NTURacingTeam/nturt_kicad/EP4/README.md

# README
must add `SamacSys_Parts` and `nturt_kicad_lib` in `/EP4/Project_Library` to **Preference > Manage Symbol Libraries ... > Global libraries** and **Preference > Manage footprint Libraries ... > Global libraries**
