NTURacingTeam/nturt_kicad/EP6/Electrical_Group/6S_BMS_CONN1/README.md

# 6S_BMS_CONN1 KiCad Project

## Project Overview
This repository contains the KiCad project for the **6S_BMS_CONN1** design, developed as part of the **Electrical Group**.

## Author
- **Name:** [Jack Kuo](https://github.com/chemmy-jack)
- **Team:** NTU Racing Team Electrical Group

## Revision History

| Version | Date | Author | Description |
|---|---|---|---|
| 1.0 | 2025-03-10 | [Jack Kuo](https://github.com/chemmy-jack)  | Initial project creation. (older version not documented) |
| 1.1 | 2025-05-05 | [Jack Kuo](https://github.com/chemmy-jack)  | fix M12 L-coded hole too small mistake.  add fillet to board cut. change IDC to 6S_BMS V2.0 to 12pin (new design. 2 more button input and 1 more LED WS2812 output). add 5V ext and WS2812 connector.|

## To-Do List

## License
<!-- This project is licensed under [Your License]. See the LICENSE file for details. -->
none

## Contact
For questions or contributions, please contact [ntu.racing@gmail.com].
