NTURacingTeam/nturt_kicad/driverless_car/CMP10A dimension.png

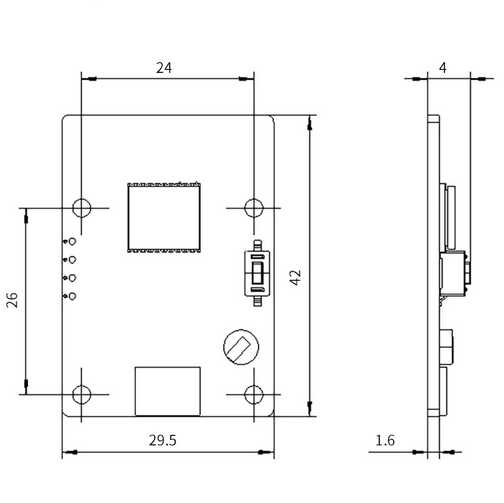
driverless_car/CMP10A dimension.png
