NTURacingTeam/nturt_kicad/EP6/Electrical_Group/VCU_CONN1/VCU_CONN1.step

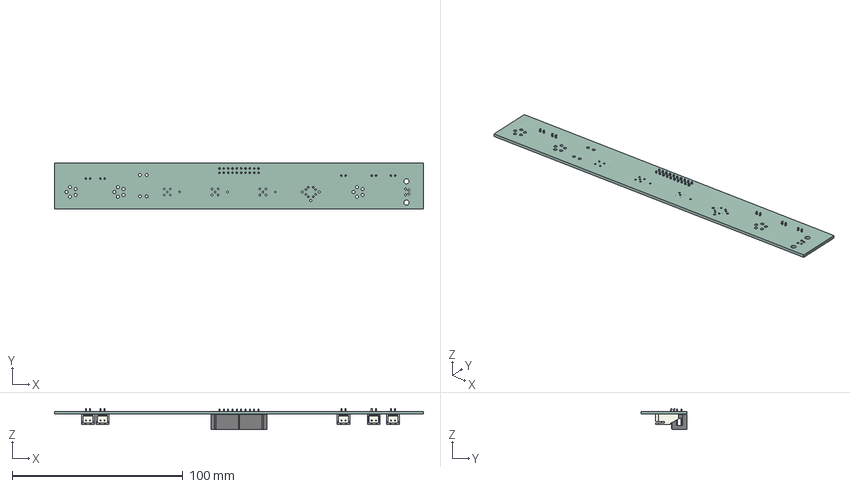
[picture p2: CAD file, 2025-03-10]
EP6/Electrical_Group/VCU_CONN1/VCU_CONN1.step
216.0 x 27.0 x 12.5 mm
IDC_Header_2x10_P254mm_Vertical
JST_S2B_XH_A x 5
_autosave-VCU_CONN1_PCB
