NTURacingTeam/nturt_kicad/EP6/Powertrain_Group/HVB_LV1/HVB_LV1.step

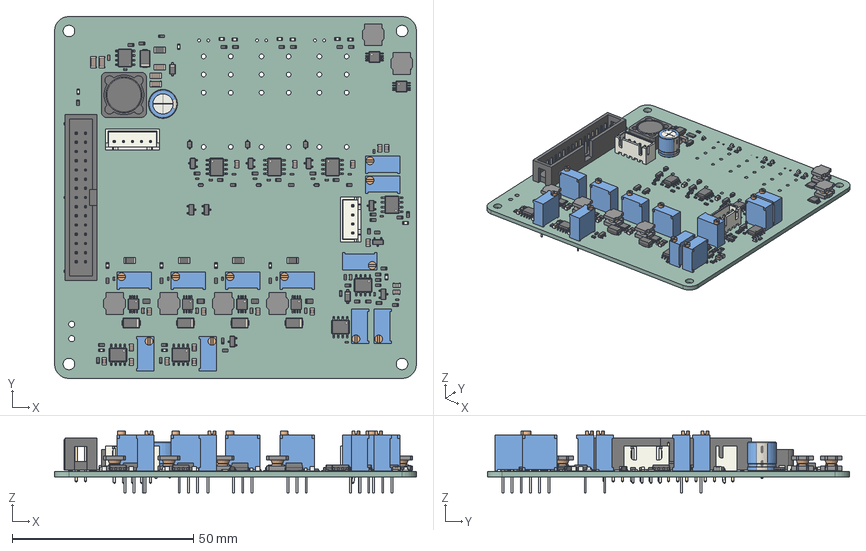
[picture p3: CAD file, 2025-03-18]
EP6/Powertrain_Group/HVB_LV1/HVB_LV1.step
100.0 x 100.0 x 17.1 mm
R_0603_1608Metric x 46
C_0805_2012Metric x 16
MSOP-8-1EP_3x3mm_P0.65mm_EP1.5x1.8mm x 6
D_SMA x 5
LED_0603_1608Metric x 16
SOIC_8_39x49mm_P127mm x 8
SOT_23 x 9
C_0402_1005Metric x 19
L_Bourns_SRN6045TA x 6
Potentiometer_Bourns_3296W_Vertical x 11
SRR1260
HTSOP_8_1EP_39x49mm_Pitch127mm
Fuse_1206_3216Metric x 5
D_SOD_323 x 3
D_SOD_523 x 3
IDC_Header_2x15_P254mm_Vertical
R_0805_2012Metric x 4
C_1206_3216Metric x 5
C_0603_1608Metric x 6
D_SOD_123 x 2
L_0805_2012Metric x 2
JST_B4B_XH_A
CP_Radial_D80mm_P380mm
JST_B5B_XH_A
HVB_LV1_PCB
