NTURacingTeam/nturt_kicad/EP6/Powertrain_Group/INV_GateDriver/INV_GateDriver.step

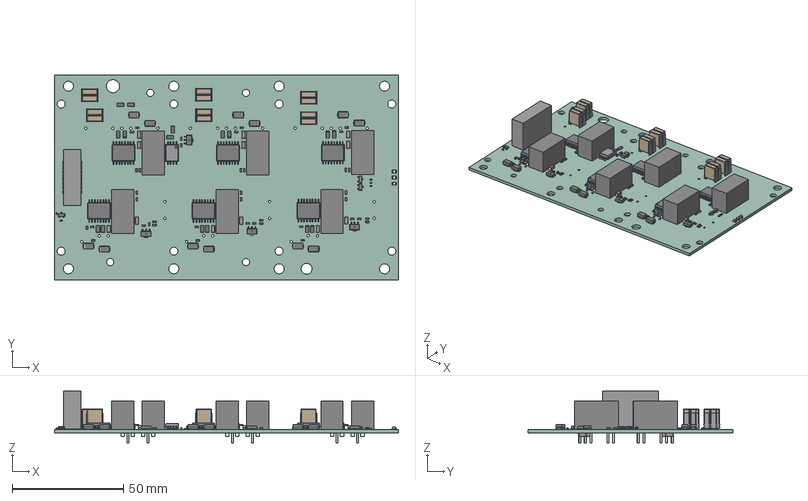
[picture p4: CAD file, 2025-02-22]
EP6/Powertrain_Group/INV_GateDriver/INV_GateDriver.step
154.5 x 92.0 x 23.2 mm
C_0603_1608Metric x 30
CQ assembly x 4
LED_0805_2012Metric x 3
R_0603_1608Metric x 9
C_1206_3216Metric x 24
D_SMA x 12
R_1206_3216Metric x 16
R_0402_1005Metric x 3
CeraLink_FA2_6205-Z03-Ind x 6
ASSEMBLY x 2
C_0402_1005Metric x 2
SOIC_16W_75x103mm_P127mm x 6
SOT_23 x 2
SOT-23-3
INV_GateDriver_PCB
