NTURacingTeam/nturt_kicad/EP6/Powertrain_Group/INV_MotorTempIso/INV_MotorTempIso.step

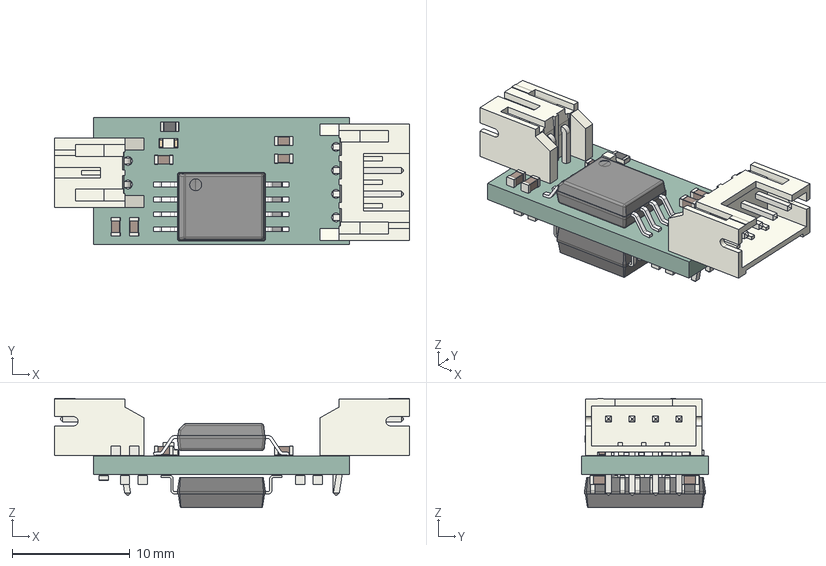
[picture p5: CAD file, 2025-02-12]
EP6/Powertrain_Group/INV_MotorTempIso/INV_MotorTempIso.step
30.2 x 10.8 x 9.30 mm
LED_0603_1608Metric
C_0603_1608Metric x 13
R_0603_1608Metric x 2
JST_S4B_PH_K
DWV0008A_ASM
JST_S2B_PH_K
SOIC_16W_75x103mm_P127mm
INV_MotorTempIso_PCB
