NTURacingTeam/nturt_kicad/driverless_car/exports/driverless car middle board schematic.pdf

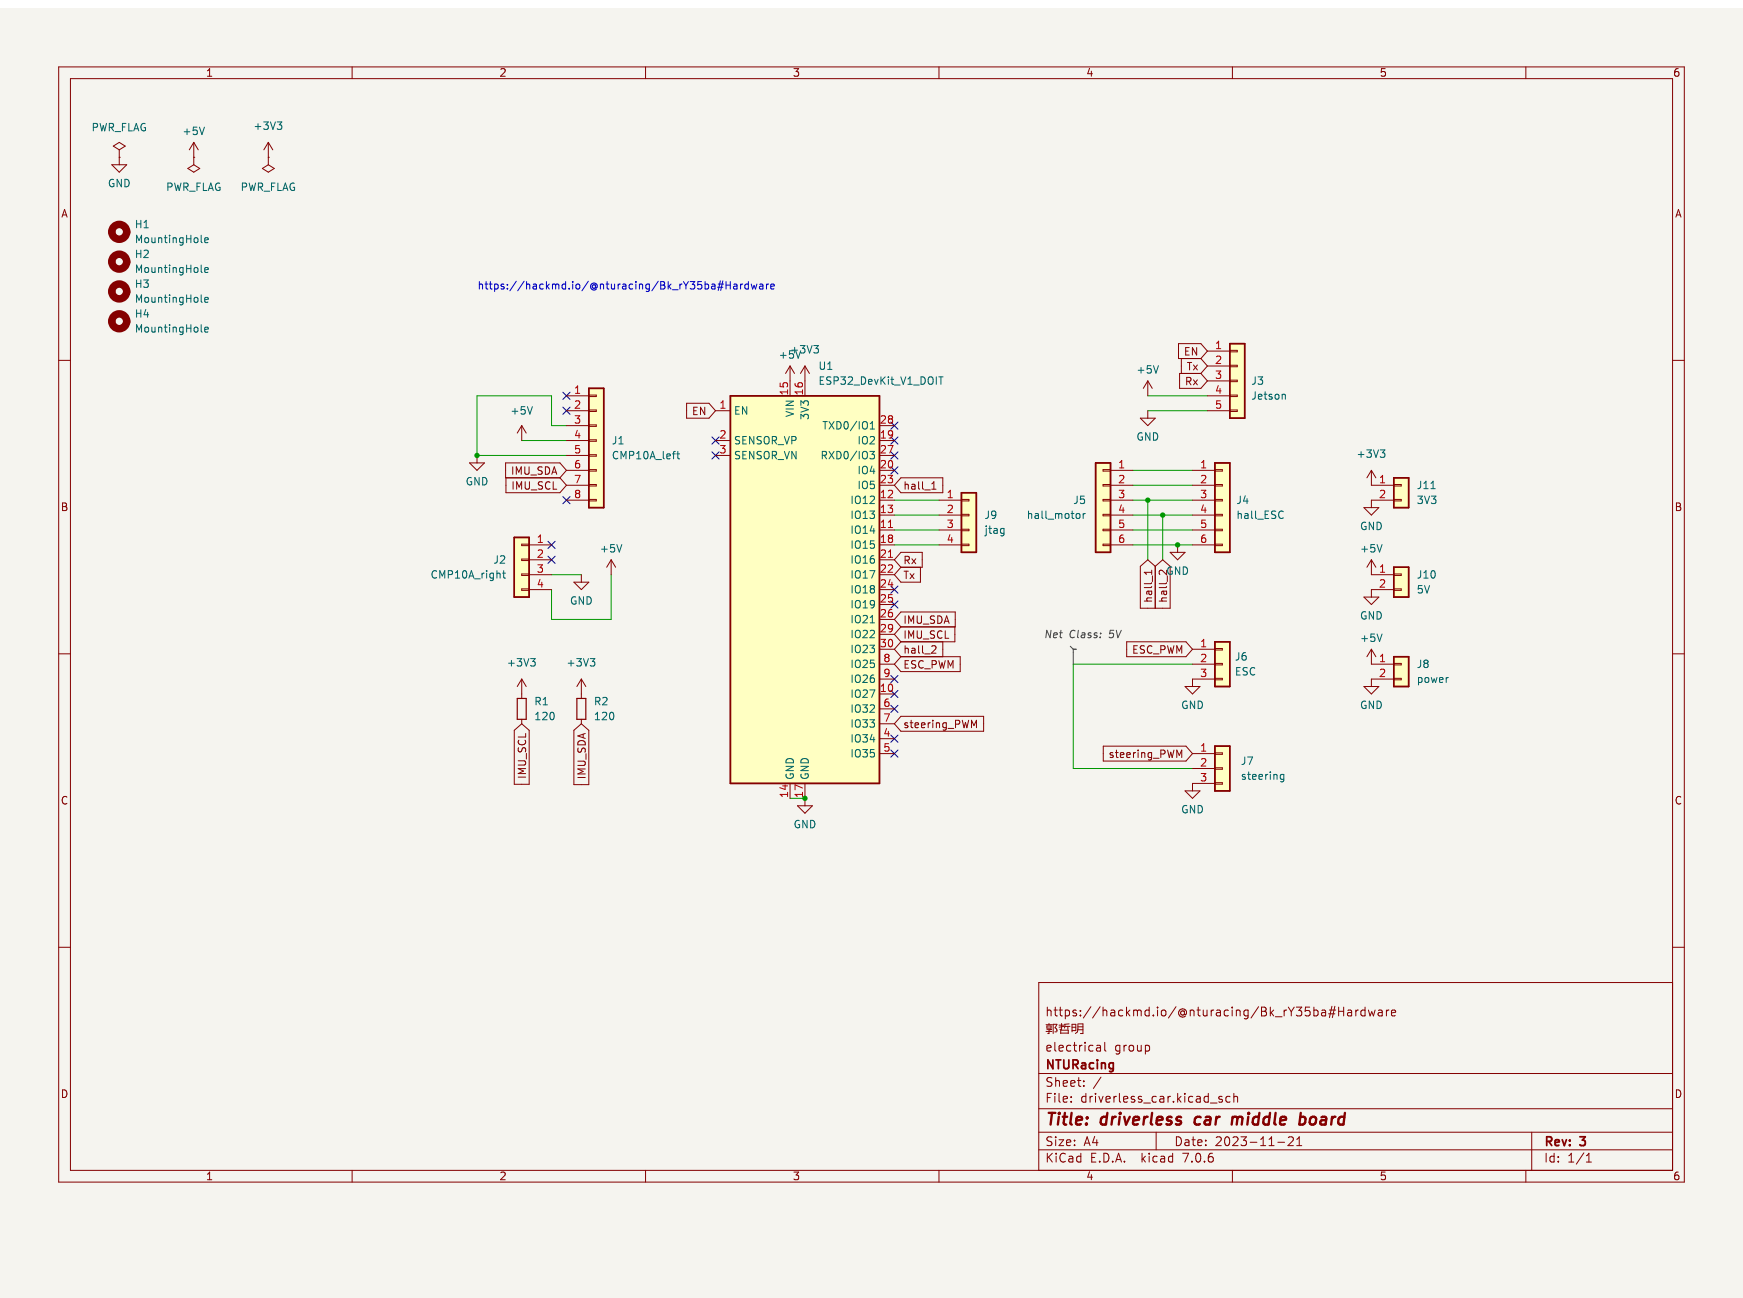
[picture p6: page 1]
