NTURacingTeam/nturt_kicad/driverless_car/exports/driverless car middle board layout.pdf

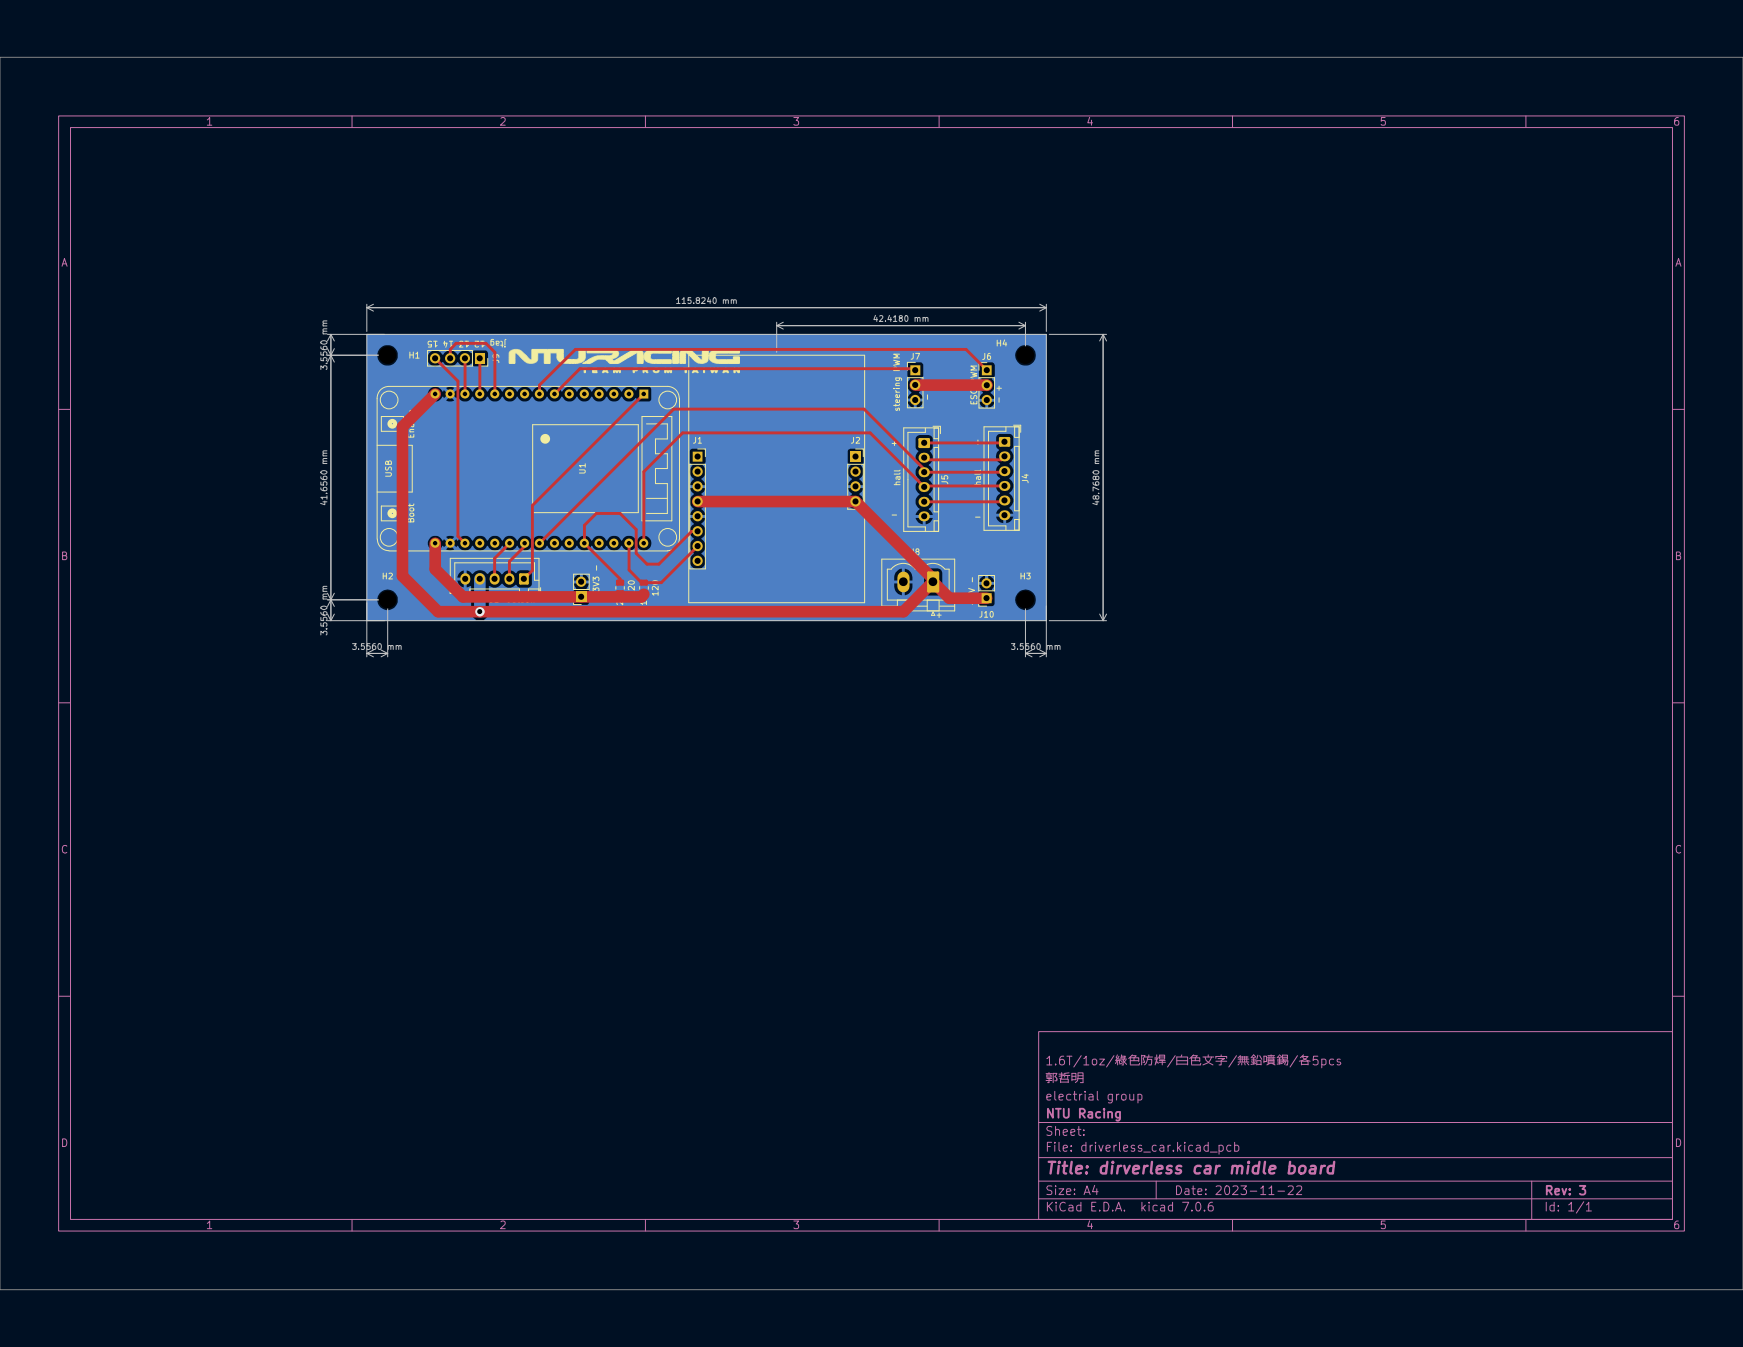
[picture p7: page 1]
