NTURacingTeam/nturt_kicad/EP6/Electrical_Group/STEER_N15TS/STEER_N15TS.kicad_pcb

## KiCad design EP6/Electrical_Group/STEER_N15TS/STEER_N15TS.kicad_pcb (2025-11-19)

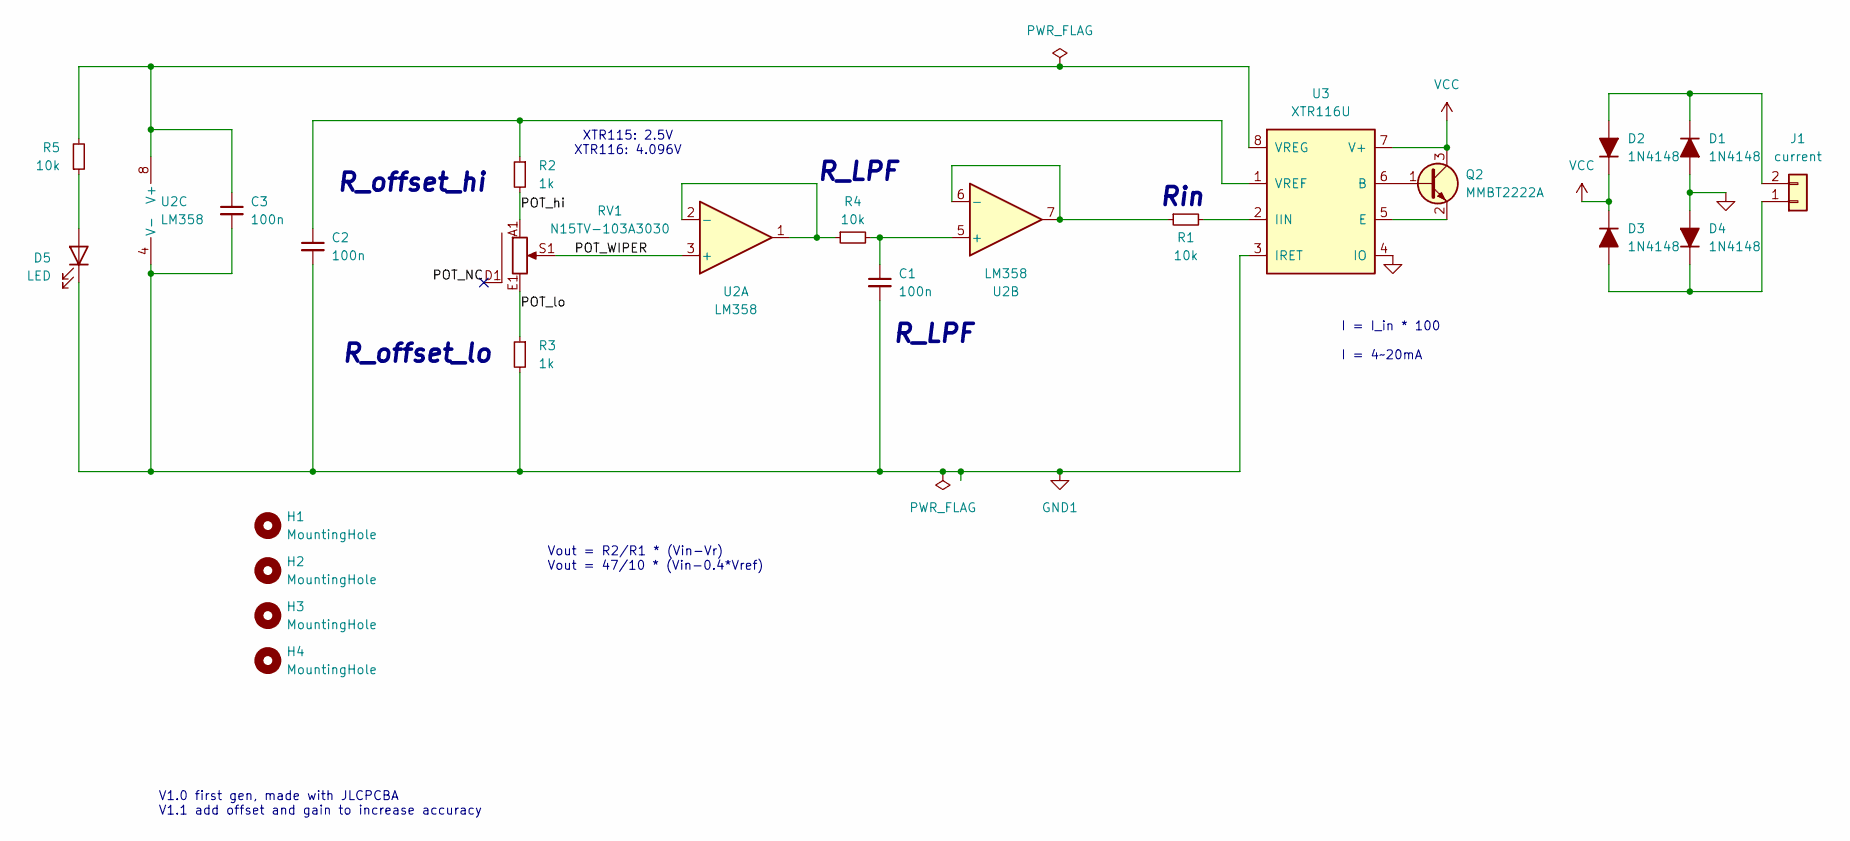
[picture p8: schematic STEER_N15TS.kicad_sch, STEER_NT15TS]

Parts:
C1, C2, C3: 100n; C_0603_1608Metric
D1, D2, D3, D4: 1N4148; D_SOD-323_HandSoldering
D5: LED; LED_0603_1608Metric
H1, H2, H3, H4: MountingHole; MountingHole_3.2mm_M3
J1: current; JST_XH_S2B-XH-A_1x02_P2.50mm_Horizontal; Part Number 1-0201FBV0T
Q2: MMBT2222A; SOT-23
R1, R4, R5: 10k; R_0603_1608Metric
R2, R3: 1k; R_0603_1608Metric
RV1: N15TV-103A3030; N15TS103A3030
U2: LM358; SOIC-8_3.9x4.9mm_P1.27mm
U3: XTR116U; SOIC-8_3.9x4.9mm_P1.27mm

Connections:
/POT_NC: RV1.D1 (DUMMY)
/POT_WIPER: RV1.S1 (WIPER), U2.3 (+)
/POT_hi: R2.2, RV1.A1 (INITIAL)
/POT_lo: R3.1, RV1.E1 (FINAL)
GND: D1.2 (A), D4.2 (A), U3.4 (IO)
GND1: C1.2, C2.2, C3.2, D5.1 (K), R3.2, U2.4 (V-), U3.3 (IRET)
unnamed: D1.1 (K), D2.2 (A), J1.2
unnamed: D3.2 (A), D4.1 (K), J1.1
unnamed: D5.2 (A), R5.1
unnamed: Q2.1 (B), U3.6 (B)
unnamed: Q2.2 (E), U3.5 (E)
unnamed: R4.1, U2.1, U2.2 (-)
unnamed: C1.1, R4.2, U2.5 (+)
unnamed: R1.1, U2.6 (-), U2.7
unnamed: C3.1, R5.2, U2.8 (V+), U3.8 (VREG)
unnamed: R1.2, U3.2 (IIN)
unnamed: C2.1, R2.1, U3.1 (VREF)
VCC: D2.1 (K), D3.1 (K), Q2.3 (C), U3.7 (V+)

Notes on the sheet:
R_offset_lo
Vout = R2/R1 * (Vin-Vr) Vout = 47/10 * (Vin-0.4*Vref)
R_offset_hi
I = I_in * 100 I = 4~20mA
R_LPF
XTR115: 2.5V XTR116: 4.096V
V1.0 first gen, made with JLCPCBA V1.1 add offset and gain to increase accuracy
Rin

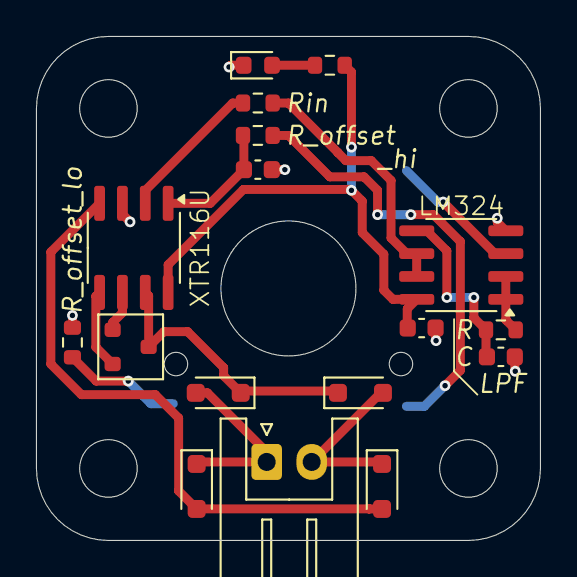
[picture p9: board STEER_N15TS.kicad_pcb from above]

Board: 2 copper layers, 28.0 x 28.0 mm, 22 parts (1 on the bottom side), 17 nets.
