NTURacingTeam/nturt_kicad/EP6/Electrical_Group/APPS_ROT_POT_onboard_XTR11x/APPS_ROT_POT_onboard_XTR11x.kicad_pcb

## KiCad design EP6/Electrical_Group/APPS_ROT_POT_onboard_XTR11x/APPS_ROT_POT_onboard_XTR11x.kicad_pcb (2025-10-15)

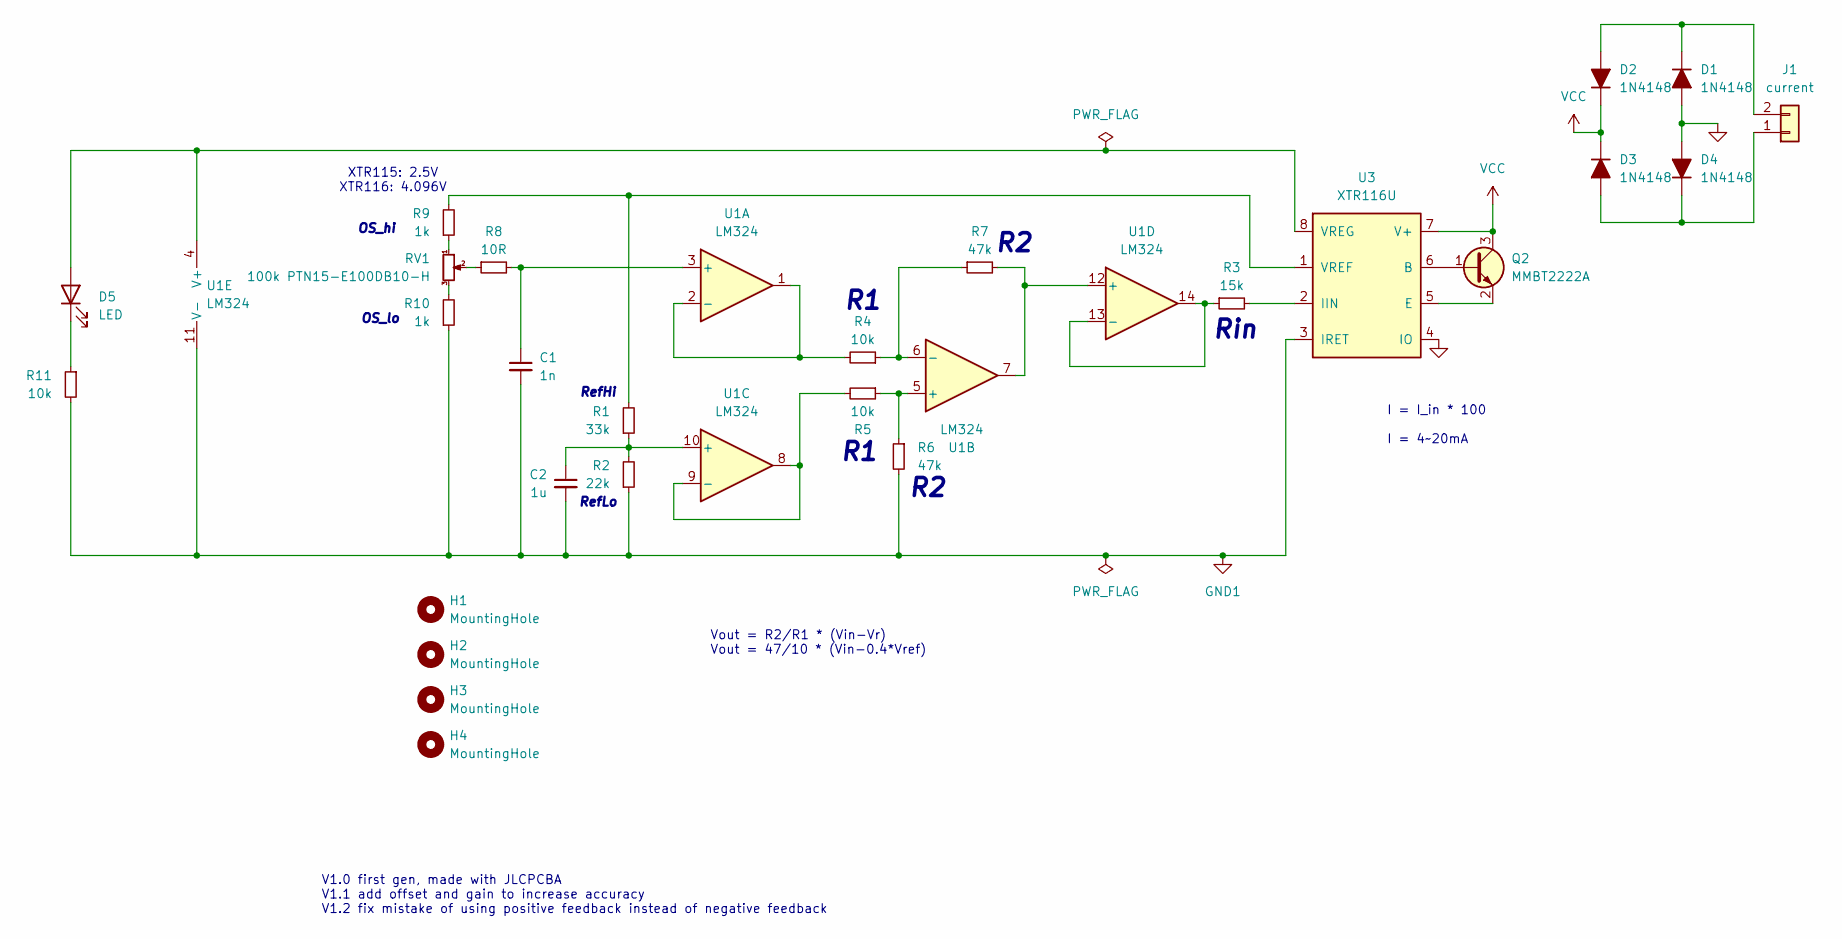
[picture p10: schematic APPS_ROT_POT_onboard_XTR11x.kicad_sch]

Parts:
C1: 1n; C_0402_1005Metric
C2: 1u; C_0402_1005Metric
D1, D2, D3, D4: 1N4148; D_SOD-323_HandSoldering
D5: LED; LED_0603_1608Metric
H1, H2, H3, H4: MountingHole; MountingHole_3.2mm_M3
J1: current; JST_XH_S2B-XH-A_1x02_P2.50mm_Horizontal; Part Number 1-0201FBV0T
Q2: MMBT2222A; SOT-23
R1: 33k; R_0402_1005Metric
R2: 22k; R_0402_1005Metric
R3: 15k; R_0402_1005Metric
R4, R5, R11: 10k; R_0402_1005Metric
R6, R7: 47k; R_0402_1005Metric
R8: 10R; R_0402_1005Metric
R9, R10: 1k; R_0402_1005Metric
RV1: 100k PTN15-E100DB10-H; Potentiometer_Piher_PT-15-V15_Vertical_Hole
U1: LM324; SOIC-14_3.9x8.7mm_P1.27mm
U3: XTR116U; SOIC-8_3.9x4.9mm_P1.27mm

Connections:
GND: D1.2 (A), D4.2 (A), U3.4 (IO)
GND1: C1.2, C2.2, R2.1, R6.2, R10.1, R11.2, U1.11 (V-), U3.3 (IRET)
unnamed: D1.1 (K), D2.2 (A), J1.2
unnamed: D3.2 (A), D4.1 (K), J1.1
unnamed: D5.2 (A), U1.4 (V+), U3.8 (VREG)
unnamed: D5.1 (K), R11.1
unnamed: Q2.1 (B), U3.6 (B)
unnamed: Q2.2 (E), U3.5 (E)
unnamed: R8.1, RV1.2
unnamed: R9.1, RV1.1
unnamed: R10.2, RV1.3
unnamed: C1.1, R8.2, U1.3 (+)
unnamed: R4.2, U1.1, U1.2 (-)
unnamed: R5.1, R6.1, U1.5 (+)
unnamed: R4.1, R7.1, U1.6 (-)
unnamed: C2.1, R1.1, R2.2, U1.10 (+)
unnamed: R5.2, U1.8, U1.9 (-)
unnamed: R7.2, U1.7, U1.12 (+)
unnamed: R3.1, U1.13 (-), U1.14
unnamed: R3.2, U3.2 (IIN)
unnamed: R1.2, R9.2, U3.1 (VREF)
VCC: D2.1 (K), D3.1 (K), Q2.3 (C), U3.7 (V+)

Notes on the sheet:
OS_hi
Vout = R2/R1 * (Vin-Vr) Vout = 47/10 * (Vin-0.4*Vref)
OS_lo
I = I_in * 100 I = 4~20mA
RefLo
XTR115: 2.5V XTR116: 4.096V
RefHi
V1.0 first gen, made with JLCPCBA V1.1 add offset and gain to increase accuracy V1.2 fix mistake of using positive feedback instead of negative feedback
Rin

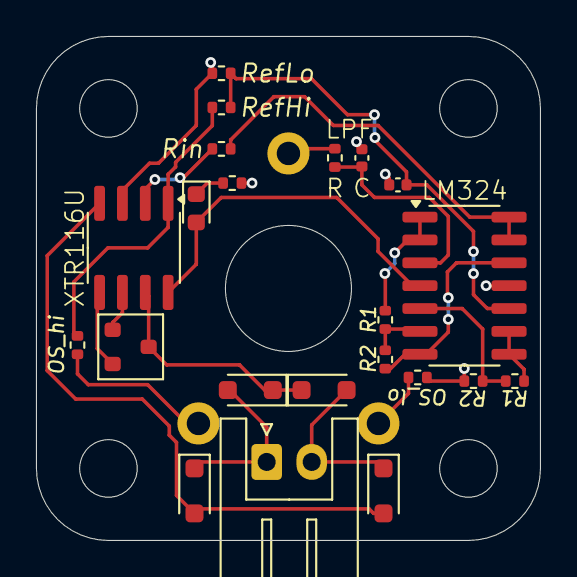
[picture p11: board APPS_ROT_POT_onboard_XTR11x.kicad_pcb from above]

Board: 2 copper layers, 28.0 x 28.0 mm, 27 parts (1 on the bottom side), 22 nets.
