NTURacingTeam/nturt_kicad/EP6/Powertrain_Group/ACC_HVLV1/ACC_HVLV1.kicad_pcb

## KiCad design EP6/Powertrain_Group/ACC_HVLV1/ACC_HVLV1.kicad_pcb (2025-10-15)

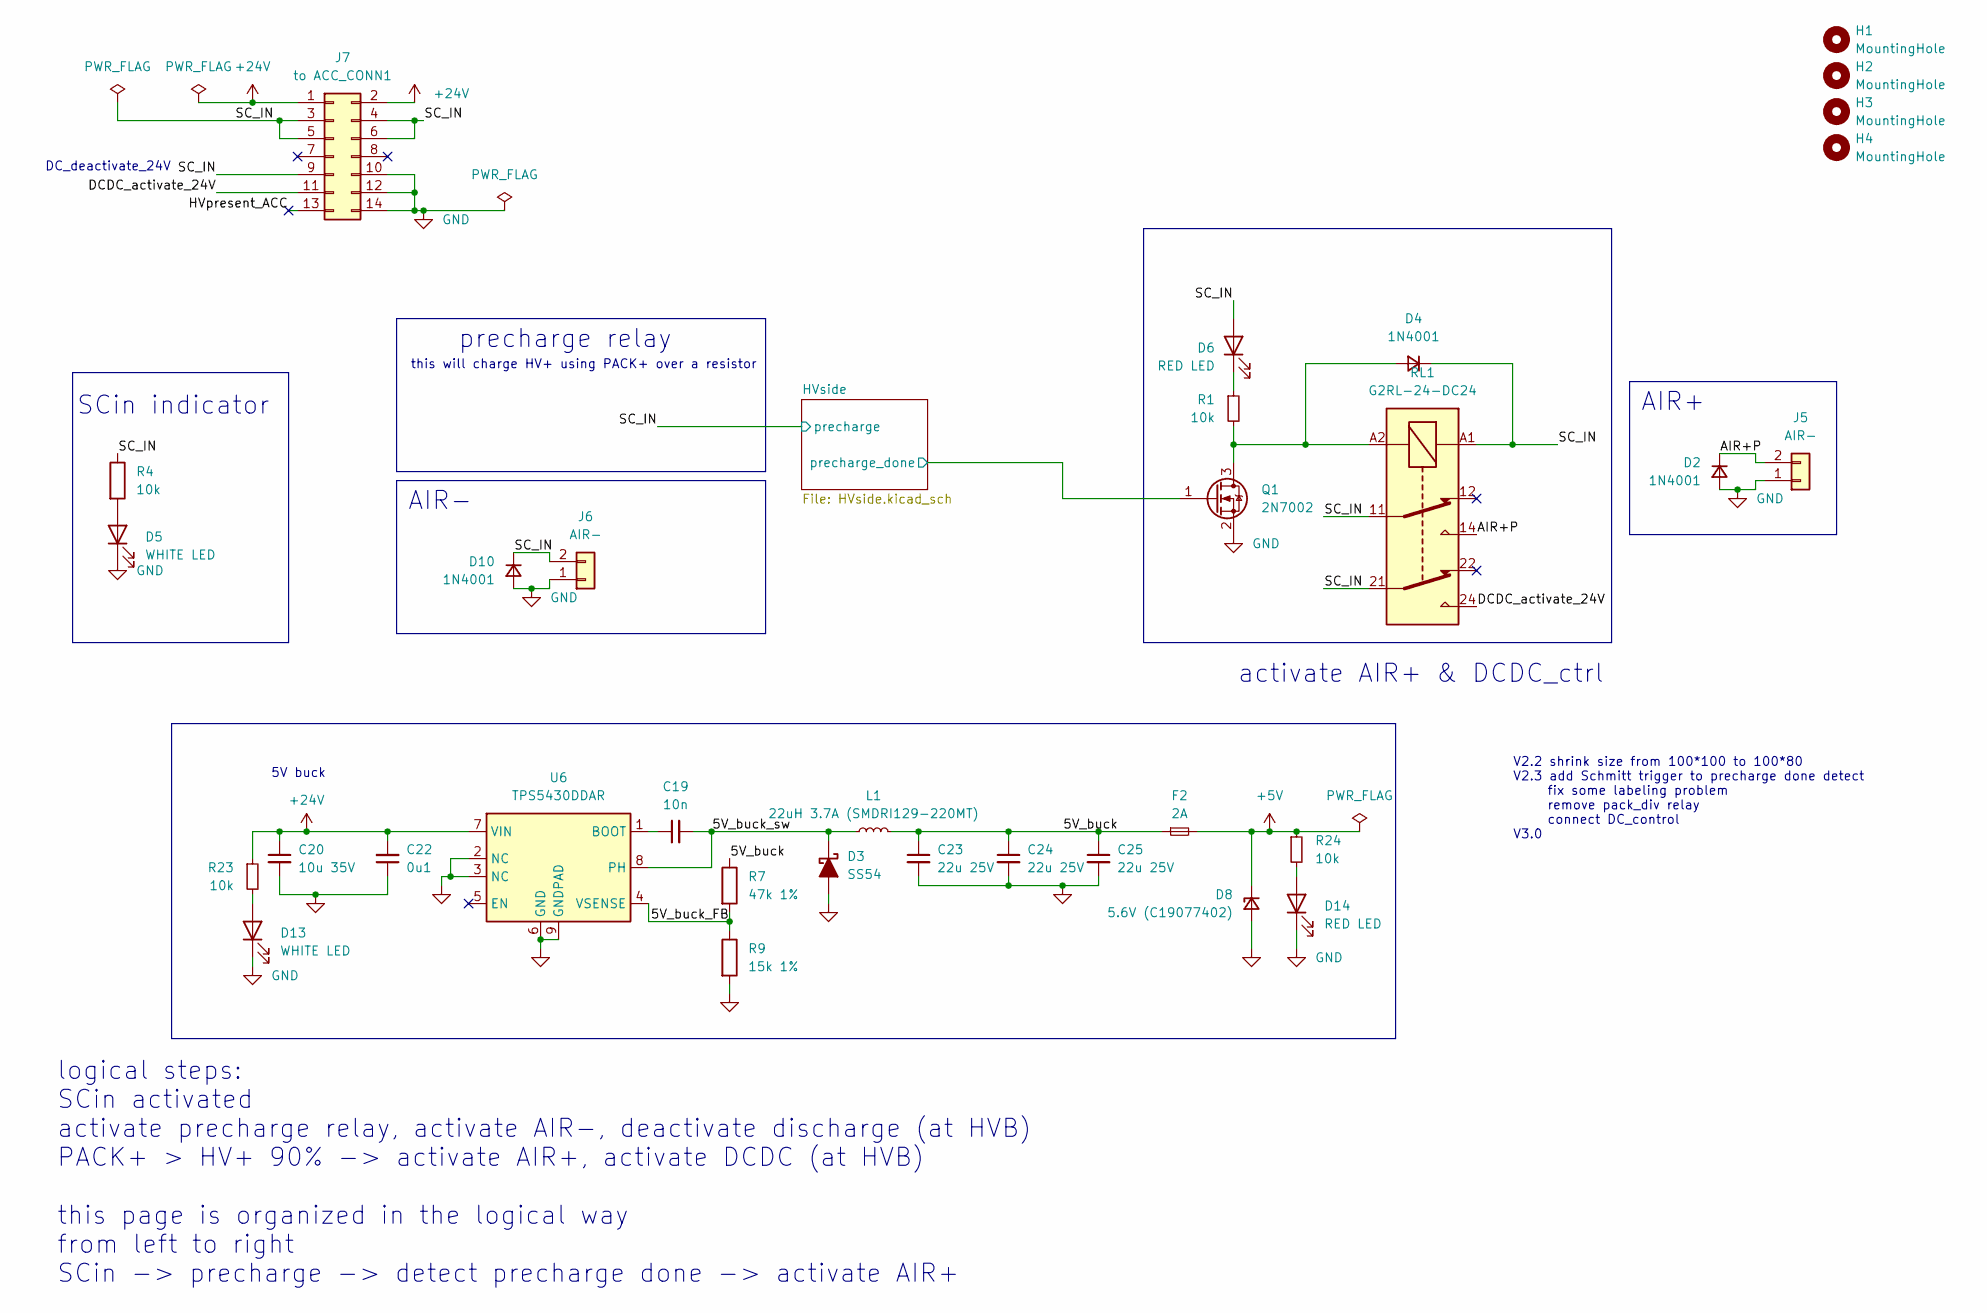
[picture p12: schematic ACC_HVLV1.kicad_sch]

Parts:
C19: 10n; C_0603_1608Metric
C20: 10u 35V; C_1206_3216Metric
C22: 0u1; C_0603_1608Metric
C23, C24, C25: 22u 25V; C_1206_3216Metric
D2, D4, D10: 1N4001; D_SOD-123F
D3: SS54; D_SMA
D5, D13: WHITE LED; LED_0805_2012Metric_Pad1.15x1.40mm_HandSolder
D6, D14: RED LED; LED_0805_2012Metric_Pad1.15x1.40mm_HandSolder
D8: 5.6V (C19077402); D_SOD-123
F2: 2A; Fuse_1206_3216Metric
H1, H2, H3, H4: MountingHole; MountingHole_3.2mm_M3
J5, J6: AIR-; JST_VH_B2P-VH-B_1x02_P3.96mm_Vertical
J7: to ACC_CONN1; IDC-Header_2x07_P2.54mm_Vertical
L1: 22uH 3.7A (SMDRI129-220MT); L_Bourns_SRR1260
Q1: 2N7002; SOT-23
R1: 10k; R_0603_1608Metric_Pad0.98x0.95mm_HandSolder
R4: 10k; R_0603_1608Metric
R7: 47k 1%; R_0603_1608Metric
R9: 15k 1%; R_0603_1608Metric
R23, R24: 10k; R_0805_2012Metric_Pad1.20x1.40mm_HandSolder
RL1: G2RL-24-DC24; Relay_DPDT_Omron_G2RL-2
U6: TPS5430DDAR; TI_SO-PowerPAD-8_ThermalVias

Connections:
+5V: D8.1 (K), F2.2, R24.1; also elsewhere on the board
+24V: C20.1, C22.2, J7.1, J7.2, R23.1, U6.7 (VIN)
/5V_buck: C23.1, C24.1, C25.1, F2.1, L1.2, R7.1
/5V_buck_FB: R7.2, R9.1, U6.4 (VSENSE)
/5V_buck_sw: C19.2, D3.1 (K), L1.1, U6.8 (PH)
/AIR+P: D2.1 (K), J5.2, RL1.14
/DCDC_activate_24V: J7.11, RL1.24
/HVpresent_ACC: J7.13
/HVside/precharge_done: Q1.1 (G); also elsewhere on the board
/SC_IN: D4.1 (K), D6.2 (A), D10.1 (K), J6.2, J7.3, J7.4, J7.5, J7.6, J7.9, R4.1, RL1.11, RL1.21, RL1.A1; also elsewhere on the board
GND: C20.2, C22.1, C23.2, C24.2, C25.2, D2.2 (A), D3.2 (A), D5.1 (K), D8.2 (A), D10.2 (A), D13.1 (K), D14.1 (K), J5.1, J6.1, J7.10, J7.12, J7.14, Q1.2 (S), R9.2, U6.2 (NC), U6.3 (NC), U6.6 (GND), U6.9 (GNDPAD); also elsewhere on the board
unnamed: D4.2 (A), Q1.3 (D), R1.2, RL1.A2
unnamed: D5.2 (A), R4.2
unnamed: D6.1 (K), R1.1
unnamed: D13.2 (A), R23.2
unnamed: D14.2 (A), R24.2
unnamed: C19.1, U6.1 (BOOT)

Notes on the sheet:
AIR-
AIR+
V2.2 shrink size from 100*100 to 100*80 V2.3 add Schmitt trigger to precharge done detect fix some labeling problem remove pack_div relay connect DC_control V3.0
5V buck
SCin indicator
this will charge HV+ using PACK+ over a resistor
DC_deactivate_24V
activate AIR+ & DCDC_ctrl
precharge relay
logical steps: SCin activated activate precharge relay, activate AIR-, deactivate discharge (at HVB) PACK+ > HV+ 90% -> activate AIR+, activate DCDC (at HVB) this page is organized in the logical way from left to right SCin -> precharge -> detect precharge done -> activate AIR+

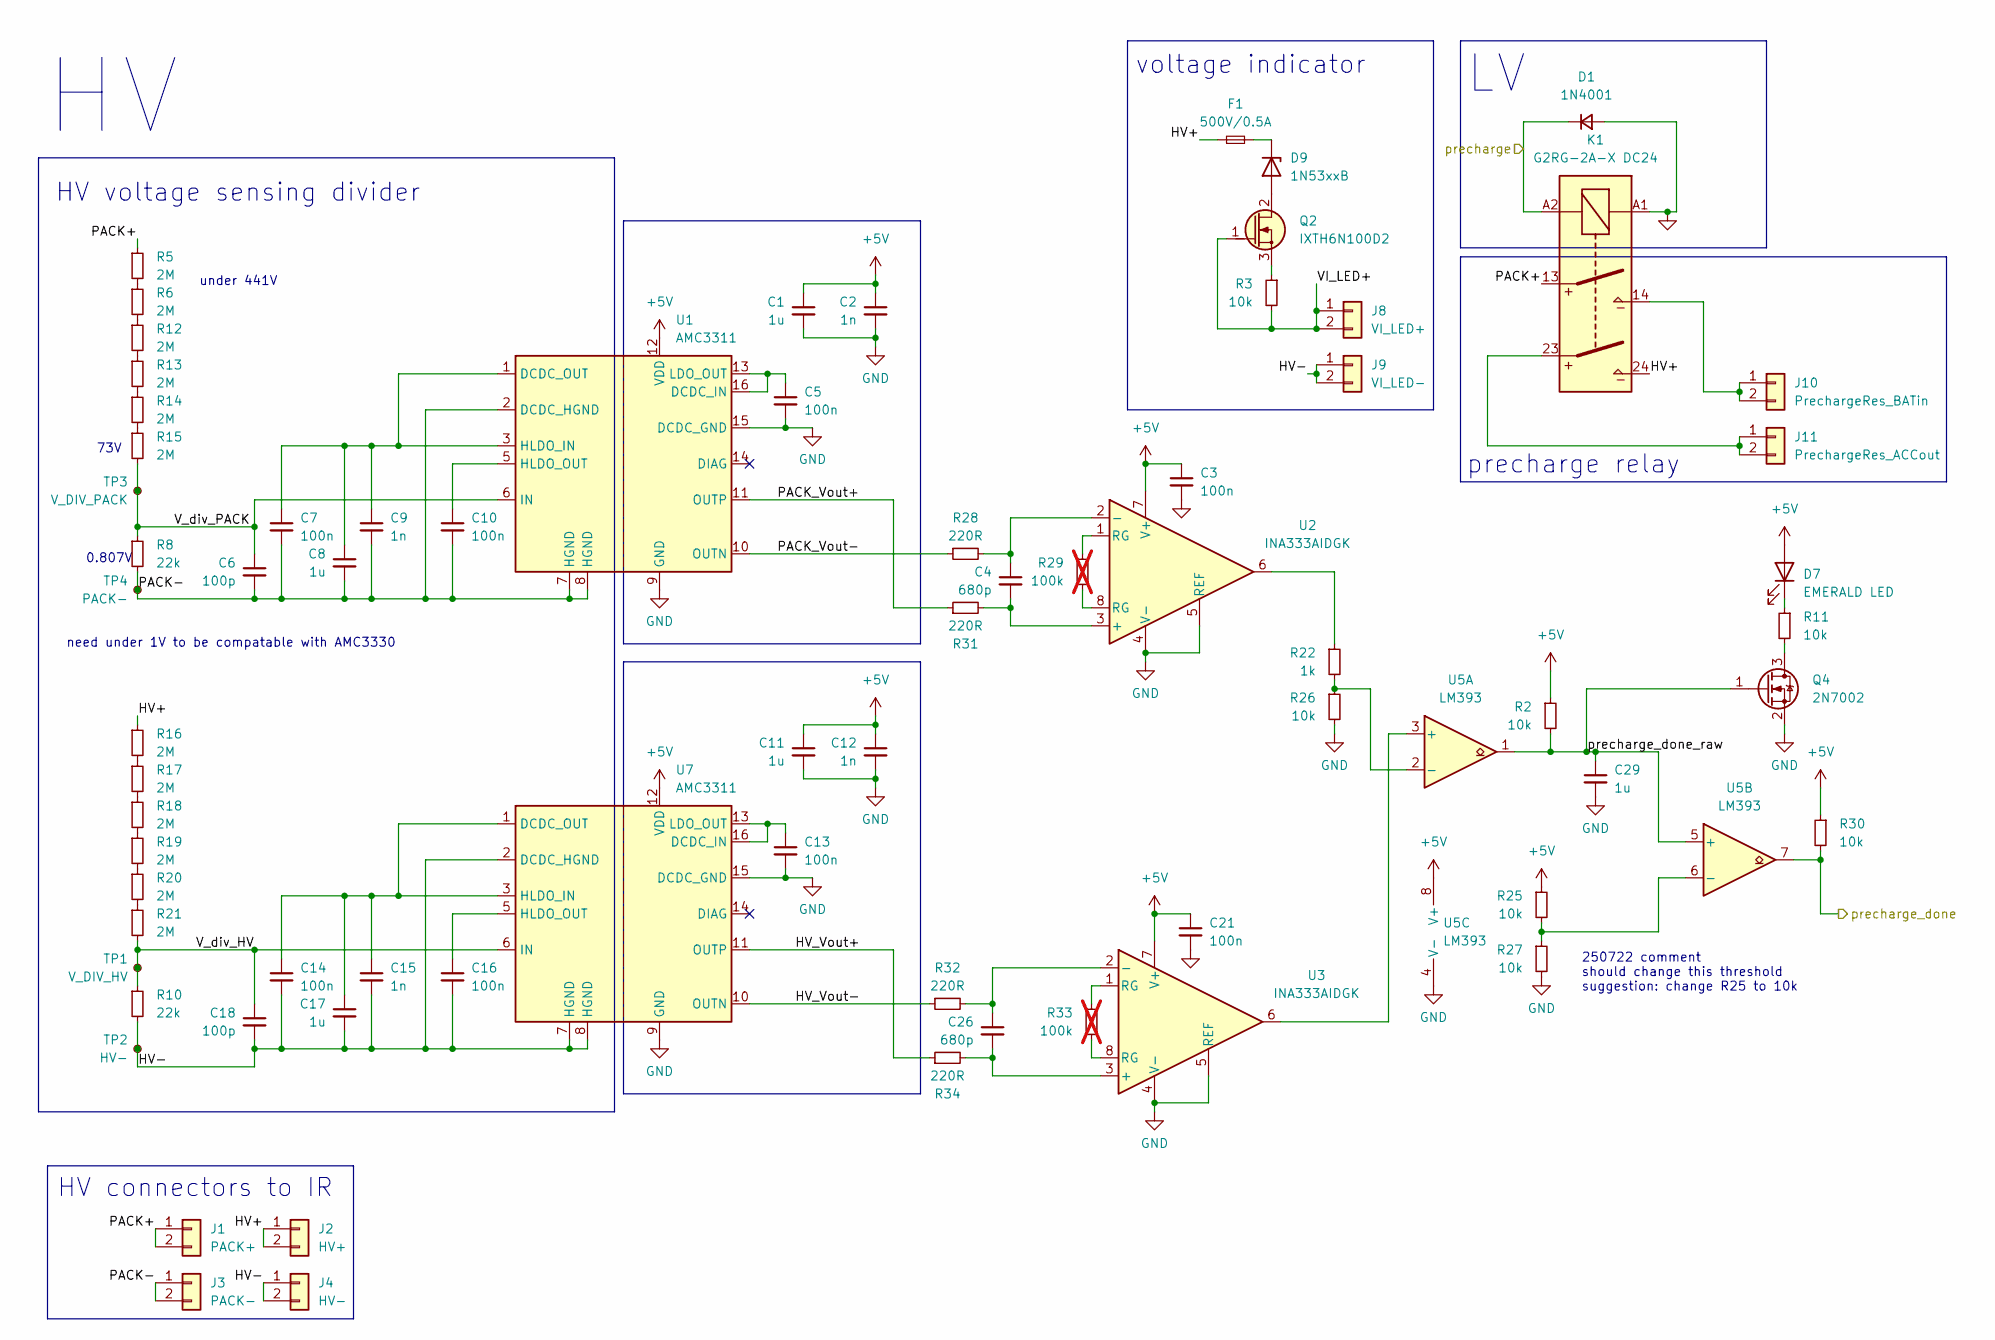
[picture p13: schematic HVside.kicad_sch, ACC_HVLV1]

Parts:
C1, C8, C11, C17, C29: 1u; C_0603_1608Metric
C2, C9, C12, C15: 1n; C_0603_1608Metric
C3, C21: 100n; C_0402_1005Metric
C4, C26: 680p; C_0402_1005Metric
C5, C7, C10, C13, C14, C16: 100n; C_0603_1608Metric
C6, C18: 100p; C_0603_1608Metric
D1: 1N4001; D_SOD-123F
D7: EMERALD LED; LED_0805_2012Metric_Pad1.15x1.40mm_HandSolder
D9: 1N53xxB; D_DO-201_P15.24mm_Horizontal
F1: 500V/0.5A; 65600001009; Rating W
J1: PACK+; HRS_DF33C-2P-3.3DSA
J2: HV+; HRS_DF33C-2P-3.3DSA
J3: PACK-; HRS_DF33C-2P-3.3DSA
J4: HV-; HRS_DF33C-2P-3.3DSA
J8: VI_LED+; HRS_DF33C-2P-3.3DSA
J9: VI_LED-; HRS_DF33C-2P-3.3DSA
J10: PrechargeRes_BATin; HRS_DF33C-2P-3.3DSA
J11: PrechargeRes_ACCout; HRS_DF33C-2P-3.3DSA
K1: G2RG-2A-X DC24; Relay_DPST_Omron_G2RL-2A
Q2: IXTH6N100D2; TO-247-3_Vertical
Q4: 2N7002; SOT-23
R2, R11, R25, R26, R27, R30: 10k; R_0603_1608Metric_Pad0.98x0.95mm_HandSolder
R3: 10k; R_0805_2012Metric_Pad1.20x1.40mm_HandSolder
R5, R6, R12, R13, R14, R15, R16, R17, R18, R19, R20, R21: 2M; R_0805_2012Metric_Pad1.20x1.40mm_HandSolder
R8, R10: 22k; R_0805_2012Metric_Pad1.20x1.40mm_HandSolder
R22: 1k; R_0603_1608Metric_Pad0.98x0.95mm_HandSolder
R28, R31, R32, R34: 220R; R_0402_1005Metric
R29, R33: 100k; R_0402_1005Metric; not fitted
TP1: V_DIV_HV; TestPoint_Pad_D2.0mm
TP2: HV-; TestPoint_Pad_D2.0mm
TP3: V_DIV_PACK; TestPoint_Pad_D2.0mm
TP4: PACK-; TestPoint_Pad_D2.0mm
U1, U7: AMC3311; SOIC-16W_7.5x10.3mm_P1.27mm
U2, U3: INA333AIDGK; MSOP-8_3x3mm_P0.65mm
U5: LM393; SOIC-8_3.9x4.9mm_P1.27mm

Connections:
+5V: C1.1, C2.1, C3.1, C11.1, C12.1, C21.1, D7.2 (A), R2.1, R25.1, R30.1, U1.12 (VDD), U2.7 (V+), U3.7 (V+), U5.8 (V+), U7.12 (VDD); also elsewhere on the board
/HVside/HV+: F1.2, J2.1, J2.2, K1.24, R16.1
/HVside/HV-: C14.2, C15.2, C16.2, C17.2, C18.2, J4.1, J4.2, J9.1, J9.2, R10.2, TP2.1, U7.2 (DCDC_HGND), U7.7 (HGND), U7.8 (HGND)
/HVside/HV_Vout+: R34.1, U7.11 (OUTP)
/HVside/HV_Vout-: R32.1, U7.10 (OUTN)
/HVside/PACK+: J1.1, J1.2, K1.13, R5.1
/HVside/PACK-: C6.2, C7.2, C8.2, C9.2, C10.2, J3.1, J3.2, R8.2, TP4.1, U1.2 (DCDC_HGND), U1.7 (HGND), U1.8 (HGND)
/HVside/PACK_Vout+: R31.1, U1.11 (OUTP)
/HVside/PACK_Vout-: R28.1, U1.10 (OUTN)
/HVside/VI_LED+: J8.1, J8.2, Q2.1 (G), R3.2
/HVside/V_div_HV: C18.1, R10.1, R21.2, TP1.1, U7.6 (IN)
/HVside/V_div_PACK: C6.1, R8.1, R15.2, TP3.1, U1.6 (IN)
/HVside/precharge_done: R30.2, U5.7; also elsewhere on the board
/HVside/precharge_done_raw: C29.1, Q4.1 (G), R2.2, U5.1, U5.5 (+)
/SC_IN: D1.1 (K), K1.A2; also elsewhere on the board
GND: C1.2, C2.2, C3.2, C5.2, C11.2, C12.2, C13.2, C21.2, C29.2, D1.2 (A), K1.A1, Q4.2 (S), R26.2, R27.2, U1.9 (GND), U1.15 (DCDC_GND), U2.4 (V-), U2.5 (REF), U3.4 (V-), U3.5 (REF), U5.4 (V-), U7.9 (GND), U7.15 (DCDC_GND); also elsewhere on the board
unnamed: D7.1 (K), R11.1
unnamed: D9.2 (A), Q2.2 (D)
unnamed: D9.1 (K), F1.1
unnamed: J10.1, J10.2, K1.14
unnamed: J11.1, J11.2, K1.23
unnamed: Q2.3 (S), R3.1
unnamed: Q4.3 (D), R11.2
unnamed: R5.2, R6.1
unnamed: R6.2, R12.1
unnamed: R12.2, R13.1
unnamed: R13.2, R14.1
unnamed: R14.2, R15.1
unnamed: R16.2, R17.1
unnamed: R17.2, R18.1
unnamed: R18.2, R19.1
unnamed: R19.2, R20.1
unnamed: R20.2, R21.1
unnamed: R22.1, U2.6
unnamed: R29.1, U2.8 (RG)
unnamed: R29.2, U2.1 (RG)
unnamed: R33.1, U3.8 (RG)
unnamed: R33.2, U3.1 (RG)
unnamed: C5.1, U1.13 (LDO_OUT), U1.16 (DCDC_IN)
unnamed: C7.1, C8.1, C9.1, U1.1 (DCDC_OUT), U1.3 (HLDO_IN)
unnamed: C10.1, U1.5 (HLDO_OUT)
unnamed: C4.2, R31.2, U2.3 (+)
unnamed: C4.1, R28.2, U2.2 (-)
unnamed: C26.2, R34.2, U3.3 (+)
unnamed: C26.1, R32.2, U3.2 (-)
unnamed: U3.6, U5.3 (+)
unnamed: R22.2, R26.1, U5.2 (-)
unnamed: R25.2, R27.1, U5.6 (-)
unnamed: C13.1, U7.13 (LDO_OUT), U7.16 (DCDC_IN)
unnamed: C14.1, C15.1, C17.1, U7.1 (DCDC_OUT), U7.3 (HLDO_IN)
unnamed: C16.1, U7.5 (HLDO_OUT)

Notes on the sheet:
250722 comment should change this threshold suggestion: change R25 to 10k
voltage indicator
HV voltage sensing divider
HV connectors to IR
under 441V
73V
need under 1V to be compatable with AMC3330
precharge relay
0.807V

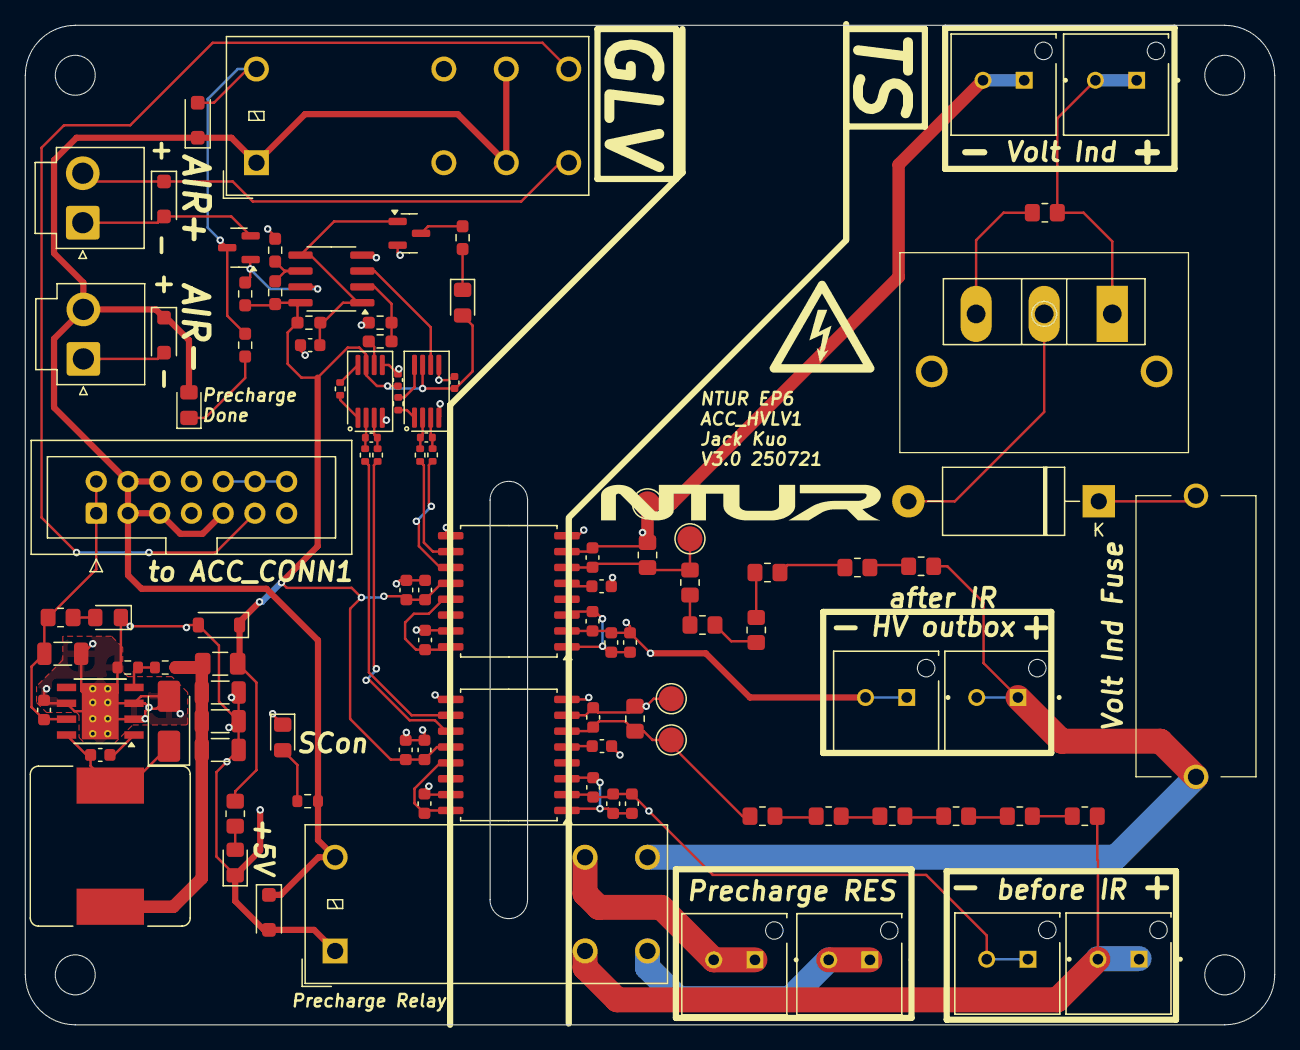
[picture p14: board ACC_HVLV1.kicad_pcb from above]

Board: 2 copper layers, 100.0 x 80.0 mm, 106 parts (0 on the bottom side), 63 nets.
