NTURacingTeam/nturt_kicad/EP6/Powertrain_Group/INV_GateDriver/INV_GateDriver.kicad_pcb

## KiCad design EP6/Powertrain_Group/INV_GateDriver/INV_GateDriver.kicad_pcb (2025-10-15)

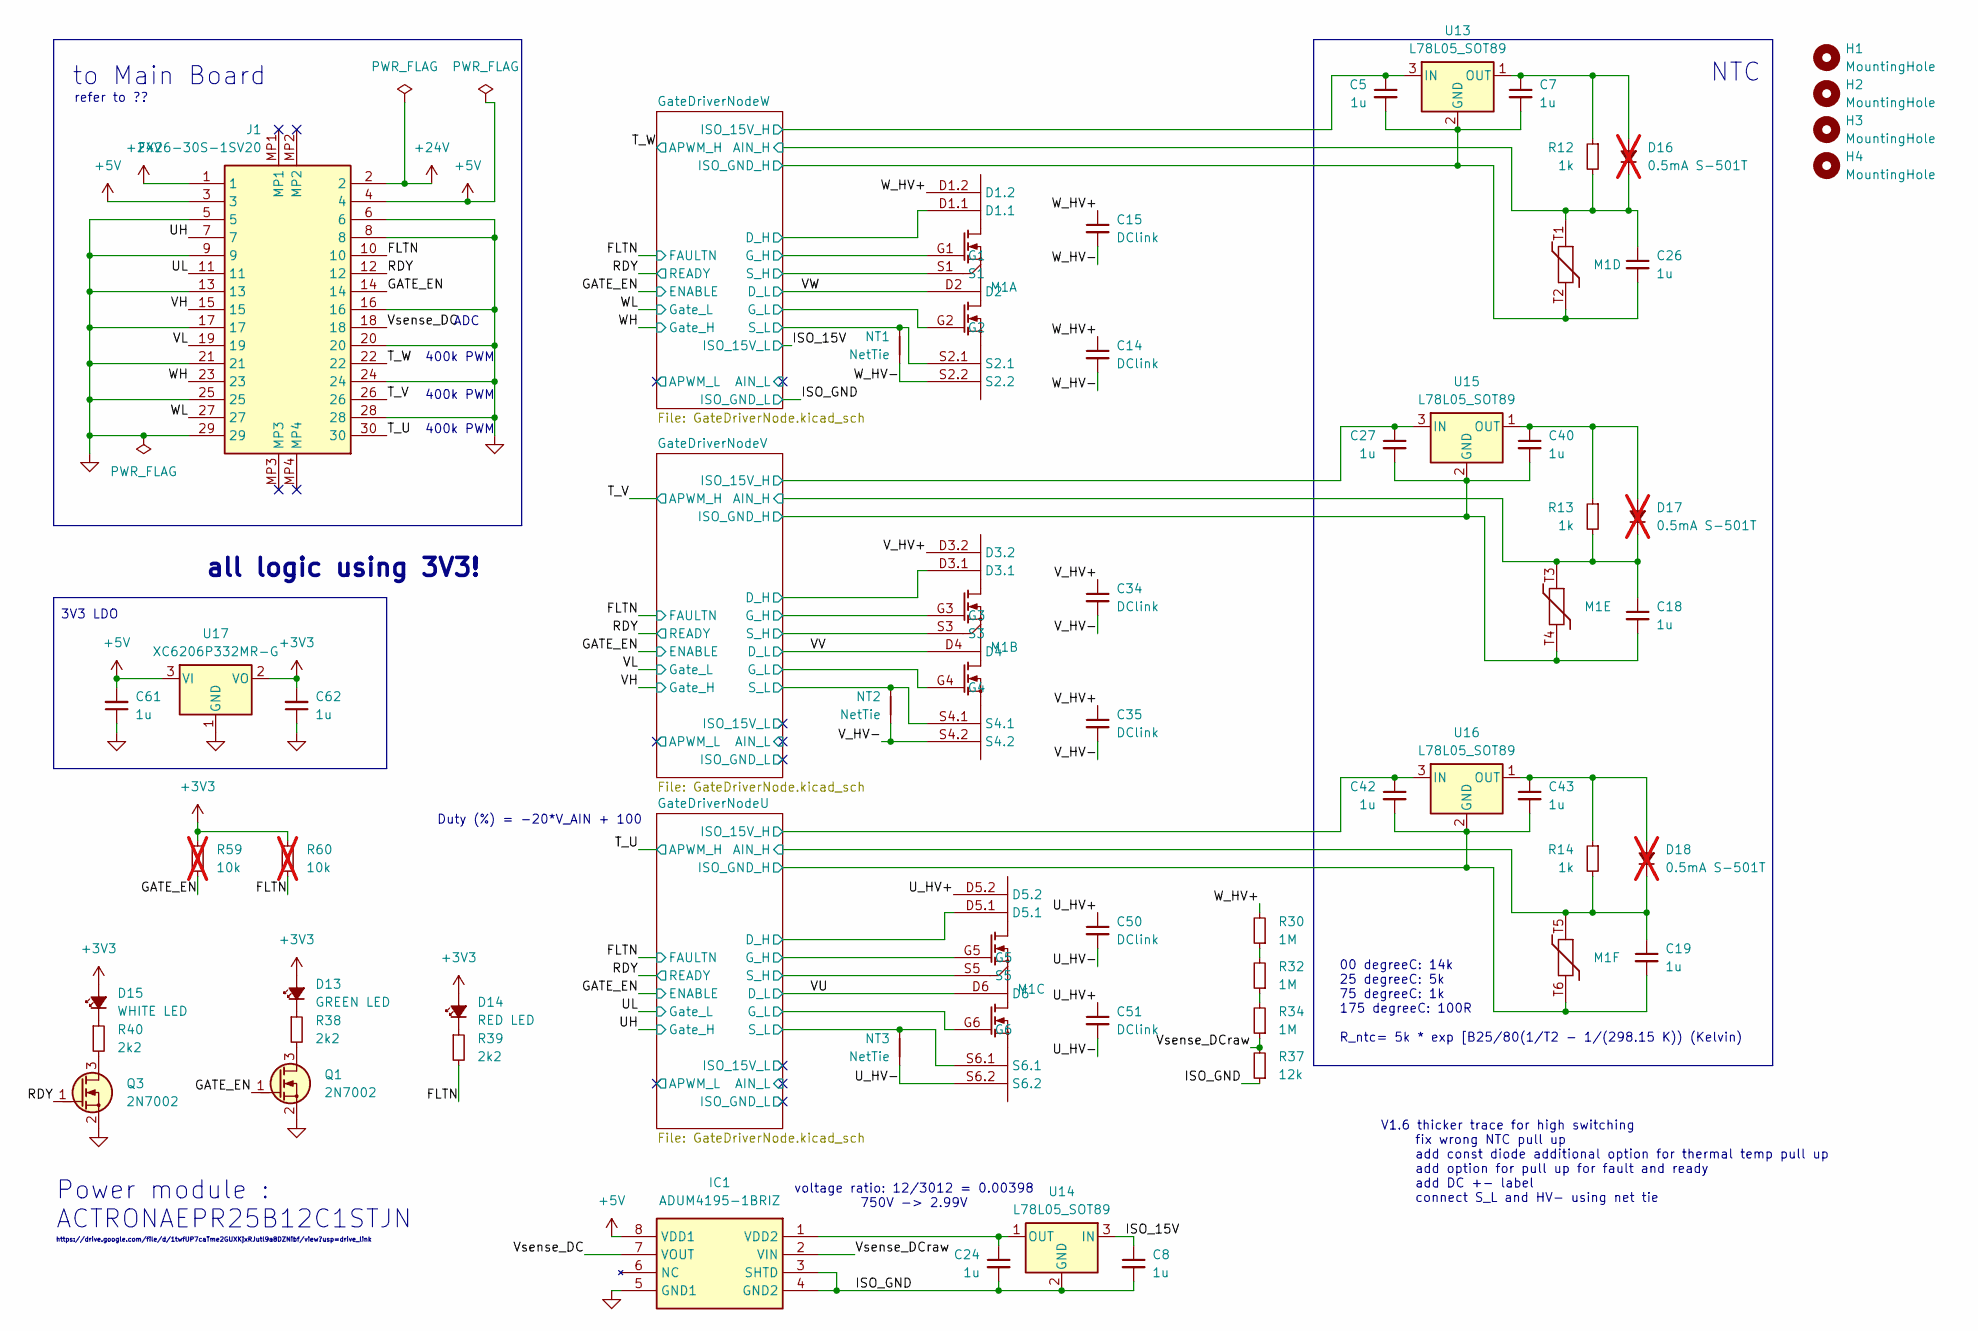
[picture p15: schematic INV_GateDriver.kicad_sch]

Parts:
C5, C7, C8, C18, C19, C24, C26, C27, C40, C42, C43: 1u; C_0603_1608Metric
C14, C15, C34, C35, C50, C51: DClink; B58035U5205M062
C61, C62: 1u; C_0402_1005Metric
D13: GREEN LED; LED_0805_2012Metric
D14: RED LED; LED_0805_2012Metric
D15: WHITE LED; LED_0805_2012Metric
D16, D17, D18: 0.5mA S-501T; D_1206_3216Metric; not fitted
H1, H2, H3, H4: MountingHole; MountingHole_3.2mm_M3
IC1: ADUM4195-1BRIZ; SOIC127P1031X265-8N; Manufacturer_Part_Number ADUM4195-1BRIZ; Mouser Part Number 584-ADUM4195-1BRIZ
J1: FX26-30S-1SV20; FX2630S1SV20; Mouser Part Number 798-FX2630S1SV20
M1: InverterSiCModule_HybridPack
NT1, NT2, NT3: NetTie; NetTie-2_SMD_Pad2.0mm
Q1, Q3: 2N7002; SOT-23
R12, R13, R14: 1k; R_0603_1608Metric
R30, R32, R34: 1M; R_1206_3216Metric
R37: 12k; R_0805_2012Metric
R38, R39, R40: 2k2; R_0402_1005Metric
R59, R60: 10k; R_0402_1005Metric; not fitted
U13, U14, U15, U16: L78L05_SOT89; SOT-89-3
U17: XC6206P332MR-G; SOT-23-3

Connections:
+3V3: C62.2, D13.2 (A), D14.2 (A), D15.2 (A), R59.1, R60.1, U17.2 (VO); also elsewhere on the board
+5V: C61.2, IC1.8 (VDD1), J1.3, J1.4, U17.3 (VI)
+24V: J1.1, J1.2; also elsewhere on the board
/FLTN: J1.10, R39.2, R60.2; also elsewhere on the board
/GATE_EN: J1.14, Q1.1 (G), R59.2; also elsewhere on the board
/GateDriverNodeU/0V_H: C19.2, C42.2, C43.2, M1.S5, M1.T6, U16.2 (GND); also elsewhere on the board
/GateDriverNodeU/0V_L: M1.S6.1, NT3.2; also elsewhere on the board
/GateDriverNodeU/+V_H: C42.1, U16.3 (IN); also elsewhere on the board
/GateDriverNodeU/AIN_H: C19.1, D18.1 (K), M1.T5, R14.2; also elsewhere on the board
/GateDriverNodeU/D_H: M1.D5.1; also elsewhere on the board
/GateDriverNodeU/G_H: M1.G5; also elsewhere on the board
/GateDriverNodeU/G_L: M1.G6; also elsewhere on the board
/GateDriverNodeV/0V_H: C18.2, C27.2, C40.2, M1.S3, M1.T4, U15.2 (GND); also elsewhere on the board
/GateDriverNodeV/0V_L: M1.S4.1, NT2.2; also elsewhere on the board
/GateDriverNodeV/+V_H: C27.1, U15.3 (IN); also elsewhere on the board
/GateDriverNodeV/AIN_H: C18.1, D17.1 (K), M1.T3, R13.2; also elsewhere on the board
/GateDriverNodeV/D_H: M1.D3.1; also elsewhere on the board
/GateDriverNodeV/G_H: M1.G3; also elsewhere on the board
/GateDriverNodeV/G_L: M1.G4; also elsewhere on the board
/GateDriverNodeW/0V_H: C5.2, C7.2, C26.2, M1.S1, M1.T2, U13.2 (GND); also elsewhere on the board
/GateDriverNodeW/+V_H: C5.1, U13.3 (IN); also elsewhere on the board
/GateDriverNodeW/AIN_H: C26.1, D16.1 (K), M1.T1, R12.2; also elsewhere on the board
/GateDriverNodeW/D_H: M1.D1.1; also elsewhere on the board
/GateDriverNodeW/G_H: M1.G1; also elsewhere on the board
/GateDriverNodeW/G_L: M1.G2; also elsewhere on the board
/ISO_15V: C8.1, U14.3 (IN); also elsewhere on the board
/ISO_GND: C8.2, C24.2, IC1.3 (SHTD), IC1.4 (GND2), M1.S2.1, NT1.2, R37.1, U14.2 (GND); also elsewhere on the board
/RDY: J1.12, Q3.1 (G); also elsewhere on the board
/T_U: J1.30; also elsewhere on the board
/T_V: J1.26; also elsewhere on the board
/T_W: J1.22; also elsewhere on the board
/UH: J1.7; also elsewhere on the board
/UL: J1.11; also elsewhere on the board
/U_HV+: C50.1, C51.1, M1.D5.2
/U_HV-: C50.2, C51.2, M1.S6.2, NT3.1
/VH: J1.15; also elsewhere on the board
/VL: J1.19; also elsewhere on the board
/VU: M1.D6; also elsewhere on the board
/VV: M1.D4; also elsewhere on the board
/VW: M1.D2; also elsewhere on the board
/V_HV+: C34.1, C35.1, M1.D3.2
/V_HV-: C34.2, C35.2, M1.S4.2, NT2.1
/Vsense_DC: IC1.7 (VOUT), J1.18
/Vsense_DCraw: IC1.2 (VIN), R34.1, R37.2
/WH: J1.23; also elsewhere on the board
/WL: J1.27; also elsewhere on the board
/W_HV+: C14.1, C15.1, M1.D1.2, R30.2
/W_HV-: C14.2, C15.2, M1.S2.2, NT1.1
GND: C61.1, C62.1, IC1.5 (GND1), J1.5, J1.6, J1.8, J1.9, J1.13, J1.16, J1.17, J1.20, J1.21, J1.24, J1.25, J1.28, J1.29, Q1.2 (S), Q3.2 (S), U17.1 (GND); also elsewhere on the board
unnamed: D13.1 (K), R38.1
unnamed: D14.1 (K), R39.1
unnamed: D15.1 (K), R40.1
unnamed: C7.1, D16.2 (A), R12.1, U13.1 (OUT)
unnamed: C40.1, D17.2 (A), R13.1, U15.1 (OUT)
unnamed: C43.1, D18.2 (A), R14.1, U16.1 (OUT)
unnamed: C24.1, IC1.1 (VDD2), U14.1 (OUT)
unnamed: Q1.3 (D), R38.2
unnamed: Q3.3 (D), R40.2
unnamed: R30.1, R32.2
unnamed: R32.1, R34.2

Notes on the sheet:
Power module : ACTRONAEPR25B12C1STJN
NTC
all logic using 3V3!
V1.6 thicker trace for high switching fix wrong NTC pull up add const diode additional option for thermal temp pull up add option for pull up for fault and ready add DC +- label connect S_L and HV- using net tie
Duty (%) = -20*V_AIN + 100
400k PWM
refer to ??
to Main Board
ADC
3V3 LDO
00 degreeC: 14k 25 degreeC: 5k 75 degreeC: 1k 175 degreeC: 100R R_ntc= 5k * exp [B25/80(1/T2 - 1/(298.15 K)) (Kelvin)
voltage ratio: 12/3012 = 0.00398 750V -> 2.99V
https://drive.google.com/file/d/1twfUP7caTme2GUXKjxRJutl9a8DZNibf/view?usp=drive_link
