NTURacingTeam/nturt_kicad/EP6/Powertrain_Group/INV_GateDriver/INV_GateDriver.kicad_pcb

## KiCad design EP6/Powertrain_Group/INV_GateDriver/INV_GateDriver.kicad_pcb (continued)

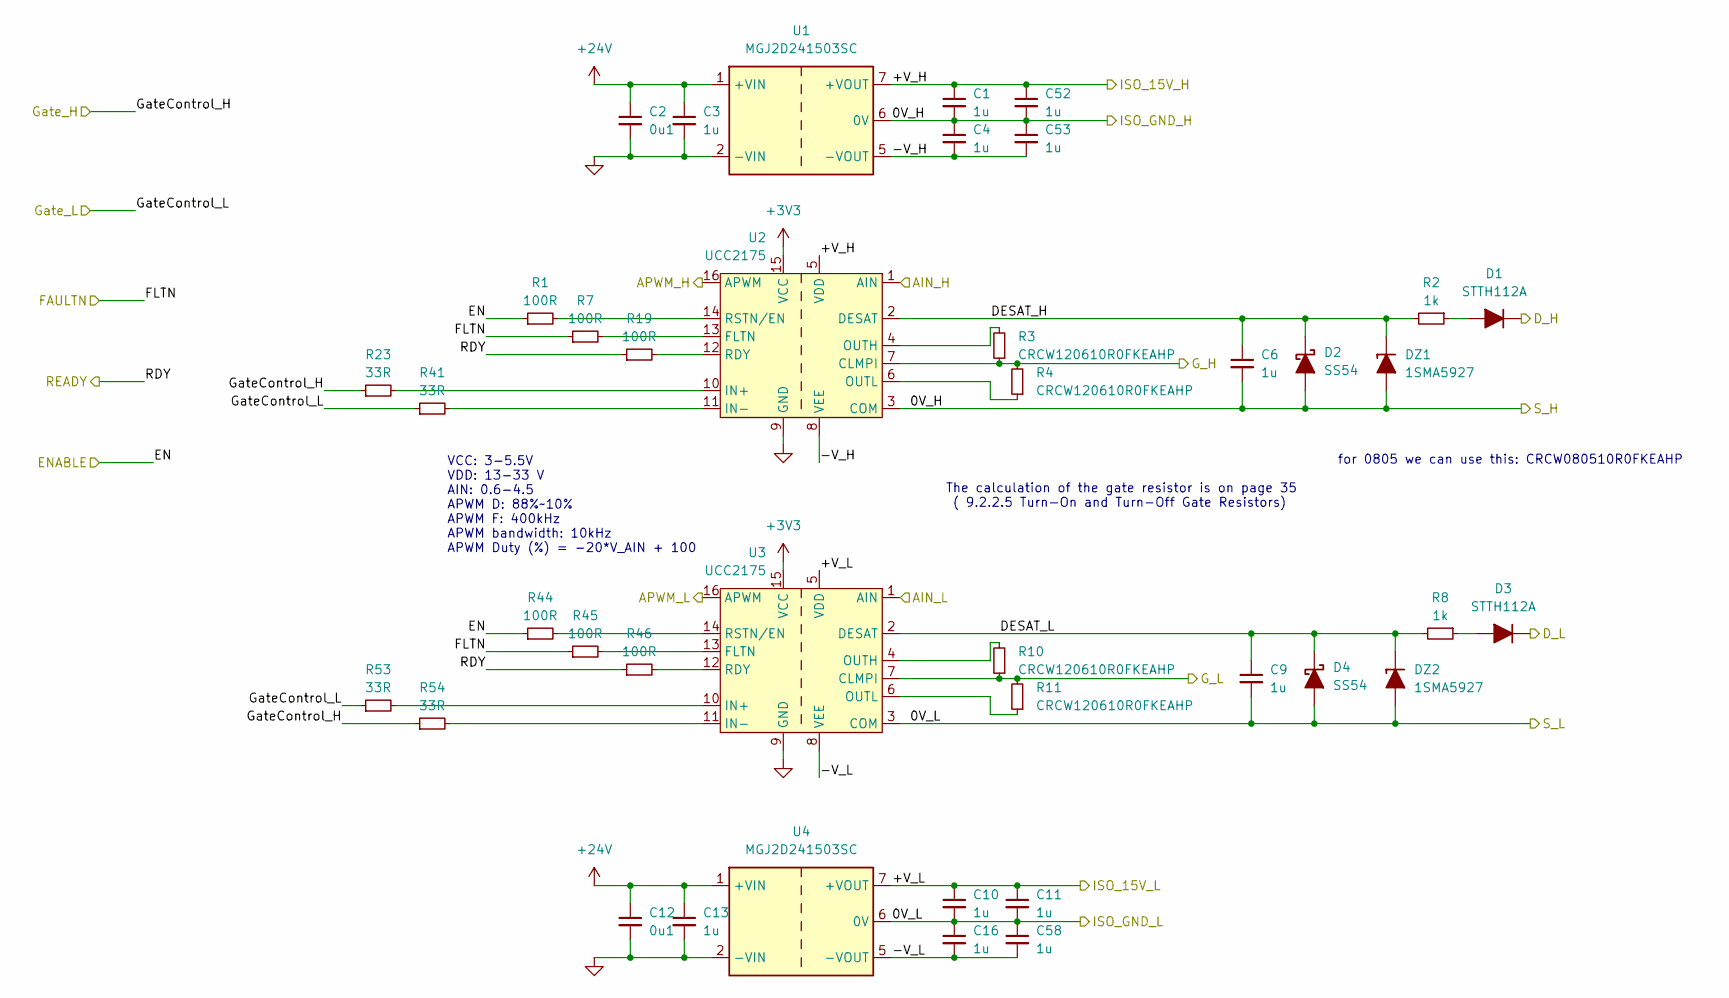
[picture p16: schematic GateDriverNode.kicad_sch, INV_GateDriver]

Parts:
C1, C4, C10, C11, C16, C52, C53, C58: 1u; C_1206_3216Metric
C2, C12: 0u1; C_0603_1608Metric
C3, C6, C9, C13: 1u; C_0603_1608Metric
D1, D3: STTH112A; D_SMA
D2, D4: SS54; D_SMA
DZ1, DZ2: 1SMA5927; D_SMA
R1, R7, R19, R44, R45, R46: 100R; R_0402_1005Metric
R2, R8: 1k; R_0603_1608Metric
R3, R4, R10, R11: CRCW120610R0FKEAHP; R_1206_3216Metric
R23, R41, R53, R54: 33R; R_0402_1005Metric
U1, U4: MGJ2D241503SC; Converter_DCDC_Murata_MGJ2DxxxxxxSC_THT
U2, U3: UCC2175; SOIC-16W_7.5x10.3mm_P1.27mm

Connections:
+3V3: U2.15 (VCC), U3.15 (VCC); also elsewhere on the board
+24V: C2.1, C3.1, C12.1, C13.1, U1.1 (+VIN), U4.1 (+VIN); also elsewhere on the board
/FLTN: R7.1, R45.1; also elsewhere on the board
/GATE_EN: R1.1, R44.1; also elsewhere on the board
/GateDriverNodeW/0V_H: C1.2, C4.1, C6.2, C52.2, C53.1, D2.2 (A), DZ1.2 (A), U1.6 (0V), U2.3 (COM); also elsewhere on the board
/GateDriverNodeW/+V_H: C1.1, C52.1, U1.7 (+VOUT), U2.5 (VDD); also elsewhere on the board
/GateDriverNodeW/-V_H: C4.2, C53.2, U1.5 (-VOUT), U2.8 (VEE)
/GateDriverNodeW/-V_L: C16.2, C58.2, U3.8 (VEE), U4.5 (-VOUT)
/GateDriverNodeW/AIN_H: U2.1 (AIN); also elsewhere on the board
/GateDriverNodeW/AIN_L: U3.1 (AIN)
/GateDriverNodeW/APWM_L: U3.16 (APWM)
/GateDriverNodeW/DESAT_H: C6.1, D2.1 (K), DZ1.1 (K), R2.2, U2.2 (DESAT)
/GateDriverNodeW/DESAT_L: C9.1, D4.1 (K), DZ2.1 (K), R8.2, U3.2 (DESAT)
/GateDriverNodeW/D_H: D1.1 (K); also elsewhere on the board
/GateDriverNodeW/G_H: R3.1, R4.2, U2.7 (CLMPI); also elsewhere on the board
/GateDriverNodeW/G_L: R10.1, R11.2, U3.7 (CLMPI); also elsewhere on the board
/ISO_15V: C10.1, C11.1, U3.5 (VDD), U4.7 (+VOUT); also elsewhere on the board
/ISO_GND: C9.2, C10.2, C11.2, C16.1, C58.1, D4.2 (A), DZ2.2 (A), U3.3 (COM), U4.6 (0V); also elsewhere on the board
/RDY: R19.1, R46.1; also elsewhere on the board
/T_W: U2.16 (APWM); also elsewhere on the board
/VW: D3.1 (K); also elsewhere on the board
/WH: R23.1, R54.1; also elsewhere on the board
/WL: R41.1, R53.1; also elsewhere on the board
GND: C2.2, C3.2, C12.2, C13.2, U1.2 (-VIN), U2.9 (GND), U3.9 (GND), U4.2 (-VIN); also elsewhere on the board
unnamed: D1.2 (A), R2.1
unnamed: D3.2 (A), R8.1
unnamed: R7.2, U2.13 (FLTN)
unnamed: R23.2, U2.10 (IN+)
unnamed: R41.2, U2.11 (IN-)
unnamed: R3.2, U2.4 (OUTH)
unnamed: R4.1, U2.6 (OUTL)
unnamed: R19.2, U2.12 (RDY)
unnamed: R1.2, U2.14 (RSTN/EN)
unnamed: R45.2, U3.13 (FLTN)
unnamed: R53.2, U3.10 (IN+)
unnamed: R54.2, U3.11 (IN-)
unnamed: R10.2, U3.4 (OUTH)
unnamed: R11.1, U3.6 (OUTL)
unnamed: R46.2, U3.12 (RDY)
unnamed: R44.2, U3.14 (RSTN/EN)

Parts of its further copies:
C20, C23, C29, C30, C33, C36, C39, C45, C46, C49, C54, C55, C56, C57, C59, C60: 1u; C_1206_3216Metric
C21, C31, C37, C47: 0u1; C_0603_1608Metric
C22, C25, C28, C32, C38, C41, C44, C48: 1u; C_0603_1608Metric
D5, D7, D9, D11: STTH112A; D_SMA
D6, D8, D10, D12: SS54; D_SMA
DZ3, DZ4, DZ5, DZ6: 1SMA5927; D_SMA
R5, R6, R9, R15, R20, R21, R47, R48, R49, R50, R51, R52: 100R; R_0402_1005Metric
R16, R22, R27, R33: 1k; R_0603_1608Metric
R26, R31, R42, R43, R55, R56, R57, R58: 33R; R_0402_1005Metric
U5, U8, U9, U12: MGJ2D241503SC; Converter_DCDC_Murata_MGJ2DxxxxxxSC_THT
U6, U7, U10, U11: UCC2175; SOIC-16W_7.5x10.3mm_P1.27mm

Connections of its further copies:
+3V3: U6.15 (VCC), U7.15 (VCC), U10.15 (VCC), U11.15 (VCC); also elsewhere on the board
+24V: C21.1, C22.1, C31.1, C32.1, C37.1, C38.1, C47.1, C48.1, U5.1 (+VIN), U8.1 (+VIN), U9.1 (+VIN), U12.1 (+VIN); also elsewhere on the board
/FLTN: R9.1, R15.1, R48.1, R51.1; also elsewhere on the board
/GATE_EN: R5.1, R6.1, R47.1, R50.1; also elsewhere on the board
/GateDriverNodeU/0V_H: C36.2, C39.1, C41.2, C56.2, C57.1, D10.2 (A), DZ5.2 (A), U9.6 (0V), U10.3 (COM); also elsewhere on the board
/GateDriverNodeU/0V_L: C44.2, C45.2, C46.2, C49.1, C60.1, D12.2 (A), DZ6.2 (A), U11.3 (COM), U12.6 (0V); also elsewhere on the board
/GateDriverNodeU/+V_H: C36.1, C56.1, U9.7 (+VOUT), U10.5 (VDD); also elsewhere on the board
/GateDriverNodeU/+V_L: C45.1, C46.1, U11.5 (VDD), U12.7 (+VOUT)
/GateDriverNodeU/-V_H: C39.2, C57.2, U9.5 (-VOUT), U10.8 (VEE)
/GateDriverNodeU/-V_L: C49.2, C60.2, U11.8 (VEE), U12.5 (-VOUT)
/GateDriverNodeU/AIN_H: U10.1 (AIN); also elsewhere on the board
/GateDriverNodeU/AIN_L: U11.1 (AIN)
/GateDriverNodeU/APWM_L: U11.16 (APWM)
/GateDriverNodeU/DESAT_H: C41.1, D10.1 (K), DZ5.1 (K), R27.2, U10.2 (DESAT)
/GateDriverNodeU/DESAT_L: C44.1, D12.1 (K), DZ6.1 (K), R33.2, U11.2 (DESAT)
/GateDriverNodeU/D_H: D9.1 (K); also elsewhere on the board
/GateDriverNodeU/G_H: U10.7 (CLMPI); also elsewhere on the board
/GateDriverNodeU/G_L: U11.7 (CLMPI); also elsewhere on the board
/GateDriverNodeV/0V_H: C20.2, C23.1, C25.2, C54.2, C55.1, D6.2 (A), DZ3.2 (A), U5.6 (0V), U6.3 (COM); also elsewhere on the board
/GateDriverNodeV/0V_L: C28.2, C29.2, C30.2, C33.1, C59.1, D8.2 (A), DZ4.2 (A), U7.3 (COM), U8.6 (0V); also elsewhere on the board
/GateDriverNodeV/+V_H: C20.1, C54.1, U5.7 (+VOUT), U6.5 (VDD); also elsewhere on the board
/GateDriverNodeV/+V_L: C29.1, C30.1, U7.5 (VDD), U8.7 (+VOUT)
/GateDriverNodeV/-V_H: C23.2, C55.2, U5.5 (-VOUT), U6.8 (VEE)
/GateDriverNodeV/-V_L: C33.2, C59.2, U7.8 (VEE), U8.5 (-VOUT)
/GateDriverNodeV/AIN_H: U6.1 (AIN); also elsewhere on the board
/GateDriverNodeV/AIN_L: U7.1 (AIN)
/GateDriverNodeV/APWM_L: U7.16 (APWM)
/GateDriverNodeV/DESAT_H: C25.1, D6.1 (K), DZ3.1 (K), R16.2, U6.2 (DESAT)
/GateDriverNodeV/DESAT_L: C28.1, D8.1 (K), DZ4.1 (K), R22.2, U7.2 (DESAT)
/GateDriverNodeV/D_H: D5.1 (K); also elsewhere on the board
/GateDriverNodeV/G_H: U6.7 (CLMPI); also elsewhere on the board
/GateDriverNodeV/G_L: U7.7 (CLMPI); also elsewhere on the board
/RDY: R20.1, R21.1, R49.1, R52.1; also elsewhere on the board
/T_U: U10.16 (APWM); also elsewhere on the board
/T_V: U6.16 (APWM); also elsewhere on the board
/UH: R31.1, R58.1; also elsewhere on the board
/UL: R43.1, R57.1; also elsewhere on the board
/VH: R26.1, R56.1; also elsewhere on the board
/VL: R42.1, R55.1; also elsewhere on the board
/VU: D11.1 (K); also elsewhere on the board
/VV: D7.1 (K); also elsewhere on the board
GND: C21.2, C22.2, C31.2, C32.2, C37.2, C38.2, C47.2, C48.2, U5.2 (-VIN), U6.9 (GND), U7.9 (GND), U8.2 (-VIN), U9.2 (-VIN), U10.9 (GND), U11.9 (GND), U12.2 (-VIN); also elsewhere on the board
unnamed: D5.2 (A), R16.1
unnamed: D7.2 (A), R22.1
unnamed: D9.2 (A), R27.1
unnamed: D11.2 (A), R33.1
unnamed: R9.2, U6.13 (FLTN)
unnamed: R26.2, U6.10 (IN+)
unnamed: R42.2, U6.11 (IN-)
unnamed 103: U6.4 (OUTH); also elsewhere on the board
unnamed 104: U6.6 (OUTL); also elsewhere on the board
unnamed: R20.2, U6.12 (RDY)
unnamed: R5.2, U6.14 (RSTN/EN)
unnamed: R48.2, U7.13 (FLTN)
unnamed: R55.2, U7.10 (IN+)
unnamed: R56.2, U7.11 (IN-)
unnamed 110: U7.4 (OUTH); also elsewhere on the board
unnamed 111: U7.6 (OUTL); also elsewhere on the board
unnamed: R49.2, U7.12 (RDY)
unnamed: R47.2, U7.14 (RSTN/EN)
unnamed: R15.2, U10.13 (FLTN)
unnamed: R31.2, U10.10 (IN+)
unnamed: R43.2, U10.11 (IN-)
unnamed 117: U10.4 (OUTH); also elsewhere on the board
unnamed 118: U10.6 (OUTL); also elsewhere on the board
unnamed: R21.2, U10.12 (RDY)
unnamed: R6.2, U10.14 (RSTN/EN)
unnamed: R51.2, U11.13 (FLTN)
unnamed: R57.2, U11.10 (IN+)
unnamed: R58.2, U11.11 (IN-)
unnamed 124: U11.4 (OUTH); also elsewhere on the board
unnamed 125: U11.6 (OUTL); also elsewhere on the board
unnamed: R52.2, U11.12 (RDY)
unnamed: R50.2, U11.14 (RSTN/EN)

Notes on the sheet:
The calculation of the gate resistor is on page 35 ( 9.2.2.5 Turn-On and Turn-Off Gate Resistors)
VCC: 3-5.5V VDD: 13-33 V AIN: 0.6-4.5 APWM D: 88%~10% APWM F: 400kHz APWM bandwidth: 10kHz APWM Duty (%) = -20*V_AIN + 100
for 0805 we can use this: CRCW080510R0FKEAHP

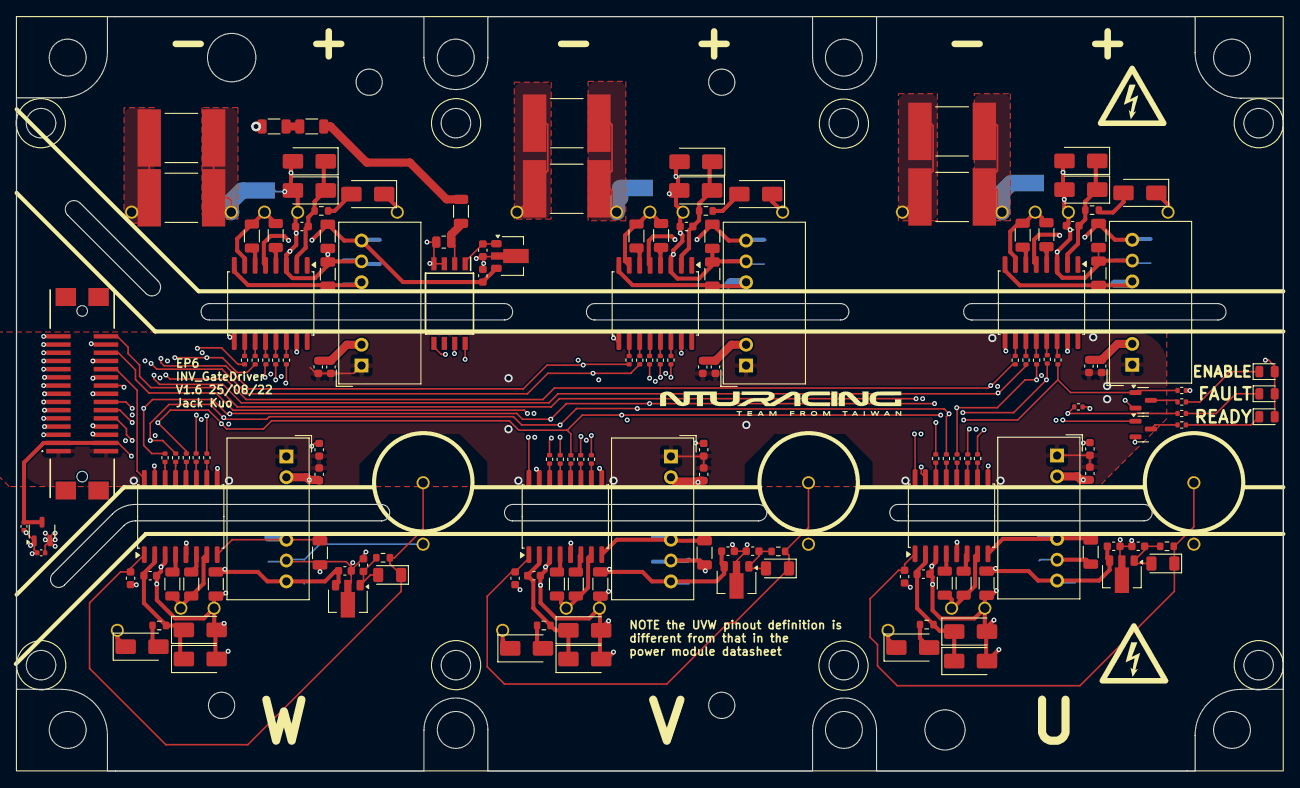
[picture p17: board INV_GateDriver.kicad_pcb from above]

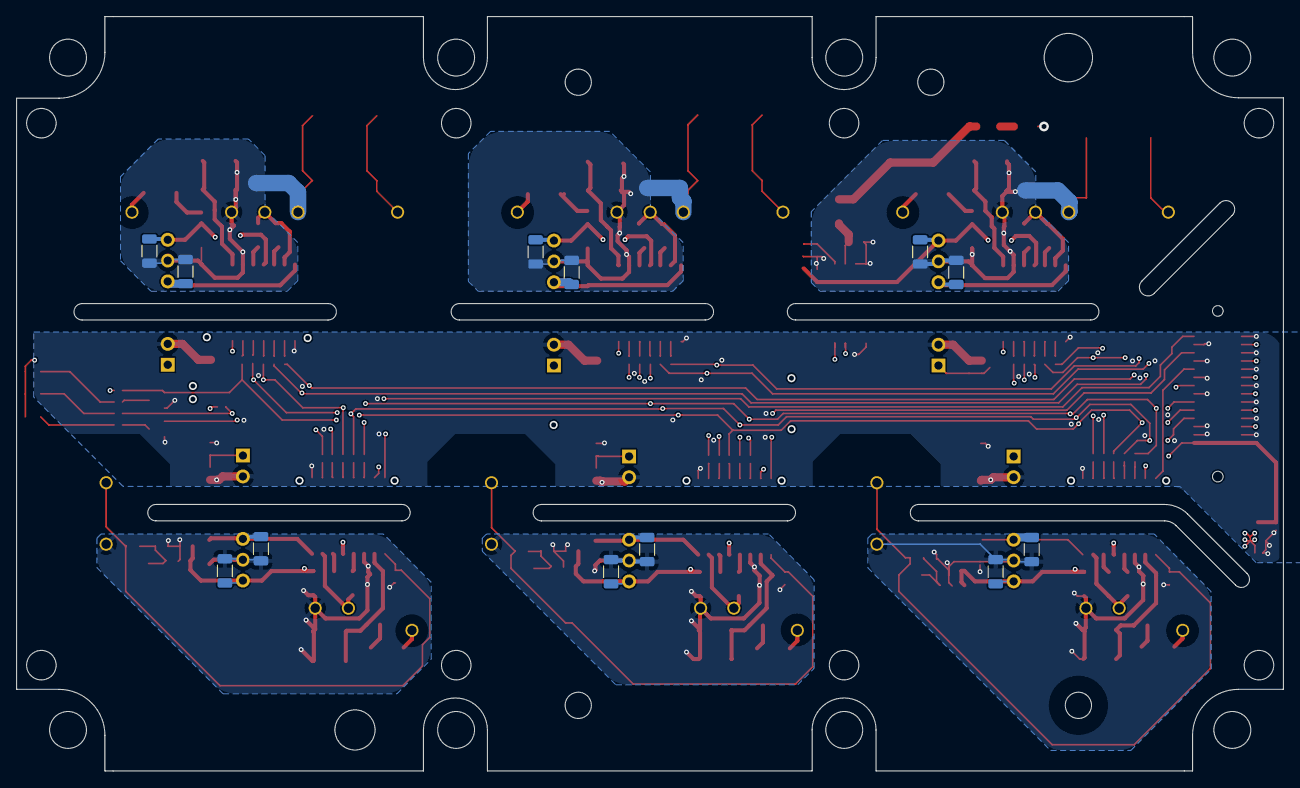
[picture p18: board INV_GateDriver.kicad_pcb from below]

Board: 4 copper layers, 154.5 x 92.0 mm, 174 parts (15 on the bottom side), 122 nets.

Other parts of the board:
R17, R18, R24, R25, R28, R29, R35, R36: CRCW080510R0FKEAHP; R_1206_3216Metric

Their connections:
/GateDriverNodeU/G_H: R28.1, R29.2; also elsewhere on the board
/GateDriverNodeU/G_L: R35.1, R36.2; also elsewhere on the board
/GateDriverNodeV/G_H: R17.1, R18.2; also elsewhere on the board
/GateDriverNodeV/G_L: R24.1, R25.2; also elsewhere on the board
unnamed 103: R17.2; also elsewhere on the board
unnamed 104: R18.1; also elsewhere on the board
unnamed 110: R24.2; also elsewhere on the board
unnamed 111: R25.1; also elsewhere on the board
unnamed 117: R28.2; also elsewhere on the board
unnamed 118: R29.1; also elsewhere on the board
unnamed 124: R35.2; also elsewhere on the board
unnamed 125: R36.1; also elsewhere on the board
