NTURacingTeam/nturt_kicad/EP6/Powertrain_Group/INV_DClinkCap2/INV_DClinkCap2.kicad_pcb

## KiCad design EP6/Powertrain_Group/INV_DClinkCap2/INV_DClinkCap2.kicad_pcb (2025-10-15)

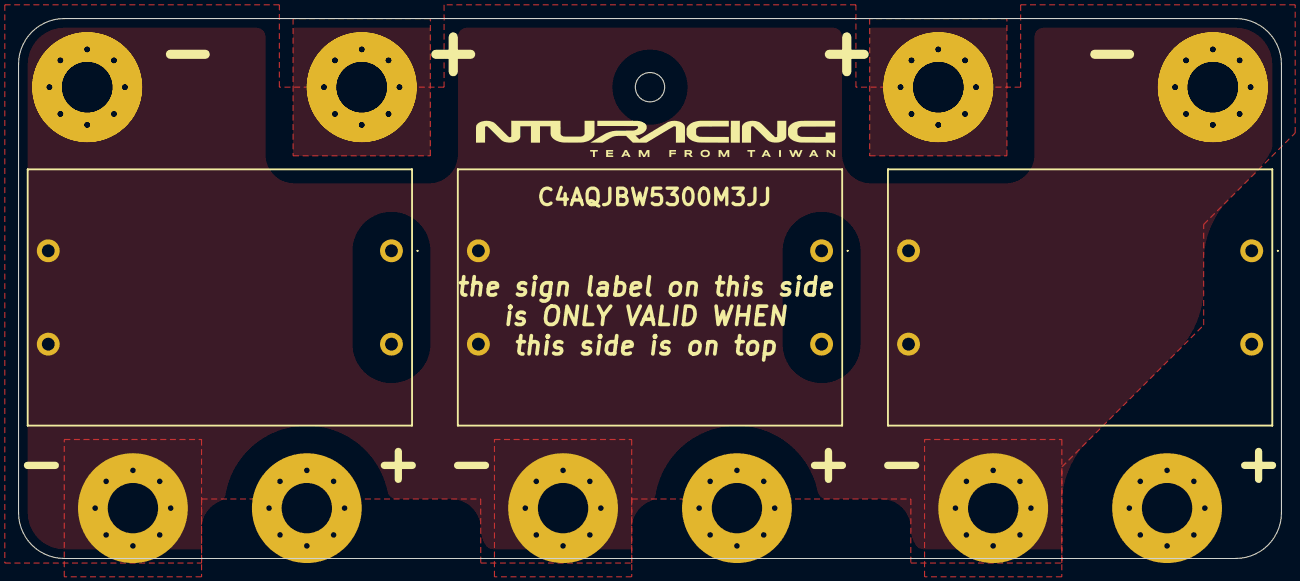
[picture p19: board INV_DClinkCap2.kicad_pcb from above]

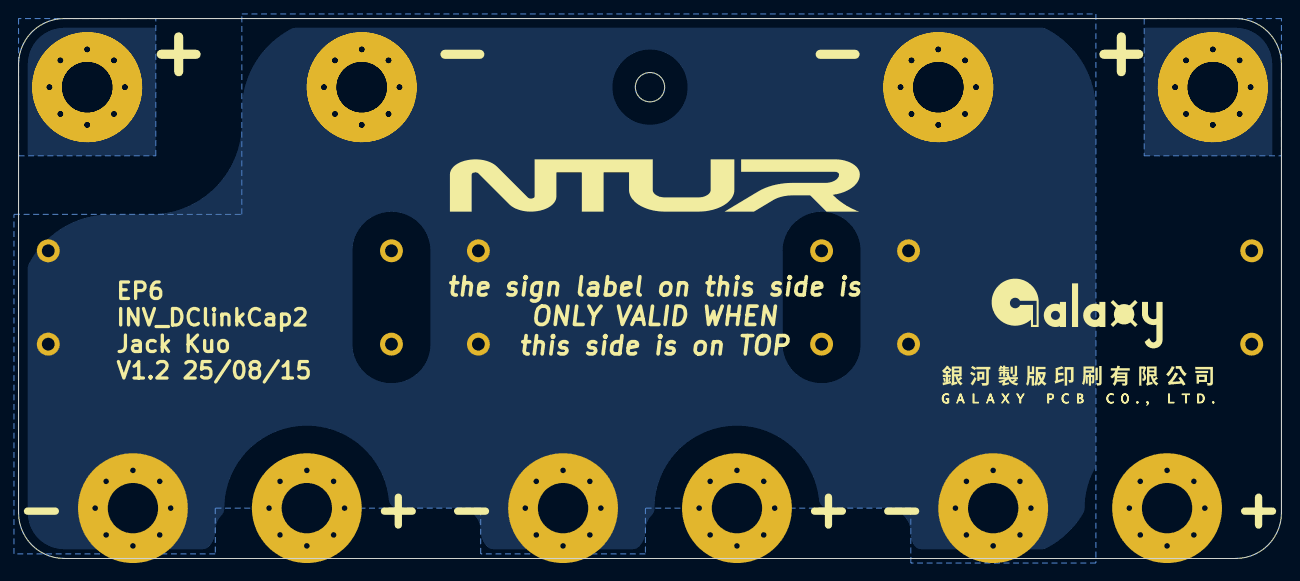
[picture p20: board INV_DClinkCap2.kicad_pcb from below]

Board: 2 copper layers, 138.0 x 59.0 mm, 18 parts (7 on the bottom side), 2 nets, no tracks yet.

Parts:
C1, C3, C5: 30µF; C4AQJBW5300M3JJ
H1, H3, H5, H8, H8#2, H10, H10#2: HV-; MountingHole_5.5mm_Pad_Via_15mm_square
H2, H4, H6, H7, H7#2, H9, H9#2: HV+; MountingHole_5.5mm_Pad_Via_15mm_square
H11: MountingHole; MountingHole_3.2mm_M3

Connections:
HV+: C1.1, C3.1, C5.1, H2.1, H4.1, H6.1, H7.1, H7#2.1, H9.1, H9#2.1
HV-: C1.2, C3.2, C5.2, H1.1, H3.1, H5.1, H8.1, H8#2.1, H10.1, H10#2.1
