NTURacingTeam/nturt_kicad/EP6/Electrical_Group/RPI_diyhat1/RPI_diyhat1.kicad_pcb

## KiCad design EP6/Electrical_Group/RPI_diyhat1/RPI_diyhat1.kicad_pcb (2025-10-15)

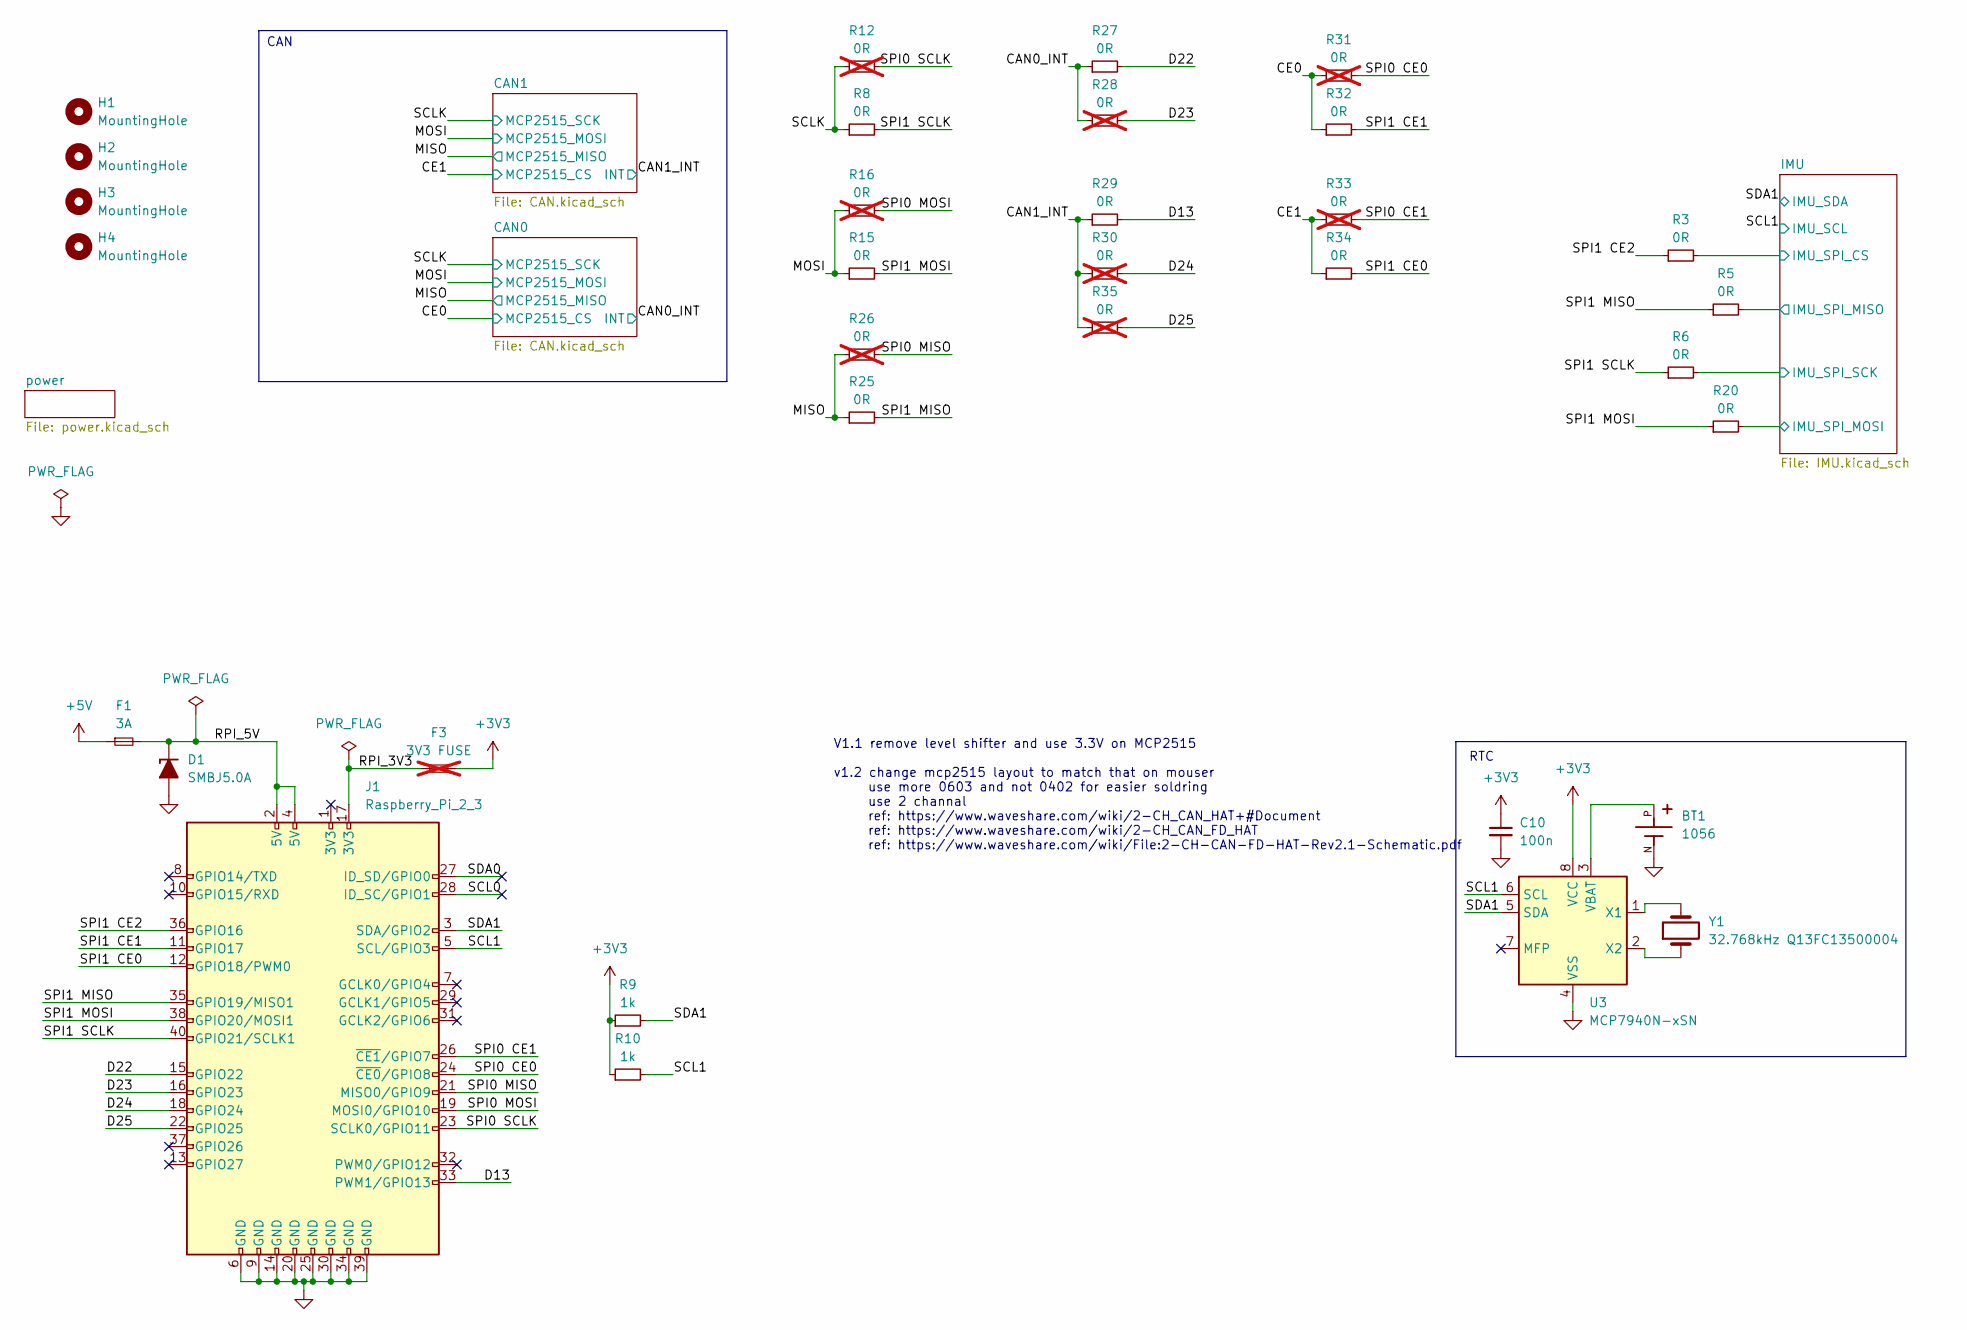
[picture p21: schematic RPI_diyhat1.kicad_sch]

Parts:
BT1: 1056; BAT_1056; PARTREV D
C10: 100n; C_0603_1608Metric
D1: SMBJ5.0A; D_SMB
F1: 3A; Fuse_1206_3216Metric
F3: 3V3 FUSE; Fuse_1206_3216Metric; not fitted
H1, H2, H3, H4: MountingHole; MountingHole_2.7mm_M2.5
J1: Raspberry_Pi_2_3; PinSocket_2x20_P2.54mm_Vertical
R3, R5, R6, R8, R15, R20, R25, R27, R29, R32, R34: 0R; R_0603_1608Metric
R9, R10: 1k; R_0603_1608Metric
R12, R16, R26, R28, R30, R31, R33, R35: 0R; R_0603_1608Metric; not fitted
U3: MCP7940N-xSN; SOIC-8_3.9x4.9mm_P1.27mm
Y1: 32.768kHz Q13FC13500004; Crystal_SMD_3215-2Pin_3.2x1.5mm

Connections:
+3V3: C10.1, F3.2, R9.1, R10.1, U3.8 (VCC); also elsewhere on the board
+5V: F1.1; also elsewhere on the board
/CAN0_INT: R27.1, R28.1; also elsewhere on the board
/CAN1_INT: R29.1, R30.1, R35.1; also elsewhere on the board
/CE0: R31.1, R32.1; also elsewhere on the board
/CE1: R33.1, R34.1; also elsewhere on the board
/D13: J1.33 (PWM1/GPIO13), R29.2
/D22: J1.15 (GPIO22), R27.2
/D23: J1.16 (GPIO23), R28.2
/D24: J1.18 (GPIO24), R30.2
/D25: J1.22 (GPIO25), R35.2
/IMU/IMU_SPI_CS: R3.2; also elsewhere on the board
/IMU/IMU_SPI_MISO: R5.2; also elsewhere on the board
/IMU/IMU_SPI_MOSI: R20.2; also elsewhere on the board
/IMU/IMU_SPI_SCK: R6.2; also elsewhere on the board
/MISO: R25.1, R26.1; also elsewhere on the board
/MOSI: R15.1, R16.1; also elsewhere on the board
/RPI_3V3: F3.1, J1.17 (3V3)
/RPI_5V: D1.1 (K), F1.2, J1.2 (5V), J1.4 (5V)
/SCL0: J1.28 (ID_SC/GPIO1)
/SCL1: J1.5 (SCL/GPIO3), R10.2, U3.6 (SCL); also elsewhere on the board
/SCLK: R8.1, R12.1; also elsewhere on the board
/SDA0: J1.27 (ID_SD/GPIO0)
/SDA1: J1.3 (SDA/GPIO2), R9.2, U3.5 (SDA); also elsewhere on the board
/SPI0 CE0: J1.24 (~CE0/GPIO8), R31.2
/SPI0 CE1: J1.26 (~CE1/GPIO7), R33.2
/SPI0 MISO: J1.21 (MISO0/GPIO9), R26.2
/SPI0 MOSI: J1.19 (MOSI0/GPIO10), R16.2
/SPI0 SCLK: J1.23 (SCLK0/GPIO11), R12.2
/SPI1 CE0: J1.12 (GPIO18/PWM0), R34.2
/SPI1 CE1: J1.11 (GPIO17), R32.2
/SPI1 CE2: J1.36 (GPIO16), R3.1
/SPI1 MISO: J1.35 (GPIO19/MISO1), R5.1, R25.2
/SPI1 MOSI: J1.38 (GPIO20/MOSI1), R15.2, R20.1
/SPI1 SCLK: J1.40 (GPIO21/SCLK1), R6.1, R8.2
GND: BT1.N, C10.2, D1.2 (A), J1.6 (GND), J1.9 (GND), J1.14 (GND), J1.20 (GND), J1.25 (GND), J1.30 (GND), J1.34 (GND), J1.39 (GND), U3.4 (VSS); also elsewhere on the board
unnamed: BT1.P, U3.3 (VBAT)
unnamed: U3.1 (X1), Y1.2
unnamed: U3.2 (X2), Y1.1

Notes on the sheet:
RTC
CAN
V1.1 remove level shifter and use 3.3V on MCP2515 v1.2 change mcp2515 layout to match that on mouser use more 0603 and not 0402 for easier soldring use 2 channal ref: https://www.waveshare.com/wiki/2-CH_CAN_HAT+#Document ref: https://www.waveshare.com/wiki/2-CH_CAN_FD_HAT ref: https://www.waveshare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

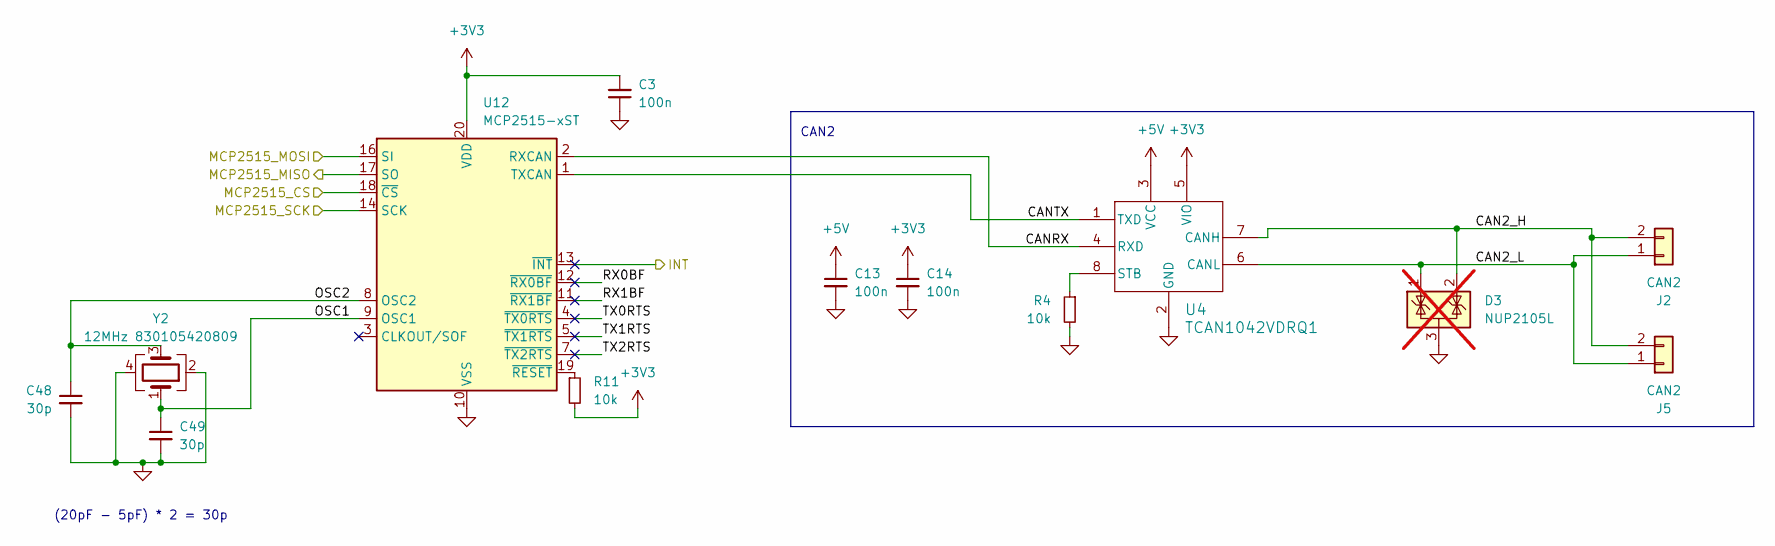
[picture p22: schematic CAN.kicad_sch, RPI_diyhat1]

Parts:
C3, C13, C14: 100n; C_0603_1608Metric
C48, C49: 30p; C_0603_1608Metric
D3: NUP2105L; SOT-23; not fitted
J2, J5: CAN2; JST_XH_B2B-XH-A_1x02_P2.50mm_Vertical
R4: 10k; C_0603_1608Metric
R11: 10k; R_0603_1608Metric
U4: TCAN1042VDRQ1; SOIC-8_3.9x4.9mm_P1.27mm
U12: MCP2515-xST; TSSOP-20_4.4x6.5mm_P0.65mm
Y2: 12MHz 830105420809; Crystal_SMD_3225-4Pin_3.2x2.5mm

Connections:
+3V3: C3.2, C14.1, R11.2, U4.5 (VIO), U12.20 (VDD); also elsewhere on the board
+5V: C13.1, U4.3 (VCC); also elsewhere on the board
/CAN1/CAN2_H: D3.2 (K), J2.2, J5.2, U4.7 (CANH)
/CAN1/CAN2_L: D3.1 (K), J2.1, J5.1, U4.6 (CANL)
/CAN1/CANRX: U4.4 (RXD), U12.2 (RXCAN)
/CAN1/CANTX: U4.1 (TXD), U12.1 (TXCAN)
/CAN1/OSC1: C49.1, U12.9 (OSC1), Y2.1
/CAN1/OSC2: C48.1, U12.8 (OSC2), Y2.3
/CAN1/RX0BF: U12.12 (~RX0BF)
/CAN1/RX1BF: U12.11 (~RX1BF)
/CAN1/TX0RTS: U12.4 (~TX0RTS)
/CAN1/TX1RTS: U12.5 (~TX1RTS)
/CAN1/TX2RTS: U12.7 (~TX2RTS)
/CAN1_INT: U12.13 (~INT); also elsewhere on the board
/CE1: U12.18 (~CS); also elsewhere on the board
/MISO: U12.17 (SO); also elsewhere on the board
/MOSI: U12.16 (SI); also elsewhere on the board
/SCLK: U12.14 (SCK); also elsewhere on the board
GND: C3.1, C13.2, C14.2, C48.2, C49.2, D3.3 (A), R4.2, U4.2 (GND), U12.10 (VSS), Y2.2, Y2.4; also elsewhere on the board
unnamed: R4.1, U4.8 (STB)
unnamed: R11.1, U12.19 (~RESET)

Parts of its further copies:
C2, C34, C35: 100n; C_0603_1608Metric
C50, C51: 30p; C_0603_1608Metric
D8: NUP2105L; SOT-23; not fitted
J6, J7: CAN2; JST_XH_B2B-XH-A_1x02_P2.50mm_Vertical
R17: 10k; R_0603_1608Metric
R18: 10k; C_0603_1608Metric
U8: TCAN1042VDRQ1; SOIC-8_3.9x4.9mm_P1.27mm
U13: MCP2515-xST; TSSOP-20_4.4x6.5mm_P0.65mm
Y3: 12MHz 830105420809; Crystal_SMD_3225-4Pin_3.2x2.5mm

Connections of its further copies:
+3V3: C2.2, C35.1, R17.2, U8.5 (VIO), U13.20 (VDD); also elsewhere on the board
+5V: C34.1, U8.3 (VCC); also elsewhere on the board
/CAN0/CAN2_H: D8.2 (K), J6.2, J7.2, U8.7 (CANH)
/CAN0/CAN2_L: D8.1 (K), J6.1, J7.1, U8.6 (CANL)
/CAN0/CANRX: U8.4 (RXD), U13.2 (RXCAN)
/CAN0/CANTX: U8.1 (TXD), U13.1 (TXCAN)
/CAN0/OSC1: C51.1, U13.9 (OSC1), Y3.1
/CAN0/OSC2: C50.1, U13.8 (OSC2), Y3.3
/CAN0/RX0BF: U13.12 (~RX0BF)
/CAN0/RX1BF: U13.11 (~RX1BF)
/CAN0/TX0RTS: U13.4 (~TX0RTS)
/CAN0/TX1RTS: U13.5 (~TX1RTS)
/CAN0/TX2RTS: U13.7 (~TX2RTS)
/CAN0_INT: U13.13 (~INT); also elsewhere on the board
/CE0: U13.18 (~CS); also elsewhere on the board
/MISO: U13.17 (SO); also elsewhere on the board
/MOSI: U13.16 (SI); also elsewhere on the board
/SCLK: U13.14 (SCK); also elsewhere on the board
GND: C2.1, C34.2, C35.2, C50.2, C51.2, D8.3 (A), R18.2, U8.2 (GND), U13.10 (VSS), Y3.2, Y3.4; also elsewhere on the board
unnamed: R18.1, U8.8 (STB)
unnamed: R17.1, U13.19 (~RESET)

Notes on the sheet:
(20pF - 5pF) * 2 = 30p
CAN2

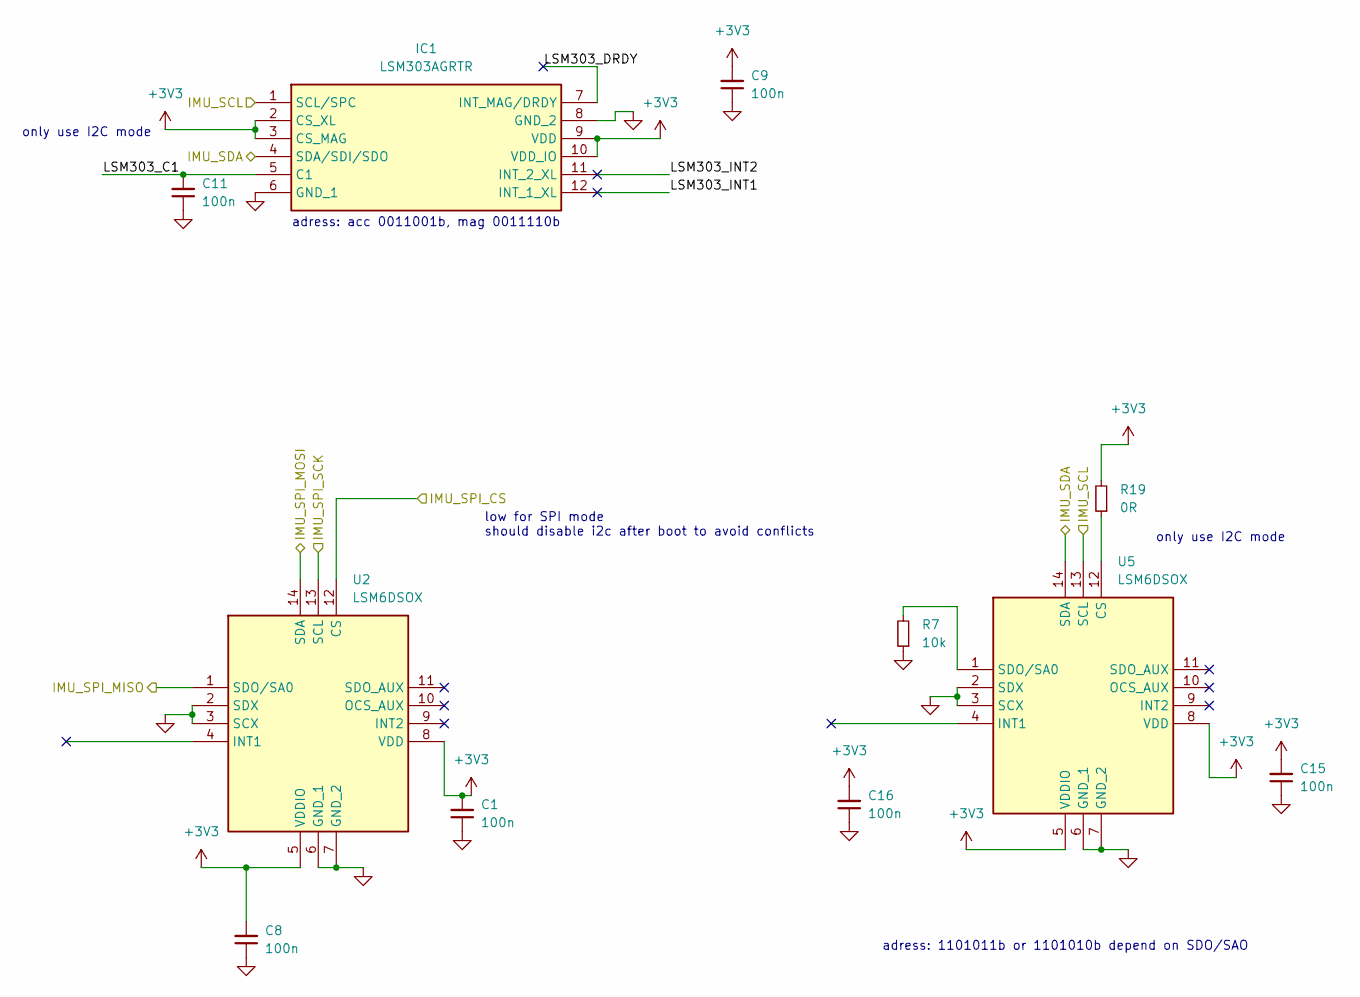
[picture p23: schematic IMU.kicad_sch, RPI_diyhat1]

Parts:
C1, C8, C9, C11, C15, C16: 100n; C_0402_1005Metric
IC1: LSM303AGRTR; LGA-12_2x2mm_P0.5mm; Mouser Part Number 511-LSM303AGRTR
R7: 10k; R_0402_1005Metric
R19: 0R; R_0402_1005Metric
U2, U5: LSM6DSOX; LGA-14_3x2.5mm_P0.5mm_LayoutBorder3x4y; Mouser Part Number 511-LSM6DSOXTR

Connections:
+3V3: C1.2, C8.2, C9.2, C15.2, C16.2, IC1.2 (CS_XL), IC1.3 (CS_MAG), IC1.9 (VDD), IC1.10 (VDD_IO), R19.2, U2.5 (VDDIO), U2.8 (VDD), U5.5 (VDDIO), U5.8 (VDD); also elsewhere on the board
/IMU/IMU_SPI_CS: U2.12 (CS); also elsewhere on the board
/IMU/IMU_SPI_MISO: U2.1 (SDO/SA0); also elsewhere on the board
/IMU/IMU_SPI_MOSI: U2.14 (SDA); also elsewhere on the board
/IMU/IMU_SPI_SCK: U2.13 (SCL); also elsewhere on the board
/IMU/LSM303_C1: C11.2, IC1.5 (C1)
/IMU/LSM303_DRDY: IC1.7 (INT_MAG/DRDY)
/IMU/LSM303_INT1: IC1.12 (INT_1_XL)
/IMU/LSM303_INT2: IC1.11 (INT_2_XL)
/SCL1: IC1.1 (SCL/SPC), U5.13 (SCL); also elsewhere on the board
/SDA1: IC1.4 (SDA/SDI/SDO), U5.14 (SDA); also elsewhere on the board
GND: C1.1, C8.1, C9.1, C11.1, C15.1, C16.1, IC1.6 (GND_1), IC1.8 (GND_2), R7.1, U2.2 (SDX), U2.3 (SCX), U2.6 (GND_1), U2.7 (GND_2), U5.2 (SDX), U5.3 (SCX), U5.6 (GND_1), U5.7 (GND_2); also elsewhere on the board
unnamed: R19.1, U5.12 (CS)
unnamed: R7.2, U5.1 (SDO/SA0)

Notes on the sheet:
only use I2C mode
adress: acc 0011001b, mag 0011110b
low for SPI mode should disable i2c after boot to avoid conflicts
adress: 1101011b or 1101010b depend on SDO/SAO

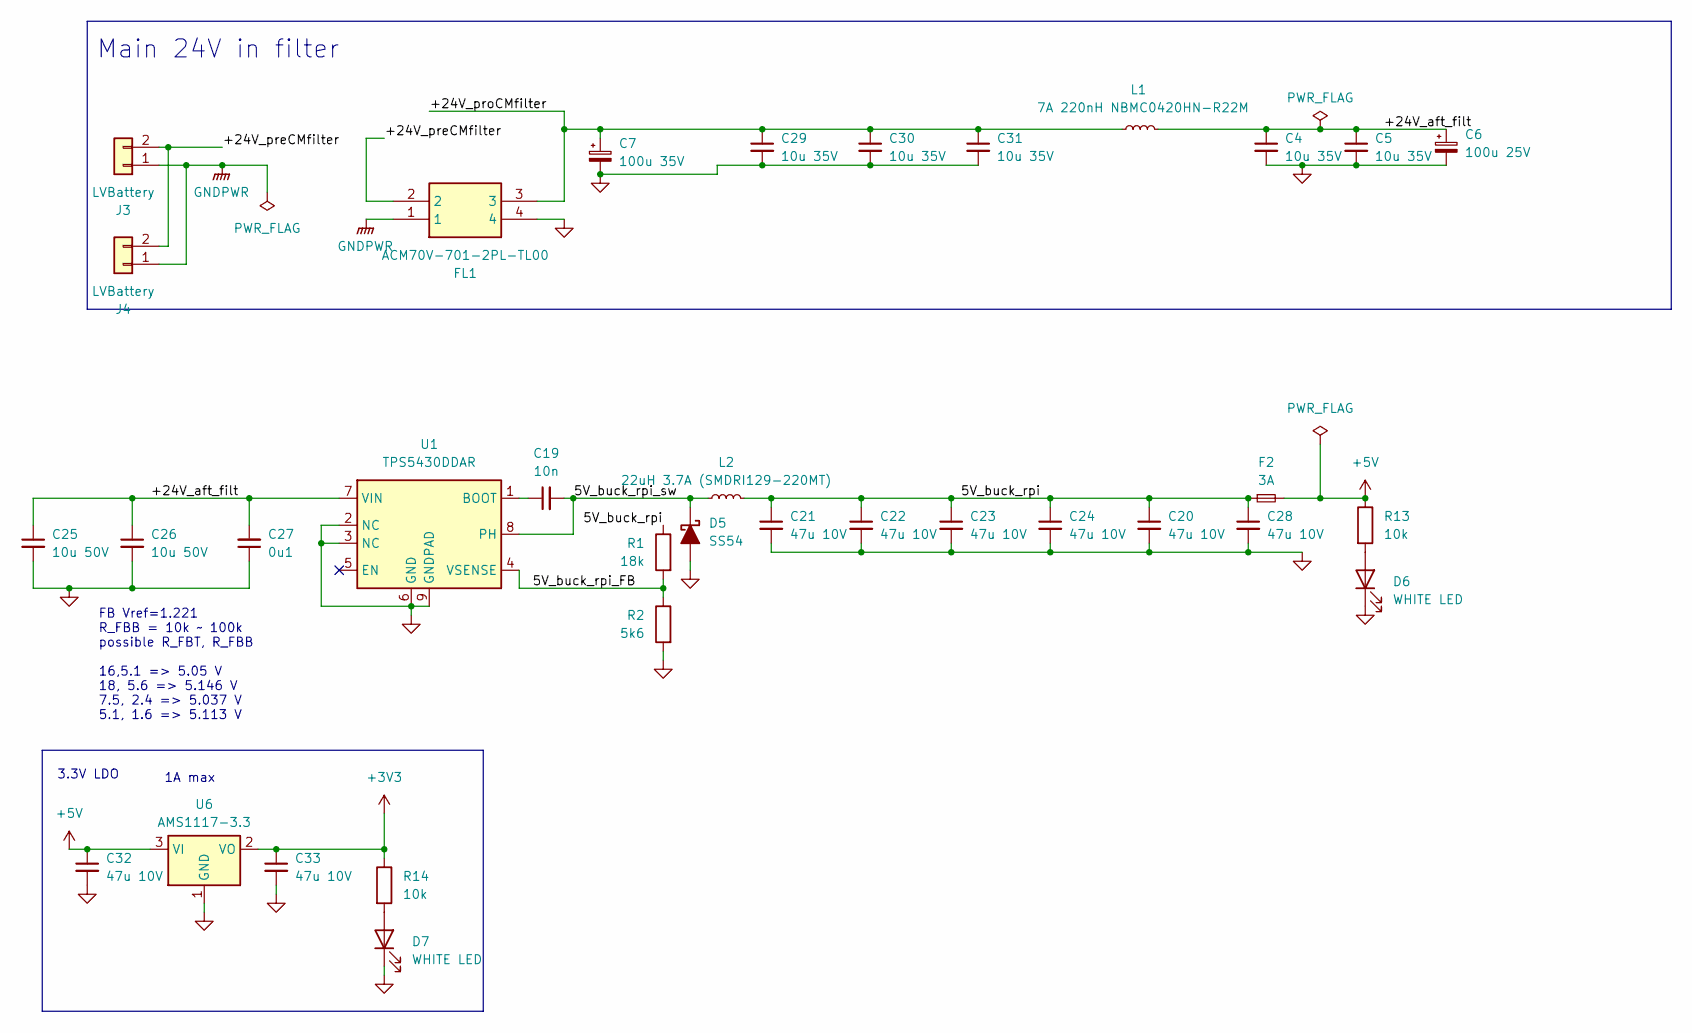
[picture p24: schematic power.kicad_sch, RPI_diyhat1]

Parts:
C4, C5, C29, C30, C31: 10u 35V; C_1206_3216Metric
C6: 100u 25V; CP_Radial_D6.3mm_P2.50mm
C7: 100u 35V; CP_Radial_D6.3mm_P2.50mm
C19: 10n; C_0603_1608Metric
C20, C21, C22, C23, C24, C28, C32, C33: 47u 10V; C_1206_3216Metric
C25, C26: 10u 50V; C_1206_3216Metric
C27: 0u1; C_0603_1608Metric
D5: SS54; D_SMA
D6, D7: WHITE LED; LED_0603_1608Metric
F2: 3A; Fuse_1206_3216Metric
FL1: ACM70V-701-2PL-TL00; ACM70V7012PLTL00; Mouser Part Number 810-ACM70V7012PLTL00
J3, J4: LVBattery; JST_XH_B2B-XH-A_1x02_P2.50mm_Vertical
L1: 7A 220nH NBMC0420HN-R22M; L_Ferrocore_DLG-0403
L2: 22uH 3.7A (SMDRI129-220MT); L_Bourns_SRR1260
R1: 18k; R_0603_1608Metric
R2: 5k6; R_0603_1608Metric
R13, R14: 10k; R_0603_1608Metric
U1: TPS5430DDAR; TI_SO-PowerPAD-8_ThermalVias
U6: AMS1117-3.3; SOT-223-3_TabPin2

Connections:
+3V3: C33.1, R14.1, U6.2 (VO); also elsewhere on the board
+5V: C32.1, F2.2, R13.1, U6.3 (VI); also elsewhere on the board
/power/5V_buck_rpi: C20.1, C21.1, C22.1, C23.1, C24.1, C28.1, F2.1, L2.2, R1.1
/power/5V_buck_rpi_FB: R1.2, R2.1, U1.4 (VSENSE)
/power/5V_buck_rpi_sw: C19.2, D5.1 (K), L2.1, U1.8 (PH)
/power/+24V_aft_filt: C4.1, C5.1, C6.1, C25.1, C26.1, C27.2, L1.2, U1.7 (VIN)
/power/+24V_preCMfilter: FL1.2, J3.2, J4.2
/power/+24V_proCMfilter: C7.1, C29.1, C30.1, C31.1, FL1.3, L1.1
GND: C4.2, C5.2, C6.2, C7.2, C20.2, C21.2, C22.2, C23.2, C24.2, C25.2, C26.2, C27.1, C28.2, C29.2, C30.2, C31.2, C32.2, C33.2, D5.2 (A), D6.1 (K), D7.1 (K), FL1.4, R2.2, U1.2 (NC), U1.3 (NC), U1.6 (GND), U1.9 (GNDPAD), U6.1 (GND); also elsewhere on the board
GNDPWR: FL1.1, J3.1, J4.1
unnamed: D6.2 (A), R13.2
unnamed: D7.2 (A), R14.2
unnamed: C19.1, U1.1 (BOOT)

Notes on the sheet:
3.3V LDO
FB Vref=1.221 R_FBB = 10k ~ 100k possible R_FBT, R_FBB 16,5.1 => 5.05 V 18, 5.6 => 5.146 V 7.5, 2.4 => 5.037 V 5.1, 1.6 => 5.113 V
1A max
Main 24V in filter
