NTURacingTeam/nturt_kicad/EP6/Electrical_Group/RPI_diyhat1/RPI_diyhat1.kicad_pcb

## KiCad design EP6/Electrical_Group/RPI_diyhat1/RPI_diyhat1.kicad_pcb (continued)

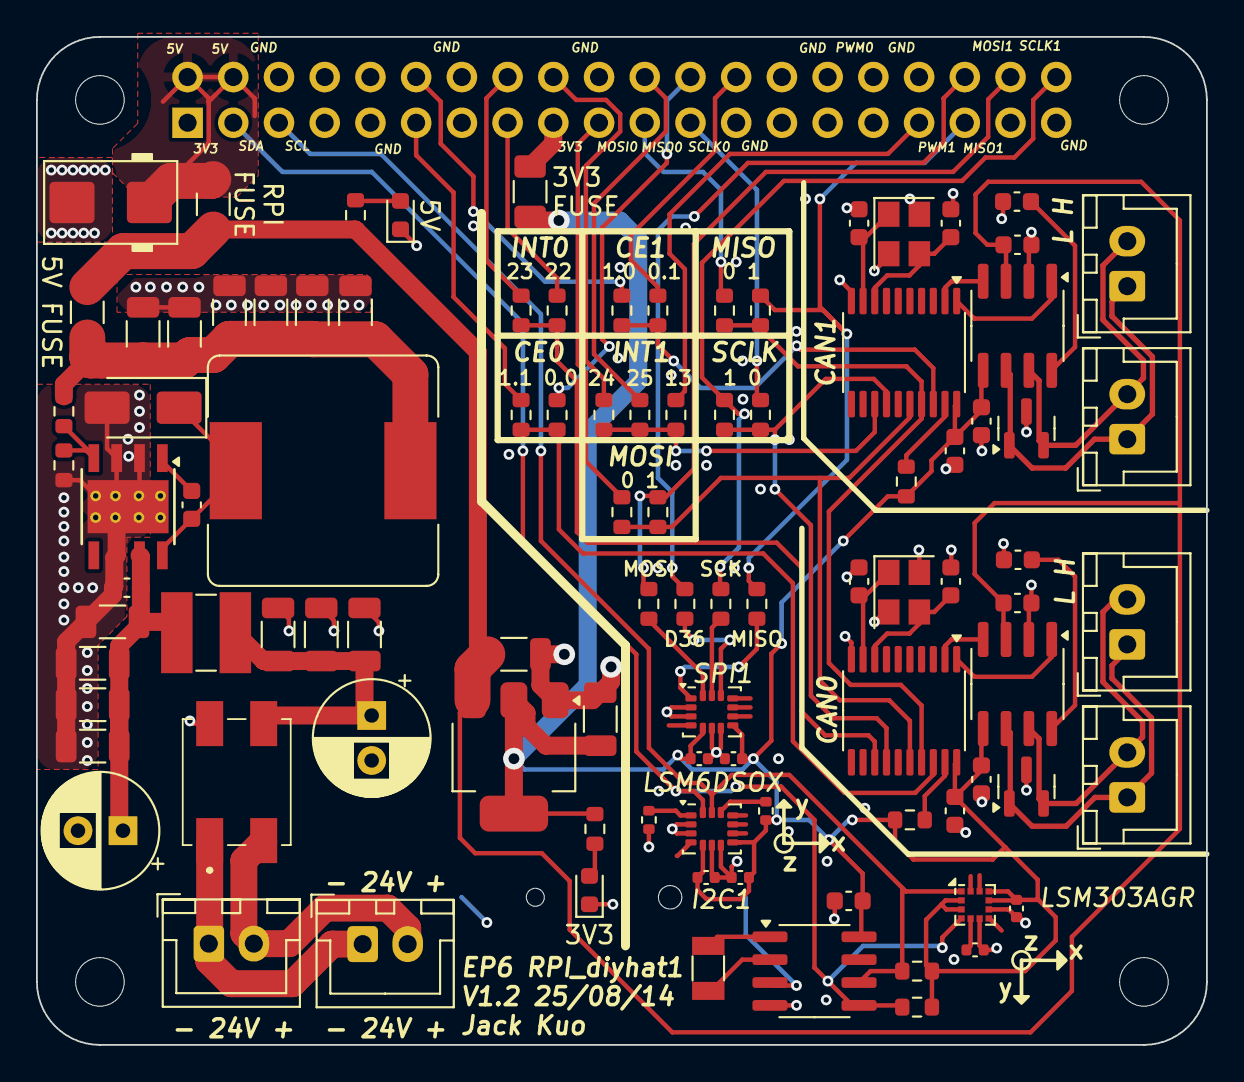
[picture p25: board RPI_diyhat1.kicad_pcb from above]

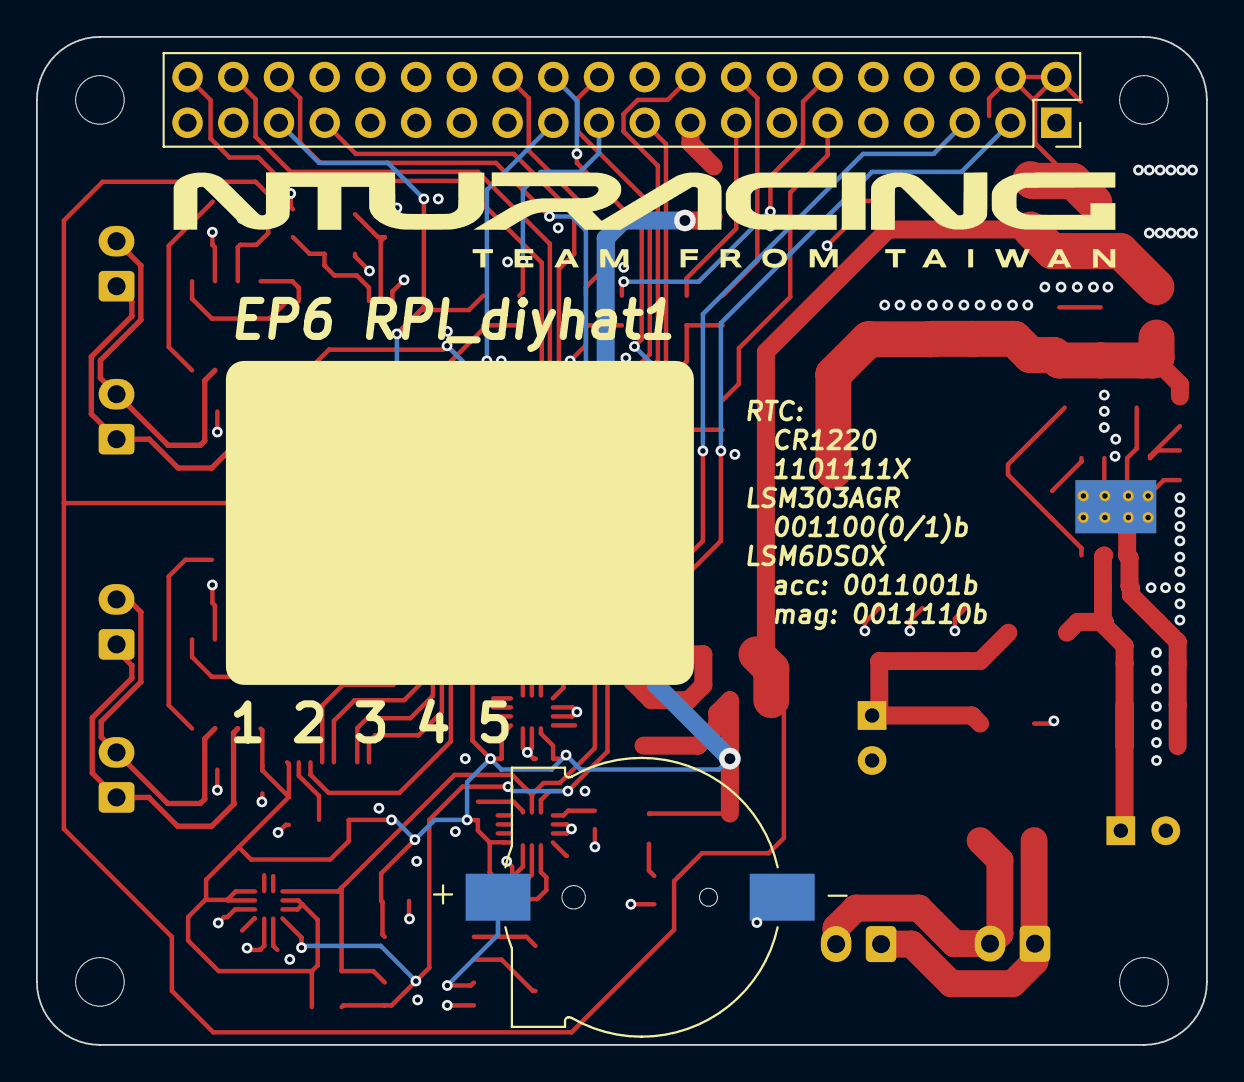
[picture p26: board RPI_diyhat1.kicad_pcb from below]

Board: 4 copper layers, 65.0 x 56.0 mm, 104 parts (2 on the bottom side), 66 nets.
