NTURacingTeam/nturt_kicad/EP6/Powertrain_Group/MOT_EncoderStator/MOT_EncoderStator.kicad_pcb

## KiCad design EP6/Powertrain_Group/MOT_EncoderStator/MOT_EncoderStator.kicad_pcb (2025-08-01)

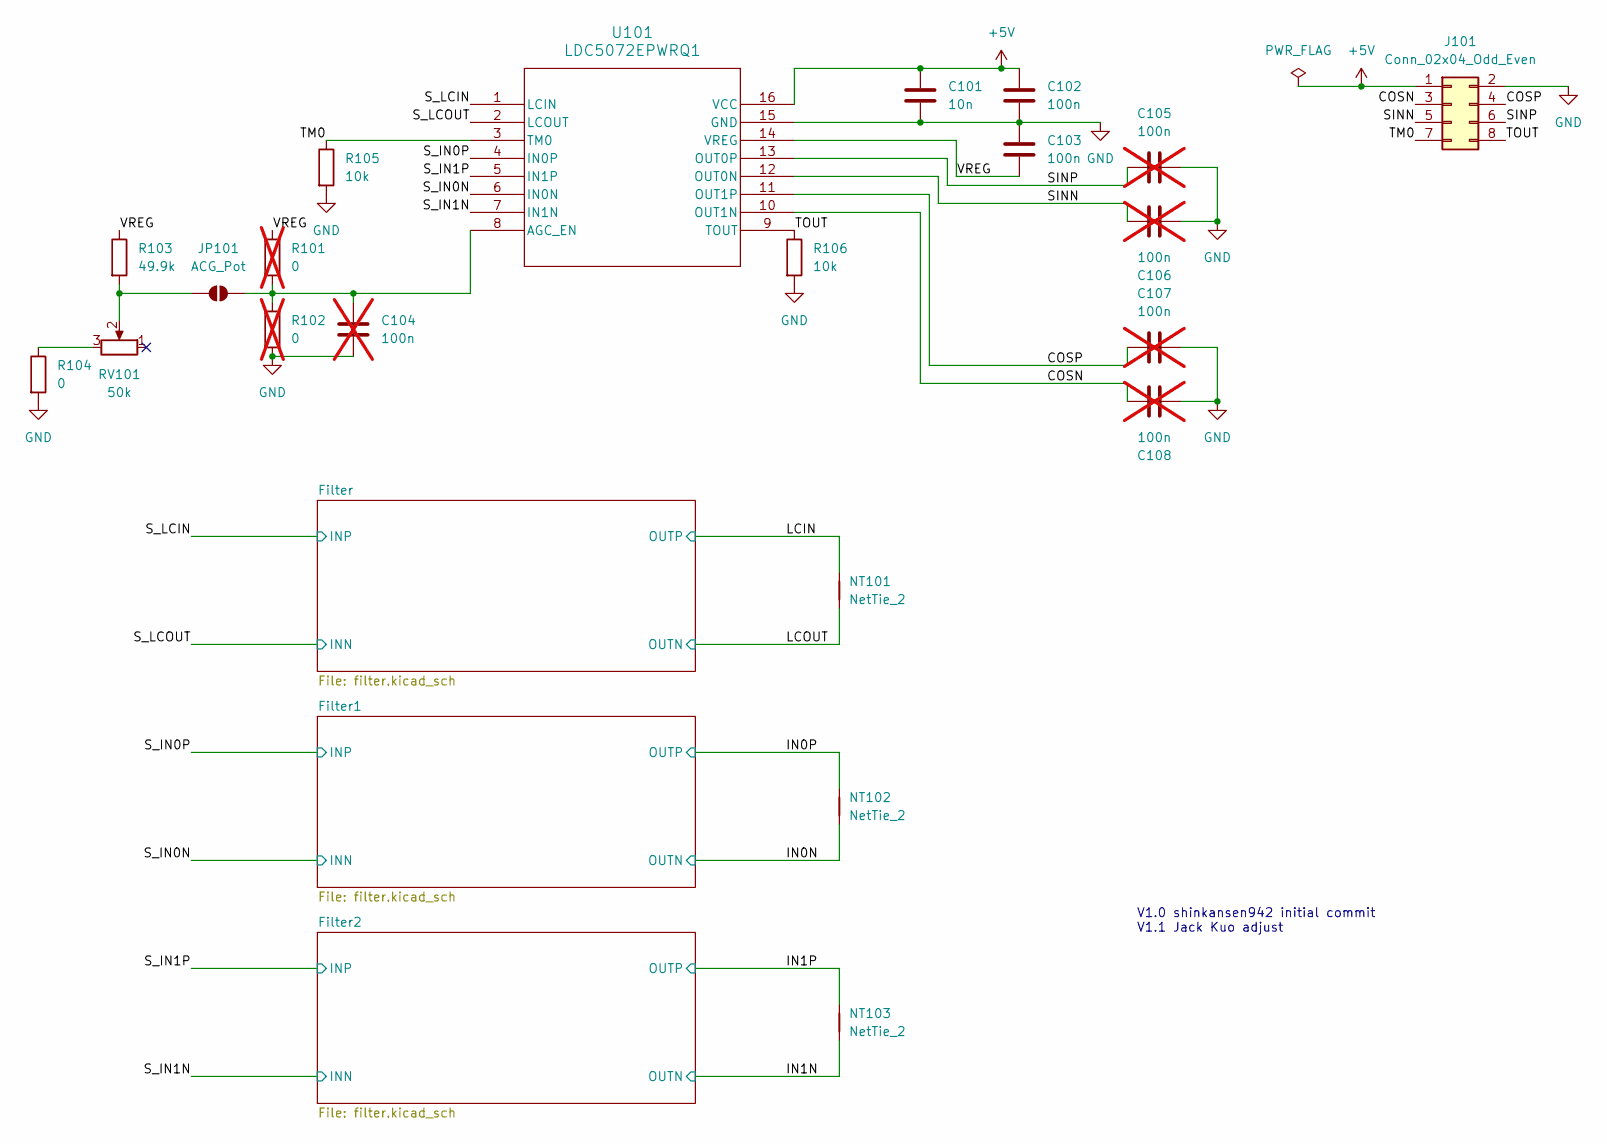
[picture p27: schematic MOT_EncoderStator.kicad_sch]

Parts:
C101: 10n; C_0402_1005Metric
C102, C103: 100n; C_0402_1005Metric
C104, C105, C106, C107, C108: 100n; C_0402_1005Metric; not fitted
J101: Conn_02x04_Odd_Even; PinHeader_2x04_P2.54mm_Vertical_SMD
JP101: ACG_Pot; SolderJumper-2_P1.3mm_Open_RoundedPad1.0x1.5mm
NT101, NT102, NT103: NetTie_2; NetTie-2_SMD_Pad0.5mm
R101, R102: 0; R_0603_1608Metric; not fitted
R103: 49.9k; R_0402_1005Metric
R104: 0; R_0402_1005Metric
R105, R106: 10k; R_0402_1005Metric
RV101: 50k; Potentiometer_Bourns_3224W_Vertical
U101: LDC5072EPWRQ1; TSSOP16-PW_TEX

Connections:
+5V: C101.1, C102.1, J101.1, U101.16 (VCC)
/COSN: C108.2, J101.3, U101.10 (OUT1N)
/COSP: C107.1, J101.4, U101.11 (OUT1P)
/IN0N: NT102.1; also elsewhere on the board
/IN0P: NT102.2; also elsewhere on the board
/IN1N: NT103.1; also elsewhere on the board
/IN1P: NT103.2; also elsewhere on the board
/LCIN: NT101.2; also elsewhere on the board
/LCOUT: NT101.1; also elsewhere on the board
/SINN: C106.2, J101.5, U101.12 (OUT0N)
/SINP: C105.1, J101.6, U101.13 (OUT0P)
/S_IN0N: U101.6 (IN0N); also elsewhere on the board
/S_IN0P: U101.4 (IN0P); also elsewhere on the board
/S_IN1N: U101.7 (IN1N); also elsewhere on the board
/S_IN1P: U101.5 (IN1P); also elsewhere on the board
/S_LCIN: U101.1 (LCIN); also elsewhere on the board
/S_LCOUT: U101.2 (LCOUT); also elsewhere on the board
/TM0: J101.7, R105.1, U101.3 (TM0)
/TOUT: J101.8, R106.1, U101.9 (TOUT)
/VREG: C103.2, R101.1, R103.1, U101.14 (VREG)
GND: C101.2, C102.2, C103.1, C104.2, C105.2, C106.1, C107.2, C108.1, J101.2, R102.2, R104.2, R105.2, R106.2, U101.15 (GND); also elsewhere on the board
unnamed: JP101.1 (A), R103.2, RV101.2
unnamed: C104.1, JP101.2 (B), R101.2, R102.1, U101.8 (AGC_EN)
unnamed: R104.1, RV101.3

Notes on the sheet:
V1.0 shinkansen942 initial commit V1.1 Jack Kuo adjust

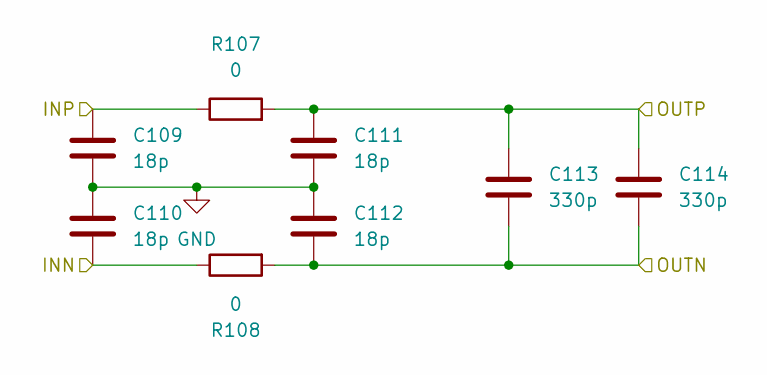
[picture p28: schematic filter.kicad_sch, MOT_EncoderStator]

Parts:
C109, C110, C111, C112: 18p; C_0402_1005Metric
C113, C114: 330p; C_0402_1005Metric
R107, R108: 0; R_0402_1005Metric

Connections:
/LCIN: C111.1, C113.1, C114.1, R107.2; also elsewhere on the board
/LCOUT: C112.2, C113.2, C114.2, R108.2; also elsewhere on the board
/S_LCIN: C109.1, R107.1; also elsewhere on the board
/S_LCOUT: C110.2, R108.1; also elsewhere on the board
GND: C109.2, C110.1, C111.2, C112.1; also elsewhere on the board

Parts of its further copies:
C115, C116, C117, C118, C121, C122, C123, C124: 18p; C_0402_1005Metric
C119, C120, C125, C126: 330p; C_0402_1005Metric
R109, R110, R111, R112: 0; R_0402_1005Metric

Connections of its further copies:
/IN0N: C118.2, C119.2, C120.2, R110.2; also elsewhere on the board
/IN0P: C117.1, C119.1, C120.1, R109.2; also elsewhere on the board
/IN1N: C124.2, C125.2, C126.2, R112.2; also elsewhere on the board
/IN1P: C123.1, C125.1, C126.1, R111.2; also elsewhere on the board
/S_IN0N: C116.2, R110.1; also elsewhere on the board
/S_IN0P: C115.1, R109.1; also elsewhere on the board
/S_IN1N: C122.2, R112.1; also elsewhere on the board
/S_IN1P: C121.1, R111.1; also elsewhere on the board
GND: C115.2, C116.1, C117.2, C118.1, C121.2, C122.1, C123.2, C124.1; also elsewhere on the board

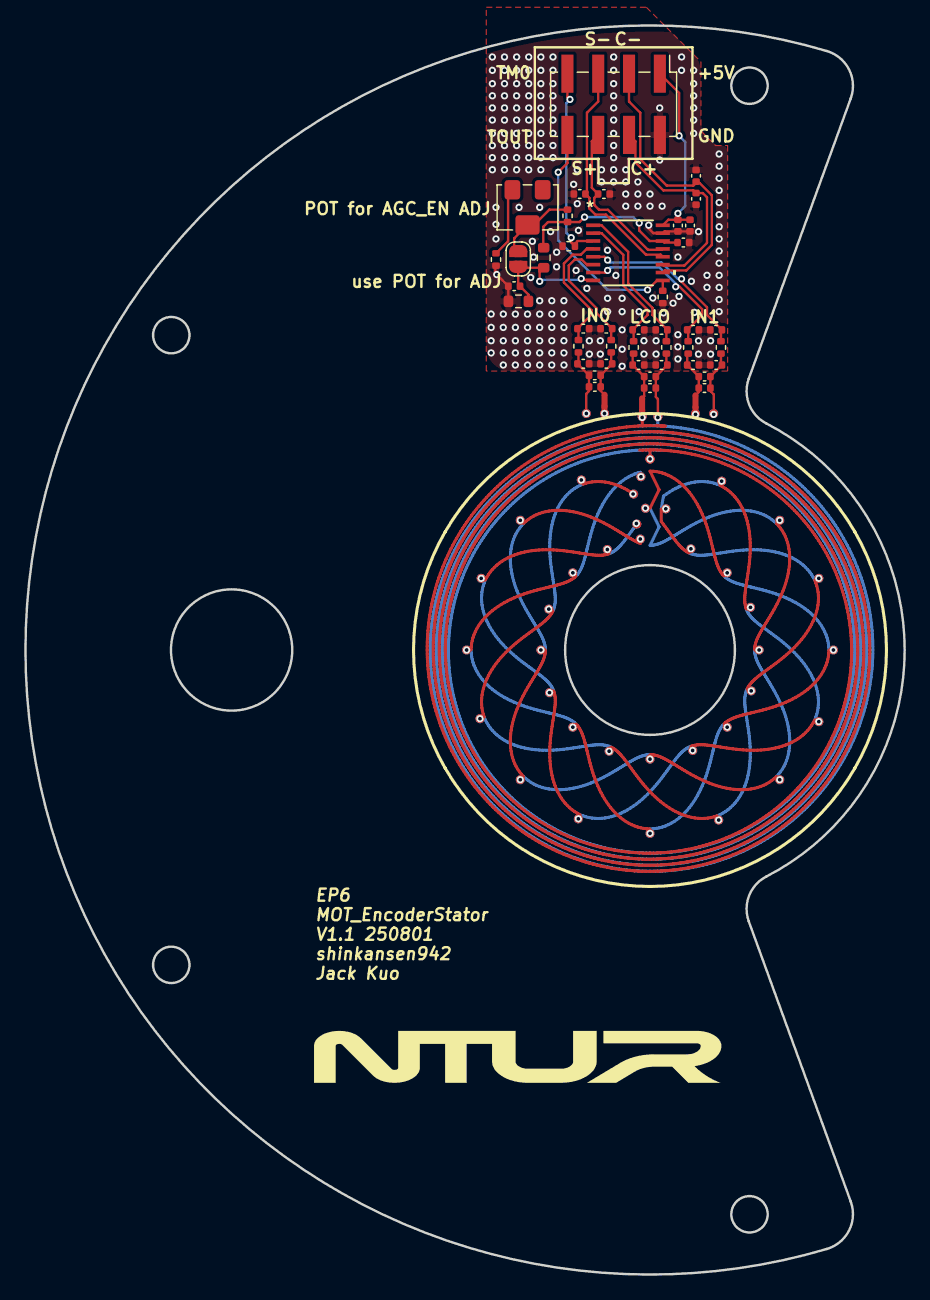
[picture p29: board MOT_EncoderStator.kicad_pcb from above]

Board: 4 copper layers, 72.5 x 103.0 mm, 45 parts (0 on the bottom side), 24 nets.
