NTURacingTeam/nturt_kicad/EP6/Powertrain_Group/INV_MainBoard_TI/INV_MainBoard_TI.kicad_pcb

## KiCad design EP6/Powertrain_Group/INV_MainBoard_TI/INV_MainBoard_TI.kicad_pcb (2025-07-10)

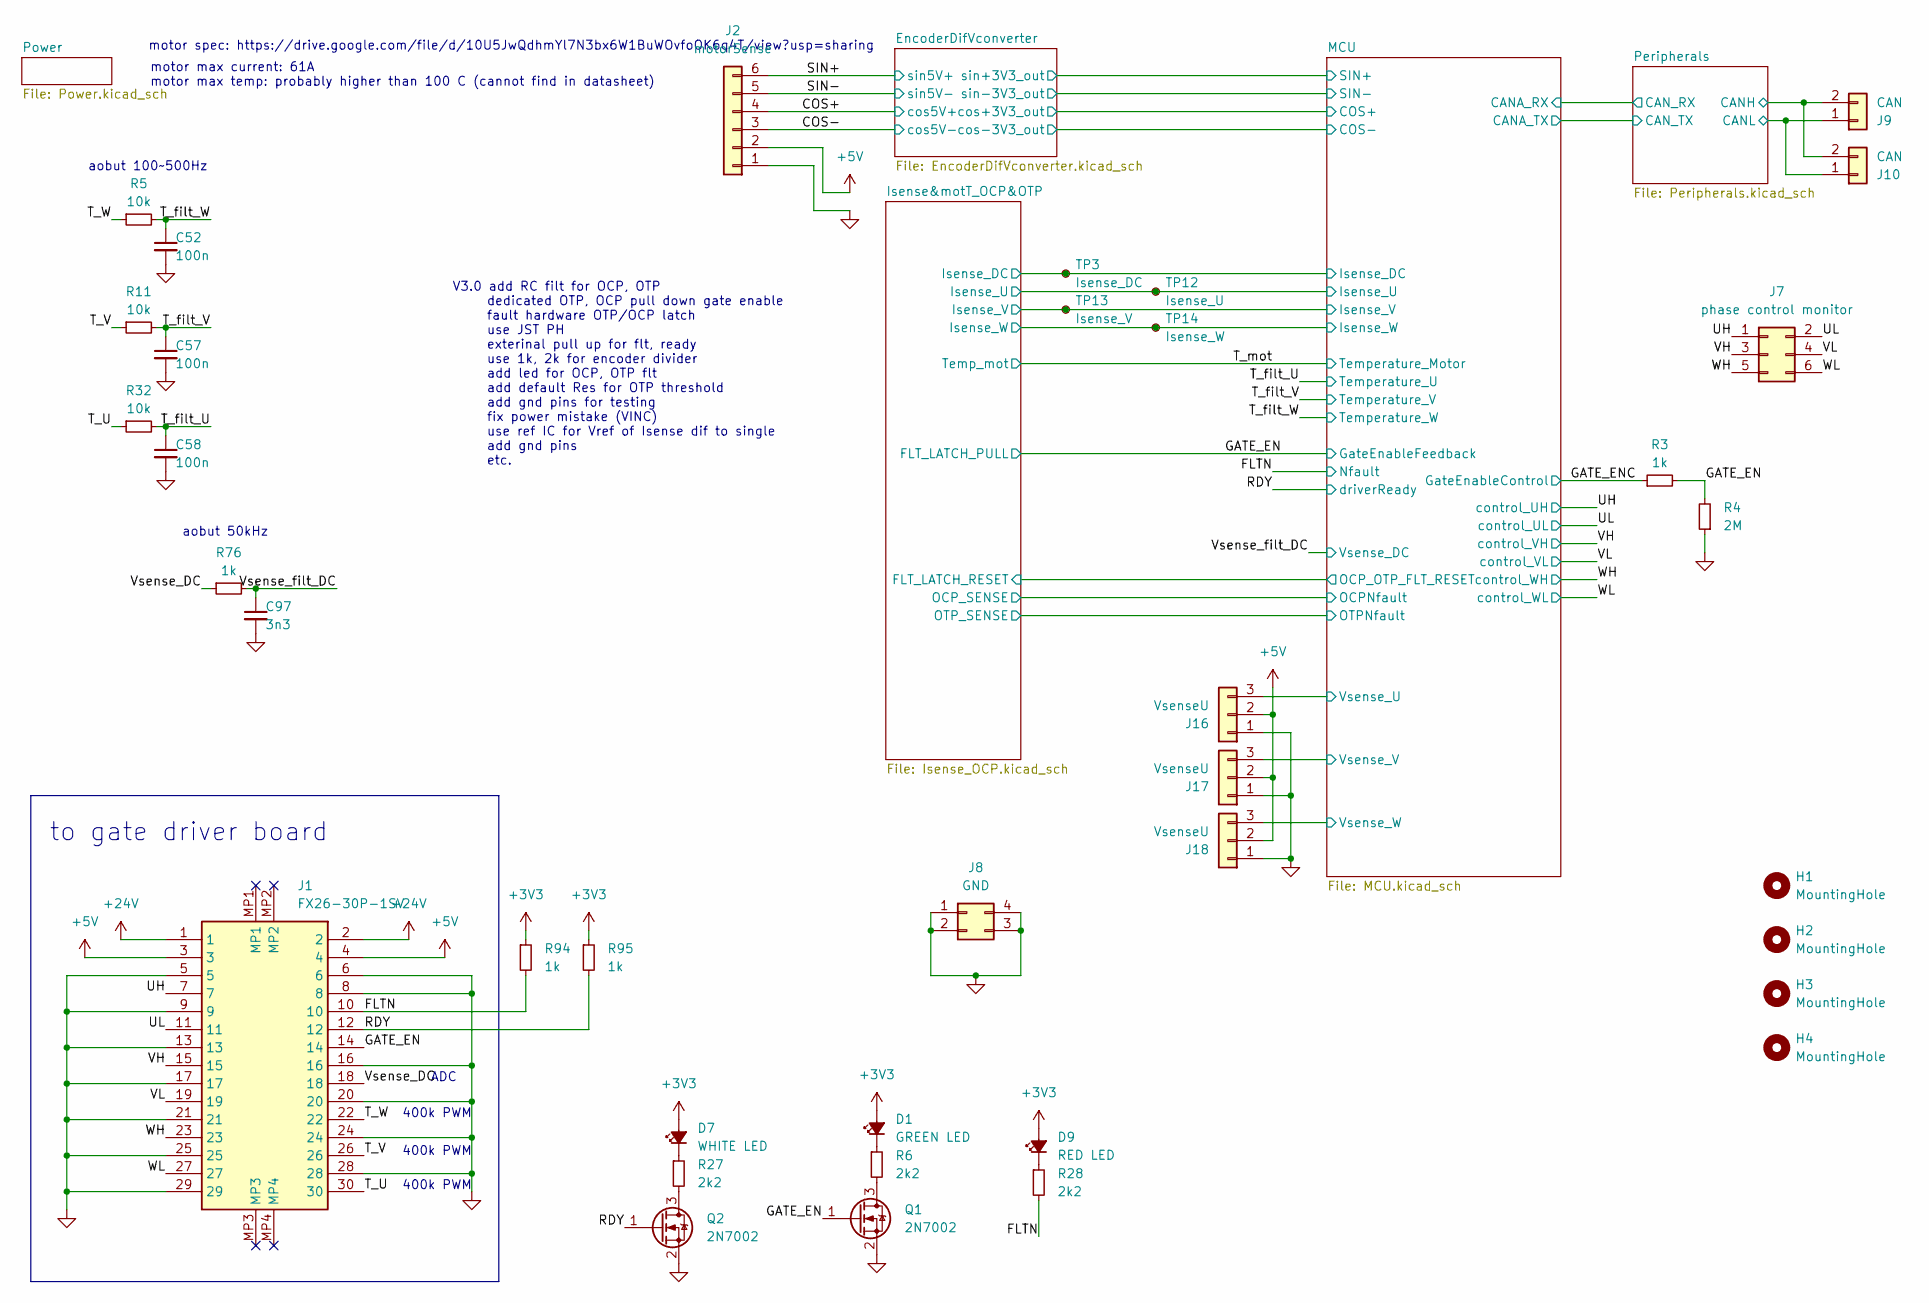
[picture p30: schematic INV_MainBoard_TI.kicad_sch]

Parts:
C52, C57, C58: 100n; C_0402_1005Metric
C97: 3n3; C_0402_1005Metric
D1: GREEN LED; LED_0805_2012Metric
D7: WHITE LED; LED_0805_2012Metric
D9: RED LED; LED_0805_2012Metric
H1, H2, H3, H4: MountingHole; MountingHole_3.2mm_M3
J1: FX26-30P-1SV; FX2630P1SV; Mouser Part Number 798-FX2630P1SV
J2: motorSense; JST_PH_B6B-PH-K_1x06_P2.00mm_Vertical
J7: phase control monitor; PinHeader_2x03_P2.54mm_Vertical
J8: GND; PinHeader_2x02_P2.54mm_Vertical
J9, J10: CAN; JST_XH_B2B-XH-A_1x02_P2.50mm_Vertical
J16, J17, J18: VsenseU; PinSocket_1x03_P2.00mm_Vertical; Part Number 1-0301FBV0T
Q1, Q2: 2N7002; SOT-23
R3, R76, R94, R95: 1k; R_0402_1005Metric
R4: 2M; R_0603_1608Metric
R5, R11, R32: 10k; R_0402_1005Metric
R6, R27, R28: 2k2; R_0402_1005Metric
TP3: Isense_DC; TestPoint_Pad_D1.0mm
TP12: Isense_U; TestPoint_Pad_D1.0mm
TP13: Isense_V; TestPoint_Pad_D1.0mm
TP14: Isense_W; TestPoint_Pad_D1.0mm

Connections:
+3V3: D1.2 (A), D7.2 (A), D9.2 (A), R94.1, R95.1; also elsewhere on the board
+5V: J1.3, J1.4, J2.2, J16.2, J17.2, J18.2; also elsewhere on the board
+24V: J1.1, J1.2; also elsewhere on the board
/COS+: J2.4; also elsewhere on the board
/COS-: J2.3; also elsewhere on the board
/FLTN: J1.10, R28.2, R94.2; also elsewhere on the board
/GATE_EN: J1.14, Q1.1 (G), R3.2, R4.2; also elsewhere on the board
/GATE_ENC: R3.1; also elsewhere on the board
/Isense&motT_OCP&OTP/Isense_DC: TP3.1; also elsewhere on the board
/Isense&motT_OCP&OTP/Isense_U: TP12.1; also elsewhere on the board
/Isense&motT_OCP&OTP/Isense_V: TP13.1; also elsewhere on the board
/Isense&motT_OCP&OTP/Isense_W: TP14.1; also elsewhere on the board
/MCU/Vsense_U: J16.3; also elsewhere on the board
/MCU/Vsense_V: J17.3; also elsewhere on the board
/MCU/Vsense_W: J18.3; also elsewhere on the board
/Peripherals/CANH: J9.2, J10.2; also elsewhere on the board
/Peripherals/CANL: J9.1, J10.1; also elsewhere on the board
/RDY: J1.12, Q2.1 (G), R95.2; also elsewhere on the board
/SIN+: J2.6; also elsewhere on the board
/SIN-: J2.5; also elsewhere on the board
/T_U: J1.30, R32.1
/T_V: J1.26, R11.1
/T_W: J1.22, R5.1
/T_filt_U: C58.1, R32.2; also elsewhere on the board
/T_filt_V: C57.1, R11.2; also elsewhere on the board
/T_filt_W: C52.1, R5.2; also elsewhere on the board
/UH: J1.7, J7.1; also elsewhere on the board
/UL: J1.11, J7.2; also elsewhere on the board
/VH: J1.15, J7.3; also elsewhere on the board
/VL: J1.19, J7.4; also elsewhere on the board
/Vsense_DC: J1.18, R76.1
/Vsense_filt_DC: C97.1, R76.2; also elsewhere on the board
/WH: J1.23, J7.5; also elsewhere on the board
/WL: J1.27, J7.6; also elsewhere on the board
GND: C52.2, C57.2, C58.2, C97.2, J1.5, J1.6, J1.8, J1.9, J1.13, J1.16, J1.17, J1.20, J1.21, J1.24, J1.25, J1.28, J1.29, J2.1, J8.1, J8.2, J8.3, J8.4, J16.1, J17.1, J18.1, Q1.2 (S), Q2.2 (S), R4.1; also elsewhere on the board
unnamed: D1.1 (K), R6.1
unnamed: D7.1 (K), R27.1
unnamed: D9.1 (K), R28.1
unnamed: Q1.3 (D), R6.2
unnamed: Q2.3 (D), R27.2

Notes on the sheet:
motor spec: https://drive.google.com/file/d/10U5JwQdhmYl7N3bx6W1BuWOvfoOK6q4T/view?usp=sharing
400k PWM
to gate driver board
motor max current: 61A motor max temp: probably higher than 100 C (cannot find in datasheet)
aobut 50kHz
aobut 100~500Hz
V3.0 add RC filt for OCP, OTP dedicated OTP, OCP pull down gate enable fault hardware OTP/OCP latch use JST PH exterinal pull up for flt, ready use 1k, 2k for encoder divider add led for OCP, OTP flt add default Res for OTP threshold add gnd pins for testing fix power mistake (VINC) use ref IC for 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
ADC

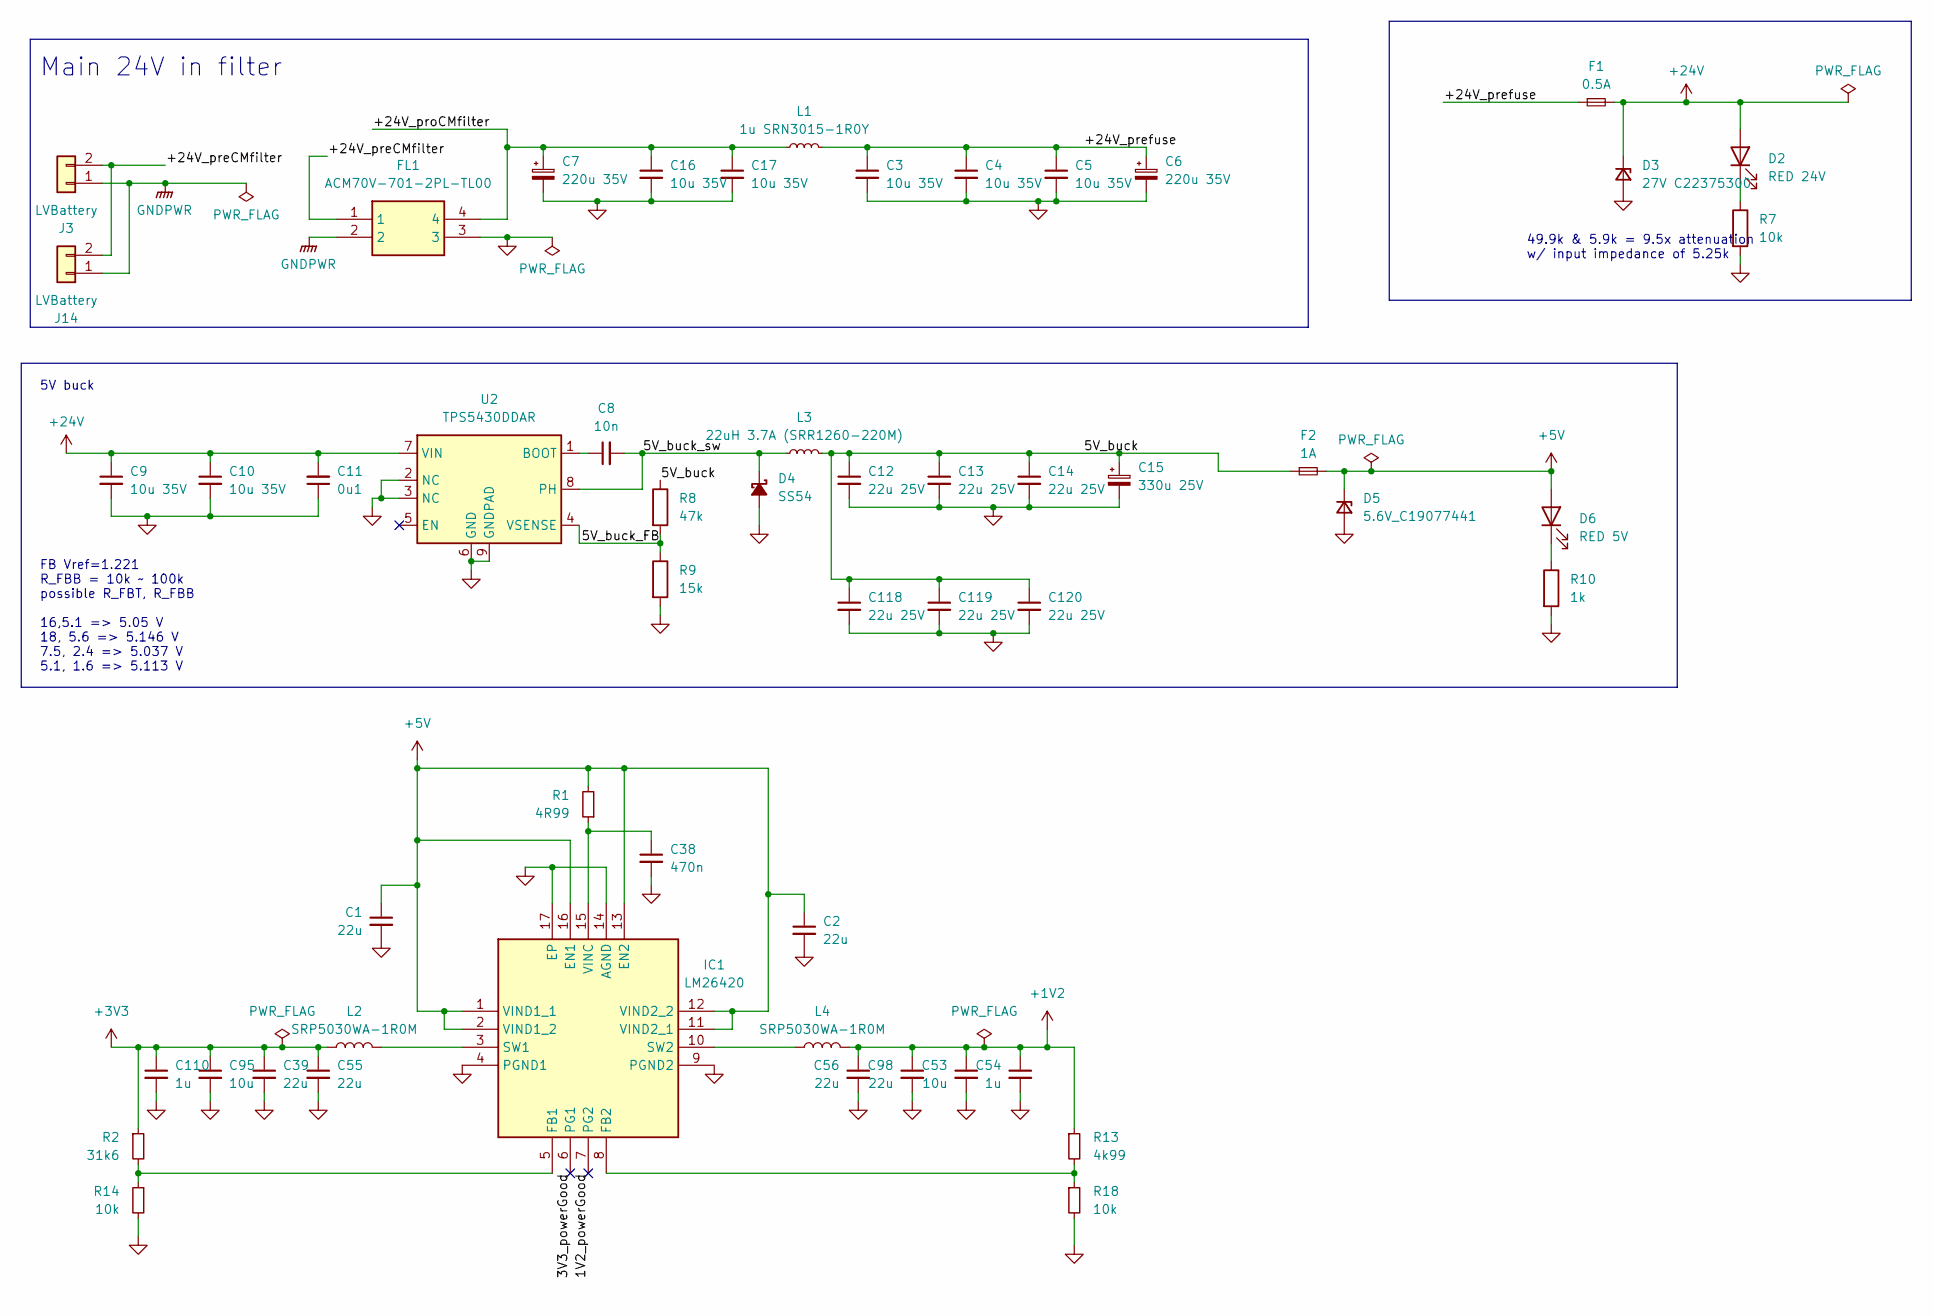
[picture p31: schematic Power.kicad_sch, INV_MainBoard_TI]

Parts:
C1, C2, C39, C55, C56, C98: 22u; C_1206_3216Metric
C3, C4, C5, C9, C10, C16, C17: 10u 35V; C_1206_3216Metric
C6, C7: 220u 35V; CP_Radial_D8.0mm_P3.80mm
C8: 10n; C_0603_1608Metric
C11: 0u1; C_0603_1608Metric
C12, C13, C14, C118, C119, C120: 22u 25V; C_1206_3216Metric
C15: 330u 25V; CP_Radial_D8.0mm_P3.80mm
C38: 470n; C_0603_1608Metric
C53, C95: 10u; C_1206_3216Metric
C54, C110: 1u; C_0805_2012Metric
D2: RED 24V; LED_0603_1608Metric
D3: 27V C22375300; D_SOD-323
D4: SS54; D_SMA
D5: 5.6V_C19077441; D_SOD-323
D6: RED 5V; LED_0603_1608Metric
F1: 0.5A; Fuse_1206_3216Metric
F2: 1A; Fuse_1206_3216Metric
FL1: ACM70V-701-2PL-TL00; ACM70V7012PLTL00; Mouser Part Number 810-ACM70V7012PLTL00
IC1: LM26420; QFN65P400X400X80-17N; Mouser Part Number 595-LM26420Q1XSQXNPB
J3, J14: LVBattery; JST_VH_B2P-VH_1x02_P3.96mm_Vertical
L1: 1u SRN3015-1R0Y; L_Wuerth_MAPI-3015
L2, L4: SRP5030WA-1R0M; L_Bourns_SRP5030T
L3: 22uH 3.7A (SRR1260-220M); SRR1260A220M
R1: 4R99; R_0603_1608Metric
R2: 31k6; R_0603_1608Metric
R7: 10k; R_0402_1005Metric
R8: 47k; R_0603_1608Metric
R9: 15k; R_0603_1608Metric
R10: 1k; R_0402_1005Metric
R13: 4k99; R_0603_1608Metric
R14, R18: 10k; R_0603_1608Metric
U2: TPS5430DDAR; TI_SO-PowerPAD-8_ThermalVias

Connections:
+1V2: C53.1, C54.1, C56.1, C98.1, L4.2, R13.1; also elsewhere on the board
+3V3: C39.1, C55.1, C95.1, C110.1, L2.2, R2.1; also elsewhere on the board
+5V: C1.1, C2.1, D5.1 (K), D6.2 (A), F2.2, IC1.1 (VIND1_1), IC1.2 (VIND1_2), IC1.11 (VIND2_1), IC1.12 (VIND2_2), IC1.13 (EN2), IC1.16 (EN1), R1.2; also elsewhere on the board
+24V: C9.1, C10.1, C11.2, D2.2 (A), D3.1 (K), F1.2, U2.7 (VIN); also elsewhere on the board
/Power/1V2_powerGood: IC1.7 (PG2)
/Power/3V3_powerGood: IC1.6 (PG1)
/Power/5V_buck: C12.1, C13.1, C14.1, C15.1, C118.1, C119.1, C120.1, F2.1, L3.2, R8.1
/Power/5V_buck_FB: R8.2, R9.1, U2.4 (VSENSE)
/Power/5V_buck_sw: C8.2, D4.1 (K), L3.1, U2.8 (PH)
/Power/+24V_preCMfilter: FL1.1, J3.2, J14.2
/Power/+24V_prefuse: C3.1, C4.1, C5.1, C6.1, F1.1, L1.2
/Power/+24V_proCMfilter: C7.1, C16.1, C17.1, FL1.4, L1.1
GND: C1.2, C2.2, C3.2, C4.2, C5.2, C6.2, C7.2, C9.2, C10.2, C11.1, C12.2, C13.2, C14.2, C15.2, C16.2, C17.2, C38.2, C39.2, C53.2, C54.2, C55.2, C56.2, C95.2, C98.2, C110.2, C118.2, C119.2, C120.2, D3.2 (A), D4.2 (A), D5.2 (A), FL1.3, IC1.4 (PGND1), IC1.9 (PGND2), IC1.14 (AGND), IC1.17 (EP), R7.2, R9.2, R10.2, R14.2, R18.2, U2.2 (NC), U2.3 (NC), U2.6 (GND), U2.9 (GNDPAD); also elsewhere on the board
GNDPWR: FL1.2, J3.1, J14.1
unnamed: D2.1 (K), R7.1
unnamed: D6.1 (K), R10.1
unnamed: IC1.5 (FB1), R2.2, R14.1
unnamed: IC1.8 (FB2), R13.2, R18.1
unnamed: IC1.3 (SW1), L2.1
unnamed: IC1.10 (SW2), L4.1
unnamed: C38.1, IC1.15 (VINC), R1.1
unnamed: C8.1, U2.1 (BOOT)

Notes on the sheet:
5V buck
49.9k & 5.9k = 9.5x attenuation w/ input impedance of 5.25k
FB Vref=1.221 R_FBB = 10k ~ 100k possible R_FBT, R_FBB 16,5.1 => 5.05 V 18, 5.6 => 5.146 V 7.5, 2.4 => 5.037 V 5.1, 1.6 => 5.113 V
Main 24V in filter

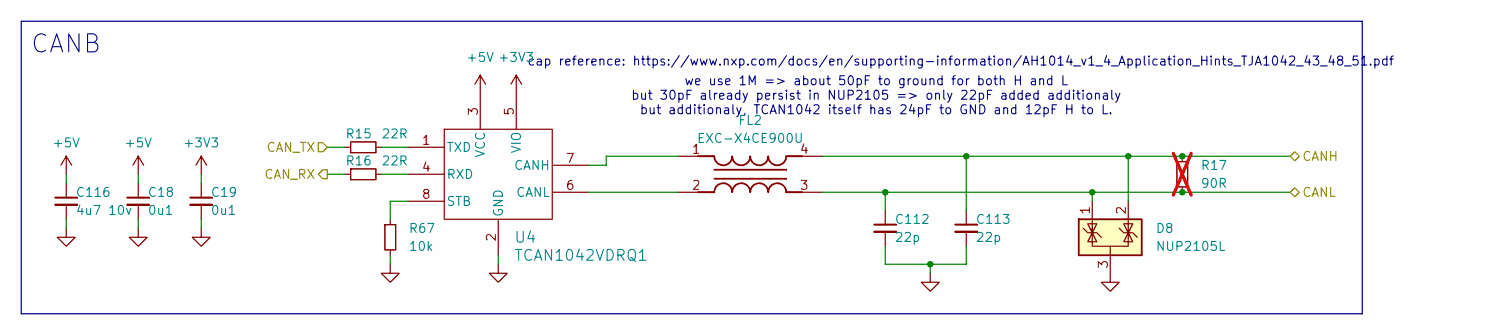
[picture p32: schematic Peripherals.kicad_sch, INV_MainBoard_TI]

Parts:
C18, C19: 0u1; C_0402_1005Metric
C112, C113: 22p; C_0402_1005Metric
C116: 4u7 10v; C_0402_1005Metric
D8: NUP2105L; SOT-23
FL2: EXC-X4CE900U; EXCX4CE900U; Mouser Part Number 667-EXC-X4CE900U
R15, R16: 22R; R_0402_1005Metric
R17: 90R; R_0402_1005Metric; not fitted
R67: 10k; R_0402_1005Metric
U4: TCAN1042VDRQ1; SOIC-8_3.9x4.9mm_P1.27mm

Connections:
+3V3: C19.1, U4.5 (VIO); also elsewhere on the board
+5V: C18.1, C116.1, U4.3 (VCC); also elsewhere on the board
/MCU/CANA_RX: R16.1; also elsewhere on the board
/MCU/CANA_TX: R15.1; also elsewhere on the board
/Peripherals/CANH: C113.1, D8.2 (K), FL2.4, R17.1; also elsewhere on the board
/Peripherals/CANL: C112.1, D8.1 (K), FL2.3, R17.2; also elsewhere on the board
GND: C18.2, C19.2, C112.2, C113.2, C116.2, D8.3 (A), R67.2, U4.2 (GND); also elsewhere on the board
unnamed: FL2.1, U4.7 (CANH)
unnamed: FL2.2, U4.6 (CANL)
unnamed: R16.2, U4.4 (RXD)
unnamed: R67.1, U4.8 (STB)
unnamed: R15.2, U4.1 (TXD)

Notes on the sheet:
CANB
cap reference: https://www.nxp.com/docs/en/supporting-information/AH1014_v1_4_Application_Hints_TJA1042_43_48_51.pdf
we use 1M => about 50pF to ground for both H and L but 30pF already persist in NUP2105 => only 22pF added additionaly but additionaly, TCAN1042 itself has 24pF to GND and 12pF H to L.

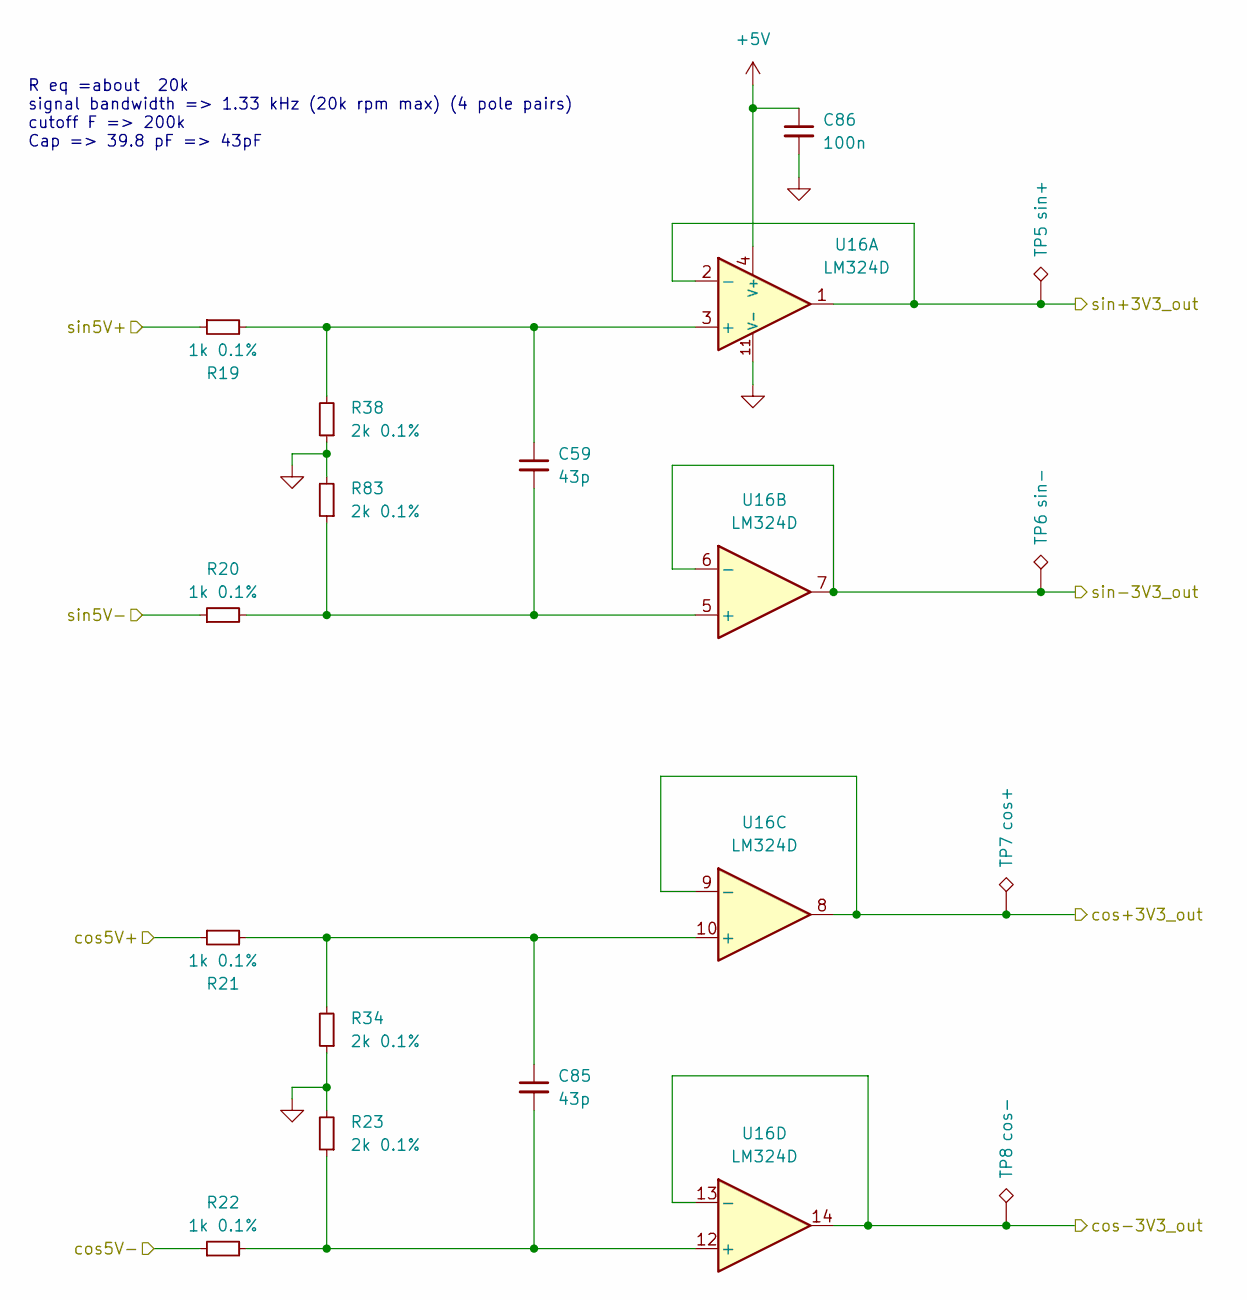
[picture p33: schematic EncoderDifVconverter.kicad_sch, INV_MainBoard_TI]

Parts:
C59, C85: 43p; C_0402_1005Metric
C86: 100n; C_0402_1005Metric
R19, R20, R21, R22: 1k 0.1%; R_0402_1005Metric
R23, R34, R38, R83: 2k 0.1%; R_0402_1005Metric
TP5: sin+; TestPoint_Pad_D1.0mm
TP6: sin-; TestPoint_Pad_D1.0mm
TP7: cos+; TestPoint_Pad_D1.0mm
TP8: cos-; TestPoint_Pad_D1.0mm
U16: LM324D; SOIC-14_3.9x8.7mm_P1.27mm

Connections:
+5V: C86.1, U16.4 (V+); also elsewhere on the board
/COS+: R21.1; also elsewhere on the board
/COS-: R22.1; also elsewhere on the board
/EncoderDifVconverter/cos+3V3_out: TP7.1, U16.8, U16.9 (-); also elsewhere on the board
/EncoderDifVconverter/cos-3V3_out: TP8.1, U16.13 (-), U16.14; also elsewhere on the board
/EncoderDifVconverter/sin+3V3_out: TP5.1, U16.1, U16.2 (-); also elsewhere on the board
/EncoderDifVconverter/sin-3V3_out: TP6.1, U16.6 (-), U16.7; also elsewhere on the board
/SIN+: R19.1; also elsewhere on the board
/SIN-: R20.1; also elsewhere on the board
GND: C86.2, R23.2, R34.1, R38.1, R83.2, U16.11 (V-); also elsewhere on the board
unnamed: C59.1, R19.2, R38.2, U16.3 (+)
unnamed: C59.2, R20.2, R83.1, U16.5 (+)
unnamed: C85.1, R21.2, R34.2, U16.10 (+)
unnamed: C85.2, R22.2, R23.1, U16.12 (+)

Notes on the sheet:
R eq =about 20k signal bandwidth => 1.33 kHz (20k rpm max) (4 pole pairs) cutoff F => 200k Cap => 39.8 pF => 43pF
