NTURacingTeam/nturt_kicad/EP6/Powertrain_Group/INV_MainBoard_TI/INV_MainBoard_TI.kicad_pcb

## KiCad design EP6/Powertrain_Group/INV_MainBoard_TI/INV_MainBoard_TI.kicad_pcb (continued)

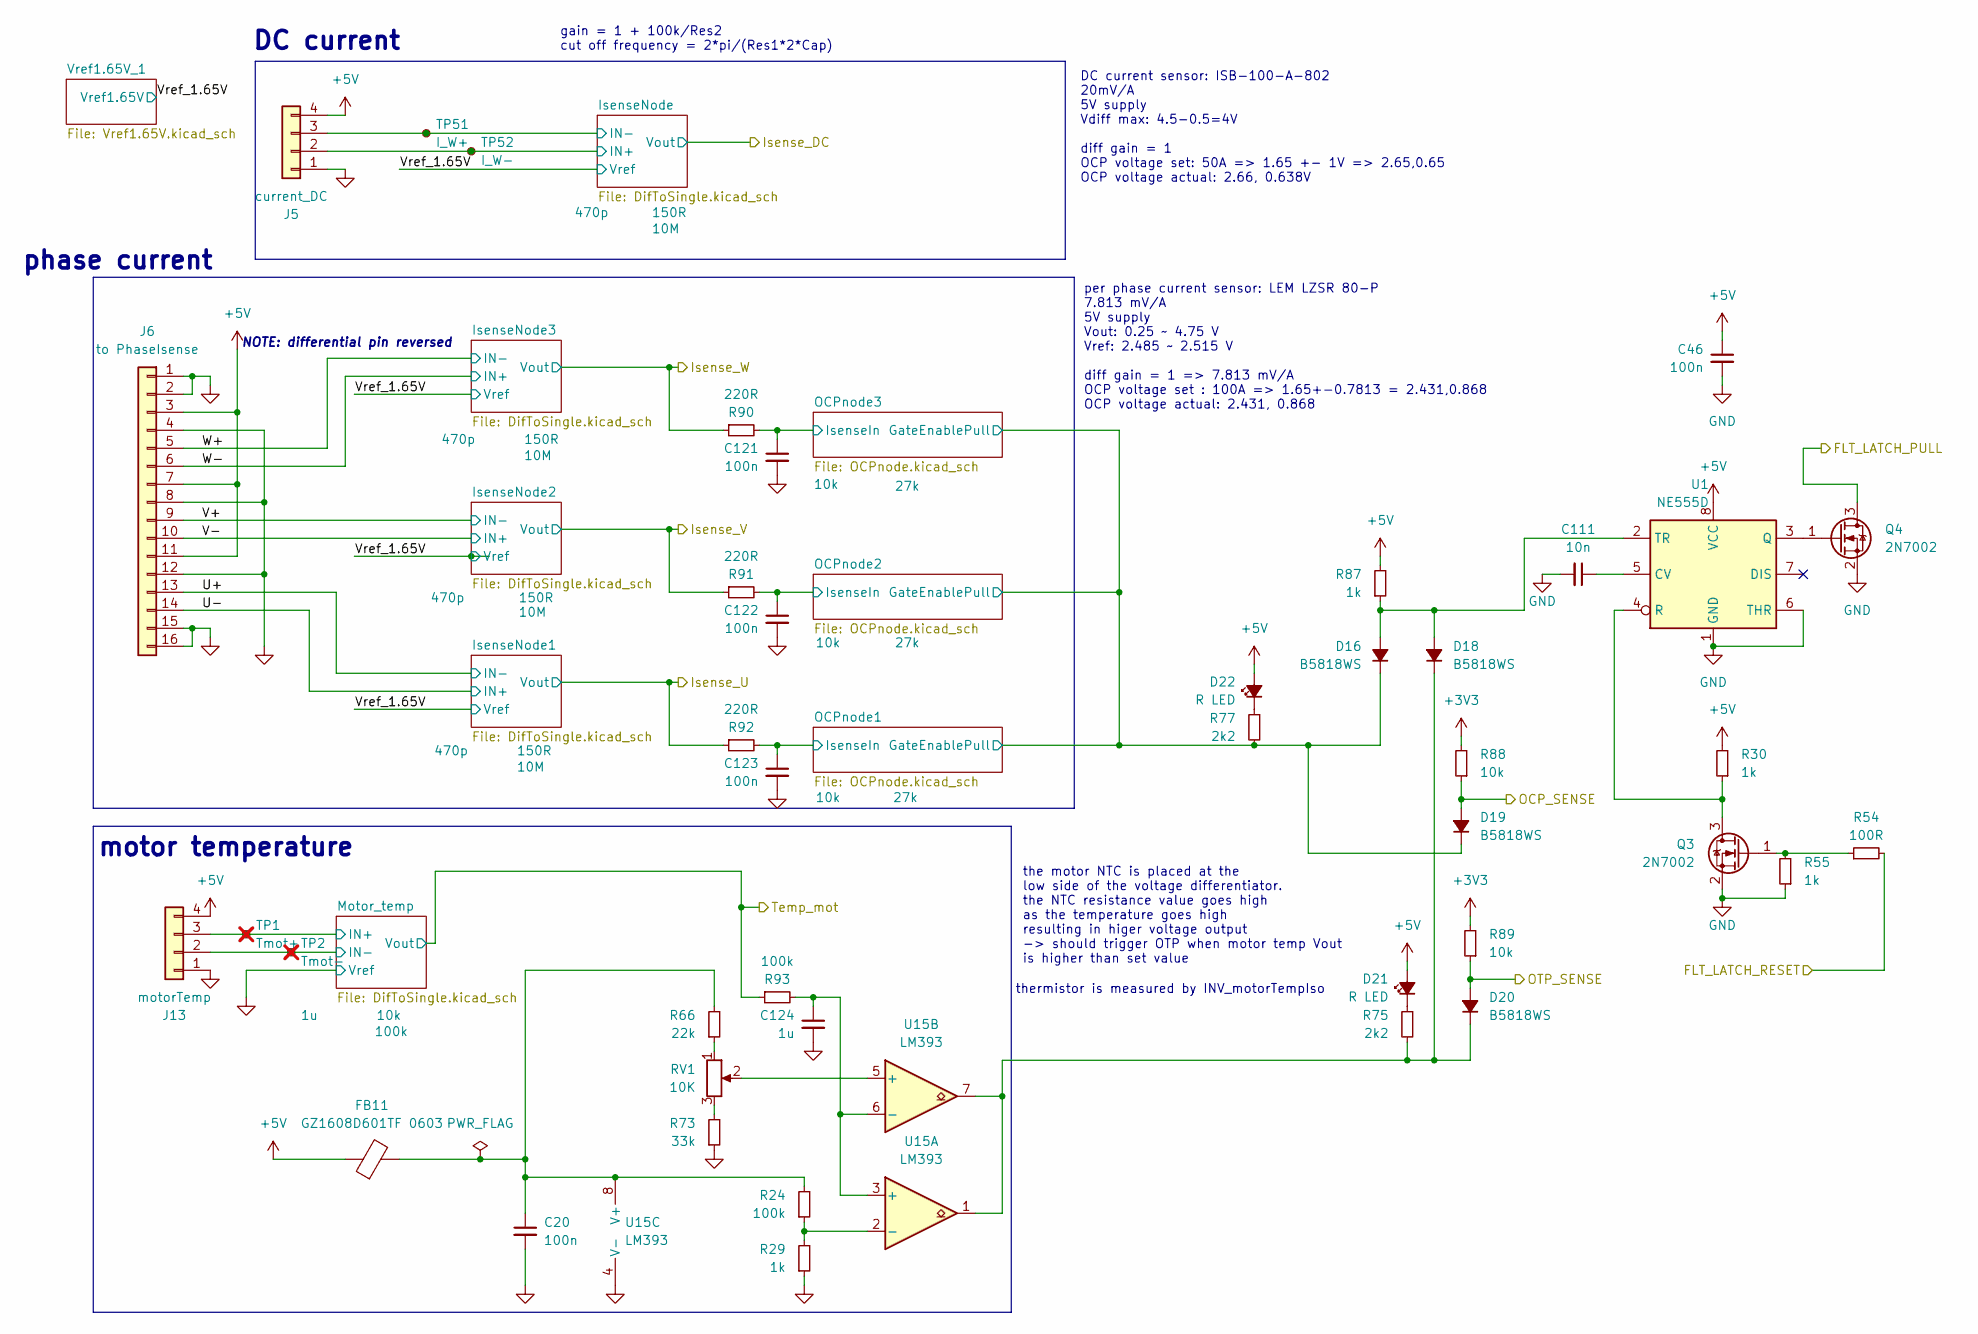
[picture p34: schematic Isense_OCP.kicad_sch, INV_MainBoard_TI]

Parts:
C20, C46, C121, C122, C123: 100n; C_0402_1005Metric
C111: 10n; C_0402_1005Metric
C124: 1u; C_0402_1005Metric
D16, D18, D19, D20: B5818WS; D_SOD-323
D21, D22: R LED; LED_0603_1608Metric
FB11: GZ1608D601TF 0603; C_0603_1608Metric
J5: current_DC; JST_PH_B4B-PH-K_1x04_P2.00mm_Vertical; Part Number 1-0401FBV0T
J6: to PhaseIsense; PinHeader_1x16_P2.54mm_Horizontal
J13: motorTemp; JST_PH_B4B-PH-K_1x04_P2.00mm_Vertical
Q3, Q4: 2N7002; SOT-23
R24, R93: 100k; R_0402_1005Metric
R29, R30, R55, R87: 1k; R_0402_1005Metric
R54: 100R; R_0402_1005Metric
R66: 22k; R_0402_1005Metric
R73: 33k; R_0402_1005Metric
R75, R77: 2k2; R_0402_1005Metric
R88, R89: 10k; R_0402_1005Metric
R90, R91, R92: 220R; R_0402_1005Metric
RV1: 10K; Throughhole Potentiometer 3296W
TP1: Tmot+; TestPoint_Pad_D1.0mm; not fitted
TP2: Tmot-; TestPoint_Pad_D1.0mm; not fitted
TP51: I_W+; TestPoint_Pad_D1.0mm
TP52: I_W-; TestPoint_Pad_D1.0mm
U1: NE555D; SOIC-8_3.9x4.9mm_P1.27mm
U15: LM393; SOIC-8_3.9x4.9mm_P1.27mm

Connections:
+3V3: R88.2, R89.2; also elsewhere on the board
+5V: C46.1, D21.2 (A), D22.2 (A), FB11.1, J5.4, J6.3, J6.7, J6.11, J13.4, R30.2, R87.2, U1.8 (VCC); also elsewhere on the board
/GATE_EN: Q4.3 (D); also elsewhere on the board
/Isense&motT_OCP&OTP/FLT_LATCH_RESET: R54.2; also elsewhere on the board
/Isense&motT_OCP&OTP/IsenseNode/IN+: J5.2, TP52.1; also elsewhere on the board
/Isense&motT_OCP&OTP/IsenseNode/IN-: J5.3, TP51.1; also elsewhere on the board
/Isense&motT_OCP&OTP/Isense_U: R92.1; also elsewhere on the board
/Isense&motT_OCP&OTP/Isense_V: R91.1; also elsewhere on the board
/Isense&motT_OCP&OTP/Isense_W: R90.1; also elsewhere on the board
/Isense&motT_OCP&OTP/Motor_temp/IN+: J13.3, TP1.1; also elsewhere on the board
/Isense&motT_OCP&OTP/Motor_temp/IN-: J13.2, TP2.1; also elsewhere on the board
/Isense&motT_OCP&OTP/OCP_SENSE: D19.2 (A), R88.1; also elsewhere on the board
/Isense&motT_OCP&OTP/OCPnode1/GateEnablePull: D16.1 (K), D19.1 (K), R77.2; also elsewhere on the board
/Isense&motT_OCP&OTP/OCPnode1/IsenseIn: C123.1, R92.2; also elsewhere on the board
/Isense&motT_OCP&OTP/OCPnode2/IsenseIn: C122.1, R91.2; also elsewhere on the board
/Isense&motT_OCP&OTP/OCPnode3/IsenseIn: C121.1, R90.2; also elsewhere on the board
/Isense&motT_OCP&OTP/OTP_SENSE: D20.2 (A), R89.1; also elsewhere on the board
/Isense&motT_OCP&OTP/U+: J6.13; also elsewhere on the board
/Isense&motT_OCP&OTP/U-: J6.14; also elsewhere on the board
/Isense&motT_OCP&OTP/V+: J6.9; also elsewhere on the board
/Isense&motT_OCP&OTP/V-: J6.10; also elsewhere on the board
/Isense&motT_OCP&OTP/W+: J6.5; also elsewhere on the board
/Isense&motT_OCP&OTP/W-: J6.6; also elsewhere on the board
/T_mot: R93.1; also elsewhere on the board
GND: C20.2, C46.2, C111.2, C121.2, C122.2, C123.2, C124.2, J5.1, J6.1, J6.2, J6.4, J6.8, J6.12, J6.15, J6.16, J13.1, Q3.2 (S), Q4.2 (S), R29.1, R55.1, R73.1, U1.1 (GND), U1.6 (THR), U15.4 (V-); also elsewhere on the board
unnamed: D16.2 (A), D18.2 (A), R87.1, U1.2 (TR)
unnamed: D18.1 (K), D20.1 (K), R75.2, U15.1, U15.7
unnamed: D21.1 (K), R75.1
unnamed: D22.1 (K), R77.1
unnamed: Q3.3 (D), R30.1, U1.4 (R)
unnamed: Q3.1 (G), R54.1, R55.2
unnamed: Q4.1 (G), U1.3 (Q)
unnamed: R66.1, RV1.1
unnamed: R73.2, RV1.3
unnamed: C111.1, U1.5 (CV)
unnamed: C124.1, R93.2, U15.3 (+), U15.6 (-)
unnamed: R24.1, R29.2, U15.2 (-)
unnamed: RV1.2, U15.5 (+)
unnamed: C20.1, FB11.2, R24.2, R66.2, U15.8 (V+)

Notes on the sheet:
DC current sensor: ISB-100-A-802 20mV/A 5V supply Vdiff max: 4.5-0.5=4V diff gain = 1 OCP voltage set: 50A => 1.65 +- 1V => 2.65,0.65 OCP voltage actual: 2.66, 0.638V
per phase current sensor: LEM LZSR 80-P 7.813 mV/A 5V supply Vout: 0.25 ~ 4.75 V Vref: 2.485 ~ 2.515 V diff gain = 1 => 7.813 mV/A OCP voltage set : 100A => 1.65+-0.7813 = 2.431,0.868 OCP voltage actual: 2.431, 0.868
phase current
NOTE: differential pin reversed
gain = 1 + 100k/Res2 cut off frequency = 2*pi/(Res1*2*Cap)
motor temperature
the motor NTC is placed at the low side of the voltage differentiator. the NTC resistance value goes high as the temperature goes high resulting in higer voltage output -> should trigger OTP when motor temp Vout is higher than set value
DC current
thermistor is measured by INV_motorTempIso

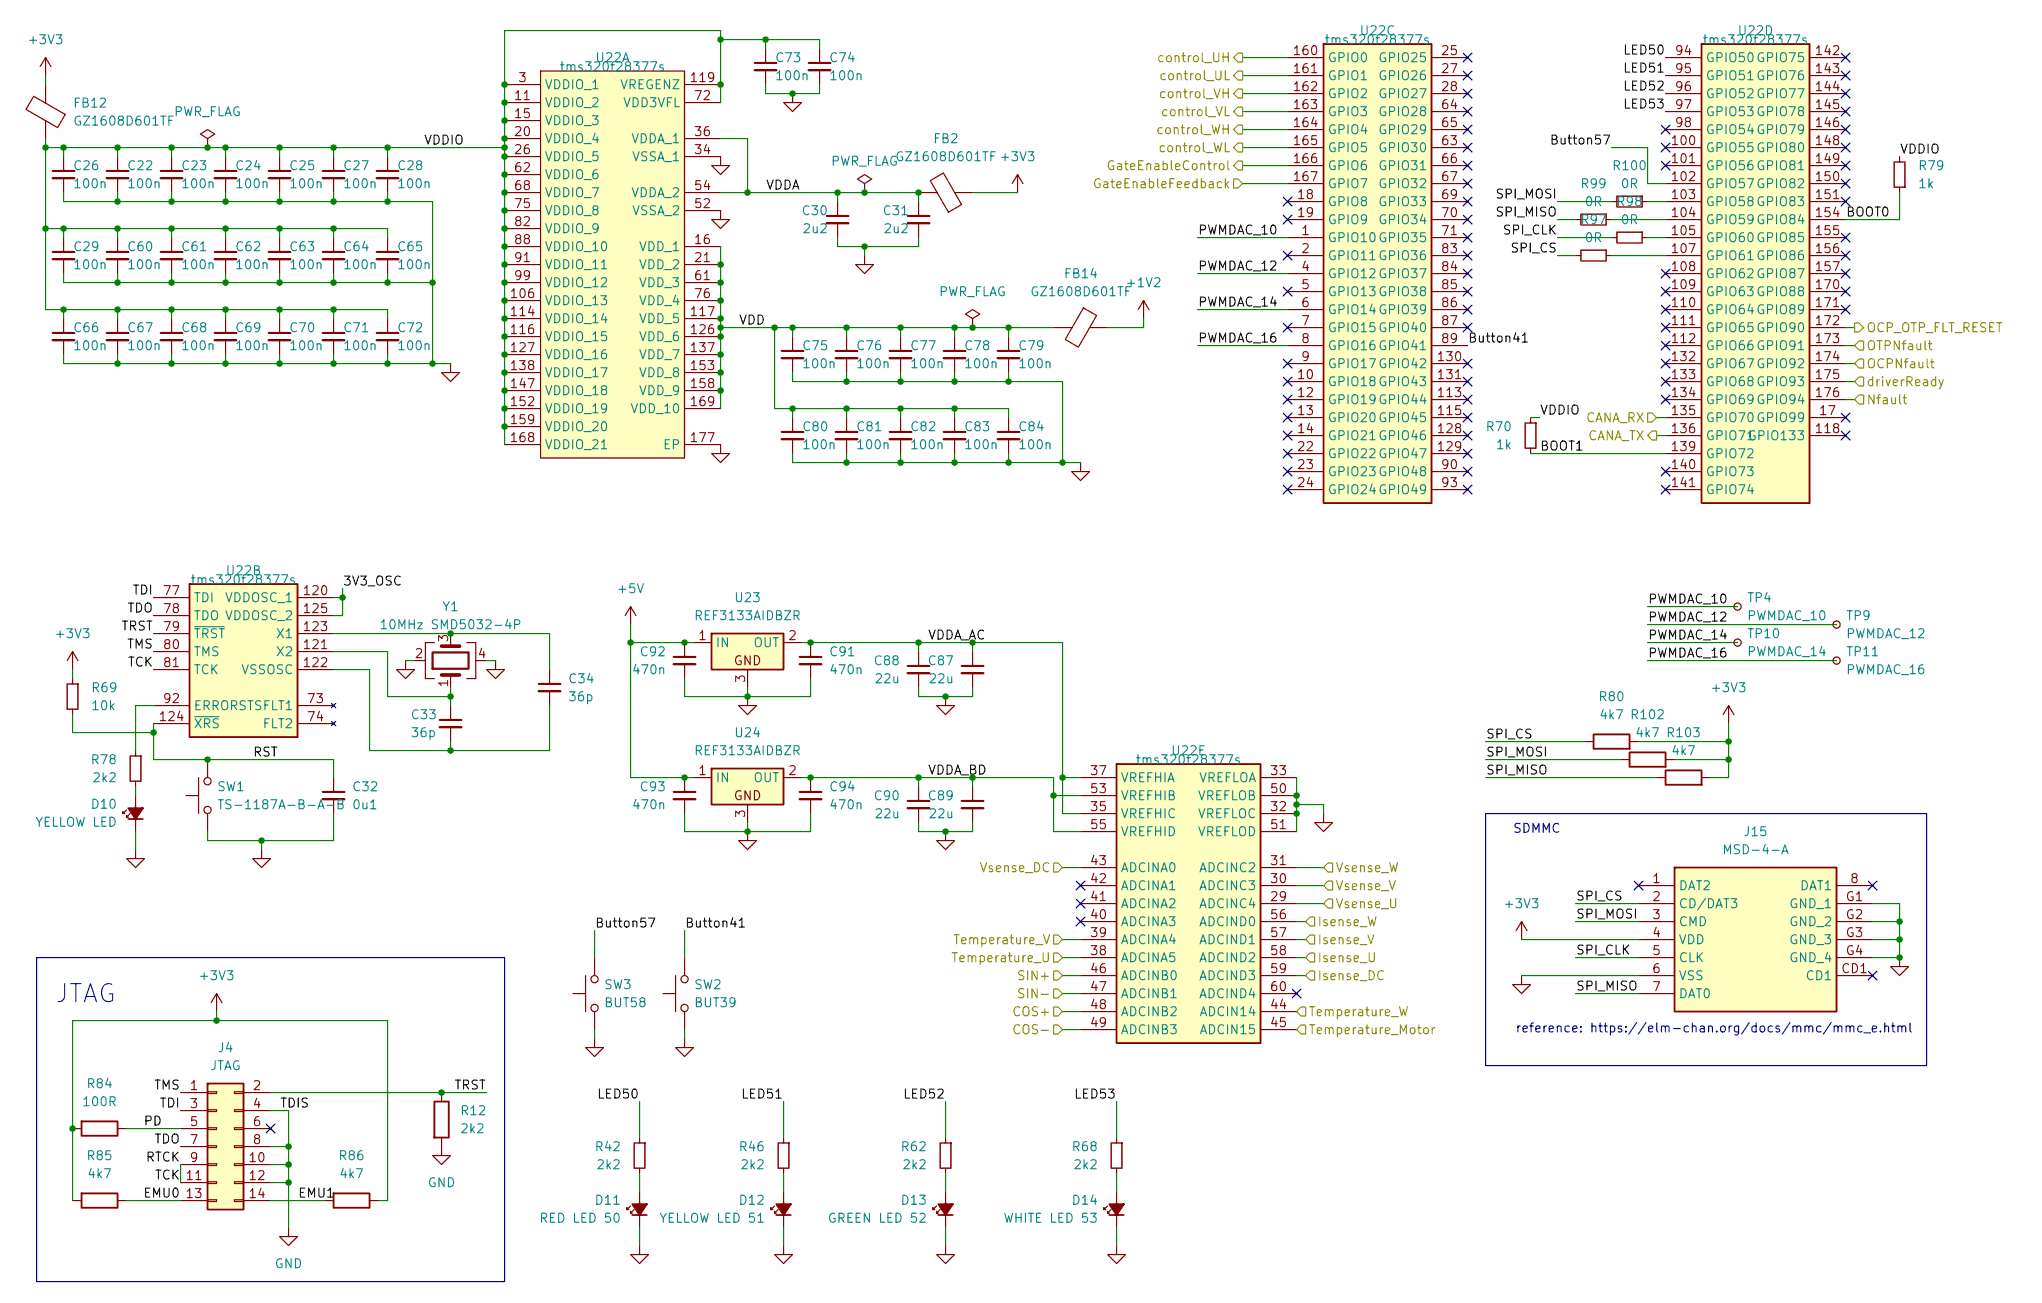
[picture p35: schematic MCU.kicad_sch, INV_MainBoard_TI]

Parts:
C22, C23, C24, C25, C26, C27, C28, C29, C60, C61, C62, C63, C64, C65, C66, C67, C68, C69, C70, C71, C72, C73, C74, C75, C76, C77, C78, C79, C80, C81, C82, C83, C84: 100n; C_0402_1005Metric
C30, C31: 2u2; C_0402_1005Metric
C32: 0u1; C_0402_1005Metric
C33, C34: 36p; C_0402_1005Metric
C87, C88, C89, C90: 22u; C_0805_2012Metric
C91, C92, C93, C94: 470n; C_0603_1608Metric
D10: YELLOW LED; LED_0603_1608Metric
D11: RED LED 50; LED_0603_1608Metric
D12: YELLOW LED 51; LED_0603_1608Metric
D13: GREEN LED 52; LED_0603_1608Metric
D14: WHITE LED 53; LED_0603_1608Metric
FB2, FB12, FB14: GZ1608D601TF; C_0603_1608Metric
J4: JTAG; IDC-Header_2x07_P2.54mm_Vertical
J15: MSD-4-A; MSD4A; Mouser Part Number 179-MSD-4-A
R12: 2k2; R_0603_1608Metric
R42, R46, R62, R68, R78: 2k2; R_0402_1005Metric
R69: 10k; R_0402_1005Metric
R70, R79: 1k; R_0402_1005Metric
R80, R102, R103: 4k7; R_0402_1005Metric
R84: 100R; R_0603_1608Metric
R85, R86: 4k7; R_0603_1608Metric
R97, R98, R99, R100: 0R; R_0402_1005Metric
SW1: TS-1187A-B-A-B; SW_SPST_TL3342
SW2: BUT39; SW_Tactile_SPST_NO_Straight_CK_PTS636Sx25SMTRLFS
SW3: BUT58; SW_Tactile_SPST_NO_Straight_CK_PTS636Sx25SMTRLFS
TP4: PWMDAC_10; TestPoint_Pad_D1.0mm
TP9: PWMDAC_12; TestPoint_Pad_D1.0mm
TP10: PWMDAC_14; TestPoint_Pad_D1.0mm
TP11: PWMDAC_16; TestPoint_Pad_D1.0mm
U22: tms320f28377s; QFP50P2600X2600X160-177N
U23, U24: REF3133AIDBZR; SOT-23
Y1: 10MHz SMD5032-4P; Crystal_SMD_Abracon_ABM3B-4Pin_5.0x3.2mm

Connections:
+1V2: FB14.1; also elsewhere on the board
+3V3: FB2.1, FB12.2, J15.4 (VDD), R69.1, R80.2, R84.2, R85.2, R86.1, R102.2, R103.2; also elsewhere on the board
+5V: C92.1, C93.1, U23.1 (IN), U24.1 (IN); also elsewhere on the board
/EncoderDifVconverter/cos+3V3_out: U22.48 (ADCINB2); also elsewhere on the board
/EncoderDifVconverter/cos-3V3_out: U22.49 (ADCINB3); also elsewhere on the board
/EncoderDifVconverter/sin+3V3_out: U22.46 (ADCINB0); also elsewhere on the board
/EncoderDifVconverter/sin-3V3_out: U22.47 (ADCINB1); also elsewhere on the board
/FLTN: U22.176 (GPIO94); also elsewhere on the board
/GATE_EN: U22.167 (GPIO7); also elsewhere on the board
/GATE_ENC: U22.166 (GPIO6); also elsewhere on the board
/Isense&motT_OCP&OTP/FLT_LATCH_RESET: U22.172 (GPIO90); also elsewhere on the board
/Isense&motT_OCP&OTP/Isense_DC: U22.59 (ADCIND3); also elsewhere on the board
/Isense&motT_OCP&OTP/Isense_U: U22.58 (ADCIND2); also elsewhere on the board
/Isense&motT_OCP&OTP/Isense_V: U22.57 (ADCIND1); also elsewhere on the board
/Isense&motT_OCP&OTP/Isense_W: U22.56 (ADCIND0); also elsewhere on the board
/Isense&motT_OCP&OTP/OCP_SENSE: U22.174 (GPIO92); also elsewhere on the board
/Isense&motT_OCP&OTP/OTP_SENSE: U22.173 (GPIO91); also elsewhere on the board
/MCU/3V3_OSC: U22.120 (VDDOSC_1), U22.125 (VDDOSC_2)
/MCU/BOOT0: R79.1, U22.154 (GPIO84)
/MCU/BOOT1: R70.2, U22.139 (GPIO72)
/MCU/Button41: SW2.2, U22.89 (GPIO41)
/MCU/Button57: SW3.2, U22.102 (GPIO57)
/MCU/CANA_RX: U22.135 (GPIO70); also elsewhere on the board
/MCU/CANA_TX: U22.136 (GPIO71); also elsewhere on the board
/MCU/EMU0: J4.13, R85.1
/MCU/EMU1: J4.14, R86.2
/MCU/LED50: R42.1, U22.94 (GPIO50)
/MCU/LED51: R46.1, U22.95 (GPIO51)
/MCU/LED52: R62.1, U22.96 (GPIO52)
/MCU/LED53: R68.1, U22.97 (GPIO53)
/MCU/PD: J4.5, R84.1
/MCU/PWMDAC_10: TP4.1, U22.1 (GPIO10)
/MCU/PWMDAC_12: TP9.1, U22.4 (GPIO12)
/MCU/PWMDAC_14: TP10.1, U22.6 (GPIO14)
/MCU/PWMDAC_16: TP11.1, U22.8 (GPIO16)
/MCU/RST: C32.1, R69.2, SW1.2, U22.124 (~XRS)
/MCU/RTCK: J4.9, J4.11, U22.81 (TCK)
/MCU/SPI_CLK: J15.5 (CLK), R98.2
/MCU/SPI_CS: J15.2 (CD/DAT3), R80.1, R97.2
/MCU/SPI_MISO: J15.7 (DAT0), R99.2, R103.1
/MCU/SPI_MOSI: J15.3 (CMD), R100.2, R102.1
/MCU/TDI: J4.3, U22.77 (TDI)
/MCU/TDO: J4.7, U22.78 (TDO)
/MCU/TMS: J4.1, U22.80 (TMS)
/MCU/TRST: J4.2, R12.1, U22.79 (~TRST)
/MCU/VDD: C75.1, C76.1, C77.1, C78.1, C79.1, C80.1, C81.1, C82.1, C83.1, C84.1, FB14.2, U22.16 (VDD_1), U22.21 (VDD_2), U22.61 (VDD_3), U22.76 (VDD_4), U22.117 (VDD_5), U22.126 (VDD_6), U22.137 (VDD_7), U22.153 (VDD_8), U22.158 (VDD_9), U22.169 (VDD_10)
/MCU/VDDA: C30.1, C31.1, FB2.2, U22.36 (VDDA_1), U22.54 (VDDA_2)
/MCU/VDDA_AC: C87.1, C88.1, C91.1, U22.35 (VREFHIC), U22.37 (VREFHIA), U23.2 (OUT)
/MCU/VDDA_BD: C89.1, C90.1, C94.1, U22.53 (VREFHIB), U22.55 (VREFHID), U24.2 (OUT)
/MCU/VDDIO: C22.1, C23.1, C24.1, C25.1, C26.1, C27.1, C28.1, C29.1, C60.1, C61.1, C62.1, C63.1, C64.1, C65.1, C66.1, C67.1, C68.1, C69.1, C70.1, C71.1, C72.1, C73.1, C74.1, FB12.1, R70.1, R79.2, U22.3 (VDDIO_1), U22.11 (VDDIO_2), U22.15 (VDDIO_3), U22.20 (VDDIO_4), U22.26 (VDDIO_5), U22.62 (VDDIO_6), U22.68 (VDDIO_7), U22.72 (VDD3VFL), U22.75 (VDDIO_8), U22.82 (VDDIO_9), U22.88 (VDDIO_10), U22.91 (VDDIO_11), U22.99 (VDDIO_12), U22.106 (VDDIO_13), U22.114 (VDDIO_14), U22.116 (VDDIO_15), U22.119 (VREGENZ), U22.127 (VDDIO_16), U22.138 (VDDIO_17), U22.147 (VDDIO_18), U22.152 (VDDIO_19), U22.159 (VDDIO_20), U22.168 (VDDIO_21)
/MCU/Vsense_U: U22.29 (ADCINC4); also elsewhere on the board
/MCU/Vsense_V: U22.30 (ADCINC3); also elsewhere on the board
/MCU/Vsense_W: U22.31 (ADCINC2); also elsewhere on the board
/RDY: U22.175 (GPIO93); also elsewhere on the board
/T_filt_U: U22.38 (ADCINA5); also elsewhere on the board
/T_filt_V: U22.39 (ADCINA4); also elsewhere on the board
/T_filt_W: U22.44 (ADCIN14); also elsewhere on the board
/T_mot: U22.45 (ADCIN15); also elsewhere on the board
/UH: U22.160 (GPIO0); also elsewhere on the board
/UL: U22.161 (GPIO1); also elsewhere on the board
/VH: U22.162 (GPIO2); also elsewhere on the board
/VL: U22.163 (GPIO3); also elsewhere on the board
/Vsense_filt_DC: U22.43 (ADCINA0); also elsewhere on the board
/WH: U22.164 (GPIO4); also elsewhere on the board
/WL: U22.165 (GPIO5); also elsewhere on the board
GND: C22.2, C23.2, C24.2, C25.2, C26.2, C27.2, C28.2, C29.2, C30.2, C31.2, C32.2, C60.2, C61.2, C62.2, C63.2, C64.2, C65.2, C66.2, C67.2, C68.2, C69.2, C70.2, C71.2, C72.2, C73.2, C74.2, C75.2, C76.2, C77.2, C78.2, C79.2, C80.2, C81.2, C82.2, C83.2, C84.2, C87.2, C88.2, C89.2, C90.2, C91.2, C92.2, C93.2, C94.2, D10.1 (K), D11.1 (K), D12.1 (K), D13.1 (K), D14.1 (K), J4.4, J4.8, J4.10, J4.12, J15.6 (VSS), J15.G1 (GND_1), J15.G2 (GND_2), J15.G3 (GND_3), J15.G4 (GND_4), R12.2, SW1.1, SW2.1, SW3.1, U22.32 (VREFLOC), U22.33 (VREFLOA), U22.34 (VSSA_1), U22.50 (VREFLOB), U22.51 (VREFLOD), U22.52 (VSSA_2), U22.177 (EP), U23.3, U24.3, Y1.2, Y1.4; also elsewhere on the board
unnamed: D10.2 (A), R78.2
unnamed: D11.2 (A), R42.2
unnamed: D12.2 (A), R46.2
unnamed: D13.2 (A), R62.2
unnamed: D14.2 (A), R68.2
unnamed: R78.1, U22.92 (ERRORSTS)
unnamed: C33.2, C34.2, U22.122 (VSSOSC)
unnamed: C34.1, U22.123 (X1), Y1.3
unnamed: C33.1, U22.121 (X2), Y1.1
unnamed: R100.1, U22.103 (GPIO58)
unnamed: R99.1, U22.104 (GPIO59)
unnamed: R98.1, U22.105 (GPIO60)
unnamed: R97.1, U22.107 (GPIO61)

Notes on the sheet:
reference: https://elm-chan.org/docs/mmc/mmc_e.html
JTAG
SDMMC

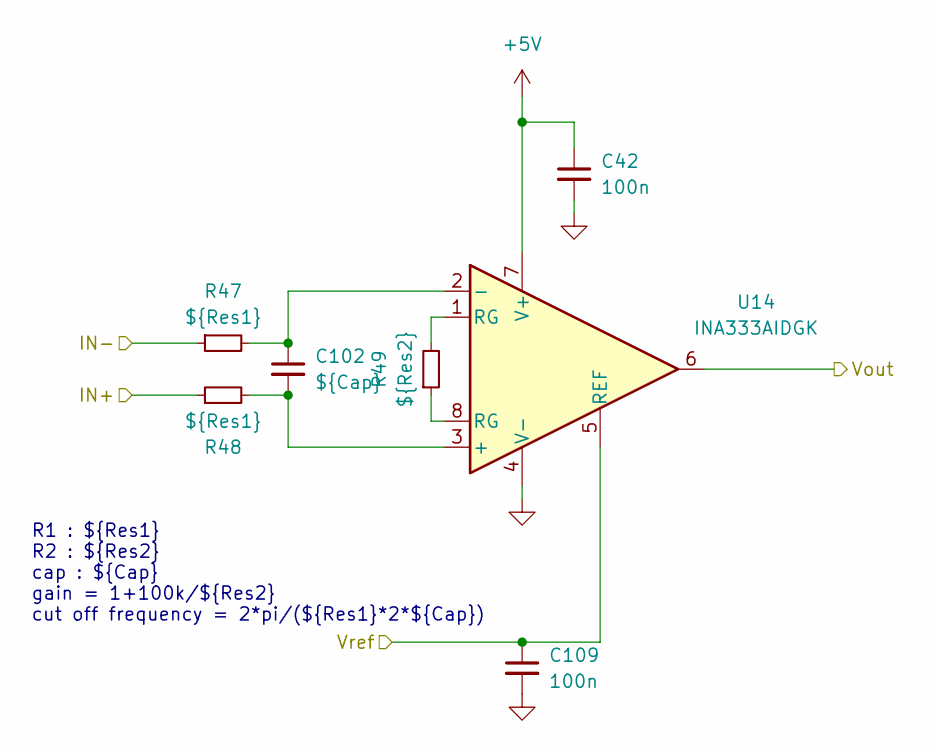
[picture p36: schematic DifToSingle.kicad_sch, INV_MainBoard_TI]

Parts:
C42, C109: 100n; C_0402_1005Metric
C102: ${Cap}; C_0402_1005Metric
R47, R48: ${Res1}; R_0402_1005Metric
R49: ${Res2}; R_0402_1005Metric
U14: INA333AIDGK; MSOP-8_3x3mm_P0.65mm

Connections:
+5V: C42.1, U14.7 (V+); also elsewhere on the board
/Isense&motT_OCP&OTP/Isense_W: U14.6; also elsewhere on the board
/Isense&motT_OCP&OTP/Vref_1.65V: C109.1, U14.5 (REF); also elsewhere on the board
/Isense&motT_OCP&OTP/W+: R47.1; also elsewhere on the board
/Isense&motT_OCP&OTP/W-: R48.1; also elsewhere on the board
GND: C42.2, C109.2, U14.4 (V-); also elsewhere on the board
unnamed: R49.1, U14.8 (RG)
unnamed: R49.2, U14.1 (RG)
unnamed: C102.2, R48.2, U14.3 (+)
unnamed: C102.1, R47.2, U14.2 (-)

Parts of its further copies:
C21, C40, C41, C43, C105, C106, C107, C108: 100n; C_0402_1005Metric
U3, U7, U8, U9: INA333AIDGK; MSOP-8_3x3mm_P0.65mm

Connections of its further copies:
+5V: C21.1, C40.1, C41.1, C43.1, U3.7 (V+), U7.7 (V+), U8.7 (V+), U9.7 (V+); also elsewhere on the board
/Isense&motT_OCP&OTP/Isense_DC: U7.6; also elsewhere on the board
/Isense&motT_OCP&OTP/Isense_U: U8.6; also elsewhere on the board
/Isense&motT_OCP&OTP/Isense_V: U9.6; also elsewhere on the board
/Isense&motT_OCP&OTP/Vref_1.65V: C106.1, C107.1, C108.1, U7.5 (REF), U8.5 (REF), U9.5 (REF); also elsewhere on the board
/T_mot: U3.6; also elsewhere on the board
GND: C21.2, C40.2, C41.2, C43.2, C105.1, C105.2, C106.2, C107.2, C108.2, U3.4 (V-), U3.5 (REF), U7.4 (V-), U8.4 (V-), U9.4 (V-); also elsewhere on the board
unnamed 128: U7.8 (RG); also elsewhere on the board
unnamed 129: U7.1 (RG); also elsewhere on the board
unnamed 130: U8.8 (RG); also elsewhere on the board
unnamed 131: U8.1 (RG); also elsewhere on the board
unnamed 132: U9.8 (RG); also elsewhere on the board
unnamed 133: U9.1 (RG); also elsewhere on the board
unnamed 136: U3.8 (RG); also elsewhere on the board
unnamed 137: U3.1 (RG); also elsewhere on the board
unnamed 142: U3.3 (+); also elsewhere on the board
unnamed 143: U3.2 (-); also elsewhere on the board
unnamed 149: U7.3 (+); also elsewhere on the board
unnamed 150: U7.2 (-); also elsewhere on the board
unnamed 151: U8.3 (+); also elsewhere on the board
unnamed 152: U8.2 (-); also elsewhere on the board
unnamed 153: U9.3 (+); also elsewhere on the board
unnamed 154: U9.2 (-); also elsewhere on the board

Notes on the sheet:
R1 : ${Res1} R2 : ${Res2} cap : ${Cap} gain = 1+100k/${Res2} cut off frequency = 2*pi/(${Res1}*2*${Cap})

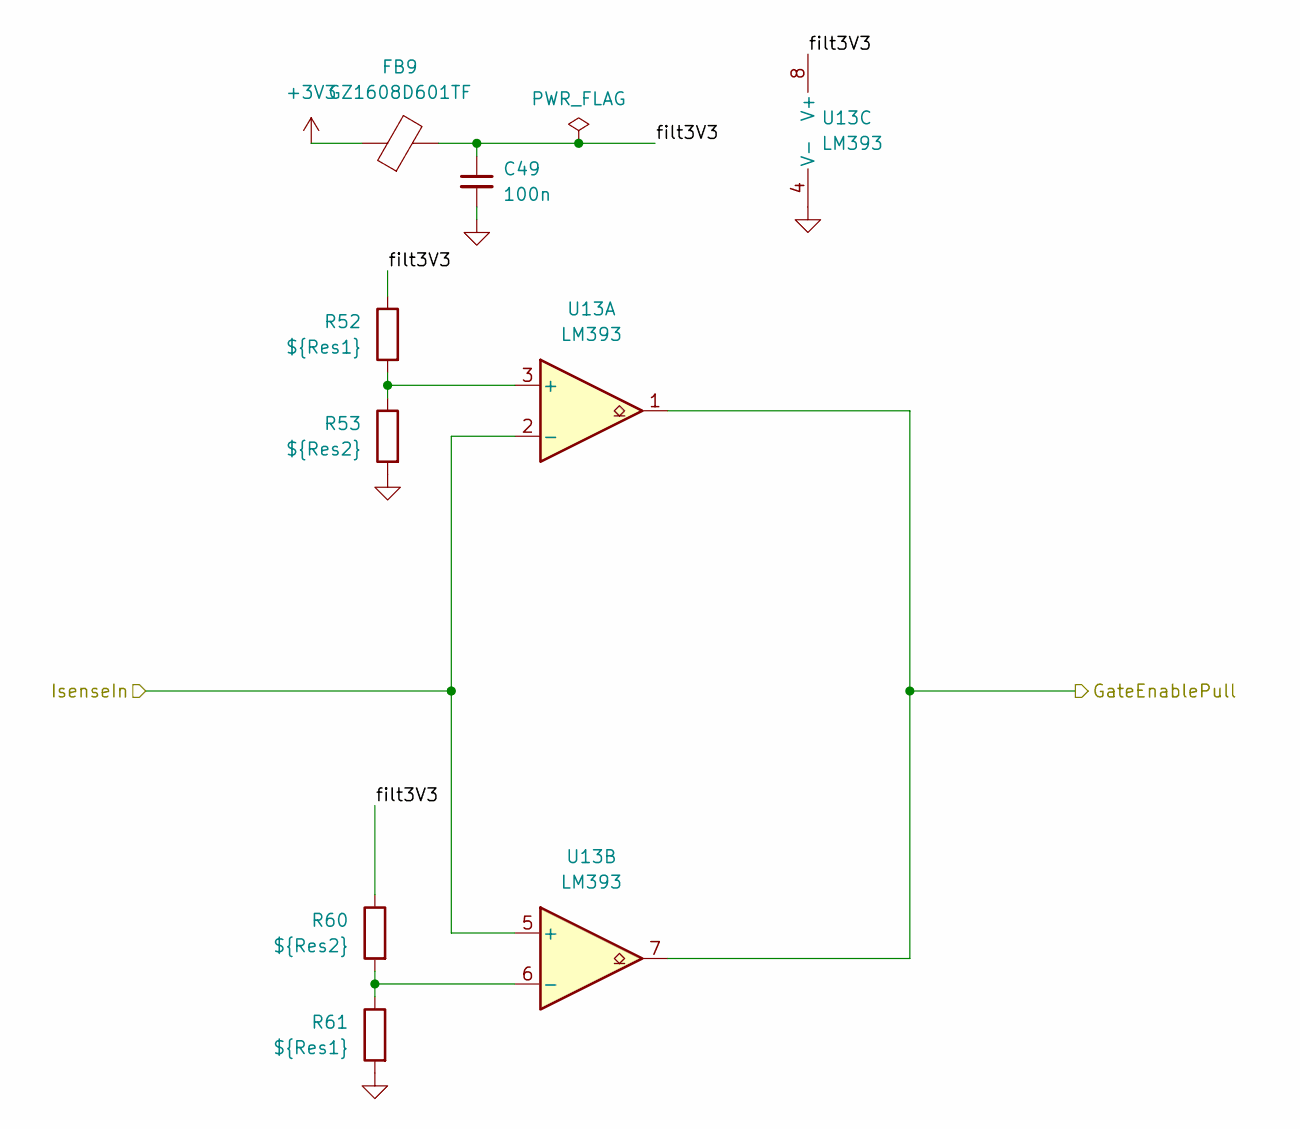
[picture p37: schematic OCPnode.kicad_sch, INV_MainBoard_TI]

Parts:
C49: 100n; C_0402_1005Metric
FB9: GZ1608D601TF; C_0603_1608Metric
R52, R61: ${Res1}; R_0402_1005Metric
R53, R60: ${Res2}; R_0402_1005Metric
U13: LM393; SOIC-8_3.9x4.9mm_P1.27mm

Connections:
+3V3: FB9.1; also elsewhere on the board
/Isense&motT_OCP&OTP/OCPnode1/GateEnablePull: U13.1, U13.7; also elsewhere on the board
/Isense&motT_OCP&OTP/OCPnode3/IsenseIn: U13.2 (-), U13.5 (+); also elsewhere on the board
/Isense&motT_OCP&OTP/OCPnode3/filt3V3: C49.1, FB9.2, R52.1, R60.1, U13.8 (V+)
GND: C49.2, R53.2, R61.2, U13.4 (V-); also elsewhere on the board
unnamed: R52.2, R53.1, U13.3 (+)
unnamed: R60.2, R61.1, U13.6 (-)

Parts of its further copies:
C47, C48: 100n; C_0402_1005Metric
FB7, FB8: GZ1608D601TF; C_0603_1608Metric
U11, U12: LM393; SOIC-8_3.9x4.9mm_P1.27mm

Connections of its further copies:
+3V3: FB7.1, FB8.1; also elsewhere on the board
/Isense&motT_OCP&OTP/OCPnode1/GateEnablePull: U11.1, U11.7, U12.1, U12.7; also elsewhere on the board
/Isense&motT_OCP&OTP/OCPnode1/IsenseIn: U11.2 (-), U11.5 (+); also elsewhere on the board
/Isense&motT_OCP&OTP/OCPnode1/filt3V3: C47.1, FB7.2, U11.8 (V+); also elsewhere on the board
/Isense&motT_OCP&OTP/OCPnode2/IsenseIn: U12.2 (-), U12.5 (+); also elsewhere on the board
/Isense&motT_OCP&OTP/OCPnode2/filt3V3: C48.1, FB8.2, U12.8 (V+); also elsewhere on the board
GND: C47.2, C48.2, U11.4 (V-), U12.4 (V-); also elsewhere on the board
unnamed 156: U11.3 (+); also elsewhere on the board
unnamed 157: U11.6 (-); also elsewhere on the board
unnamed 158: U12.3 (+); also elsewhere on the board
unnamed 159: U12.6 (-); also elsewhere on the board

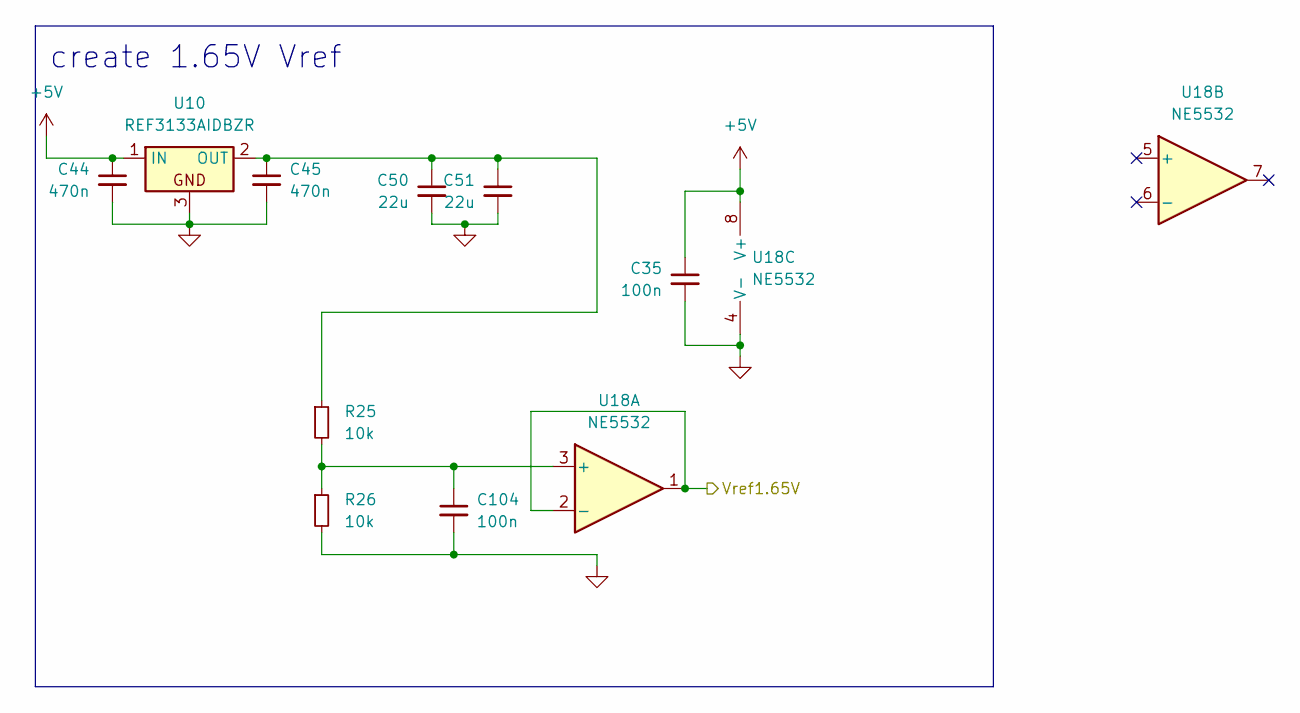
[picture p38: schematic Vref1.65V.kicad_sch, INV_MainBoard_TI]

Parts:
C35, C104: 100n; C_0402_1005Metric
C44, C45: 470n; C_0603_1608Metric
C50, C51: 22u; C_0805_2012Metric
R25, R26: 10k; R_0402_1005Metric
U10: REF3133AIDBZR; SOT-23
U18: NE5532; SOIC-8_3.9x4.9mm_P1.27mm

Connections:
+5V: C35.1, C44.1, U10.1 (IN), U18.8 (V+); also elsewhere on the board
/Isense&motT_OCP&OTP/Vref_1.65V: U18.1, U18.2 (-); also elsewhere on the board
GND: C35.2, C44.2, C45.2, C50.2, C51.2, C104.2, R26.2, U10.3, U18.4 (V-); also elsewhere on the board
unnamed: C45.1, C50.1, C51.1, R25.1, U10.2 (OUT)
unnamed: C104.1, R25.2, R26.1, U18.3 (+)

Notes on the sheet:
create 1.65V Vref

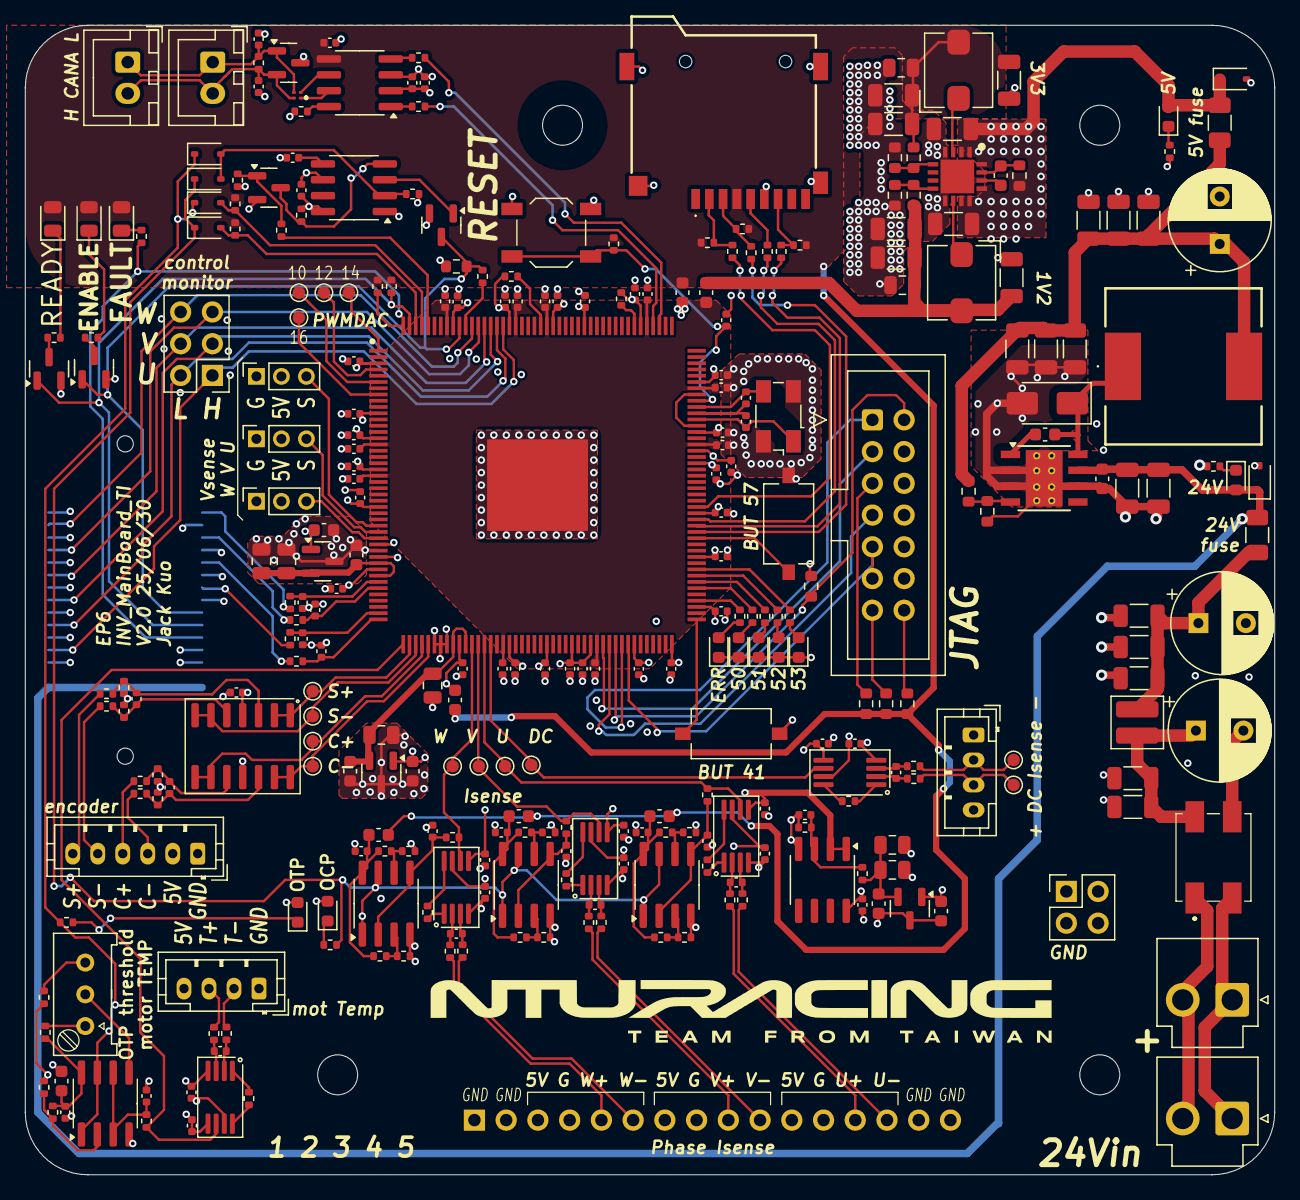
[picture p39: board INV_MainBoard_TI.kicad_pcb from above]

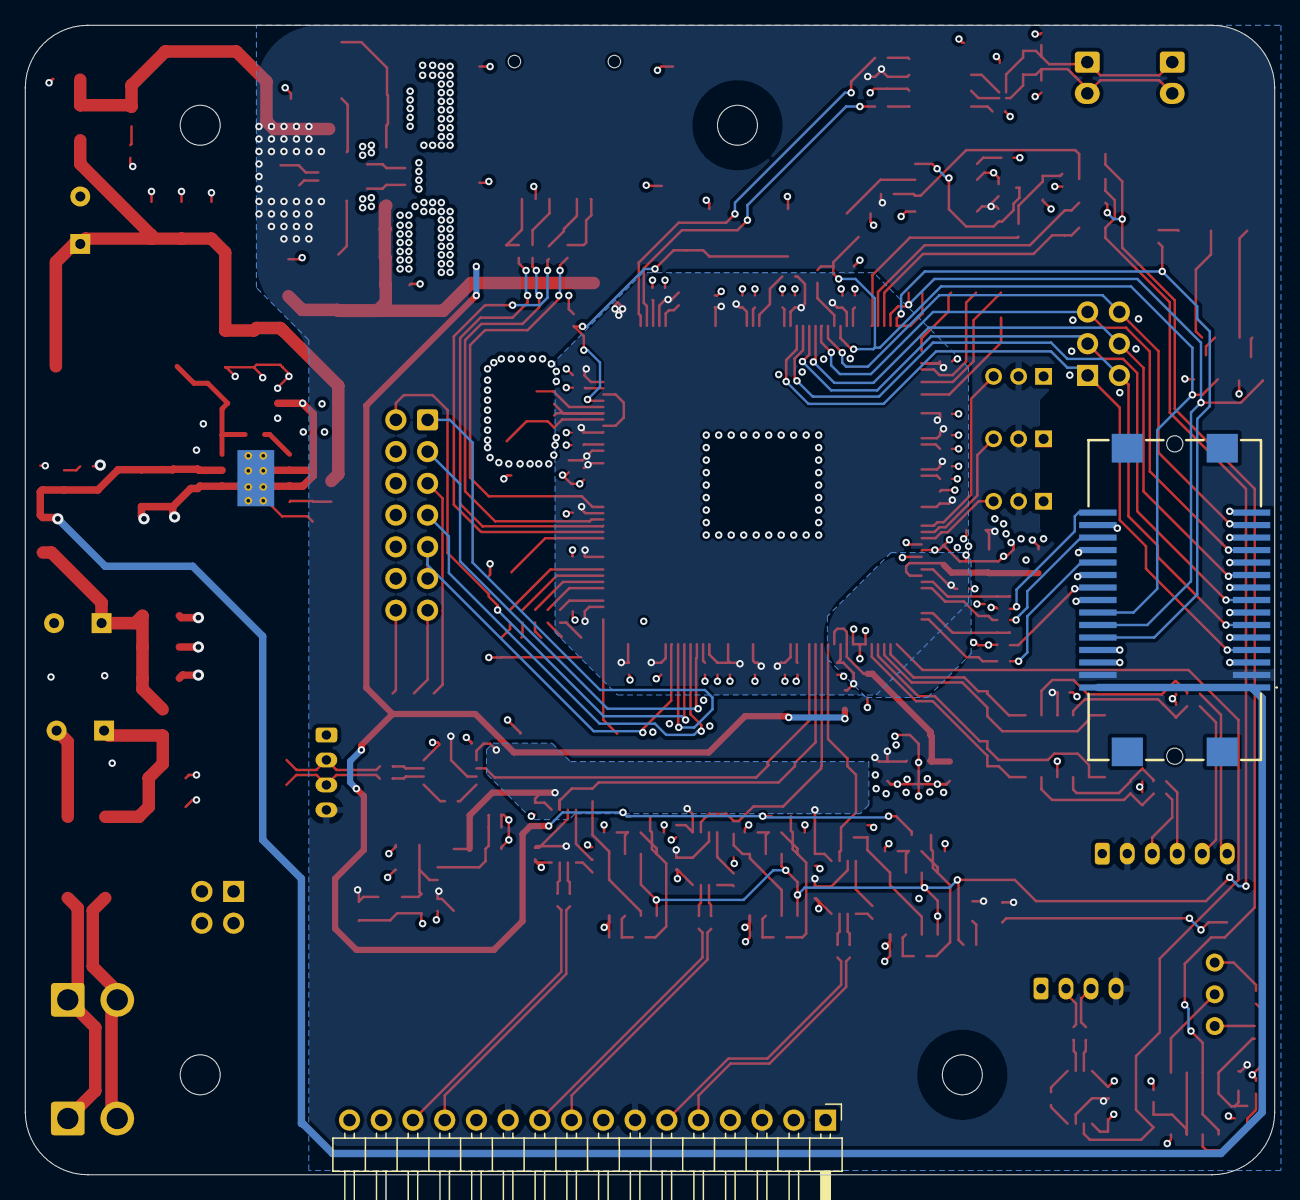
[picture p40: board INV_MainBoard_TI.kicad_pcb from below]

Board: 4 copper layers, 100.0 x 92.0 mm, 311 parts (2 on the bottom side), 179 nets.

Other parts of the board:
C96: 1u; C_0402_1005Metric
C99, C100, C101: 470p; C_0402_1005Metric
R31, R50, R57, R59, R63, R64: 10k; R_0402_1005Metric
R33, R51, R56, R58: 27k; R_0402_1005Metric
R35, R36, R39, R40, R43, R44: 150R; R_0402_1005Metric
R37, R41, R45: 10M; R_0402_1005Metric
R65: 100k; R_0402_1005Metric

Their connections:
/Isense&motT_OCP&OTP/IsenseNode/IN+: R36.1; also elsewhere on the board
/Isense&motT_OCP&OTP/IsenseNode/IN-: R35.1; also elsewhere on the board
/Isense&motT_OCP&OTP/Motor_temp/IN+: R64.1; also elsewhere on the board
/Isense&motT_OCP&OTP/Motor_temp/IN-: R63.1; also elsewhere on the board
/Isense&motT_OCP&OTP/OCPnode1/filt3V3: R31.1, R56.1; also elsewhere on the board
/Isense&motT_OCP&OTP/OCPnode2/filt3V3: R50.1, R58.1; also elsewhere on the board
/Isense&motT_OCP&OTP/U+: R39.1; also elsewhere on the board
/Isense&motT_OCP&OTP/U-: R40.1; also elsewhere on the board
/Isense&motT_OCP&OTP/V+: R43.1; also elsewhere on the board
/Isense&motT_OCP&OTP/V-: R44.1; also elsewhere on the board
GND: R33.2, R51.2, R57.2, R59.2; also elsewhere on the board
unnamed 128: R37.1; also elsewhere on the board
unnamed 129: R37.2; also elsewhere on the board
unnamed 130: R41.1; also elsewhere on the board
unnamed 131: R41.2; also elsewhere on the board
unnamed 132: R45.1; also elsewhere on the board
unnamed 133: R45.2; also elsewhere on the board
unnamed 136: R65.1; also elsewhere on the board
unnamed 137: R65.2; also elsewhere on the board
unnamed 142: C96.2, R64.2; also elsewhere on the board
unnamed 143: C96.1, R63.2; also elsewhere on the board
unnamed 149: C99.2, R36.2; also elsewhere on the board
unnamed 150: C99.1, R35.2; also elsewhere on the board
unnamed 151: C100.2, R40.2; also elsewhere on the board
unnamed 152: C100.1, R39.2; also elsewhere on the board
unnamed 153: C101.2, R44.2; also elsewhere on the board
unnamed 154: C101.1, R43.2; also elsewhere on the board
unnamed 156: R31.2, R33.1; also elsewhere on the board
unnamed 157: R56.2, R57.1; also elsewhere on the board
unnamed 158: R50.2, R51.1; also elsewhere on the board
unnamed 159: R58.2, R59.1; also elsewhere on the board
