NTURacingTeam/nturt_kicad/EP6/Powertrain_Group/INV_Diff2Single/INV_Diff2Single.kicad_pcb

## KiCad design EP6/Powertrain_Group/INV_Diff2Single/INV_Diff2Single.kicad_pcb (2025-07-10)

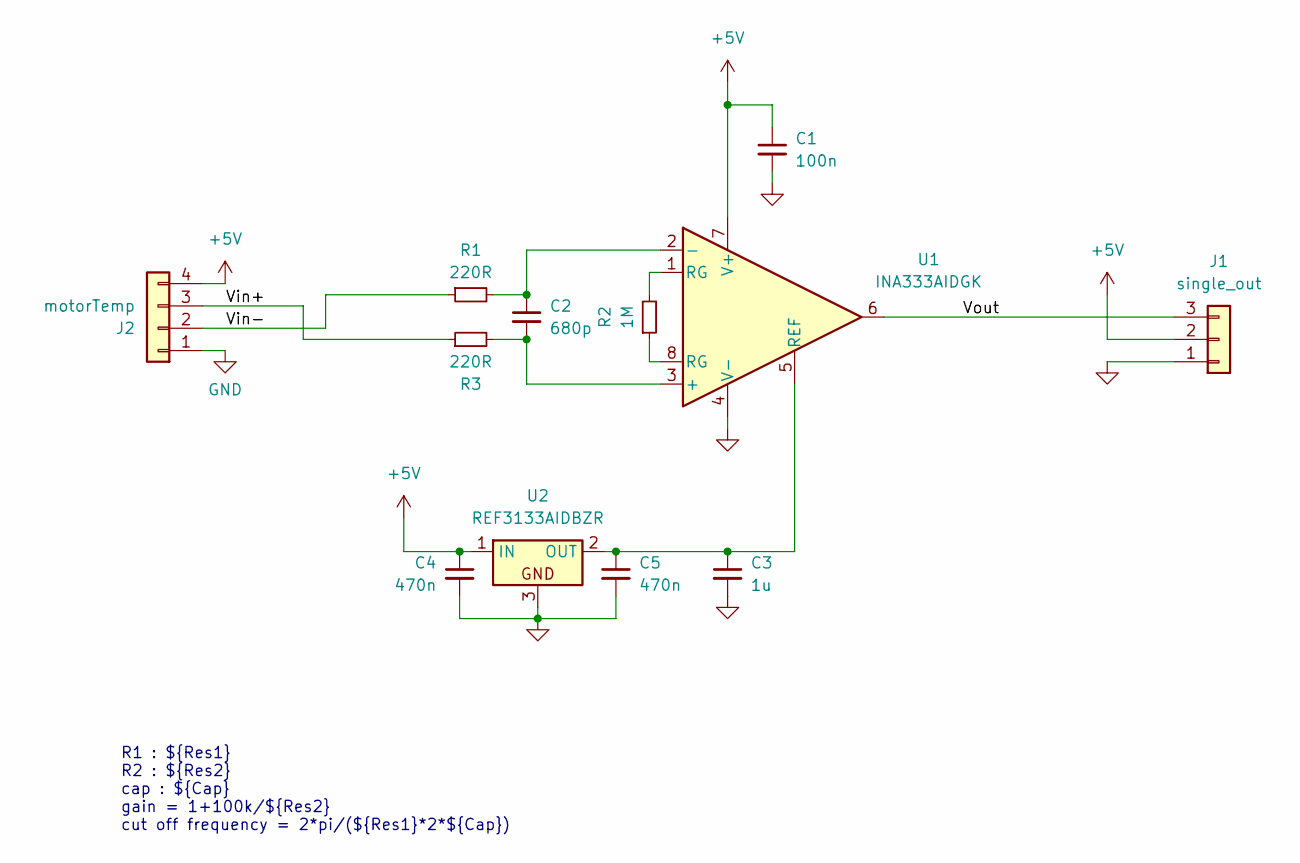
[picture p41: schematic INV_Diff2Single.kicad_sch]

Parts:
C1: 100n; C_0402_1005Metric
C2: 680p; C_0402_1005Metric
C3: 1u; C_0402_1005Metric
C4, C5: 470n; C_0603_1608Metric
J1: single_out; PinHeader_1x03_P2.00mm_Horizontal
J2: motorTemp; PinHeader_1x04_P2.54mm_Horizontal
R1, R3: 220R; R_0402_1005Metric
R2: 1M; R_0402_1005Metric
U1: INA333AIDGK; MSOP-8_3x3mm_P0.65mm
U2: REF3133AIDBZR; SOT-23

Connections:
+5V: C1.1, C4.1, J1.2, J2.4, U1.7 (V+), U2.1 (IN)
/Vin+: J2.3, R3.1
/Vin-: J2.2, R1.1
/Vout: J1.3, U1.6
GND: C1.2, C3.2, C4.2, C5.2, J1.1, J2.1, U1.4 (V-), U2.3
unnamed: R2.1, U1.8 (RG)
unnamed: R2.2, U1.1 (RG)
unnamed: C2.2, R3.2, U1.3 (+)
unnamed: C2.1, R1.2, U1.2 (-)
unnamed: C3.1, C5.1, U1.5 (REF), U2.2 (OUT)

Notes on the sheet:
R1 : ${Res1} R2 : ${Res2} cap : ${Cap} gain = 1+100k/${Res2} cut off frequency = 2*pi/(${Res1}*2*${Cap})

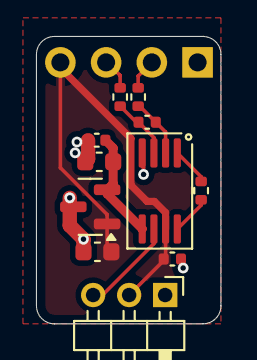
[picture p42: board INV_Diff2Single.kicad_pcb from above]

Board: 2 copper layers, 10.2 x 16.0 mm, 12 parts (1 on the bottom side), 10 nets.
