NTURacingTeam/nturt_kicad/EP6/Electrical_Group/VCU/VCU.kicad_pcb

## KiCad design EP6/Electrical_Group/VCU/VCU.kicad_pcb (2025-07-10)

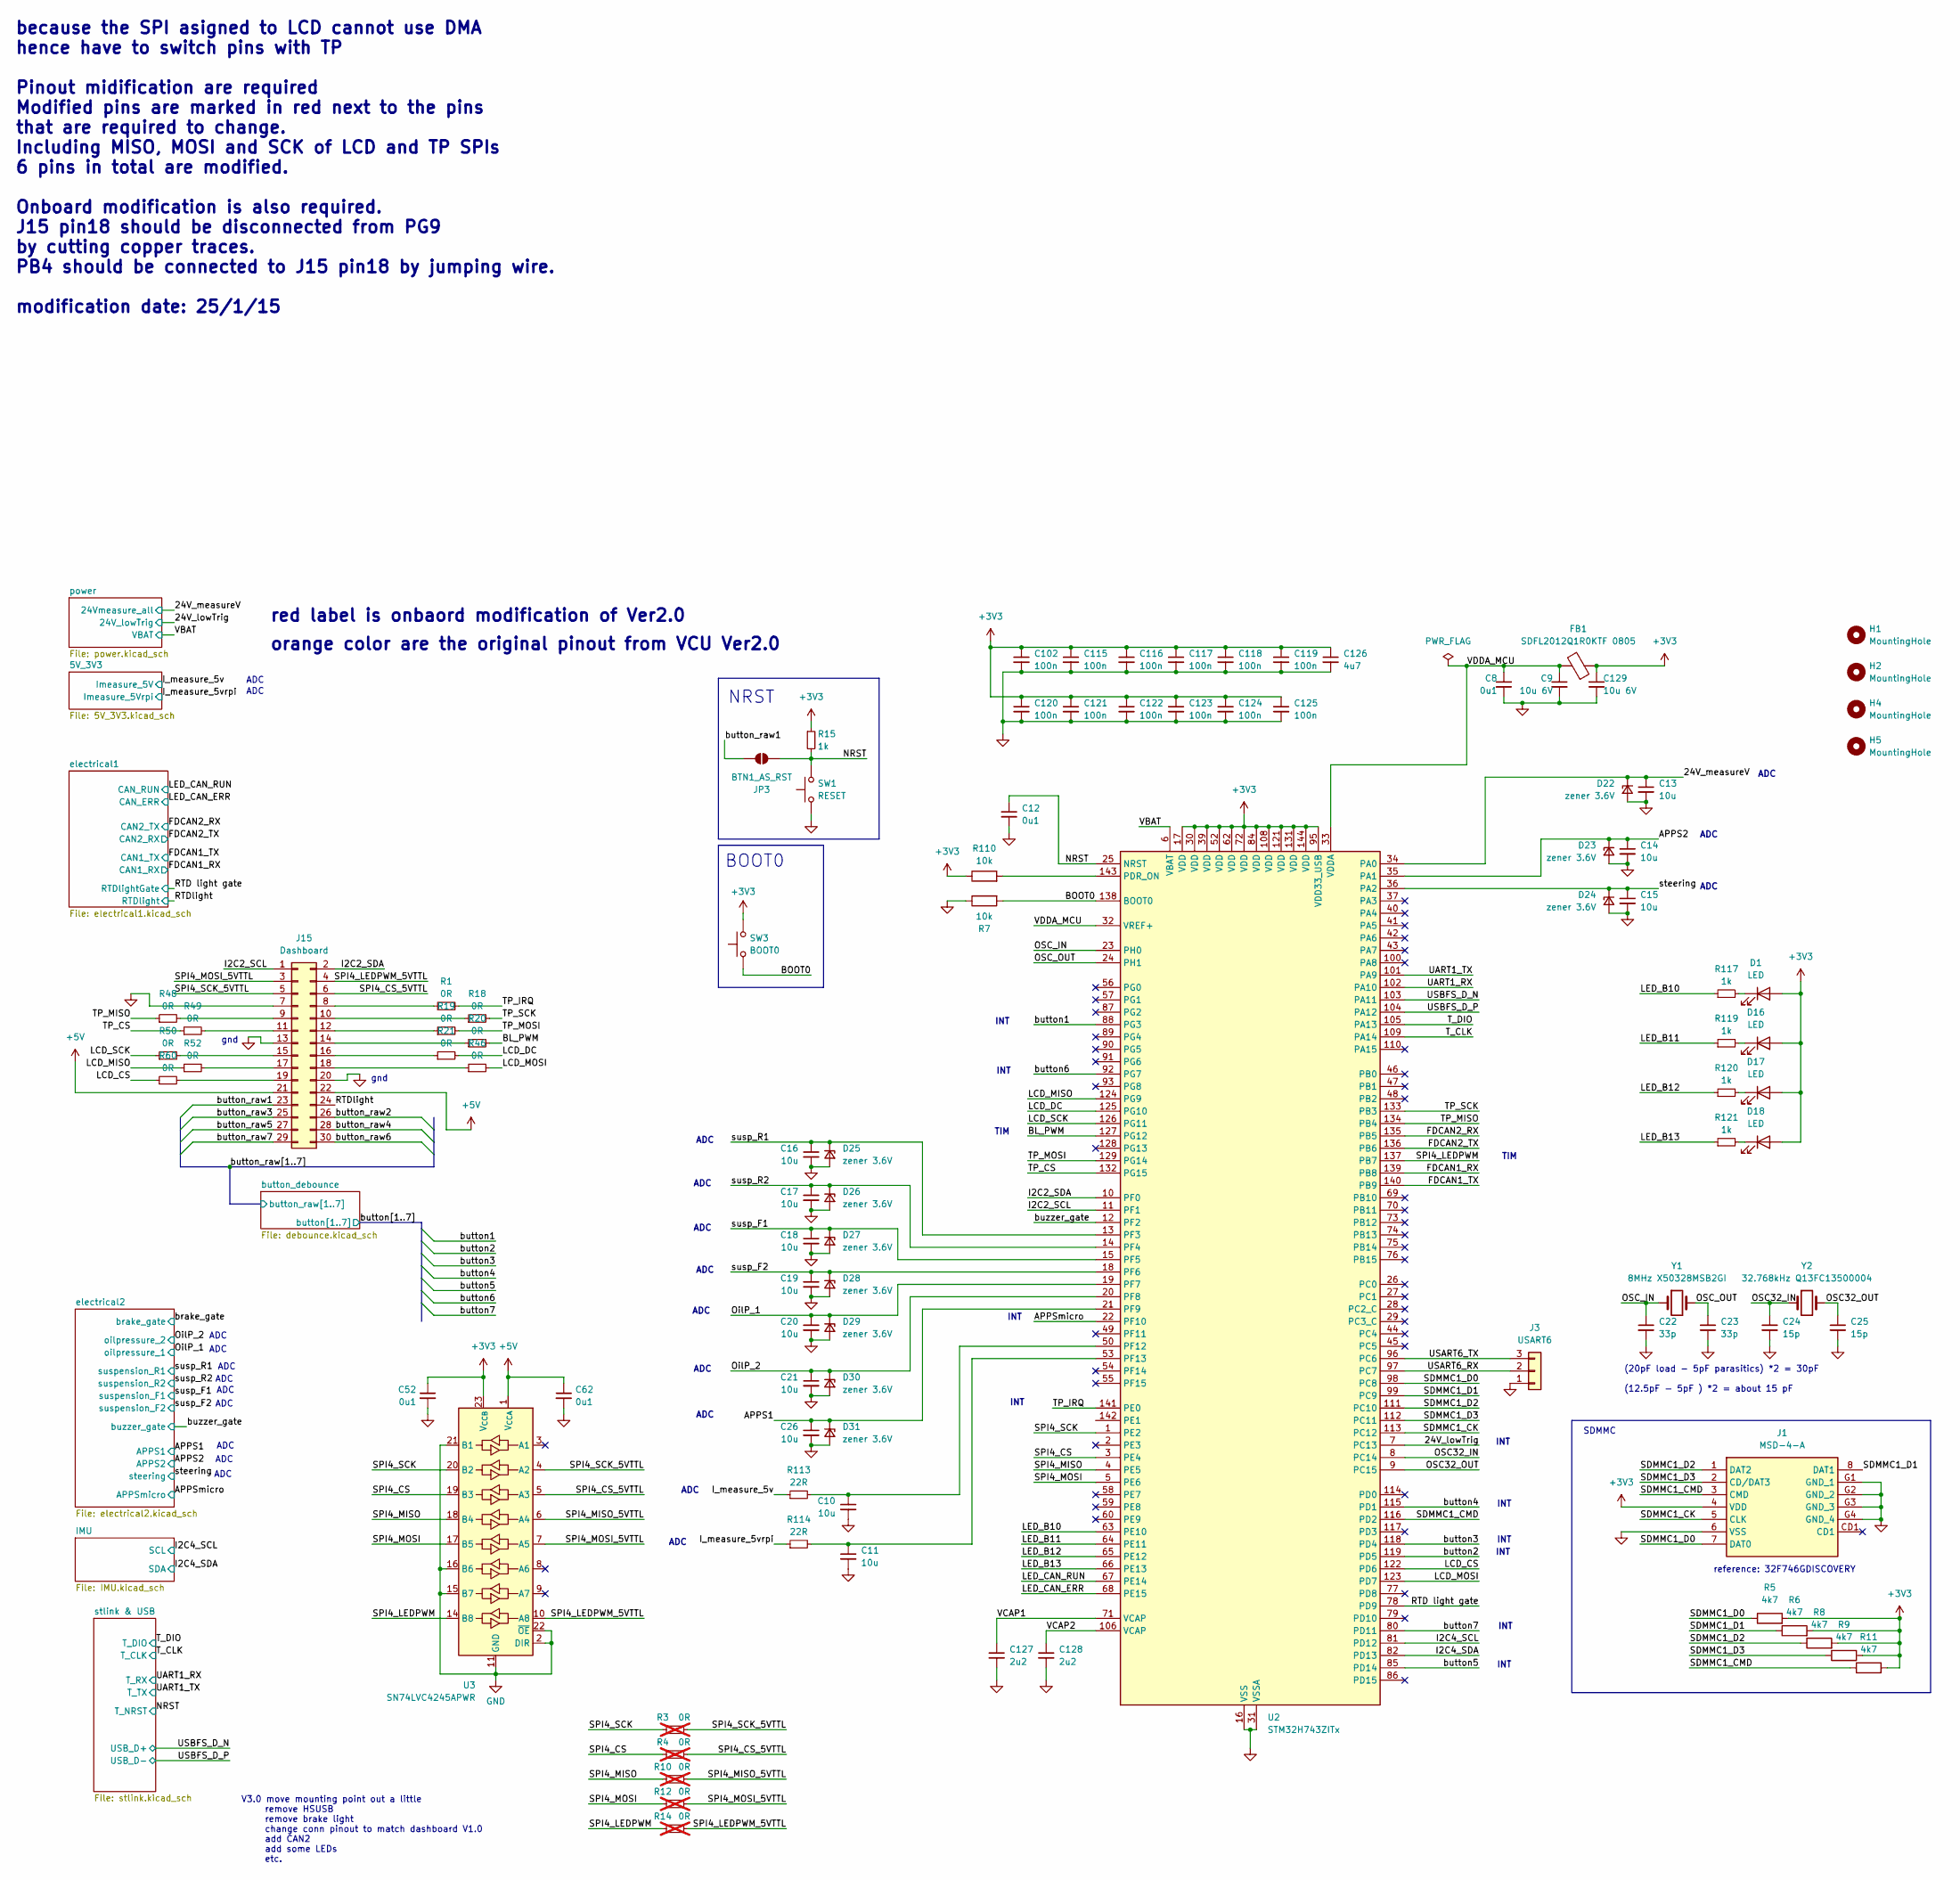
[picture p43: schematic VCU.kicad_sch]

Parts:
C8, C12, C52, C62: 0u1; C_0402_1005Metric
C9, C129: 10u 6V; C_0402_1005Metric
C10, C11, C13, C14, C15, C16, C17, C18, C19, C20, C21, C26: 10u; C_0402_1005Metric
C22, C23: 33p; C_0402_1005Metric
C24, C25: 15p; C_0402_1005Metric
C102, C115, C116, C117, C118, C119, C120, C121, C122, C123, C124, C125: 100n; C_0402_1005Metric
C126: 4u7; C_0402_1005Metric
C127, C128: 2u2; C_0402_1005Metric
D1, D16, D17, D18: LED; LED_0603_1608Metric
D22, D23, D24, D25, D26, D27, D28, D29, D30, D31: zener 3.6V; D_SOD-523
FB1: SDFL2012Q1R0KTF 0805; L_0805_2012Metric
H1, H2, H4, H5: MountingHole; MountingHole_3.2mm_M3
J1: MSD-4-A; MSD4A; Mouser Part Number 179-MSD-4-A
J3: USART6; JST_PH_B3B-PH-K_1x03_P2.00mm_Vertical
J15: Dashboard; IDC-Header_2x15_P2.54mm_Vertical
JP3: BTN1_AS_RST; SolderJumper-2_P1.3mm_Open_RoundedPad1.0x1.5mm
R1, R18, R19, R20, R21, R46, R48, R49, R50, R52, R60: 0R; R_0402_1005Metric
R3, R4, R10, R12, R14: 0R; R_0603_1608Metric_Pad0.98x0.95mm_HandSolder; not fitted
R5, R6, R8, R9, R11: 4k7; R_0402_1005Metric
R7, R110: 10k; R_0402_1005Metric
R15, R117, R119, R120, R121: 1k; R_0402_1005Metric
R113, R114: 22R; R_0402_1005Metric
SW1: RESET; SW_Tactile_SPST_NO_Straight_CK_PTS636Sx25SMTRLFS
SW3: BOOT0; SW_Tactile_SPST_NO_Straight_CK_PTS636Sx25SMTRLFS
U2: STM32H743ZITx; LQFP-144_20x20mm_P0.5mm
U3: SN74LVC4245APWR; TSSOP-24_4.4x7.8mm_P0.65mm
Y1: 8MHz X50328MSB2GI; Crystal_SMD_5032-2Pin_5.0x3.2mm
Y2: 32.768kHz Q13FC13500004; Crystal_SMD_3215-2Pin_3.2x1.5mm

Connections:
+3V3: C52.1, C102.1, C115.1, C116.1, C117.1, C118.1, C119.1, C120.1, C121.1, C122.1, C123.1, C124.1, C125.1, C126.1, C129.1, D1.2 (A), D16.2 (A), D17.2 (A), D18.2 (A), FB1.1, J1.4 (VDD), R5.2, R6.2, R8.2, R9.2, R11.2, R15.1, R110.1, SW3.2, U2.17 (VDD), U2.30 (VDD), U2.39 (VDD), U2.52 (VDD), U2.62 (VDD), U2.72 (VDD), U2.84 (VDD), U2.95 (VDD33_USB), U2.108 (VDD), U2.121 (VDD), U2.131 (VDD), U2.144 (VDD), U3.23 (V_{CCB}), U3.24 (V_{CCB}); also elsewhere on the board
+5V: C62.1, J15.21, J15.22, U3.1 (V_{CCA}); also elsewhere on the board
/24V_lowTrig: U2.7 (PC13); also elsewhere on the board
/24V_measureV: C13.1, D22.1 (K), U2.34 (PA0); also elsewhere on the board
/APPS1: C26.1, D31.1 (K), U2.21 (PF9); also elsewhere on the board
/APPS2: C14.1, D23.1 (K), U2.35 (PA1); also elsewhere on the board
/APPSmicro: U2.22 (PF10); also elsewhere on the board
/BL_PWM: R20.2, U2.127 (PG12)
/BOOT0: R7.2, SW3.1, U2.138 (BOOT0)
/FDCAN1_RX: U2.139 (PB8); also elsewhere on the board
/FDCAN1_TX: U2.140 (PB9); also elsewhere on the board
/FDCAN2_RX: U2.135 (PB5); also elsewhere on the board
/FDCAN2_TX: U2.136 (PB6); also elsewhere on the board
/I2C2_SCL: J15.1, U2.11 (PF1)
/I2C2_SDA: J15.2, U2.10 (PF0)
/I2C4_SCL: U2.81 (PD12); also elsewhere on the board
/I2C4_SDA: U2.82 (PD13); also elsewhere on the board
/I_measure_5v: R113.1; also elsewhere on the board
/I_measure_5vrpi: R114.1; also elsewhere on the board
/LCD_CS: R60.1, U2.122 (PD6)
/LCD_DC: R21.2, U2.125 (PG10)
/LCD_MISO: R52.1, U2.124 (PG9)
/LCD_MOSI: R46.2, U2.123 (PD7)
/LCD_SCK: R50.1, U2.126 (PG11)
/LED_B10: R117.1, U2.63 (PE10)
/LED_B11: R119.1, U2.64 (PE11)
/LED_B12: R120.1, U2.65 (PE12)
/LED_B13: R121.1, U2.66 (PE13)
/LED_CAN_ERR: U2.68 (PE15); also elsewhere on the board
/LED_CAN_RUN: U2.67 (PE14); also elsewhere on the board
/NRST: C12.1, JP3.1 (A), R15.2, SW1.2, U2.25 (NRST); also elsewhere on the board
/OSC32_IN: C24.1, U2.8 (PC14), Y2.1
/OSC32_OUT: C25.1, U2.9 (PC15), Y2.2
/OSC_IN: C22.1, U2.23 (PH0), Y1.1
/OSC_OUT: C23.1, U2.24 (PH1), Y1.2
/OilP_1: C20.1, D29.1 (K), U2.19 (PF7); also elsewhere on the board
/OilP_2: C21.1, D30.1 (K), U2.20 (PF8); also elsewhere on the board
/RTD light gate: U2.78 (PD9); also elsewhere on the board
/RTDlight: J15.24; also elsewhere on the board
/SDMMC1_CK: J1.5 (CLK), U2.113 (PC12)
/SDMMC1_CMD: J1.3 (CMD), R11.1, U2.116 (PD2)
/SDMMC1_D0: J1.7 (DAT0), R5.1, U2.98 (PC8)
/SDMMC1_D1: J1.8 (DAT1), R6.1, U2.99 (PC9)
/SDMMC1_D2: J1.1 (DAT2), R8.1, U2.111 (PC10)
/SDMMC1_D3: J1.2 (CD/DAT3), R9.1, U2.112 (PC11)
/SPI4_CS: R4.1, U2.3 (PE4), U3.19 (B3)
/SPI4_CS_5VTTL: J15.6, R4.2, U3.5 (A3)
/SPI4_LEDPWM: R14.1, U2.137 (PB7), U3.14 (B8)
/SPI4_LEDPWM_5VTTL: J15.4, R14.2, U3.10 (A8)
/SPI4_MISO: R10.1, U2.4 (PE5), U3.18 (B4)
/SPI4_MISO_5VTTL: R10.2, U3.6 (A4)
/SPI4_MOSI: R12.1, U2.5 (PE6), U3.17 (B5)
/SPI4_MOSI_5VTTL: J15.3, R12.2, U3.7 (A5)
/SPI4_SCK: R3.1, U2.1 (PE2), U3.20 (B2)
/SPI4_SCK_5VTTL: J15.5, R3.2, U3.4 (A2)
/TP_CS: R49.1, U2.132 (PG15)
/TP_IRQ: R1.1, U2.141 (PE0)
/TP_MISO: R48.1, U2.134 (PB4)
/TP_MOSI: R19.2, U2.129 (PG14)
/TP_SCK: R18.2, U2.133 (PB3)
/T_CLK: U2.109 (PA14); also elsewhere on the board
/T_DIO: U2.105 (PA13); also elsewhere on the board
/UART1_RX: U2.102 (PA10); also elsewhere on the board
/UART1_TX: U2.101 (PA9); also elsewhere on the board
/USART6_RX: J3.2, U2.97 (PC7)
/USART6_TX: J3.3, U2.96 (PC6)
/USBFS_D_N: U2.103 (PA11); also elsewhere on the board
/USBFS_D_P: U2.104 (PA12); also elsewhere on the board
/VBAT: U2.6 (VBAT); also elsewhere on the board
/VCAP1: C127.1, U2.71 (VCAP)
/VCAP2: C128.1, U2.106 (VCAP)
/VDDA_MCU: C8.1, C9.1, FB1.2, U2.32 (VREF+), U2.33 (VDDA)
/button1: U2.88 (PG3); also elsewhere on the board
/button2: U2.119 (PD5); also elsewhere on the board
/button3: U2.118 (PD4); also elsewhere on the board
/button4: U2.115 (PD1); also elsewhere on the board
/button5: U2.85 (PD14); also elsewhere on the board
/button6: U2.92 (PG7); also elsewhere on the board
/button7: U2.80 (PD11); also elsewhere on the board
/button_raw1: J15.23, JP3.2 (B); also elsewhere on the board
/button_raw2: J15.26; also elsewhere on the board
/button_raw3: J15.25; also elsewhere on the board
/button_raw4: J15.28; also elsewhere on the board
/button_raw5: J15.27; also elsewhere on the board
/button_raw6: J15.30; also elsewhere on the board
/button_raw7: J15.29; also elsewhere on the board
/buzzer_gate: U2.12 (PF2); also elsewhere on the board
/steering: C15.1, D24.1 (K), U2.36 (PA2); also elsewhere on the board
/susp_F1: C18.1, D27.1 (K), U2.15 (PF5); also elsewhere on the board
/susp_F2: C19.1, D28.1 (K), U2.18 (PF6); also elsewhere on the board
/susp_R1: C16.1, D25.1 (K), U2.13 (PF3); also elsewhere on the board
/susp_R2: C17.1, D26.1 (K), U2.14 (PF4); also elsewhere on the board
GND: C8.2, C9.2, C10.2, C11.2, C12.2, C13.2, C14.2, C15.2, C16.2, C17.2, C18.2, C19.2, C20.2, C21.2, C22.2, C23.2, C24.2, C25.2, C26.2, C52.2, C62.2, C102.2, C115.2, C116.2, C117.2, C118.2, C119.2, C120.2, C121.2, C122.2, C123.2, C124.2, C125.2, C126.2, C127.2, C128.2, C129.2, D22.2 (A), D23.2 (A), D24.2 (A), D25.2 (A), D26.2 (A), D27.2 (A), D28.2 (A), D29.2 (A), D30.2 (A), D31.2 (A), J1.6 (VSS), J1.G1 (GND_1), J1.G2 (GND_2), J1.G3 (GND_3), J1.G4 (GND_4), J3.1, J15.7, J15.13, J15.20, R7.1, SW1.1, U2.16 (VSS), U2.31 (VSSA), U2.38 (VSS), U2.51 (VSS), U2.61 (VSS), U2.83 (VSS), U2.94 (VSS), U2.107 (VSS), U2.120 (VSS), U2.130 (VSS), U3.2 (DIR), U3.11 (GND), U3.12 (GND), U3.13 (GND), U3.15 (B7), U3.16 (B6), U3.21 (B1), U3.22 (~OE); also elsewhere on the board
unnamed: D1.1 (K), R117.2
unnamed: D16.1 (K), R119.2
unnamed: D17.1 (K), R120.2
unnamed: D18.1 (K), R121.2
unnamed: J15.8, R1.2
unnamed: J15.9, R48.2
unnamed: J15.10, R18.1
unnamed: J15.11, R49.2
unnamed: J15.12, R19.1
unnamed: J15.14, R20.1
unnamed: J15.15, R50.2
unnamed: J15.16, R21.1
unnamed: J15.17, R52.2
unnamed: J15.18, R46.1
unnamed: J15.19, R60.2
unnamed: R110.2, U2.143 (PDR_ON)
unnamed: C10.1, R113.2, U2.50 (PF12)
unnamed: C11.1, R114.2, U2.53 (PF13)

Notes on the sheet:
INT
ADC
BOOT0
NRST
gnd
orange color are the original pinout from VCU Ver2.0
V3.0 move mounting point out a little remove HSUSB remove brake light change conn pinout to match dashboard V1.0 add CAN2 add some LEDs etc.
TIM
SDMMC
reference: 32F746GDISCOVERY
(20pF load - 5pF parasitics) *2 = 30pF (12.5pF - 5pF ) *2 = about 15 pF
red label is onbaord modification of Ver2.0
because the SPI asigned to LCD cannot use DMA hence have to switch pins with TP Pinout midification are required Modified pins are marked in red next to the pins that are required to change. Including MISO, MOSI and SCK of LCD and TP SPIs 6 pins in total are modified. Onboard modification is also r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

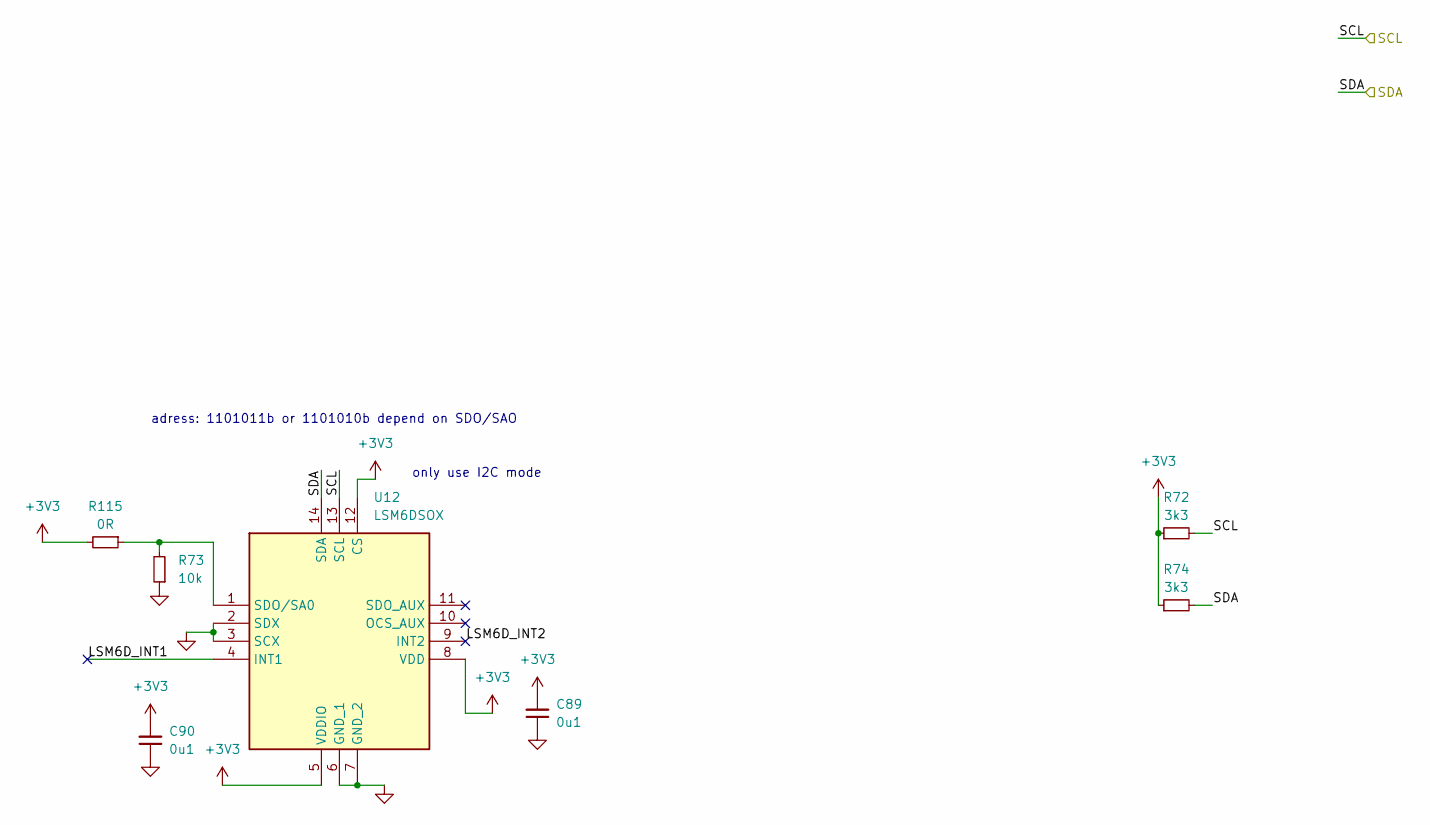
[picture p44: schematic IMU.kicad_sch, VCU]

Parts:
C89, C90: 0u1; C_0402_1005Metric
R72, R74: 3k3; R_0402_1005Metric
R73: 10k; R_0402_1005Metric
R115: 0R; R_0402_1005Metric
U12: LSM6DSOX; LGA-14_3x2.5mm_P0.5mm_LayoutBorder3x4y; Mouser Part Number 511-LSM6DSOXTR

Connections:
+3V3: C89.2, C90.2, R72.1, R74.1, R115.2, U12.5 (VDDIO), U12.8 (VDD), U12.12 (CS); also elsewhere on the board
/I2C4_SCL: R72.2, U12.13 (SCL); also elsewhere on the board
/I2C4_SDA: R74.2, U12.14 (SDA); also elsewhere on the board
/IMU/LSM6D_INT1: U12.4 (INT1)
/IMU/LSM6D_INT2: U12.9 (INT2)
GND: C89.1, C90.1, R73.1, U12.2 (SDX), U12.3 (SCX), U12.6 (GND_1), U12.7 (GND_2); also elsewhere on the board
unnamed: R73.2, R115.1, U12.1 (SDO/SA0)

Notes on the sheet:
adress: 1101011b or 1101010b depend on SDO/SAO
only use I2C mode

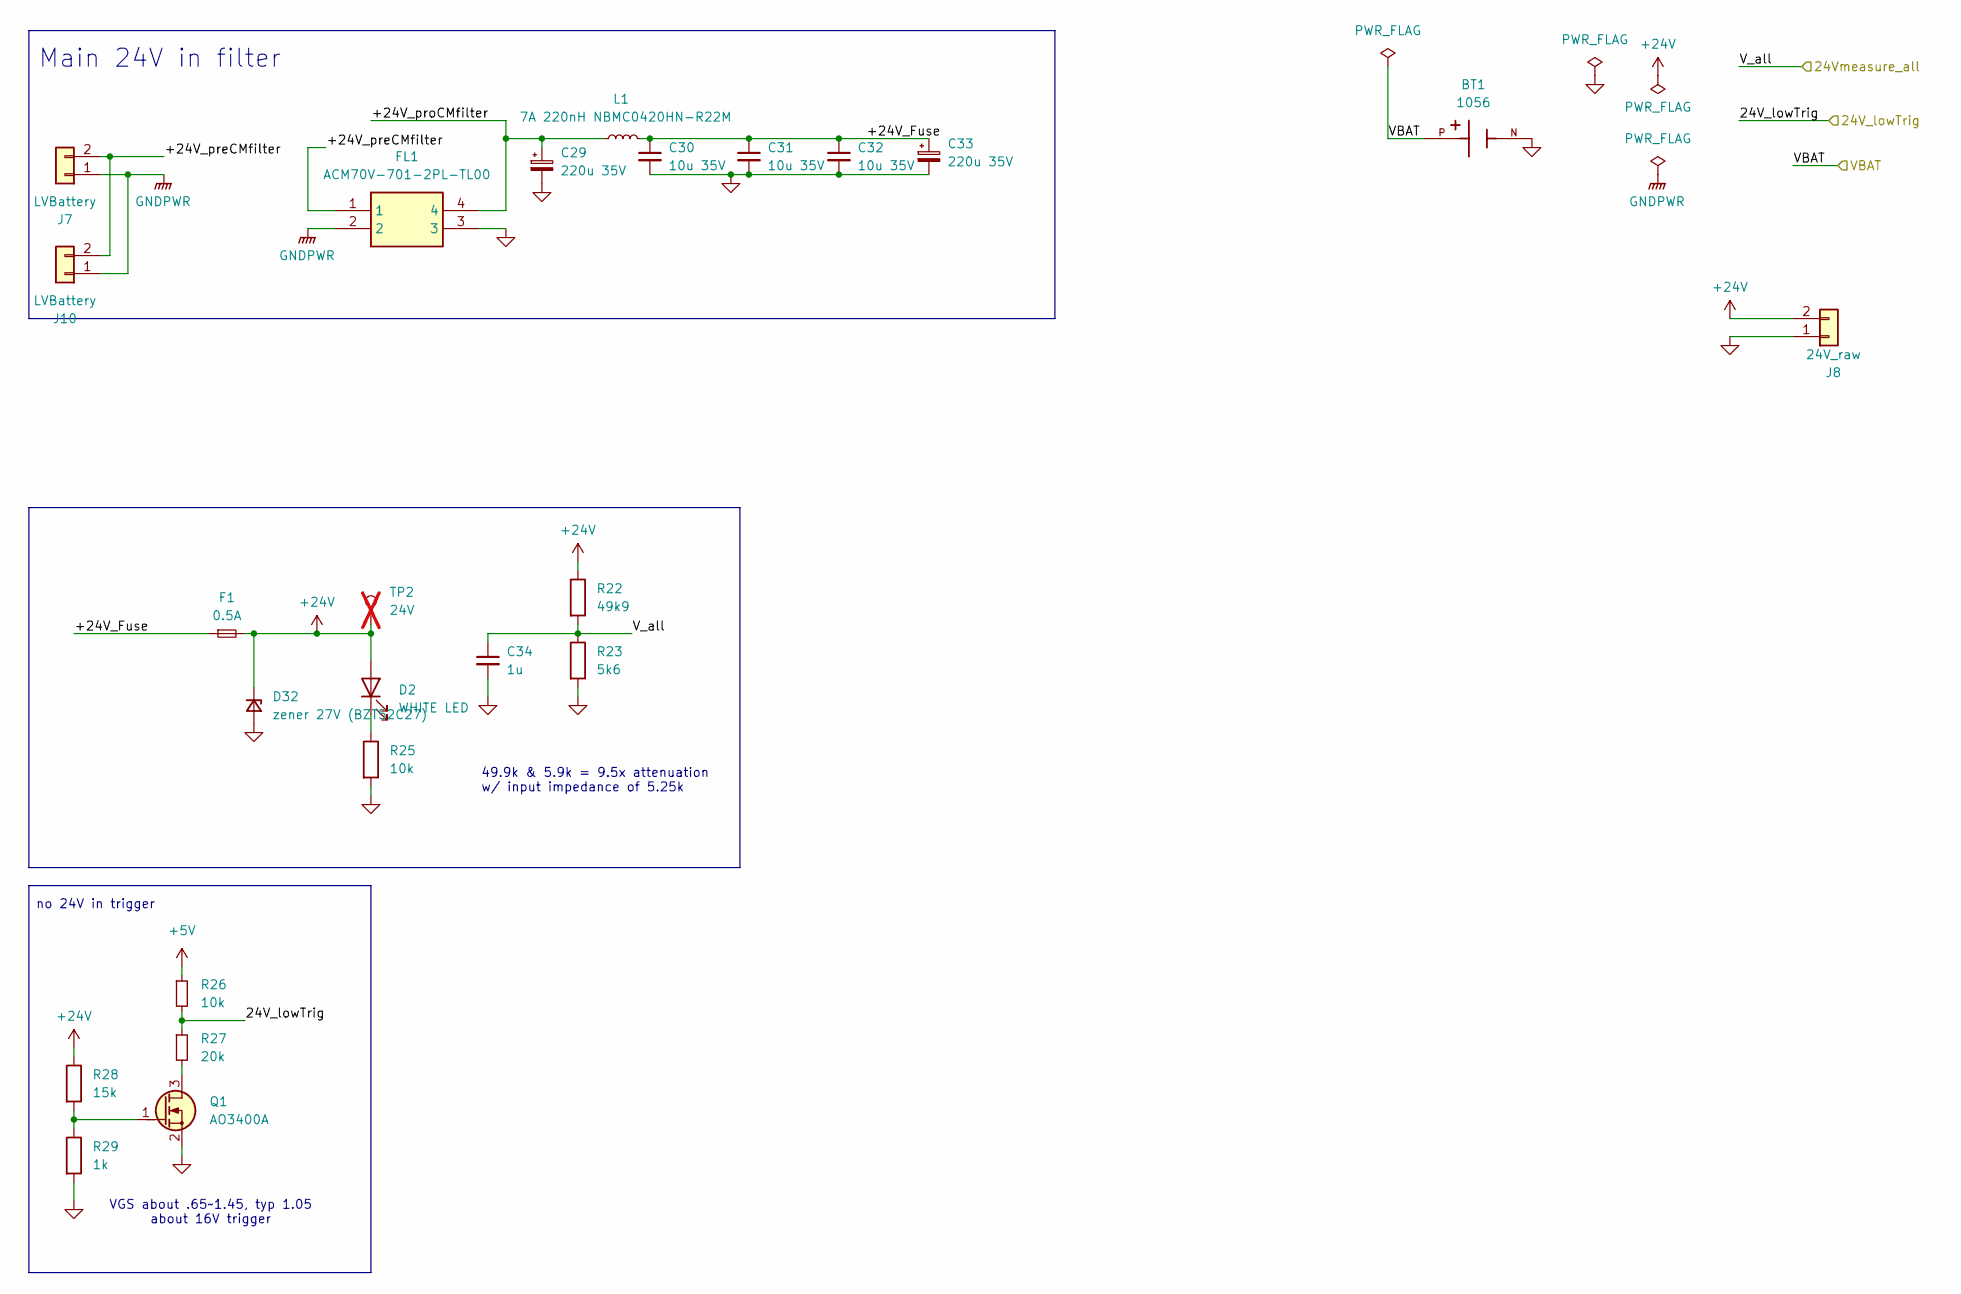
[picture p45: schematic power.kicad_sch, VCU]

Parts:
BT1: 1056; BAT_1056; PARTREV D
C29, C33: 220u 35V; CP_Radial_D8.0mm_P3.80mm
C30, C31, C32: 10u 35V; C_1206_3216Metric
C34: 1u; C_0402_1005Metric
D2: WHITE LED; LED_0603_1608Metric
D32: zener 27V (BZT52C27); D_SOD-123
F1: 0.5A; Fuse_1206_3216Metric
FL1: ACM70V-701-2PL-TL00; ACM70V7012PLTL00; Mouser Part Number 810-ACM70V7012PLTL00
J7, J10: LVBattery; JST_XH_B2B-XH-A_1x02_P2.50mm_Vertical
J8: 24V_raw; JST_XH_B2B-XH-A_1x02_P2.50mm_Vertical
L1: 7A 220nH NBMC0420HN-R22M; L_Ferrocore_DLG-0403
Q1: AO3400A; SOT-23
R22: 49k9; R_0402_1005Metric
R23: 5k6; R_0402_1005Metric
R25, R26: 10k; R_0402_1005Metric
R27: 20k; R_0402_1005Metric
R28: 15k; R_0402_1005Metric
R29: 1k; R_0402_1005Metric
TP2: 24V; TestPoint_Pad_D1.0mm; not fitted

Connections:
+5V: R26.1; also elsewhere on the board
+24V: D2.2 (A), D32.1 (K), F1.2, J8.2, R22.1, R28.1, TP2.1; also elsewhere on the board
/24V_lowTrig: R26.2, R27.1; also elsewhere on the board
/24V_measureV: C34.1, R22.2, R23.1; also elsewhere on the board
/VBAT: BT1.P; also elsewhere on the board
/power/+24V_Fuse: C30.1, C31.1, C32.1, C33.1, F1.1, L1.2
/power/+24V_preCMfilter: FL1.1, J7.2, J10.2
/power/+24V_proCMfilter: C29.1, FL1.4, L1.1
GND: BT1.N, C29.2, C30.2, C31.2, C32.2, C33.2, C34.2, D32.2 (A), FL1.3, J8.1, Q1.2 (S), R23.2, R25.2, R29.2; also elsewhere on the board
GNDPWR: FL1.2, J7.1, J10.1
unnamed: D2.1 (K), R25.1
unnamed: Q1.3 (D), R27.2
unnamed: Q1.1 (G), R28.2, R29.1

Notes on the sheet:
no 24V in trigger
49.9k & 5.9k = 9.5x attenuation w/ input impedance of 5.25k
Main 24V in filter
VGS about .65~1.45, typ 1.05 about 16V trigger

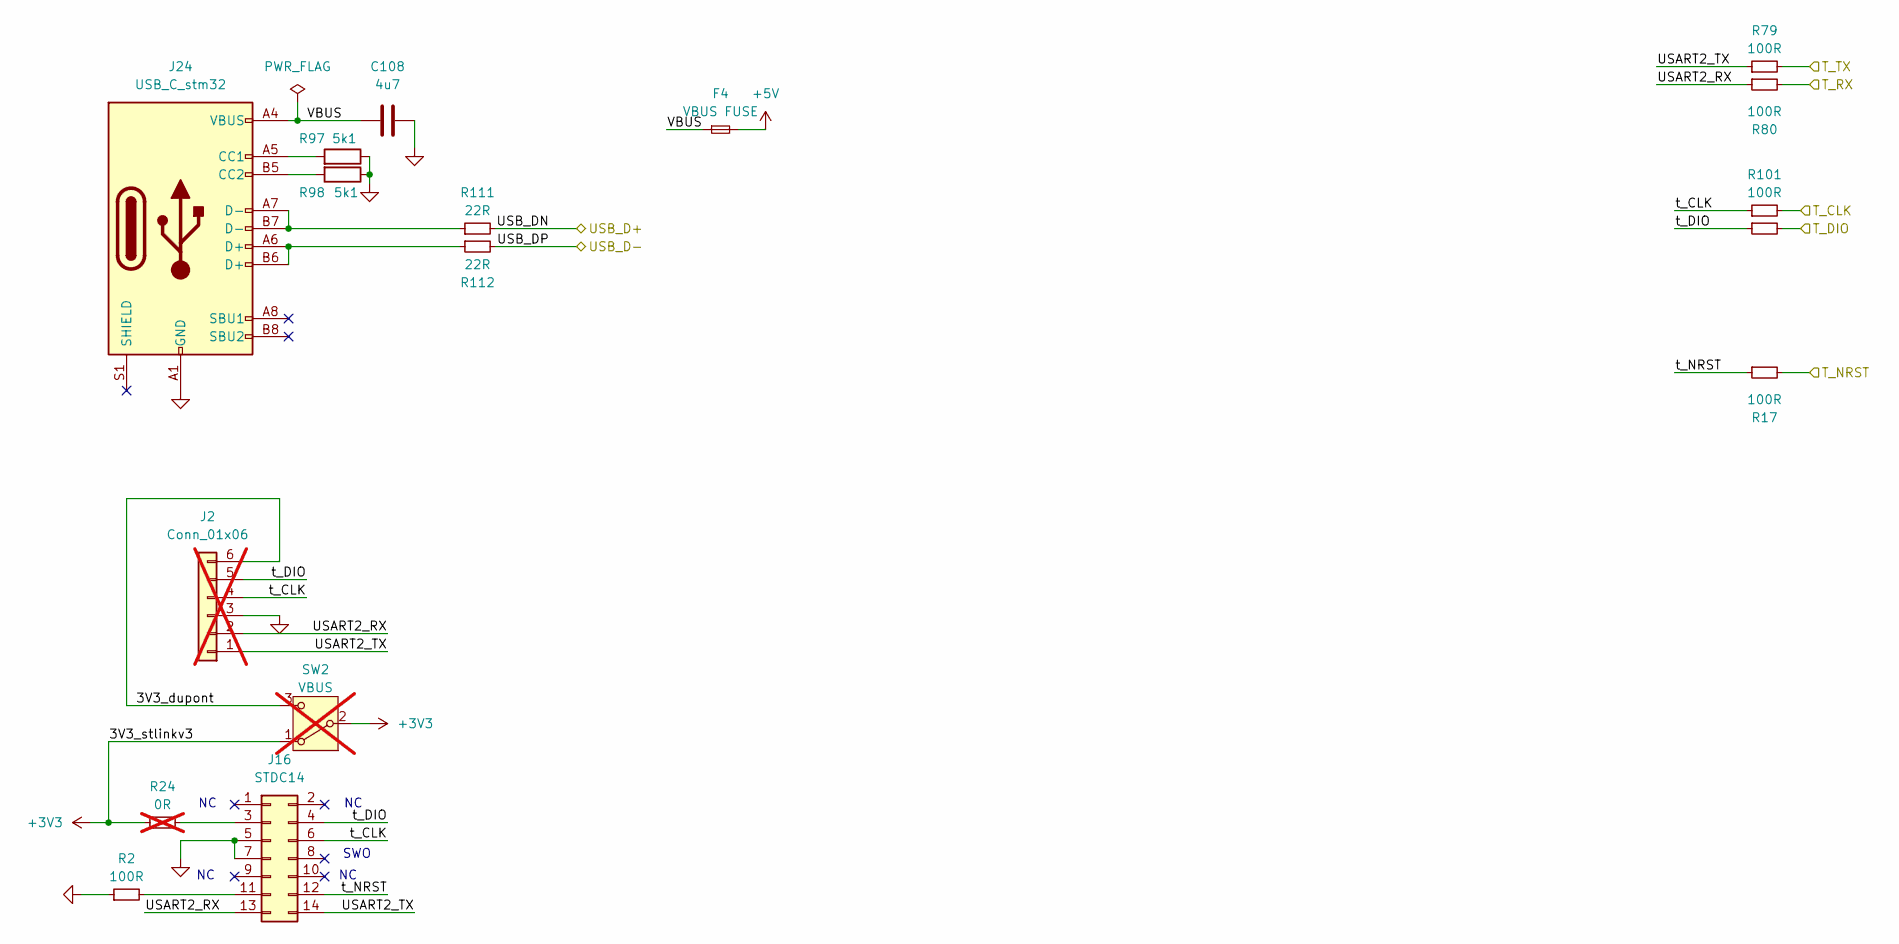
[picture p46: schematic stlink.kicad_sch, VCU]

Parts:
C108: 4u7; C_0402_1005Metric
F4: VBUS FUSE; Fuse_1206_3216Metric
J2: Conn_01x06; PinHeader_1x06_P2.54mm_Horizontal; not fitted
J16: STDC14; box_header_14P_pitch127
J24: USB_C_stm32; USB_C_Receptacle_GCT_USB4105-xx-A_16P_TopMnt_Horizontal
R2, R17, R79, R80, R101, R105: 100R; R_0402_1005Metric
R24: 0R; R_0402_1005Metric; not fitted
R97, R98: 5k1; R_0402_1005Metric
R111, R112: 22R; R_0402_1005Metric
SW2: VBUS; PinHeader_1x03_P2.54mm_Vertical; not fitted

Connections:
+3V3: R24.1, SW2.1 (A), SW2.2 (B); also elsewhere on the board
+5V: F4.2; also elsewhere on the board
/NRST: R17.2; also elsewhere on the board
/T_CLK: R101.2; also elsewhere on the board
/T_DIO: R105.2; also elsewhere on the board
/UART1_RX: R80.2; also elsewhere on the board
/UART1_TX: R79.2; also elsewhere on the board
/USBFS_D_N: R111.2; also elsewhere on the board
/USBFS_D_P: R112.2; also elsewhere on the board
/stlink & USB/USART2_RX: J2.2, J16.13, R80.1
/stlink & USB/USART2_TX: J2.1, J16.14, R79.1
/stlink & USB/VBUS: C108.1, F4.1, J24.A4 (VBUS), J24.A9 (VBUS), J24.B4 (VBUS), J24.B9 (VBUS)
/stlink & USB/t_CLK: J2.4, J16.6, R101.1
/stlink & USB/t_DIO: J2.5, J16.4, R105.1
/stlink & USB/t_NRST: J16.12, R17.1
GND: C108.2, J2.3, J16.5, J16.7, J24.A1 (GND), J24.A12 (GND), J24.B1 (GND), J24.B12 (GND), R2.1, R97.1, R98.1; also elsewhere on the board
unnamed: J2.6, SW2.3 (C)
unnamed: J16.3, R24.2
unnamed: J16.11, R2.2
unnamed: J24.A5 (CC1), R97.2
unnamed: J24.B5 (CC2), R98.2
unnamed: J24.A6 (D+), J24.B6 (D+), R112.1
unnamed: J24.A7 (D-), J24.B7 (D-), R111.1

Notes on the sheet:
SWO
