NTURacingTeam/nturt_kicad/EP6/Electrical_Group/VCU/VCU.kicad_pcb

## KiCad design EP6/Electrical_Group/VCU/VCU.kicad_pcb (continued)

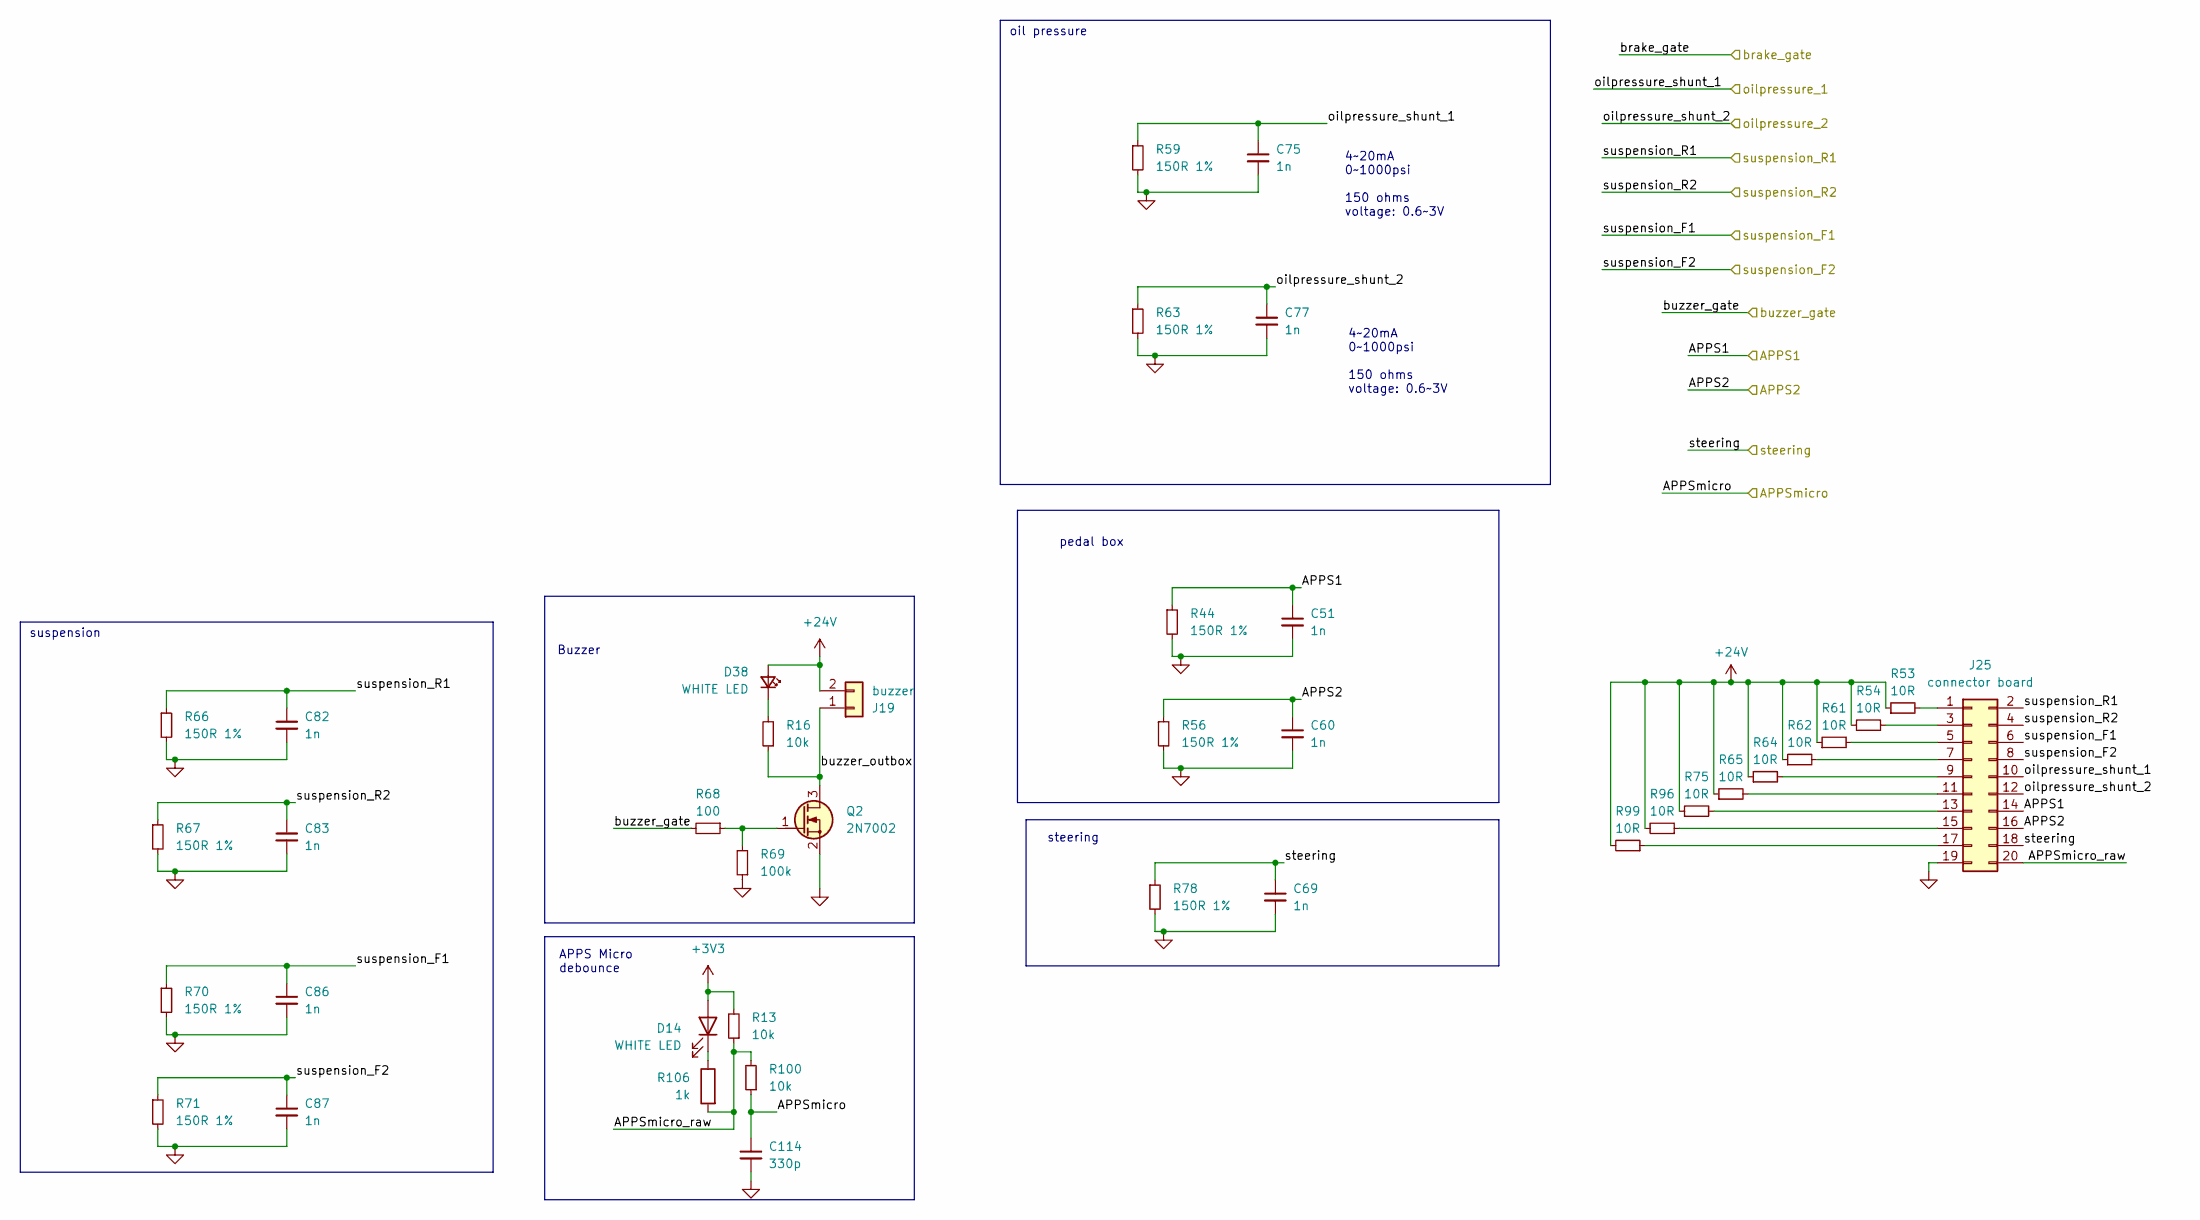
[picture p47: schematic electrical2.kicad_sch, VCU]

Parts:
C51, C60, C69, C75, C77, C82, C83, C86, C87: 1n; C_0402_1005Metric
C114: 330p; C_0402_1005Metric
D14, D38: WHITE LED; LED_0603_1608Metric
J19: buzzer; JST_XH_B2B-XH-A_1x02_P2.50mm_Vertical
J25: connector board; IDC-Header_2x10_P2.54mm_Vertical
Q2: 2N7002; SOT-23
R13, R16, R100: 10k; R_0402_1005Metric
R44, R56, R59, R63, R66, R67, R70, R71, R78: 150R 1%; R_0603_1608Metric
R53, R54, R61, R62, R64, R65, R75, R96, R99: 10R; R_0603_1608Metric
R68: 100; R_0402_1005Metric
R69: 100k; R_0402_1005Metric
R106: 1k; R_0402_1005Metric

Connections:
+3V3: D14.2 (A), R13.2; also elsewhere on the board
+24V: D38.2 (A), J19.2, R53.1, R54.1, R61.1, R62.1, R64.1, R65.1, R75.1, R96.2, R99.2; also elsewhere on the board
/APPS1: C51.1, J25.14, R44.1; also elsewhere on the board
/APPS2: C60.1, J25.16, R56.1; also elsewhere on the board
/APPSmicro: C114.1, R100.1; also elsewhere on the board
/OilP_1: C75.1, J25.10, R59.1; also elsewhere on the board
/OilP_2: C77.1, J25.12, R63.1; also elsewhere on the board
/buzzer_gate: R68.2; also elsewhere on the board
/electrical2/APPSmicro_raw: J25.20, R13.1, R100.2, R106.2
/electrical2/buzzer_outbox: J19.1, Q2.3 (D), R16.1
/steering: C69.1, J25.18, R78.1; also elsewhere on the board
/susp_F1: C86.1, J25.6, R70.1; also elsewhere on the board
/susp_F2: C87.1, J25.8, R71.1; also elsewhere on the board
/susp_R1: C82.1, J25.2, R66.1; also elsewhere on the board
/susp_R2: C83.1, J25.4, R67.1; also elsewhere on the board
GND: C51.2, C60.2, C69.2, C75.2, C77.2, C82.2, C83.2, C86.2, C87.2, C114.2, J25.19, Q2.2 (S), R44.2, R56.2, R59.2, R63.2, R66.2, R67.2, R69.1, R70.2, R71.2, R78.2; also elsewhere on the board
unnamed: D14.1 (K), R106.1
unnamed: D38.1 (K), R16.2
unnamed: J25.1, R53.2
unnamed: J25.3, R54.2
unnamed: J25.5, R61.2
unnamed: J25.7, R62.2
unnamed: J25.9, R64.2
unnamed: J25.11, R65.2
unnamed: J25.13, R75.2
unnamed: J25.15, R96.1
unnamed: J25.17, R99.1
unnamed: Q2.1 (G), R68.1, R69.2

Notes on the sheet:
steering
pedal box
4~20mA 0~1000psi 150 ohms voltage: 0.6~3V
Buzzer
suspension
oil pressure
APPS Micro debounce

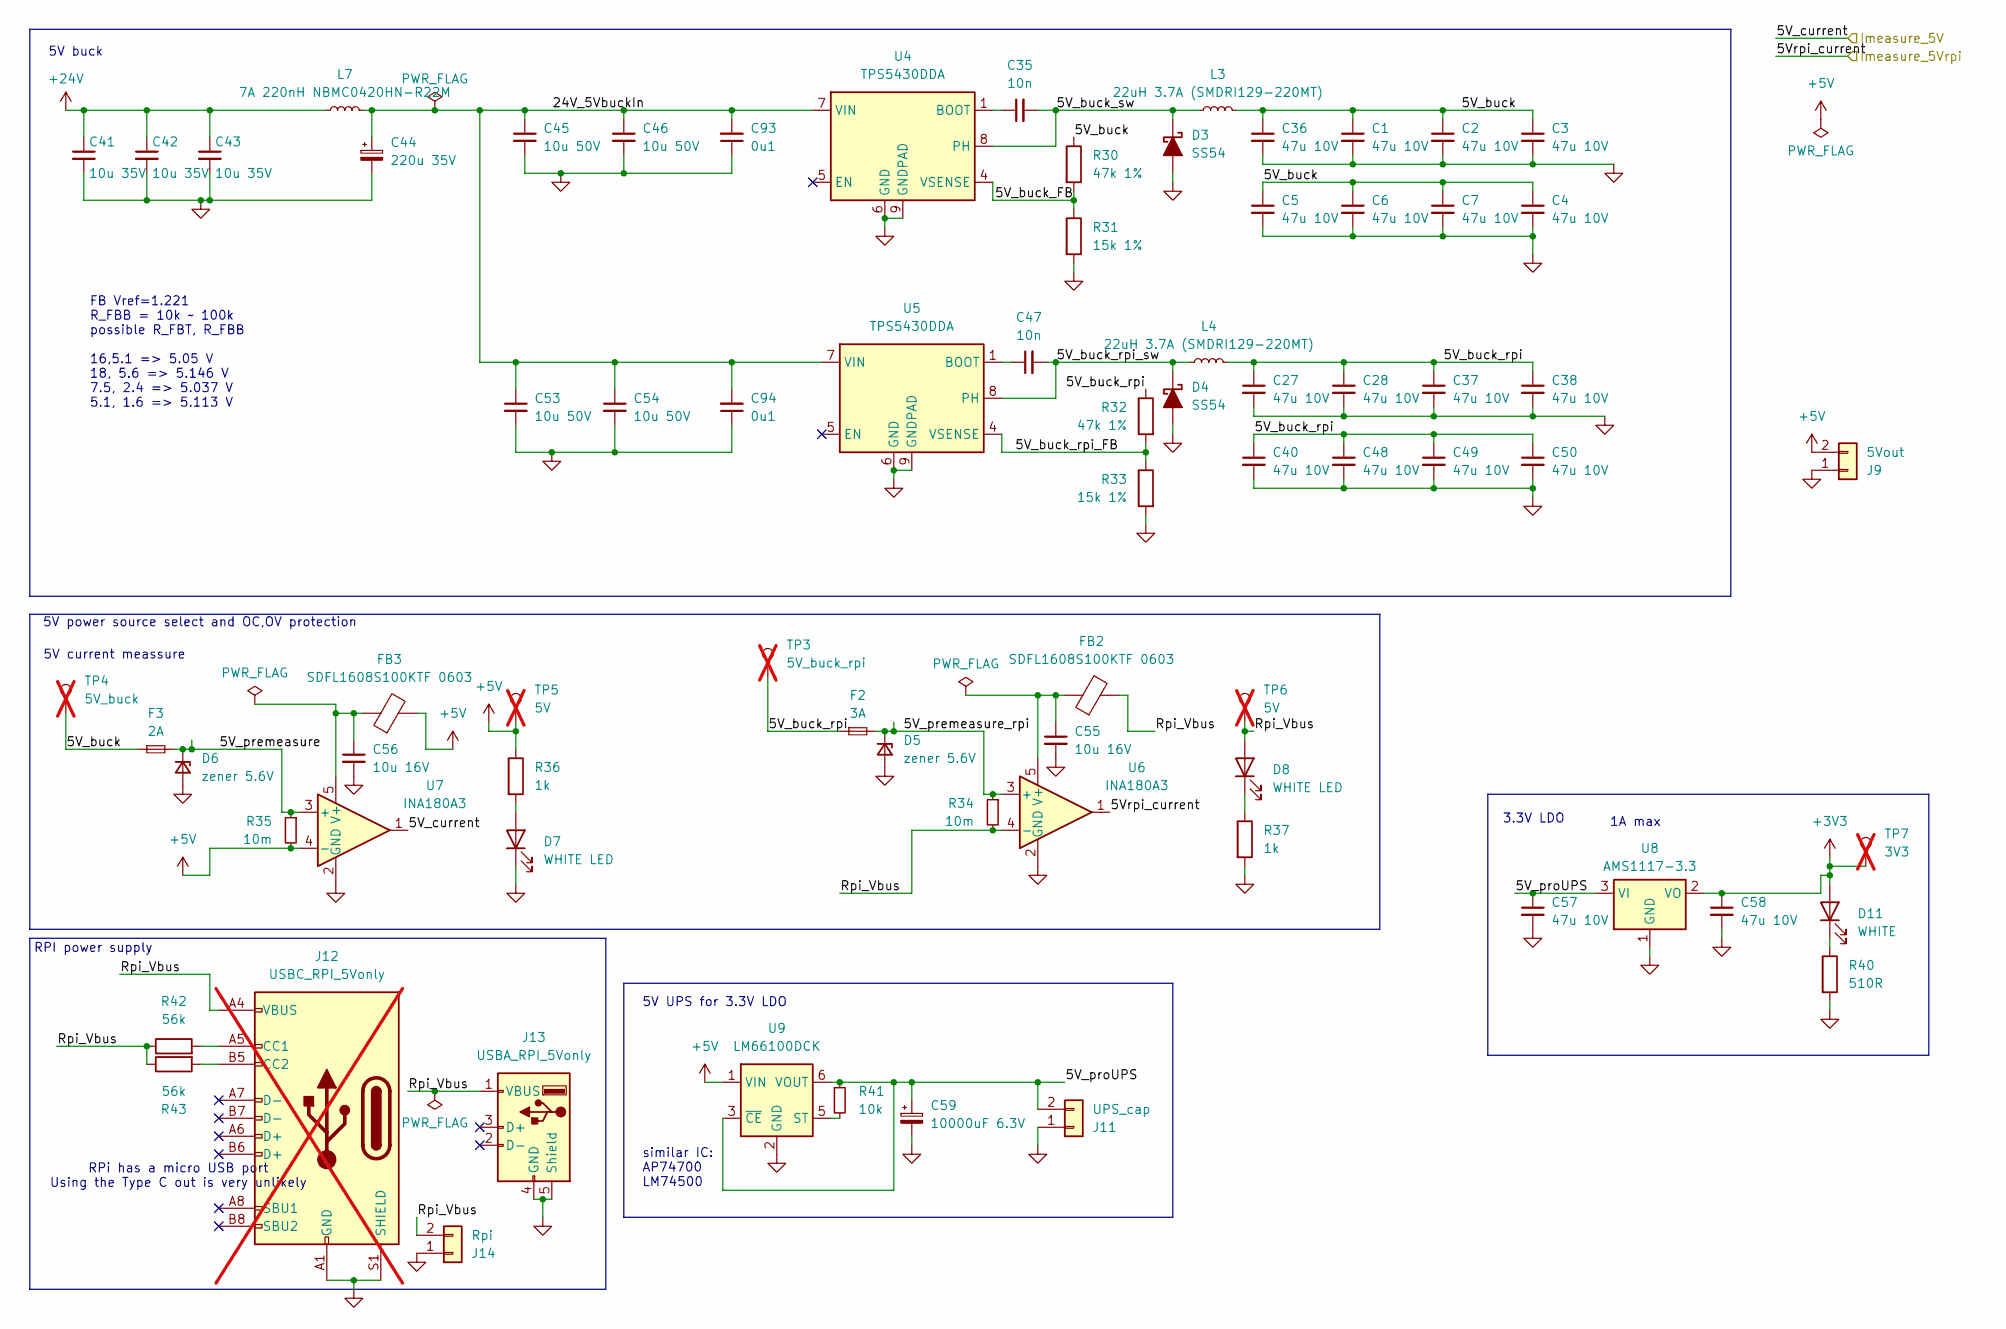
[picture p48: schematic 5V_3V3.kicad_sch, VCU]

Parts:
C1, C2, C3, C4, C5, C6, C7, C27, C28, C36, C37, C38, C40, C48, C49, C50, C57, C58: 47u 10V; C_1206_3216Metric
C35, C47: 10n; C_0603_1608Metric
C41, C42, C43: 10u 35V; C_1206_3216Metric
C44: 220u 35V; CP_Radial_D8.0mm_P3.80mm
C45, C46, C53, C54: 10u 50V; C_1206_3216Metric
C55, C56: 10u 16V; C_0603_1608Metric
C59: 10000uF 6.3V; CP_Radial_D10.0mm_P5.00mm
C93, C94: 0u1; C_0603_1608Metric
D3, D4: SS54; D_SMA
D5: zener 5.6V; D_SMB
D6: zener 5.6V; D_SOD-123
D7, D8: WHITE LED; LED_0603_1608Metric
D11: WHITE; LED_0603_1608Metric
F2: 3A; Fuse_1206_3216Metric
F3: 2A; Fuse_1206_3216Metric
FB2, FB3: SDFL1608S100KTF 0603; L_0603_1608Metric
J9: 5Vout; JST_XH_B2B-XH-A_1x02_P2.50mm_Vertical
J11: UPS_cap; JST_PH_B2B-PH-K_1x02_P2.00mm_Vertical
J12: USBC_RPI_5Vonly; USB_C_Receptacle_GCT_USB4105-xx-A_16P_TopMnt_Horizontal; not fitted
J13: USBA_RPI_5Vonly; USB_A_Molex_67643_Horizontal
J14: Rpi; JST_XH_B2B-XH-A_1x02_P2.50mm_Vertical
L3, L4: 22uH 3.7A (SMDRI129-220MT); L_Bourns_SRR1260
L7: 7A 220nH NBMC0420HN-R22M; L_Ferrocore_DLG-0403
R30, R32: 47k 1%; R_0603_1608Metric
R31, R33: 15k 1%; R_0603_1608Metric
R34, R35: 10m; R_1206_3216Metric
R36, R37: 1k; R_0402_1005Metric
R40: 510R; R_0402_1005Metric
R41: 10k; R_0402_1005Metric
R42, R43: 56k; R_0402_1005Metric
TP3: 5V_buck_rpi; TestPoint_Pad_D1.0mm; not fitted
TP4: 5V_buck; TestPoint_Pad_D1.0mm; not fitted
TP5, TP6: 5V; TestPoint_Pad_D1.0mm; not fitted
TP7: 3V3; TestPoint_Pad_D1.0mm; not fitted
U4, U5: TPS5430DDA; TI_SO-PowerPAD-8_ThermalVias
U6, U7: INA180A3; SOT-23-5
U8: AMS1117-3.3; SOT-223-3_TabPin2
U9: LM66100DCK; SOT-363_SC-70-6

Connections:
+3V3: C58.1, D11.2 (A), TP7.1, U8.2 (VO); also elsewhere on the board
+5V: FB3.2, J9.2, R35.2, R36.1, TP5.1, U7.4 (-), U9.1 (VIN); also elsewhere on the board
+24V: C41.1, C42.1, C43.1, L7.1; also elsewhere on the board
/5V_3V3/5V_buck: C1.1, C2.1, C3.1, C4.1, C5.1, C6.1, C7.1, C36.1, F3.1, L3.2, R30.1, TP4.1
/5V_3V3/5V_buck_FB: R30.2, R31.1, U4.4 (VSENSE)
/5V_3V3/5V_buck_rpi: C27.1, C28.1, C37.1, C38.1, C40.1, C48.1, C49.1, C50.1, F2.1, L4.2, R32.1, TP3.1
/5V_3V3/5V_buck_rpi_FB: R32.2, R33.1, U5.4 (VSENSE)
/5V_3V3/5V_buck_rpi_sw: C47.2, D4.1 (K), L4.1, U5.8 (PH)
/5V_3V3/5V_buck_sw: C35.2, D3.1 (K), L3.1, U4.8 (PH)
/5V_3V3/5V_premeasure: D6.1 (K), F3.2, R35.1, U7.3 (+)
/5V_3V3/5V_premeasure_rpi: D5.1 (K), F2.2, R34.1, U6.3 (+)
/5V_3V3/5V_proUPS: C57.1, C59.1, J11.2, R41.1, U8.3 (VI), U9.3 (~CE), U9.6 (VOUT)
/5V_3V3/24V_5VbuckIn: C44.1, C45.1, C46.1, C53.1, C54.1, C93.2, C94.2, L7.2, U4.7 (VIN), U5.7 (VIN)
/5V_3V3/Rpi_Vbus: D8.2 (A), FB2.2, J12.A4 (VBUS), J12.A9 (VBUS), J12.B4 (VBUS), J12.B9 (VBUS), J13.1 (VBUS), J14.2, R34.2, R42.1, R43.1, TP6.1, U6.4 (-)
/I_measure_5v: U7.1; also elsewhere on the board
/I_measure_5vrpi: U6.1; also elsewhere on the board
GND: C1.2, C2.2, C3.2, C4.2, C5.2, C6.2, C7.2, C27.2, C28.2, C36.2, C37.2, C38.2, C40.2, C41.2, C42.2, C43.2, C44.2, C45.2, C46.2, C48.2, C49.2, C50.2, C53.2, C54.2, C55.2, C56.2, C57.2, C58.2, C59.2, C93.1, C94.1, D3.2 (A), D4.2 (A), D5.2 (A), D6.2 (A), D7.1 (K), J9.1, J11.1, J12.A1 (GND), J12.A12 (GND), J12.B1 (GND), J12.B12 (GND), J12.S1 (SHIELD), J13.4 (GND), J13.5 (Shield), J14.1, R31.2, R33.2, R37.2, R40.2, U4.6 (GND), U4.9 (GNDPAD), U5.6 (GND), U5.9 (GNDPAD), U6.2 (GND), U7.2 (GND), U8.1 (GND), U9.2 (GND); also elsewhere on the board
unnamed: D7.2 (A), R36.2
unnamed: D8.1 (K), R37.1
unnamed: D11.1 (K), R40.1
unnamed: J12.A5 (CC1), R42.2
unnamed: J12.B5 (CC2), R43.2
unnamed: C35.1, U4.1 (BOOT)
unnamed: C47.1, U5.1 (BOOT)
unnamed: C55.1, FB2.1, U6.5 (V+)
unnamed: C56.1, FB3.1, U7.5 (V+)
unnamed: R41.2, U9.5 (ST)

Notes on the sheet:
5V UPS for 3.3V LDO
5V power source select and OC,OV protection
RPI power supply
RPi has a micro USB port Using the Type C out is very unlikely
3.3V LDO
5V buck
5V current meassure
FB Vref=1.221 R_FBB = 10k ~ 100k possible R_FBT, R_FBB 16,5.1 => 5.05 V 18, 5.6 => 5.146 V 7.5, 2.4 => 5.037 V 5.1, 1.6 => 5.113 V
1A max
similar IC: AP74700 LM74500

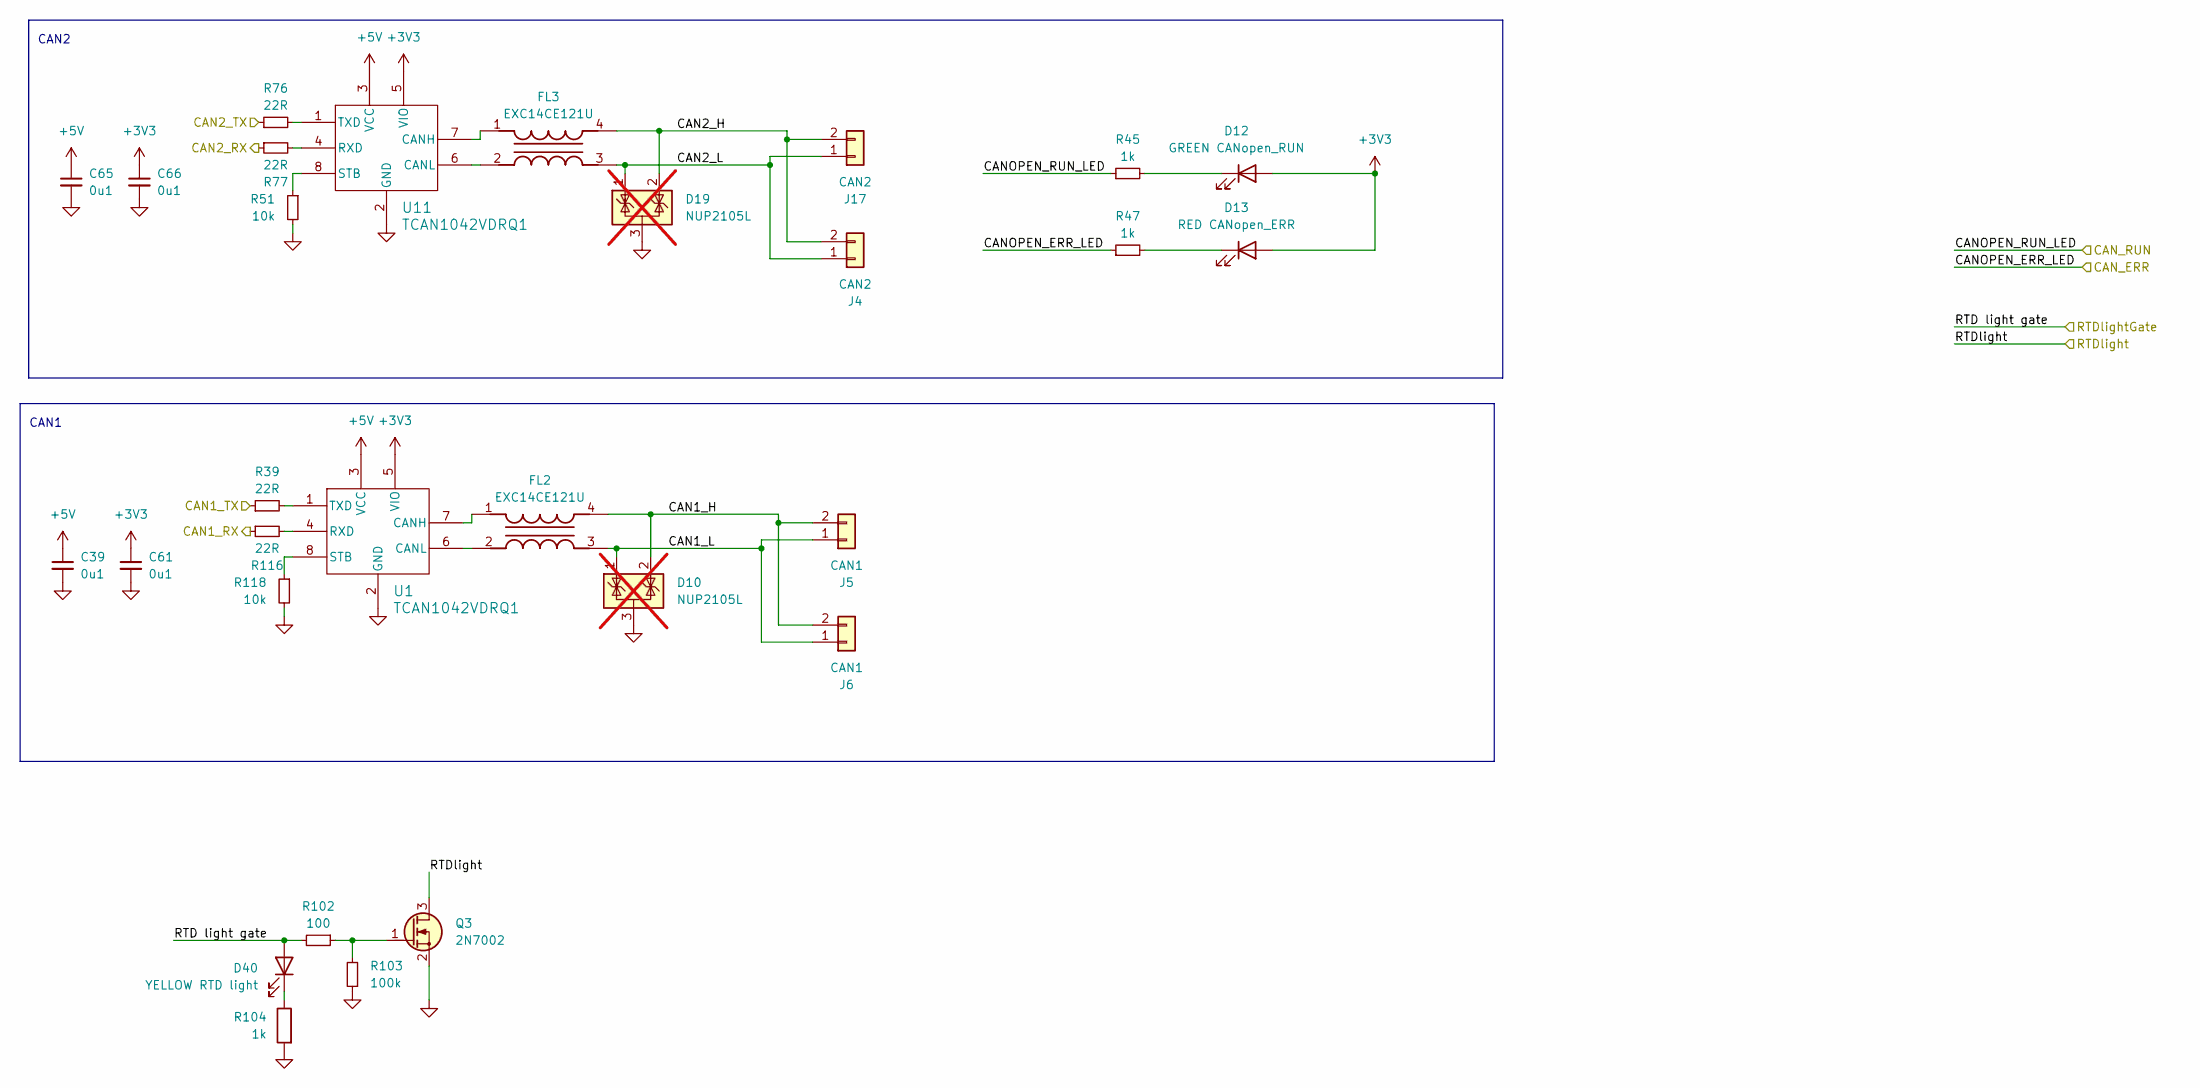
[picture p49: schematic electrical1.kicad_sch, VCU]

Parts:
C39, C61, C65, C66: 0u1; C_0402_1005Metric
D10, D19: NUP2105L; SOT-23; not fitted
D12: GREEN CANopen_RUN; LED_0603_1608Metric
D13: RED CANopen_ERR; LED_0603_1608Metric
D40: YELLOW RTD light; LED_0603_1608Metric
FL2, FL3: EXC14CE121U; EXCX4CE900U; Mouser Part Number 667-EXC-X4CE900U
J4, J17: CAN2; JST_XH_B2B-XH-A_1x02_P2.50mm_Vertical
J5, J6: CAN1; JST_XH_B2B-XH-A_1x02_P2.50mm_Vertical
Q3: 2N7002; SOT-23
R39, R76, R77, R116: 22R; R_0402_1005Metric
R45, R47, R104: 1k; R_0402_1005Metric
R51, R118: 10k; R_0402_1005Metric
R102: 100; R_0402_1005Metric
R103: 100k; R_0402_1005Metric
U1, U11: TCAN1042VDRQ1; SOIC-8_3.9x4.9mm_P1.27mm

Connections:
+3V3: C61.1, C66.1, D12.2 (A), D13.2 (A), U1.5 (VIO), U11.5 (VIO); also elsewhere on the board
+5V: C39.1, C65.1, U1.3 (VCC), U11.3 (VCC); also elsewhere on the board
/FDCAN1_RX: R116.1; also elsewhere on the board
/FDCAN1_TX: R39.1; also elsewhere on the board
/FDCAN2_RX: R76.1; also elsewhere on the board
/FDCAN2_TX: R77.1; also elsewhere on the board
/LED_CAN_ERR: R47.1; also elsewhere on the board
/LED_CAN_RUN: R45.1; also elsewhere on the board
/RTD light gate: D40.2 (A), R102.2; also elsewhere on the board
/RTDlight: Q3.3 (D); also elsewhere on the board
/electrical1/CAN1_H: D10.2 (K), FL2.4, J5.2, J6.2
/electrical1/CAN1_L: D10.1 (K), FL2.3, J5.1, J6.1
/electrical1/CAN2_H: D19.2 (K), FL3.4, J4.2, J17.2
/electrical1/CAN2_L: D19.1 (K), FL3.3, J4.1, J17.1
GND: C39.2, C61.2, C65.2, C66.2, D10.3 (A), D19.3 (A), Q3.2 (S), R51.2, R103.1, R104.2, R118.2, U1.2 (GND), U11.2 (GND); also elsewhere on the board
unnamed: D12.1 (K), R45.2
unnamed: D13.1 (K), R47.2
unnamed: D40.1 (K), R104.1
unnamed: Q3.1 (G), R102.1, R103.2
unnamed: FL2.1, U1.7 (CANH)
unnamed: FL2.2, U1.6 (CANL)
unnamed: R116.2, U1.4 (RXD)
unnamed: R118.1, U1.8 (STB)
unnamed: R39.2, U1.1 (TXD)
unnamed: FL3.1, U11.7 (CANH)
unnamed: FL3.2, U11.6 (CANL)
unnamed: R77.2, U11.4 (RXD)
unnamed: R51.1, U11.8 (STB)
unnamed: R76.2, U11.1 (TXD)

Notes on the sheet:
CAN1
CAN2

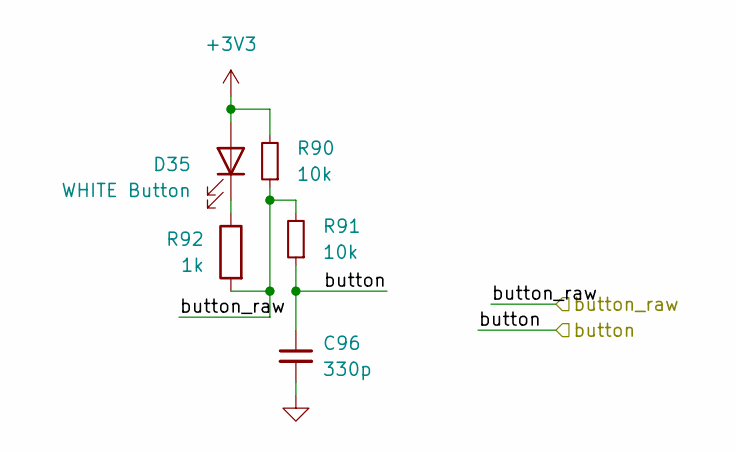
[picture p50: schematic button.kicad_sch, VCU]

Parts:
C96: 330p; C_0402_1005Metric
D35: WHITE Button; LED_0603_1608Metric
R90, R91: 10k; R_0402_1005Metric
R92: 1k; R_0402_1005Metric

Connections:
+3V3: D35.2 (A), R90.2; also elsewhere on the board
/button5: C96.1, R91.1; also elsewhere on the board
/button_raw5: R90.1, R91.2, R92.2; also elsewhere on the board
GND: C96.2; also elsewhere on the board
unnamed: D35.1 (K), R92.1

Parts of its further copies:
C68, C71, C72, C95, C97, C101: 330p; C_0402_1005Metric
D15, D20, D33, D34, D36, D37: WHITE Button; LED_0603_1608Metric
R55, R57, R81, R82, R84, R85, R87, R88, R93, R94, R107, R108: 10k; R_0402_1005Metric
R58, R83, R86, R89, R95, R109: 1k; R_0402_1005Metric

Connections of its further copies:
+3V3: D15.2 (A), D20.2 (A), D33.2 (A), D34.2 (A), D36.2 (A), D37.2 (A), R55.2, R81.2, R84.2, R87.2, R93.2, R107.2; also elsewhere on the board
/button1: C68.1, R57.1; also elsewhere on the board
/button2: C71.1, R82.1; also elsewhere on the board
/button3: C72.1, R85.1; also elsewhere on the board
/button4: C95.1, R88.1; also elsewhere on the board
/button6: C97.1, R94.1; also elsewhere on the board
/button7: C101.1, R108.1; also elsewhere on the board
/button_raw1: R55.1, R57.2, R58.2; also elsewhere on the board
/button_raw2: R81.1, R82.2, R83.2; also elsewhere on the board
/button_raw3: R84.1, R85.2, R86.2; also elsewhere on the board
/button_raw4: R87.1, R88.2, R89.2; also elsewhere on the board
/button_raw6: R93.1, R94.2, R95.2; also elsewhere on the board
/button_raw7: R107.1, R108.2, R109.2; also elsewhere on the board
GND: C68.2, C71.2, C72.2, C95.2, C97.2, C101.2; also elsewhere on the board
unnamed: D15.1 (K), R58.1
unnamed: D20.1 (K), R83.1
unnamed: D33.1 (K), R86.1
unnamed: D34.1 (K), R89.1
unnamed: D36.1 (K), R95.1
unnamed: D37.1 (K), R109.1

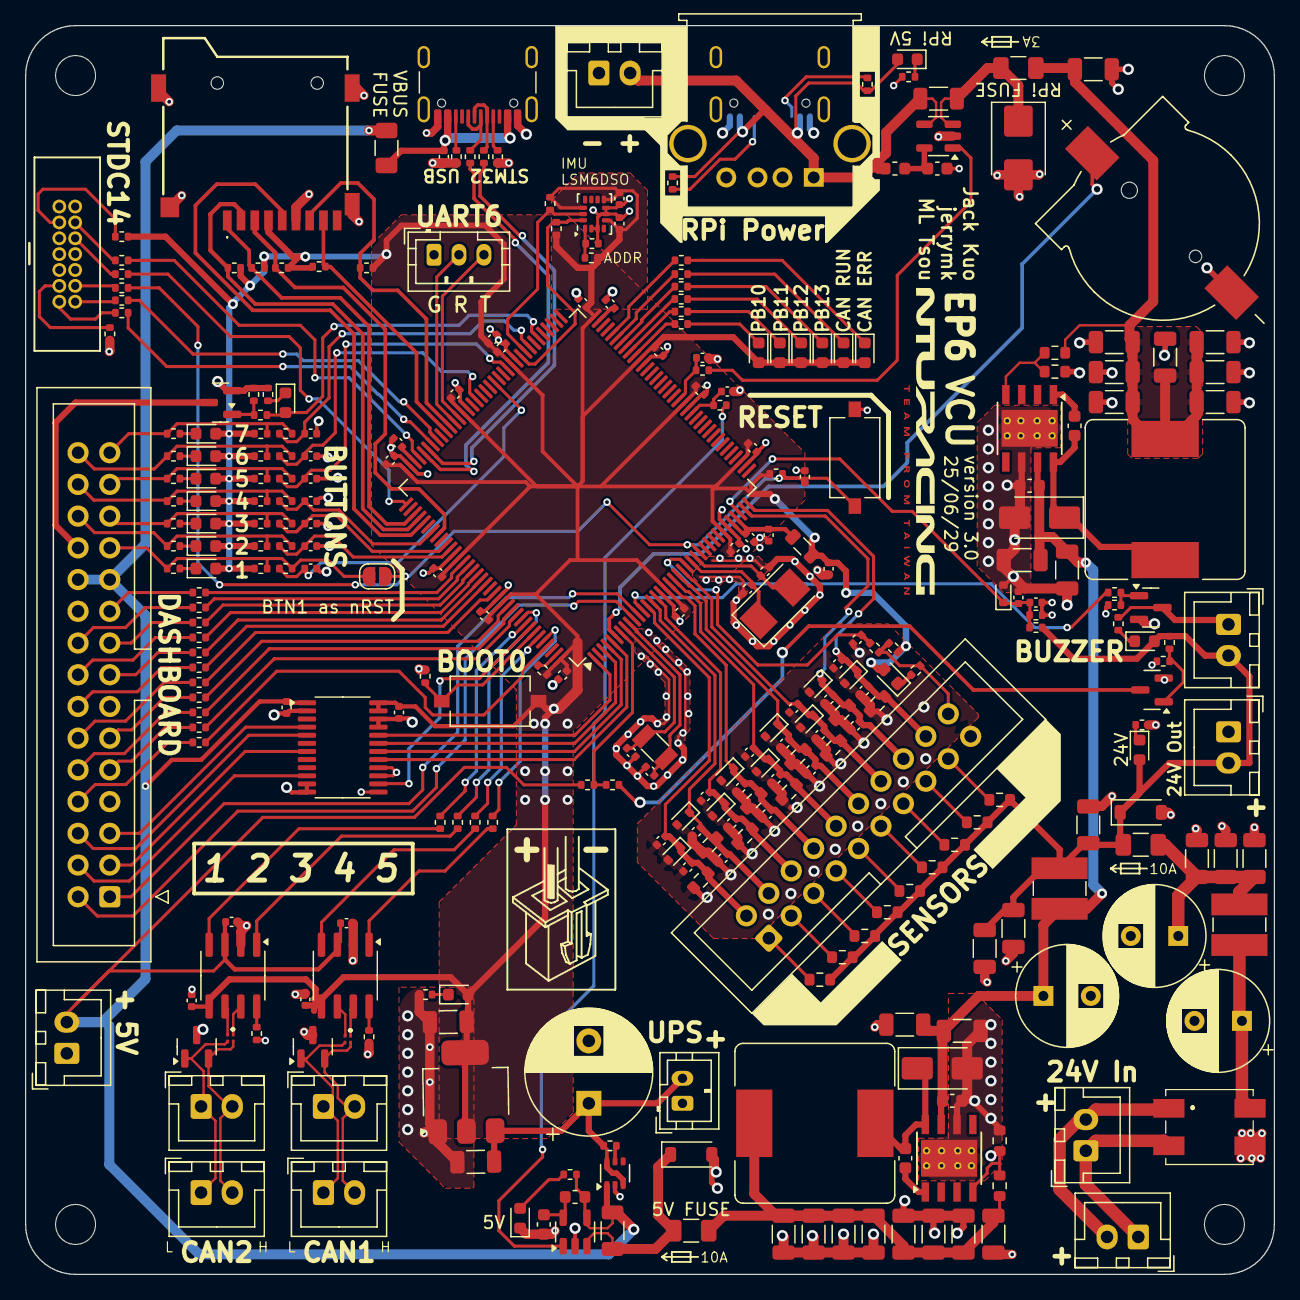
[picture p51: board VCU.kicad_pcb from above]

Board: 4 copper layers, 100.0 x 100.0 mm, 309 parts (1 on the bottom side), 191 nets.
