NTURacingTeam/nturt_kicad/EP6/Powertrain_Group/ACC_BMSmaster/ACC_BMSmaster.kicad_pcb

## KiCad design EP6/Powertrain_Group/ACC_BMSmaster/ACC_BMSmaster.kicad_pcb (2025-06-29)

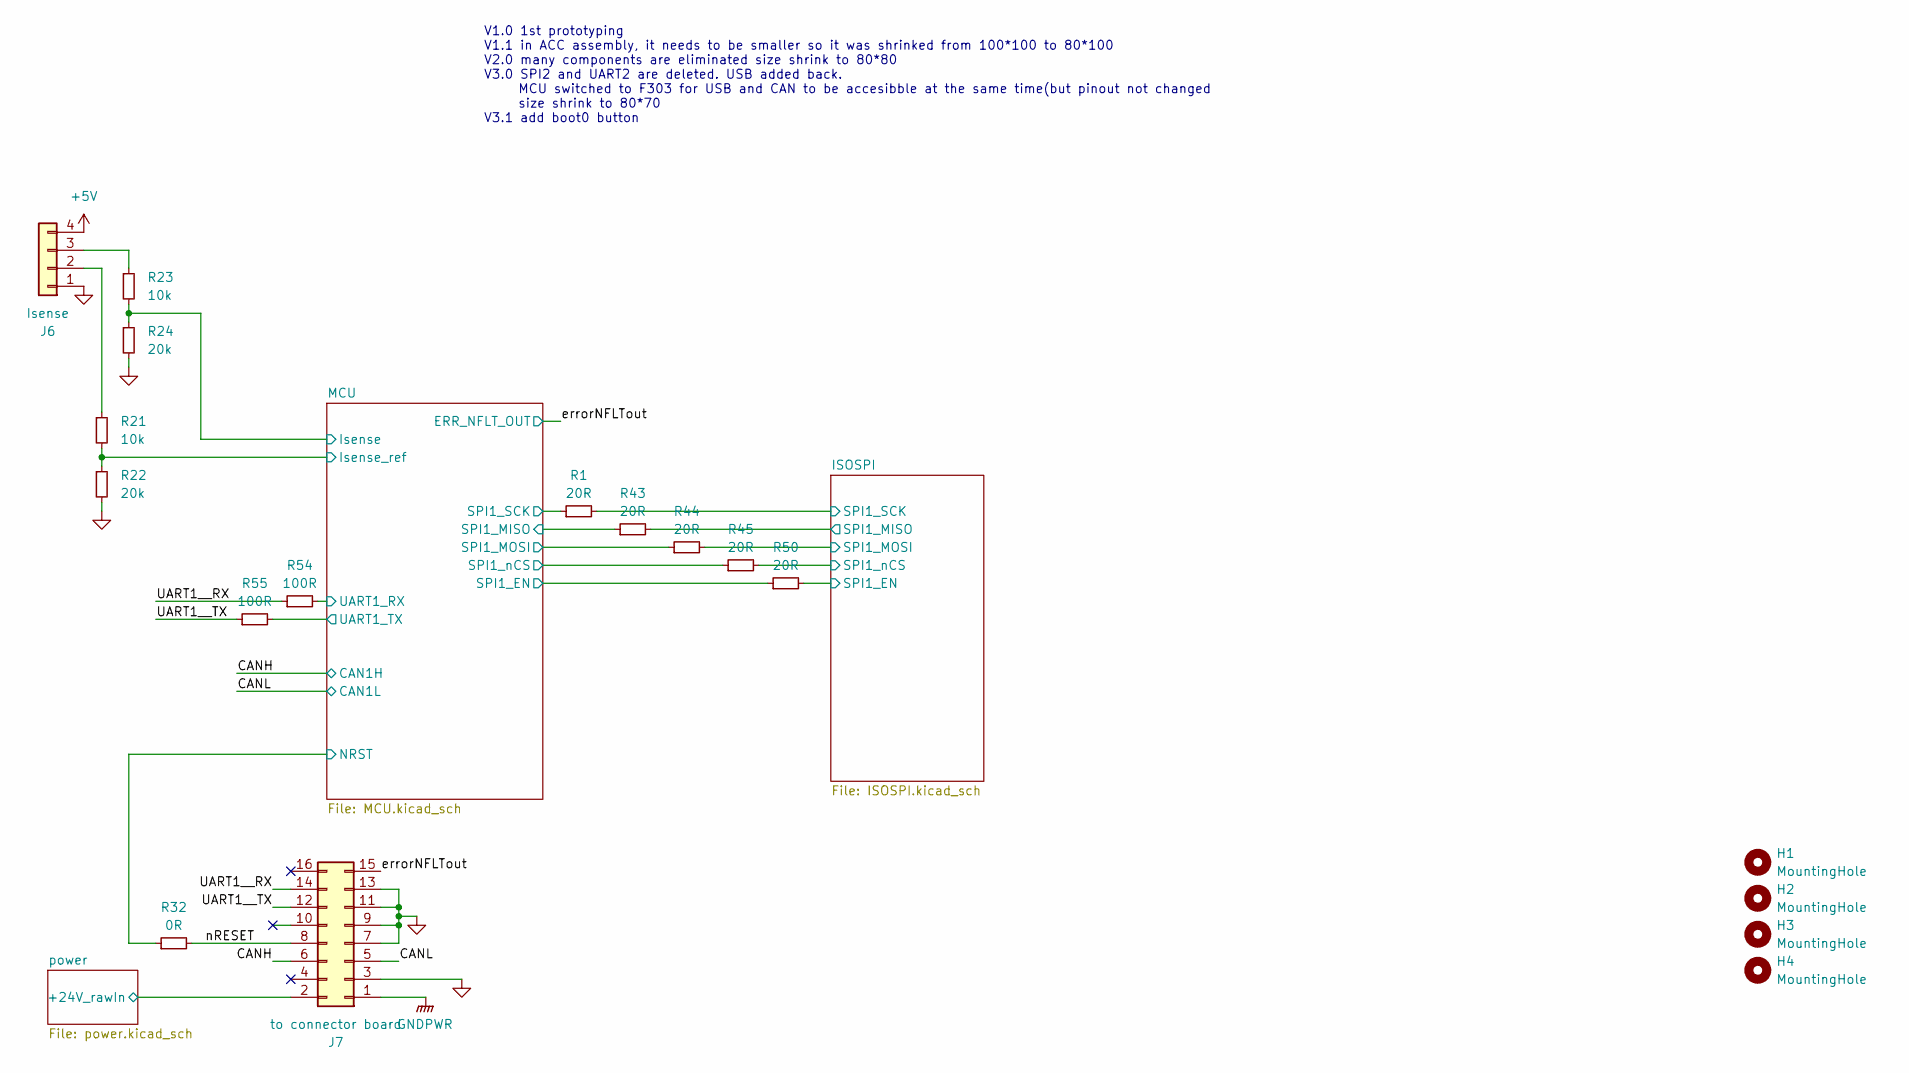
[picture p52: schematic ACC_BMSmaster.kicad_sch]

Parts:
H1, H2, H3, H4: MountingHole; MountingHole_3.2mm_M3
J6: Isense; JST_PH_B4B-PH-K_1x04_P2.00mm_Vertical
J7: to connector board; IDC-Header_2x08_P2.54mm_Vertical
R1, R43, R44, R45, R50: 20R; R_0402_1005Metric
R21, R23: 10k; R_0402_1005Metric
R22, R24: 20k; R_0402_1005Metric
R32: 0R; R_0402_1005Metric
R54, R55: 100R; R_0402_1005Metric

Connections:
+5V: J6.4; also elsewhere on the board
/CANH: J7.6; also elsewhere on the board
/CANL: J7.5; also elsewhere on the board
/ISOSPI/SPI1_EN: R50.2; also elsewhere on the board
/ISOSPI/SPI1_MISO: R43.2; also elsewhere on the board
/ISOSPI/SPI1_MOSI: R44.2; also elsewhere on the board
/ISOSPI/SPI1_SCK: R1.2; also elsewhere on the board
/ISOSPI/SPI1_nCS: R45.2; also elsewhere on the board
/MCU/Isense: R23.2, R24.1; also elsewhere on the board
/MCU/Isense_ref: R21.2, R22.1; also elsewhere on the board
/MCU/SPI1_EN: R50.1; also elsewhere on the board
/MCU/SPI1_MISO: R43.1; also elsewhere on the board
/MCU/SPI1_MOSI: R44.1; also elsewhere on the board
/MCU/SPI1_SCK: R1.1; also elsewhere on the board
/MCU/SPI1_nCS: R45.1; also elsewhere on the board
/MCU/SWD_NRST: R32.1; also elsewhere on the board
/MCU/UART1_RX: R54.2; also elsewhere on the board
/MCU/UART1_TX: R55.2; also elsewhere on the board
/UART1__RX: J7.14, R54.1
/UART1__TX: J7.12, R55.1
/errorNFLTout: J7.15; also elsewhere on the board
/nRESET: J7.8, R32.2
/power/+24V_preCMfilter: J7.2; also elsewhere on the board
GND: J6.1, J7.3, J7.7, J7.9, J7.11, J7.13, R22.2, R24.2; also elsewhere on the board
GNDPWR: J7.1; also elsewhere on the board
unnamed: J6.2, R21.1
unnamed: J6.3, R23.1

Notes on the sheet:
V1.0 1st prototyping V1.1 in ACC assembly, it needs to be smaller so it was shrinked from 100*100 to 80*100 V2.0 many components are eliminated size shrink to 80*80 V3.0 SPI2 and UART2 are deleted. USB added back. MCU switched to F303 for USB and CAN to be accesibble at the same time(but pinout not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

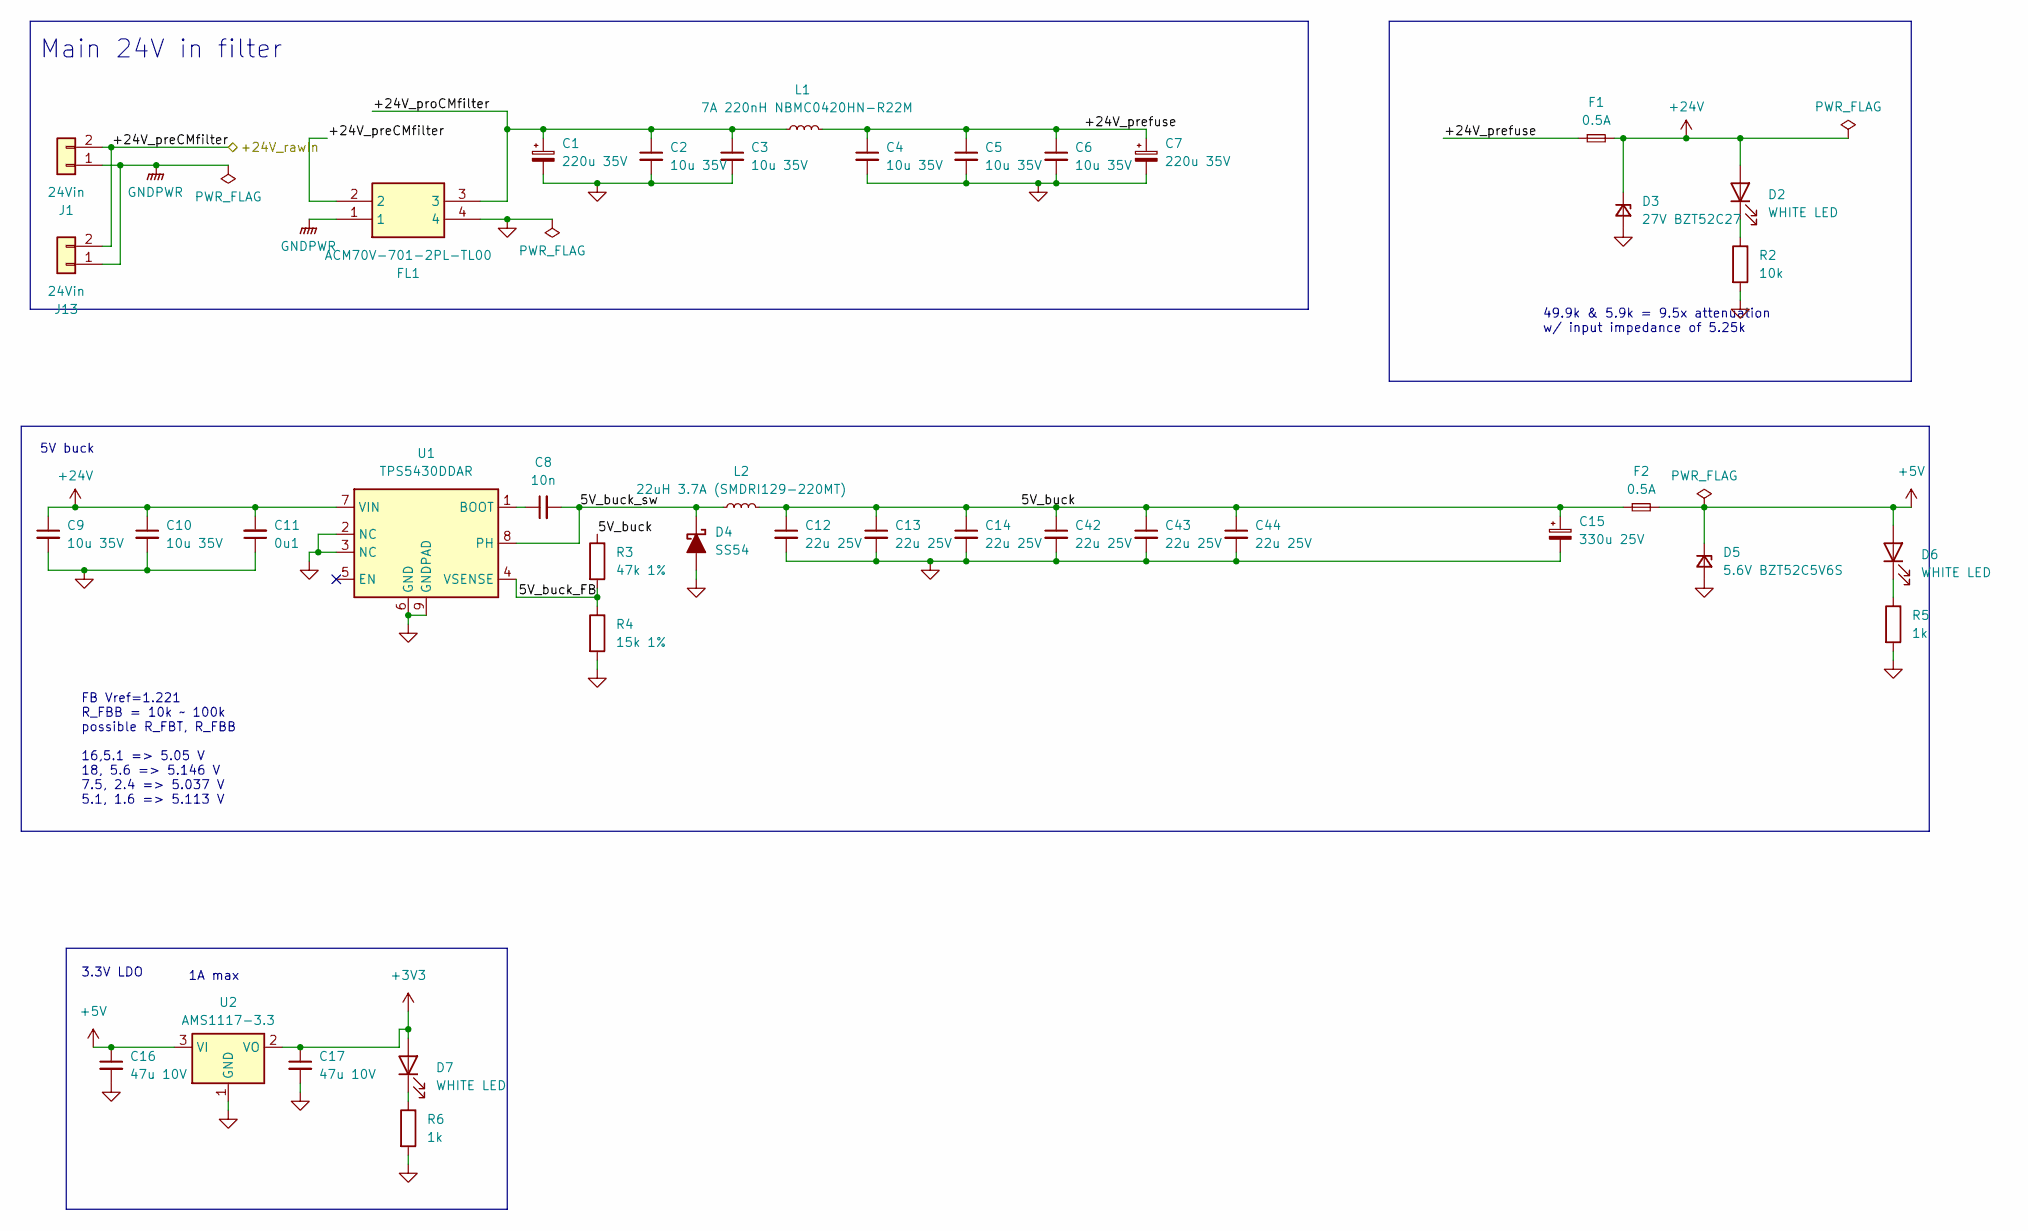
[picture p53: schematic power.kicad_sch, ACC_BMSmaster]

Parts:
C1, C7: 220u 35V; CP_Radial_D8.0mm_P3.80mm
C2, C3, C4, C5, C6, C9, C10: 10u 35V; C_1206_3216Metric
C8: 10n; C_0603_1608Metric
C11: 0u1; C_0603_1608Metric
C12, C13, C14, C42, C43, C44: 22u 25V; C_1206_3216Metric
C15: 330u 25V; CP_Radial_D8.0mm_P3.80mm
C16, C17: 47u 10V; C_1206_3216Metric
D2, D6, D7: WHITE LED; LED_0603_1608Metric
D3: 27V BZT52C27; D_SOD-323
D4: SS54; D_SMA
D5: 5.6V BZT52C5V6S; D_SOD-323
F1, F2: 0.5A; Fuse_1206_3216Metric
FL1: ACM70V-701-2PL-TL00; ACM70V7012PLTL00; Mouser Part Number 810-ACM70V7012PLTL00
J1, J13: 24Vin; JST_VH_B2P-VH_1x02_P3.96mm_Vertical
L1: 7A 220nH NBMC0420HN-R22M; L_Ferrocore_DLG-0403
L2: 22uH 3.7A (SMDRI129-220MT); L_Bourns_SRR1260
R2: 10k; R_0402_1005Metric
R3: 47k 1%; R_0603_1608Metric
R4: 15k 1%; R_0603_1608Metric
R5, R6: 1k; R_0402_1005Metric
U1: TPS5430DDAR; TI_SO-PowerPAD-8_ThermalVias
U2: AMS1117-3.3; SOT-223-3_TabPin2

Connections:
+3V3: C17.1, D7.2 (A), U2.2 (VO); also elsewhere on the board
+5V: C16.1, D5.1 (K), D6.2 (A), F2.2, U2.3 (VI); also elsewhere on the board
+24V: C9.1, C10.1, C11.2, D2.2 (A), D3.1 (K), F1.2, U1.7 (VIN)
/power/5V_buck: C12.1, C13.1, C14.1, C15.1, C42.1, C43.1, C44.1, F2.1, L2.2, R3.1
/power/5V_buck_FB: R3.2, R4.1, U1.4 (VSENSE)
/power/5V_buck_sw: C8.2, D4.1 (K), L2.1, U1.8 (PH)
/power/+24V_preCMfilter: FL1.2, J1.2, J13.2; also elsewhere on the board
/power/+24V_prefuse: C4.1, C5.1, C6.1, C7.1, F1.1, L1.2
/power/+24V_proCMfilter: C1.1, C2.1, C3.1, FL1.3, L1.1
GND: C1.2, C2.2, C3.2, C4.2, C5.2, C6.2, C7.2, C9.2, C10.2, C11.1, C12.2, C13.2, C14.2, C15.2, C16.2, C17.2, C42.2, C43.2, C44.2, D3.2 (A), D4.2 (A), D5.2 (A), FL1.4, R2.2, R4.2, R5.2, R6.2, U1.2 (NC), U1.3 (NC), U1.6 (GND), U1.9 (GNDPAD), U2.1 (GND); also elsewhere on the board
GNDPWR: FL1.1, J1.1, J13.1; also elsewhere on the board
unnamed: D2.1 (K), R2.1
unnamed: D6.1 (K), R5.1
unnamed: D7.1 (K), R6.1
unnamed: C8.1, U1.1 (BOOT)

Notes on the sheet:
49.9k & 5.9k = 9.5x attenuation w/ input impedance of 5.25k
FB Vref=1.221 R_FBB = 10k ~ 100k possible R_FBT, R_FBB 16,5.1 => 5.05 V 18, 5.6 => 5.146 V 7.5, 2.4 => 5.037 V 5.1, 1.6 => 5.113 V
1A max
5V buck
3.3V LDO
Main 24V in filter
