NTURacingTeam/nturt_kicad/EP6/Powertrain_Group/ACC_BMSmaster/ACC_BMSmaster.kicad_pcb

## KiCad design EP6/Powertrain_Group/ACC_BMSmaster/ACC_BMSmaster.kicad_pcb (continued)

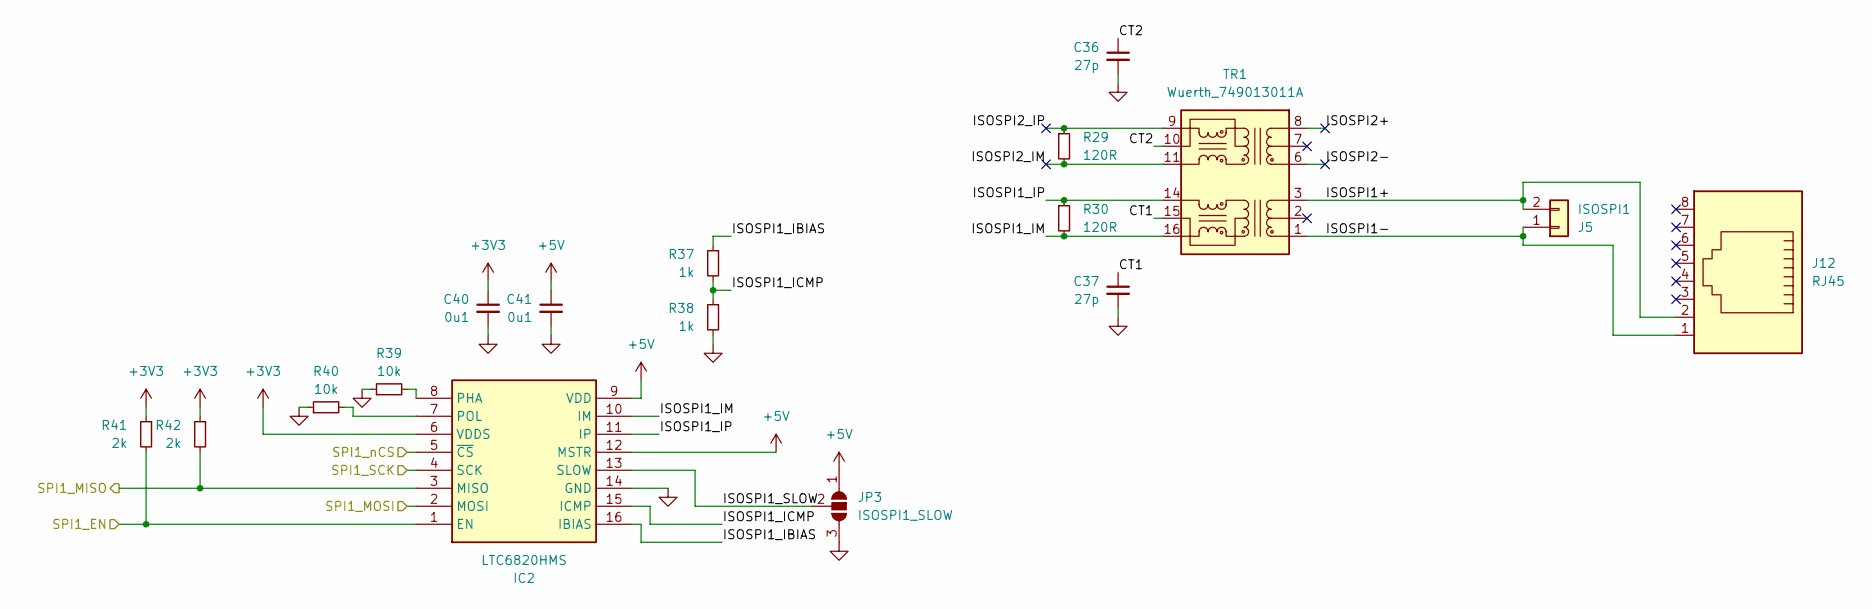
[picture p54: schematic ISOSPI.kicad_sch, ACC_BMSmaster]

Parts:
C36, C37: 27p; C_0402_1005Metric
C40, C41: 0u1; C_0402_1005Metric
IC2: LTC6820HMS; SOP50P490X110-16N; Mouser Part Number 584-LTC6820HMS#PBF
J5: ISOSPI1; JST_XH_B2B-XH-A_1x02_P2.50mm_Vertical
J12: RJ45; RJ45_Amphenol_54602-x08_Horizontal
JP3: ISOSPI1_SLOW; SolderJumper-3_P1.3mm_Open_RoundedPad1.0x1.5mm
R29, R30: 120R; R_0402_1005Metric
R37, R38: 1k; R_0402_1005Metric
R39, R40: 10k; R_0402_1005Metric
R41, R42: 2k; R_0402_1005Metric
TR1: Wuerth_749013011A; Transformer_Ethernet_Wuerth_749013011A

Connections:
+3V3: C40.1, IC2.6 (VDDS), R41.1, R42.1; also elsewhere on the board
+5V: C41.1, IC2.9 (VDD), IC2.12 (MSTR), JP3.1 (A); also elsewhere on the board
/ISOSPI/CT1: C37.1, TR1.15 (C_TX)
/ISOSPI/CT2: C36.1, TR1.10 (C_RX)
/ISOSPI/ISOSPI1+: J5.2, J12.2, TR1.3 (TD-)
/ISOSPI/ISOSPI1-: J5.1, J12.1, TR1.1 (TD+)
/ISOSPI/ISOSPI1_IBIAS: IC2.16 (IBIAS), R37.1
/ISOSPI/ISOSPI1_ICMP: IC2.15 (ICMP), R37.2, R38.1
/ISOSPI/ISOSPI1_IM: IC2.10 (IM), R30.2, TR1.16 (TX+)
/ISOSPI/ISOSPI1_IP: IC2.11 (IP), R30.1, TR1.14 (TX-)
/ISOSPI/ISOSPI1_SLOW: IC2.13 (SLOW), JP3.2 (C)
/ISOSPI/ISOSPI2+: TR1.8 (RD-)
/ISOSPI/ISOSPI2-: TR1.6 (RD+)
/ISOSPI/ISOSPI2_IM: R29.2, TR1.11 (RX+)
/ISOSPI/ISOSPI2_IP: R29.1, TR1.9 (RX-)
/ISOSPI/SPI1_EN: IC2.1 (EN), R41.2; also elsewhere on the board
/ISOSPI/SPI1_MISO: IC2.3 (MISO), R42.2; also elsewhere on the board
/ISOSPI/SPI1_MOSI: IC2.2 (MOSI); also elsewhere on the board
/ISOSPI/SPI1_SCK: IC2.4 (SCK); also elsewhere on the board
/ISOSPI/SPI1_nCS: IC2.5 (~CS); also elsewhere on the board
GND: C36.2, C37.2, C40.2, C41.2, IC2.14 (GND), JP3.3 (B), R38.2, R39.1, R40.1; also elsewhere on the board
unnamed: IC2.8 (PHA), R39.2
unnamed: IC2.7 (POL), R40.2

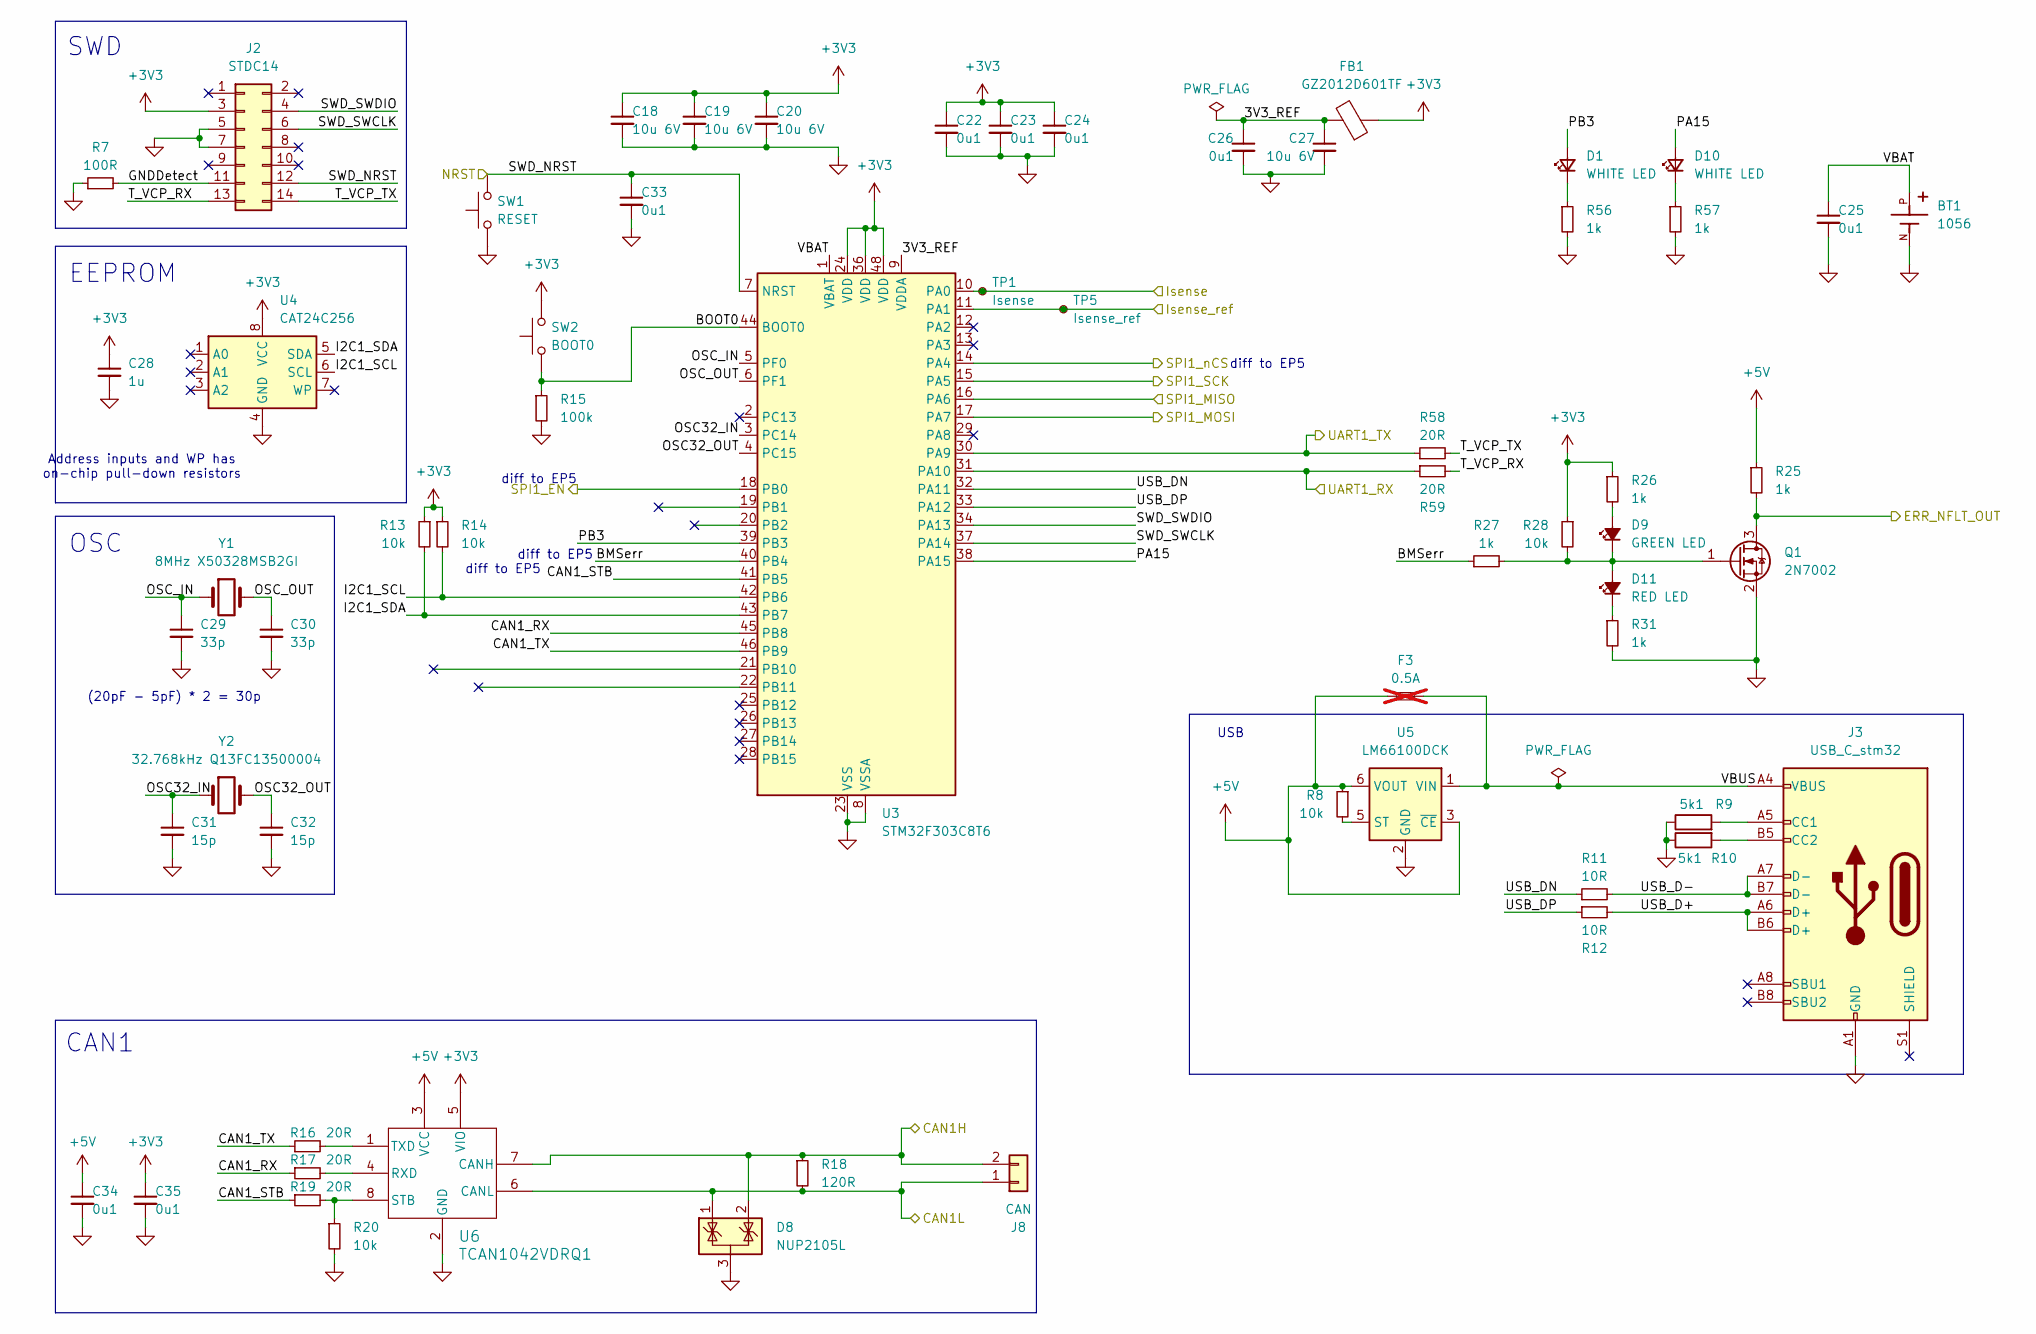
[picture p55: schematic MCU.kicad_sch, ACC_BMSmaster]

Parts:
BT1: 1056; BAT_1056; PARTREV D
C18, C19, C20, C27: 10u 6V; C_0402_1005Metric
C22, C23, C24, C25, C26, C33, C34, C35: 0u1; C_0402_1005Metric
C28: 1u; C_0402_1005Metric
C29, C30: 33p; C_0402_1005Metric
C31, C32: 15p; C_0402_1005Metric
D1, D10: WHITE LED; LED_0603_1608Metric
D8: NUP2105L; SOT-23
D9: GREEN LED; LED_0603_1608Metric
D11: RED LED; LED_0603_1608Metric
F3: 0.5A; Fuse_1206_3216Metric; not fitted
FB1: GZ2012D601TF; L_0805_2012Metric
J2: STDC14; box_header_14P_pitch127
J3: USB_C_stm32; USB_C_Receptacle_GCT_USB4105-xx-A_16P_TopMnt_Horizontal
J8: CAN; JST_XH_B2B-XH-A_1x02_P2.50mm_Vertical
Q1: 2N7002; SOT-23
R7: 100R; R_0402_1005Metric
R8, R13, R14, R20, R28: 10k; R_0402_1005Metric
R9, R10: 5k1; R_0402_1005Metric
R11, R12: 10R; R_0402_1005Metric
R15: 100k; R_0402_1005Metric
R16, R17, R19, R58, R59: 20R; R_0402_1005Metric
R18: 120R; R_0402_1005Metric
R25, R26, R27, R31, R56, R57: 1k; R_0402_1005Metric
SW1: RESET; SW_Tactile_SPST_NO_Straight_CK_PTS636Sx25SMTRLFS
SW2: BOOT0; SW_Tactile_SPST_NO_Straight_CK_PTS636Sx25SMTRLFS
TP1: Isense; TestPoint_Pad_D1.0mm
TP5: Isense_ref; TestPoint_Pad_D1.0mm
U3: STM32F303C8T6; LQFP-48_7x7mm_P0.5mm
U4: CAT24C256; SOIC-8_3.9x4.9mm_P1.27mm
U5: LM66100DCK; SOT-363_SC-70-6
U6: TCAN1042VDRQ1; SOIC-8_3.9x4.9mm_P1.27mm
Y1: 8MHz X50328MSB2GI; Crystal_SMD_5032-2Pin_5.0x3.2mm
Y2: 32.768kHz Q13FC13500004; Crystal_SMD_3215-2Pin_3.2x1.5mm

Connections:
+3V3: C18.1, C19.1, C20.1, C22.1, C23.1, C24.1, C28.1, C35.1, FB1.1, J2.3, R13.1, R14.1, R26.1, R28.1, SW2.2, U3.24 (VDD), U3.36 (VDD), U3.48 (VDD), U4.8 (VCC), U6.5 (VIO); also elsewhere on the board
+5V: C34.1, F3.1, R8.1, R25.1, U5.3 (~CE), U5.6 (VOUT), U6.3 (VCC); also elsewhere on the board
/CANH: D8.2 (K), J8.2, R18.1, U6.7 (CANH); also elsewhere on the board
/CANL: D8.1 (K), J8.1, R18.2, U6.6 (CANL); also elsewhere on the board
/MCU/3V3_REF: C26.1, C27.1, FB1.2, U3.9 (VDDA)
/MCU/BMSerr: R27.1, U3.40 (PB4)
/MCU/BOOT0: R15.1, SW2.1, U3.44 (BOOT0)
/MCU/CAN1_RX: R17.1, U3.45 (PB8)
/MCU/CAN1_STB: R19.1, U3.41 (PB5)
/MCU/CAN1_TX: R16.1, U3.46 (PB9)
/MCU/GNDDetect: J2.11, R7.2
/MCU/I2C1_SCL: R14.2, U3.42 (PB6), U4.6 (SCL)
/MCU/I2C1_SDA: R13.2, U3.43 (PB7), U4.5 (SDA)
/MCU/Isense: TP1.1, U3.10 (PA0); also elsewhere on the board
/MCU/Isense_ref: TP5.1, U3.11 (PA1); also elsewhere on the board
/MCU/OSC32_IN: C31.1, U3.3 (PC14), Y2.1
/MCU/OSC32_OUT: C32.1, U3.4 (PC15), Y2.2
/MCU/OSC_IN: C29.1, U3.5 (PF0), Y1.1
/MCU/OSC_OUT: C30.1, U3.6 (PF1), Y1.2
/MCU/PA15: D10.2 (A), U3.38 (PA15)
/MCU/PB3: D1.2 (A), U3.39 (PB3)
/MCU/SPI1_EN: U3.18 (PB0); also elsewhere on the board
/MCU/SPI1_MISO: U3.16 (PA6); also elsewhere on the board
/MCU/SPI1_MOSI: U3.17 (PA7); also elsewhere on the board
/MCU/SPI1_SCK: U3.15 (PA5); also elsewhere on the board
/MCU/SPI1_nCS: U3.14 (PA4); also elsewhere on the board
/MCU/SWD_NRST: C33.1, J2.12, SW1.2, U3.7 (NRST); also elsewhere on the board
/MCU/SWD_SWCLK: J2.6, U3.37 (PA14)
/MCU/SWD_SWDIO: J2.4, U3.34 (PA13)
/MCU/T_VCP_RX: J2.13, R59.2
/MCU/T_VCP_TX: J2.14, R58.2
/MCU/UART1_RX: R59.1, U3.31 (PA10); also elsewhere on the board
/MCU/UART1_TX: R58.1, U3.30 (PA9); also elsewhere on the board
/MCU/USB_D+: J3.A6 (D+), J3.B6 (D+), R12.2
/MCU/USB_D-: J3.A7 (D-), J3.B7 (D-), R11.2
/MCU/USB_DN: R11.1, U3.32 (PA11)
/MCU/USB_DP: R12.1, U3.33 (PA12)
/MCU/VBAT: BT1.P, C25.1, U3.1 (VBAT)
/MCU/VBUS: F3.2, J3.A4 (VBUS), J3.A9 (VBUS), J3.B4 (VBUS), J3.B9 (VBUS), U5.1 (VIN)
/errorNFLTout: Q1.3 (D), R25.2; also elsewhere on the board
GND: BT1.N, C18.2, C19.2, C20.2, C22.2, C23.2, C24.2, C25.2, C26.2, C27.2, C28.2, C29.2, C30.2, C31.2, C32.2, C33.2, C34.2, C35.2, D8.3 (A), J2.5, J2.7, J3.A1 (GND), J3.A12 (GND), J3.B1 (GND), J3.B12 (GND), Q1.2 (S), R7.1, R9.1, R10.1, R15.2, R20.2, R31.2, R56.2, R57.2, SW1.1, U3.8 (VSSA), U3.23 (VSS), U3.35 (VSS), U3.47 (VSS), U4.4 (GND), U5.2 (GND), U6.2 (GND); also elsewhere on the board
unnamed: D1.1 (K), R56.1
unnamed: D9.2 (A), R26.2
unnamed: D10.1 (K), R57.1
unnamed: D9.1 (K), D11.2 (A), Q1.1 (G), R27.2, R28.2
unnamed: D11.1 (K), R31.1
unnamed: J3.A5 (CC1), R9.2
unnamed: J3.B5 (CC2), R10.2
unnamed: R8.2, U5.5 (ST)
unnamed: R17.2, U6.4 (RXD)
unnamed: R19.2, R20.1, U6.8 (STB)
unnamed: R16.2, U6.1 (TXD)

Notes on the sheet:
diff to EP5
EEPROM
SWD
Address inputs and WP has on-chip pull-down resistors
OSC
(20pF - 5pF) * 2 = 30p
USB
CAN1

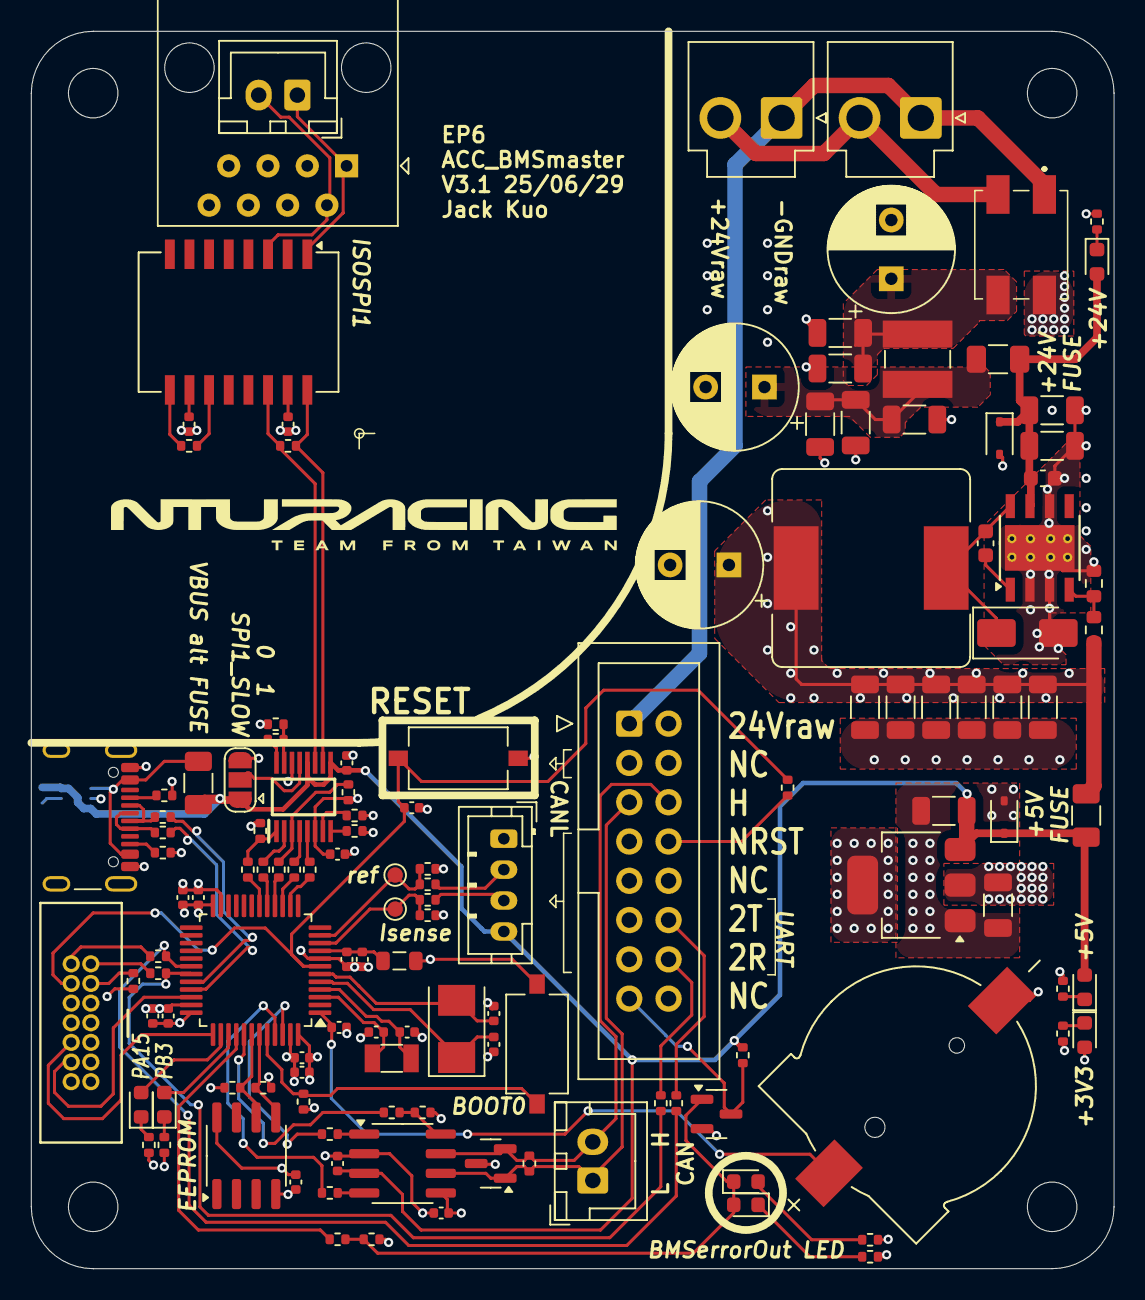
[picture p56: board ACC_BMSmaster.kicad_pcb from above]

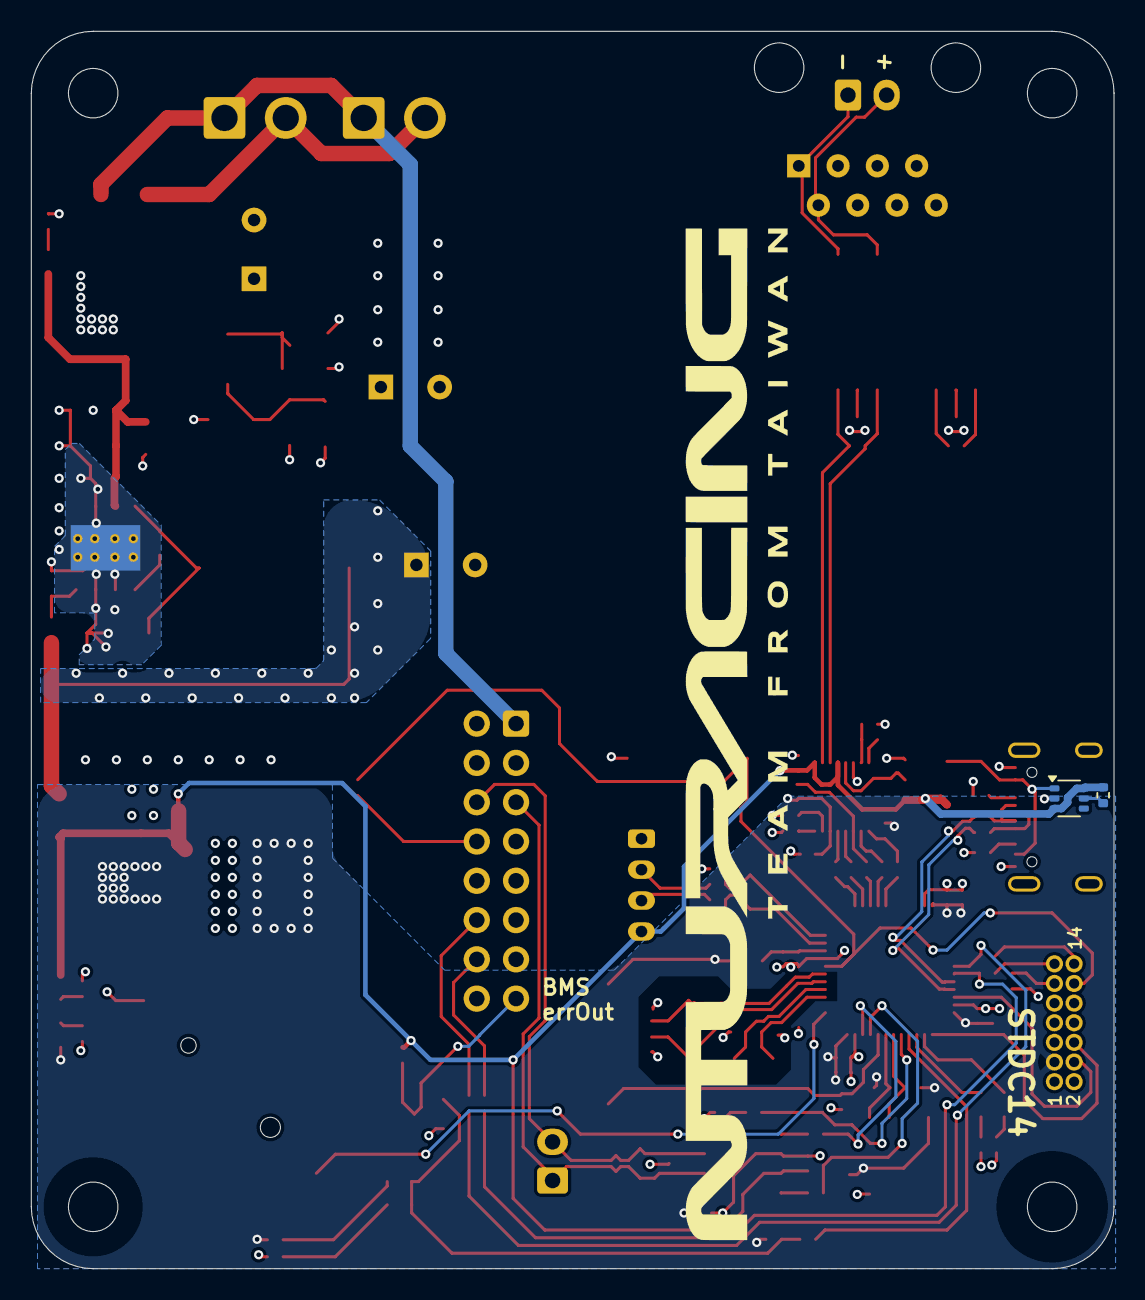
[picture p57: board ACC_BMSmaster.kicad_pcb from below]

Board: 4 copper layers, 70.0 x 80.0 mm, 137 parts (2 on the bottom side), 87 nets.
