NTURacingTeam/nturt_kicad/EP6/Powertrain_Group/INV_PhaseVsense/INV_PhaseVsense.kicad_pcb

## KiCad design EP6/Powertrain_Group/INV_PhaseVsense/INV_PhaseVsense.kicad_pcb (2025-06-29)

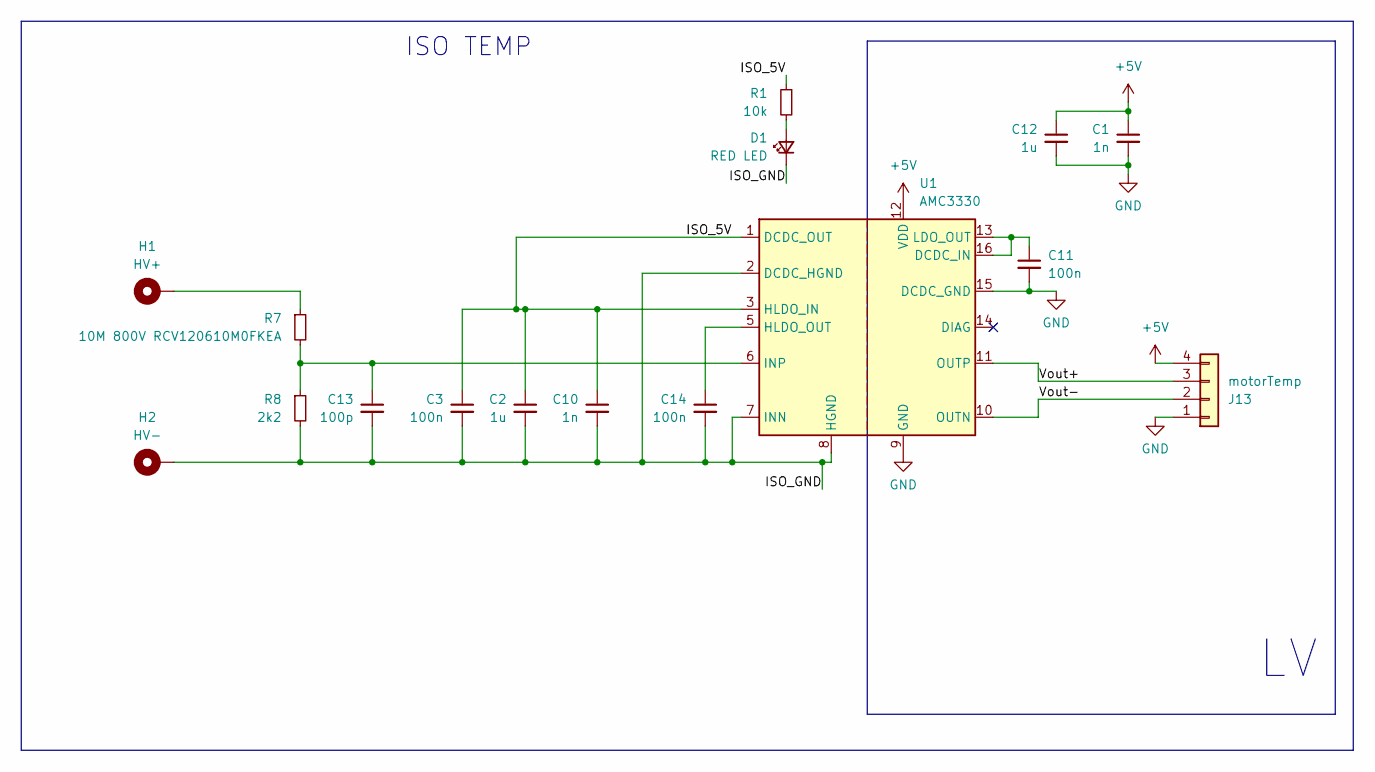
[picture p58: schematic INV_PhaseVsense.kicad_sch]

Parts:
C1, C10: 1n; C_0603_1608Metric
C2, C12: 1u; C_0603_1608Metric
C3, C11, C14: 100n; C_0603_1608Metric
C13: 100p; C_0603_1608Metric
D1: RED LED; LED_0603_1608Metric
H1: HV+; MountingHole_3.2mm_M3_Pad_Via
H2: HV-; MountingHole_3.2mm_M3_Pad_Via
J13: motorTemp; PinHeader_1x04_P2.54mm_Horizontal
R1: 10k; R_0603_1608Metric
R7: 10M 800V RCV120610M0FKEA; R_1206_3216Metric
R8: 2k2; R_0805_2012Metric_Pad1.20x1.40mm_HandSolder
U1: AMC3330; SOIC-16W_7.5x10.3mm_P1.27mm

Connections:
+5V: C1.1, C12.1, J13.4, U1.12 (VDD)
/ISO_5V: C2.1, C3.1, C10.1, R1.1, U1.1 (DCDC_OUT), U1.3 (HLDO_IN)
/ISO_GND: C2.2, C3.2, C10.2, C13.2, C14.2, D1.1 (K), H2.1, R8.2, U1.2 (DCDC_HGND), U1.7 (INN), U1.8 (HGND)
/Vout+: J13.3, U1.11 (OUTP)
/Vout-: J13.2, U1.10 (OUTN)
GND: C1.2, C11.2, C12.2, J13.1, U1.9 (GND), U1.15 (DCDC_GND)
unnamed: D1.2 (A), R1.2
unnamed: H1.1, R7.1
unnamed: C11.1, U1.13 (LDO_OUT), U1.16 (DCDC_IN)
unnamed: C14.1, U1.5 (HLDO_OUT)
unnamed: C13.1, R7.2, R8.1, U1.6 (INP)

Notes on the sheet:
ISO TEMP

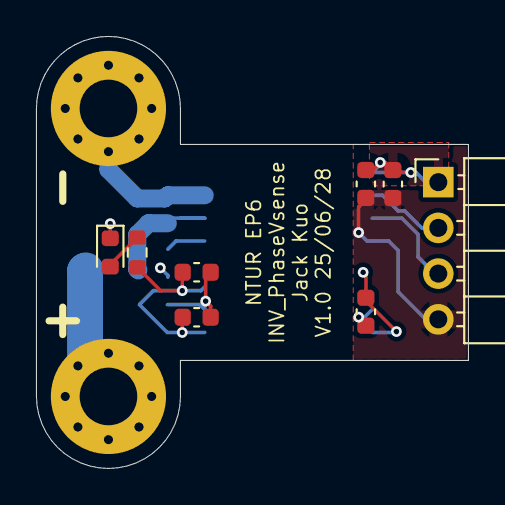
[picture p59: board INV_PhaseVsense.kicad_pcb from above]

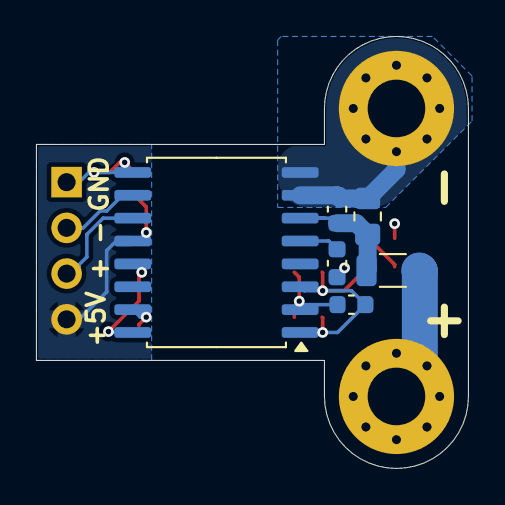
[picture p60: board INV_PhaseVsense.kicad_pcb from below]

Board: 4 copper layers, 24.0 x 24.0 mm, 16 parts (6 on the bottom side), 11 nets.
