NTURacingTeam/nturt_kicad/EP6/Powertrain_Group/TL_TSSI/TL_TSSI.kicad_pcb

## KiCad design EP6/Powertrain_Group/TL_TSSI/TL_TSSI.kicad_pcb (2025-06-29)

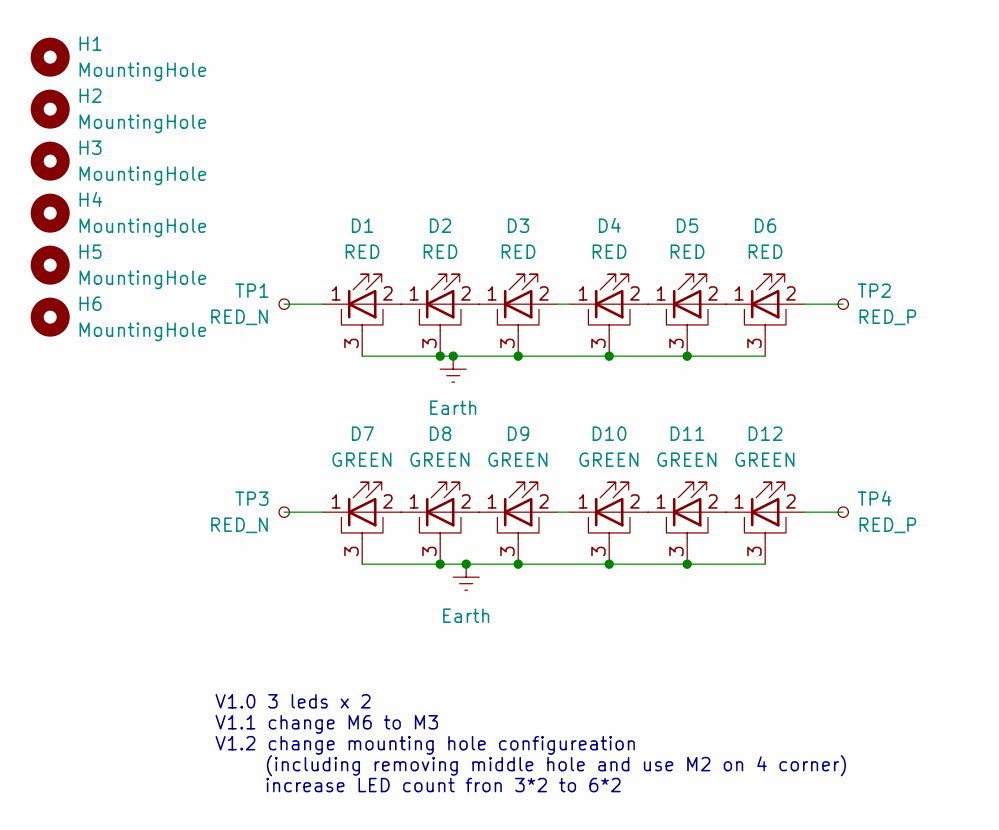
[picture p61: schematic TL_TSSI.kicad_sch]

Parts:
D1, D2, D3, D4, D5, D6: RED; LED_1W_3W_R8
D7, D8, D9, D10, D11, D12: GREEN; LED_1W_3W_R8
H1, H2, H3, H4, H5, H6: MountingHole; MountingHole_2.2mm_M2
TP1, TP3: RED_N; TestPoint_Pad_4.0x4.0mm
TP2, TP4: RED_P; TestPoint_Pad_4.0x4.0mm

Connections:
Earth: D1.3 (PAD), D2.3 (PAD), D3.3 (PAD), D4.3 (PAD), D5.3 (PAD), D6.3 (PAD), D7.3 (PAD), D8.3 (PAD), D9.3 (PAD), D10.3 (PAD), D11.3 (PAD), D12.3 (PAD)
unnamed: D1.2 (A), D2.1 (K)
unnamed: D1.1 (K), TP1.1
unnamed: D2.2 (A), D3.1 (K)
unnamed: D3.2 (A), D4.1 (K)
unnamed: D4.2 (A), D5.1 (K)
unnamed: D5.2 (A), D6.1 (K)
unnamed: D6.2 (A), TP2.1
unnamed: D7.2 (A), D8.1 (K)
unnamed: D7.1 (K), TP3.1
unnamed: D8.2 (A), D9.1 (K)
unnamed: D10.2 (A), D11.1 (K)
unnamed: D9.2 (A), D10.1 (K)
unnamed: D11.2 (A), D12.1 (K)
unnamed: D12.2 (A), TP4.1

Notes on the sheet:
V1.0 3 leds x 2 V1.1 change M6 to M3 V1.2 change mounting hole configureation (including removing middle hole and use M2 on 4 corner) increase LED count fron 3*2 to 6*2

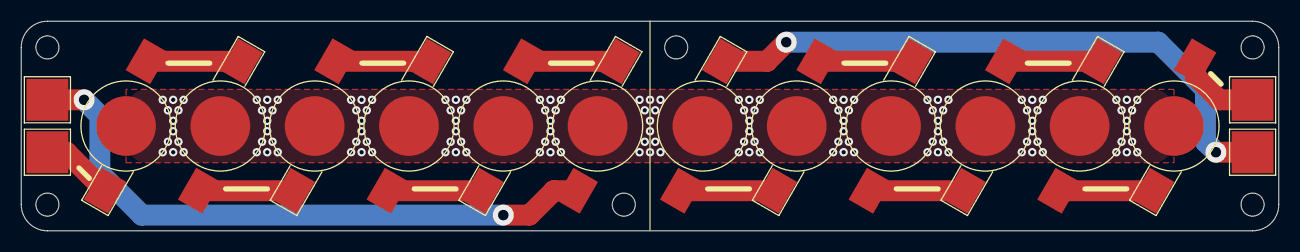
[picture p62: board TL_TSSI.kicad_pcb from above]

Board: 2 copper layers, 120.0 x 20.0 mm, 22 parts (0 on the bottom side), 15 nets.
