NTURacingTeam/nturt_kicad/EP6/Powertrain_Group/INV_CONN2/INV_CONN2.kicad_pcb

## KiCad design EP6/Powertrain_Group/INV_CONN2/INV_CONN2.kicad_pcb (2025-06-29)

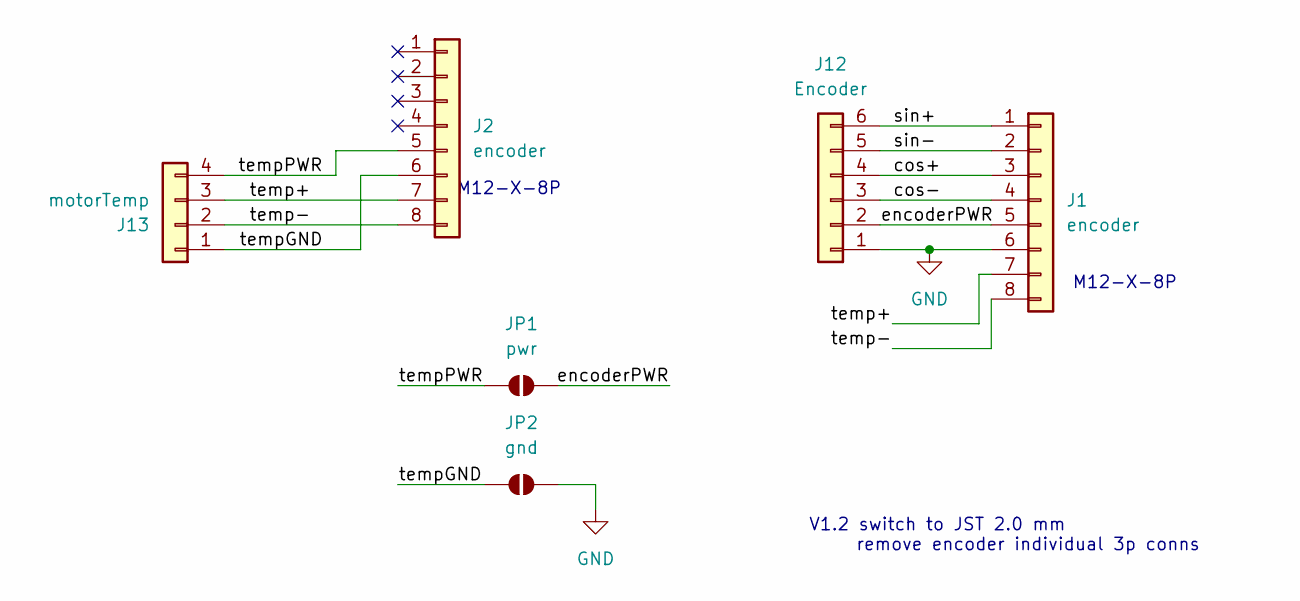
[picture p63: schematic INV_CONN2.kicad_sch]

Parts:
J1, J2: encoder; NianYeong-M12-X-F4P
J12: Encoder; JST_PH_B6B-PH-K_1x06_P2.00mm_Vertical
J13: motorTemp; JST_PH_B4B-PH-K_1x04_P2.00mm_Vertical
JP1: pwr; SolderJumper-2_P1.3mm_Open_RoundedPad1.0x1.5mm
JP2: gnd; SolderJumper-2_P1.3mm_Open_RoundedPad1.0x1.5mm

Connections:
/cos+: J1.3, J12.4
/cos-: J1.4, J12.3
/encoderPWR: J1.5, J12.2, JP1.2 (B)
/sin+: J1.1, J12.6
/sin-: J1.2, J12.5
/temp+: J1.7, J2.7, J13.3
/temp-: J1.8, J2.8, J13.2
/tempGND: J2.6, J13.1, JP2.1 (A)
/tempPWR: J2.5, J13.4, JP1.1 (A)
GND: J1.6, J12.1, JP2.2 (B)

Notes on the sheet:
M12-X-8P
V1.2 switch to JST 2.0 mm remove encoder individual 3p conns

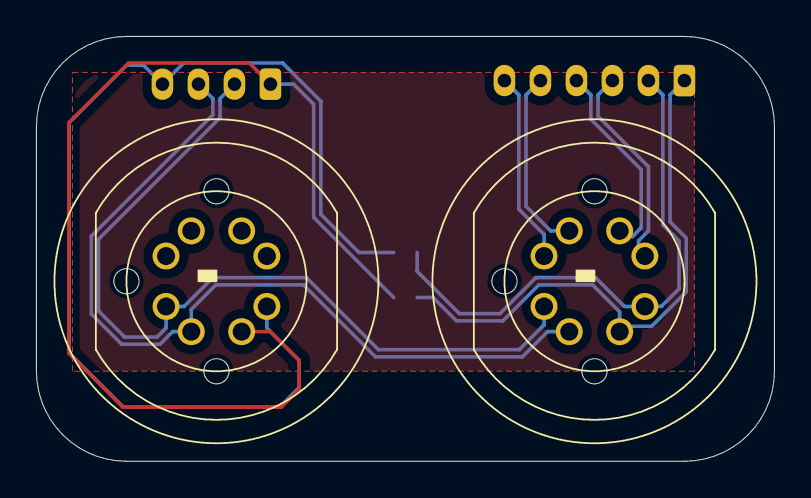
[picture p64: board INV_CONN2.kicad_pcb from above]

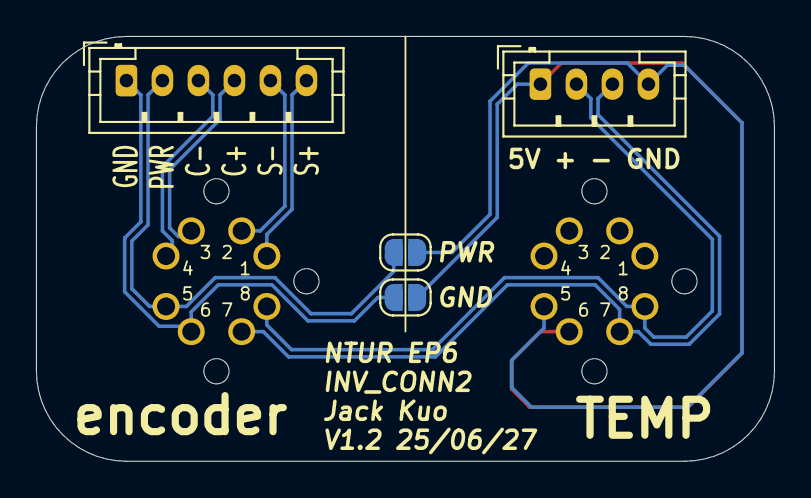
[picture p65: board INV_CONN2.kicad_pcb from below]

Board: 2 copper layers, 41.0 x 23.6 mm, 6 parts (4 on the bottom side), 10 nets.
