NTURacingTeam/nturt_kicad/EP6/Powertrain_Group/HVB_HVLV_1/HVB_HVLV_1.kicad_pcb

## KiCad design EP6/Powertrain_Group/HVB_HVLV_1/HVB_HVLV_1.kicad_pcb (2025-06-29)

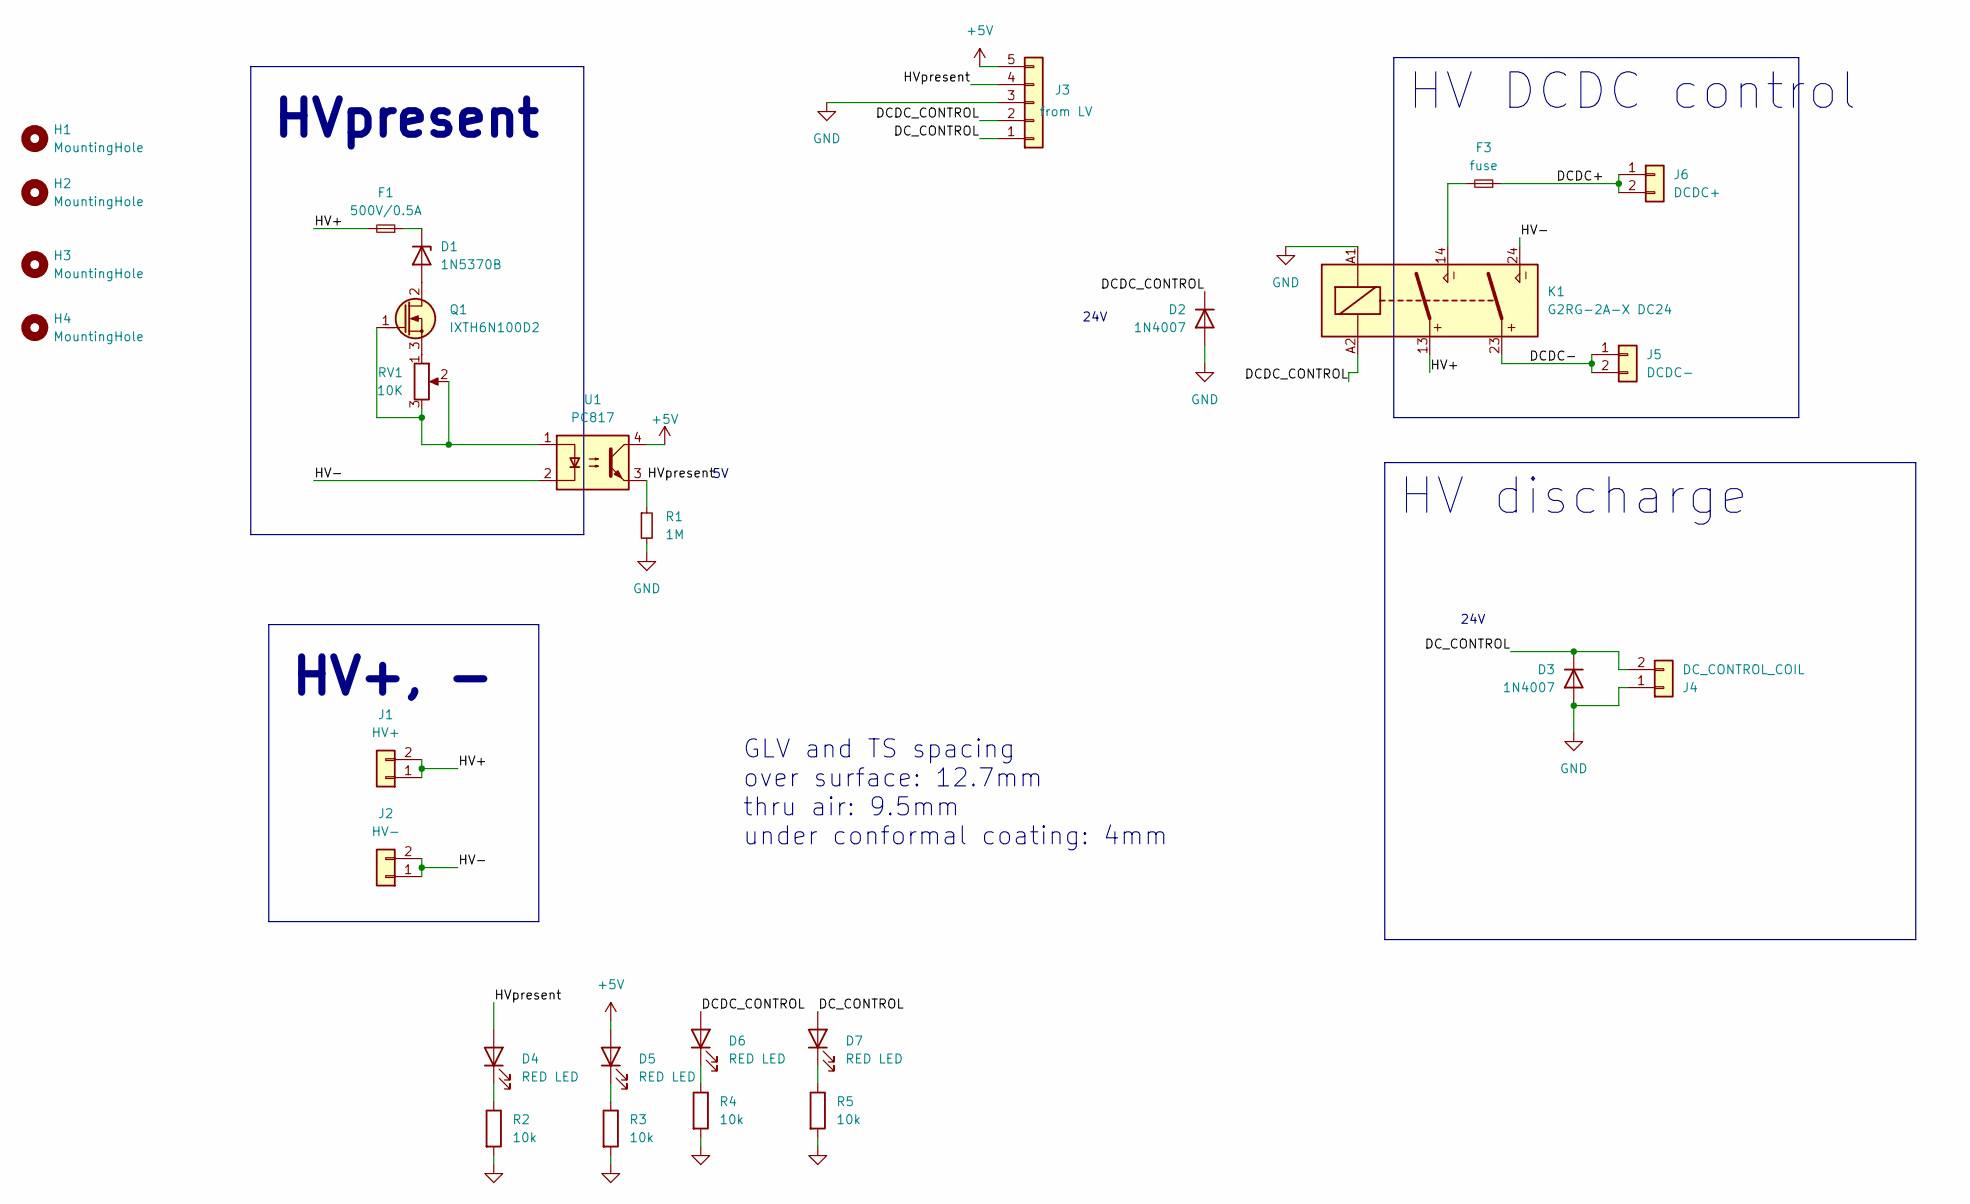
[picture p66: schematic HVB_HVLV_1.kicad_sch]

Parts:
D1: 1N5370B; D_DO-201_P15.24mm_Horizontal
D2, D3: 1N4007; D_DO-41_SOD81_P10.16mm_Horizontal
D4, D5, D6, D7: RED LED; LED_0603_1608Metric
F1: 500V/0.5A; 65600001009; Rating W
F3: fuse; 65600001009; Rating W
H1, H2, H3, H4: MountingHole; MountingHole_3.2mm_M3
J1: HV+; HRS_DF33C-2P-3.3DSA
J2: HV-; HRS_DF33C-2P-3.3DSA
J3: from LV; JST_PH_B5B-PH-K_1x05_P2.00mm_Vertical
J4: DC_CONTROL_COIL; JST_VH_B2P-VH_1x02_P3.96mm_Vertical
J5: DCDC-; HRS_DF33C-2P-3.3DSA
J6: DCDC+; HRS_DF33C-2P-3.3DSA
K1: G2RG-2A-X DC24; Relay_DPST_Omron_G2RL-2A
Q1: IXTH6N100D2; TO-247-3_Vertical_GDS
R1: 1M; R_0603_1608Metric
R2, R3, R4, R5: 10k; R_0603_1608Metric
RV1: 10K; Throughhole Potentiometer 3296W
U1: PC817; DIP-4_W7.62mm

Connections:
+5V: D5.2 (A), J3.5, U1.4
/DCDC+: F3.1, J6.1, J6.2
/DCDC-: J5.1, J5.2, K1.23
/DCDC_CONTROL: D2.1 (K), D6.2 (A), J3.2, K1.A2
/DC_CONTROL: D3.1 (K), D7.2 (A), J3.1, J4.2
/HV+: F1.2, J1.1, J1.2, K1.13
/HV-: J2.1, J2.2, K1.24, U1.2
/HVpresent: D4.2 (A), J3.4, R1.1, U1.3
GND: D2.2 (A), D3.2 (A), J3.3, J4.1, K1.A1, R1.2, R2.2, R3.2, R4.2, R5.2
unnamed: D1.2 (A), Q1.2 (D)
unnamed: D1.1 (K), F1.1
unnamed: D4.1 (K), R2.1
unnamed: D5.1 (K), R3.1
unnamed: D6.1 (K), R4.1
unnamed: D7.1 (K), R5.1
unnamed: F3.2, K1.14
unnamed: Q1.1 (G), RV1.2, RV1.3, U1.1
unnamed: Q1.3 (S), RV1.1

Notes on the sheet:
HVpresent
HV DCDC control
24V
HV discharge
HV+, -
GLV and TS spacing over surface: 12.7mm thru air: 9.5mm under conformal coating: 4mm

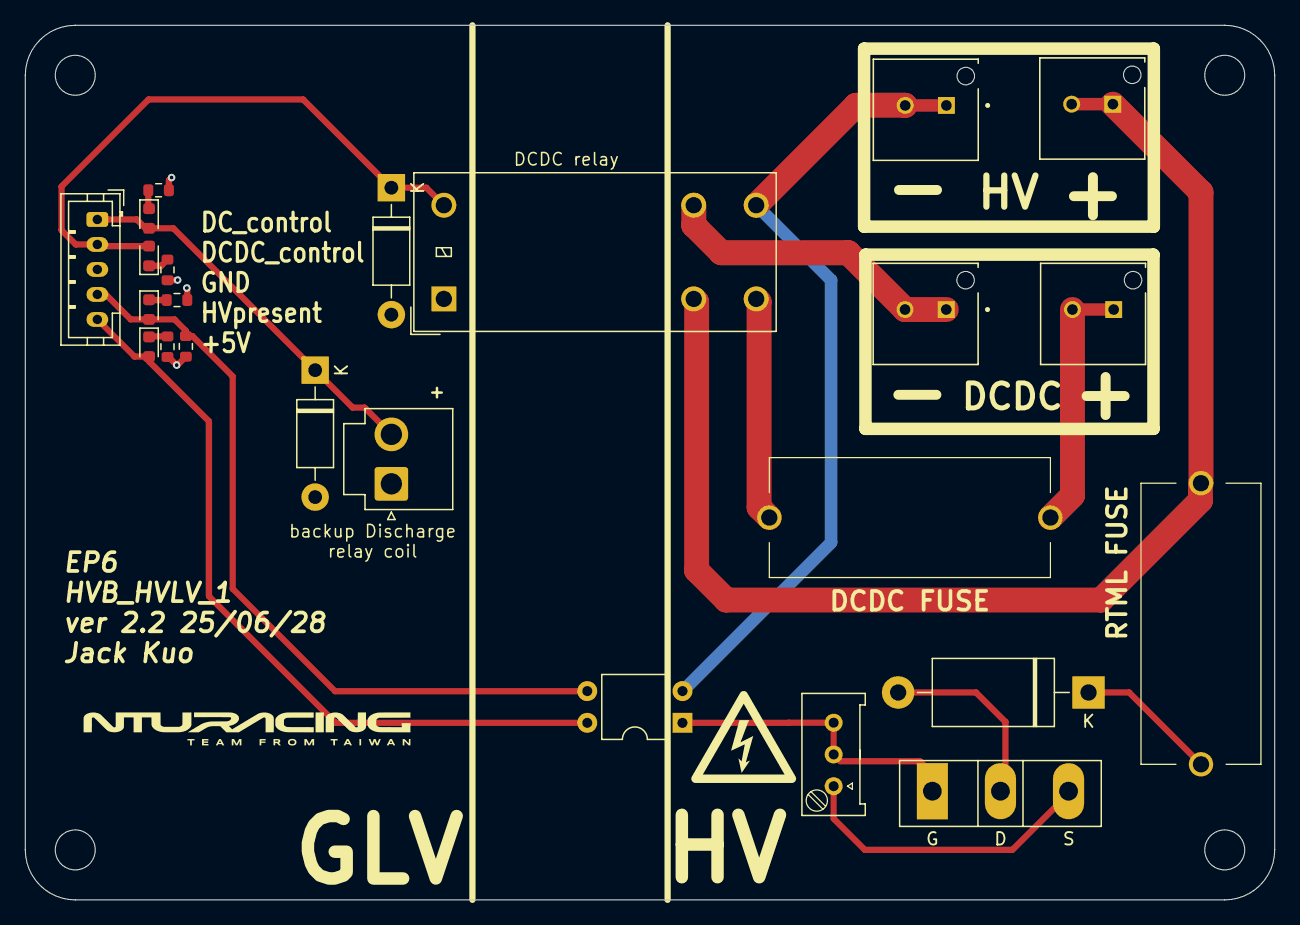
[picture p67: board HVB_HVLV_1.kicad_pcb from above]

Board: 2 copper layers, 100.0 x 70.0 mm, 28 parts (0 on the bottom side), 18 nets.
