NTURacingTeam/nturt_kicad/EP6/Powertrain_Group/HVB_CONN1/HVB_CONN1.kicad_pcb

## KiCad design EP6/Powertrain_Group/HVB_CONN1/HVB_CONN1.kicad_pcb (2025-06-29)

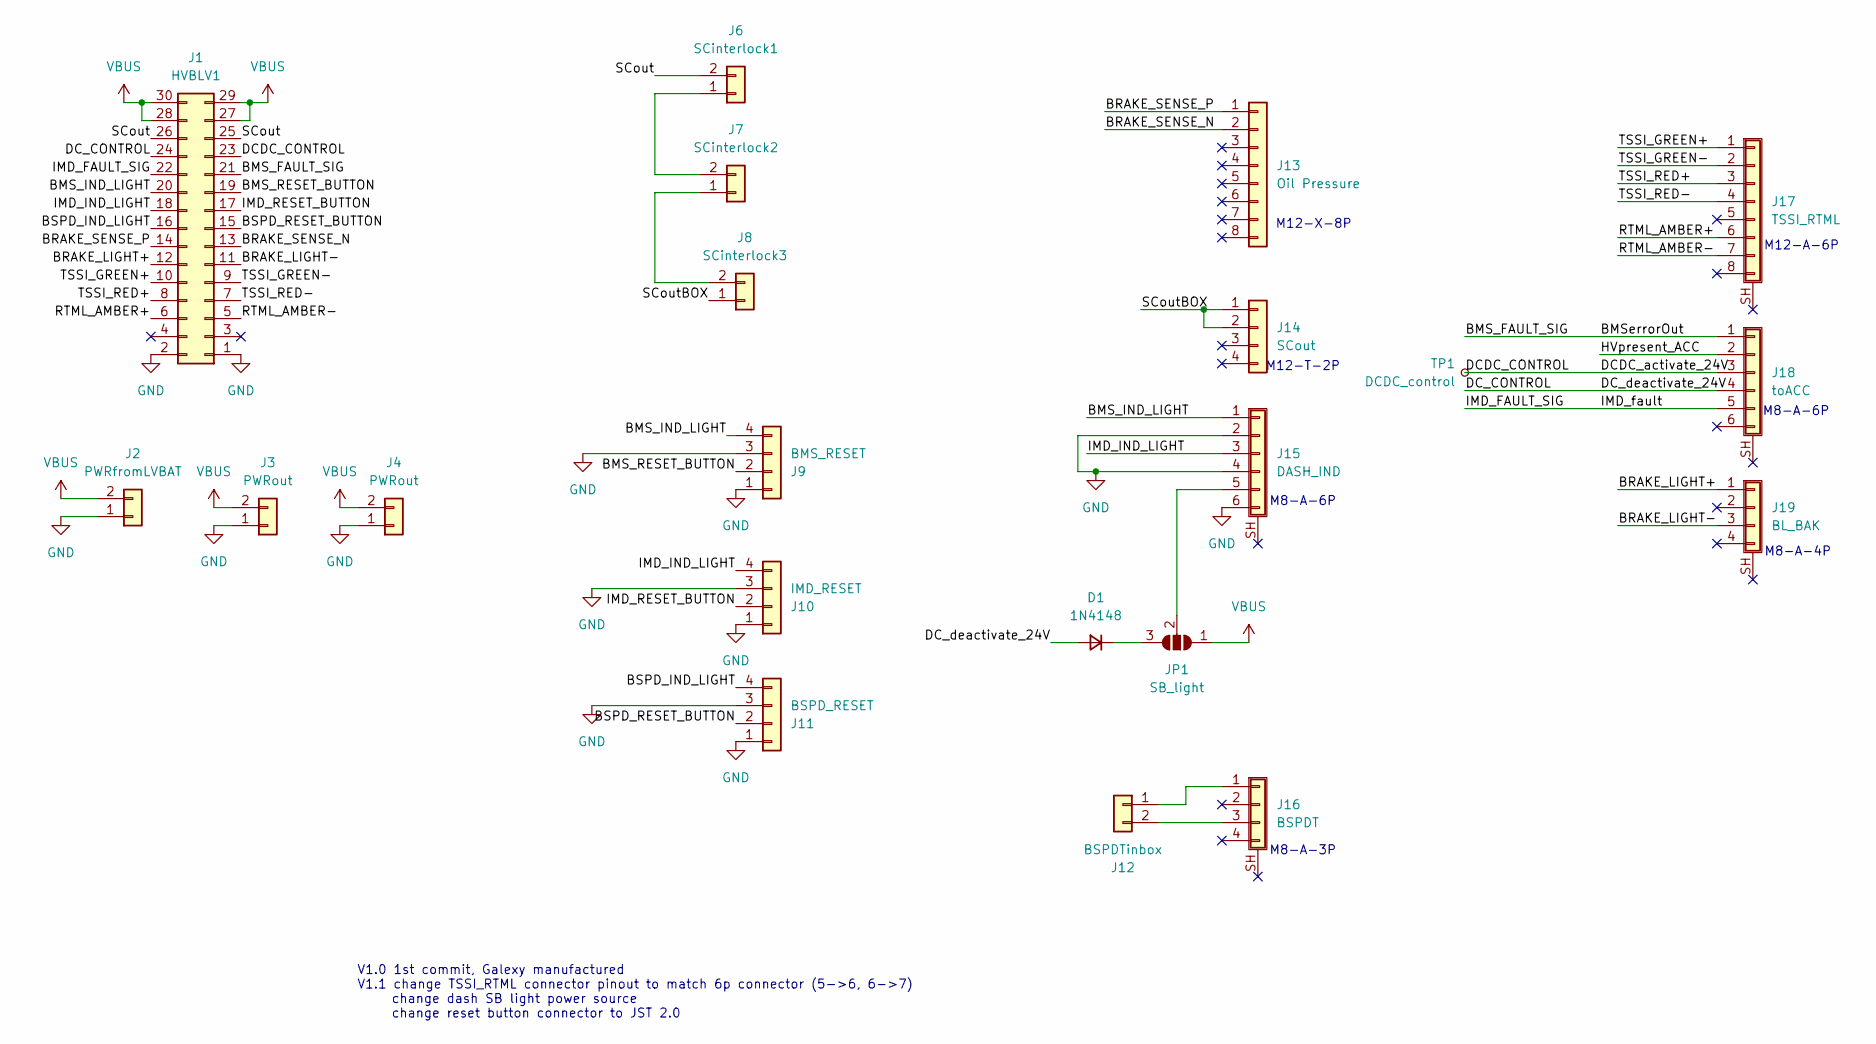
[picture p68: schematic HVB_CONN1.kicad_sch]

Parts:
D1: 1N4148; D_SOD-323_HandSoldering
J1: HVBLV1; IDC-Header_2x15_P2.54mm_Vertical_SMD
J2: PWRfromLVBAT; JST_VH_B2P-VH_1x02_P3.96mm_Vertical
J3, J4: PWRout; JST_VH_B2P-VH_1x02_P3.96mm_Vertical
J6: SCinterlock1; JST_VH_B2P-VH_1x02_P3.96mm_Vertical
J7: SCinterlock2; JST_VH_B2P-VH_1x02_P3.96mm_Vertical
J8: SCinterlock3; JST_VH_B2P-VH_1x02_P3.96mm_Vertical
J9: BMS_RESET; JST_PH_B4B-PH-K_1x04_P2.00mm_Vertical
J10: IMD_RESET; JST_PH_B4B-PH-K_1x04_P2.00mm_Vertical
J11: BSPD_RESET; JST_PH_B4B-PH-K_1x04_P2.00mm_Vertical
J12: BSPDTinbox; JST_PH_B2B-PH-K_1x02_P2.00mm_Vertical
J13: Oil Pressure; NianYeong-M12-X-F4P
J14: SCout; NianYeong-M12-T-M4P
J15: DASH_IND; WP-06F3-09-11
J16: BSPDT; WP-03F3-09-11
J17: TSSI_RTML; NianYeong-M12-A-F8P-Shield
J18: toACC; WP-06F3-09-11
J19: BL_BAK; WP-04F3-26-11
JP1: SB_light; SolderJumper-3_P1.3mm_Open_RoundedPad1.0x1.5mm
TP1: DCDC_control; TestPoint_Pad_D1.0mm

Connections:
/BMS_FAULT_SIG: J1.21, J18.1
/BMS_IND_LIGHT: J1.20, J9.4, J15.1
/BMS_RESET_BUTTON: J1.19, J9.2
/BRAKE_LIGHT+: J1.12, J19.1
/BRAKE_LIGHT-: J1.11, J19.3
/BRAKE_SENSE_N: J1.13, J13.2
/BRAKE_SENSE_P: J1.14, J13.1
/BSPD_IND_LIGHT: J1.16, J11.4
/BSPD_RESET_BUTTON: J1.15, J11.2
/DCDC_CONTROL: J1.23, J18.3, TP1.1
/DC_CONTROL: D1.2 (A), J1.24, J18.4
/HVpresent_ACC: J18.2
/IMD_FAULT_SIG: J1.22, J18.5
/IMD_IND_LIGHT: J1.18, J10.4, J15.3
/IMD_RESET_BUTTON: J1.17, J10.2
/RTML_AMBER+: J1.6, J17.6
/RTML_AMBER-: J1.5, J17.7
/SCout: J1.25, J1.26, J6.2
/SCoutBOX: J8.1, J14.1, J14.2
/TSSI_GREEN+: J1.10, J17.1
/TSSI_GREEN-: J1.9, J17.2
/TSSI_RED+: J1.8, J17.3
/TSSI_RED-: J1.7, J17.4
GND: J1.1, J1.2, J2.1, J3.1, J4.1, J9.1, J9.3, J10.1, J10.3, J11.1, J11.3, J15.2, J15.4, J15.6
unnamed: D1.1 (K), JP1.3 (B)
unnamed: J6.1, J7.2
unnamed: J7.1, J8.2
unnamed: J12.1, J16.1
unnamed: J12.2, J16.3
unnamed: J15.5, JP1.2 (C)
VBUS: J1.27, J1.28, J1.29, J1.30, J2.2, J3.2, J4.2, JP1.1 (A)

Notes on the sheet:
M12-T-2P
M8-A-4P
M12-X-8P
M8-A-3P
M12-A-6P
V1.0 1st commit, Galexy manufactured V1.1 change TSSI_RTML connector pinout to match 6p connector (5->6, 6->7) change dash SB light power source change reset button connector to JST 2.0
M8-A-6P

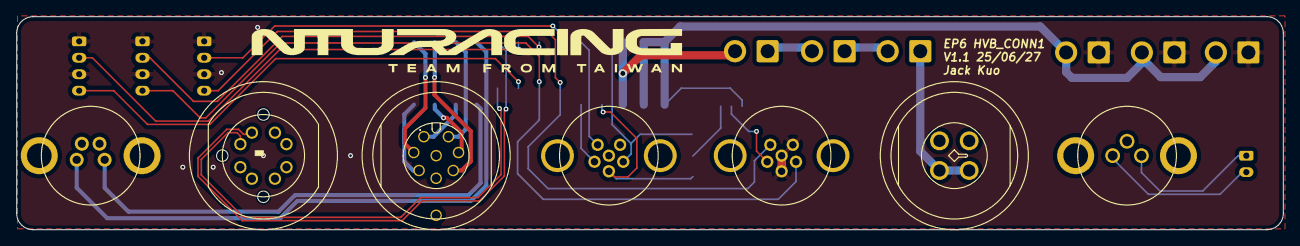
[picture p69: board HVB_CONN1.kicad_pcb from above]

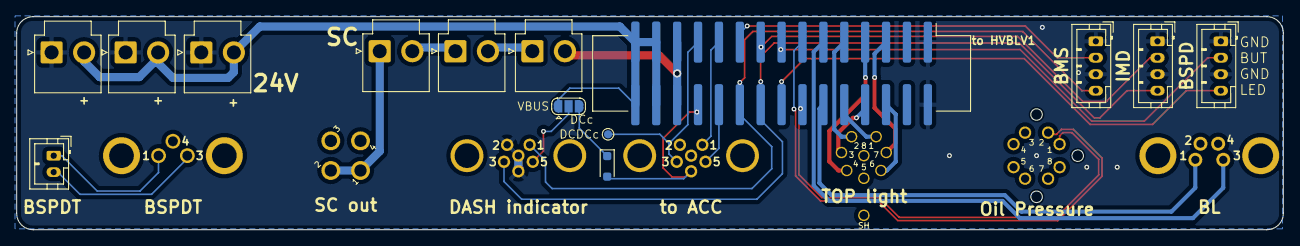
[picture p70: board HVB_CONN1.kicad_pcb from below]

Board: 2 copper layers, 154.0 x 25.9 mm, 21 parts (14 on the bottom side), 30 nets.
