NTURacingTeam/nturt_kicad/EP6/Electrical_Group/6S_BMS_CONN1/6S_BMS_CONN1.kicad_pcb

## KiCad design EP6/Electrical_Group/6S_BMS_CONN1/6S_BMS_CONN1.kicad_pcb (2025-06-29)

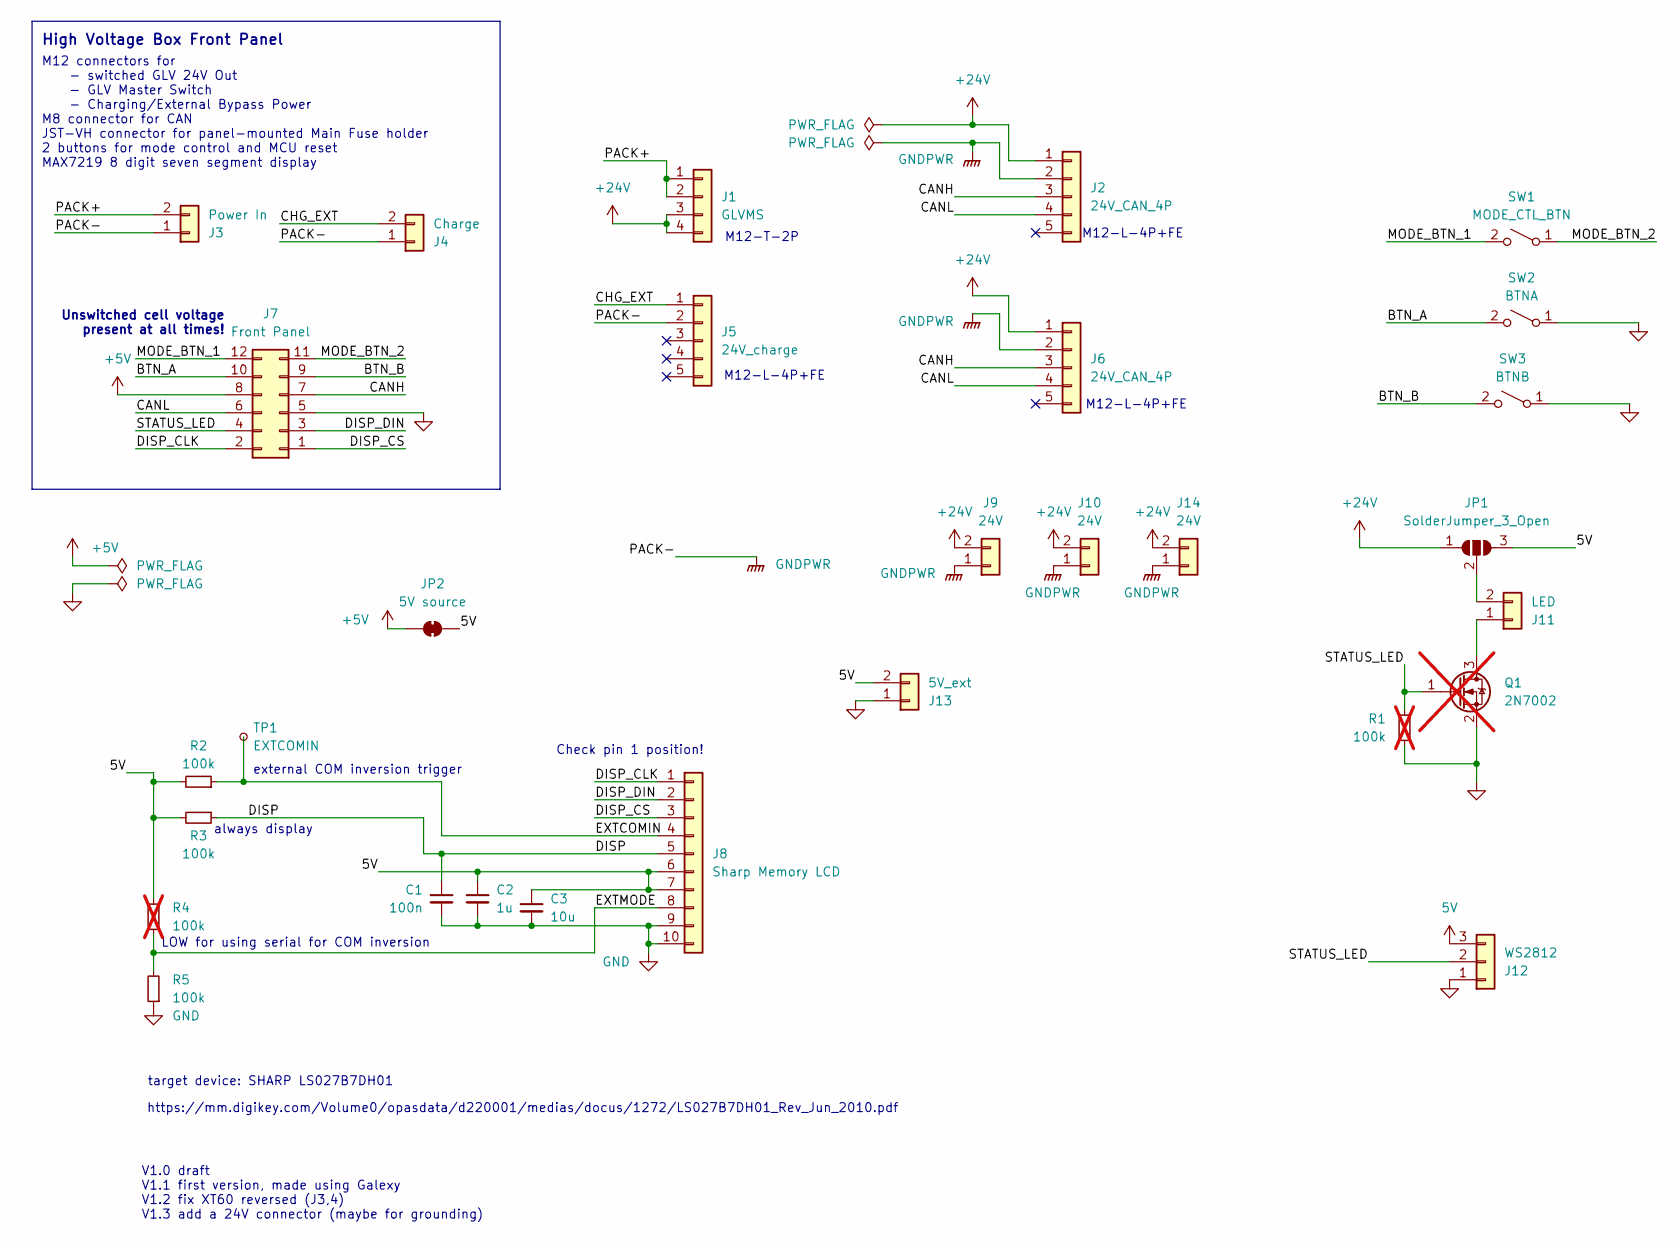
[picture p71: schematic 6S_BMS_CONN1.kicad_sch]

Parts:
C1: 100n; C_0603_1608Metric_Pad1.08x0.95mm_HandSolder
C2: 1u; C_0603_1608Metric_Pad1.08x0.95mm_HandSolder
C3: 10u; C_0603_1608Metric_Pad1.08x0.95mm_HandSolder
J1: GLVMS; NianYeong-M12-T-M4P
J2, J6: 24V_CAN_4P; NianYeong-M12-L-F5P
J3: Power In; AMASS_XT60PW-M_1x02_P7.20mm_Horizontal
J4: Charge; AMASS_XT60PW-F_1x02_P7.20mm_Horizontal
J5: 24V_charge; NianYeong-M12-L-F5P
J7: Front Panel; IDC-Header_2x06_P2.54mm_Horizontal
J8: Sharp Memory LCD; Hirose_FH12-10S-0.5SH_1x10-1MP_P0.50mm_Horizontal
J9, J10, J14: 24V; JST_VH_B2P-VH_1x02_P3.96mm_Vertical
J11: LED; JST_PH_S2B-PH-K_1x02_P2.00mm_Horizontal
J12: WS2812; JST_PH_B3B-PH-K_1x03_P2.00mm_Vertical
J13: 5V_ext; JST_XH_B2B-XH-A_1x02_P2.50mm_Vertical
JP1: SolderJumper_3_Open; SolderJumper-3_P1.3mm_Open_RoundedPad1.0x1.5mm
JP2: 5V source; SolderJumper-2_P1.3mm_Bridged2Bar_RoundedPad1.0x1.5mm
Q1: 2N7002; SOT-23; not fitted
R1, R4: 100k; R_0603_1608Metric; not fitted
R2, R3, R5: 100k; R_0603_1608Metric
SW1: MODE_CTL_BTN; JST_PH_S2B-PH-K_1x02_P2.00mm_Horizontal
SW2: BTNA; JST_PH_S2B-PH-K_1x02_P2.00mm_Horizontal
SW3: BTNB; JST_PH_S2B-PH-K_1x02_P2.00mm_Horizontal
TP1: EXTCOMIN; TestPoint_Pad_D1.0mm

Connections:
5V: C2.1, C3.1, J8.6, J8.7, J12.3, J13.2, JP1.3 (B), JP2.2 (B), R2.2, R3.2, R4.2
+5V: J7.8, JP2.1 (A)
+24V: J1.3, J1.4, J2.1, J6.1, J9.2, J10.2, J14.2, JP1.1 (A)
/BTN_A: J7.10, SW2.2 (B)
/BTN_B: J7.9, SW3.2 (B)
/CANH: J2.3, J6.3, J7.7
/CANL: J2.4, J6.4, J7.6
/CHG_EXT: J4.2, J5.1
/DISP: C1.1, J8.5, R3.1
/DISP_CLK: J7.2, J8.1
/DISP_CS: J7.1, J8.3
/DISP_DIN: J7.3, J8.2
/EXTCOMIN: J8.4, R2.1, TP1.1
/EXTMODE: J8.8, R4.1, R5.2
/MODE_BTN_1: J7.12, SW1.2 (B)
/MODE_BTN_2: J7.11, SW1.1 (A)
/PACK+: J1.1, J1.2, J3.2
/STATUS_LED: J7.4, J12.2, Q1.1 (G), R1.2
GND: C1.2, C2.2, C3.2, J7.5, J8.9, J8.10, J12.1, J13.1, Q1.2 (S), R1.1, R5.1, SW2.1 (A), SW3.1 (A)
GNDPWR: J2.2, J3.1, J4.1, J5.2, J6.2, J9.1, J10.1, J14.1
unnamed: J11.1, Q1.3 (D)
unnamed: J11.2, JP1.2 (C)

Notes on the sheet:
High Voltage Box Front Panel
Check pin 1 position!
always display
M12-L-4P+FE
LOW for using serial for COM inversion
V1.0 draft V1.1 first version, made using Galexy V1.2 fix XT60 reversed (J3,4) V1.3 add a 24V connector (maybe for grounding)
Unswitched cell voltage present at all times!
M12 connectors for - switched GLV 24V Out - GLV Master Switch - Charging/External Bypass Power M8 connector for CAN JST-VH connector for panel-mounted Main Fuse holder 2 buttons for mode control and MCU reset MAX7219 8 digit seven segment display
M12-T-2P
https://mm.digikey.com/Volume0/opasdata/d220001/medias/docus/1272/LS027B7DH01_Rev_Jun_2010.pdf
target device: SHARP LS027B7DH01
external COM inversion trigger

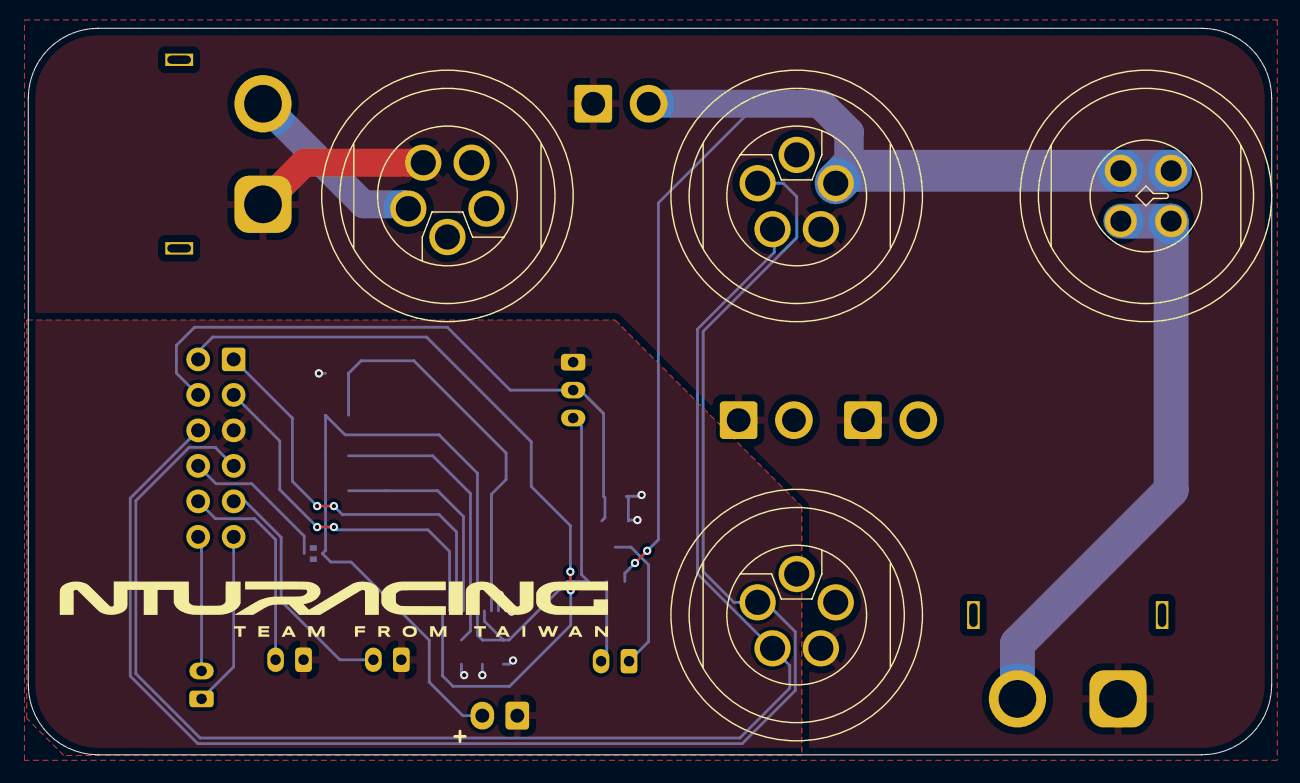
[picture p72: board 6S_BMS_CONN1.kicad_pcb from above]

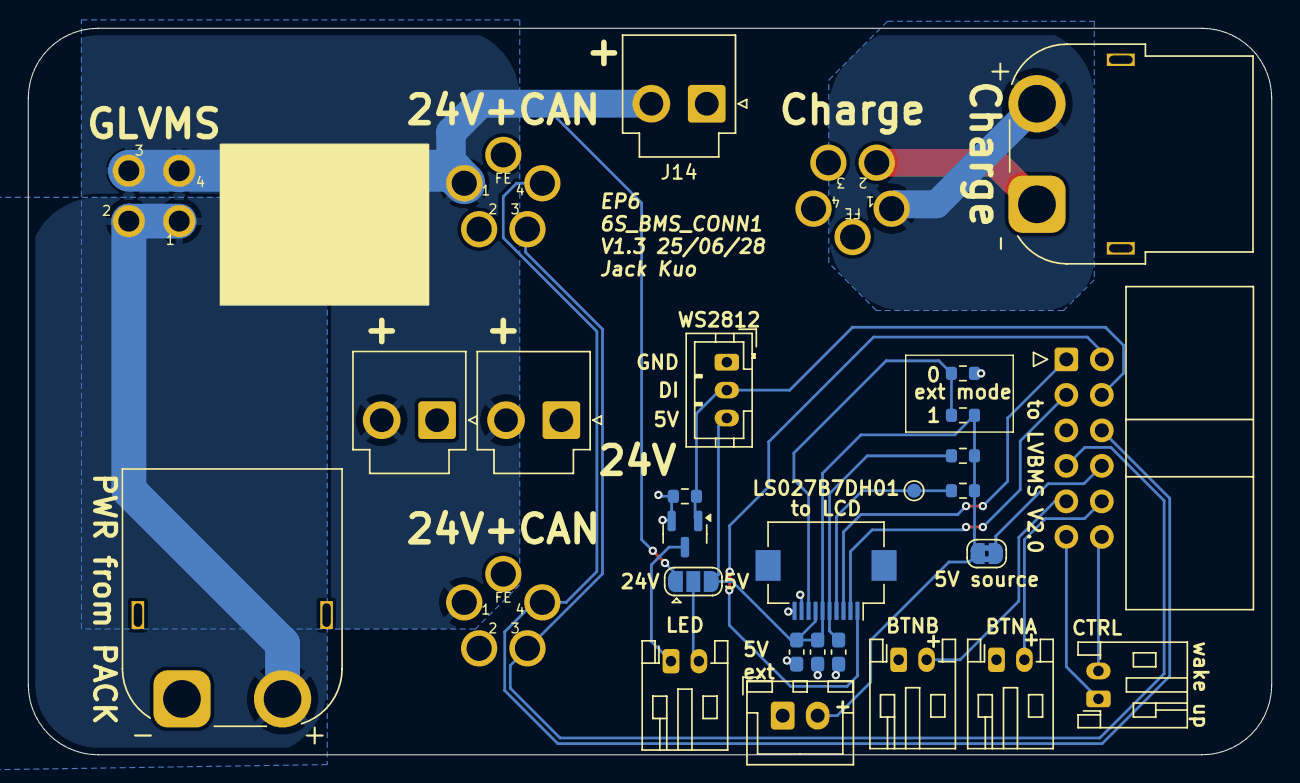
[picture p73: board 6S_BMS_CONN1.kicad_pcb from below]

Board: 2 copper layers, 89.0 x 52.0 mm, 29 parts (25 on the bottom side), 22 nets.
