NTURacingTeam/nturt_kicad/EP6/Electrical_Group/6S_BMS/6S_BMS.kicad_pcb

## KiCad design EP6/Electrical_Group/6S_BMS/6S_BMS.kicad_pcb (2025-05-21)

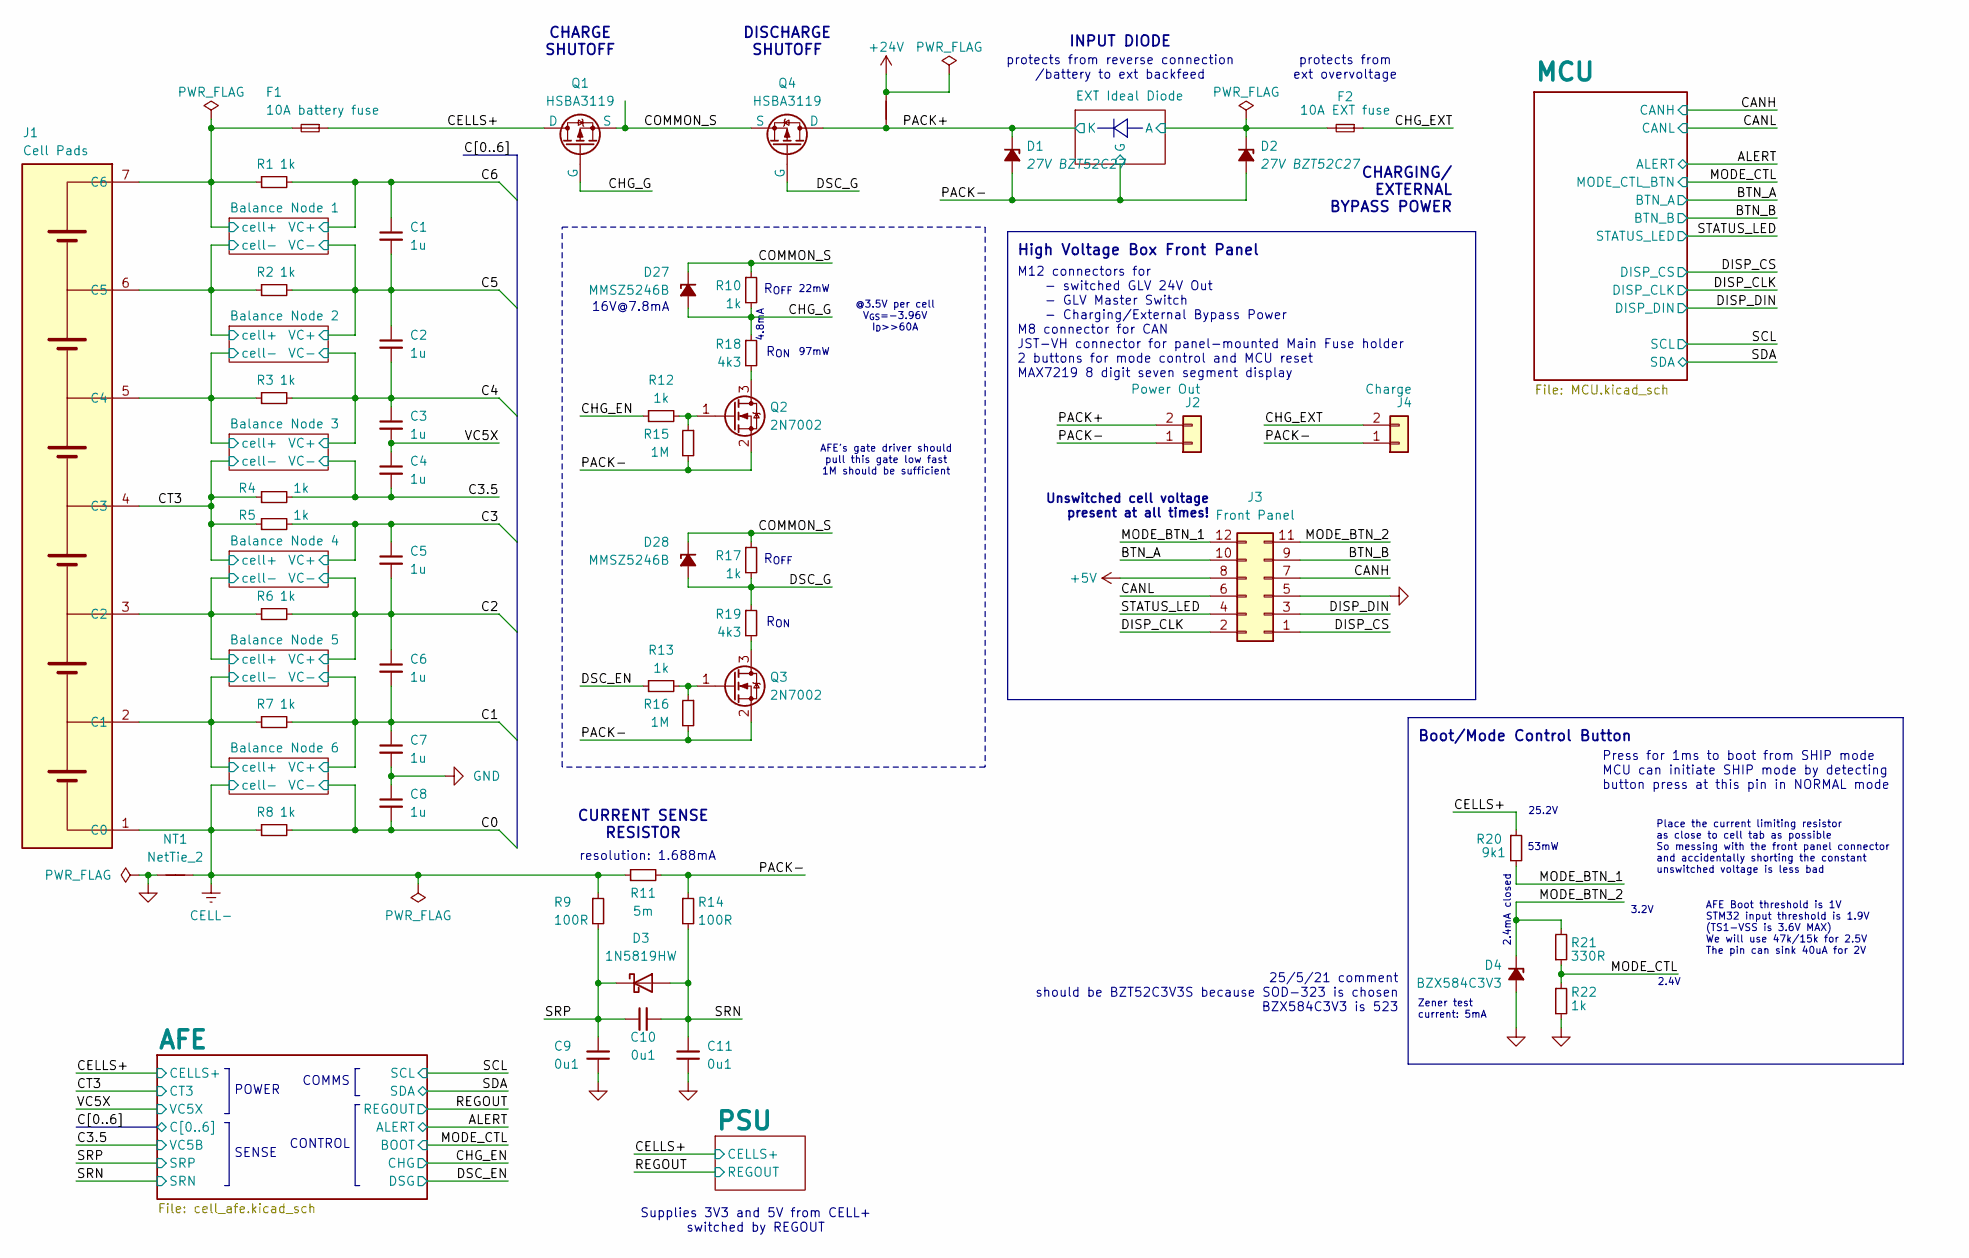
[picture p74: schematic 6S_BMS.kicad_sch]

Parts:
C1, C2, C3, C4, C5, C6, C7, C8: 1u; C_0402_1005Metric
C9, C10, C11: 0u1; C_0402_1005Metric
D1, D2: 27V BZT52C27; D_SOD-123
D3: 1N5819HW; D_SOD-123
D4: BZX584C3V3; D_SOD-323
D27, D28: MMSZ5246B; D_SOD-123
F1: 10A battery fuse; Fuse_1210_3225Metric_Pad1.42x2.65mm_HandSolder
F2: 10A EXT fuse; Fuse_1210_3225Metric_Pad1.42x2.65mm_HandSolder
J1: Cell Pads; 6S_batteries_100mm_across
J2: Power Out; AMASS_XT60PW-F_1x02_P7.20mm_Horizontal
J3: Front Panel; IDC-Header_2x06_P2.54mm_Horizontal
J4: Charge; AMASS_XT60PW-M_1x02_P7.20mm_Horizontal
NT1: NetTie_2; NetTie-2_SMD_Pad2.0mm
NT2: NetTie_2
Q1, Q4: HSBA3119; HSBA3119_PRPAK5X6
Q2, Q3: 2N7002; SOT-23
R1, R2, R3, R4, R5, R6, R7, R8, R12, R13, R22: 1k; R_0402_1005Metric
R9, R14: 100R; R_0402_1005Metric
R10, R17: 1k; R_0805_2012Metric
R11: 5m; R_2512_6332Metric
R15, R16: 1M; R_0402_1005Metric
R18, R19: 4k3; R_0805_2012Metric
R20: 9k1; R_0805_2012Metric
R21: 330R; R_0402_1005Metric

Connections:
+5V: J3.8; also elsewhere on the board
/BTN_A: J3.10; also elsewhere on the board
/BTN_B: J3.9; also elsewhere on the board
/Balance Node 1/cell+: F1.2, J1.7 (C6), R1.1; also elsewhere on the board
/Balance Node 1/cell-: J1.6 (C5), R2.1; also elsewhere on the board
/Balance Node 2/cell-: J1.5 (C4), R3.1; also elsewhere on the board
/Balance Node 4/cell-: J1.3 (C2), R6.1; also elsewhere on the board
/Balance Node 5/cell-: J1.2 (C1), R7.1; also elsewhere on the board
/C0: C8.2, R8.2; also elsewhere on the board
/C1: C6.2, C7.1, R7.2; also elsewhere on the board
/C2: C5.2, C6.1, R6.2; also elsewhere on the board
/C3: C5.1, R5.2; also elsewhere on the board
/C3.5: C4.2, R4.2; also elsewhere on the board
/C4: C2.2, C3.1, R3.2; also elsewhere on the board
/C5: C1.2, C2.1, R2.2; also elsewhere on the board
/C6: C1.1, R1.2; also elsewhere on the board
/CANH: J3.7; also elsewhere on the board
/CANL: J3.6; also elsewhere on the board
/CELLS+: F1.1, Q1.D, R20.1; also elsewhere on the board
/CHG_EN: R12.1; also elsewhere on the board
/CHG_EXT: F2.1, J4.2
/CHG_G: D27.2 (A), Q1.G, R10.2, R18.1
/COMMON_S: D27.1 (K), D28.1 (K), Q1.S, Q4.S, R10.1, R17.1
/CT3: J1.4 (C3), R4.1, R5.1; also elsewhere on the board
/DISP_CLK: J3.2; also elsewhere on the board
/DISP_CS: J3.1; also elsewhere on the board
/DISP_DIN: J3.3; also elsewhere on the board
/DSC_EN: R13.1; also elsewhere on the board
/DSC_G: D28.2 (A), Q4.G, R17.2, R19.1
/EXT Ideal Diode/A: D2.1 (K), F2.2; also elsewhere on the board
/MODE_BTN_1: J3.12, R20.2
/MODE_BTN_2: D4.1 (K), J3.11, R21.2
/MODE_CTL: R21.1, R22.1; also elsewhere on the board
/PACK+: D1.1 (K), J2.2, NT2.1, Q4.D; also elsewhere on the board
/PACK-: D1.2 (A), D2.2 (A), J2.1, J4.1, Q2.2 (S), Q3.2 (S), R11.2, R14.1, R15.2, R16.2; also elsewhere on the board
/SRN: C10.2, C11.2, D3.2 (A), R14.2; also elsewhere on the board
/SRP: C9.2, C10.1, D3.1 (K), R9.2; also elsewhere on the board
/STATUS_LED: J3.4; also elsewhere on the board
/VC5X: C3.2, C4.1; also elsewhere on the board
CELL-: J1.1 (C0), NT1.2, R8.1, R9.1, R11.1; also elsewhere on the board
GND: C7.2, C8.1, C9.1, C11.1, D4.2 (A), J3.5, NT1.1, R22.2; also elsewhere on the board
unnamed: Q2.3 (D), R18.2
unnamed: Q2.1 (G), R12.2, R15.1
unnamed: Q3.3 (D), R19.2
unnamed: Q3.1 (G), R13.2, R16.1

Notes on the sheet:
CHARGE SHUTOFF
53mW
4.8mA
3.2V
DISCHARGE SHUTOFF
Unswitched cell voltage present at all times!
COMMS
Place the current limiting resistor as close to cell tab as possible So messing with the front panel connector and accidentally shorting the constant unswitched voltage is less bad
R_{OFF}
POWER
protects from ext overvoltage
protects from reverse connection /battery to ext backfeed
INPUT DIODE
97mW
Zener test current: 5mA
Supplies 3V3 and 5V from CELL+ switched by REGOUT
Boot/Mode Control Button
25.2V
CHARGING/ EXTERNAL BYPASS POWER
AFE Boot threshold is 1V STM32 input threshold is 1.9V (TS1-VSS is 3.6V MAX) We will use 47k/15k for 2.5V The pin can sink 40uA for 2V
@3.5V per cell V_{GS}=-3.96V I_{D}>>60A
M12 connectors for - switched GLV 24V Out - GLV Master Switch - Charging/External Bypass Power M8 connector for CAN JST-VH connector for panel-mounted Main Fuse holder 2 buttons for mode control and MCU reset MAX7219 8 digit seven segment display
2.4mA closed
25/5/21 comment should be BZT52C3V3S because SOD-323 is chosen BZX584C3V3 is 523
resolution: 1.688mA
R_{ON}
CONTROL
High Voltage Box Front Panel
CURRENT SENSE RESISTOR
Press for 1ms to boot from SHIP mode MCU can initiate SHIP mode by detecting button press at this pin in NORMAL mode
AFE's gate driver should pull this gate low fast 1M should be sufficient
22mW
SENSE
16V@7.8mA
2.4V

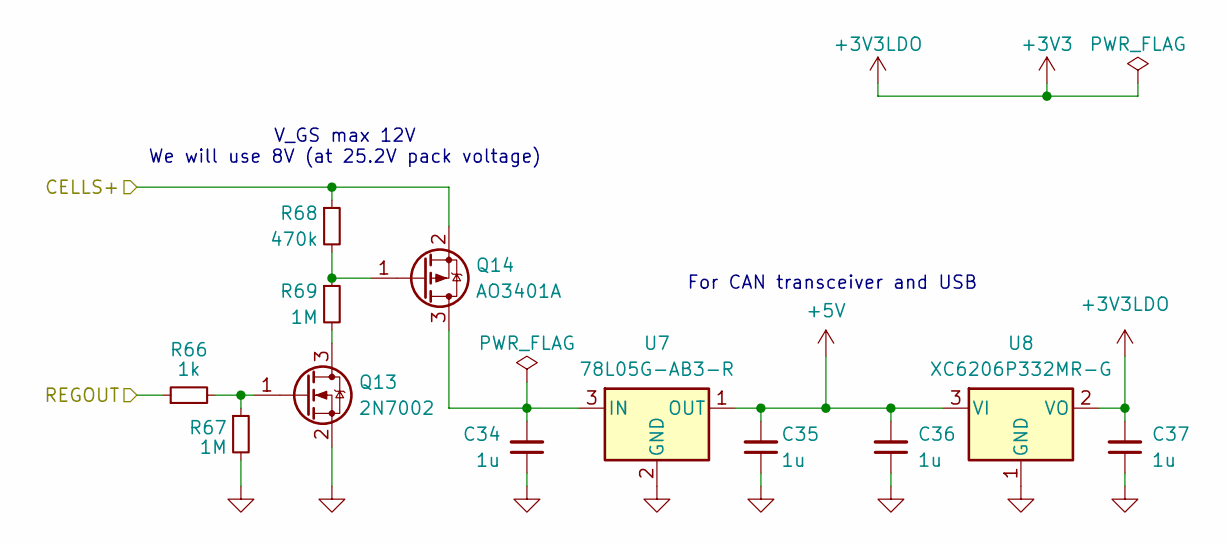
[picture p75: schematic psu.kicad_sch, 6S_BMS]

Parts:
C34: 1u; C_0603_1608Metric
C35, C36, C37: 1u; C_0402_1005Metric
Q13: 2N7002; SOT-23
Q14: AO3401A; SOT-23
R66: 1k; R_0402_1005Metric
R67, R69: 1M; R_0402_1005Metric
R68: 470k; R_0402_1005Metric
U7: 78L05G-AB3-R; SOT-89-3
U8: XC6206P332MR-G; SOT-23-3

Connections:
+3V3: C37.2, U8.2 (VO); also elsewhere on the board
+5V: C35.2, C36.2, U7.1 (OUT), U8.3 (VI); also elsewhere on the board
/CELLS+: Q14.2 (S), R68.1; also elsewhere on the board
/REGOUT: R66.1; also elsewhere on the board
GND: C34.1, C35.1, C36.1, C37.1, Q13.2 (S), R67.2, U7.2 (GND), U8.1 (GND); also elsewhere on the board
unnamed: Q13.3 (D), R69.2
unnamed: Q13.1 (G), R66.2, R67.1
unnamed: C34.2, Q14.3 (D), U7.3 (IN)
unnamed: Q14.1 (G), R68.2, R69.1

Notes on the sheet:
For CAN transceiver and USB
V_GS max 12V We will use 8V (at 25.2V pack voltage)

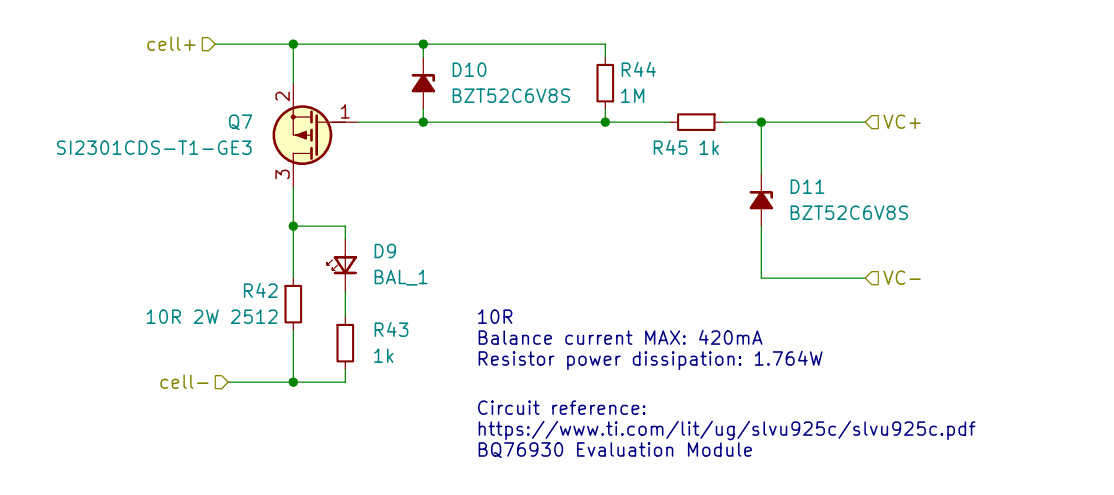
[picture p76: schematic balance_node_1.kicad_sch, 6S_BMS]

Parts:
D9: BAL_1; LED_0603_1608Metric
D10, D11: BZT52C6V8S; D_SOD-323
Q7: SI2301CDS-T1-GE3; SOT-23
R42: 10R 2W 2512; R_2512_6332Metric
R43, R45: 1k; R_0402_1005Metric
R44: 1M; R_0402_1005Metric

Connections:
/Balance Node 1/cell+: D10.1 (K), Q7.2 (S), R44.2; also elsewhere on the board
/Balance Node 1/cell-: R42.2, R43.2; also elsewhere on the board
/C5: D11.2 (A); also elsewhere on the board
/C6: D11.1 (K), R45.1; also elsewhere on the board
unnamed: D9.2 (A), Q7.3 (D), R42.1
unnamed: D9.1 (K), R43.1
unnamed: D10.2 (A), Q7.1 (G), R44.1, R45.2

Parts of its further copies:
D12, D15, D18, D21, D24: BAL_1; LED_0603_1608Metric
D13, D14, D16, D17, D19, D20, D22, D23, D25, D26: BZT52C6V8S; D_SOD-323
Q8, Q9, Q10, Q11, Q12: SI2301CDS-T1-GE3; SOT-23
R46, R50, R54, R58, R62: 10R 2W 2512; R_2512_6332Metric
R47, R49, R51, R53, R55, R57, R59, R61, R63, R65: 1k; R_0402_1005Metric
R48, R52, R56, R60, R64: 1M; R_0402_1005Metric

Connections of its further copies:
/Balance Node 1/cell-: D13.1 (K), Q8.2 (S), R48.2; also elsewhere on the board
/Balance Node 2/cell-: D16.1 (K), Q9.2 (S), R46.2, R47.2, R52.2; also elsewhere on the board
/Balance Node 4/cell-: D22.1 (K), Q11.2 (S), R54.2, R55.2, R60.2; also elsewhere on the board
/Balance Node 5/cell-: D25.1 (K), Q12.2 (S), R58.2, R59.2, R64.2; also elsewhere on the board
/C0: D26.2 (A); also elsewhere on the board
/C1: D23.2 (A), D26.1 (K), R65.1; also elsewhere on the board
/C2: D20.2 (A), D23.1 (K), R61.1; also elsewhere on the board
/C3: D20.1 (K), R57.1; also elsewhere on the board
/C3.5: D17.2 (A); also elsewhere on the board
/C4: D14.2 (A), D17.1 (K), R53.1; also elsewhere on the board
/C5: D14.1 (K), R49.1; also elsewhere on the board
/CT3: D19.1 (K), Q10.2 (S), R50.2, R51.2, R56.2; also elsewhere on the board
CELL-: R62.2, R63.2; also elsewhere on the board
unnamed: D12.2 (A), Q8.3 (D), R46.1
unnamed: D12.1 (K), R47.1
unnamed: D13.2 (A), Q8.1 (G), R48.1, R49.2
unnamed: D15.2 (A), Q9.3 (D), R50.1
unnamed: D15.1 (K), R51.1
unnamed: D16.2 (A), Q9.1 (G), R52.1, R53.2
unnamed: D18.2 (A), Q10.3 (D), R54.1
unnamed: D18.1 (K), R55.1
unnamed: D19.2 (A), Q10.1 (G), R56.1, R57.2
unnamed: D21.2 (A), Q11.3 (D), R58.1
unnamed: D21.1 (K), R59.1
unnamed: D22.2 (A), Q11.1 (G), R60.1, R61.2
unnamed: D24.2 (A), Q12.3 (D), R62.1
unnamed: D24.1 (K), R63.1
unnamed: D25.2 (A), Q12.1 (G), R64.1, R65.2

Notes on the sheet:
10R Balance current MAX: 420mA Resistor power dissipation: 1.764W
Circuit reference: https://www.ti.com/lit/ug/slvu925c/slvu925c.pdf BQ76930 Evaluation Module

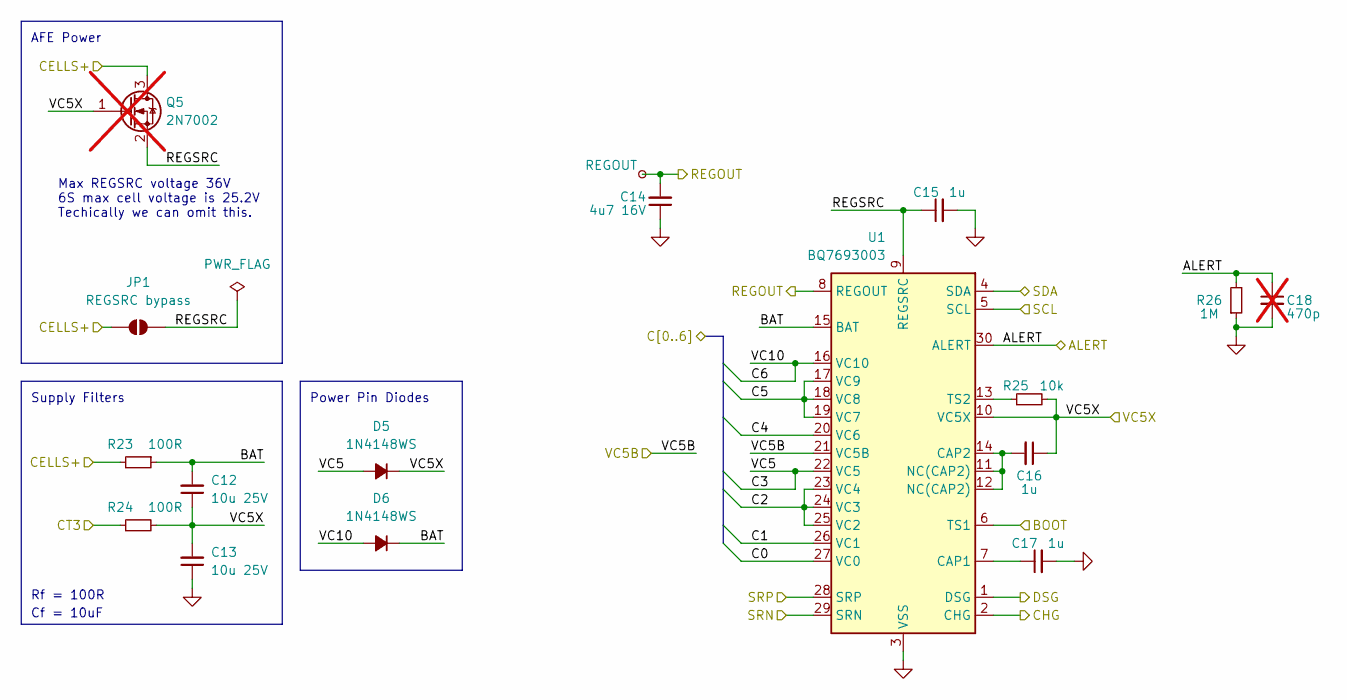
[picture p77: schematic cell_afe.kicad_sch, 6S_BMS]

Parts:
C12, C13: 10u 25V; C_0805_2012Metric
C14: 4u7 16V; C_0603_1608Metric
C15: 1u; C_0603_1608Metric
C16, C17: 1u; C_0402_1005Metric
C18: 470p; C_0402_1005Metric; not fitted
D5, D6: 1N4148WS; D_SOD-323
JP1: REGSRC bypass; SolderJumper-2_P1.3mm_Open_TrianglePad1.0x1.5mm
Q5: 2N7002; SOT-23; not fitted
R23, R24: 100R; R_0402_1005Metric
R25: 10k; R_0402_1005Metric
R26: 1M; R_0402_1005Metric
TP12: REGOUT; TestPoint_Pad_D1.0mm
U1: BQ7693003; TSSOP-30_4.4x7.8mm_P0.5mm

Connections:
/AFE/BAT: C12.2, D6.1 (K), R23.1, U1.15 (BAT)
/AFE/REGSRC: C15.1, JP1.1 (A), Q5.2 (S), U1.9 (REGSRC)
/ALERT: C18.1, R26.2, U1.30 (ALERT); also elsewhere on the board
/C0: U1.27 (VC0); also elsewhere on the board
/C1: U1.26 (VC1); also elsewhere on the board
/C2: U1.23 (VC4), U1.24 (VC3), U1.25 (VC2); also elsewhere on the board
/C3: D5.2 (A), U1.22 (VC5); also elsewhere on the board
/C3.5: U1.21 (VC5B); also elsewhere on the board
/C4: U1.20 (VC6); also elsewhere on the board
/C5: U1.17 (VC9), U1.18 (VC8), U1.19 (VC7); also elsewhere on the board
/C6: D6.2 (A), U1.16 (VC10); also elsewhere on the board
/CELLS+: JP1.2 (B), Q5.3 (D), R23.2; also elsewhere on the board
/CHG_EN: U1.2 (CHG); also elsewhere on the board
/CT3: R24.1; also elsewhere on the board
/DSC_EN: U1.1 (DSG); also elsewhere on the board
/MODE_CTL: U1.6 (TS1); also elsewhere on the board
/REGOUT: C14.2, TP12.1, U1.8 (REGOUT); also elsewhere on the board
/SCL: U1.5 (SCL); also elsewhere on the board
/SDA: U1.4 (SDA); also elsewhere on the board
/SRN: U1.29 (SRN); also elsewhere on the board
/SRP: U1.28 (SRP); also elsewhere on the board
/VC5X: C12.1, C13.2, C16.1, D5.1 (K), Q5.1 (G), R24.2, R25.2, U1.10 (VC5X); also elsewhere on the board
GND: C13.1, C14.1, C15.2, C17.2, C18.2, R26.1, U1.3 (VSS); also elsewhere on the board
unnamed: C17.1, U1.7 (CAP1)
unnamed: C16.2, U1.11 (NC(CAP2)), U1.12 (NC(CAP2)), U1.14 (CAP2)
unnamed: R25.1, U1.13 (TS2)

Notes on the sheet:
Max REGSRC voltage 36V 6S max cell voltage is 25.2V Techically we can omit this.
AFE Power
Cf = 10uF
Power Pin Diodes
Supply Filters
Rf = 100R

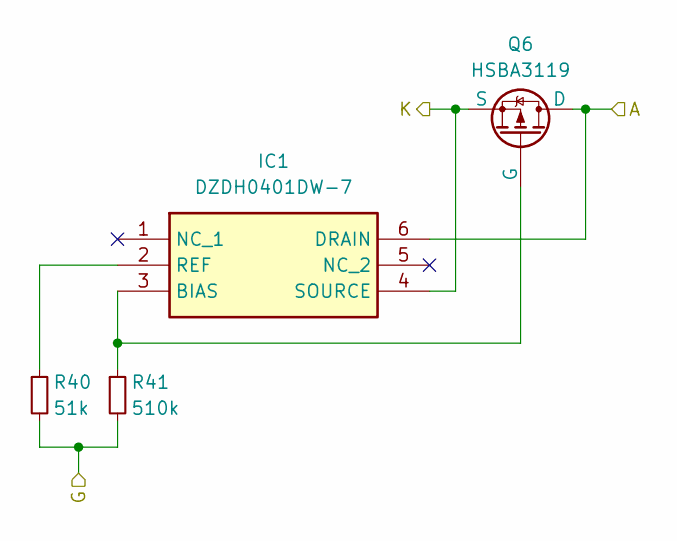
[picture p78: schematic ext_ideal_diode.kicad_sch, 6S_BMS]

Parts:
IC1: DZDH0401DW-7; SOT65P210X110-6N; Mouser Part Number 621-DZDH0401DW-7
Q6: HSBA3119; HSBA3119_PRPAK5X6
R40: 51k; R_0402_1005Metric
R41: 510k; R_0402_1005Metric

Connections:
/EXT Ideal Diode/A: IC1.6 (DRAIN), Q6.D; also elsewhere on the board
/PACK+: IC1.4 (SOURCE), Q6.S; also elsewhere on the board
/PACK-: R40.2, R41.2; also elsewhere on the board
unnamed: IC1.3 (BIAS), Q6.G, R41.1
unnamed: IC1.2 (REF), R40.1
