NTURacingTeam/nturt_kicad/EP6/Electrical_Group/6S_BMS/6S_BMS.kicad_pcb

## KiCad design EP6/Electrical_Group/6S_BMS/6S_BMS.kicad_pcb (continued)

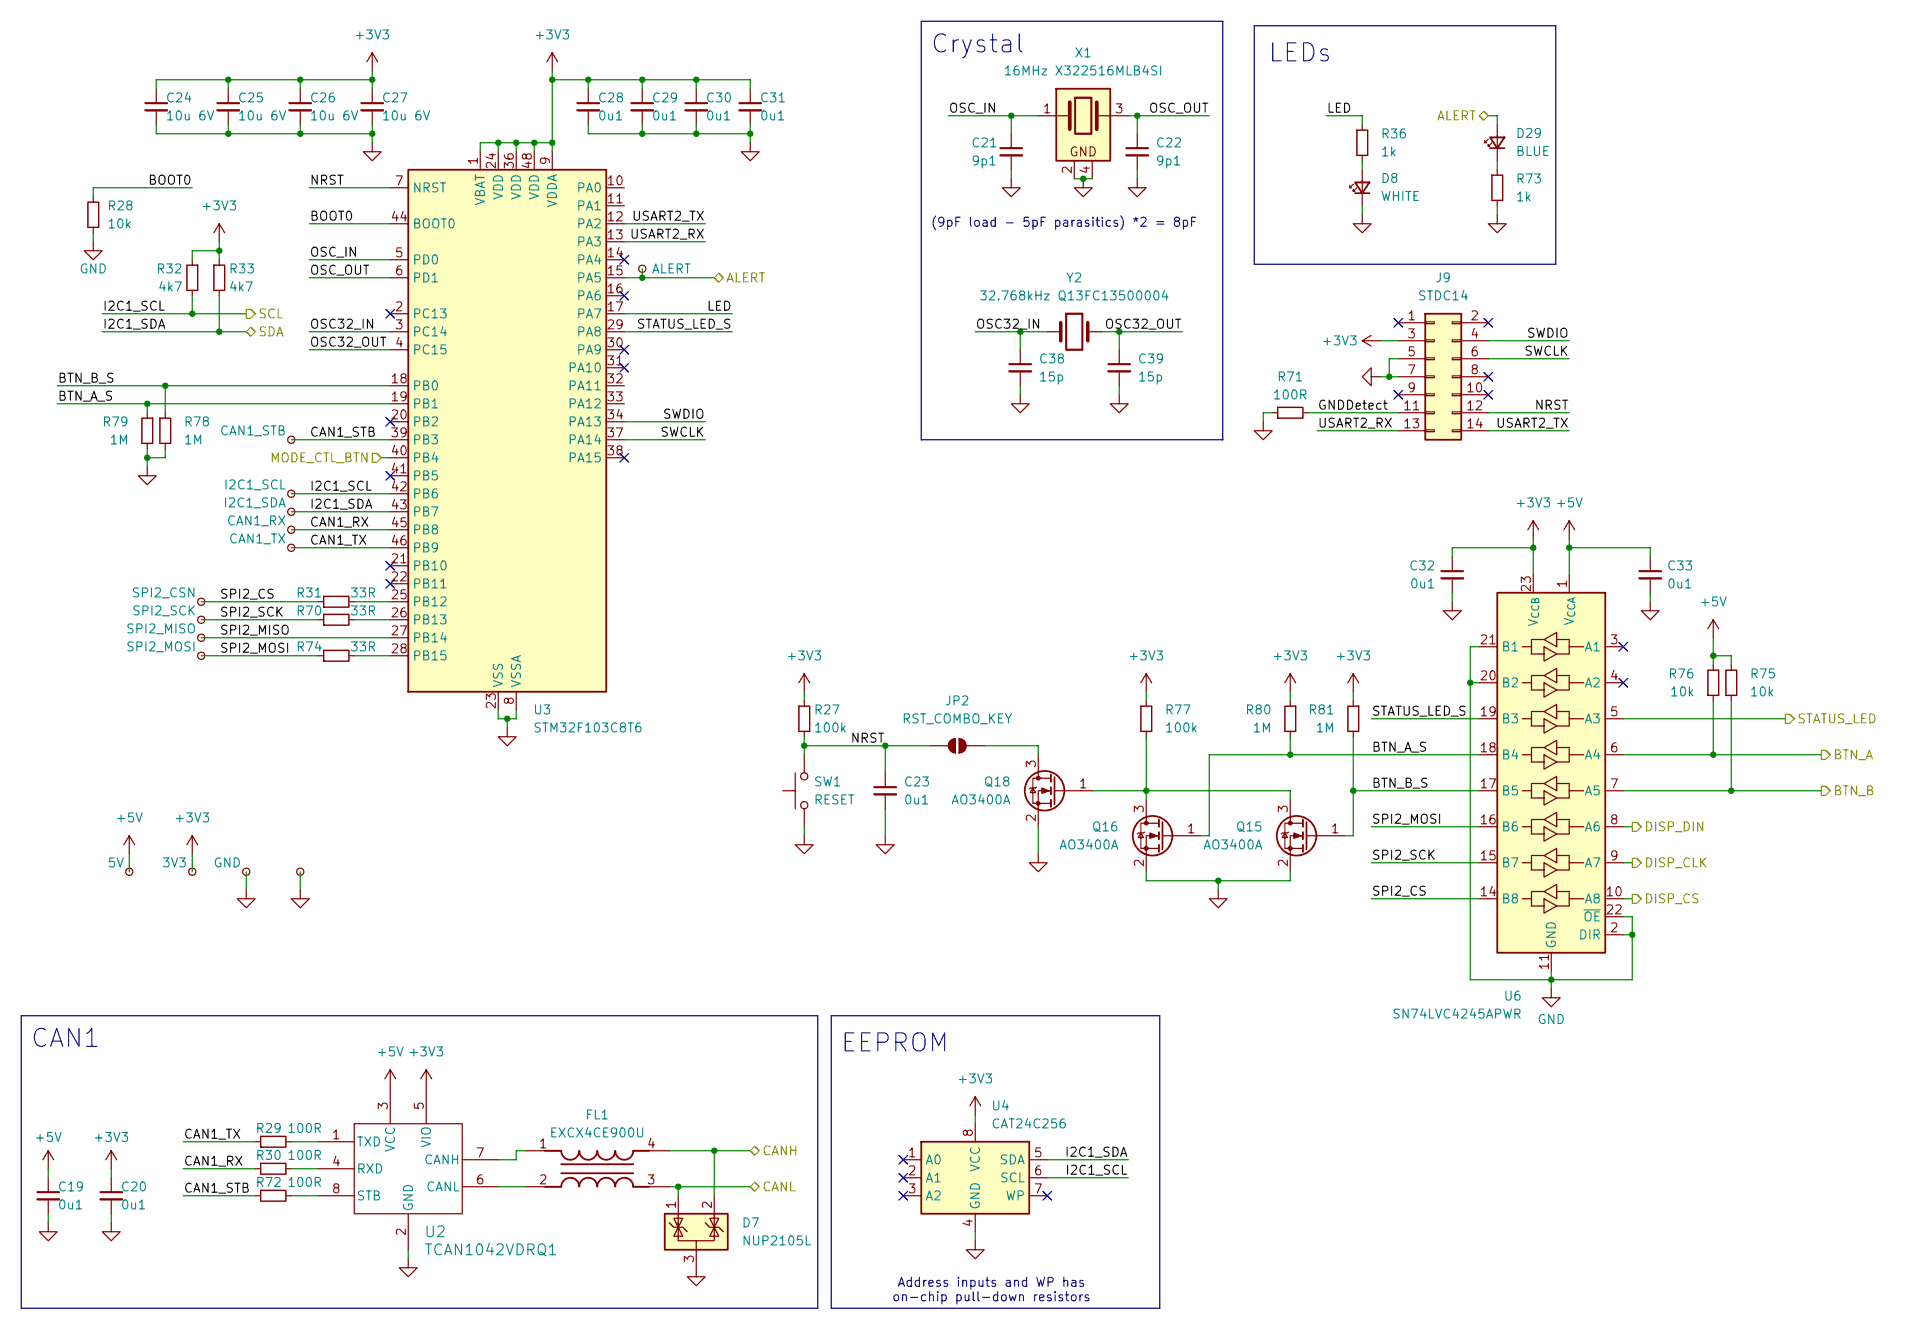
[picture p79: schematic MCU.kicad_sch, 6S_BMS]

Parts:
C19, C20, C23, C28, C29, C30, C31, C32, C33: 0u1; C_0402_1005Metric
C21, C22: 9p1; C_0402_1005Metric
C24, C25, C26, C27: 10u 6V; C_0402_1005Metric
C38, C39: 15p; C_0402_1005Metric
D7: NUP2105L; SOT-23
D8: WHITE; LED_0603_1608Metric
D29: BLUE; LED_0603_1608Metric
FL1: EXCX4CE900U; Mouser Part Number 667-EXC-X4CE900U
J9: STDC14; box_header_14P_pitch127
JP2: RST_COMBO_KEY; SolderJumper-2_P1.3mm_Open_TrianglePad1.0x1.5mm
Q15, Q16, Q18: AO3400A; SOT-23
R27, R77: 100k; R_0402_1005Metric
R28, R75, R76: 10k; R_0402_1005Metric
R29, R30, R72: 100R; R_0402_1005Metric
R31, R70, R74: 33R; R_0402_1005Metric
R32, R33: 4k7; R_0402_1005Metric
R36, R73: 1k; R_0603_1608Metric
R71: 100R; R_0603_1608Metric
R78, R79, R80, R81: 1M; R_0402_1005Metric
SW1: RESET; SW_Tactile_SPST_NO_Straight_CK_PTS636Sx25SMTRLFS
TP1: I2C1_SCL; TestPoint_Pad_D1.0mm
TP2: I2C1_SDA; TestPoint_Pad_D1.0mm
TP3: CAN1_RX; TestPoint_Pad_D1.0mm
TP4: CAN1_TX; TestPoint_Pad_D1.0mm
TP5: CAN1_STB; TestPoint_Pad_D1.0mm
TP6: SPI2_CSN; TestPoint_Pad_D1.0mm
TP7: SPI2_SCK; TestPoint_Pad_D1.0mm
TP8: SPI2_MISO; TestPoint_Pad_D1.0mm
TP9: SPI2_MOSI; TestPoint_Pad_D1.0mm
TP10: 3V3; TestPoint_Pad_D1.0mm
TP11, TP14: GND; TestPoint_Pad_D1.0mm
TP13: ALERT; TestPoint_Pad_D1.0mm
TP15: 5V; TestPoint_Pad_D1.0mm
U2: TCAN1042VDRQ1; SOIC-8_3.9x4.9mm_P1.27mm
U3: STM32F103C8T6; LQFP-48_7x7mm_P0.5mm
U4: CAT24C256; SOIC-8_3.9x4.9mm_P1.27mm
U6: SN74LVC4245APWR; TSSOP-24_4.4x7.8mm_P0.65mm
X1: 16MHz X322516MLB4SI; Crystal_SMD_3225-4Pin_3.2x2.5mm
Y2: 32.768kHz Q13FC13500004; Crystal_SMD_3215-2Pin_3.2x1.5mm

Connections:
+3V3: C20.1, C24.1, C25.1, C26.1, C27.1, C28.1, C29.1, C30.1, C31.1, C32.1, J9.3, R27.1, R32.1, R33.1, R77.1, R80.1, R81.1, TP10.1, U2.5 (VIO), U3.1 (VBAT), U3.9 (VDDA), U3.24 (VDD), U3.36 (VDD), U3.48 (VDD), U4.8 (VCC), U6.23 (V_{CCB}), U6.24 (V_{CCB}); also elsewhere on the board
+5V: C19.1, C33.1, R75.2, R76.2, TP15.1, U2.3 (VCC), U6.1 (V_{CCA}); also elsewhere on the board
/ALERT: D29.2 (A), TP13.1, U3.15 (PA5); also elsewhere on the board
/BTN_A: R76.1, U6.6 (A4); also elsewhere on the board
/BTN_B: R75.1, U6.7 (A5); also elsewhere on the board
/CANH: D7.2 (K), FL1.4; also elsewhere on the board
/CANL: D7.1 (K), FL1.3; also elsewhere on the board
/DISP_CLK: U6.9 (A7); also elsewhere on the board
/DISP_CS: U6.10 (A8); also elsewhere on the board
/DISP_DIN: U6.8 (A6); also elsewhere on the board
/MCU/BOOT0: R28.2, U3.44 (BOOT0)
/MCU/BTN_A_S: Q16.1 (G), R79.1, R80.2, U3.19 (PB1), U6.18 (B4)
/MCU/BTN_B_S: Q15.1 (G), R78.1, R81.2, U3.18 (PB0), U6.17 (B5)
/MCU/CAN1_RX: R30.1, TP3.1, U3.45 (PB8)
/MCU/CAN1_STB: R72.1, TP5.1, U3.39 (PB3)
/MCU/CAN1_TX: R29.1, TP4.1, U3.46 (PB9)
/MCU/GNDDetect: J9.11, R71.2
/MCU/LED: R36.1, U3.17 (PA7)
/MCU/NRST: C23.1, J9.12, JP2.2 (B), R27.2, SW1.2, U3.7 (NRST)
/MCU/OSC32_IN: C38.1, U3.3 (PC14), Y2.1
/MCU/OSC32_OUT: C39.1, U3.4 (PC15), Y2.2
/MCU/OSC_IN: C21.1, U3.5 (PD0), X1.1
/MCU/OSC_OUT: C22.1, U3.6 (PD1), X1.3
/MCU/SPI2_CS: R31.1, TP6.1, U6.14 (B8)
/MCU/SPI2_MISO: TP8.1, U3.27 (PB14)
/MCU/SPI2_MOSI: R74.1, TP9.1, U6.16 (B6)
/MCU/SPI2_SCK: R70.1, TP7.1, U6.15 (B7)
/MCU/STATUS_LED_S: U3.29 (PA8), U6.19 (B3)
/MCU/SWCLK: J9.6, U3.37 (PA14)
/MCU/SWDIO: J9.4, U3.34 (PA13)
/MCU/USART2_RX: J9.13, U3.13 (PA3)
/MCU/USART2_TX: J9.14, U3.12 (PA2)
/MODE_CTL: U3.40 (PB4); also elsewhere on the board
/SCL: R32.2, TP1.1, U3.42 (PB6), U4.6 (SCL); also elsewhere on the board
/SDA: R33.2, TP2.1, U3.43 (PB7), U4.5 (SDA); also elsewhere on the board
/STATUS_LED: U6.5 (A3); also elsewhere on the board
GND: C19.2, C20.2, C21.2, C22.2, C23.2, C24.2, C25.2, C26.2, C27.2, C28.2, C29.2, C30.2, C31.2, C32.2, C33.2, C38.2, C39.2, D7.3 (A), D8.1 (K), J9.5, J9.7, Q15.2 (S), Q16.2 (S), Q18.2 (S), R28.1, R71.1, R73.2, R78.2, R79.2, SW1.1, TP11.1, TP14.1, U2.2 (GND), U3.8 (VSSA), U3.23 (VSS), U3.35 (VSS), U3.47 (VSS), U4.4 (GND), U6.2 (DIR), U6.11 (GND), U6.12 (GND), U6.13 (GND), U6.20 (B2), U6.21 (B1), U6.22 (~OE), X1.2, X1.4; also elsewhere on the board
unnamed: D8.2 (A), R36.2
unnamed: D29.1 (K), R73.1
unnamed: JP2.1 (A), Q18.3 (D)
unnamed: Q15.3 (D), Q16.3 (D), Q18.1 (G), R77.2
unnamed: FL1.1, U2.7 (CANH)
unnamed: FL1.2, U2.6 (CANL)
unnamed: R30.2, U2.4 (RXD)
unnamed: R72.2, U2.8 (STB)
unnamed: R29.2, U2.1 (TXD)
unnamed: R31.2, U3.25 (PB12)
unnamed: R70.2, U3.26 (PB13)
unnamed: R74.2, U3.28 (PB15)

Notes on the sheet:
Address inputs and WP has on-chip pull-down resistors
CAN1
(9pF load - 5pF parasitics) *2 = 8pF
LEDs
Crystal
EEPROM

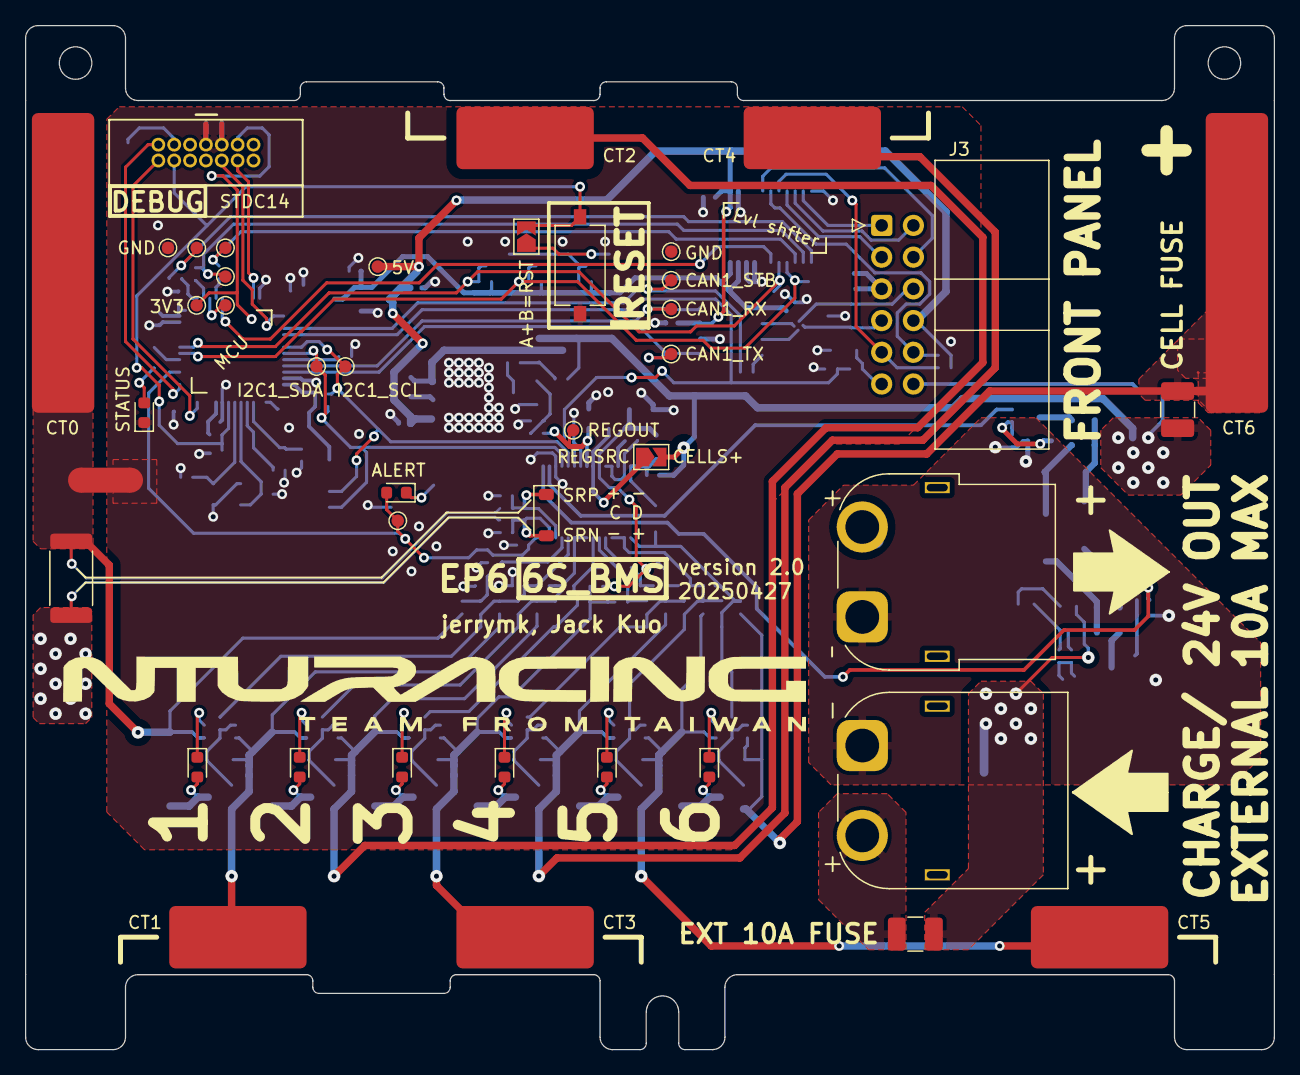
[picture p80: board 6S_BMS.kicad_pcb from above]

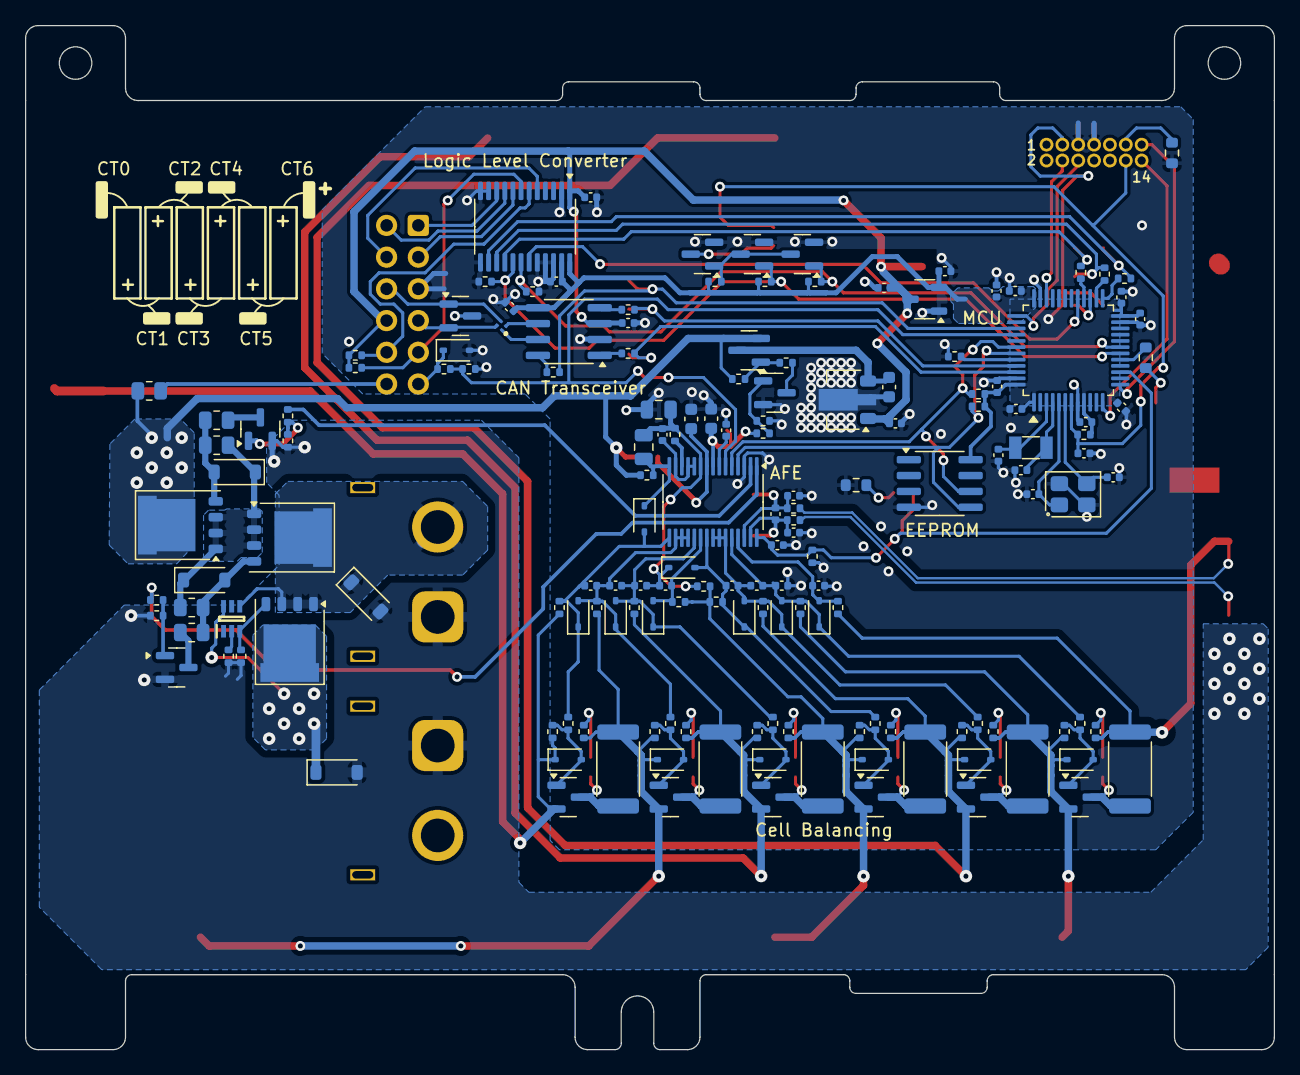
[picture p81: board 6S_BMS.kicad_pcb from below]

Board: 4 copper layers, 100.0 x 82.0 mm, 197 parts (161 on the bottom side), 113 nets.
