NTURacingTeam/nturt_kicad/EP6/Powertrain_Group/HVB_LV1/HVB_LV1.kicad_pcb

## KiCad design EP6/Powertrain_Group/HVB_LV1/HVB_LV1.kicad_pcb (2025-05-21)

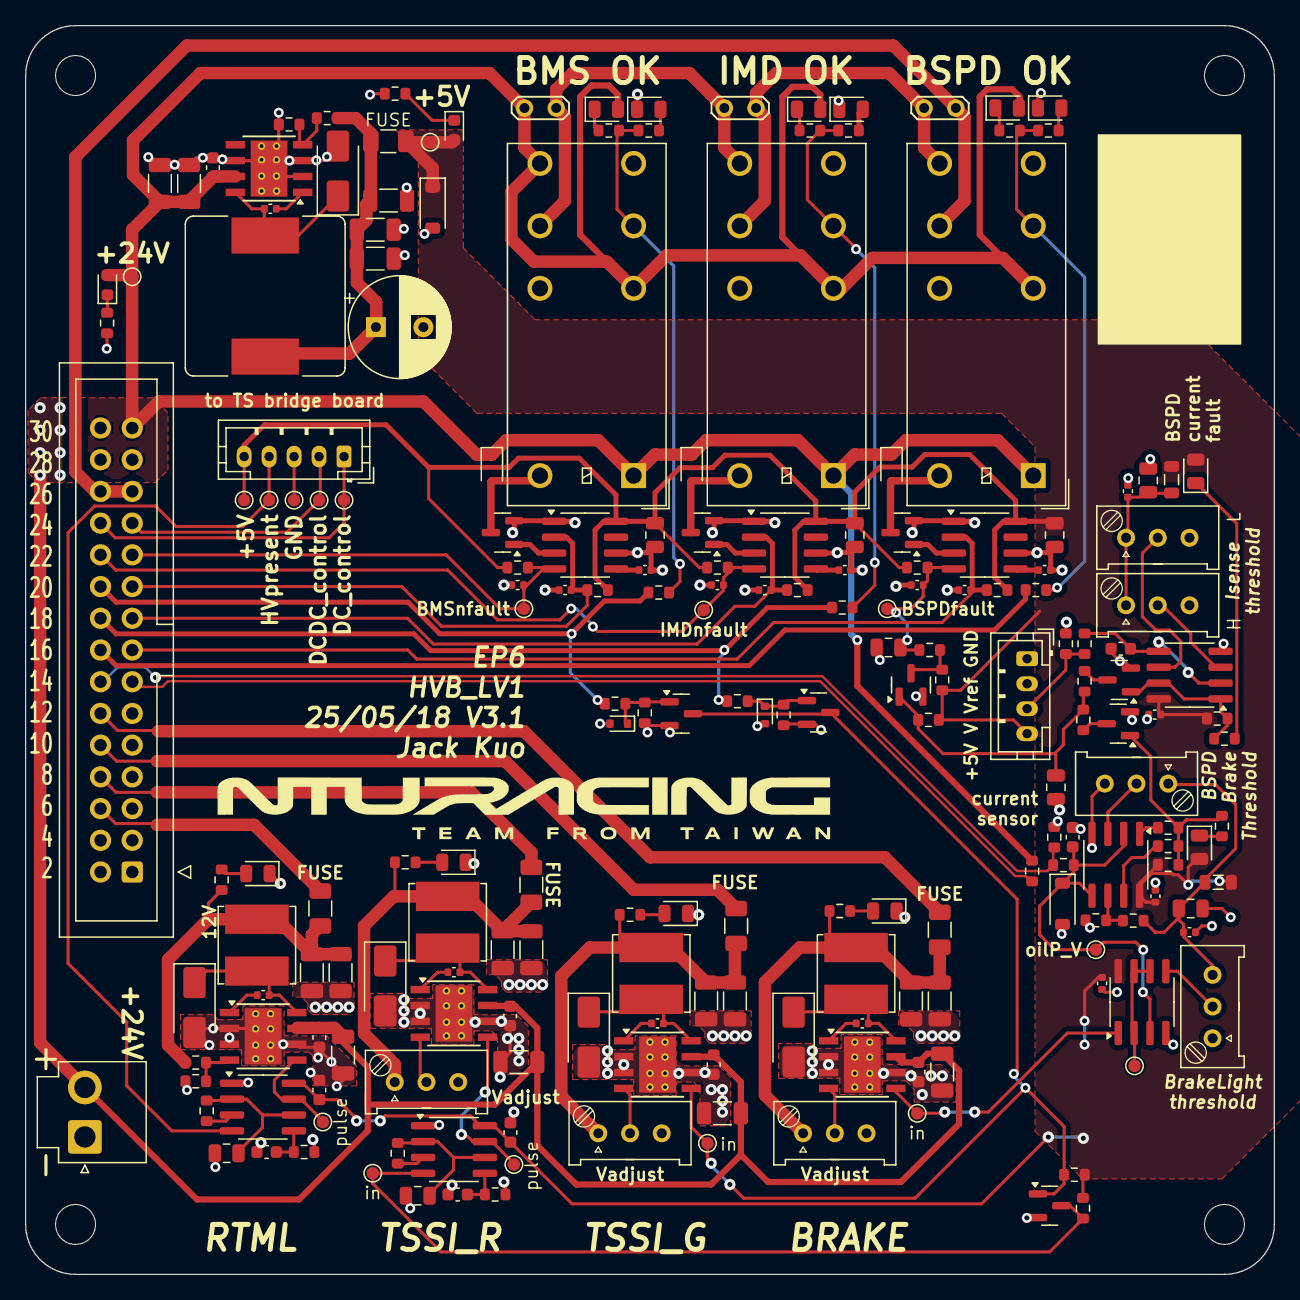
[picture p82: board HVB_LV1.kicad_pcb from above]

Board: 2 copper layers, 100.0 x 100.0 mm, 208 parts (0 on the bottom side), 102 nets.

Parts:
C1, C5, C9, C14, C17, C19, C52, C55, C57: 10u; C_0805_2012Metric
C2, C4, C6, C8, C10, C12, C13, C15, C16, C20, C21: 100n; C_0402_1005Metric
C3, C7, C11, C22, C30, C35, C40, C45: 10n; C_0402_1005Metric
C18, C56: 10u; C_0603_1608Metric
C23, C24, C31, C36, C41, C46: 10u 35V; C_1206_3216Metric
C25, C32, C37, C42, C47, C50, C51, C53, C54: 100n; C_0603_1608Metric
C26, C27, C28, C33, C34, C38, C39, C43, C44, C48, C49: 22u 25V; C_1206_3216Metric
C29: 330u 25V; CP_Radial_D8.0mm_P3.80mm
D1, D4, D7: 4148; D_SOD-323
D2, D5, D8, D10, D12: GREEN LED; LED_0805_2012Metric
D3, D6, D9: RED LED; LED_0805_2012Metric
D11, D16: 5.6V (C19077402); D_SOD-123
D13, D15: WHITE LED; LED_0603_1608Metric
D14, D19, D20, D21, D22: SS54; D_SMA
D17, D18: BZX584C5V6; D_SOD-523
D23, D24, D25, D26: YELLOW LED; LED_0805_2012Metric
F1: 2A; Fuse_1206_3216Metric
F2, F3, F4, F5: FUSE; Fuse_1206_3216Metric
FB1, FB2: GZ1608D601TF; L_0805_2012Metric
H1, H2, H3, H4: MountingHole; MountingHole_3.2mm_M3
J1: toTS; JST_PH_B5B-PH-K_1x05_P2.00mm_Vertical
J2: energy meter; JST_VH_B2P-VH-B_1x02_P3.96mm_Vertical
J3: toConnectorBoard; IDC-Header_2x15_P2.54mm_Vertical
J4: I_Sen; JST_PH_B4B-PH-K_1x04_P2.00mm_Vertical
JP2, JP3, JP4: test; TestPoint_2Pads_Pitch2.54mm_Drill0.8mm
L1: 22uH 4.95A (SMDRI129-220MT); L_Bourns_SRR1260
L2, L3, L4, L5: 47u 1.6A (SRN6045TA-470M); L_Bourns_SRN6045TA
Q1, Q2, Q3, Q4, Q5, Q6, Q7, Q8, Q9: 2N7002; SOT-23
R1, R2, R5, R6, R7, R10, R11, R12, R15, R21, R25, R35, R37, R38, R39, R41, R44, R46, R48, R50, R51, R52, R53: 10k; R_0603_1608Metric
R3, R8, R13, R18, R19, R27, R29: 0R; R_0603_1608Metric
R4, R9, R14, R23, R31, R32, R40, R42: 100k; R_0603_1608Metric
R16, R17: 10R; R_0603_1608Metric
R20: 150R; R_0603_1608Metric
R22, R30: 4k7; R_0603_1608Metric
R24, R49: 1k; R_0603_1608Metric
R26: 20k; R_0603_1608Metric
R28: 100R; R_0603_1608Metric
R33, R34: 47k; R_0603_1608Metric
R36: 15k; R_0603_1608Metric
R43: 91k; R_0603_1608Metric
R45, R47: 43k; R_0603_1608Metric
RL1, RL2, RL3: G2RL-24-DC24; Relay_DPDT_Omron_G2RL-2
RV1, RV2, RV3, RV4, RV5, RV6, RV7: 10k; Throughhole Potentiometer 3296W
TP1: +5V; TestPoint_Pad_D1.0mm
TP2: HVpresent; TestPoint_Pad_D1.0mm
TP3: GND; TestPoint_Pad_D1.0mm
TP4: DCDC_control; TestPoint_Pad_D1.0mm
TP5: DC_control; TestPoint_Pad_D1.0mm
TP6: BMSfault; TestPoint_Pad_D1.0mm
TP7: IMDfault; TestPoint_Pad_D1.0mm
TP8: BSPDnfault; TestPoint_Pad_D1.0mm
TP9: BrakeThreshold; TestPoint_Pad_D1.0mm
TP10: oilP_Vout; TestPoint_Pad_D1.0mm
TP11: Vbus; TestPoint_Pad_D1.0mm
TP12: 5V; TestPoint_Pad_D1.0mm
TP13: RTML; TestPoint_Pad_D1.0mm
TP14: TSSI RED RAW; TestPoint_Pad_D1.0mm
TP15: TSSI Red; TestPoint_Pad_D1.0mm
TP16: TSSI Green; TestPoint_Pad_D1.0mm
TP17: BrakeLight; TestPoint_Pad_D1.0mm
U1, U2, U3, U12, U13: NE555D; SOIC-8_3.9x4.9mm_P1.27mm
U4: LM358; SOIC-8_3.9x4.9mm_P1.27mm
U5, U6: LM393; SOIC-8_3.9x4.9mm_P1.27mm
U7, U8, U9, U10, U11: TPS5430DDAR; TI_SO-PowerPAD-8_ThermalVias

Connections:
+5V: C1.1, C5.1, C9.1, C15.1, C20.1, C21.1, C50.1, C53.1, D10.2 (A), D12.2 (A), D15.2 (A), D16.1 (K), F1.2, FB1.2, FB2.2, J1.5, J4.4, R1.1, R4.1, R6.1, R9.1, R11.1, R14.1, R21.1, R23.1, R25.1, R31.1, R37.1, R38.1, TP1.1, TP12.1, U1.8 (VCC), U2.8 (VCC), U3.8 (VCC), U4.8 (V+), U5.8 (V+), U6.8 (V+), U12.8 (VCC), U13.8 (VCC)
+5VA: C13.1, C14.1, FB1.1, RV3.1, RV4.1
/BMS_IND_LIGHT: J3.20, R3.2, R39.1
/BMS_RESET_BUTTON: C2.1, J3.19, R1.2, U1.2 (TR)
/BMS_nFAULT_SIG_RAW: C4.1, J3.21, R4.2, TP6.1, U1.4 (R)
/BRAKE_LIGHT+: F5.2, J3.12
/BRAKE_SENSE_N: J3.13, R16.1
/BRAKE_SENSE_P: J3.14, R17.1, R20.1
/BSPD/5VA2: C16.1, C17.1, FB2.1, R26.1, RV1.3, RV2.1
/BSPD/BSPDfault: C57.1, Q5.1 (G), R19.2, R25.2, R29.2
/BSPD/DCbusCurrentAbsent: Q6.1 (G), R30.2, R31.2, U6.1, U6.7
/BSPD/DCbusCurrentNotGood: Q6.3 (D), R29.1
/BSPD/OilPsenserPresent: R27.1, U5.7
/BSPD/brakeLightOn: TP17.1, U4.1, U11.5 (EN)
/BSPD/brakeNotInSafeArea: Q4.3 (D), R19.1
/BSPD/nohardBrake: R18.1, U5.1
/BSPD_IND_LIGHT: J3.16, R13.2
/BSPD_RESET_BUTTON: C10.1, J3.15, R11.2, U3.2 (TR)
/BSPD_nFAULT_SIG: C12.1, C19.1, R14.2, R24.1, TP8.1, U3.4 (R)
/BrightLight/RTML amber/12V_buck: C33.1, C34.1, F2.1, L2.1, R43.1, R50.2
/BrightLight/RTML amber/12V_buck_FB: R43.2, R44.1, U8.4 (VSENSE)
/BrightLight/RTML amber/12V_buck_sw: C30.2, D19.1 (K), L2.2, U8.8 (PH)
/BrightLight/RTML amber/enable: TP13.1, U8.5 (EN), U12.7 (DIS)
/BrightLight/TSSI green/buck_FB: RV6.2, U10.4 (VSENSE)
/BrightLight/TSSI green/buck_out: C43.1, C44.1, F4.1, L4.1, R52.2, RV6.1
/BrightLight/TSSI green/buck_sw: C40.2, D21.1 (K), L4.2, U10.8 (PH)
/BrightLight/TSSI green/enable: Q7.1 (G), Q8.3 (D), Q9.3 (D), R38.2, TP16.1, U10.5 (EN)
/BrightLight/TSSI red pulse/OpenDrain_pulse_out: TP15.1, U9.5 (EN), U13.7 (DIS)
/BrightLight/TSSI red pulse/enable: Q7.3 (D), R37.2, TP14.1, U13.4 (R)
/BrightLight/TSSI red/buck_FB: RV5.2, U9.4 (VSENSE)
/BrightLight/TSSI red/buck_out: C38.1, C39.1, F3.1, L3.1, R51.2, RV5.1
/BrightLight/TSSI red/buck_sw: C35.2, D20.1 (K), L3.2, U9.8 (PH)
/BrightLight/brakelight/buck_FB: RV7.2, U11.4 (VSENSE)
/BrightLight/brakelight/buck_out: C48.1, C49.1, F5.1, L5.1, R53.2, RV7.1
/BrightLight/brakelight/buck_sw: C45.2, D22.1 (K), L5.2, U11.8 (PH)
/CURRENT_MEASSURED: J4.3, R32.1, R49.1
/DCDC_CONTROL: J1.2, J3.23, TP4.1
/DC_CONTROL: J1.1, J3.24, TP5.1
/HVpresent: J1.4, TP2.1, U12.4 (R)
/IMD_IND_LIGHT: J3.18, R8.2, R41.1
/IMD_RESET_BUTTON: C6.1, J3.17, R6.2, U2.2 (TR)
/IMD_nFAULT_SIG_RAW: C8.1, J3.22, R9.2, TP7.1, U2.4 (R)
/Latch_BMS/SC_OUT: JP2.2 (B), JP3.1 (A), RL1.21, RL2.24
/Latch_BSPD/SC_IN: JP3.2 (B), JP4.1 (A), RL2.21, RL3.24
/Power/5V_buck: C26.1, C27.1, C28.1, C29.1, F1.1, L1.2, R34.1
/Power/5V_buck_FB: R34.2, R36.1, U7.4 (VSENSE)
/Power/5V_buck_sw: C22.2, D14.1 (K), L1.1, U7.8 (PH)
/RTML_AMBER+: F2.2, J3.6
/SCout: J3.25, J3.26, JP4.2 (B), RL3.21
/TSSI_GREEN+: F4.2, J3.10
/TSSI_RED+: F3.2, J3.8
GND: C1.2, C2.2, C3.2, C4.2, C5.2, C6.2, C7.2, C8.2, C9.2, C10.2, C11.2, C12.2, C13.2, C14.2, C15.2, C16.2, C17.2, C18.2, C19.2, C20.2, C21.2, C23.2, C24.2, C25.1, C26.2, C27.2, C28.2, C29.2, C31.2, C32.1, C33.2, C34.2, C36.2, C37.1, C38.2, C39.2, C41.2, C42.1, C43.2, C44.2, C46.2, C47.1, C48.2, C49.2, C50.2, C51.2, C52.2, C53.2, C54.2, C55.2, C56.2, C57.2, D3.1 (K), D6.1 (K), D9.1 (K), D11.2 (A), D14.2 (A), D16.2 (A), D17.2 (A), D18.2 (A), D19.2 (A), D20.2 (A), D21.2 (A), D22.2 (A), D23.1 (K), D24.1 (K), D25.1 (K), D26.1 (K), J1.3, J2.1, J3.1, J3.2, J3.5, J3.7, J3.9, J3.11, J4.1, Q1.2 (S), Q2.2 (S), Q3.2 (S), Q4.2 (S), Q5.2 (S), Q6.2 (S), Q7.2 (S), Q8.2 (S), Q9.2 (S), R20.2, R28.2, R32.2, R33.2, R35.2, R36.2, R40.1, R42.1, R44.2, R46.1, R48.1, RL1.14, RL2.14, RL3.14, RV1.1, RV2.3, RV3.3, RV4.3, RV5.3, RV6.3, RV7.3, TP3.1, U1.1 (GND), U1.6 (THR), U2.1 (GND), U2.6 (THR), U3.1 (GND), U3.6 (THR), U4.4 (V-), U5.4 (V-), U6.4 (V-), U7.2 (NC), U7.3 (NC), U7.6 (GND), U7.9 (GNDPAD), U8.2 (NC), U8.3 (NC), U8.6 (GND), U8.9 (GNDPAD), U9.2 (NC), U9.3 (NC), U9.6 (GND), U9.9 (GNDPAD), U10.2 (NC), U10.3 (NC), U10.6 (GND), U10.9 (GNDPAD), U11.2 (NC), U11.3 (NC), U11.6 (GND), U11.9 (GNDPAD), U12.1 (GND), U13.1 (GND)
unnamed: D1.2 (A), Q1.3 (D), RL1.A2
unnamed: D2.1 (K), R2.1
unnamed: D3.2 (A), R5.1
unnamed: D4.2 (A), Q2.3 (D), RL2.A2
unnamed: D5.1 (K), R7.1
unnamed: D6.2 (A), R10.1
unnamed: D7.2 (A), Q3.3 (D), RL3.A2
unnamed: D8.1 (K), R12.1
unnamed: D9.2 (A), R15.1
unnamed: D10.1 (K), R22.1
unnamed: C18.1, D11.1 (K), R17.2, TP10.1, U4.3 (+), U5.2 (-), U5.5 (+)
unnamed: D12.1 (K), R30.1
unnamed: D13.1 (K), R33.1
unnamed: D15.1 (K), R35.1
unnamed: D17.1 (K), Q8.1 (G), R39.2, R40.2
unnamed: D18.1 (K), Q9.1 (G), R41.2, R42.2
unnamed: D23.2 (A), R50.1
unnamed: D24.2 (A), R51.1
unnamed: D25.2 (A), R52.1
unnamed: D26.2 (A), R53.1
unnamed: Q1.1 (G), U1.3 (Q)
unnamed: Q2.1 (G), U2.3 (Q)
unnamed: Q3.1 (G), U3.3 (Q)
unnamed: Q4.1 (G), R18.2, R22.2, R23.2, R27.2
unnamed: Q5.3 (D), R21.2, R24.2
unnamed: R2.2, R3.1, R5.2, RL1.11
unnamed: R7.2, R8.1, R10.2, RL2.11
unnamed: R12.2, R13.1, R15.2, RL3.11
unnamed: C3.1, U1.5 (CV)
unnamed: C7.1, U2.5 (CV)
unnamed: C11.1, U3.5 (CV)
unnamed: TP9.1, U4.2 (-), U4.6 (-), U4.7
unnamed: RV1.2, U4.5 (+)
unnamed: RV2.2, U5.3 (+)
unnamed: R26.2, R28.1, U5.6 (-)
unnamed: RV3.2, U6.3 (+)
unnamed: C56.1, R49.2, U6.2 (-), U6.5 (+)
unnamed: RV4.2, U6.6 (-)
unnamed: C22.1, U7.1 (BOOT)
unnamed: C30.1, U8.1 (BOOT)
unnamed: C35.1, U9.1 (BOOT)
unnamed: C40.1, U10.1 (BOOT)
unnamed: C45.1, U11.1 (BOOT)
unnamed: C51.1, R46.2, U12.5 (CV)
unnamed: R45.2, U12.3 (Q)
unnamed: C52.1, R45.1, U12.2 (TR), U12.6 (THR)
unnamed: C54.1, R48.2, U13.5 (CV)
unnamed: R47.2, U13.3 (Q)
unnamed: C55.1, R47.1, U13.2 (TR), U13.6 (THR)
VBUS: C23.1, C24.1, C25.2, C31.1, C32.2, C36.1, C37.2, C41.1, C42.2, C46.1, C47.2, D1.1 (K), D2.2 (A), D4.1 (K), D5.2 (A), D7.1 (K), D8.2 (A), D13.2 (A), J2.2, J3.27, J3.28, J3.29, J3.30, JP2.1 (A), R16.2, RL1.12, RL1.24, RL1.A1, RL2.12, RL2.A1, RL3.12, RL3.A1, TP11.1, U7.7 (VIN), U8.7 (VIN), U9.7 (VIN), U10.7 (VIN), U11.7 (VIN)
