NTURacingTeam/nturt_kicad/EP6/Powertrain_Group/ACC_BMSslave/ACC_BMSslave.kicad_pcb

## KiCad design EP6/Powertrain_Group/ACC_BMSslave/ACC_BMSslave.kicad_pcb (2025-05-18)

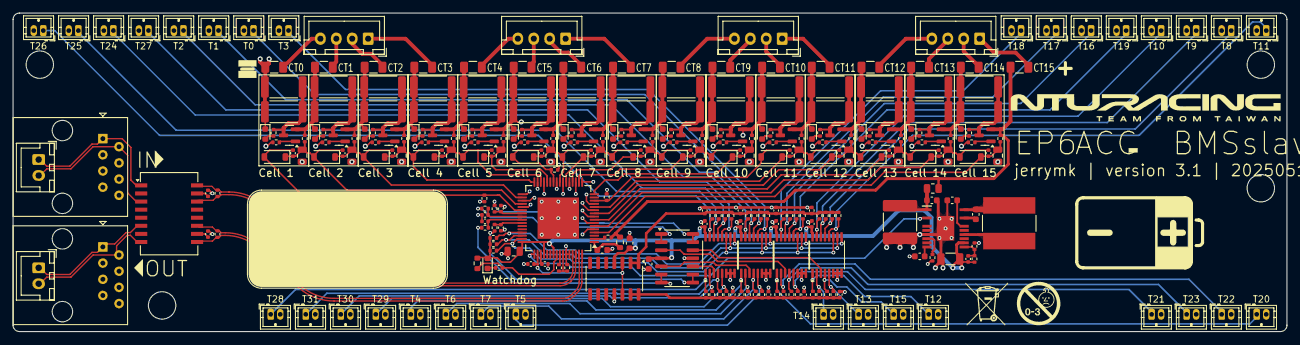
[picture p83: board ACC_BMSslave.kicad_pcb from above]

Board: 4 copper layers, 200.0 x 50.0 mm, 306 parts (0 on the bottom side), 187 nets.

Parts:
C1, C2, C15: 100n; C_0603_1608Metric
C3, C57: 1u; C_0603_1608Metric
C4, C5, C6, C7: 10n; C_0402_1005Metric
C8, C9: 1u; C_0402_1005Metric
C10, C11: 100p; C_0402_1005Metric
C12: 1u; C_0805_2012Metric
C13: 2.2u; C_2220_5750Metric
C14: 100p; C_0603_1608Metric
C16: 4.7p; C_0402_1005Metric
C17: 2.2u; C_0603_1608Metric
C18: 22u; C_1206_3216Metric
C19, C20, C21, C22, C23, C24, C25, C26, C28, C30, C32, C34, C36, C38, C40, C42, C44, C46, C48, C50, C52, C54, C56, C58, C59, C60, C61: 100n; C_0402_1005Metric
C27, C29, C31, C33, C35, C37, C39, C41, C43, C45, C47, C49, C51, C53, C55: 100n 100V; C_0805_2012Metric
D1: BLUE; LED_0603_1608Metric
D2, D3, D4, D5, D6, D7, D8, D9, D10, D11, D12, D13, D14, D15, D16: RED; LED_0603_1608Metric
F1, F2, F3, F4, F5, F6, F7, F8, F9, F10, F11, F12, F13, F14, F15, F16: 0466.250NR; Fuse_1206_3216Metric
H1, H2, H3, H4: MountingHole; MountingHole_4.3mm_M4_ISO14580
IC1: ADBMS1818ASWAZ-R7; LQFP-64-1EP_10x10mm_P0.5mm_EP6.5x6.5mm
IC2: LT8631IFE#PBF; TSSOP-20 FE20(16) (EP Variation CB)
IC3, IC4, IC5, IC6, IC7, IC8, IC9, IC10, IC11, IC12, IC13, IC14, IC15, IC16, IC17: NX2301P,215; SOT-23
J1, J2, J3, J4: JST XH; JST_XH_B4B-XH-A_1x04_P2.50mm_Vertical
J5, J6, J7, J8, J9, J10, J11, J12, J13, J14, J15, J16, J17, J18, J19, J20, J21, J22, J23, J24, J25, J26, J27, J28, J29, J30, J31, J32, J33, J34, J35, J36: JST ZH; JST_ZH_B2B-ZR_1x02_P1.50mm_Vertical
J37, J38: RJ45; RJ45_Amphenol_54602-x08_Horizontal
J39: isoSPI_out; JST_XH_B2B-XH-A_1x02_P2.50mm_Vertical
J40: isoSPI_in; JST_XH_B2B-XH-A_1x02_P2.50mm_Vertical
L1: 22u/2A; L_Bourns-SRN8040_8x8.15mm
R1: 100R; R_0805_2012Metric
R2: 100R; R_0603_1608Metric
R3, R4, R5, R6, R60, R65, R70, R75, R80, R85, R90, R95, R96, R101, R122, R123, R124, R125, R126: 10R; R_0402_1005Metric
R7, R8, R9, R10, R15, R16: 100R; R_0402_1005Metric
R11, R12, R13, R52, R56, R61, R66, R71, R76, R81, R86, R91, R97, R102, R106, R110, R114, R118: 1k; R_0402_1005Metric
R14: 1M; R_0603_1608Metric
R17: 25.5k; R_0402_1005Metric
R18: 1M/1%; R_0402_1005Metric
R19: 191k/1%; R_0402_1005Metric
R20, R21, R22, R23, R24, R25, R26, R27, R28, R29, R30, R31, R32, R33, R34, R35, R36, R37, R38, R39, R40, R41, R42, R43, R44, R45, R46, R47, R48, R49, R50, R51: 10k; R_0402_1005Metric
R53, R54, R57, R58, R62, R63, R67, R68, R72, R73, R77, R78, R82, R83, R87, R88, R92, R93, R98, R99, R103, R104, R107, R108, R111, R112, R115, R116, R119, R120: 51R; R_2512_6332Metric
R55, R59, R64, R69, R74, R79, R84, R89, R94, R100, R105, R109, R113, R117, R121: 3.3k; R_0402_1005Metric
R127, R128, R129: 47k; R_0402_1005Metric
TR1: Wuerth_749013011A; Transformer_Ethernet_Wuerth_749013011A
U1, U6: LM324DT; SO-14_3.9x8.65mm_P1.27mm
U2, U3, U4, U5: CD4051B; TSSOP-16_4.4x5mm_P0.65mm
Z1, Z2, Z3, Z4, Z5, Z6, Z7, Z8, Z9, Z10, Z11, Z12, Z13, Z14, Z15: MMSZ4692T1G; D_SOD-123

Connections:
/C0: C42.2, IC1.38 (C0), R6.2, Z8.2 (A)
/C1: C28.2, C41.1, C42.1, IC1.36 (C1), R95.2, Z1.2 (A), Z8.1 (K)
/C2: C27.1, C28.1, C30.2, IC1.34 (C2), R60.2, Z1.1 (K), Z2.2 (A)
/C3: C29.1, C30.1, C32.2, IC1.32 (C3), R65.2, Z2.1 (K), Z3.2 (A)
/C4: C31.1, C32.1, C34.2, IC1.30 (C4), R70.2, Z3.1 (K), Z4.2 (A)
/C5: C33.1, C34.1, IC1.28 (C5), R75.2, Z4.1 (K)
/C6: C36.2, IC1.26 (C6), R5.2, Z5.2 (A)
/C7: C35.1, C36.1, C38.2, IC1.24 (C7), R80.2, Z5.1 (K), Z6.2 (A)
/C8: C37.1, C38.1, C40.2, IC1.22 (C8), R85.2, Z6.1 (K), Z7.2 (A)
/C9: C39.1, C40.1, C44.2, IC1.20 (C9), R90.2, Z7.1 (K), Z9.2 (A)
/C10: C43.1, C44.1, C46.2, IC1.18 (C10), R96.2, Z9.1 (K), Z10.2 (A)
/C11: C45.1, C46.1, IC1.16 (C11), R101.2, Z10.1 (K)
/C12: C48.2, IC1.14 (C12), R4.2, Z11.2 (A)
/C13: C47.1, C48.1, C50.2, IC1.12 (C13), R122.2, Z11.1 (K), Z12.2 (A)
/C14: C49.1, C50.1, C52.2, IC1.10 (C14), R123.2, Z12.1 (K), Z13.2 (A)
/C15: C51.1, C52.1, C54.2, IC1.8 (C15), R124.2, Z13.1 (K), Z14.2 (A)
/C16: C53.1, C54.1, C56.2, IC1.6 (C16), R125.2, Z14.1 (K), Z15.2 (A)
/C17: C55.1, C56.1, IC1.4 (C17), R126.2, Z15.1 (K)
/C18: IC1.2 (C18), R3.2
/CT1: D2.1 (K), F2.2, IC4.2 (S), R53.1, R54.1, R95.1
/CT2: D4.1 (K), F3.2, IC3.2 (S), R60.1, R62.1, R63.1
/CT3: D5.1 (K), F4.2, IC5.2 (S), R65.1, R67.1, R68.1
/CT4: D6.1 (K), F5.2, IC6.2 (S), R70.1, R72.1, R73.1
/CT5: D7.1 (K), F6.2, IC7.2 (S), R5.1, R75.1, R77.1, R78.1
/CT6: D8.1 (K), F7.2, IC8.2 (S), R80.1, R82.1, R83.1
/CT7: D9.1 (K), F8.2, IC9.2 (S), R85.1, R87.1, R88.1
/CT8: D10.1 (K), F9.2, IC10.2 (S), R90.1, R92.1, R93.1
/CT9: D11.1 (K), F10.2, IC11.2 (S), R96.1, R98.1, R99.1
/CT10: D12.1 (K), F11.2, IC12.2 (S), R4.1, R101.1, R103.1, R104.1
/CT11: D13.1 (K), F12.2, IC13.2 (S), R107.1, R108.1, R122.1
/CT12: D14.1 (K), F13.2, IC14.2 (S), R111.1, R112.1, R123.1
/CT13: D15.1 (K), F14.2, IC15.2 (S), R115.1, R116.1, R124.1
/CT14: D16.1 (K), F15.2, IC16.2 (S), R119.1, R120.1, R125.1
/CT15: F16.2, IC17.2 (S), R1.1, R2.1, R3.1, R126.1
/DRIVE: IC1.49 (DRIVE), IC2.3 (EN/UV)
/GPIO1: C4.1, IC1.39 (GPIO1), R7.2
/GPIO2: C5.1, IC1.40 (GPIO2), R8.2
/GPIO3: C7.1, IC1.41 (GPIO3), R10.2
/GPIO4: C6.1, IC1.42 (GPIO4), R9.2
/GPIO7: IC1.45 (GPIO7), R129.1, U2.9 (C), U3.9 (C), U4.9 (C), U5.9 (C)
/GPIO8: IC1.46 (GPIO8), R128.1, U2.10 (B), U3.10 (B), U4.10 (B), U5.10 (B)
/GPIO9: IC1.47 (GPIO9), R127.1, U2.11 (A), U3.11 (A), U4.11 (A), U5.11 (A)
/IN_N: IC1.61 (CSB), R16.1, TR1.16 (TX+)
/IN_P: IC1.62 (SCK), R16.2, TR1.14 (TX-)
/ISOSPI_IN+: J38.2, J40.2, TR1.3 (TD-)
/ISOSPI_IN-: J38.1, J40.1, TR1.1 (TD+)
/ISOSPI_OUT+: J37.2, J39.2, TR1.8 (RD-)
/ISOSPI_OUT-: J37.1, J39.1, TR1.6 (RD+)
/OUT_N: IC1.63 (IMB), R15.1, TR1.11 (RX+)
/OUT_P: IC1.64 (IPB), R15.2, TR1.9 (RX-)
/S1: IC1.37 (S1), R59.1
/S2: IC1.35 (S2), R55.1
/S3: IC1.33 (S3), R64.1
/S4: IC1.31 (S4), R69.1
/S5: IC1.29 (S5), R74.1
/S7: IC1.25 (S7), R79.1
/S8: IC1.23 (S8), R84.1
/S9: IC1.21 (S9), R89.1
/S10: IC1.19 (S10), R94.1
/S11: IC1.17 (S11), R100.1
/S13: IC1.13 (S13), R105.1
/S14: IC1.11 (S14), R109.1
/S15: IC1.9 (S15), R113.1
/S16: IC1.7 (S16), R117.1
/S17: IC1.5 (S17), R121.1
/T0: J5.1, R28.1, U3.13 (X0)
/T1: J13.1, R29.1, U3.14 (X1)
/T2: J21.1, R30.1, U3.15 (X2)
/T3: J29.1, R31.1, U3.12 (X3)
/T4: J6.1, R32.1, U3.1 (X4)
/T5: J14.1, R33.1, U3.5 (X5)
/T6: J22.1, R34.1, U3.2 (X6)
/T7: J30.1, R35.1, U3.4 (X7)
/T8: J7.1, R44.1, U5.13 (X0)
/T9: J15.1, R45.1, U5.14 (X1)
/T10: J23.1, R46.1, U5.15 (X2)
/T11: J31.1, R47.1, U5.12 (X3)
/T12: J8.1, R48.1, U5.1 (X4)
/T13: J16.1, R49.1, U5.5 (X5)
/T14: J24.1, R50.1, U5.2 (X6)
/T15: J32.1, R51.1, U5.4 (X7)
/T16: J9.1, R36.1, U4.13 (X0)
/T17: J17.1, R37.1, U4.14 (X1)
/T18: J25.1, R38.1, U4.15 (X2)
/T19: J33.1, R39.1, U4.12 (X3)
/T20: J10.1, R40.1, U4.1 (X4)
/T21: J18.1, R41.1, U4.5 (X5)
/T22: J26.1, R42.1, U4.2 (X6)
/T23: J34.1, R43.1, U4.4 (X7)
/T24: J11.1, R20.1, U2.13 (X0)
/T25: J19.1, R21.1, U2.14 (X1)
/T26: J27.1, R22.1, U2.15 (X2)
/T27: J35.1, R23.1, U2.12 (X3)
/T28: J12.1, R24.1, U2.1 (X4)
/T29: J20.1, R25.1, U2.5 (X5)
/T30: J28.1, R26.1, U2.2 (X6)
/T31: J36.1, R27.1, U2.4 (X7)
/VP: C2.1, IC1.1 (V+), R2.2
/VREF2: C9.1, IC1.50 (VREF2), U6.3 (+), U6.12 (+)
/power/VIN: C1.1, C13.1, IC2.1 (VIN), R1.2
/tprobe_mux1/OUT: U1.10 (+), U2.3 (X)
/tprobe_mux1/VREF: C20.1, C22.1, C24.1, C26.1, R20.2, R21.2, R22.2, R23.2, R28.2, R29.2, R30.2, R31.2, R36.2, R37.2, R38.2, R39.2, R44.2, R45.2, R46.2, R47.2, U6.1, U6.2 (-)
/tprobe_mux1/VREF_b: C58.1, C59.1, C60.1, C61.1, R24.2, R25.2, R26.2, R27.2, R32.2, R33.2, R34.2, R35.2, R40.2, R41.2, R42.2, R43.2, R48.2, R49.2, R50.2, R51.2, U6.13 (-), U6.14
/tprobe_mux2/OUT: U1.5 (+), U3.3 (X)
/tprobe_mux3/OUT: U1.3 (+), U4.3 (X)
/tprobe_mux4/OUT: U1.12 (+), U5.3 (X)
Earth: C1.2, C2.2, C3.2, C4.2, C5.2, C6.2, C7.2, C8.2, C9.2, C10.2, C11.2, C12.2, C13.2, C14.2, C17.2, C18.2, C19.2, C20.2, C21.2, C22.2, C23.2, C24.2, C25.2, C26.2, C27.2, C29.2, C31.2, C33.2, C35.2, C37.2, C39.2, C41.2, C43.2, C45.2, C47.2, C49.2, C51.2, C53.2, C55.2, C57.2, C58.2, C59.2, C60.2, C61.2, D3.1 (K), F1.2, IC1.59 (V-_1), IC1.60 (V-_2), IC1.65 (V-_3), IC2.7 (SYNC/MODE), IC2.21 (GND), J5.2, J6.2, J7.2, J8.2, J9.2, J10.2, J11.2, J12.2, J13.2, J14.2, J15.2, J16.2, J17.2, J18.2, J19.2, J20.2, J21.2, J22.2, J23.2, J24.2, J25.2, J26.2, J27.2, J28.2, J29.2, J30.2, J31.2, J32.2, J33.2, J34.2, J35.2, J36.2, R6.1, R11.2, R17.2, R19.2, R57.1, R58.1, U1.11 (V-), U2.6 (INH), U2.7 (VEE), U2.8 (VSS), U3.6 (INH), U3.7 (VEE), U3.8 (VSS), U4.6 (INH), U4.7 (VEE), U4.8 (VSS), U5.6 (INH), U5.7 (VEE), U5.8 (VSS), U6.11 (V-)
unnamed: D1.1 (K), R13.1
unnamed: D2.2 (A), R52.2
unnamed: D3.2 (A), R56.2
unnamed: D4.2 (A), R61.2
unnamed: D5.2 (A), R66.2
unnamed: D6.2 (A), R71.2
unnamed: D7.2 (A), R76.2
unnamed: D8.2 (A), R81.2
unnamed: D9.2 (A), R86.2
unnamed: D10.2 (A), R91.2
unnamed: D11.2 (A), R97.2
unnamed: D12.2 (A), R102.2
unnamed: D13.2 (A), R106.2
unnamed: D14.2 (A), R110.2
unnamed: D15.2 (A), R114.2
unnamed: D16.2 (A), R118.2
unnamed: IC1.57 (IBIAS), R12.1
unnamed: IC1.58 (ICMP), R11.1, R12.2
unnamed: C8.1, IC1.51 (VREF1)
unnamed: IC1.56 (WDT), R13.2, R14.2
unnamed: C15.1, IC2.18 (BST)
unnamed: C16.1, IC2.11 (FB), R18.2, R19.1
unnamed: IC2.14 (IND), L1.1
unnamed: C17.1, IC2.16 (INTVCC)
unnamed: IC2.8 (RT), R17.1
unnamed: C15.2, IC2.20 (SW), L1.2
unnamed: C14.1, IC2.10 (TR/SS)
unnamed: IC3.3 (D), R52.1, R53.2, R54.2
unnamed: IC3.1 (G), R55.2
unnamed: IC4.3 (D), R56.1, R57.2, R58.2
unnamed: IC4.1 (G), R59.2
unnamed: IC5.3 (D), R61.1, R62.2, R63.2
unnamed: IC5.1 (G), R64.2
unnamed: IC6.3 (D), R66.1, R67.2, R68.2
unnamed: IC6.1 (G), R69.2
unnamed: IC7.3 (D), R71.1, R72.2, R73.2
unnamed: IC7.1 (G), R74.2
unnamed: IC8.3 (D), R76.1, R77.2, R78.2
unnamed: IC8.1 (G), R79.2
unnamed: IC9.3 (D), R81.1, R82.2, R83.2
unnamed: IC9.1 (G), R84.2
unnamed: IC10.3 (D), R86.1, R87.2, R88.2
unnamed: IC10.1 (G), R89.2
unnamed: IC11.3 (D), R91.1, R92.2, R93.2
unnamed: IC11.1 (G), R94.2
unnamed: IC12.3 (D), R97.1, R98.2, R99.2
unnamed: IC12.1 (G), R100.2
unnamed: IC13.3 (D), R102.1, R103.2, R104.2
unnamed: IC13.1 (G), R105.2
unnamed: IC14.3 (D), R106.1, R107.2, R108.2
unnamed: IC14.1 (G), R109.2
unnamed: IC15.3 (D), R110.1, R111.2, R112.2
unnamed: IC15.1 (G), R113.2
unnamed: IC16.3 (D), R114.1, R115.2, R116.2
unnamed: IC16.1 (G), R117.2
unnamed: IC17.3 (D), R118.1, R119.2, R120.2
unnamed: IC17.1 (G), R121.2
unnamed: F4.1, J1.1
unnamed: F3.1, J1.2
unnamed: F2.1, J1.3
unnamed: F1.1, J1.4
unnamed: F8.1, J2.1
unnamed: F7.1, J2.2
unnamed: F6.1, J2.3
unnamed: F5.1, J2.4
unnamed: F12.1, J3.1
unnamed: F11.1, J3.2
unnamed: F10.1, J3.3
unnamed: F9.1, J3.4
unnamed: F16.1, J4.1
unnamed: F15.1, J4.2
unnamed: F14.1, J4.3
unnamed: F13.1, J4.4
unnamed: C10.1, TR1.10 (C_RX)
unnamed: C11.1, TR1.15 (C_TX)
unnamed: R8.1, U1.1, U1.2 (-)
unnamed: R10.1, U1.6 (-), U1.7
unnamed: R9.1, U1.8, U1.9 (-)
unnamed: R7.1, U1.13 (-), U1.14
VREG: C3.1, C12.1, C16.2, C18.1, C19.1, C21.1, C23.1, C25.1, C57.1, D1.2 (A), IC1.48 (VREG), IC1.52 (DTEN), IC1.55 (ISOMD), IC2.12 (VOUT), R14.1, R18.1, R127.2, R128.2, R129.2, U1.4 (V+), U2.16 (VDD), U3.16 (VDD), U4.16 (VDD), U5.16 (VDD), U6.4 (V+)
