NTURacingTeam/nturt_kicad/EP6/Electrical_Group/Adaptor_RJ45/Adaptor_RJ45.kicad_pcb

## KiCad design EP6/Electrical_Group/Adaptor_RJ45/Adaptor_RJ45.kicad_pcb (2025-05-11)

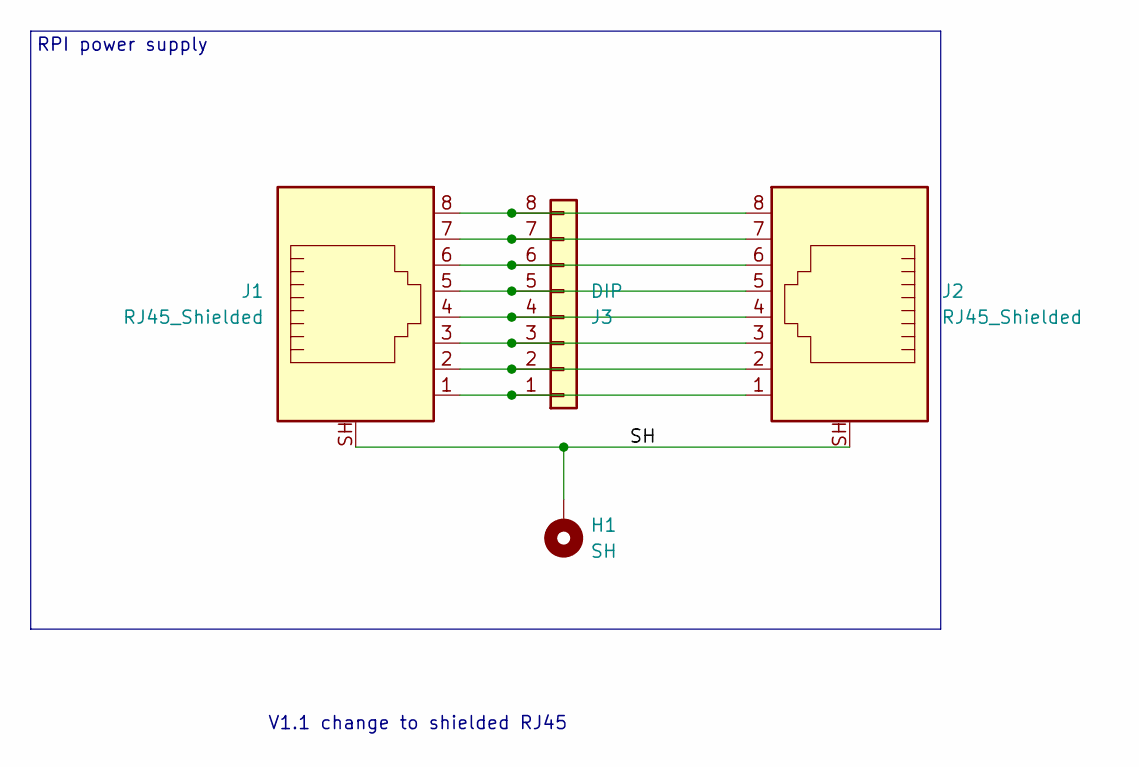
[picture p84: schematic Adaptor_RJ45.kicad_sch]

Parts:
H1: SH; MountingHole_3.2mm_M3_Pad
J1, J2: RJ45_Shielded; RJ45_Ninigi_GE
J3: DIP; PinHeader_2x04_P2.54mm_Vertical

Connections:
/SH: H1.1, J1.SH, J2.SH
unnamed: J1.1, J2.1, J3.1
unnamed: J1.2, J2.2, J3.2
unnamed: J1.3, J2.3, J3.3
unnamed: J1.4, J2.4, J3.4
unnamed: J1.5, J2.5, J3.5
unnamed: J1.6, J2.6, J3.6
unnamed: J1.7, J2.7, J3.7
unnamed: J1.8, J2.8, J3.8

Notes on the sheet:
RPI power supply
V1.1 change to shielded RJ45

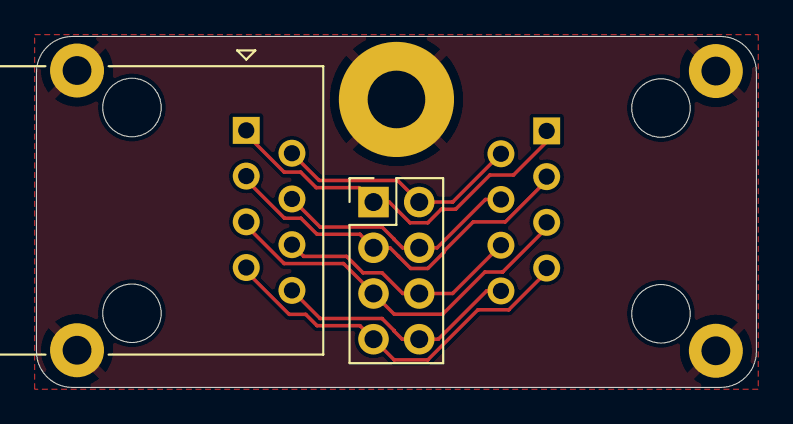
[picture p85: board Adaptor_RJ45.kicad_pcb from above]

Board: 2 copper layers, 40.0 x 19.5 mm, 4 parts (1 on the bottom side), 9 nets.
