NTURacingTeam/nturt_kicad/EP6/Powertrain_Group/INV_CONN1/INV_CONN1.kicad_pcb

## KiCad design EP6/Powertrain_Group/INV_CONN1/INV_CONN1.kicad_pcb (2025-05-11)

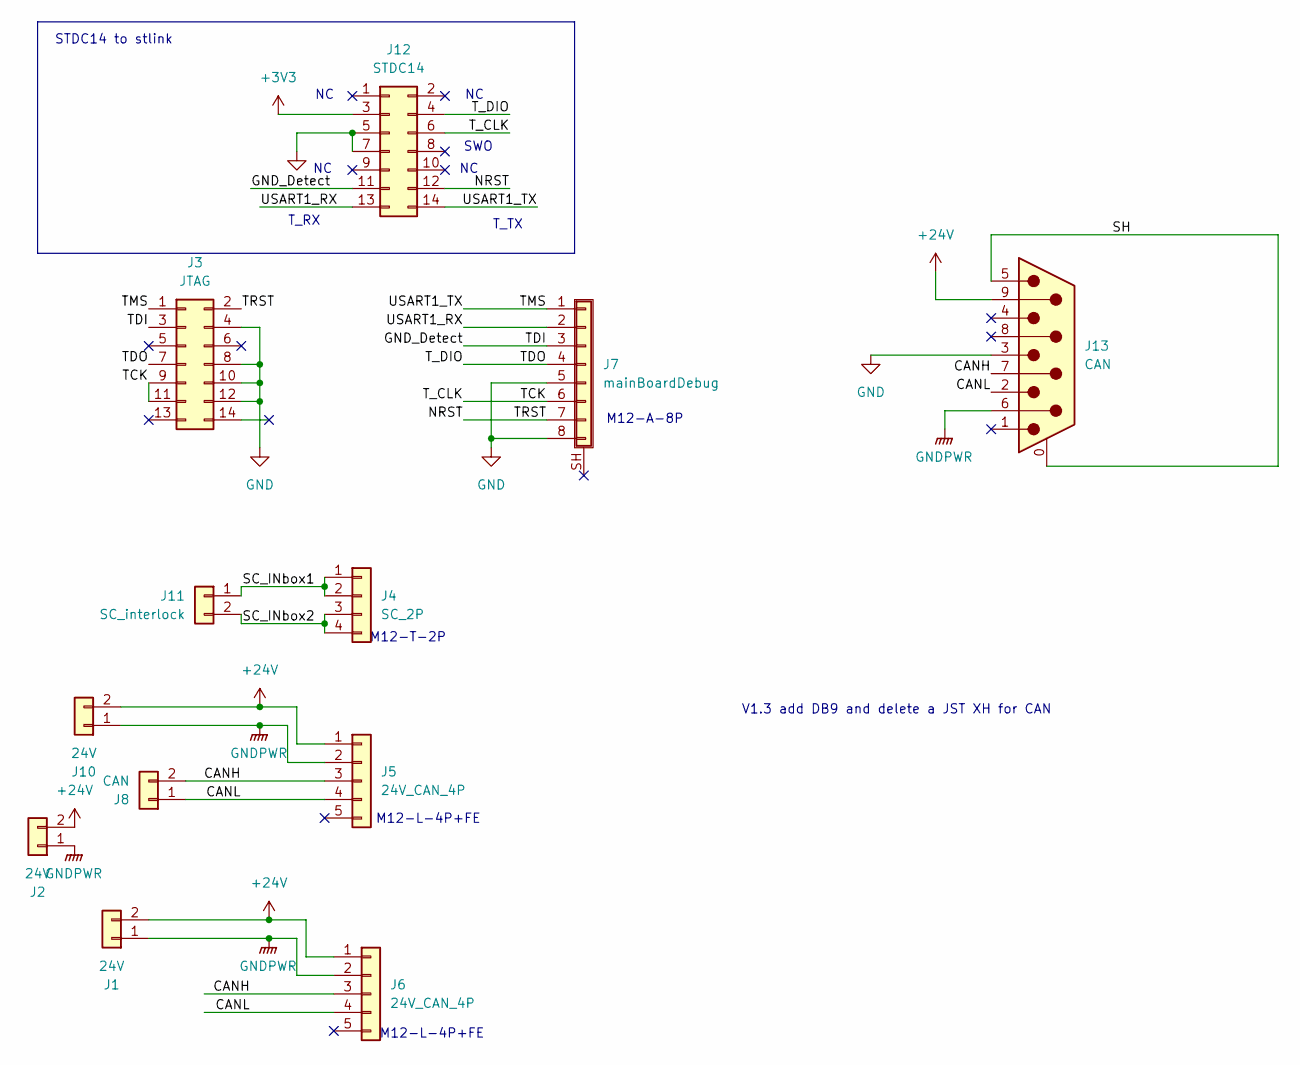
[picture p86: schematic INV_CONN1.kicad_sch]

Parts:
J1, J2, J10: 24V; JST_VH_B2P-VH_1x02_P3.96mm_Vertical
J3: JTAG; IDC-Header_2x07_P2.54mm_Vertical
J4: SC_2P; NianYeong-M12-T-M4P
J5, J6: 24V_CAN_4P; NianYeong-M12-L-F5P
J7: mainBoardDebug; NianYeong-M12-A-F8P-Shield
J8: CAN; JST_XH_B2B-XH-A_1x02_P2.50mm_Vertical
J11: SC_interlock; JST_VH_B2P-VH_1x02_P3.96mm_Vertical
J12: STDC14; box_header_14P_pitch127
J13: CAN; DSUB-9_Female_Vertical_P2.77x2.84mm_MountingHoles

Connections:
+3V3: J12.3
+24V: J1.2, J2.2, J5.1, J6.1, J10.2, J13.9
/CANH: J5.3, J6.3, J8.2, J13.7
/CANL: J5.4, J6.4, J8.1, J13.2
/GND_Detect: J3.3, J7.3, J12.11
/NRST: J3.2, J7.7, J12.12
/SC_INbox1: J4.1, J4.2, J11.1
/SC_INbox2: J4.3, J4.4, J11.2
/SH: J13.0 (PAD), J13.5
/TCK: J3.9, J3.11, J7.6, J12.6
/TDO: J3.7, J7.4, J12.4
/TMS: J3.1, J7.1, J12.14
/USART1_RX: J7.2, J12.13
GND: J3.4, J3.8, J3.10, J3.12, J7.5, J7.8, J12.5, J12.7, J13.3
GNDPWR: J1.1, J2.1, J5.2, J6.2, J10.1, J13.6

Notes on the sheet:
STDC14 to stlink
SWO
M12-T-2P
T_RX
M12-L-4P+FE
V1.3 add DB9 and delete a JST XH for CAN
M12-A-8P
T_TX

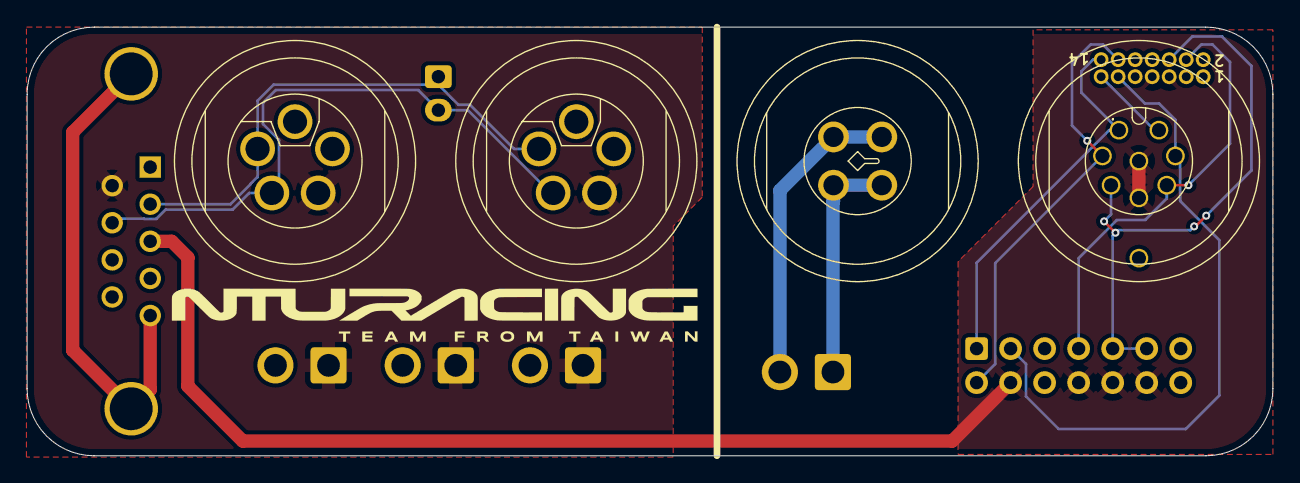
[picture p87: board INV_CONN1.kicad_pcb from above]

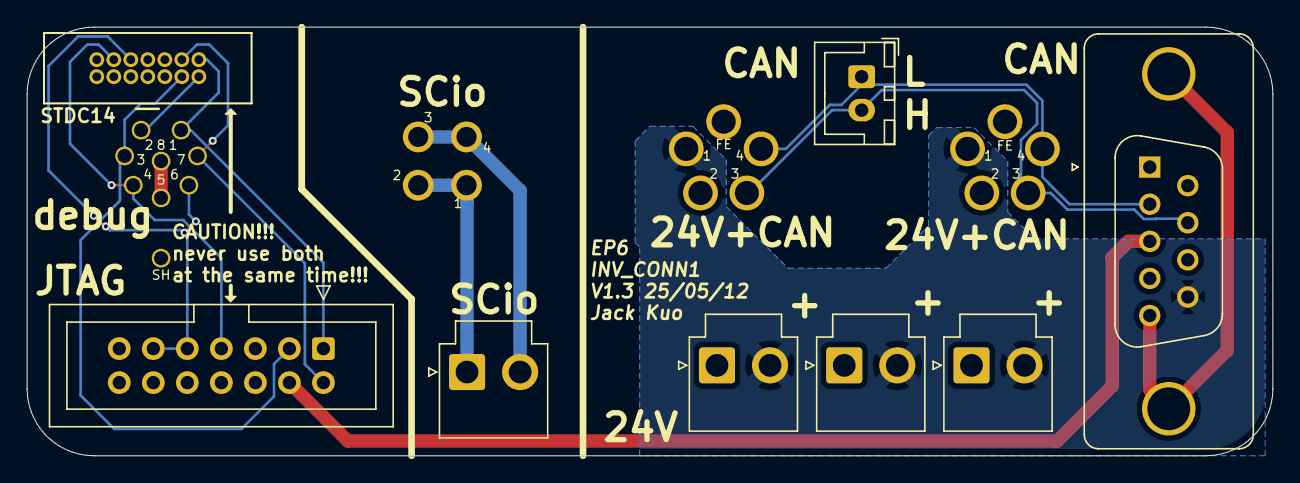
[picture p88: board INV_CONN1.kicad_pcb from below]

Board: 2 copper layers, 93.0 x 32.0 mm, 12 parts (8 on the bottom side), 14 nets.
