NTURacingTeam/nturt_kicad/EP6/Powertrain_Group/INV_PhaseIsense/INV_PhaseIsense.kicad_pcb

## KiCad design EP6/Powertrain_Group/INV_PhaseIsense/INV_PhaseIsense.kicad_pcb (2025-05-10)

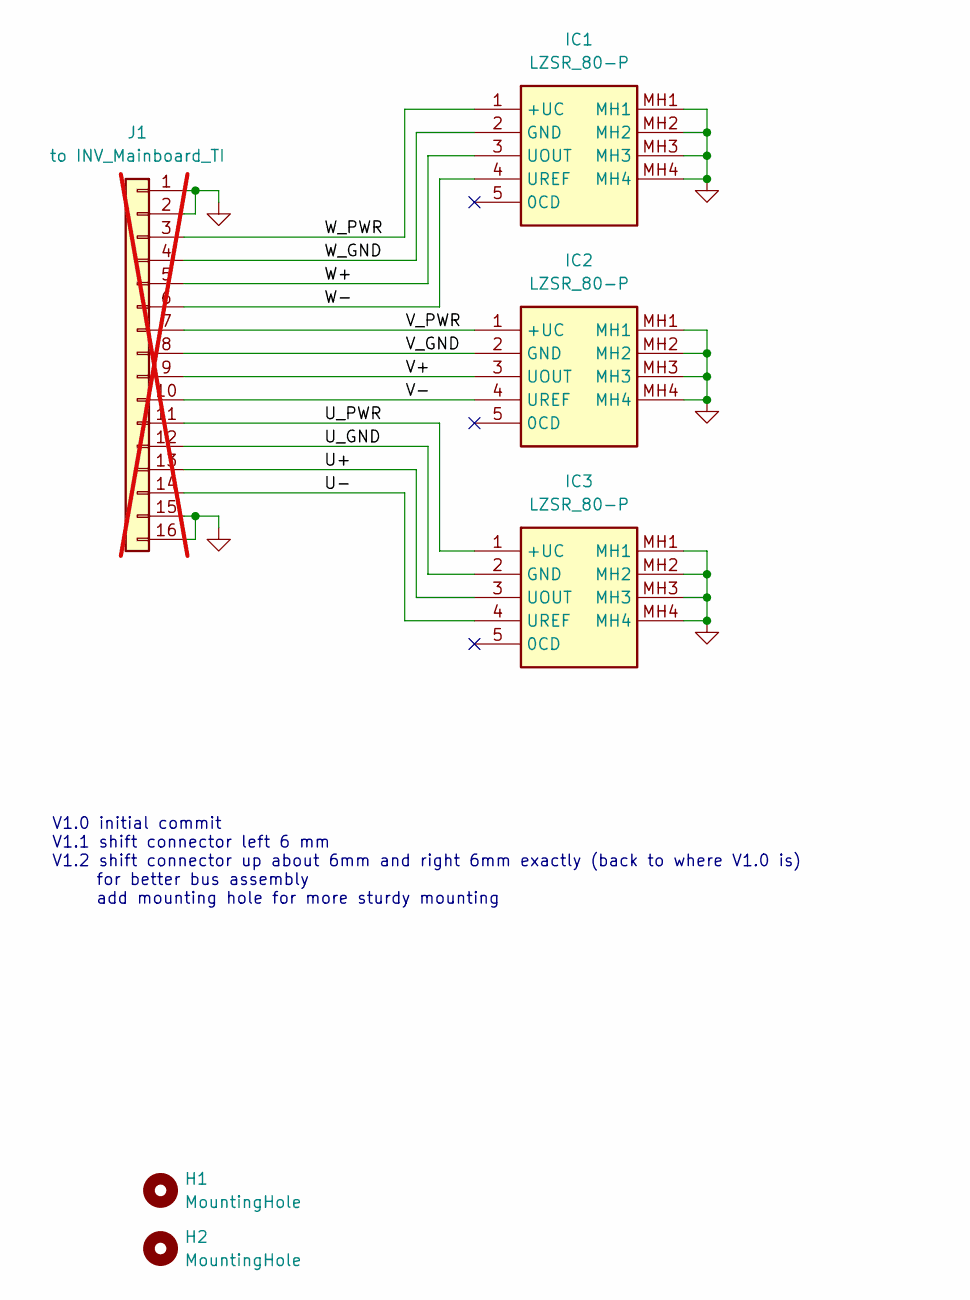
[picture p89: schematic INV_PhaseIsense.kicad_sch]

Parts:
H1, H2: MountingHole; MountingHole_3.2mm_M3
IC1, IC2, IC3: LZSR_80-P; LZSR80P; Manufacturer_Part_Number LZSR 80-P
J1: to INV_Mainboard_TI; PinHeader_1x16_P2.54mm_Vertical; not fitted

Connections:
/U+: IC3.3 (UOUT), J1.13
/U-: IC3.4 (UREF), J1.14
/U_GND: IC3.2 (GND), J1.12
/U_PWR: IC3.1 (+UC), J1.11
/V+: IC2.3 (UOUT), J1.9
/V-: IC2.4 (UREF), J1.10
/V_GND: IC2.2 (GND), J1.8
/V_PWR: IC2.1 (+UC), J1.7
/W+: IC1.3 (UOUT), J1.5
/W-: IC1.4 (UREF), J1.6
/W_GND: IC1.2 (GND), J1.4
/W_PWR: IC1.1 (+UC), J1.3
GND: IC1.MH1, IC1.MH2, IC1.MH3, IC1.MH4, IC2.MH1, IC2.MH2, IC2.MH3, IC2.MH4, IC3.MH1, IC3.MH2, IC3.MH3, IC3.MH4, J1.1, J1.2, J1.15, J1.16

Notes on the sheet:
V1.0 initial commit V1.1 shift connector left 6 mm V1.2 shift connector up about 6mm and right 6mm exactly (back to where V1.0 is) for better bus assembly add mounting hole for more sturdy mounting

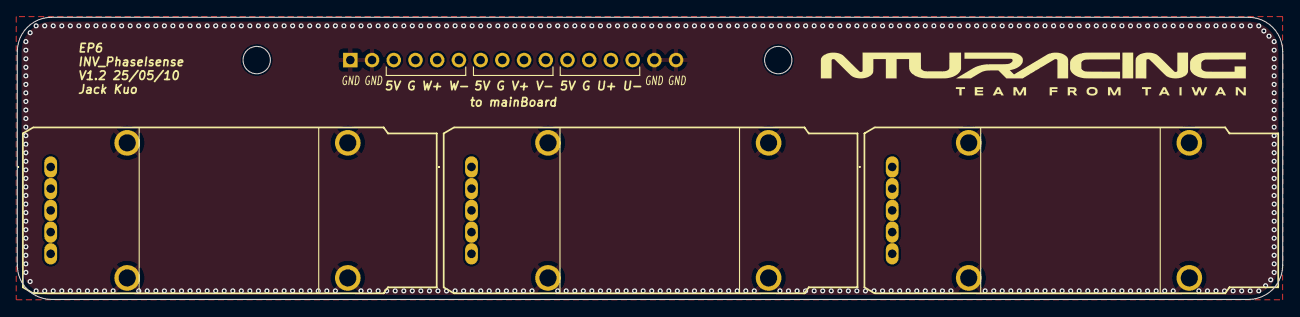
[picture p90: board INV_PhaseIsense.kicad_pcb from above]

Board: 4 copper layers, 148.0 x 33.0 mm, 6 parts (1 on the bottom side), 13 nets.
