NTURacingTeam/nturt_kicad/EP6/Electrical_Group/STlink/STlink.kicad_pcb

## KiCad design EP6/Electrical_Group/STlink/STlink.kicad_pcb (2025-05-08)

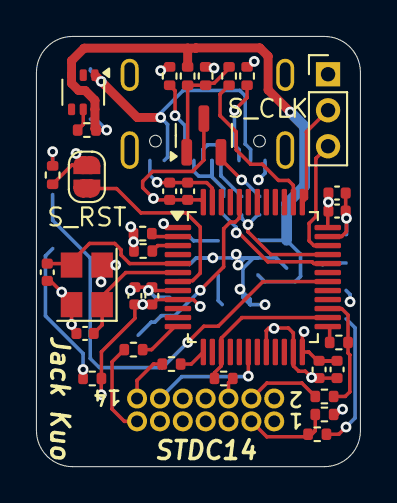
[picture p91: board STlink.kicad_pcb from above]

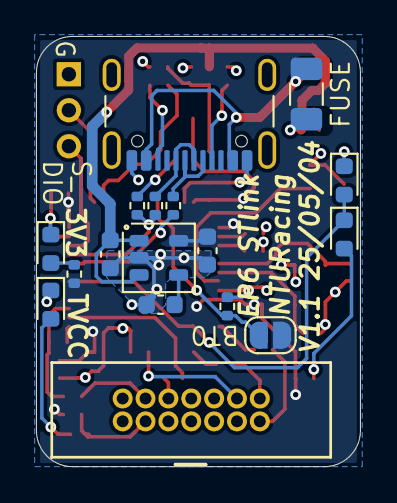
[picture p92: board STlink.kicad_pcb from below]

Board: 4 copper layers, 18.0 x 23.9 mm, 50 parts (17 on the bottom side), 39 nets.

Parts:
C1, C2: 1u; C_0603_1608Metric
C3: 22n; C_0603_1608Metric
C4, C5, C6, C7: 10u 6V; C_0402_1005Metric
C8, C9, C10, C11: 0u1; C_0402_1005Metric
C12, C13: 30p; C_0402_1005Metric
D1: BLUE LED; LED_0603_1608Metric
D2: RED LED; LED_0603_1608Metric
D3: GREEN led; LED_0603_1608Metric
D4: RED led; LED_0603_1608Metric
F1: 0.5A; Fuse_1206_3216Metric
J1: STDC14; box_header_14P_pitch127
J2: S_SWD; PinHeader_1x03_P2.00mm_Vertical
J3: USB_C_stm32; USB_C_Receptacle_GCT_USB4105-xx-A_16P_TopMnt_Horizontal
JP1: S_RESET; SolderJumper-2_P1.3mm_Open_RoundedPad1.0x1.5mm
JP2: BOOT0; SolderJumper-2_P1.3mm_Open_RoundedPad1.0x1.5mm
Q1: MMBT3904; SOT-23
R1: 0R; R_0402_1005Metric
R2, R3: 1k; R_0402_1005Metric
R5, R6, R8, R9, R23, R24: 20R; R_0402_1005Metric
R10, R14: 220R; R_0402_1005Metric
R11: 100k; R_0402_1005Metric
R12, R13, R15, R17: 10k; R_0402_1005Metric
R16, R18: 100R; R_0402_1005Metric
R19: 33k; R_0402_1005Metric
R20, R21: 5k1; R_0402_1005Metric
R22: 1k5; R_0402_1005Metric
U1: RT9193; SOT-23-5
U2: STM32F103CBT6; LQFP-48_7x7mm_P0.5mm
U3: LM66100DCK; SOT-363_SC-70-6
Y2: 8MHz; Crystal_SMD_3225-4Pin_3.2x2.5mm

Connections:
+3V3: C2.1, C4.1, C5.1, C6.1, C7.1, C8.1, C9.1, C10.1, C11.1, JP2.2 (B), Q1.3 (C), R1.1, R3.1, R10.1, U1.5 (OUT), U2.1 (VBAT), U2.9 (VDDA), U2.24 (VDD), U2.36 (VDD), U2.48 (VDD)
+5V: C1.1, F1.2, R15.1, R17.1, U1.1 (IN), U1.3 (EN), U3.3 (~CE), U3.6 (VOUT)
/STlink/BOOT0: JP2.1 (A), R11.1, U2.44 (BOOT0)
/STlink/LED_STLINK: D3.1 (K), D4.2 (A), U2.30 (PA9)
/STlink/OSC_IN: C12.1, U2.5 (PD0), Y2.3
/STlink/OSC_OUT: C13.1, U2.6 (PD1), Y2.1
/STlink/RENUM: R18.1, U2.38 (PA15)
/STlink/S_CLK: J2.2, U2.37 (PA14)
/STlink/S_DIO: J2.3, U2.34 (PA13)
/STlink/S_NRST: JP1.2 (B), U2.7 (NRST)
/STlink/USART2_RX: R6.1, U2.13 (PA3)
/STlink/USART2_TX: R5.1, U2.12 (PA2)
/STlink/USB_D+: J3.A6 (D+), J3.B6 (D+), R24.1
/STlink/USB_D-: J3.A7 (D-), J3.B7 (D-), R23.1
/STlink/USB_DN: R23.2, U2.32 (PA11)
/STlink/USB_DP: R22.2, R24.2, U2.33 (PA12)
/STlink/VBUS: F1.1, J3.A4 (VBUS), J3.A9 (VBUS), J3.B4 (VBUS), J3.B9 (VBUS), U3.1 (VIN)
/STlink/t_CLK: R8.1, U2.15 (PA5), U2.26 (PB13)
/STlink/t_DIO: R9.1, R16.1, U2.27 (PB14)
/T_3V3: J1.3, R1.2, R2.1
/T_NRST: J1.12, U2.18 (PB0)
/T_SWCLK: J1.6, R8.2
/T_SWDIO: J1.4, R9.2
/T_VCP_RX: J1.13, R5.2
/T_VCP_TX: J1.14, R6.2
GND: C1.2, C2.2, C3.2, C4.2, C5.2, C6.2, C7.2, C8.2, C9.2, C10.2, C11.2, C12.2, C13.2, D1.1 (K), D2.1 (K), J1.5, J1.7, J2.1, J3.A1 (GND), J3.A12 (GND), J3.B1 (GND), J3.B12 (GND), JP1.1 (A), R11.2, R12.2, R13.2, R14.2, R19.2, R20.1, R21.1, U1.2, U2.8 (VSSA), U2.20 (PB2), U2.23 (VSS), U2.35 (VSS), U2.47 (VSS), U3.2 (GND), Y2.2, Y2.4
unnamed: D1.2 (A), R2.2
unnamed: D2.2 (A), R3.2
unnamed: D3.2 (A), R10.2
unnamed: D4.1 (K), R14.1
unnamed: J3.A5 (CC1), R20.2
unnamed: J3.B5 (CC2), R21.2
unnamed: Q1.1 (B), R17.2, R18.2, R19.1
unnamed: Q1.2 (E), R22.1
unnamed: C3.1, U1.4 (BYP)
unnamed: R16.2, U2.25 (PB12)
unnamed: R12.1, U2.2 (PC13)
unnamed: R13.1, U2.3 (PC14)
unnamed: R15.2, U3.5 (ST)
