NTURacingTeam/nturt_kicad/EP6/Electrical_Group/IMU_DIY/IMU_DIY.kicad_pcb

## KiCad design EP6/Electrical_Group/IMU_DIY/IMU_DIY.kicad_pcb (2025-05-08)

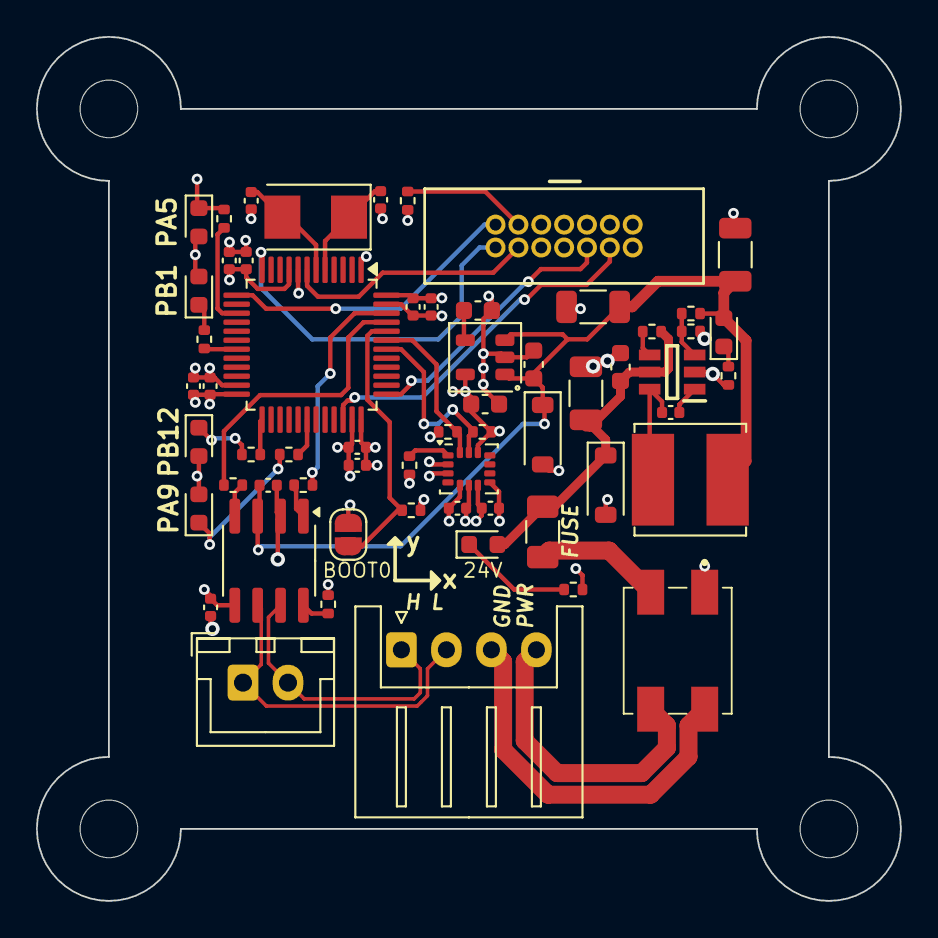
[picture p93: board IMU_DIY.kicad_pcb from above]

Board: 4 copper layers, 48.0 x 48.0 mm, 64 parts (0 on the bottom side), 41 nets.

Parts:
C1, C2, C3, C4: 10u 6V; C_0402_1005Metric
C5, C6, C7, C8, C11, C65, C66, C89, C90: 0u1; C_0402_1005Metric
C9, C10: 30p; C_0402_1005Metric
C12, C13: 1u; C_0603_1608Metric
C14: 22n; C_0603_1608Metric
C15, C16: 22u 25V; C_1206_3216Metric
C45: 10u 35V; C_1206_3216Metric
C93: 0u1; C_0603_1608Metric
D1: 5.7V MMSZ5233B-7-F; D_SOD-123
D2: RED 24V; LED_0603_1608Metric
D3: RED 5V; LED_0603_1608Metric
D4: WHITE LED; LED_0603_1608Metric
D5: GREEN LED; LED_0603_1608Metric
D6: YELLOW LED; LED_0603_1608Metric
D16: BLUE LED; LED_0603_1608Metric
D32: 27V MMSZ5254B-7-F; D_SOD-123
F1: 0.5A; Fuse_1206_3216Metric
FL1: ACM70V-701-2PL-TL00; ACM70V7012PLTL00
H1, H2, H3, H4: MountingHole; MountingHole_3.2mm_M3
IC1: LMR50410Y3FQDBVRQ1; SOT95P280X145-6N
J2: Conn_01x04; JST_XH_S4B-XH-A_1x04_P2.50mm_Horizontal
J3: STDC14; box_header_14P_pitch127
J4: CAN; JST_XH_B2B-XH-A_1x02_P2.50mm_Vertical
JP3: boot0; SolderJumper-2_P1.3mm_Open_RoundedPad1.0x1.5mm
L5: 47u 1.6A (SRN6045TA-470M); L_Bourns_SRN6045TA
R3, R7, R12, R13: 1k; R_0402_1005Metric
R4, R76, R77: 100R; R_0402_1005Metric
R5, R6, R17, R19, R20, R51: 10k; R_0402_1005Metric
R11: 8k2; R_0402_1005Metric
R18: 2k; R_0402_1005Metric
R72, R74: 3k3; R_0402_1005Metric
U1: STM32F103C8Tx; LQFP-48_7x7mm_P0.5mm
U3: RT9193; SOT-23-5
U4: LSM6DSO32; LGA-14_3x2.5mm_P0.5mm_LayoutBorder3x4y
U11: TCAN1042VDRQ1; SOIC-8_3.9x4.9mm_P1.27mm
Y1: 8MHz X49SM8MSD2SC; Crystal_SMD_5032-2Pin_5.0x3.2mm

Connections:
+3V3: C1.1, C2.1, C3.1, C4.1, C5.1, C6.1, C7.1, C8.1, C13.1, C66.1, C89.2, C90.2, D4.2 (A), D5.2 (A), D6.2 (A), D16.2 (A), J3.3, JP3.2 (B), R72.1, R74.1, U1.1 (VBAT), U1.9 (VDDA), U1.24 (VDD), U1.36 (VDD), U1.48 (VDD), U3.5 (OUT), U4.5 (VDDIO), U4.8 (VDD), U4.12 (CS), U11.5 (VIO)
+5V: C12.1, C15.1, C16.1, C65.1, D1.1 (K), D3.2 (A), L5.2, R11.1, U3.1 (IN), U3.3 (EN), U11.3 (VCC)
+24V: C45.1, C93.2, D2.2 (A), D32.1 (K), F1.2, IC1.5 (VIN), R20.1
+24V_preCMfilter: FL1.3, J2.4
/5V_3V3/5V_buck_FB: IC1.3 (FB), R11.2, R18.1
/5V_3V3/5V_buck_sw: C11.1, IC1.6 (SW), L5.1
/BOOT0: JP3.1 (A), R5.2, U1.44 (BOOT0)
/CAN_RX: R77.1, U1.45 (PB8)
/CAN_TX: R76.1, U1.46 (PB9)
/I2C1_SCL: R72.2, U1.42 (PB6), U4.13 (SCL)
/I2C1_SDA: R74.2, U1.43 (PB7), U4.14 (SDA)
/NRST: J3.12, U1.7 (NRST)
/OSC_IN: C9.1, U1.5 (PD0), Y1.1
/OSC_OUT: C10.1, U1.6 (PD1), Y1.2
/SWCLK: J3.6, U1.37 (PA14)
/SWDIO: J3.4, U1.34 (PA13)
/USART2_RX: J3.13, U1.13 (PA3)
/USART2_TX: J3.14, U1.12 (PA2)
/electrical1/CANH: J2.1, J4.2, U11.7 (CANH)
/electrical1/CANL: J2.2, J4.1, U11.6 (CANL)
/power/+24V_prefuse: F1.1, FL1.2
GND: C1.2, C2.2, C3.2, C4.2, C5.2, C6.2, C7.2, C8.2, C9.2, C10.2, C12.2, C13.2, C14.2, C15.2, C16.2, C45.2, C65.2, C66.2, C89.1, C90.1, C93.1, D1.2 (A), D32.2 (A), FL1.1, IC1.2 (GND), J3.5, J3.7, R4.1, R5.1, R6.1, R17.2, R18.2, R19.2, R51.2, U1.8 (VSSA), U1.23 (VSS), U1.35 (VSS), U1.47 (VSS), U3.2, U4.2 (SDX), U4.3 (SCX), U4.6 (GND), U4.7 (GND), U11.2 (GND)
GNDPWR: FL1.4, J2.3
unnamed: D2.1 (K), R17.1
unnamed: D3.1 (K), R19.1
unnamed: D4.1 (K), R3.1
unnamed: D5.1 (K), R12.1
unnamed: D6.1 (K), R13.1
unnamed: D16.1 (K), R7.1
unnamed: C11.2, IC1.1 (CB)
unnamed: IC1.4 (EN), R20.2
unnamed: J3.11, R4.2
unnamed: R7.2, U1.15 (PA5)
unnamed: R13.2, U1.30 (PA9)
unnamed: R12.2, U1.19 (PB1)
unnamed: R3.2, U1.25 (PB12)
unnamed: C14.1, U3.4 (BYP)
unnamed: R6.2, U4.1 (SDO/SA0)
unnamed: R77.2, U11.4 (RXD)
unnamed: R51.1, U11.8 (STB)
unnamed: R76.2, U11.1 (TXD)
