NTURacingTeam/nturt_kicad/EP6/Electrical_Group/Adaptor_USB/Adaptor_USB.kicad_pcb

## KiCad design EP6/Electrical_Group/Adaptor_USB/Adaptor_USB.kicad_pcb (2025-05-04)

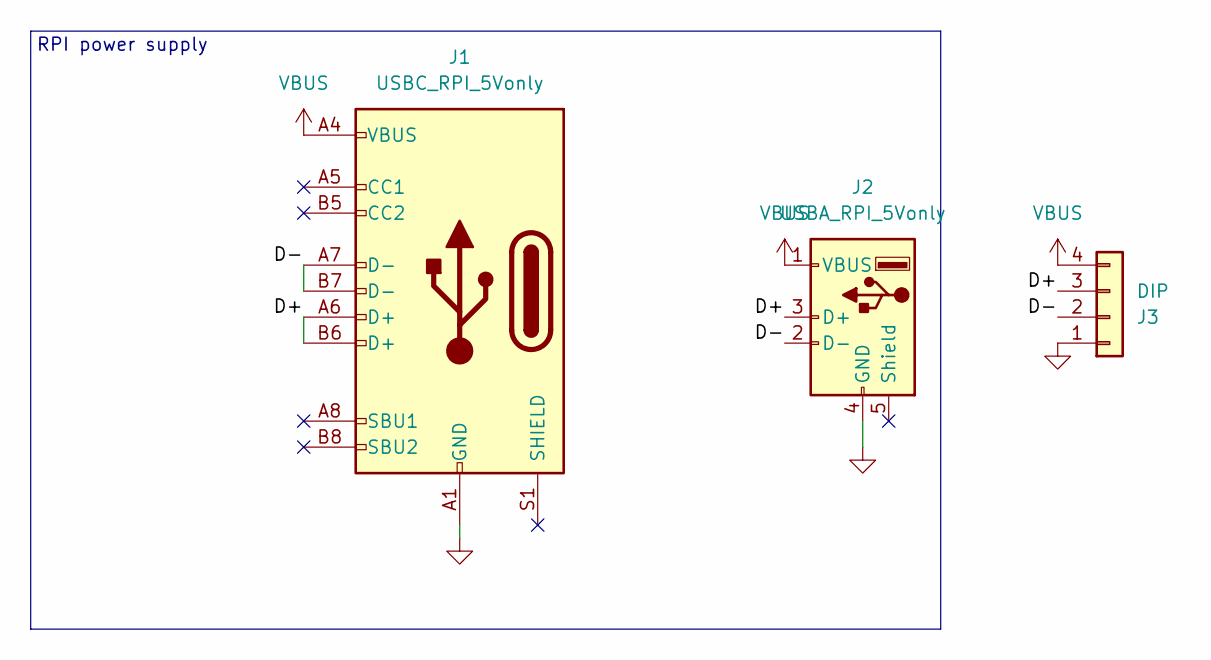
[picture p94: schematic Adaptor_USB.kicad_sch]

Parts:
J1: USBC_RPI_5Vonly; USB_C_Receptacle_GCT_USB4105-xx-A_16P_TopMnt_Horizontal
J2: USBA_RPI_5Vonly; USB_A_Molex_67643_Horizontal
J3: DIP; PinHeader_1x04_P2.54mm_Vertical; Part Number 1-0401FBV0T

Connections:
/D+: J1.A6 (D+), J1.B6 (D+), J2.3 (D+), J3.3
/D-: J1.A7 (D-), J1.B7 (D-), J2.2 (D-), J3.2
GND: J1.A1 (GND), J1.A12 (GND), J1.B1 (GND), J1.B12 (GND), J2.4 (GND), J3.1
VBUS: J1.A4 (VBUS), J1.A9 (VBUS), J1.B4 (VBUS), J1.B9 (VBUS), J2.1 (VBUS), J3.4

Notes on the sheet:
RPI power supply

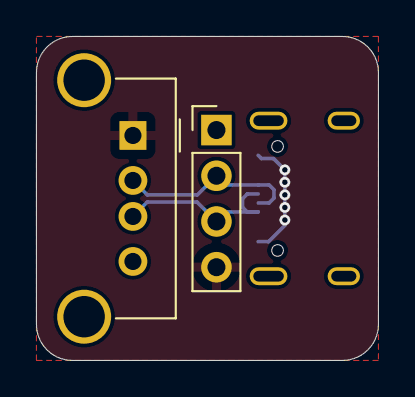
[picture p95: board Adaptor_USB.kicad_pcb from above]

Board: 2 copper layers, 19.0 x 18.0 mm, 3 parts (1 on the bottom side), 4 nets.
