NTURacingTeam/nturt_kicad/EP6/Electrical_Group/PWRboard1/PWRboard1.kicad_pcb

## KiCad design EP6/Electrical_Group/PWRboard1/PWRboard1.kicad_pcb (2025-05-04)

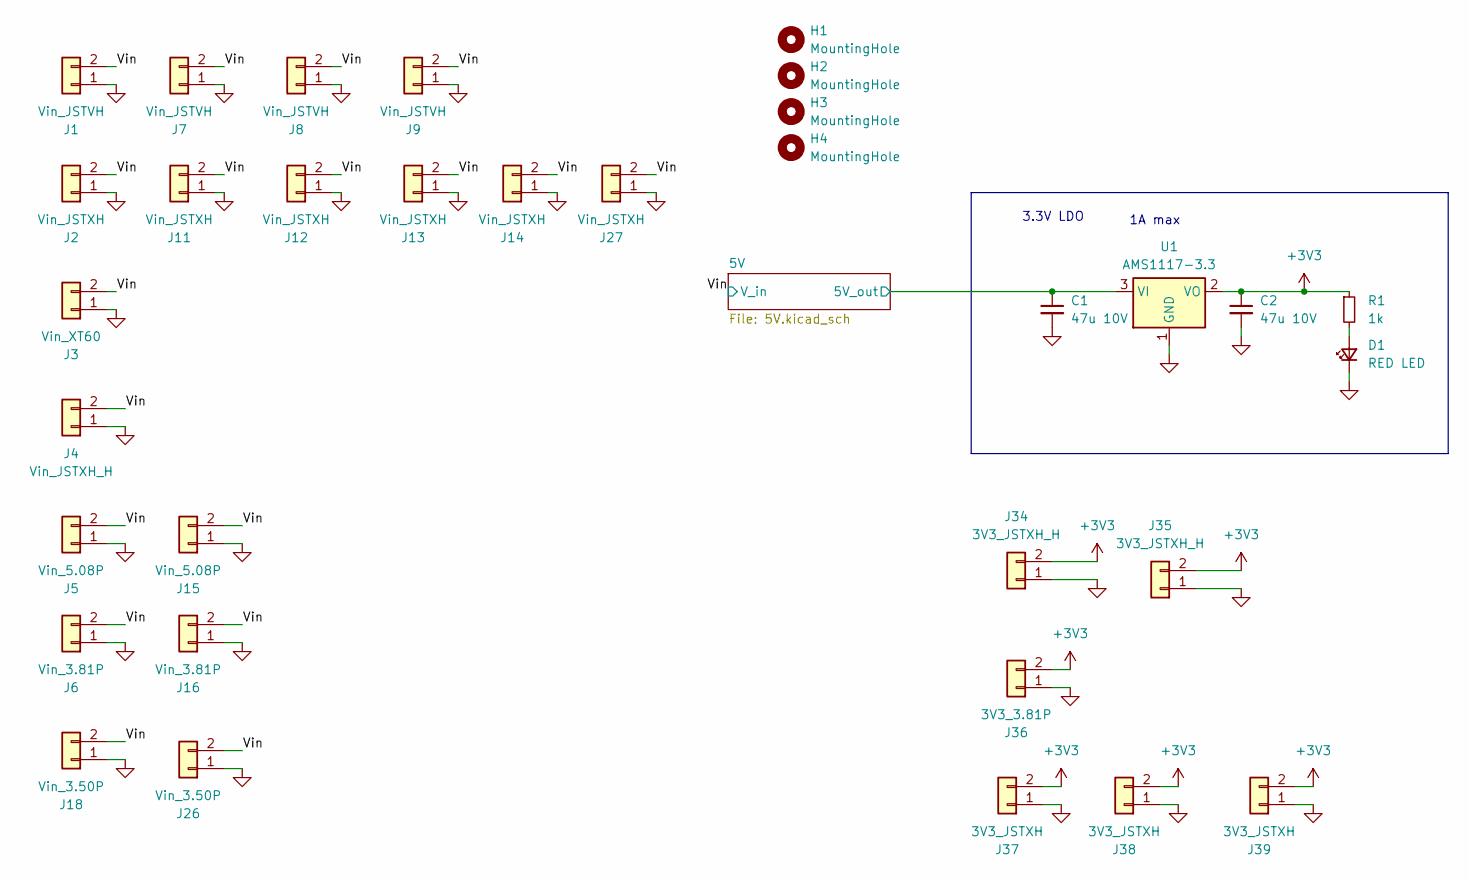
[picture p96: schematic PWRboard1.kicad_sch]

Parts:
C1, C2: 47u 10V; C_1206_3216Metric
D1: RED LED; LED_0603_1608Metric
H1, H2, H3, H4: MountingHole; MountingHole_3.2mm_M3
J1, J7, J8, J9: Vin_JSTVH; JST_VH_B2P-VH_1x02_P3.96mm_Vertical
J2, J11, J12, J13, J14, J27: Vin_JSTXH; JST_XH_B2B-XH-A_1x02_P2.50mm_Vertical
J3: Vin_XT60; AMASS_XT60PW-M_1x02_P7.20mm_Horizontal
J4: Vin_JSTXH_H; JST_XH_S2B-XH-A_1x02_P2.50mm_Horizontal
J5, J15: Vin_5.08P; PhoenixContact_MSTBA_2,5_2-G-5,08_1x02_P5.08mm_Horizontal
J6, J16: Vin_3.81P; PhoenixContact_MC_1,5_2-G-3.81_1x02_P3.81mm_Horizontal
J18, J26: Vin_3.50P; PhoenixContact_MC_1,5_2-G-3.5_1x02_P3.50mm_Horizontal
J34, J35: 3V3_JSTXH_H; JST_XH_S2B-XH-A_1x02_P2.50mm_Horizontal
J36: 3V3_3.81P; PhoenixContact_MC_1,5_2-G-3.81_1x02_P3.81mm_Horizontal
J37, J38, J39: 3V3_JSTXH; JST_XH_B2B-XH-A_1x02_P2.50mm_Vertical
R1: 1k; R_0402_1005Metric
U1: AMS1117-3.3; SOT-223-3_TabPin2

Connections:
+3V3: C2.1, J34.2, J35.2, J36.2, J37.2, J38.2, J39.2, R1.1, U1.2 (VO)
/5V/+5V_buck: C1.1, U1.3 (VI); also elsewhere on the board
/Vin: J1.2, J2.2, J3.2, J4.2, J5.2, J6.2, J7.2, J8.2, J9.2, J11.2, J12.2, J13.2, J14.2, J15.2, J16.2, J18.2, J26.2, J27.2; also elsewhere on the board
GND: C1.2, C2.2, D1.1 (K), J1.1, J2.1, J3.1, J4.1, J5.1, J6.1, J7.1, J8.1, J9.1, J11.1, J12.1, J13.1, J14.1, J15.1, J16.1, J18.1, J26.1, J27.1, J34.1, J35.1, J36.1, J37.1, J38.1, J39.1, U1.1 (GND); also elsewhere on the board
unnamed: D1.2 (A), R1.2

Notes on the sheet:
1A max
3.3V LDO

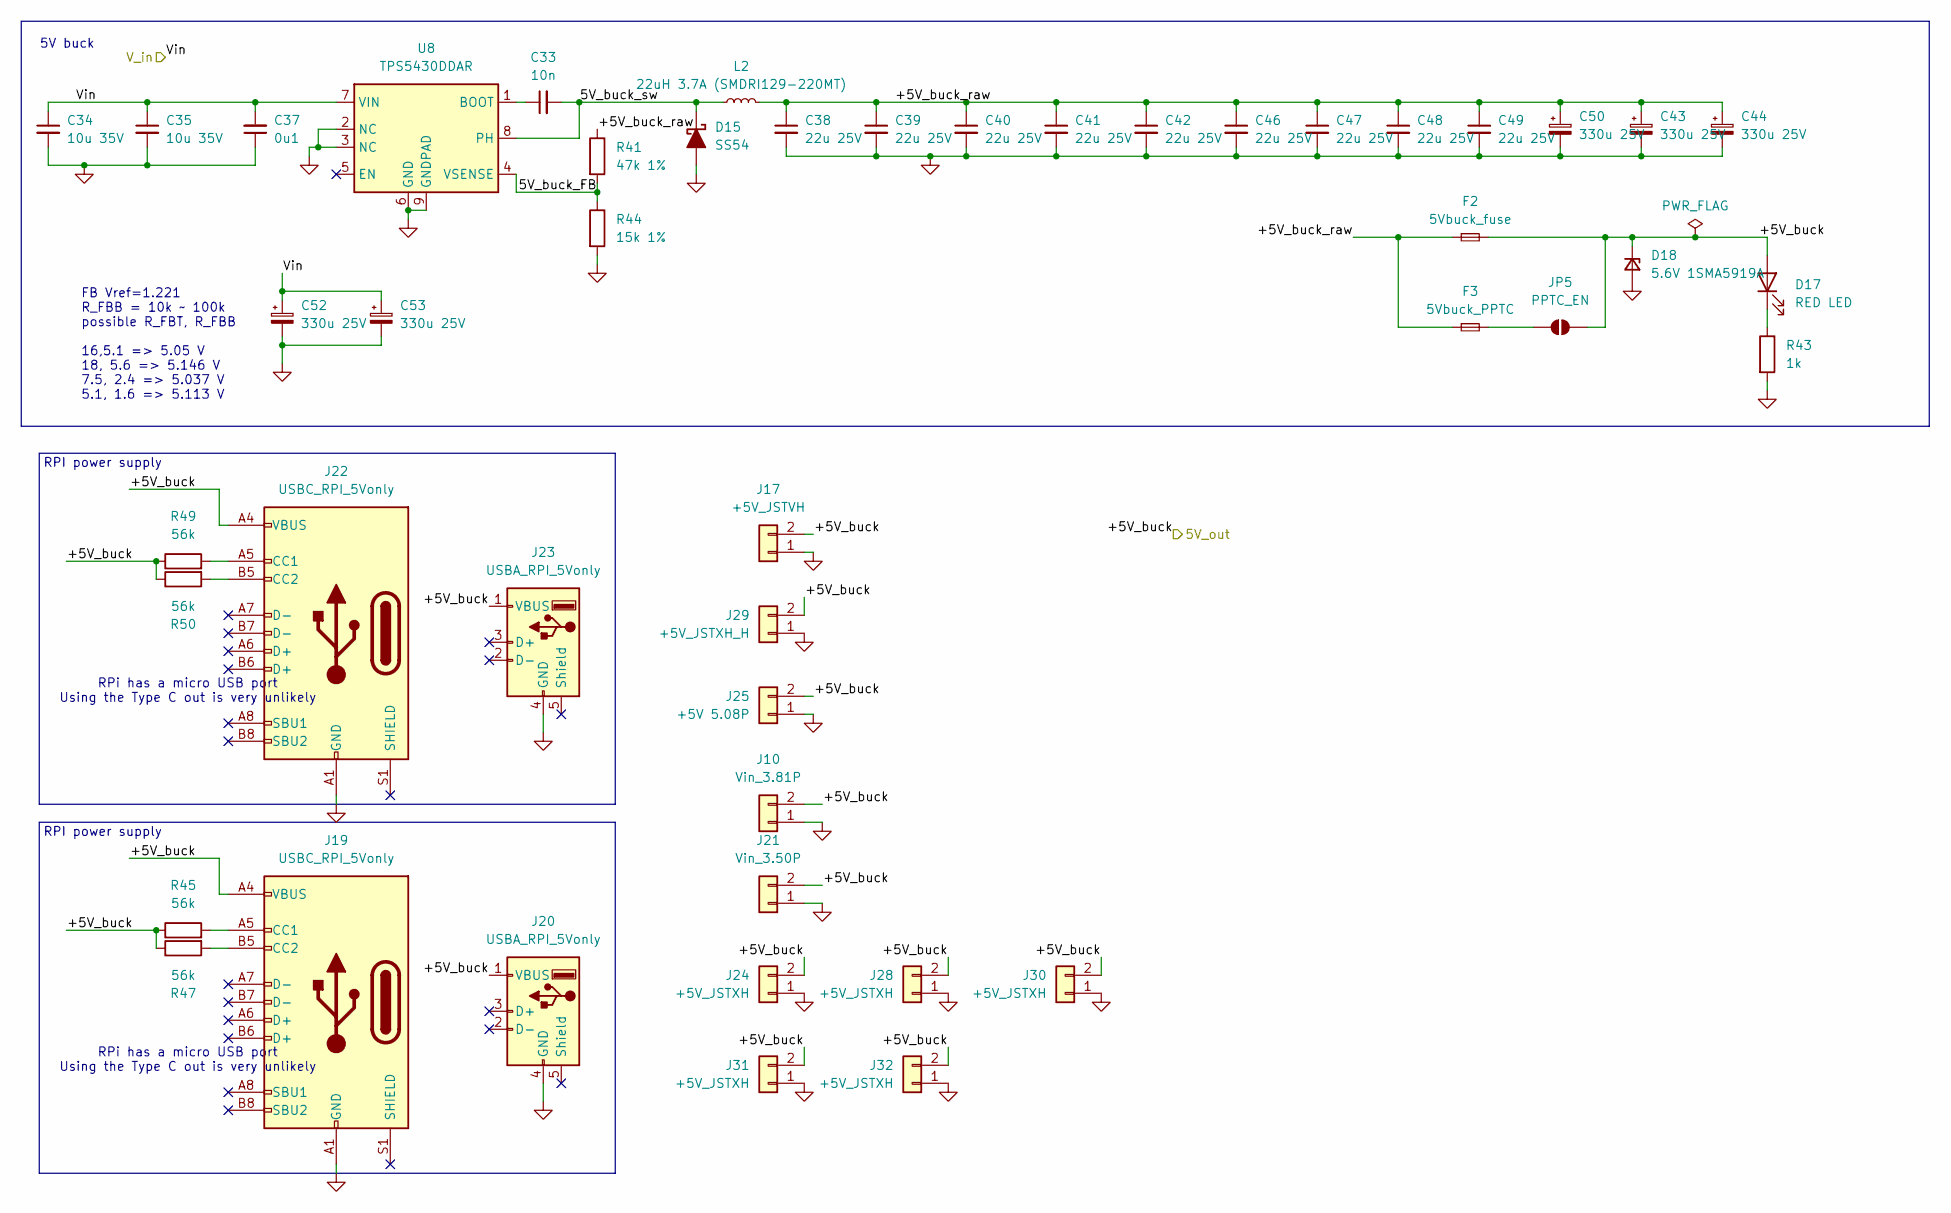
[picture p97: schematic 5V.kicad_sch, PWRboard1]

Parts:
C33: 10n; C_0603_1608Metric
C34, C35: 10u 35V; C_1206_3216Metric
C37: 0u1; C_0603_1608Metric
C38, C39, C40, C41, C42, C46, C47, C48, C49: 22u 25V; C_1206_3216Metric
C43, C44, C50, C52, C53: 330u 25V; CP_Radial_D8.0mm_P3.80mm
D15: SS54; D_SMA
D17: RED LED; LED_0603_1608Metric
D18: 5.6V 1SMA5919A; D_SMA
F2: 5Vbuck_fuse; Fuseholder_Cylinder-5x20mm_Stelvio-Kontek_PTF78_Horizontal_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
F3: 5Vbuck_PPTC; Fuse_1206_3216Metric
J10: Vin_3.81P; PhoenixContact_MC_1,5_2-G-3.81_1x02_P3.81mm_Horizontal
J17: +5V_JSTVH; JST_VH_B2P-VH_1x02_P3.96mm_Vertical
J19, J22: USBC_RPI_5Vonly; USB_C_Receptacle_GCT_USB4105-xx-A_16P_TopMnt_Horizontal
J20, J23: USBA_RPI_5Vonly; USB_A_Molex_67643_Horizontal
J21: Vin_3.50P; PhoenixContact_MC_1,5_2-G-3.5_1x02_P3.50mm_Horizontal
J24, J28, J30, J31, J32: +5V_JSTXH; JST_XH_B2B-XH-A_1x02_P2.50mm_Vertical
J25: +5V 5.08P; PhoenixContact_MSTBA_2,5_2-G-5,08_1x02_P5.08mm_Horizontal
J29: +5V_JSTXH_H; JST_XH_S2B-XH-A_1x02_P2.50mm_Horizontal
JP5: PPTC_EN; SolderJumper-2_P1.3mm_Open_RoundedPad1.0x1.5mm
L2: 22uH 3.7A (SMDRI129-220MT); L_Bourns_SRR1260
R41: 47k 1%; R_0603_1608Metric
R43: 1k; R_0402_1005Metric
R44: 15k 1%; R_0603_1608Metric
R45, R47, R49, R50: 56k; R_0402_1005Metric
U8: TPS5430DDAR; TI_SO-PowerPAD-8_ThermalVias

Connections:
/5V/5V_buck_FB: R41.2, R44.1, U8.4 (VSENSE)
/5V/5V_buck_sw: C33.2, D15.1 (K), L2.1, U8.8 (PH)
/5V/+5V_buck: D17.2 (A), D18.1 (K), F2.2, J10.2, J17.2, J19.A4 (VBUS), J19.A9 (VBUS), J19.B4 (VBUS), J19.B9 (VBUS), J20.1 (VBUS), J21.2, J22.A4 (VBUS), J22.A9 (VBUS), J22.B4 (VBUS), J22.B9 (VBUS), J23.1 (VBUS), J24.2, J25.2, J28.2, J29.2, J30.2, J31.2, J32.2, JP5.2 (B), R45.1, R47.1, R49.1, R50.1; also elsewhere on the board
/5V/+5V_buck_raw: C38.1, C39.1, C40.1, C41.1, C42.1, C43.1, C44.1, C46.1, C47.1, C48.1, C49.1, C50.1, F2.1, F3.1, L2.2, R41.1
/Vin: C34.1, C35.1, C37.2, C52.1, C53.1, U8.7 (VIN); also elsewhere on the board
GND: C34.2, C35.2, C37.1, C38.2, C39.2, C40.2, C41.2, C42.2, C43.2, C44.2, C46.2, C47.2, C48.2, C49.2, C50.2, C52.2, C53.2, D15.2 (A), D18.2 (A), J10.1, J17.1, J19.A1 (GND), J19.A12 (GND), J19.B1 (GND), J19.B12 (GND), J20.4 (GND), J21.1, J22.A1 (GND), J22.A12 (GND), J22.B1 (GND), J22.B12 (GND), J23.4 (GND), J24.1, J25.1, J28.1, J29.1, J30.1, J31.1, J32.1, R43.2, R44.2, U8.2 (NC), U8.3 (NC), U8.6 (GND), U8.9 (GNDPAD); also elsewhere on the board
unnamed: D17.1 (K), R43.1
unnamed: J19.A5 (CC1), R45.2
unnamed: J19.B5 (CC2), R47.2
unnamed: J22.A5 (CC1), R49.2
unnamed: J22.B5 (CC2), R50.2
unnamed: F3.2, JP5.1 (A)
unnamed: C33.1, U8.1 (BOOT)

Notes on the sheet:
RPi has a micro USB port Using the Type C out is very unlikely
5V buck
RPI power supply
FB Vref=1.221 R_FBB = 10k ~ 100k possible R_FBT, R_FBB 16,5.1 => 5.05 V 18, 5.6 => 5.146 V 7.5, 2.4 => 5.037 V 5.1, 1.6 => 5.113 V

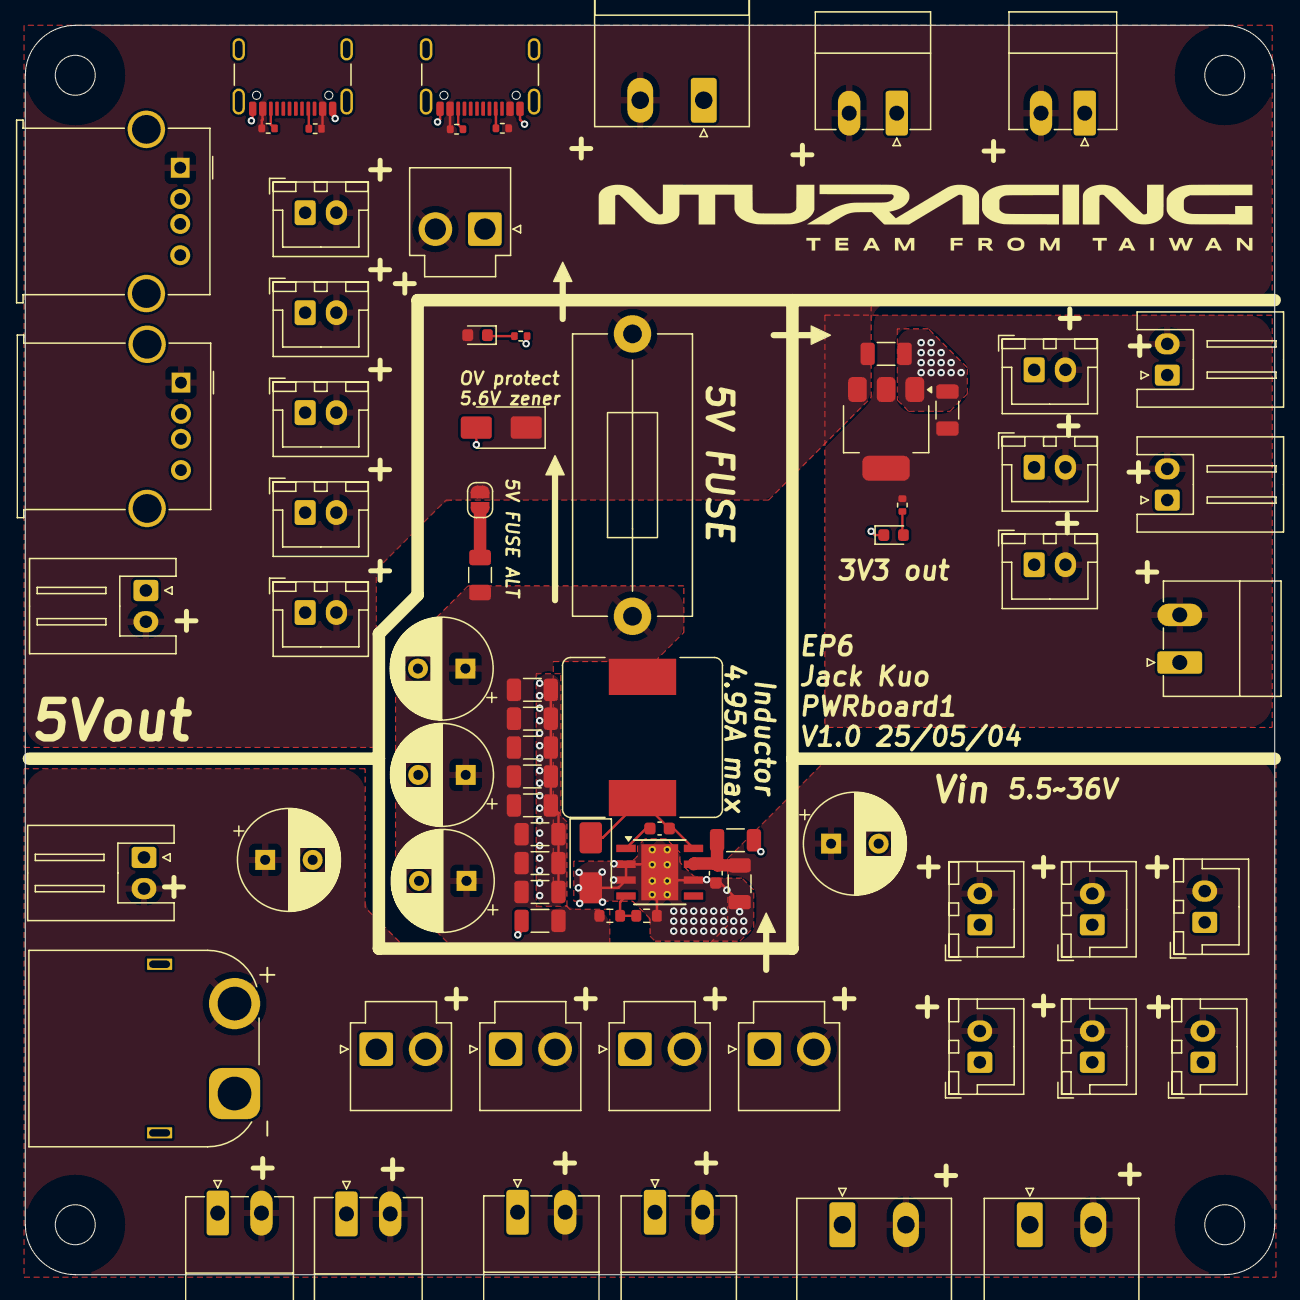
[picture p98: board PWRboard1.kicad_pcb from above]

Board: 2 copper layers, 100.0 x 100.0 mm, 80 parts (0 on the bottom side), 15 nets.
