NTURacingTeam/nturt_kicad/EP6/Powertrain_Group/HVB_TSMP_ResCon/HVB_TSMP_ResCon.kicad_pcb

## KiCad design EP6/Powertrain_Group/HVB_TSMP_ResCon/HVB_TSMP_ResCon.kicad_pcb (2025-03-11)

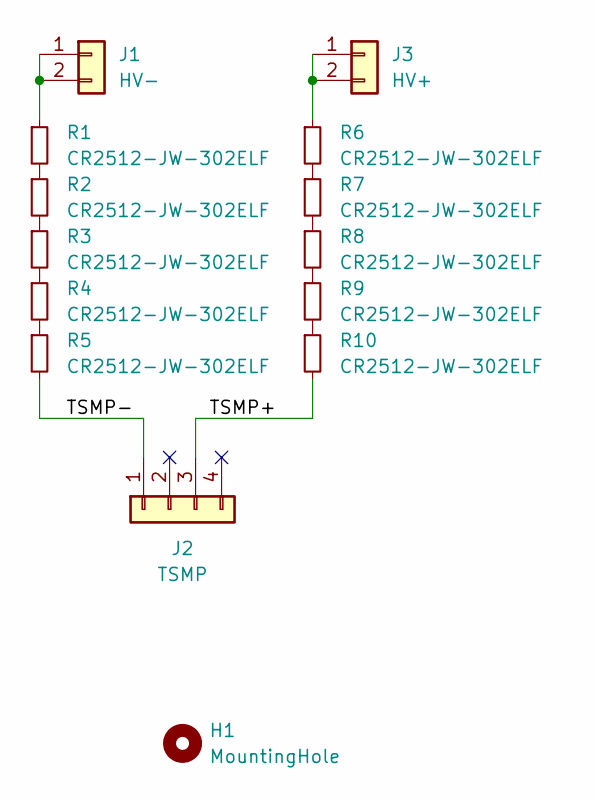
[picture p99: schematic HVB_TSMP_ResCon.kicad_sch]

Parts:
H1: MountingHole; MountingHole_3.2mm_M3
J1: HV-; HRS_DF33C-2P-3.3DSA
J2: TSMP; NianYeong-M12-S-M4P
J3: HV+; HRS_DF33C-2P-3.3DSA
R1, R2, R3, R4, R5, R6, R7, R8, R9, R10: CR2512-JW-302ELF; R_2512_6332Metric

Connections:
/TSMP+: J2.3, R10.2
/TSMP-: J2.1, R5.2
unnamed: J1.1, J1.2, R1.1
unnamed: J3.1, J3.2, R6.1
unnamed: R1.2, R2.1
unnamed: R2.2, R3.1
unnamed: R3.2, R4.1
unnamed: R4.2, R5.1
unnamed: R6.2, R7.1
unnamed: R7.2, R8.1
unnamed: R8.2, R9.1
unnamed: R9.2, R10.1
