NTURacingTeam/nturt_kicad/EP6/Powertrain_Group/HVB_TSMP_ResCon/HVB_TSMP_ResCon.kicad_pcb

## KiCad design EP6/Powertrain_Group/HVB_TSMP_ResCon/HVB_TSMP_ResCon.kicad_pcb (continued)

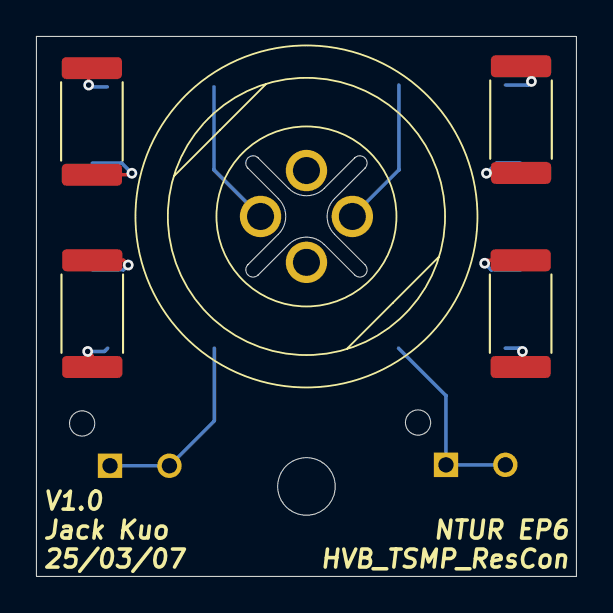
[picture p100: board HVB_TSMP_ResCon.kicad_pcb from above]

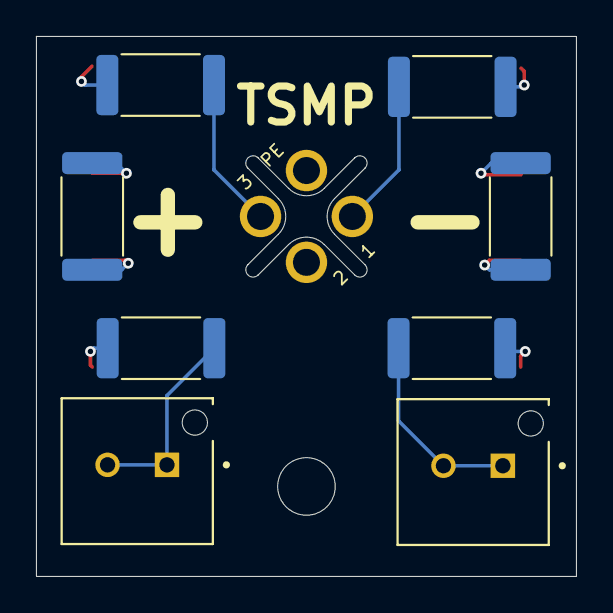
[picture p101: board HVB_TSMP_ResCon.kicad_pcb from below]

Board: 2 copper layers, 30.0 x 30.0 mm, 14 parts (8 on the bottom side), 12 nets.
