NTURacingTeam/nturt_kicad/EP6/Powertrain_Group/ACC_CONN1/ACC_CONN1.kicad_pcb

## KiCad design EP6/Powertrain_Group/ACC_CONN1/ACC_CONN1.kicad_pcb (2025-03-11)

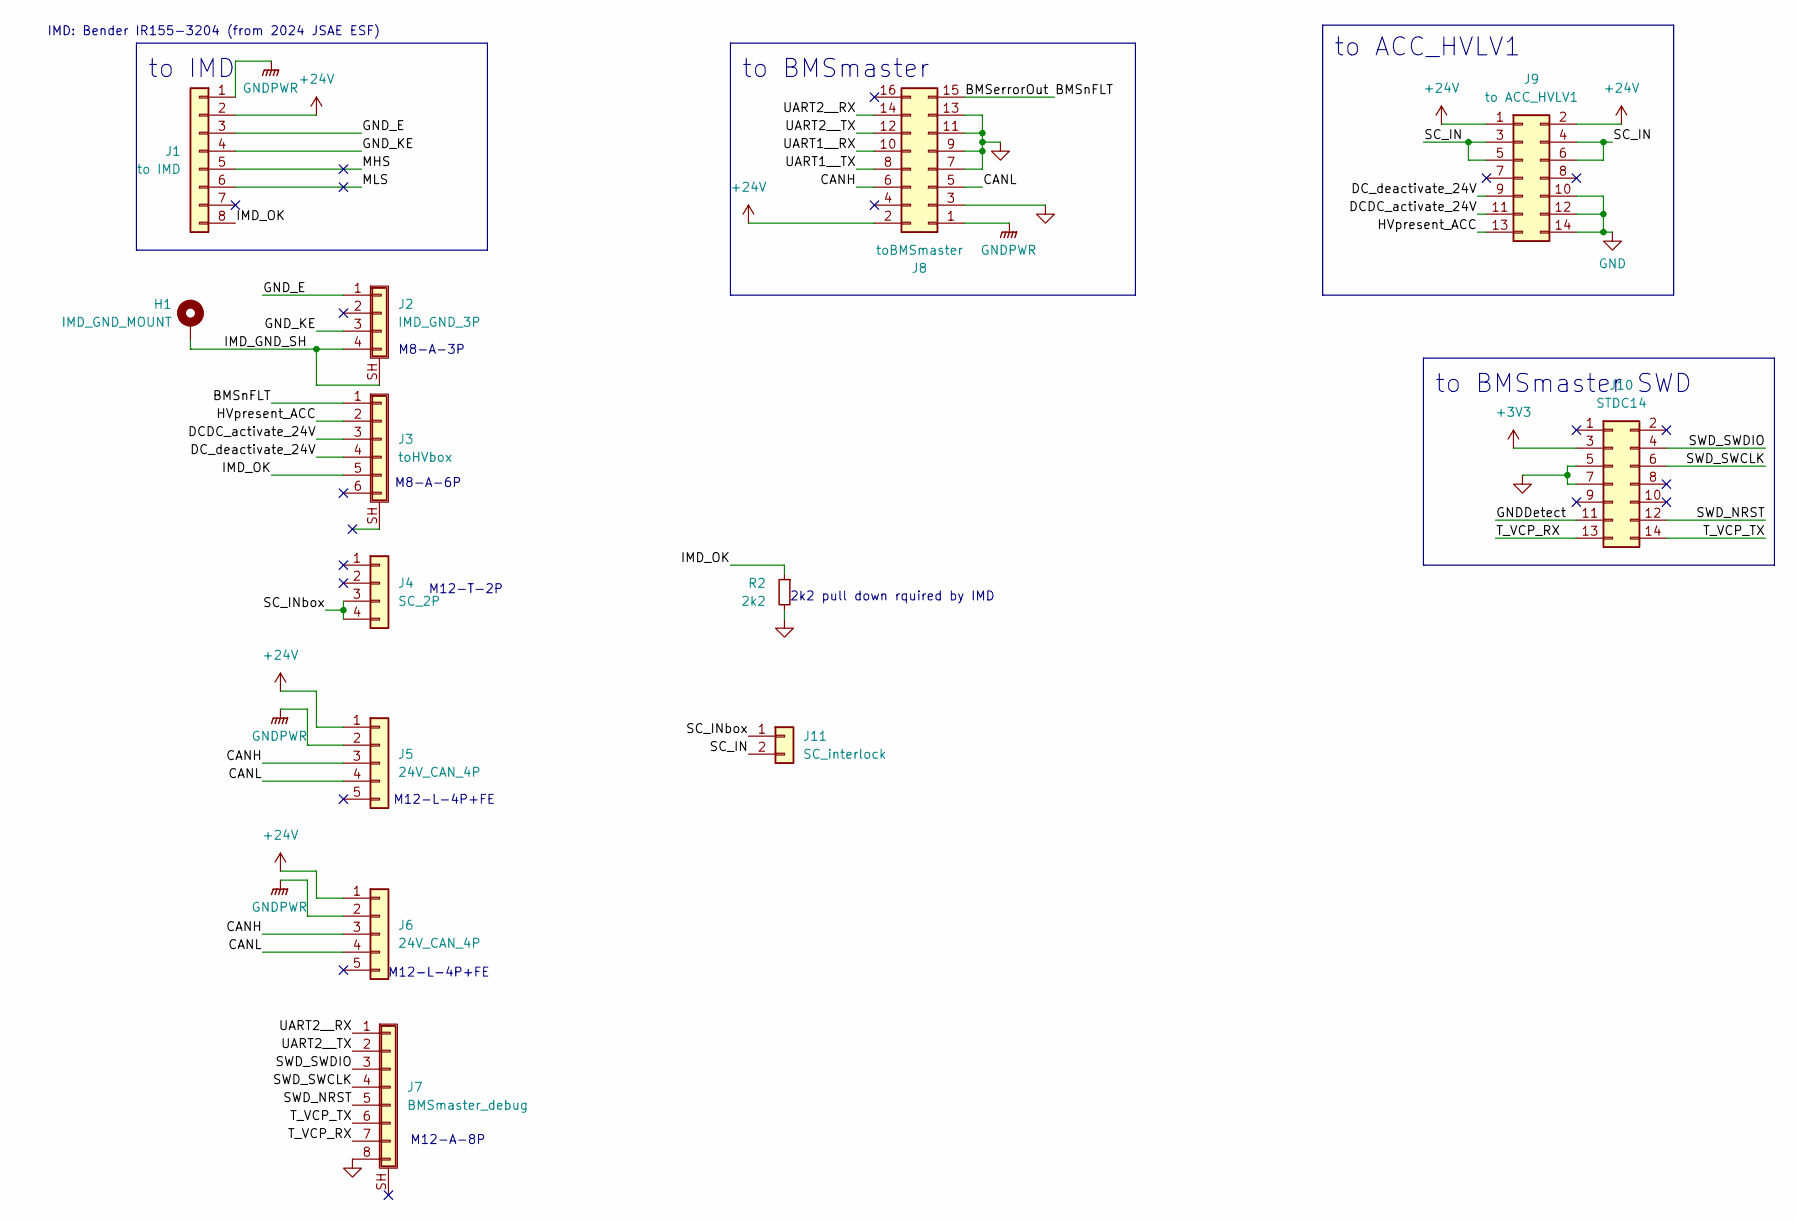
[picture p102: schematic ACC_CONN1.kicad_sch]

Parts:
H1: IMD_GND_MOUNT; MountingHole_3.2mm_M3_Pad_Via
J1: to IMD; JST_XH_B8B-XH-A_1x08_P2.50mm_Vertical
J2: IMD_GND_3P; WP-03F3-09-11
J3: toHVbox; WP-06F3-09-11
J4: SC_2P; NianYeong-M12-T-M4P
J5, J6: 24V_CAN_4P; NianYeong-M12-L-F5P
J7: BMSmaster_debug; NianYeong-M12-A-F8P-Shield
J8: toBMSmaster; IDC-Header_2x08_P2.54mm_Horizontal
J9: to ACC_HVLV1; IDC-Header_2x07_P2.54mm_Vertical
J10: STDC14; box_header_14P_pitch127
J11: SC_interlock; JST_VH_B2P-VH_1x02_P3.96mm_Vertical
R2: 2k2; R_0805_2012Metric

Connections:
+3V3: J10.3
+24V: J1.2, J5.1, J6.1, J8.2, J9.1, J9.2
/BMSerrorOut: J3.1, J8.15
/CANH: J5.3, J6.3, J8.6
/CANL: J5.4, J6.4, J8.5
/DCDC_activate_24V: J3.3, J9.11
/DC_deactivate_24V: J3.4, J9.9
/GNDDetect: J10.11
/GND_E: J1.3, J2.1
/GND_KE: J1.4, J2.3
/HVpresent_ACC: J3.2, J9.13
/IMD_GND_SH: H1.1, J2.4, J2.SH (Shield)
/IMD_OK: J1.8, J3.5, R2.1
/MHS: J1.5
/MLS: J1.6
/SC_IN: J9.3, J9.4, J9.5, J9.6, J11.2
/SC_INbox: J4.3, J4.4, J11.1
/SWD_NRST: J7.5, J10.12
/SWD_SWCLK: J7.4, J10.6
/SWD_SWDIO: J7.3, J10.4
/T_VCP_RX: J7.7, J10.13
/T_VCP_TX: J7.6, J10.14
/UART1__RX: J8.10
/UART1__TX: J8.8
/UART2__RX: J7.1, J8.14
/UART2__TX: J7.2, J8.12
GND: J7.8, J8.3, J8.7, J8.9, J8.11, J8.13, J9.10, J9.12, J9.14, J10.5, J10.7, R2.2
GNDPWR: J1.1, J5.2, J6.2, J8.1

Notes on the sheet:
M12-T-2P
to BMSmaster SWD
M12-L-4P+FE
to BMSmaster
to IMD
to ACC_HVLV1
M8-A-6P
M8-A-3P
2k2 pull down rquired by IMD
IMD: Bender IR155-3204 (from 2024 JSAE ESF)
M12-A-8P

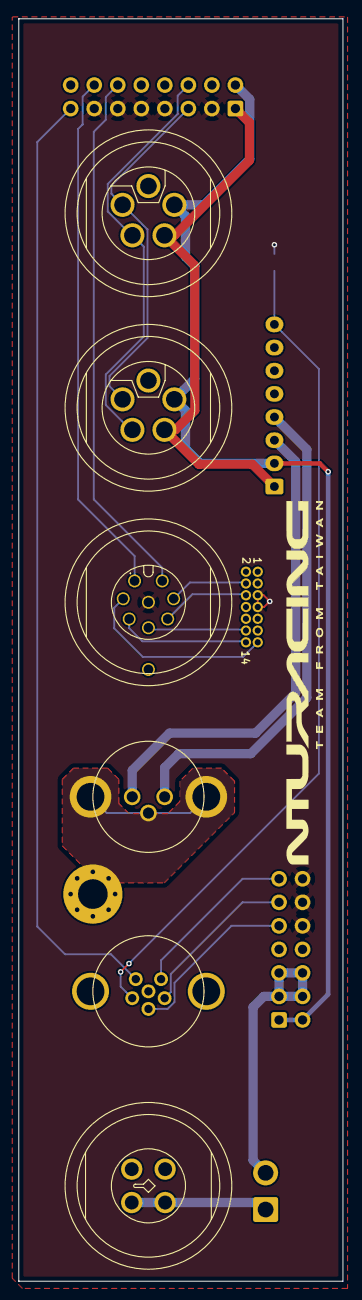
[picture p103: board ACC_CONN1.kicad_pcb from above]

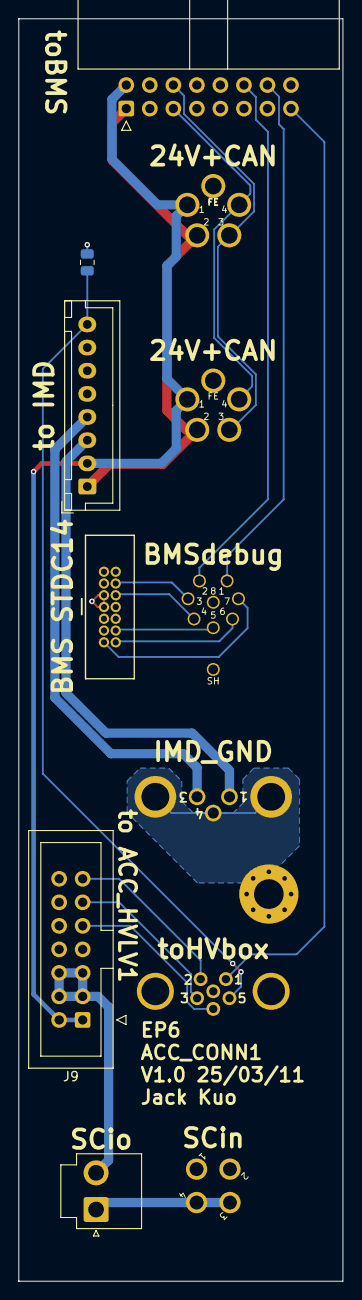
[picture p104: board ACC_CONN1.kicad_pcb from below]

Board: 2 copper layers, 35.0 x 136.3 mm, 13 parts (6 on the bottom side), 22 nets.
