NTURacingTeam/nturt_kicad/EP6/Powertrain_Group/ACC_BMSslave_connector/ACC_BMSslave_connector.kicad_pcb

## KiCad design EP6/Powertrain_Group/ACC_BMSslave_connector/ACC_BMSslave_connector.kicad_pcb (2025-03-11)

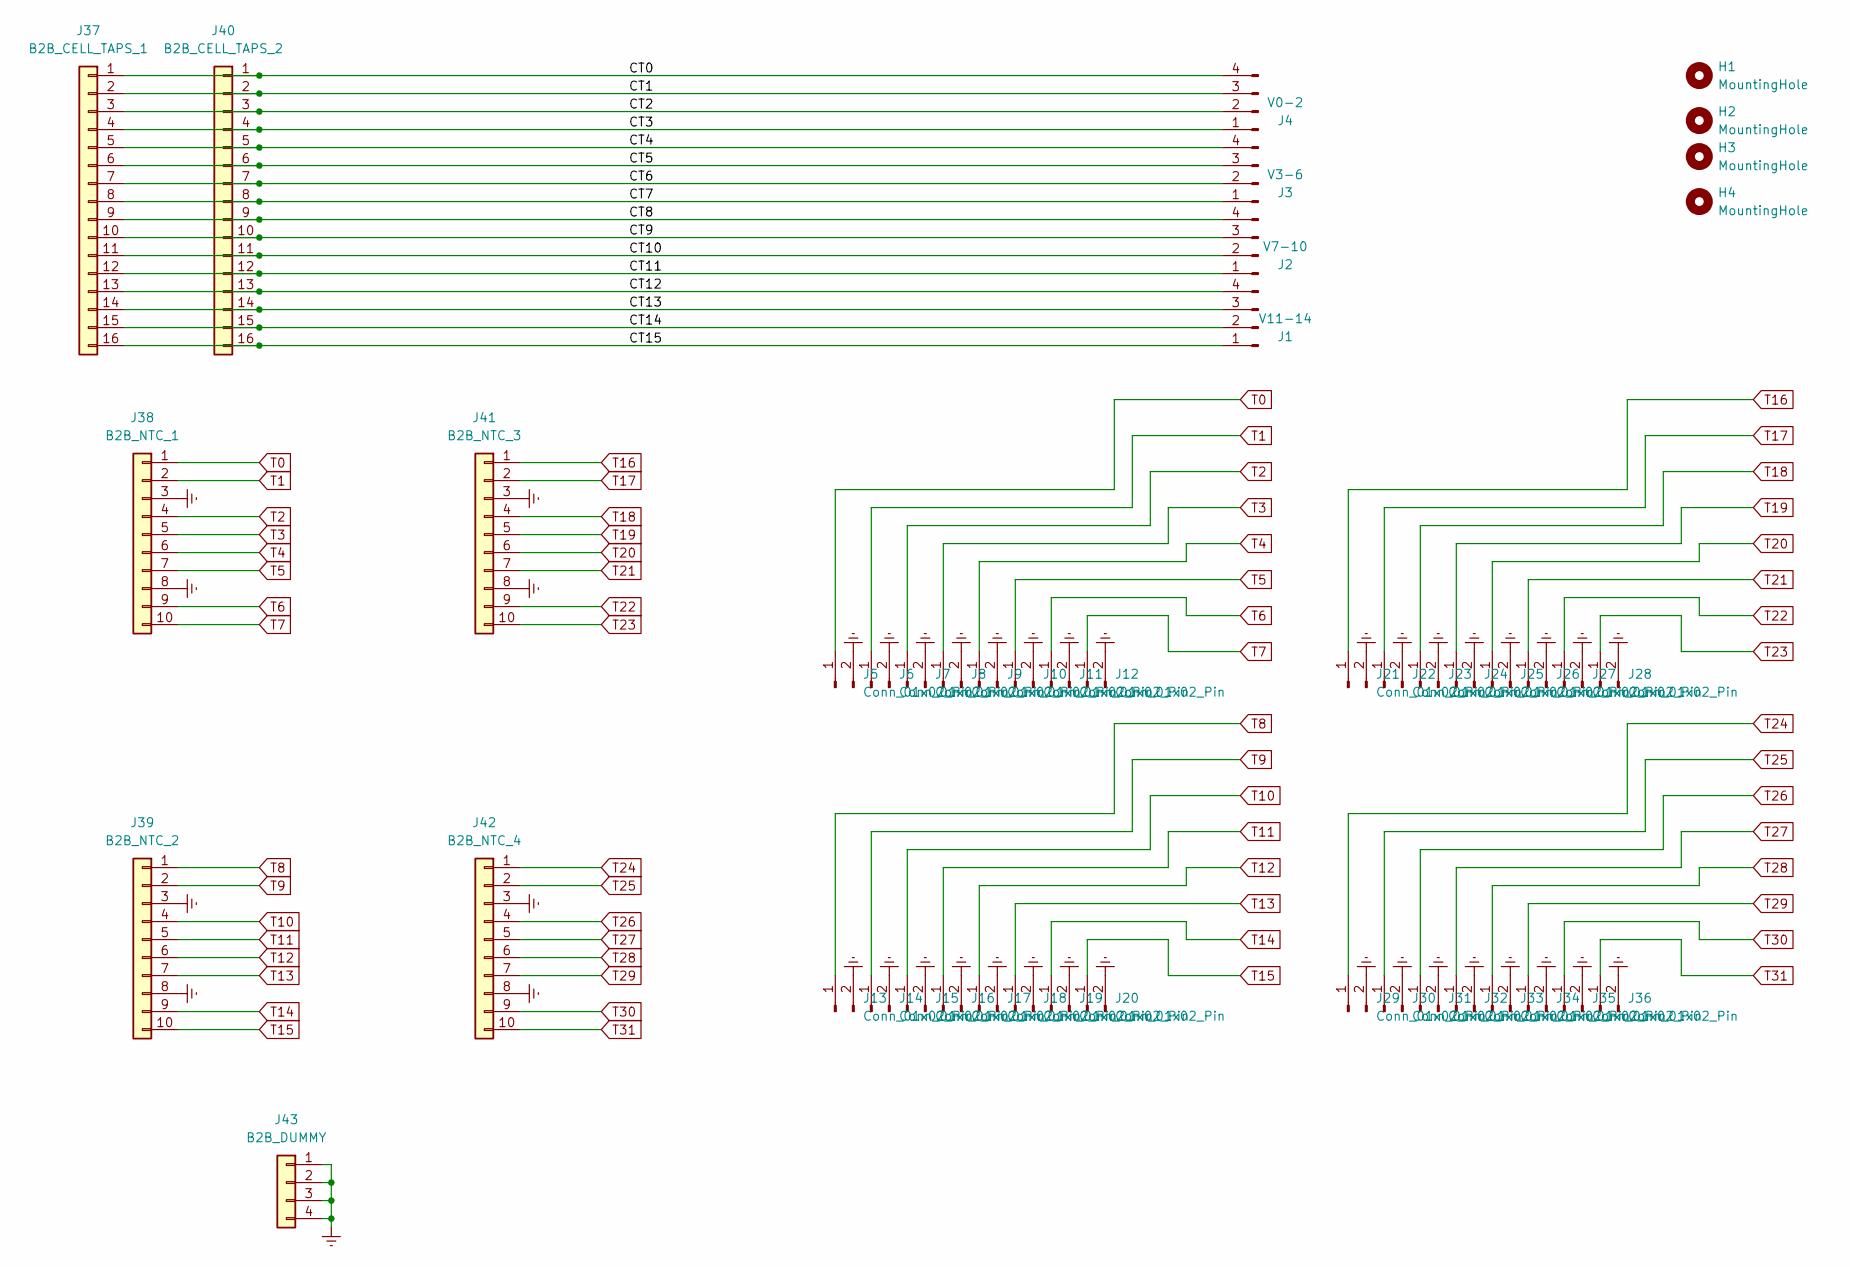
[picture p109: schematic ACC_BMSslave_connector.kicad_sch]

Parts:
H1, H2, H3, H4: MountingHole; MountingHole_4.3mm_M4_DIN965
J1: V11-14; JST_XH_S4B-XH-A_1x04_P2.50mm_Horizontal
J2: V7-10; JST_XH_S4B-XH-A_1x04_P2.50mm_Horizontal
J3: V3-6; JST_XH_S4B-XH-A_1x04_P2.50mm_Horizontal
J4: V0-2; JST_XH_S4B-XH-A_1x04_P2.50mm_Horizontal
J5, J6, J7, J8, J9, J10, J11, J12, J13, J14, J15, J16, J17, J18, J19, J20, J21, J22, J23, J24, J25, J26, J27, J28, J29, J30, J31, J32, J33, J34, J35, J36: Conn_01x02_Pin; SHDR2W50P0X150_1X2_450X350X450P
J37: B2B_CELL_TAPS_1; PinSocket_1x16_P2.54mm_Vertical
J38: B2B_NTC_1; PinSocket_1x10_P2.54mm_Vertical
J39: B2B_NTC_2; PinSocket_1x10_P2.54mm_Vertical
J40: B2B_CELL_TAPS_2; PinSocket_1x16_P2.54mm_Vertical
J41: B2B_NTC_3; PinSocket_1x10_P2.54mm_Vertical
J42: B2B_NTC_4; PinSocket_1x10_P2.54mm_Vertical
J43: B2B_DUMMY; PinSocket_1x04_P2.54mm_Vertical

Connections:
/CT0: J4.4, J37.1, J40.1
/CT1: J4.3, J37.2, J40.2
/CT2: J4.2, J37.3, J40.3
/CT3: J4.1, J37.4, J40.4
/CT4: J3.4, J37.5, J40.5
/CT5: J3.3, J37.6, J40.6
/CT6: J3.2, J37.7, J40.7
/CT7: J3.1, J37.8, J40.8
/CT8: J2.4, J37.9, J40.9
/CT9: J2.3, J37.10, J40.10
/CT10: J2.2, J37.11, J40.11
/CT11: J2.1, J37.12, J40.12
/CT12: J1.4, J37.13, J40.13
/CT13: J1.3, J37.14, J40.14
/CT14: J1.2, J37.15, J40.15
/CT15: J1.1, J37.16, J40.16
Earth: J5.2, J6.2, J7.2, J8.2, J9.2, J10.2, J11.2, J12.2, J13.2, J14.2, J15.2, J16.2, J17.2, J18.2, J19.2, J20.2, J21.2, J22.2, J23.2, J24.2, J25.2, J26.2, J27.2, J28.2, J29.2, J30.2, J31.2, J32.2, J33.2, J34.2, J35.2, J36.2, J38.3, J38.8, J39.3, J39.8, J41.3, J41.8, J42.3, J42.8, J43.1, J43.2, J43.3, J43.4
T0: J5.1, J38.1
T1: J6.1, J38.2
T2: J7.1, J38.4
T3: J8.1, J38.5
T4: J9.1, J38.6
T5: J10.1, J38.7
T6: J11.1, J38.9
T7: J12.1, J38.10
T8: J13.1, J39.1
T9: J14.1, J39.2
T10: J15.1, J39.4
T11: J16.1, J39.5
T12: J17.1, J39.6
T13: J18.1, J39.7
T14: J19.1, J39.9
T15: J20.1, J39.10
T16: J21.1, J41.1
T17: J22.1, J41.2
T18: J23.1, J41.4
T19: J24.1, J41.5
T20: J25.1, J41.6
T21: J26.1, J41.7
T22: J27.1, J41.9
T23: J28.1, J41.10
T24: J29.1, J42.1
T25: J30.1, J42.2
T26: J31.1, J42.4
T27: J32.1, J42.5
T28: J33.1, J42.6
T29: J34.1, J42.7
T30: J35.1, J42.9
T31: J36.1, J42.10

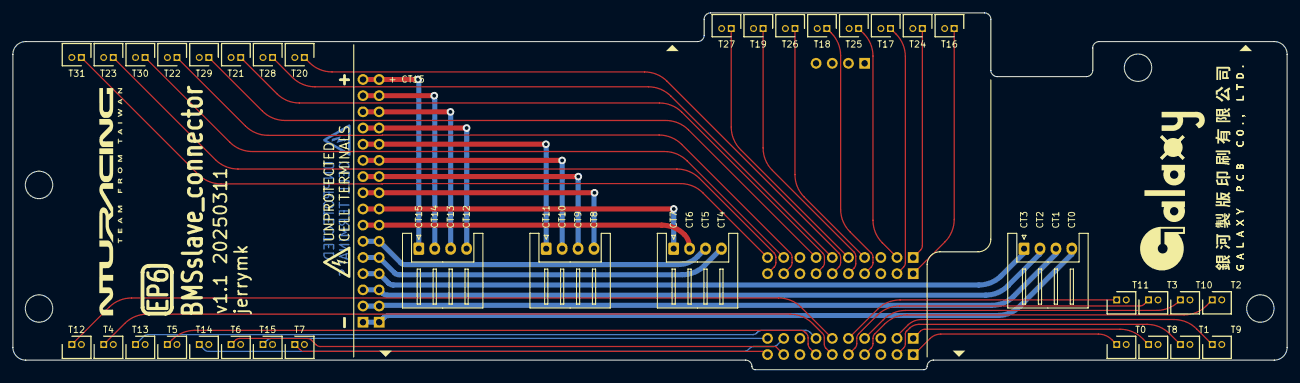
[picture p110: board ACC_BMSslave_connector.kicad_pcb from above]

Board: 4 copper layers, 200.0 x 56.0 mm, 47 parts (0 on the bottom side), 49 nets.
