NTURacingTeam/nturt_kicad/EP6/Electrical_Group/VCU_CONN1/VCU_CONN1.kicad_pcb

## KiCad design EP6/Electrical_Group/VCU_CONN1/VCU_CONN1.kicad_pcb (2025-03-10)

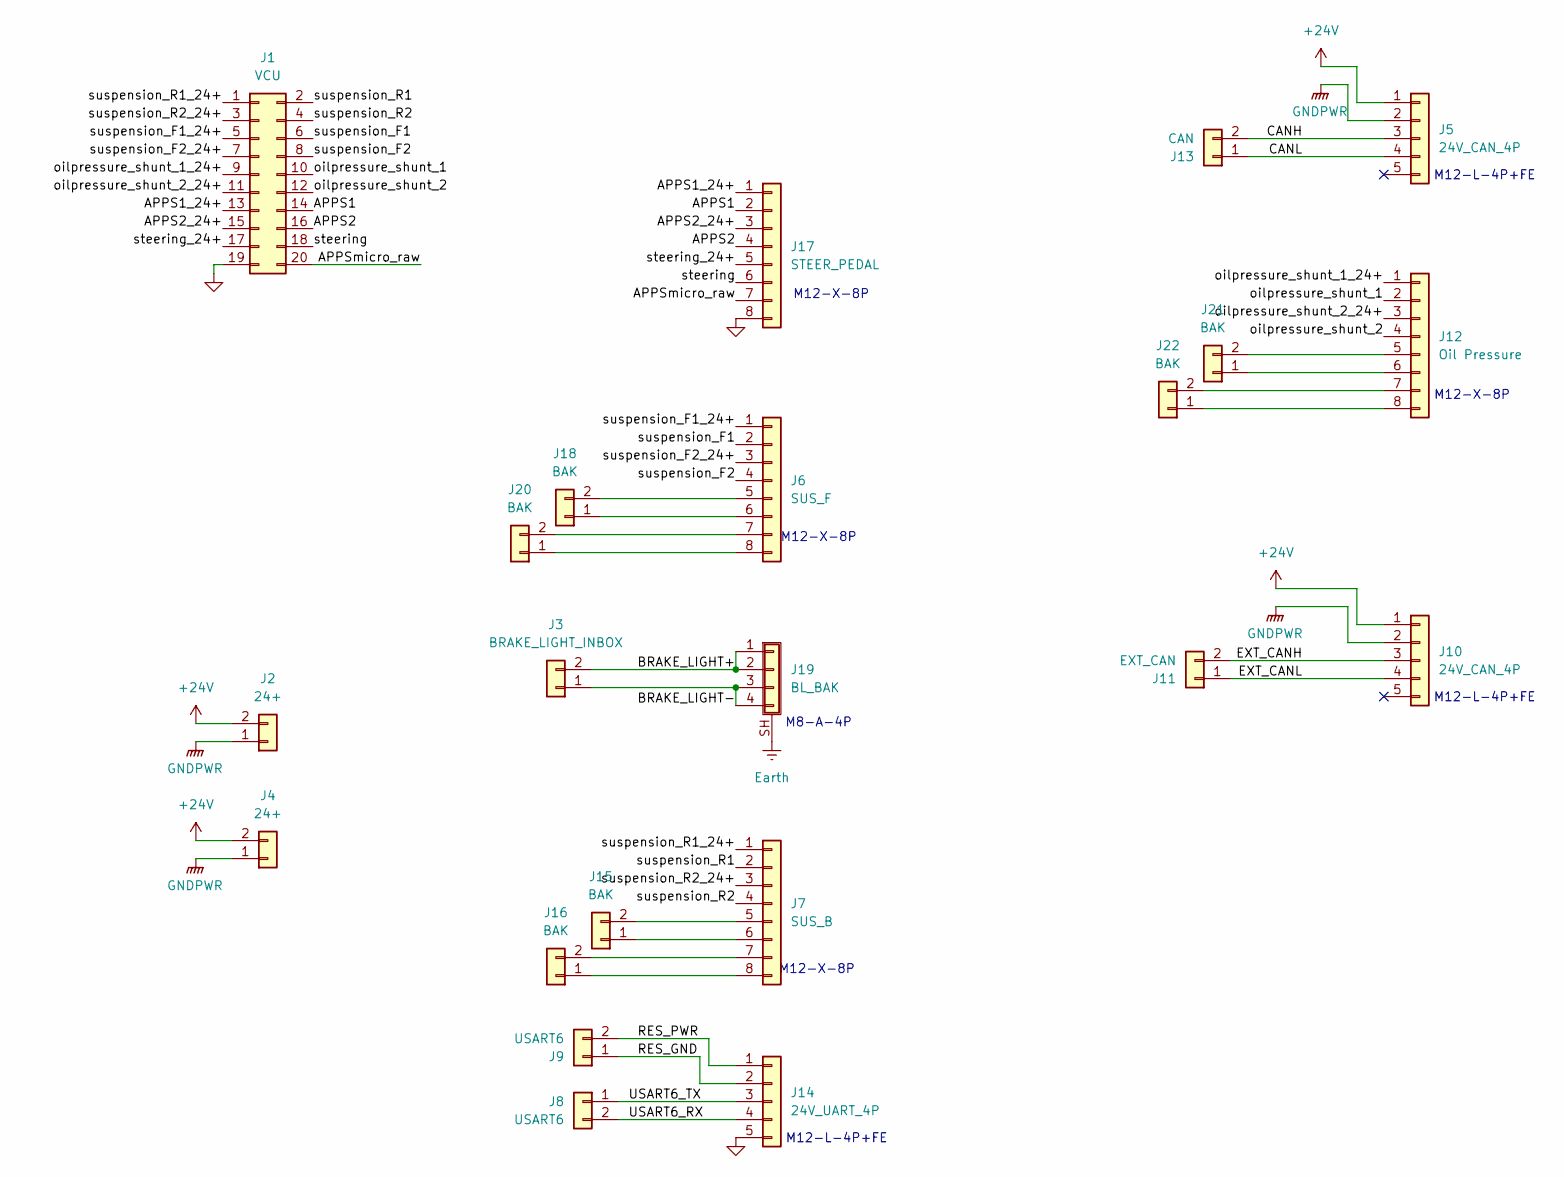
[picture p111: schematic VCU_CONN1.kicad_sch]

Parts:
J1: VCU; IDC-Header_2x10_P2.54mm_Vertical
J2, J4: 24+; JST_VH_B2P-VH_1x02_P3.96mm_Vertical
J3: BRAKE_LIGHT_INBOX; JST_XH_S2B-XH-A_1x02_P2.50mm_Horizontal
J5, J10: 24V_CAN_4P; NianYeong-M12-L-F5P
J6: SUS_F; NianYeong-M12-X-F4P
J7: SUS_B; NianYeong-M12-X-F4P
J8, J9: USART6; JST_XH_S2B-XH-A_1x02_P2.50mm_Horizontal
J11: EXT_CAN; JST_XH_S2B-XH-A_1x02_P2.50mm_Horizontal
J12: Oil Pressure; NianYeong-M12-X-F4P
J13: CAN; JST_XH_S2B-XH-A_1x02_P2.50mm_Horizontal
J14: 24V_UART_4P; NianYeong-M12-L-F5P
J15, J16, J18, J20, J21, J22: BAK; JST_XH_B2B-XH-A_1x02_P2.50mm_Vertical
J17: STEER_PEDAL; NianYeong-M12-X-F4P
J19: BL_BAK; WP-04F3-26-11

Connections:
+24V: J2.2, J4.2, J5.1, J10.1
/APPS1: J1.14, J17.2
/APPS1_24+: J1.13, J17.1
/APPS2: J1.16, J17.4
/APPS2_24+: J1.15, J17.3
/APPSmicro_raw: J1.20, J17.7
/BRAKE_LIGHT+: J3.2, J19.1, J19.2
/BRAKE_LIGHT-: J3.1, J19.3, J19.4
/CANH: J5.3, J13.2
/CANL: J5.4, J13.1
/EXT_CANH: J10.3, J11.2
/EXT_CANL: J10.4, J11.1
/RES_GND: J9.1, J14.2
/RES_PWR: J9.2, J14.1
/USART6_RX: J8.2, J14.4
/USART6_TX: J8.1, J14.3
/oilpressure_shunt_1: J1.10, J12.2
/oilpressure_shunt_1_24+: J1.9, J12.1
/oilpressure_shunt_2: J1.12, J12.4
/oilpressure_shunt_2_24+: J1.11, J12.3
/steering: J1.18, J17.6
/steering_24+: J1.17, J17.5
/suspension_F1: J1.6, J6.2
/suspension_F1_24+: J1.5, J6.1
/suspension_F2: J1.8, J6.4
/suspension_F2_24+: J1.7, J6.3
/suspension_R1: J1.2, J7.2
/suspension_R1_24+: J1.1, J7.1
/suspension_R2: J1.4, J7.4
/suspension_R2_24+: J1.3, J7.3
Earth: J19.SH (Shield)
GND: J1.19, J14.5, J17.8
GNDPWR: J2.1, J4.1, J5.2, J10.2
unnamed: J12.5, J21.2
unnamed: J12.6, J21.1
unnamed: J12.7, J22.2
unnamed: J12.8, J22.1
unnamed: J7.6, J15.1
unnamed: J7.5, J15.2
unnamed: J7.8, J16.1
unnamed: J7.7, J16.2
unnamed: J6.6, J18.1
unnamed: J6.5, J18.2
unnamed: J6.8, J20.1
unnamed: J6.7, J20.2

Notes on the sheet:
M12-X-8P
M12-L-4P+FE
M8-A-4P

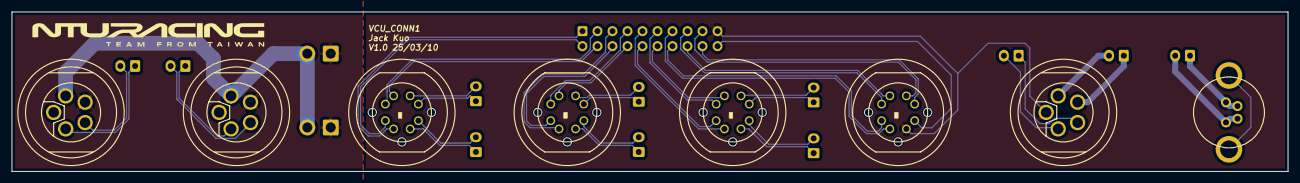
[picture p112: board VCU_CONN1.kicad_pcb from above]

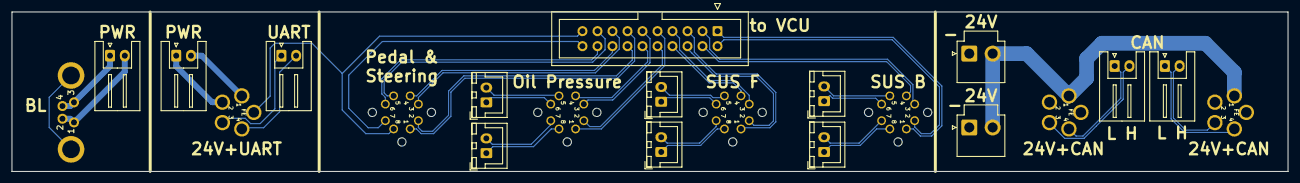
[picture p113: board VCU_CONN1.kicad_pcb from below]

Board: 2 copper layers, 216.0 x 27.0 mm, 22 parts (14 on the bottom side), 44 nets.
