NTURacingTeam/nturt_kicad/EP6/Powertrain_Group/DEV_BLDC/DEV_BLDC.kicad_pcb

## KiCad design EP6/Powertrain_Group/DEV_BLDC/DEV_BLDC.kicad_pcb (2024-12-06)

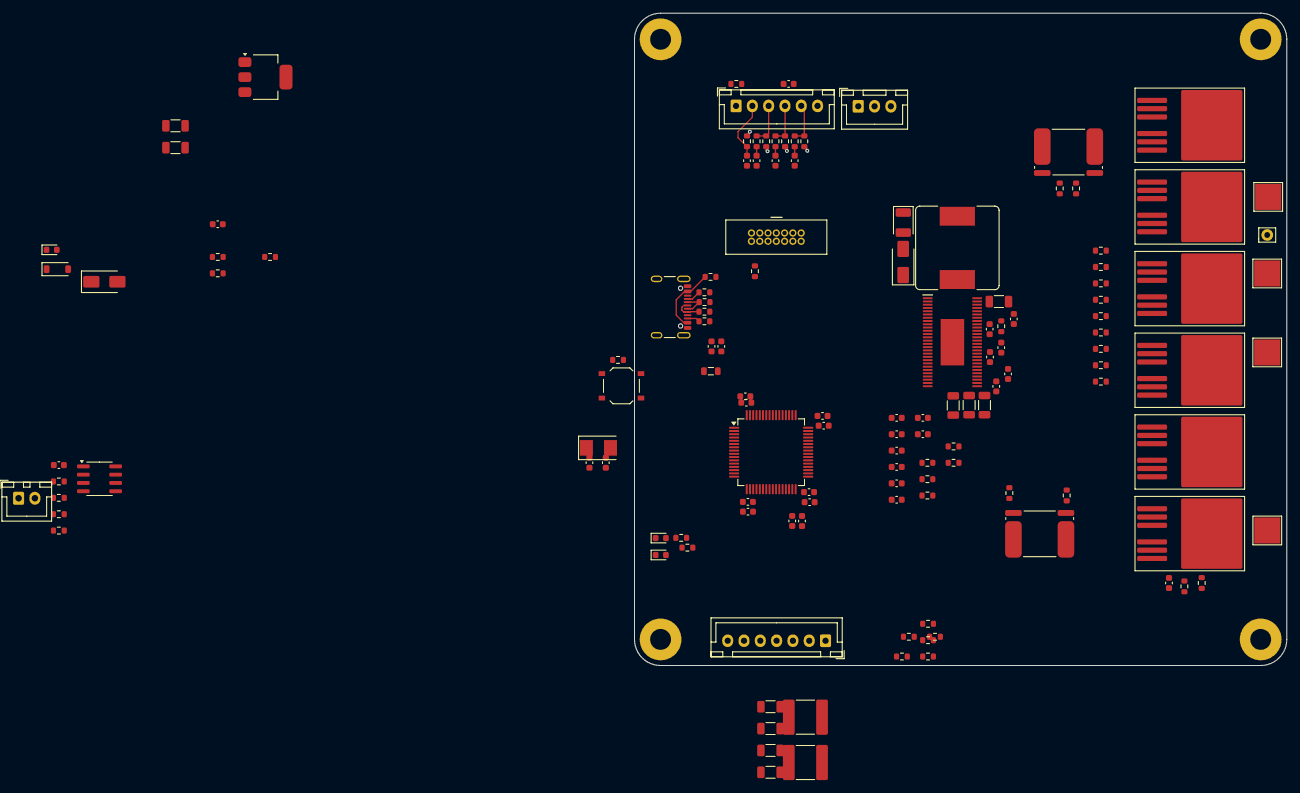
[picture p114: board DEV_BLDC.kicad_pcb from above]

Board: 4 copper layers, 100.0 x 100.0 mm, 137 parts (0 on the bottom side), 92 nets.

Parts:
C1, C2: 33p; C_0603_1608Metric
C3, C4, C5, C6, C13: 10u 6V; C_0603_1608Metric
C7, C8, C9, C10, C14, C16: 0u1; C_0603_1608Metric
C11, C12, C21, C25, C26, C27, C28, C34: 2u2; C_0603_1608Metric
C15, C22, C39: 100n; C_0603_1608Metric
C17, C18, C19, C20: 4n7; C_0603_1608Metric
C23: 120p; C_0603_1608Metric
C24: 22n; C_0603_1608Metric
C29, C30, C36, C37, C47, C48, C49, C50: 10u 50V; C_1206_3216Metric
C31, C32: 47u 10V; C_1206_3216Metric
C33: 6n8; C_0603_1608Metric
C35, C38: 15u100V; C_2220_5750Metric
C40, C42, C43: 220n; C_0603_1608Metric
C44, C45: 2n2; C_0603_1608Metric
C46: 100u; CP_EIA-3528-12_Kemet-T
D1, D3: RED LED; LED_0603_1608Metric
D2: EMERALD LED; LED_0603_1608Metric
D4: 5.6V 1SMA5919A; D_SMA
D5: 3.3V 123 (BZT52B3V3); D_SOD-123
D7: SS54; D_SMA
FB1: GZ2012D601TF; L_0805_2012Metric
H1, H2, H3, H4: MountingHole_Pad; MountingHole_3.2mm_M3_Pad
IC1: DRV8302DCA; SOP50P810X120-57N
J1: STDC14; box_header_14P_pitch127
J2: USB_C_stm32; USB_C_Receptacle_GCT_USB4105-xx-A_16P_TopMnt_Horizontal
J3: CAN; JST_XH_B2B-XH-A_1x02_P2.50mm_Vertical
J4: HALL/Encoder; JST_XH_B6B-XH-A_1x06_P2.50mm_Vertical
J5: PWR_COMM; JST_XH_B7B-XH-A_1x07_P2.50mm_Vertical
J6: SERVER; JST_XH_B3B-XH-A_1x03_P2.50mm_Vertical
L2: 22uH ?A (); L_Bourns_SRR1260
Q1, Q2, Q3, Q4, Q5, Q6: IRFS7530-7P; TO-263-6
R1, R39, R40, R41, R42: 100R; R_0603_1608Metric
R2, R18, R23, R27: 10k; R_0603_1608Metric
R4, R30, R35, R37, R43, R49, R52: 39k; R_0603_1608Metric
R5, R15, R16, R17, R19, R20, R21, R31, R36, R38: 2k2; R_0603_1608Metric
R6, R7: 5k1; R_0603_1608Metric
R8, R9, R26: 10R; R_0603_1608Metric
R10, R12, R13, R14: 0R; R_0603_1608Metric
R11: 120R; R_0603_1608Metric
R22: NTC10k; R_0603_1608Metric
R24, R25, R32: 1k; R_0603_1608Metric
R28: 18k; R_0603_1608Metric
R29: 220k; R_0603_1608Metric
R33: 15k; R_0603_1608Metric
R34: 3k3; R_0603_1608Metric
R44: 1M; R_0603_1608Metric
R45, R46, R47, R48, R50, R51: 4R7; R_0603_1608Metric
R53, R54: SHUNT; R_Shunt_Isabellenhuette_BVR4026
SW1: TS-1187A-B-A-B; SW_Push_1P1T_XKB_TS-1187A
TP1: power+; Pin_D0.9mm_L10.0mm_W2.4mm_FlatFork
TP2: power-; TestPoint_Pad_4.0x4.0mm
TP3: P1; TestPoint_Pad_4.0x4.0mm
TP4: P2; TestPoint_Pad_4.0x4.0mm
TP5: P3; TestPoint_Pad_4.0x4.0mm
U1: STM32F405RGT6; LQFP-64_10x10mm_P0.5mm
U2: TJA1051T-3; SOIC-8_3.9x4.9mm_P1.27mm
U3: AMS1117-3.3; SOT-223-3_TabPin2
Y1: 8MHz X50328MSB2GI; Crystal_SMD_5032-2Pin_5.0x3.2mm

Connections:
+3V3: C3.1, C4.1, C5.1, C6.1, C7.1, C8.1, C9.1, C10.1, C16.1, C32.1, D5.1 (K), FB1.1, IC1.9 (M_OC), IC1.24 (REF), J1.3, J5.6, R15.1, R16.1, R17.1, R18.1, R22.1, R32.1, U1.1 (VBAT), U1.19 (VDD), U1.32 (VDD), U1.48 (VDD), U1.64 (VDD), U2.5 (VIO), U3.2 (VO)
+5V: C31.1, C46.1, D4.1 (K), J4.6, J5.7, J6.2, L2.2, R10.1, R28.1, U2.3 (VCC), U3.3 (VI)
/CAN/CANH: J3.2, R11.1, U2.7 (CANH)
/CAN/CANL: J3.1, R11.2, U2.6 (CANL)
/CAN/CAN_RX: R14.2, U1.61 (PB8)
/CAN/CAN_TX: R13.2, U1.62 (PB9)
/Filters/HALL1_IN: J4.5, R17.2, R21.1
/Filters/HALL1_OUT: C20.1, R21.2, U1.52 (PC11)
/Filters/HALL2_IN: J4.4, R16.2, R20.1
/Filters/HALL2_OUT: C19.1, R20.2, U1.59 (PB7)
/Filters/HALL3_IN: J4.3, R15.2, R19.1
/Filters/HALL3_OUT: C18.1, R19.2, U1.58 (PB6)
/Filters/TEMP_IN: C17.1, J4.2, R18.2, U1.8 (PC0)
/MCU/3V3_REF: C13.1, C14.1, FB1.2, U1.13 (VDDA)
/MCU/ADC_TEMP: C21.1, R22.2, R23.1, U1.17 (PA3)
/MCU/AN_IN: C15.1, R4.2, R5.1, U1.10 (PC2)
/MCU/BR_SO1: IC1.25 (SO1), U1.27 (PB1)
/MCU/BR_SO2: IC1.26 (SO2), U1.26 (PB0)
/MCU/DC_CAL: IC1.12 (DC_CAL), U1.33 (PB12)
/MCU/EN_GATE: IC1.16 (EN_GATE), U1.51 (PC10)
/MCU/FAULT: IC1.6 (NFAULT), U1.53 (PC12)
/MCU/H1: IC1.17 (INH_A), U1.43 (PA10)
/MCU/H2: IC1.19 (INH_B), U1.42 (PA9)
/MCU/H3: IC1.21 (INH_C), U1.41 (PA8)
/MCU/L1: IC1.18 (INL_A), U1.36 (PB15)
/MCU/L2: IC1.20 (INL_B), U1.35 (PB14)
/MCU/L3: IC1.22 (INL_C), U1.34 (PB13)
/MCU/LED_GREEN: R25.1, U1.24 (PC4)
/MCU/LED_RED: R24.1, U1.25 (PC5)
/MCU/MISO_ADC_EXT2: J5.2, U1.22 (PA6)
/MCU/NRST: J1.12, R1.2, U1.7 (NRST)
/MCU/OSC_IN: C1.1, U1.5 (PH0), Y1.1
/MCU/OSC_OUT: C2.1, U1.6 (PH1), Y1.2
/MCU/RESET: R1.1, SW1.2
/MCU/RX_SCL_MOSI: J5.3, U1.23 (PA7), U1.29 (PB10), U1.38 (PC7)
/MCU/SCK_ADC_EXT: J5.5, U1.21 (PA5)
/MCU/SENS1: R30.2, R31.1, U1.16 (PA2)
/MCU/SENS2: R35.2, R36.1, U1.15 (PA1)
/MCU/SENS3: R37.2, R38.1, U1.14 (PA0)
/MCU/SERVO: C22.1, R26.2, U1.57 (PB5)
/MCU/SWCLK: J1.6, U1.49 (PA14)
/MCU/SWDIO: J1.4, U1.46 (PA13)
/MCU/TX_SDA_NSS: J5.4, U1.20 (PA4), U1.30 (PB11), U1.37 (PC6)
/MCU/USB_DM: R8.1, U1.44 (PA11)
/MCU/USB_DP: R9.1, U1.45 (PA12)
/MOSFETdriver/H1_LOW: IC1.44 (SL_A), Q2.2 (S), Q2.3 (S), Q2.5 (S), Q2.6 (S), Q2.7 (S), R43.2, R54.1
/MOSFETdriver/H1_VS: C40.2, IC1.46 (SH_A), Q1.2 (S), Q1.3 (S), Q1.5 (S), Q1.6 (S), Q1.7 (S), Q2.4 (D), R37.1, TP3.1
/MOSFETdriver/H2_VS: C42.2, IC1.41 (SH_B), Q3.2 (S), Q4.4 (D), R35.1, TP4.1
/MOSFETdriver/H3_LOW: IC1.34 (SL_C), Q6.2 (S), Q6.3 (S), Q6.5 (S), Q6.6 (S), Q6.7 (S), R52.2, R53.1
/MOSFETdriver/H3_VS: C43.2, IC1.36 (SH_C), Q5.2 (S), Q6.4 (D), R30.1, TP5.1
/MOSFETdriver/M_H1: IC1.47 (GH_A), R45.1
/MOSFETdriver/M_H2: IC1.42 (GH_B), R47.1
/MOSFETdriver/M_H3: IC1.37 (GH_C), R50.1
/MOSFETdriver/M_L1: IC1.45 (GL_A), R46.1
/MOSFETdriver/M_L2: IC1.40 (GL_B), R48.1
/MOSFETdriver/M_L3: IC1.35 (GL_C), R51.1
/MOSFETdriver/SH1_A: R39.2, R53.2
/MOSFETdriver/SH1_B: R40.2, R53.3
/MOSFETdriver/SH2_A: R41.2, R54.2
/MOSFETdriver/SH2_B: R42.2, R54.3
/USB_D+: J2.A6 (D+), J2.B6 (D+), R9.2
/USB_D-: J2.A7 (D-), J2.B7 (D-), R8.2
GND: C1.2, C2.2, C3.2, C4.2, C5.2, C6.2, C7.2, C8.2, C9.2, C10.2, C11.2, C12.2, C13.2, C14.2, C15.2, C16.2, C17.2, C18.2, C19.2, C20.2, C21.2, C22.2, C23.2, C25.1, C26.1, C27.1, C28.1, C29.2, C30.2, C31.2, C32.2, C34.1, C35.2, C36.2, C37.2, C38.2, C46.2, C47.2, C48.2, C49.2, C50.2, D1.1 (K), D2.1 (K), D3.1 (K), D4.2 (A), D5.2 (A), D7.2 (A), IC1.8 (M_PWM), IC1.10 (GAIN), IC1.28 (AGND), IC1.39 (SL_B), IC1.57 (GND), J1.5, J1.7, J2.A1 (GND), J2.A12 (GND), J2.B1 (GND), J2.B12 (GND), J4.1, J5.1, J6.3, Q4.2 (S), Q4.3 (S), Q4.5 (S), Q4.6 (S), Q4.7 (S), R2.2, R5.2, R6.1, R7.1, R12.2, R23.2, R27.1, R29.2, R31.2, R33.2, R34.2, R36.2, R38.2, R44.2, R49.2, R53.4, R54.4, SW1.1, TP2.1, U1.12 (VSSA), U1.18 (VSS), U1.63 (VSS), U2.2 (GND), U3.1 (GND)
unnamed: C25.2, C26.2, IC1.13 (GVDD)
unnamed: C27.2, C34.2, IC1.11 (OC_ADJ), IC1.23 (DVDD)
unnamed: C39.2, D7.1 (K), IC1.50 (PH_1), IC1.51 (PH_2), L2.1
unnamed: C44.1, IC1.33 (SN1), R39.1
unnamed: C44.2, IC1.32 (SP1), R40.1
unnamed: C45.1, IC1.31 (SN2), R41.1
unnamed: C45.2, IC1.30 (SP2), R42.1
unnamed: D1.2 (A), R24.2
unnamed: D2.2 (A), R25.2
unnamed: D3.2 (A), R32.2
unnamed: J2.A5 (CC1), R6.2
unnamed: J2.B5 (CC2), R7.2
unnamed: J2.A4 (VBUS), J2.A9 (VBUS), J2.B4 (VBUS), J2.B9 (VBUS), R10.2
unnamed: J6.1, R26.1
unnamed: Q1.1 (G), R45.2
unnamed: Q2.1 (G), R43.1, R46.2
unnamed: Q3.1 (G), R47.2
unnamed: Q4.1 (G), R48.2, R49.1
unnamed: Q5.1 (G), R50.2
unnamed: Q6.1 (G), R51.2, R52.1
unnamed: IC1.3 (VSENSE), R28.2, R34.1
unnamed: R2.1, U1.60 (BOOT0)
unnamed: C11.1, U1.31 (VCAP_1)
unnamed: C12.1, U1.47 (VCAP_2)
unnamed: R14.1, U2.4 (RXD)
unnamed: R12.1, U2.8 (S)
unnamed: R13.1, U2.1 (TXD)
V_SUPPLY: C47.1, C48.1, C49.1, C50.1, IC1.29 (PVDD1), IC1.53 (PVDD2_1), IC1.54 (PVDD2_2)
Vsupply: C29.1, C30.1, C35.1, C36.1, C37.1, C38.1, Q1.4 (D), Q3.4 (D), Q5.4 (D), R4.1, TP1.1
