NTURacingTeam/nturt_kicad/EP6/Electrical_Group/DEVboard1/DEVboard1.kicad_pcb

## KiCad design EP6/Electrical_Group/DEVboard1/DEVboard1.kicad_pcb (2024-12-05)

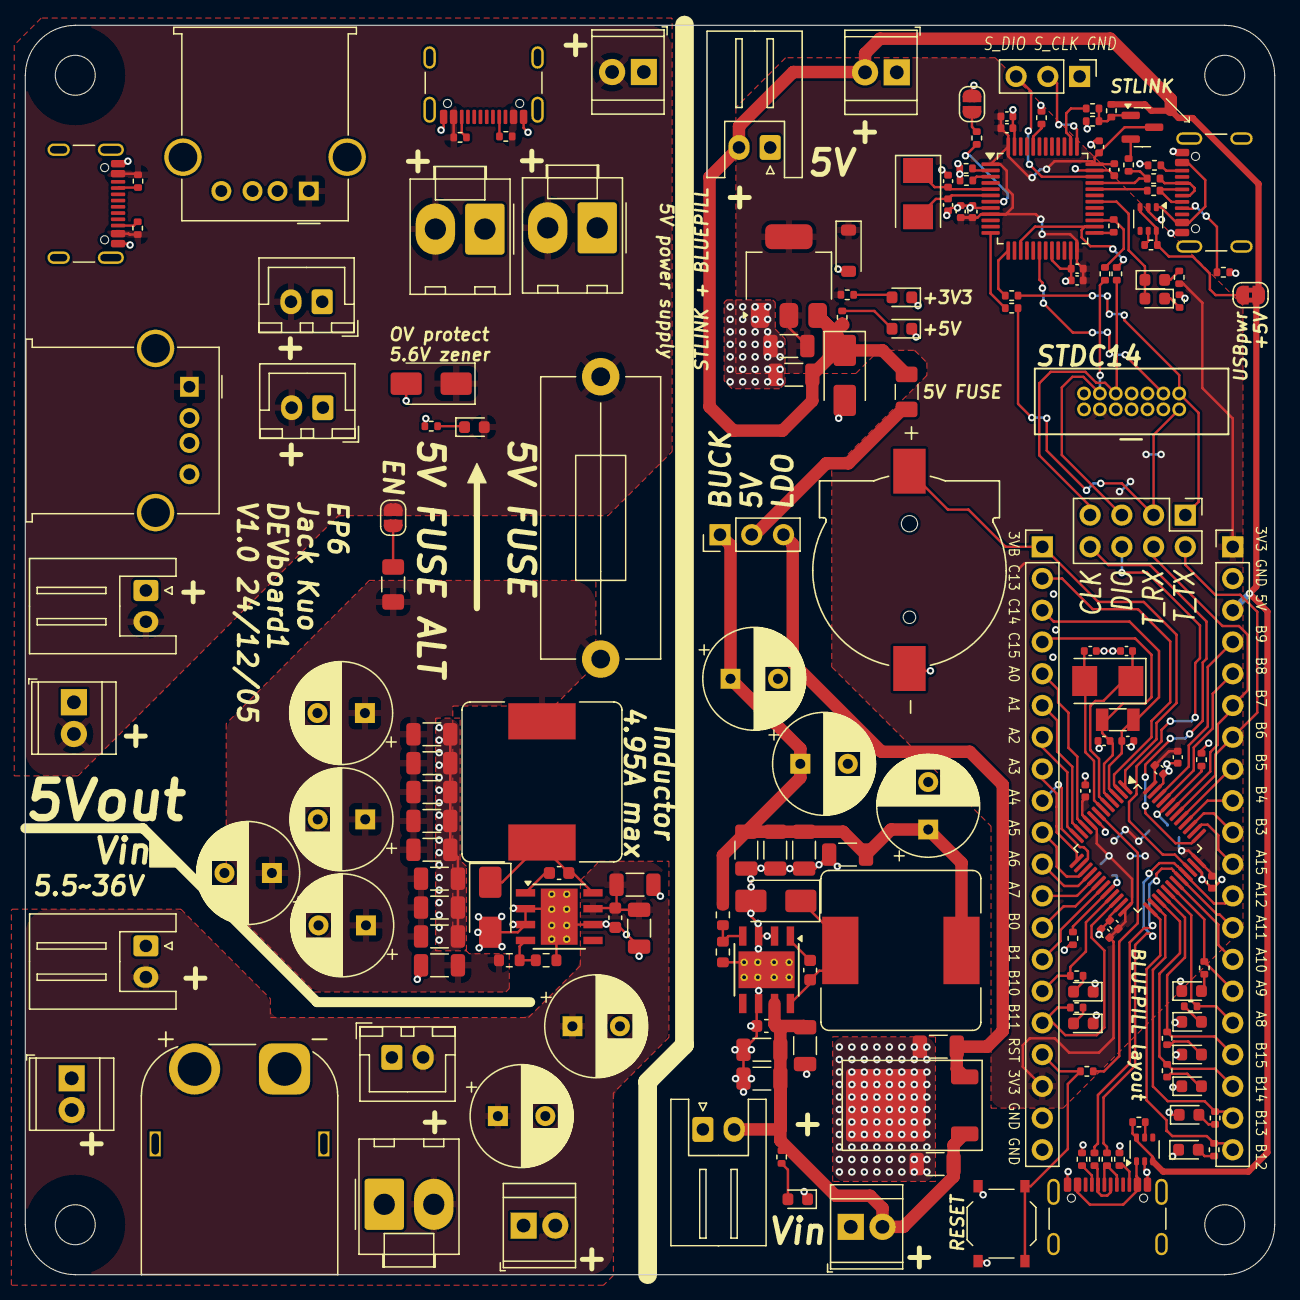
[picture p115: board DEVboard1.kicad_pcb from above]

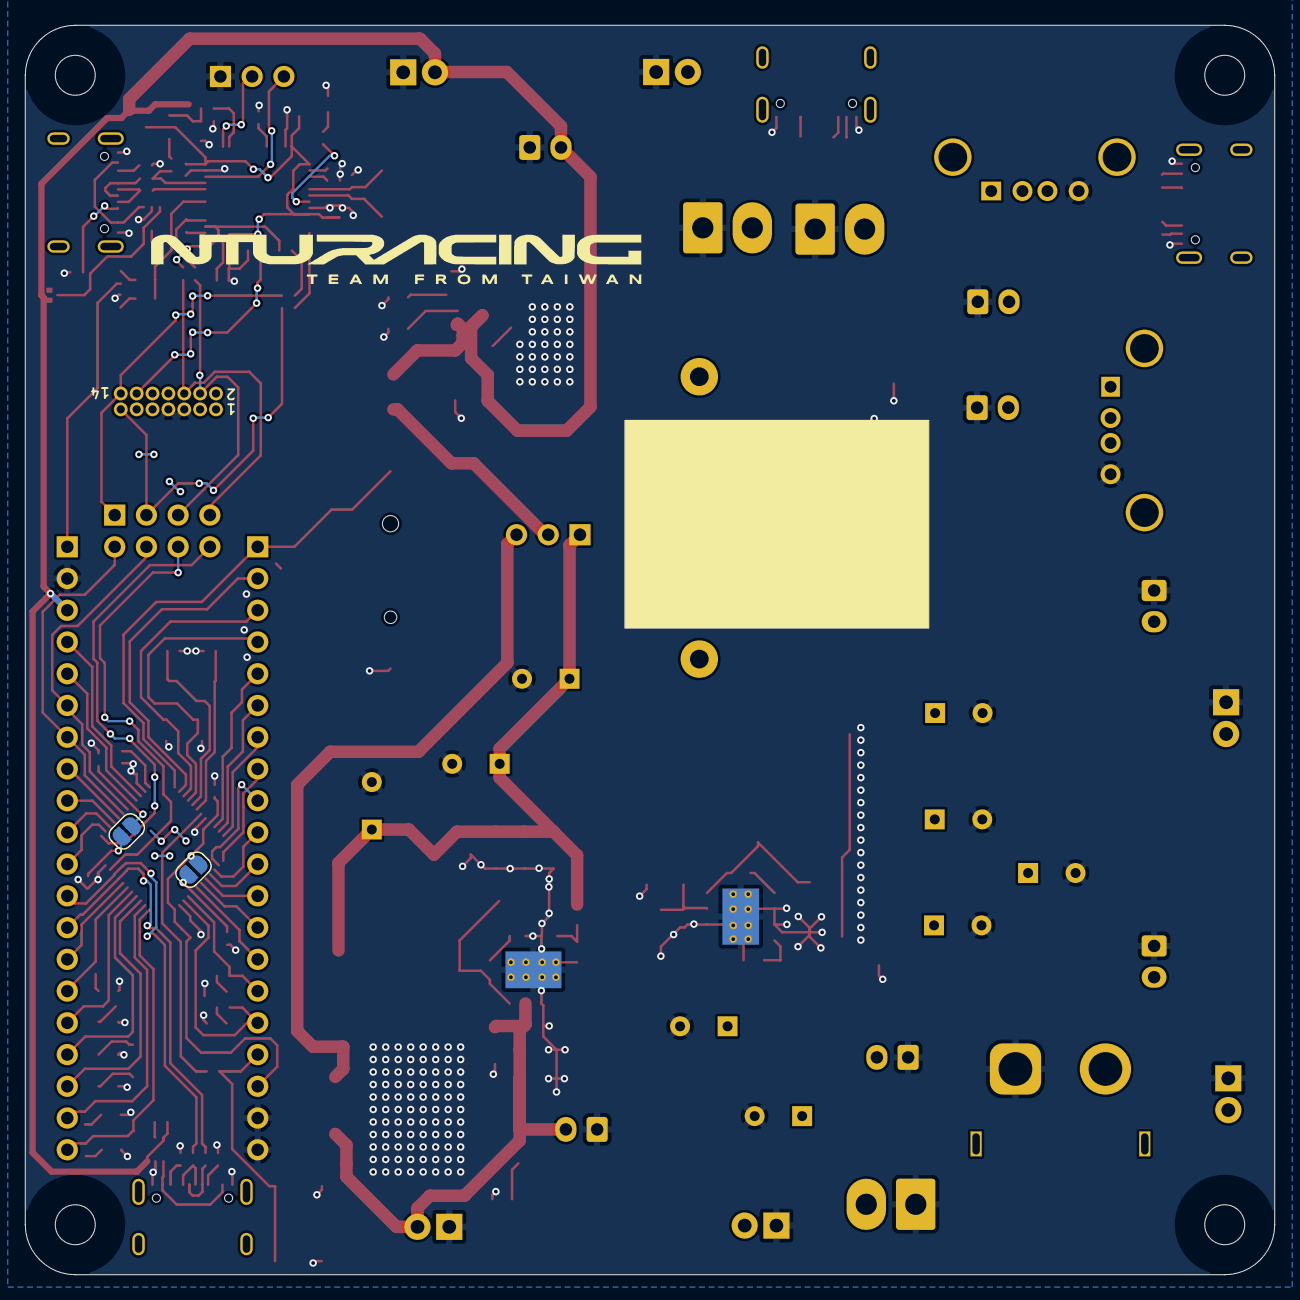
[picture p116: board DEVboard1.kicad_pcb from below]

Board: 2 copper layers, 100.0 x 100.0 mm, 179 parts (2 on the bottom side), 114 nets.

Parts:
BT1: 1056; BAT_1056
C1, C2, C3, C4, C13, C14: 10u 6V; C_0402_1005Metric
C5, C6, C7, C8, C15, C16, C17, C18: 0u1; C_0402_1005Metric
C9, C10: 33p; C_0402_1005Metric
C11, C12: 15p; C_0402_1005Metric
C19, C20: 30p; C_0402_1005Metric
C21, C22: 47u 10V; C_1206_3216Metric
C23, C33: 10n; C_0603_1608Metric
C24, C25, C31, C32, C34, C35, C45: 10u 35V; C_1206_3216Metric
C26, C37: 0u1; C_0603_1608Metric
C27, C28, C29, C30, C38, C39, C40, C41, C42, C46, C47, C48, C49: 22u 25V; C_1206_3216Metric
C36, C43, C44, C50, C51, C52, C53, C54, C55: 330u 25V; CP_Radial_D8.0mm_P3.80mm
D1: YELLOW led; LED_0603_1608Metric
D2: 3.3V 123 (BZT52B3V3); D_SOD-123
D3, D17, D19, D20: RED LED; LED_0603_1608Metric
D4: RED led; LED_0603_1608Metric
D5, D18: 5.6V 1SMA5919A; D_SMA
D6, D7, D9, D10, D11, D12, D13, D14: WHITE LED; LED_0603_1608Metric
D8, D15: SS54; D_SMA
F1: 0.5A; Fuse_1206_3216Metric
F2: 5Vbuck_fuse; Fuseholder_Cylinder-5x20mm_Stelvio-Kontek_PTF78_Horizontal_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
F3: 5Vbuck_PPTC; Fuse_1206_3216Metric
H1, H2, H3, H4: MountingHole; MountingHole_3.2mm_M3
J1, J4: USB_C_stm32; USB_C_Receptacle_GCT_USB4105-xx-A_16P_TopMnt_Horizontal
J2, J3: Conn_01x20; PinHeader_1x20_P2.54mm_Vertical
J5: STDC14; box_header_14P_pitch127
J6: DEBUG; PinHeader_2x04_P2.54mm_Vertical
J7: S_SWD; PinHeader_1x03_P2.54mm_Vertical
J8: 5V_source; PinHeader_1x03_P2.54mm_Vertical
J9, J11, J29: +5V; JST_XH_S2B-XH-A_1x02_P2.50mm_Horizontal
J10: +5V; TerminalBlock_TE_282834-2_1x02_P2.54mm_Horizontal
J12, J27: Vin; TerminalBlock_TE_282834-2_1x02_P2.54mm_Horizontal
J13: Vin; Molex_KK-396_A-41791-0002_1x02_P3.96mm_Vertical
J14: Vin; JST_XH_B2B-XH-A_1x02_P2.50mm_Vertical
J15: Vin; AMASS_XT60PW-M_1x02_P7.20mm_Horizontal
J16, J25, J26: +24V; TerminalBlock_TE_282834-2_1x02_P2.54mm_Horizontal
J17, J18: +5V; Molex_KK-396_A-41791-0002_1x02_P3.96mm_Vertical
J19, J22: USBC_RPI_5Vonly; USB_C_Receptacle_GCT_USB4105-xx-A_16P_TopMnt_Horizontal
J20, J23: USBA_RPI_5Vonly; USB_A_Molex_67643_Horizontal
J21, J24: +5V; JST_XH_B2B-XH-A_1x02_P2.50mm_Vertical
J30: Vin; JST_XH_S2B-XH-A_1x02_P2.50mm_Horizontal
JP1: BOOT0; SolderJumper-2_P1.3mm_Open_RoundedPad1.0x1.5mm
JP2: BOOT1; SolderJumper-2_P1.3mm_Open_RoundedPad1.0x1.5mm
JP3: S_RESET; SolderJumper-2_P1.3mm_Open_RoundedPad1.0x1.5mm
JP4: VBUS_5V; SolderJumper-2_P1.3mm_Bridged2Bar_RoundedPad1.0x1.5mm
JP5: PPTC_EN; SolderJumper-2_P1.3mm_Open_RoundedPad1.0x1.5mm
L1, L2: 22uH 3.7A (SMDRI129-220MT); L_Bourns_SRR1260
Q1: MMBT3904; SOT-23
R1, R4, R7, R8, R19, R21, R27, R28: 100R; R_0402_1005Metric
R2, R5, R10: 100k; R_0402_1005Metric
R3, R6, R11, R13, R18, R20, R26: 10k; R_0402_1005Metric
R9, R15: 220R; R_0402_1005Metric
R12, R14: 10R; R_0402_1005Metric
R16, R17, R23, R24: 5k1; R_0402_1005Metric
R22: 33k; R_0402_1005Metric
R25: 1k5; R_0402_1005Metric
R31, R32, R33, R35, R36, R37, R38, R39, R40, R43, R46, R48: 1k; R_0402_1005Metric
R34, R41: 47k 1%; R_0603_1608Metric
R42, R44: 15k 1%; R_0603_1608Metric
R45, R47, R49, R50: 56k; R_0402_1005Metric
SW1: TS-1187A-B-A-B; SW_Push_1P1T_XKB_TS-1187A
U1, U2: STM32F103CBT6; LQFP-48_7x7mm_P0.5mm
U3, U5: LM66100DCK; SOT-363_SC-70-6
U4: AMS1117-3.3; SOT-223-3_TabPin2
U6: L78M05ABDT; TO-252-2
U7, U8: TPS5430DDAR; TI_SO-PowerPAD-8_ThermalVias
Y1, Y3: 8MHz X50328MSB2GI; Crystal_SMD_5032-2Pin_5.0x3.2mm
Y2: 32.768kHz Q13FC13500004; Crystal_SMD_3215-2Pin_3.2x1.5mm

Connections:
+3V3: C1.1, C2.1, C3.1, C4.1, C5.1, C6.1, C7.1, C8.1, C13.1, C14.1, C15.1, C16.1, C17.1, C18.1, C22.1, D2.1 (K), J2.18, J3.1, J5.3, JP1.2 (B), JP2.2 (B), Q1.3 (C), R9.1, R46.1, U1.9 (VDDA), U1.24 (VDD), U1.36 (VDD), U1.48 (VDD), U2.1 (VBAT), U2.9 (VDDA), U2.24 (VDD), U2.36 (VDD), U2.48 (VDD), U4.2 (VO)
+5V: C21.1, D5.1 (K), F1.2, J3.3, J11.2, J26.2, JP4.2 (B), R20.1, R26.1, R48.1, U4.3 (VI), U5.3 (~CE), U5.6 (VOUT)
/5V_buck_FB: R34.2, R42.1, U7.4 (VSENSE)
/5V_buck_sw: C23.2, D8.1 (K), L1.1, U7.8 (PH)
/+5V_LDO: C32.2, J8.3, U6.3 (OUT)
/+5V_buck: C27.1, C28.1, C29.1, C30.1, C36.1, C54.1, C55.1, J8.1, L1.2, R34.1
/MCU/3VB: BT1.P, J2.1, U1.1 (VBAT)
/MCU/BOOT0: JP1.1 (A), R5.1, U1.44 (BOOT0)
/MCU/BOOT1: JP2.1 (A), R2.1, U1.20 (PB2)
/MCU/NRST: R3.2, U1.7 (NRST)
/MCU/OSC32_IN: C11.1, J2.3, U1.3 (PC14), Y2.1
/MCU/OSC32_OUT: C12.1, J2.4, U1.4 (PC15), Y2.2
/MCU/OSC_IN: C9.1, U1.5 (PD0), Y1.1
/MCU/OSC_OUT: C10.1, U1.6 (PD1), Y1.2
/MCU/PA0: J2.5, U1.10 (PA0)
/MCU/PA1: J2.6, U1.11 (PA1)
/MCU/PA2: J2.7, U1.12 (PA2)
/MCU/PA3: J2.8, U1.13 (PA3)
/MCU/PA4: J2.9, U1.14 (PA4)
/MCU/PA5: J2.10, U1.15 (PA5)
/MCU/PA6: J2.11, U1.16 (PA6)
/MCU/PA7: J2.12, U1.17 (PA7)
/MCU/PA8: J3.16, R36.1, U1.29 (PA8)
/MCU/PA9: J3.15, R35.1, U1.30 (PA9)
/MCU/PA10: J3.14, U1.31 (PA10)
/MCU/PA13: J6.6, U1.34 (PA13)
/MCU/PA14: J6.8, U1.37 (PA14)
/MCU/PA15: J3.11, U1.38 (PA15)
/MCU/PB0: J2.13, U1.18 (PB0)
/MCU/PB1: J2.14, U1.19 (PB1)
/MCU/PB3: J3.10, U1.39 (PB3)
/MCU/PB4: J3.9, U1.40 (PB4)
/MCU/PB5: J3.8, U1.41 (PB5)
/MCU/PB6: J3.7, J6.2, U1.42 (PB6)
/MCU/PB7: J3.6, J6.4, U1.43 (PB7)
/MCU/PB8: J3.5, U1.45 (PB8)
/MCU/PB9: J3.4, U1.46 (PB9)
/MCU/PB10: J2.15, R32.1, U1.21 (PB10)
/MCU/PB11: J2.16, R33.1, U1.22 (PB11)
/MCU/PB12: J3.20, R40.1, U1.25 (PB12)
/MCU/PB13: J3.19, R39.1, U1.26 (PB13)
/MCU/PB14: J3.18, R38.1, U1.27 (PB14)
/MCU/PB15: J3.17, R37.1, U1.28 (PB15)
/MCU/PC13: J2.2, U1.2 (PC13)
/MCU/RESET: J2.17, R3.1, SW1.2
/MCU/USB_D+: J1.A6 (D+), J1.B6 (D+), R14.2
/MCU/USB_D-: J1.A7 (D-), J1.B7 (D-), R12.2
/MCU/USB_DN: J3.13, R12.1, U1.32 (PA11)
/MCU/USB_DP: J3.12, R14.1, U1.33 (PA12)
/MCU/VBUS: J1.A4 (VBUS), J1.A9 (VBUS), J1.B4 (VBUS), J1.B9 (VBUS), U5.1 (VIN)
/STlink/BOOT0: R10.1, U2.44 (BOOT0)
/STlink/LED_STLINK: D1.1 (K), D4.2 (A), U2.30 (PA9)
/STlink/OSC_IN: C19.1, U2.5 (PD0), Y3.1
/STlink/OSC_OUT: C20.1, U2.6 (PD1), Y3.2
/STlink/RENUM: R21.1, U2.38 (PA15)
/STlink/S_CLK: J7.2, U2.37 (PA14)
/STlink/S_DIO: J7.3, U2.34 (PA13)
/STlink/S_NRST: R6.2, U2.7 (NRST)
/STlink/USART2_RX: R4.1, U2.13 (PA3)
/STlink/USART2_TX: R1.1, U2.12 (PA2)
/STlink/USB_D+: J4.A6 (D+), J4.B6 (D+), R28.1
/STlink/USB_D-: J4.A7 (D-), J4.B7 (D-), R27.1
/STlink/USB_DN: R27.2, U2.32 (PA11)
/STlink/USB_DP: R25.2, R28.2, U2.33 (PA12)
/STlink/VBUS: J4.A4 (VBUS), J4.A9 (VBUS), J4.B4 (VBUS), J4.B9 (VBUS), U3.1 (VIN)
/STlink/t_CLK: R7.1, U2.15 (PA5), U2.26 (PB13)
/STlink/t_DIO: R8.1, R19.1, U2.27 (PB14)
/T_NRST: J5.12, U2.18 (PB0)
/T_SWCLK: J5.6, J6.7, R7.2
/T_SWDIO: J5.4, J6.5, R8.2
/T_VCP_RX: J5.13, J6.3, R1.2
/T_VCP_TX: J5.14, J6.1, R4.2
/extPWR/5V_buck_FB: R41.2, R44.1, U8.4 (VSENSE)
/extPWR/5V_buck_sw: C33.2, D15.1 (K), L2.1, U8.8 (PH)
/extPWR/+5V_buck: D17.2 (A), D18.1 (K), F2.2, J10.2, J17.2, J18.2, J19.A4 (VBUS), J19.A9 (VBUS), J19.B4 (VBUS), J19.B9 (VBUS), J20.1 (VBUS), J21.2, J22.A4 (VBUS), J22.A9 (VBUS), J22.B4 (VBUS), J22.B9 (VBUS), J23.1 (VBUS), J24.2, J25.2, J29.2, JP5.2 (B), R45.1, R47.1, R49.1, R50.1
/extPWR/+5V_buck_raw: C38.1, C39.1, C40.1, C41.1, C42.1, C43.1, C44.1, C46.1, C47.1, C48.1, C49.1, C50.1, C51.1, F2.1, F3.1, L2.2, R41.1
/extPWR/Vin: C34.1, C35.1, C37.2, C52.1, C53.1, J12.2, J13.2, J14.2, J15.2, J27.2, J30.2, U8.7 (VIN)
GND: BT1.N, C1.2, C2.2, C3.2, C4.2, C5.2, C6.2, C7.2, C8.2, C9.2, C10.2, C11.2, C12.2, C13.2, C14.2, C15.2, C16.2, C17.2, C18.2, C19.2, C20.2, C21.2, C22.2, C24.2, C25.2, C26.1, C27.2, C28.2, C29.2, C30.2, C31.2, C32.1, C34.2, C35.2, C36.2, C37.1, C38.2, C39.2, C40.2, C41.2, C42.2, C43.2, C44.2, C45.2, C46.2, C47.2, C48.2, C49.2, C50.2, C51.2, C52.2, C53.2, C54.2, C55.2, D2.2 (A), D3.1 (K), D5.2 (A), D6.1 (K), D7.1 (K), D8.2 (A), D9.1 (K), D10.1 (K), D11.1 (K), D12.1 (K), D13.1 (K), D14.1 (K), D15.2 (A), D18.2 (A), D19.1 (K), D20.1 (K), J1.A1 (GND), J1.A12 (GND), J1.B1 (GND), J1.B12 (GND), J2.19, J2.20, J3.2, J4.A1 (GND), J4.A12 (GND), J4.B1 (GND), J4.B12 (GND), J5.5, J5.7, J7.1, J9.1, J10.1, J11.1, J12.1, J13.1, J14.1, J15.1, J16.1, J17.1, J18.1, J19.A1 (GND), J19.A12 (GND), J19.B1 (GND), J19.B12 (GND), J20.4 (GND), J21.1, J22.A1 (GND), J22.A12 (GND), J22.B1 (GND), J22.B12 (GND), J23.4 (GND), J24.1, J25.1, J26.1, J27.1, J29.1, J30.1, JP3.1 (A), R2.2, R5.2, R10.2, R11.2, R13.2, R15.2, R16.1, R17.1, R22.2, R23.1, R24.1, R42.2, R43.2, R44.2, SW1.1, U1.8 (VSSA), U1.23 (VSS), U1.35 (VSS), U1.47 (VSS), U2.8 (VSSA), U2.20 (PB2), U2.23 (VSS), U2.35 (VSS), U2.47 (VSS), U3.2 (GND), U4.1 (GND), U5.2 (GND), U6.2, U7.2 (NC), U7.3 (NC), U7.6 (GND), U7.9 (GNDPAD), U8.2 (NC), U8.3 (NC), U8.6 (GND), U8.9 (GNDPAD)
unnamed: D1.2 (A), R9.2
unnamed: D3.2 (A), R31.2
unnamed: D4.1 (K), R15.1
unnamed: D6.2 (A), R32.2
unnamed: D7.2 (A), R33.2
unnamed: D9.2 (A), R35.2
unnamed: D10.2 (A), R36.2
unnamed: D11.2 (A), R37.2
unnamed: D12.2 (A), R38.2
unnamed: D13.2 (A), R39.2
unnamed: D14.2 (A), R40.2
unnamed: D17.1 (K), R43.1
unnamed: D19.2 (A), R48.2
unnamed: D20.2 (A), R46.2
unnamed: J1.A5 (CC1), R16.2
unnamed: J1.B5 (CC2), R17.2
unnamed: J4.A5 (CC1), R23.2
unnamed: J4.B5 (CC2), R24.2
unnamed: F1.1, J8.2
unnamed: J19.A5 (CC1), R45.2
unnamed: J19.B5 (CC2), R47.2
unnamed: J22.A5 (CC1), R49.2
unnamed: J22.B5 (CC2), R50.2
unnamed: JP3.2 (B), R6.1
unnamed: JP4.1 (A), R18.1, U3.3 (~CE), U3.6 (VOUT)
unnamed: F3.2, JP5.1 (A)
unnamed: Q1.1 (B), R20.2, R21.2, R22.1
unnamed: Q1.2 (E), R25.1
unnamed: R19.2, U2.25 (PB12)
unnamed: R11.1, U2.2 (PC13)
unnamed: R13.1, U2.3 (PC14)
unnamed: R18.2, U3.5 (ST)
unnamed: R26.2, U5.5 (ST)
unnamed: C23.1, U7.1 (BOOT)
unnamed: C33.1, U8.1 (BOOT)
VBUS: C24.1, C25.1, C26.2, C31.1, C45.1, J9.2, J16.2, R31.1, U6.1 (IN), U7.7 (VIN)
