NTURacingTeam/nturt_kicad/driverless_car/driverless_car.kicad_sch

## KiCad design driverless_car/driverless_car.kicad_sch (2023-11-28)

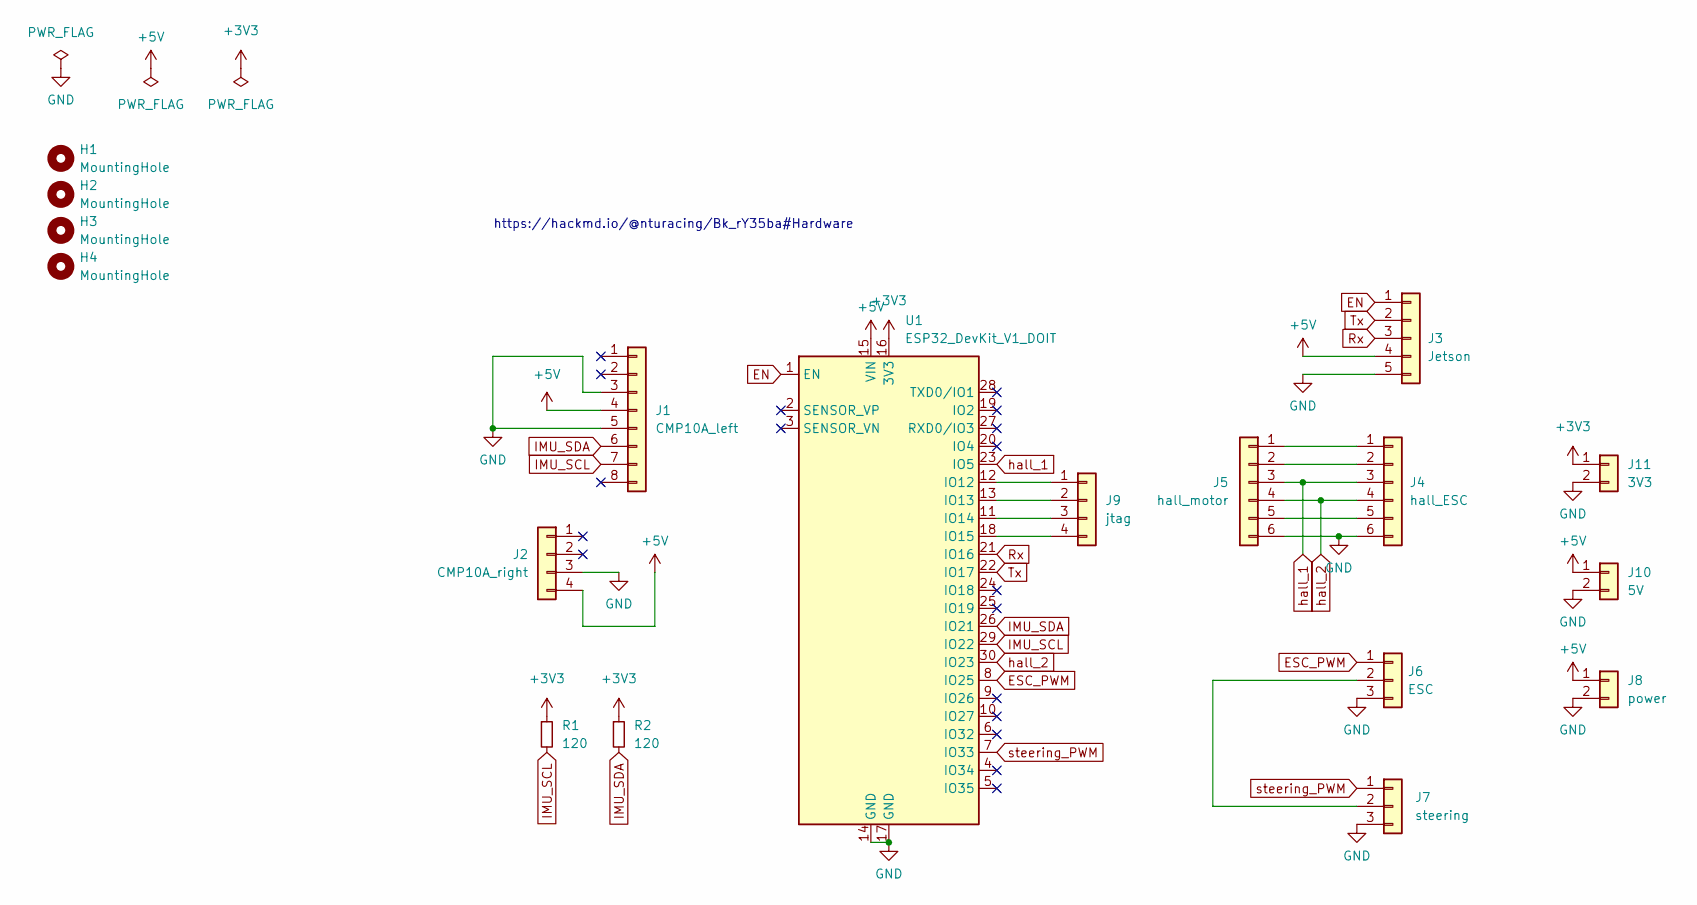
[picture p117: schematic driverless_car.kicad_sch]

Parts:
H1, H2, H3, H4: MountingHole; MountingHole_3mm
J1: CMP10A_left; PinSocket_1x08_P2.54mm_Vertical
J2: CMP10A_right; PinSocket_1x04_P2.54mm_Vertical
J3: Jetson; JST_XH_B5B-XH-A_1x05_P2.50mm_Vertical
J4: hall_ESC; JST_XH_B6B-XH-A_1x06_P2.50mm_Vertical
J5: hall_motor; JST_XH_B6B-XH-A_1x06_P2.50mm_Vertical
J6: ESC; PinHeader_1x03_P2.54mm_Vertical
J7: steering; PinHeader_1x03_P2.54mm_Vertical
J8: power; PhoenixContact_MSTBVA_2,5_2-G-5,08_1x02_P5.08mm_Vertical
J9: jtag; PinSocket_1x04_P2.54mm_Vertical
J10: 5V; PinSocket_1x02_P2.54mm_Vertical
J11: 3V3; PinSocket_1x02_P2.54mm_Vertical
R1, R2: 120; R_0805_2012Metric
U1: ESP32_DevKit_V1_DOIT; esp32_devkit_v1_doit

Connections:
+3V3: J11.1, R1.1, R2.1, U1.16 (3V3)
+5V: J1.4, J2.4, J3.4, J8.1, J10.1, U1.15 (VIN)
EN: J3.1, U1.1 (EN)
ESC_PWM: J6.1, U1.8 (IO25)
GND: J1.3, J1.5, J2.3, J3.5, J4.6, J5.6, J6.3, J7.3, J8.2, J10.2, J11.2, U1.14 (GND), U1.17 (GND)
IMU_SCL: J1.7, R1.2, U1.29 (IO22)
IMU_SDA: J1.6, R2.2, U1.26 (IO21)
unnamed: J4.1, J5.1
unnamed: J4.2, J5.2
unnamed: J4.5, J5.5
unnamed: J6.2, J7.2
unnamed: J9.1, U1.12 (IO12)
unnamed: J9.2, U1.13 (IO13)
unnamed: J9.3, U1.11 (IO14)
unnamed: J9.4, U1.18 (IO15)
Rx: J3.3, U1.21 (IO16)
Tx: J3.2, U1.22 (IO17)
hall_1: J4.3, J5.3, U1.23 (IO5)
hall_2: J4.4, J5.4, U1.30 (IO23)
steering_PWM: J7.1, U1.7 (IO33)

Notes on the sheet:
https://hackmd.io/@nturacing/Bk_rY35ba#Hardware
