NTURacingTeam/nturt_kicad/EP4/BatteryBox/SC_Board_EP4O_V2_20230615/Relay.kicad_sch

## KiCad design EP4/BatteryBox/SC_Board_EP4O_V2_20230615/Relay.kicad_sch (2023-08-07)

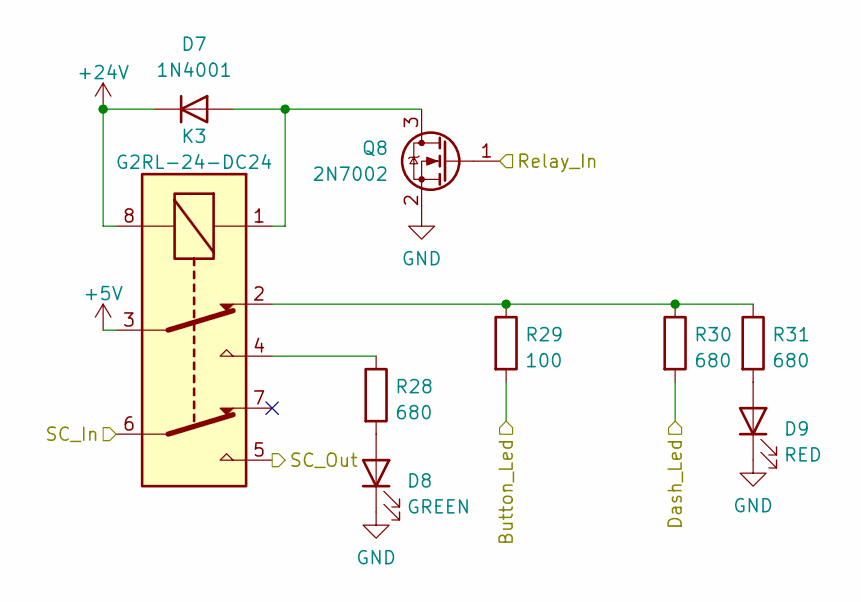
[picture p118: schematic Relay.kicad_sch]

Parts:
D7: 1N4001; D_MiniMELF_Handsoldering
D8: GREEN; D_0805_2012Metric_Pad1.15x1.40mm_HandSolder
D9: RED; D_0805_2012Metric_Pad1.15x1.40mm_HandSolder
K3: G2RL-24-DC24; Relay_DPDT_Omron_G2RL; Mouser Part Number 653-G2RL-24-DC5
Q8: 2N7002; SOT-23
R28, R30, R31: 680; R_0805_2012Metric_Pad1.20x1.40mm_HandSolder
R29: 100; R_0805_2012Metric_Pad1.20x1.40mm_HandSolder

Connections:
+5V: K3.3
+24V: D7.1 (K), K3.8
Button_Led: R29.2
Dash_Led: R30.2
GND: D8.1 (K), D9.1 (K), Q8.2 (S)
unnamed: D7.2 (A), K3.1, Q8.3 (D)
unnamed: D8.2 (A), R28.2
unnamed: D9.2 (A), R31.2
unnamed: K3.2, R29.1, R30.1, R31.1
unnamed: K3.4, R28.1
Relay_In: Q8.1 (G)
SC_In: K3.6
SC_Out: K3.5
