NTURacingTeam/nturt_kicad/EP4/BatteryBox/SC_Board_EP4O_V2_20230615/SC_Board_EP4O_V2_20230615.kicad_sch

## KiCad design EP4/BatteryBox/SC_Board_EP4O_V2_20230615/SC_Board_EP4O_V2_20230615.kicad_sch (2023-08-07)

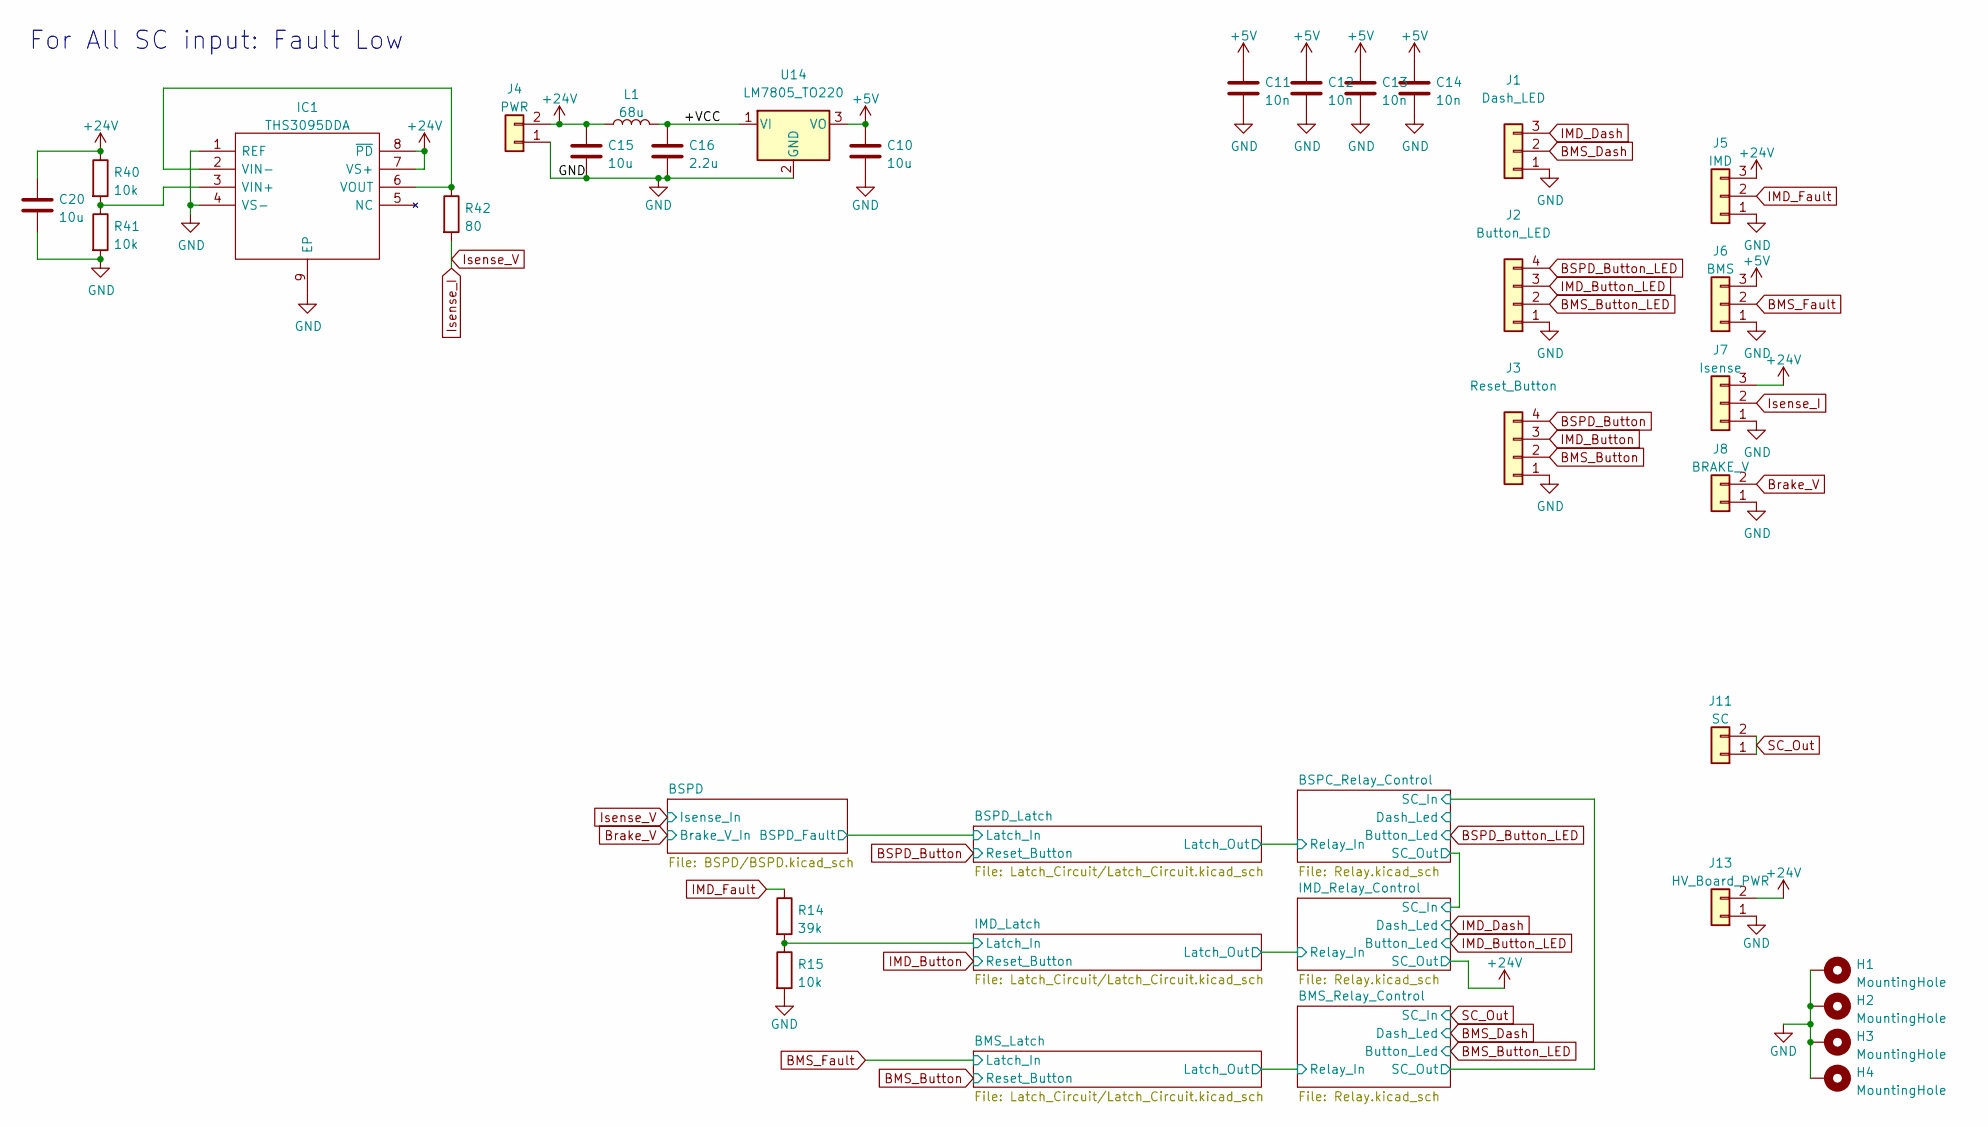
[picture p119: schematic SC_Board_EP4O_V2_20230615.kicad_sch]

Parts:
C10, C15, C20: 10u; C_1206_3216Metric_Pad1.33x1.80mm_HandSolder
C11, C12, C13, C14: 10n; C_0805_2012Metric_Pad1.18x1.45mm_HandSolder
C16: 2.2u; C_1206_3216Metric_Pad1.33x1.80mm_HandSolder
H1, H2, H3, H4: MountingHole; MountingHole_4.3mm_M4_Pad_Via
IC1: THS3095DDA; SOIC127P600X170-9N; Mouser Part Number 595-THS3095DDA
J1: Dash_LED; JST_PH_B3B-PH-K_1x03_P2.00mm_Vertical
J2: Button_LED; JST_PH_B4B-PH-K_1x04_P2.00mm_Vertical
J3: Reset_Button; JST_PH_B4B-PH-K_1x04_P2.00mm_Vertical
J4: PWR; JST_PH_B2B-PH-K_1x02_P2.00mm_Vertical
J5: IMD; JST_PH_B3B-PH-K_1x03_P2.00mm_Vertical
J6: BMS; JST_PH_B3B-PH-K_1x03_P2.00mm_Vertical
J7: Isense; JST_PH_B3B-PH-K_1x03_P2.00mm_Vertical
J8: BRAKE_V; JST_PH_B2B-PH-K_1x02_P2.00mm_Vertical
J11: SC; JST_PH_B2B-PH-K_1x02_P2.00mm_Vertical
J13: HV_Board_PWR; JST_PH_B2B-PH-K_1x02_P2.00mm_Vertical
L1: 68u; RLS686
R14: 39k; R_0805_2012Metric_Pad1.20x1.40mm_HandSolder
R15, R40, R41: 10k; R_0805_2012Metric_Pad1.20x1.40mm_HandSolder
R42: 80; R_Axial_Power_L38.0mm_W6.4mm_P40.64mm
U14: LM7805_TO220; TO-220-3_Vertical

Connections:
+5V: C10.1, C11.1, C12.1, C13.1, C14.1, J6.3, U14.3 (VO)
+24V: C15.1, C20.1, IC1.7 (VS+), IC1.8 (~PD), J4.2, J5.3, J7.3, J13.2, L1.1, R40.1
+VCC: C16.1, L1.2, U14.1 (VI)
BMS_Button: J3.2
BMS_Button_LED: J2.2
BMS_Dash: J1.2
BMS_Fault: J6.2
BSPD_Button: J3.4
BSPD_Button_LED: J2.4
Brake_V: J8.2
GND: C10.2, C11.2, C12.2, C13.2, C14.2, C15.2, C16.2, C20.2, H1.1, H2.1, H3.1, H4.1, IC1.1 (REF), IC1.4 (VS-), IC1.9 (EP), J1.1, J2.1, J3.1, J4.1, J5.1, J6.1, J7.1, J8.1, J13.1, R15.2, R41.2, U14.2 (GND)
IMD_Button: J3.3
IMD_Button_LED: J2.3
IMD_Dash: J1.3
IMD_Fault: J5.2, R14.1
Isense_I: J7.2, R42.2
Latch_In: R14.2, R15.1
unnamed: IC1.2 (VIN-), IC1.6 (VOUT), R42.1
unnamed: IC1.3 (VIN+), R40.2, R41.1
SC_Out: J11.1, J11.2

Notes on the sheet:
For All SC input: Fault Low
