NTURacingTeam/nturt_kicad/EP4/Charger_Boards/Charger_HV_Board_V2_20220827/Charger_HV_Board_V2_20220827.kicad_sch

## KiCad design EP4/Charger_Boards/Charger_HV_Board_V2_20220827/Charger_HV_Board_V2_20220827.kicad_sch (2023-08-07)

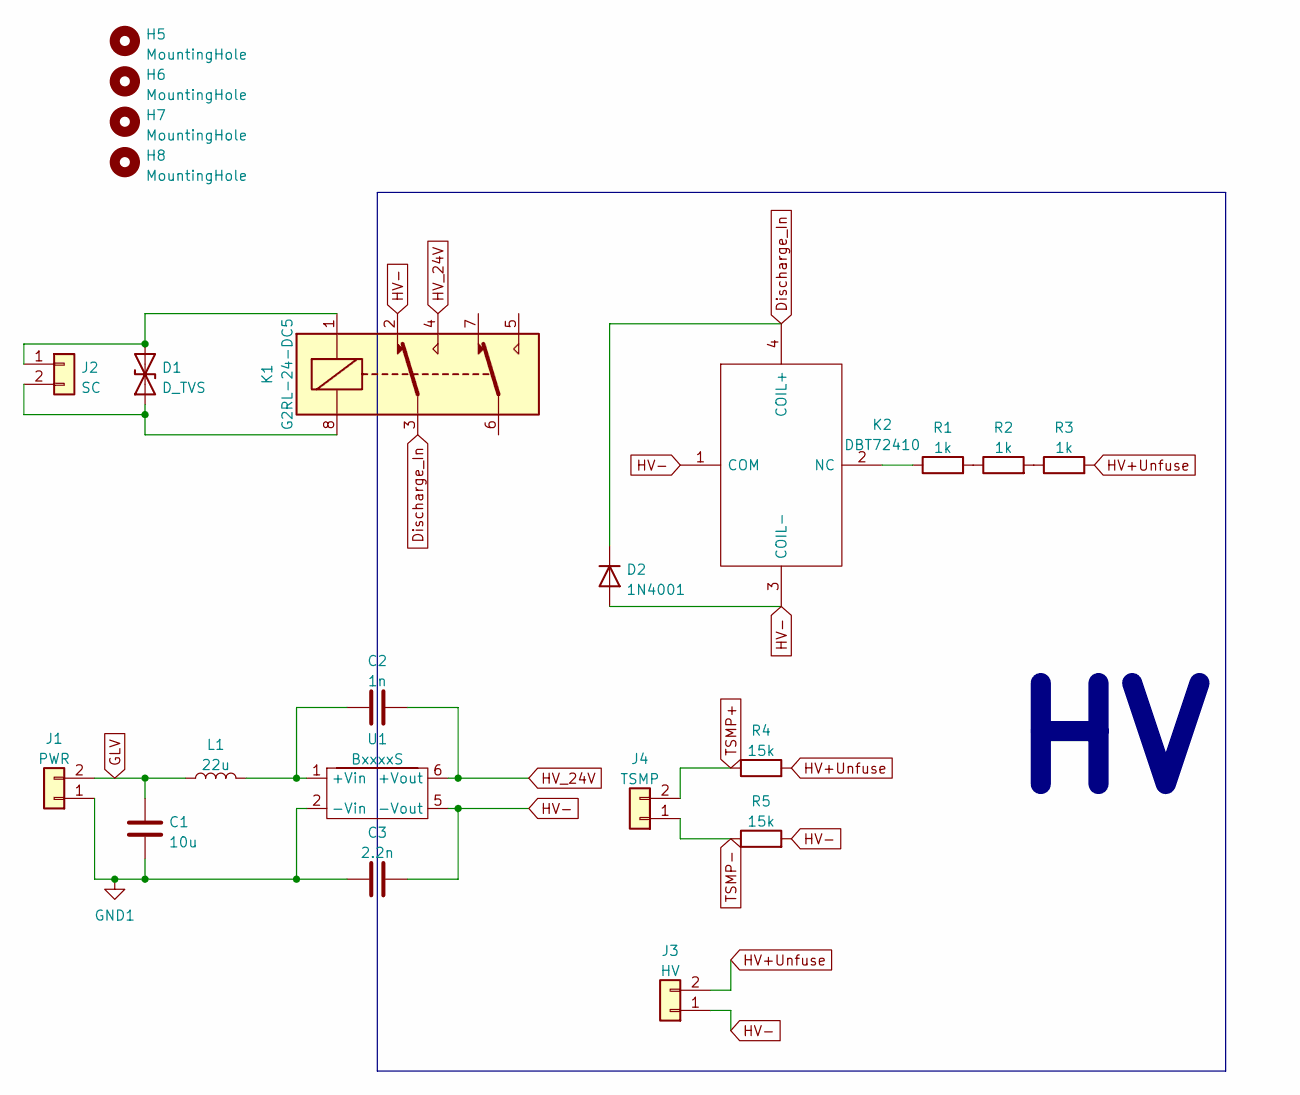
[picture p120: schematic Charger_HV_Board_V2_20220827.kicad_sch]

Parts:
C1: 10u; C_1206_3216Metric_Pad1.33x1.80mm_HandSolder
C2: 1n; C_Axial_L5.1mm_D3.1mm_P15.00mm_Horizontal
C3: 2.2n; C_Axial_L5.1mm_D3.1mm_P15.00mm_Horizontal
D1: D_TVS; D_DO-15_P15.24mm_Horizontal
D2: 1N4001; D_DO-41_SOD81_P10.16mm_Horizontal
H5, H6, H7, H8: MountingHole; MountingHole_4.3mm_M4
J1: PWR; JST_VH_B2P-VH-B_1x02_P3.96mm_Vertical
J2: SC; JST_VH_B2P-VH-B_1x02_P3.96mm_Vertical
J3: HV; TE_1747996
J4: TSMP; TE_1747996
K1: G2RL-24-DC5; Relay_DPDT_Omron_G2RL; Mouser Part Number 653-G2RL-24-DC5
K2: DBT72410; Manufacturer_Part_Number DBT72410
L1: 22u; RLS226R
R1, R2, R3: 1k; R_Axial_Power_L48.0mm_W12.5mm_P60.96mm
R4, R5: 15k; R_Axial_DIN0411_L9.9mm_D3.6mm_P20.32mm_Horizontal
U1: BxxxxS

Connections:
Discharge_In: D2.1 (K), K1.3, K2.4 (COIL+)
GLV: C1.1, J1.2, L1.1
GND1: C1.2, C3.1, J1.1, U1.2 (-Vin)
HV+Unfuse: J3.2, R3.2, R4.2
HV-: C3.2, D2.2 (A), J3.1, K1.2, K2.1 (COM), K2.3 (COIL-), R5.2, U1.5 (-Vout)
HV_24V: C2.2, K1.4, U1.6 (+Vout)
unnamed: C2.1, L1.2, U1.1 (+Vin)
unnamed: D1.1 (A1), J2.2, K1.8
unnamed: D1.2 (A2), J2.1, K1.1
unnamed: K2.2 (NC), R1.1
unnamed: R1.2, R2.1
unnamed: R2.2, R3.1
TSMP+: J4.2, R4.1
TSMP-: J4.1, R5.1
