NTURacingTeam/nturt_kicad/EP4/Charger_Boards/Charger_SC_Board_V2_20220827/Charger_SC_Board_V2_20220827.kicad_sch

## KiCad design EP4/Charger_Boards/Charger_SC_Board_V2_20220827/Charger_SC_Board_V2_20220827.kicad_sch (2023-08-07)

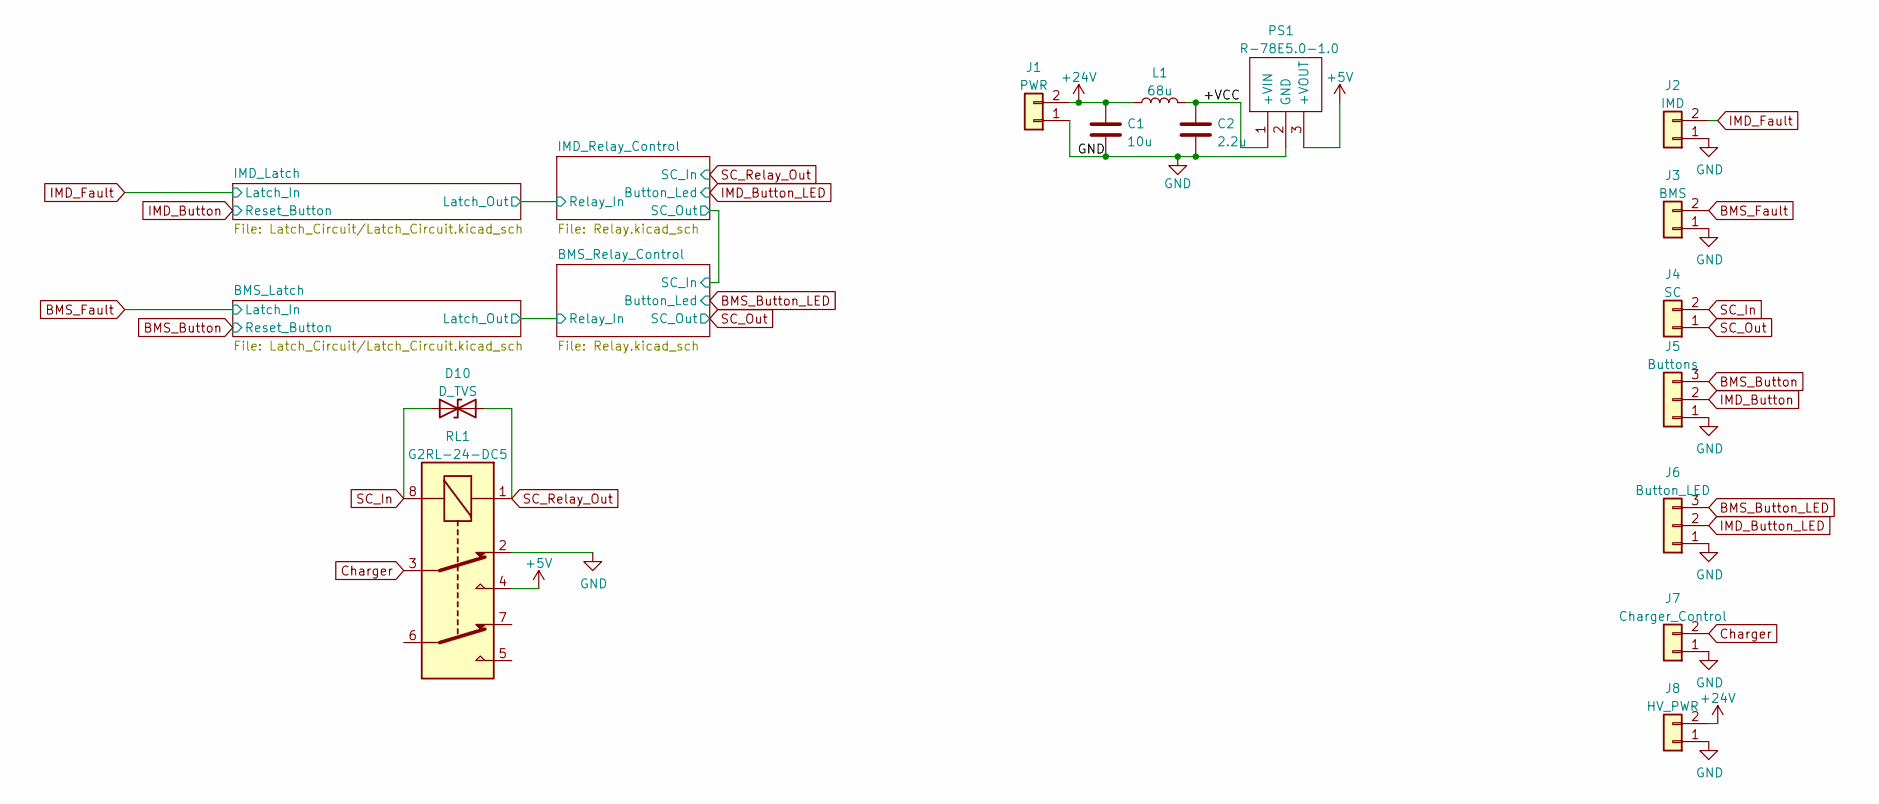
[picture p121: schematic Charger_SC_Board_V2_20220827.kicad_sch]

Parts:
C1: 10u; C_1206_3216Metric_Pad1.33x1.80mm_HandSolder
C2: 2.2u; C_1206_3216Metric_Pad1.33x1.80mm_HandSolder
D10: D_TVS; D_DO-15_P15.24mm_Horizontal
J1: PWR; JST_VH_B2P-VH-B_1x02_P3.96mm_Vertical
J2: IMD; JST_VH_B2P-VH-B_1x02_P3.96mm_Vertical
J3: BMS; JST_VH_B2P-VH-B_1x02_P3.96mm_Vertical
J4: SC; JST_VH_B2P-VH-B_1x02_P3.96mm_Vertical
J5: Buttons; JST_VH_B3P-VH-B_1x03_P3.96mm_Vertical
J6: Button_LED; JST_VH_B3P-VH-B_1x03_P3.96mm_Vertical
J7: Charger_Control; JST_VH_B2P-VH-B_1x02_P3.96mm_Vertical
J8: HV_PWR; JST_VH_B2P-VH-B_1x02_P3.96mm_Vertical
L1: 68u; RLS686
PS1: R-78E5.0-1.0; R78B5020; Mouser Part Number 919-R-78E5.0-1.0
RL1: G2RL-24-DC5; Relay_DPDT_Omron_G2RL

Connections:
+5V: PS1.3 (+VOUT), RL1.4
+24V: C1.1, J1.2, J8.2, L1.1
+VCC: C2.1, L1.2, PS1.1 (+VIN)
BMS_Button: J5.3
BMS_Button_LED: J6.3
BMS_Fault: J3.2
Charger: J7.2, RL1.3
GND: C1.2, C2.2, J1.1, J2.1, J3.1, J5.1, J6.1, J7.1, J8.1, PS1.2 (GND), RL1.2
IMD_Button: J5.2
IMD_Button_LED: J6.2
IMD_Fault: J2.2
SC_In: D10.1 (A1), J4.2, RL1.8
SC_Out: J4.1
SC_Relay_Out: D10.2 (A2), RL1.1
