NTURacingTeam/nturt_kicad/EP4/Charger_Boards/Charger_SC_Board_V2_20220827/Relay.kicad_sch

## KiCad design EP4/Charger_Boards/Charger_SC_Board_V2_20220827/Relay.kicad_sch (2023-08-07)

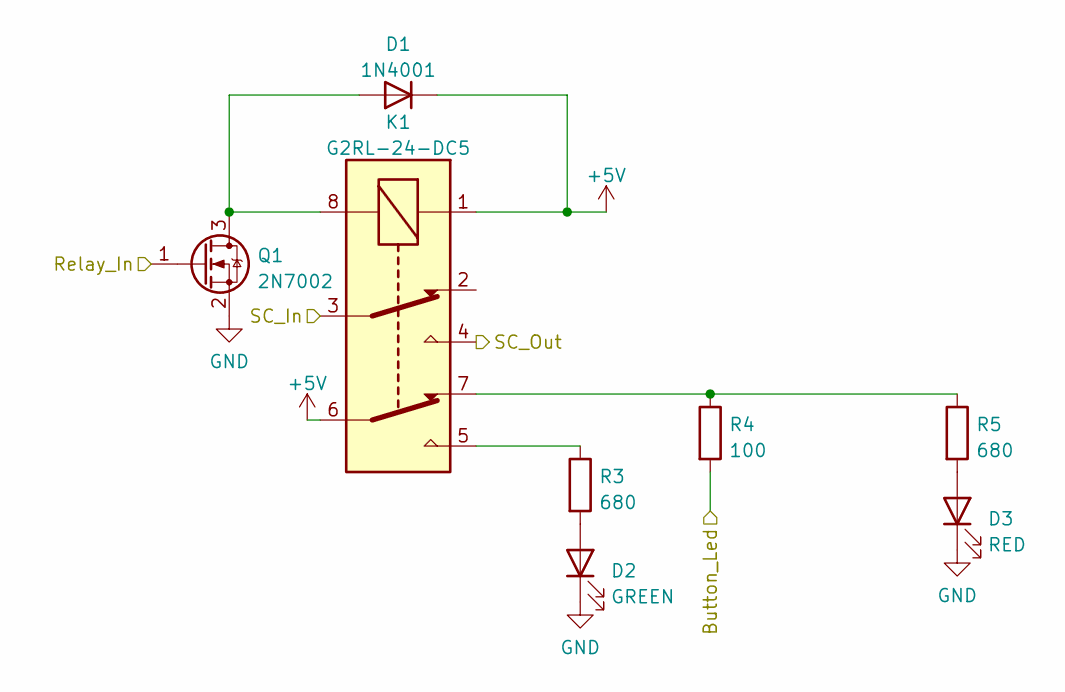
[picture p122: schematic Relay.kicad_sch]

Parts:
D1: 1N4001; D_DO-41_SOD81_P10.16mm_Horizontal
D2: GREEN; D_1206_3216Metric_Pad1.42x1.75mm_HandSolder
D3: RED; D_1206_3216Metric_Pad1.42x1.75mm_HandSolder
K1: G2RL-24-DC5; Relay_DPDT_Omron_G2RL; Mouser Part Number 653-G2RL-24-DC5
Q1: 2N7002; SOT-23
R3, R5: 680; R_1206_3216Metric_Pad1.30x1.75mm_HandSolder
R4: 100; R_1206_3216Metric_Pad1.30x1.75mm_HandSolder

Connections:
+5V: D1.1 (K), K1.1, K1.6
Button_Led: R4.2
GND: D2.1 (K), D3.1 (K), Q1.2 (S)
unnamed: D1.2 (A), K1.8, Q1.3 (D)
unnamed: D2.2 (A), R3.2
unnamed: D3.2 (A), R5.2
unnamed: K1.5, R3.1
unnamed: K1.7, R4.1, R5.1
Relay_In: Q1.1 (G)
SC_In: K1.3
SC_Out: K1.4
