NTURacingTeam/nturt_kicad/EP4/ElectricalGroup/frontbox_nucleo/electronics.kicad_sch

## KiCad design EP4/ElectricalGroup/frontbox_nucleo/electronics.kicad_sch (2023-08-13)

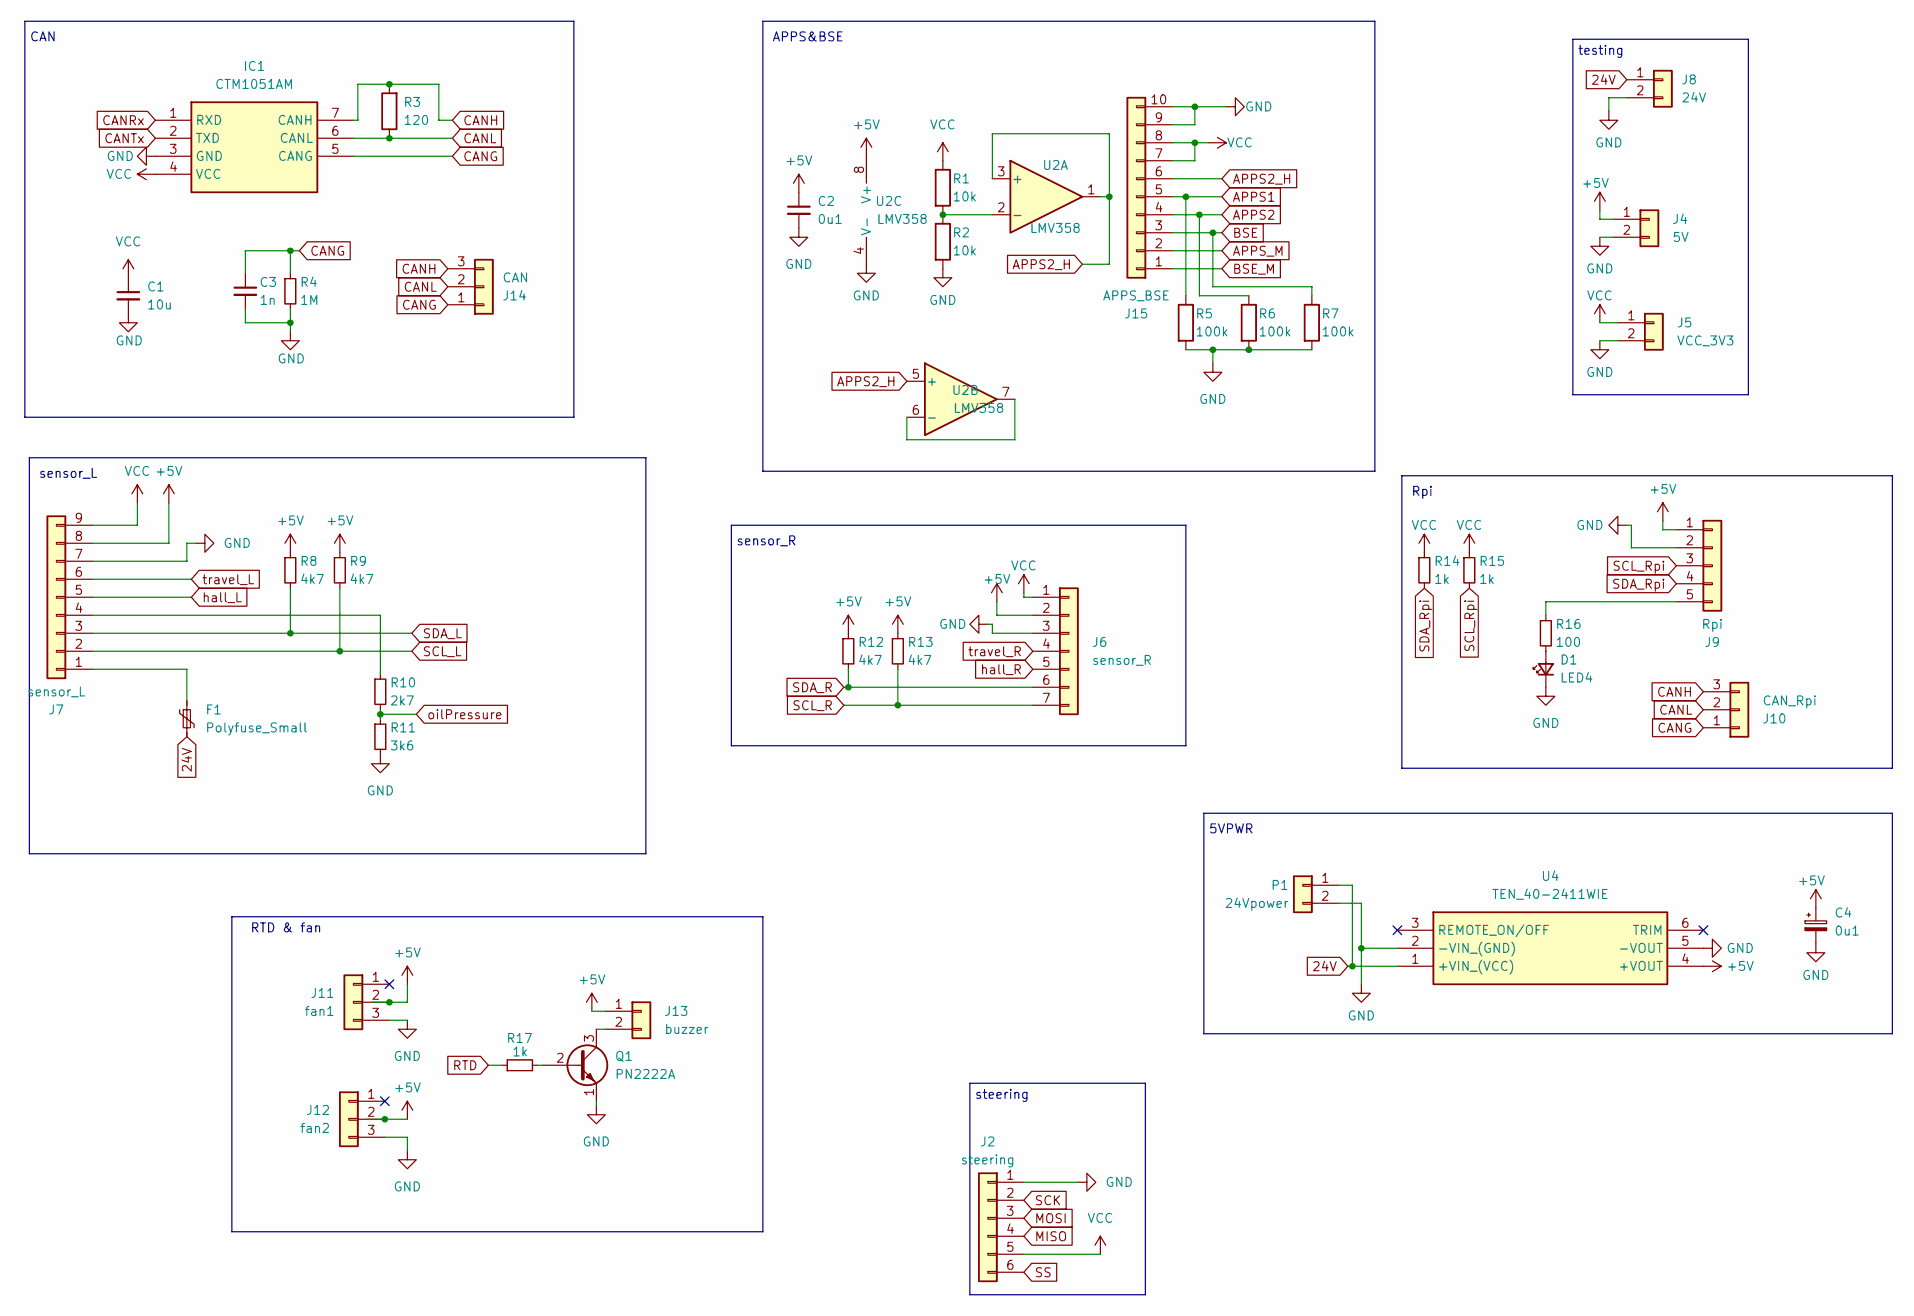
[picture p123: schematic electronics.kicad_sch]

Parts:
C1: 10u; C_0805_2012Metric_Pad1.18x1.45mm_HandSolder
C2: 0u1; C_0603_1608Metric
C3: 1n; C_Disc_D5.0mm_W2.5mm_P5.00mm
C4: 0u1; CP_EIA-3528-21_Kemet-B_Pad1.50x2.35mm_HandSolder
D1: LED4; LED_0603_1608Metric_Pad1.05x0.95mm_HandSolder
F1: Polyfuse_Small; Fuse_1206_3216Metric
IC1: CTM1051AM; Manufacturer_Part_Number CTM1051AM
J2: steering; JST_XH_B6B-XH-A_1x06_P2.50mm_Vertical
J4: 5V; PinSocket_1x02_P2.54mm_Vertical
J5: VCC_3V3; PinSocket_1x02_P2.54mm_Vertical
J6: sensor_R; JST_XH_B7B-XH-A_1x07_P2.50mm_Vertical
J7: sensor_L; JST_XH_S9B-XH-A-1_1x09_P2.50mm_Horizontal
J8: 24V; PinSocket_1x02_P2.54mm_Vertical
J9: Rpi; JST_XH_S5B-XH-A-1_1x05_P2.50mm_Horizontal
J10: CAN_Rpi; JST_XH_S3B-XH-A-1_1x03_P2.50mm_Horizontal
J11: fan1; PinHeader_1x03_P2.54mm_Vertical
J12: fan2; PinHeader_1x03_P2.54mm_Vertical
J13: buzzer; JST_XH_B2B-XH-A_1x02_P2.50mm_Vertical
J14: CAN; JST_XH_S3B-XH-A-1_1x03_P2.50mm_Horizontal
J15: APPS_BSE; JST_XH_B10B-XH-A_1x10_P2.50mm_Vertical
P1: 24Vpower; JST_XH_B2B-XH-A_1x02_P2.50mm_Vertical
Q1: PN2222A; TO-92_Inline
R1, R2: 10k; R_0603_1608Metric
R3: 120; R_1206_3216Metric
R4: 1M; R_0603_1608Metric
R5, R6, R7: 100k; R_0603_1608Metric
R8, R9, R12, R13: 4k7; R_0603_1608Metric
R10: 2k7; R_0603_1608Metric
R11: 3k6; R_0603_1608Metric
R14, R15, R17: 1k; R_0603_1608Metric
R16: 100; R_0603_1608Metric
U2: LMV358; SOIC-8_3.9x4.9mm_P1.27mm
U4: TEN_40-2411WIE; TEN402411WIE; Mouser Part Number 495-TEN40-2411WIE

Connections:
24V: F1.2, J8.1, P1.1, U4.1 (+VIN_(VCC))
+5V: C2.1, C4.1, J4.1, J6.2, J7.8, J9.1, J11.2, J12.2, J13.1, R8.1, R9.1, R12.1, R13.1, U2.8 (V+), U4.4 (+VOUT)
APPS1: J15.5, R5.1
APPS2: J15.4, R6.1
APPS2_H: J15.6, U2.1, U2.3 (+), U2.5 (+)
APPS_M: J15.2
BSE: J15.3, R7.1
BSE_M: J15.1
CANG: C3.1, IC1.5 (CANG), J10.1, J14.1, R4.1
CANH: IC1.7 (CANH), J10.3, J14.3, R3.2
CANL: IC1.6 (CANL), J10.2, J14.2, R3.1
CANRx: IC1.1 (RXD)
CANTx: IC1.2 (TXD)
GND: C1.2, C2.2, C3.2, C4.2, D1.1 (K), IC1.3 (GND), J2.1, J4.2, J5.2, J6.3, J7.7, J8.2, J9.2, J11.3, J12.3, J15.9, J15.10, P1.2, Q1.1 (E), R2.2, R4.2, R5.2, R6.2, R7.2, R11.2, U2.4 (V-), U4.2 (-VIN_(GND)), U4.5 (-VOUT)
MISO: J2.4
MOSI: J2.3
unnamed: D1.2 (A), R16.2
unnamed: F1.1, J7.1
unnamed: J7.4, R10.1
unnamed: J9.5, R16.1
unnamed: J13.2, Q1.3 (C)
unnamed: Q1.2 (B), R17.2
unnamed: R1.2, R2.1, U2.2 (-)
unnamed: U2.6 (-), U2.7
RTD: R17.1
SCK: J2.2
SCL_L: J7.2, R9.2
SCL_R: J6.7, R13.2
SCL_Rpi: J9.3, R15.2
SDA_L: J7.3, R8.2
SDA_R: J6.6, R12.2
SDA_Rpi: J9.4, R14.2
SS: J2.6
VCC: C1.1, IC1.4 (VCC), J2.5, J5.1, J6.1, J7.9, J15.7, J15.8, R1.1, R14.1, R15.1
hall_L: J7.5
hall_R: J6.5
oilPressure: R10.2, R11.1
travel_L: J7.6
travel_R: J6.4

Notes on the sheet:
steering
CAN
sensor_R
RTD & fan
Rpi
testing
5VPWR
APPS&BSE
sensor_L
