NTURacingTeam/nturt_kicad/EP4/ElectricalGroup/frontbox_nucleo/frontbox_nucleo.kicad_sch

## KiCad design EP4/ElectricalGroup/frontbox_nucleo/frontbox_nucleo.kicad_sch (2023-08-13)

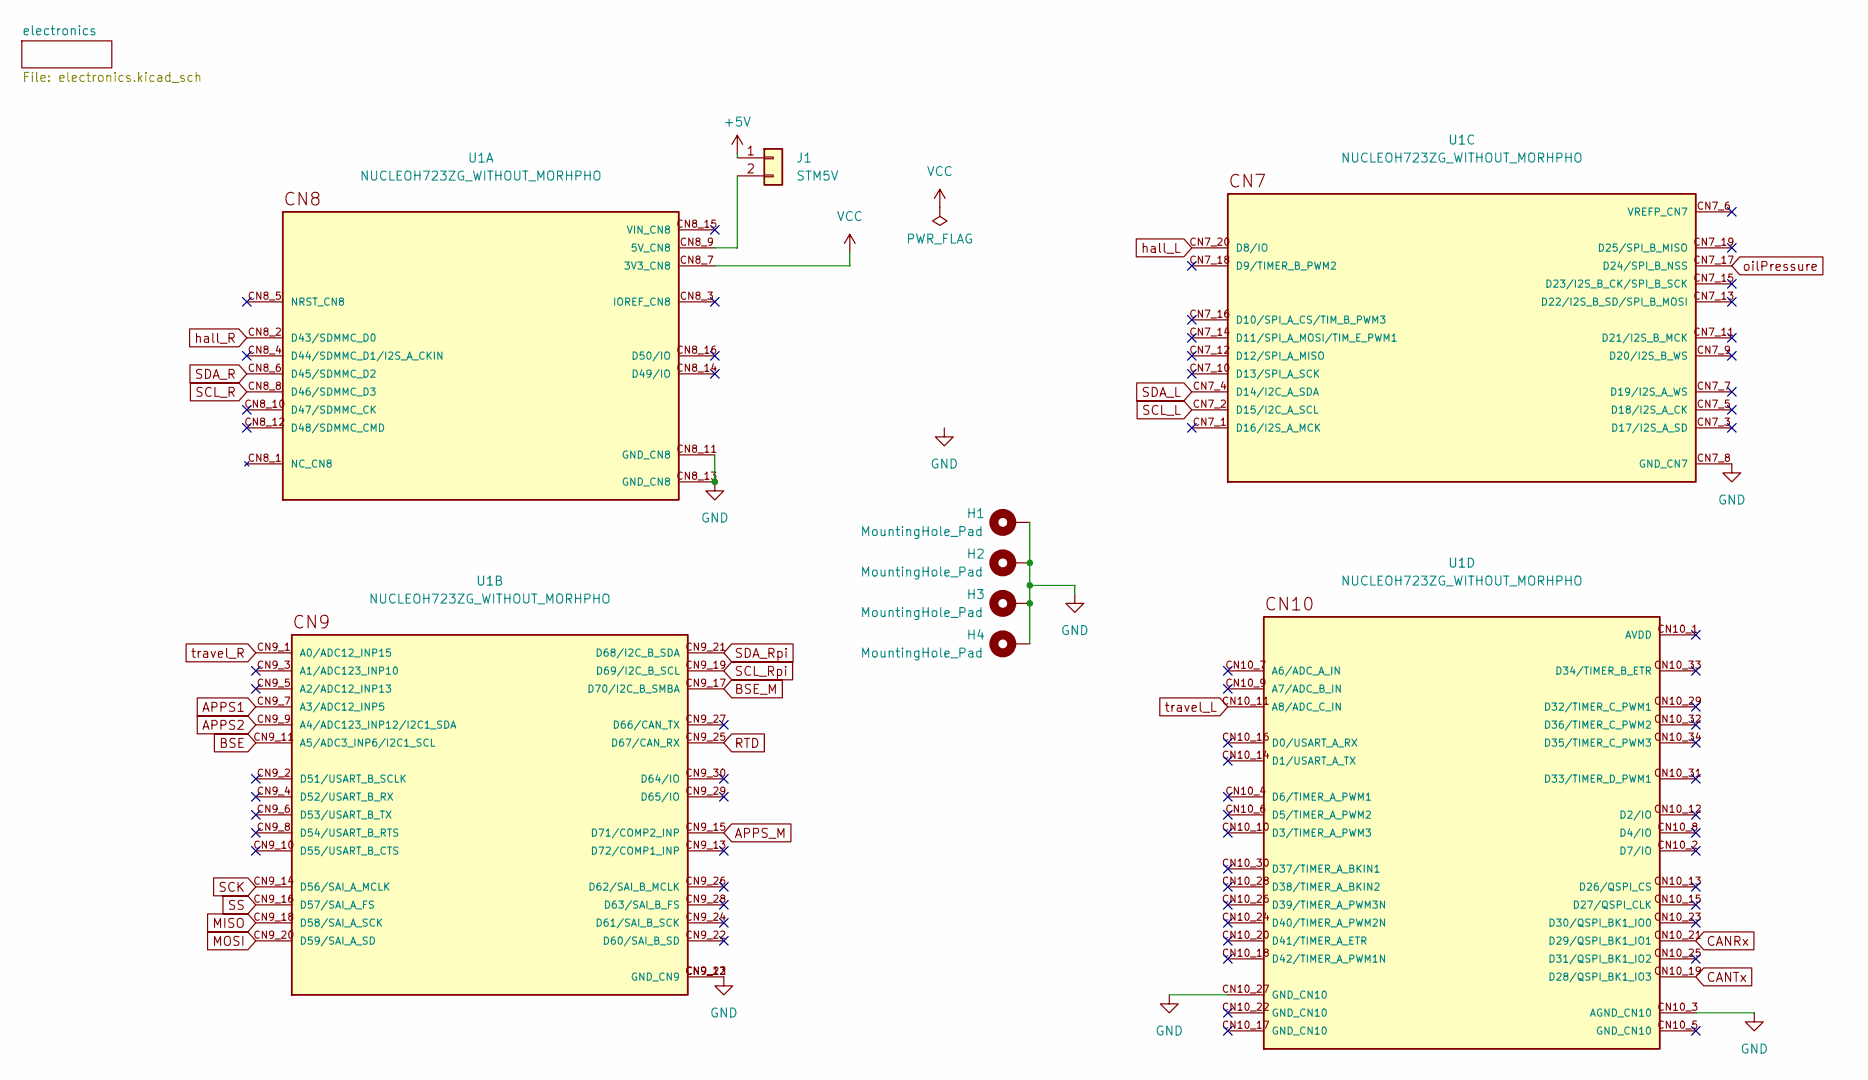
[picture p124: schematic frontbox_nucleo.kicad_sch]

Parts:
H1, H2, H3, H4: MountingHole_Pad; MountingHole_2.2mm_M2_DIN965_Pad
J1: STM5V; PinHeader_1x02_P2.54mm_Vertical
U1: NUCLEOH723ZG_WITHOUT_MORHPHO; MODULE_NUCLEOH723ZG_WITHOUT_MORHPHO; PARTREV 2

Connections:
+5V: J1.1
APPS1: U1.CN9_7 (A3/ADC12_INP5)
APPS2: U1.CN9_9 (A4/ADC123_INP12/I2C1_SDA)
APPS_M: U1.CN9_15 (D71/COMP2_INP)
BSE: U1.CN9_11 (A5/ADC3_INP6/I2C1_SCL)
BSE_M: U1.CN9_17 (D70/I2C_B_SMBA)
CANRx: U1.CN10_21 (D29/QSPI_BK1_IO1)
CANTx: U1.CN10_19 (D28/QSPI_BK1_IO3)
GND: H1.1, H2.1, H3.1, H4.1, U1.CN7_8 (GND_CN7), U1.CN8_11 (GND_CN8), U1.CN8_13 (GND_CN8), U1.CN9_12 (GND_CN9), U1.CN9_23 (GND_CN9), U1.CN10_3 (AGND_CN10), U1.CN10_27 (GND_CN10)
MISO: U1.CN9_18 (D58/SAI_A_SCK)
MOSI: U1.CN9_20 (D59/SAI_A_SD)
unnamed: J1.2, U1.CN8_9 (5V_CN8)
RTD: U1.CN9_25 (D67/CAN_RX)
SCK: U1.CN9_14 (D56/SAI_A_MCLK)
SCL_L: U1.CN7_2 (D15/I2C_A_SCL)
SCL_R: U1.CN8_8 (D46/SDMMC_D3)
SCL_Rpi: U1.CN9_19 (D69/I2C_B_SCL)
SDA_L: U1.CN7_4 (D14/I2C_A_SDA)
SDA_R: U1.CN8_6 (D45/SDMMC_D2)
SDA_Rpi: U1.CN9_21 (D68/I2C_B_SDA)
SS: U1.CN9_16 (D57/SAI_A_FS)
VCC: U1.CN8_7 (3V3_CN8)
hall_L: U1.CN7_20 (D8/IO)
hall_R: U1.CN8_2 (D43/SDMMC_D0)
oilPressure: U1.CN7_17 (D24/SPI_B_NSS)
travel_L: U1.CN10_11 (A8/ADC_C_IN)
travel_R: U1.CN9_1 (A0/ADC12_INP15)
