NTURacingTeam/nturt_kicad/EP4/ElectricalGroup/frontbox_nucleo_ex/components.kicad_sch

## KiCad design EP4/ElectricalGroup/frontbox_nucleo_ex/components.kicad_sch (2023-08-13)

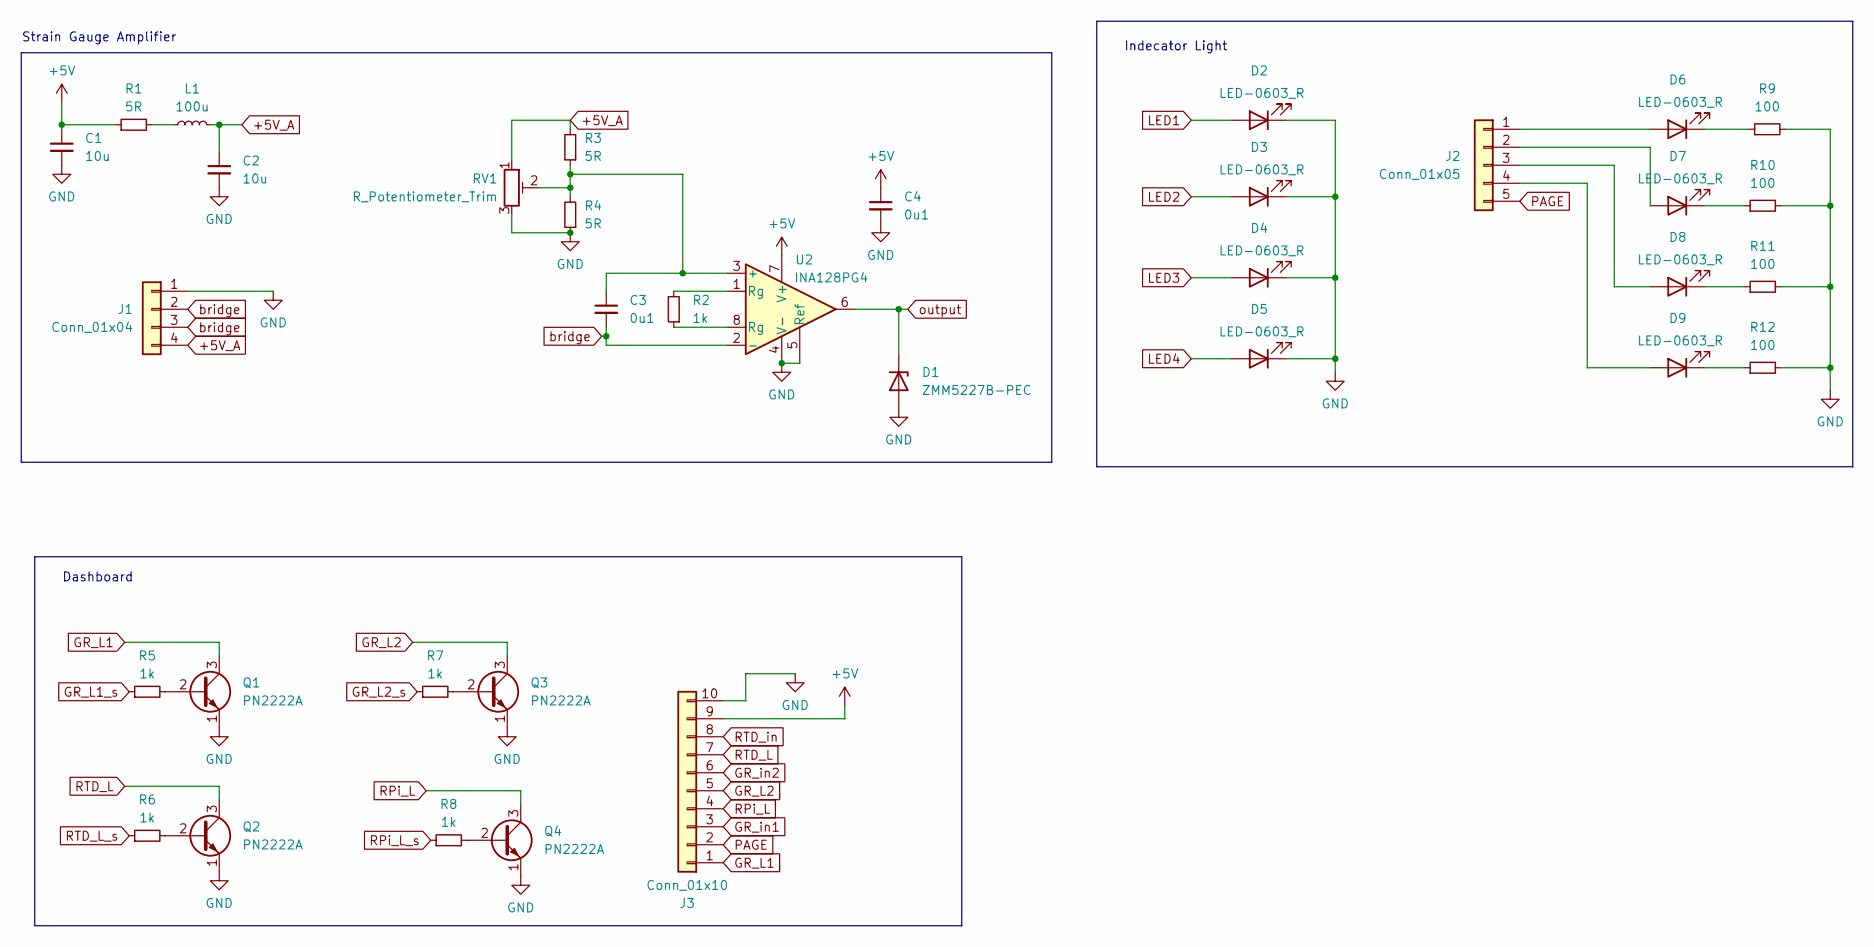
[picture p125: schematic components.kicad_sch]

Parts:
C1, C2: 10u; C_0603_1608Metric_Pad1.08x0.95mm_HandSolder
C3, C4: 0u1; C_0603_1608Metric_Pad1.08x0.95mm_HandSolder
D1: ZMM5227B-PEC; D_MiniMELF
D2, D3, D4, D5, D6, D7, D8, D9: LED-0603_R; LED_0603_1608Metric_Pad1.05x0.95mm_HandSolder
J1: Conn_01x04; JST_XH_S4B-XH-A_1x04_P2.50mm_Horizontal
J2: Conn_01x05; JST_XH_S5B-XH-A_1x05_P2.50mm_Horizontal
J3: Conn_01x10; JST_XH_S10B-XH-A_1x10_P2.50mm_Horizontal
L1: 100u; L_Axial_L12.0mm_D5.0mm_P15.24mm_Horizontal_Fastron_MISC
Q1, Q2, Q3, Q4: PN2222A; TO-92_Inline
R1, R3, R4: 5R; R_0603_1608Metric_Pad0.98x0.95mm_HandSolder
R2: 1k; R_0805_2012Metric_Pad1.20x1.40mm_HandSolder
R5, R6, R7, R8: 1k; R_0603_1608Metric_Pad0.98x0.95mm_HandSolder
R9, R10, R11, R12: 100; R_0603_1608Metric_Pad0.98x0.95mm_HandSolder
RV1: R_Potentiometer_Trim; Potentiometer_Bourns_3296W_Vertical
U2: INA128PG4; DIP794W53P254L959H508Q8N

Connections:
+5V: C1.1, C4.1, J3.9, R1.1, U2.7 (V+)
+5V_A: C2.1, J1.4, L1.2, R3.2, RV1.1
GND: C1.2, C2.2, C4.2, D1.2 (A), D2.1 (K), D3.1 (K), D4.1 (K), D5.1 (K), J1.1, J3.10, Q1.1 (E), Q2.1 (E), Q3.1 (E), Q4.1 (E), R4.1, R9.2, R10.2, R11.2, R12.2, RV1.3, U2.4 (V-), U2.5 (Ref)
GR_L1: J3.1, Q1.3 (C)
GR_L1_s: R5.1
GR_L2: J3.5, Q3.3 (C)
GR_L2_s: R7.1
GR_in1: J3.3
GR_in2: J3.6
LED1: D2.2 (A)
LED2: D3.2 (A)
LED3: D4.2 (A)
LED4: D5.2 (A)
unnamed: C3.1, R3.1, R4.2, RV1.2, U2.3 (+)
unnamed: D6.1 (K), R9.1
unnamed: D6.2 (A), J2.1
unnamed: D7.1 (K), R10.1
unnamed: D7.2 (A), J2.2
unnamed: D8.1 (K), R11.1
unnamed: D8.2 (A), J2.3
unnamed: D9.1 (K), R12.1
unnamed: D9.2 (A), J2.4
unnamed: L1.1, R1.2
unnamed: Q1.2 (B), R5.2
unnamed: Q2.2 (B), R6.2
unnamed: Q3.2 (B), R7.2
unnamed: Q4.2 (B), R8.2
unnamed: R2.1, U2.8 (Rg)
unnamed: R2.2, U2.1 (Rg)
PAGE: J2.5, J3.2
RPi_L: J3.4, Q4.3 (C)
RPi_L_s: R8.1
RTD_L: J3.7, Q2.3 (C)
RTD_L_s: R6.1
RTD_in: J3.8
bridge: C3.2, J1.2, J1.3, U2.2 (-)
output: D1.1 (K), U2.6

Notes on the sheet:
Strain Gauge Amplifier
Indecator Light
Dashboard
