NTURacingTeam/nturt_kicad/EP4/ElectricalGroup/rearbox_nucleo/rearbox_nucleo.kicad_sch

## KiCad design EP4/ElectricalGroup/rearbox_nucleo/rearbox_nucleo.kicad_sch (2023-08-08)

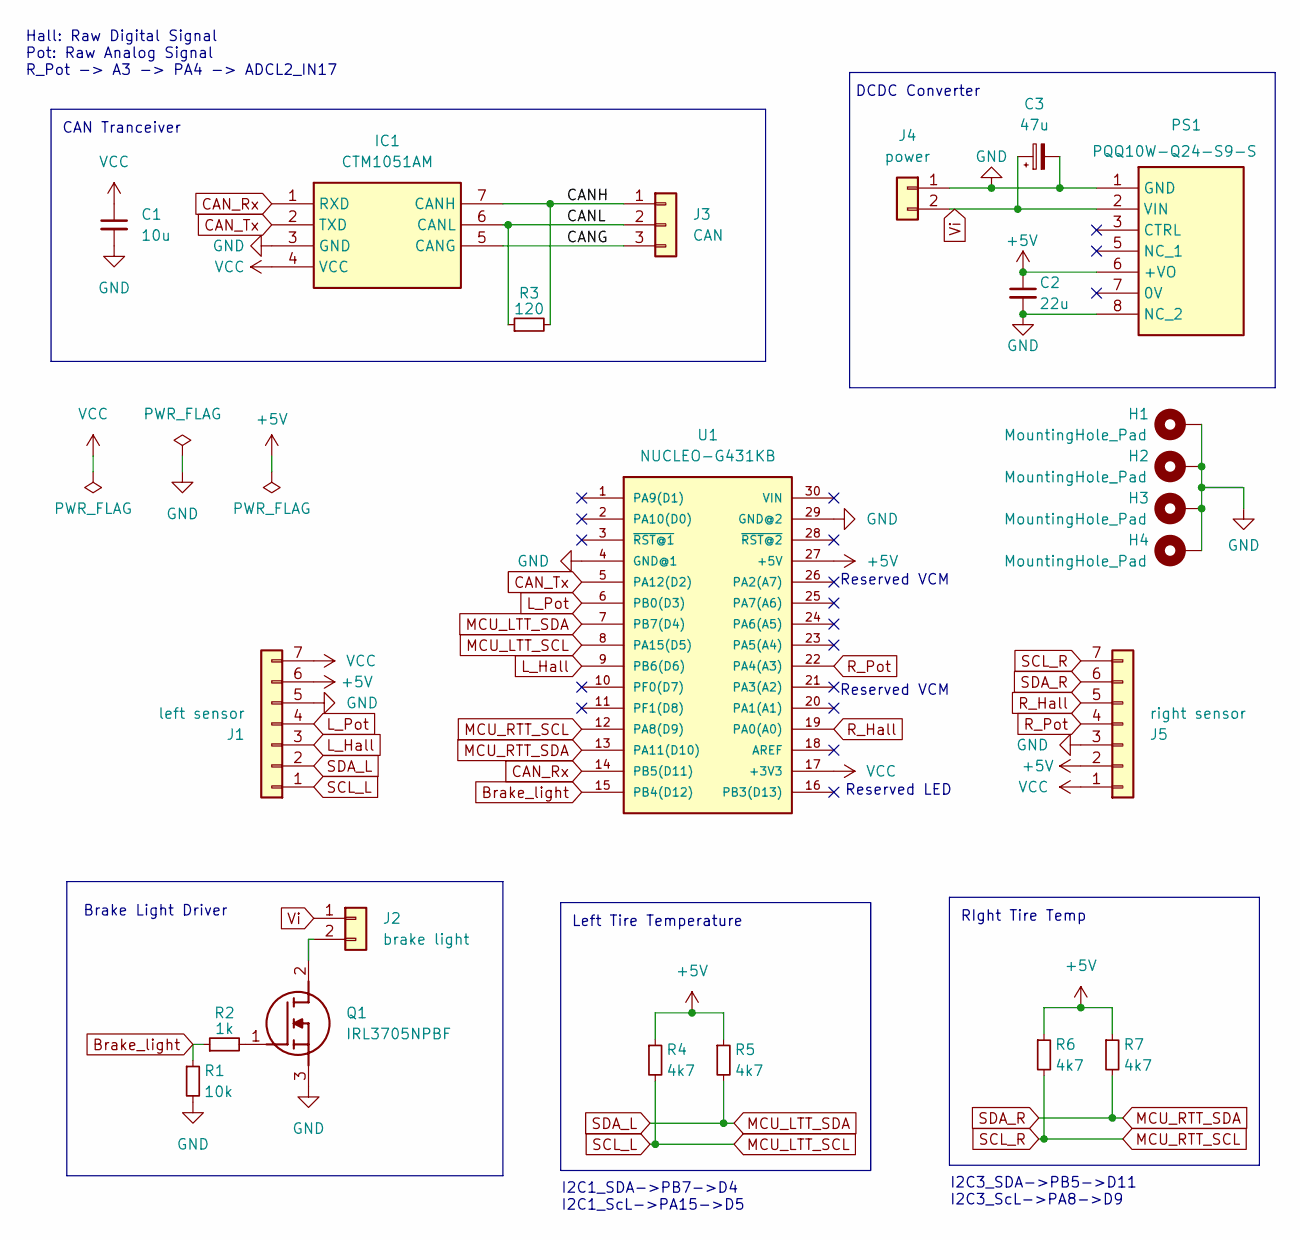
[picture p126: schematic rearbox_nucleo.kicad_sch]

Parts:
C1: 10u; C_0805_2012Metric_Pad1.18x1.45mm_HandSolder
C2: 22u; CP_Radial_D6.3mm_P2.50mm
C3: 47u; CP_Radial_Tantal_D6.0mm_P2.50mm
H1, H2, H3, H4: MountingHole_Pad; MountingHole_2.2mm_M2_DIN965_Pad_TopBottom
IC1: CTM1051AM; Manufacturer_Part_Number CTM1051AM
J1: left sensor; JST_XH_B7B-XH-A_1x07_P2.50mm_Vertical
J2: brake light; JST_XH_B2B-XH-A_1x02_P2.50mm_Vertical
J3: CAN; JST_XH_B3B-XH-A_1x03_P2.50mm_Vertical
J4: power; JST_XH_B2B-XH-A_1x02_P2.50mm_Vertical
J5: right sensor; JST_XH_B7B-XH-A_1x07_P2.50mm_Vertical
PS1: PQQ10W-Q24-S9-S; PQQ10WQ24S9S; Manufacturer_Part_Number PQQ10W-Q24-S9-S
Q1: IRL3705NPBF; TO254P469X1042X1930-3P; Manufacturer_Part_Number IRL3705NPBF; Mouser Part Number 942-IRL3705NPBF
R1: 10k; R_0603_1608Metric_Pad0.98x0.95mm_HandSolder
R2: 1k; R_0603_1608Metric_Pad0.98x0.95mm_HandSolder
R3: 120; R_1206_3216Metric_Pad1.30x1.75mm_HandSolder
R4, R5, R6, R7: 4k7; R_0603_1608Metric_Pad0.98x0.95mm_HandSolder
U1: NUCLEO-G431KB; MANUFACTURER_PART_NUMBER NUCLEO-F303K8

Connections:
+5V: C2.1, J1.6, J5.2, PS1.6 (+VO), R4.1, R5.1, R6.1, R7.1, U1.27 (+5V)
Brake_light: R1.1, R2.1, U1.15 (PB4(D12))
CANG: IC1.5 (CANG), J3.3
CANH: IC1.7 (CANH), J3.1, R3.2
CANL: IC1.6 (CANL), J3.2, R3.1
CAN_Rx: IC1.1 (RXD), U1.14 (PB5(D11))
CAN_Tx: IC1.2 (TXD), U1.5 (PA12(D2))
GND: C1.2, C2.2, C3.2, H1.1, H2.1, H3.1, H4.1, IC1.3 (GND), J1.5, J4.1, J5.3, PS1.1 (GND), PS1.8 (NC_2), Q1.3 (S), R1.2, U1.4 (GND@1), U1.29 (GND@2)
L_Hall: J1.3, U1.9 (PB6(D6))
L_Pot: J1.4, U1.6 (PB0(D3))
MCU_LTT_SCL: J1.1, R4.2, U1.8 (PA15(D5))
MCU_LTT_SDA: J1.2, R5.2, U1.7 (PB7(D4))
MCU_RTT_SCL: J5.7, R6.2, U1.12 (PA8(D9))
MCU_RTT_SDA: J5.6, R7.2, U1.13 (PA11(D10))
unnamed: J2.2, Q1.2 (D)
unnamed: Q1.1 (G), R2.2
R_Hall: J5.5, U1.19 (PA0(A0))
R_Pot: J5.4, U1.22 (PA4(A3))
VCC: C1.1, IC1.4 (VCC), J1.7, J5.1, U1.17 (+3V3)
Vi: C3.1, J2.1, J4.2, PS1.2 (VIN)

Notes on the sheet:
RIght Tire Temp
Brake Light Driver
I2C3_SDA->PB5->D11 I2C3_ScL->PA8->D9
Reserved VCM
Reserved LED
Left Tire Temperature
I2C1_SDA->PB7->D4 I2C1_ScL->PA15->D5
CAN Tranceiver
Hall: Raw Digital Signal Pot: Raw Analog Signal R_Pot -> A3 -> PA4 -> ADCL2_IN17
DCDC Converter
