NTURacingTeam/nturt_kicad/EP4/HVBox/Discharge/Discharge.kicad_sch

## KiCad design EP4/HVBox/Discharge/Discharge.kicad_sch (2023-08-07)

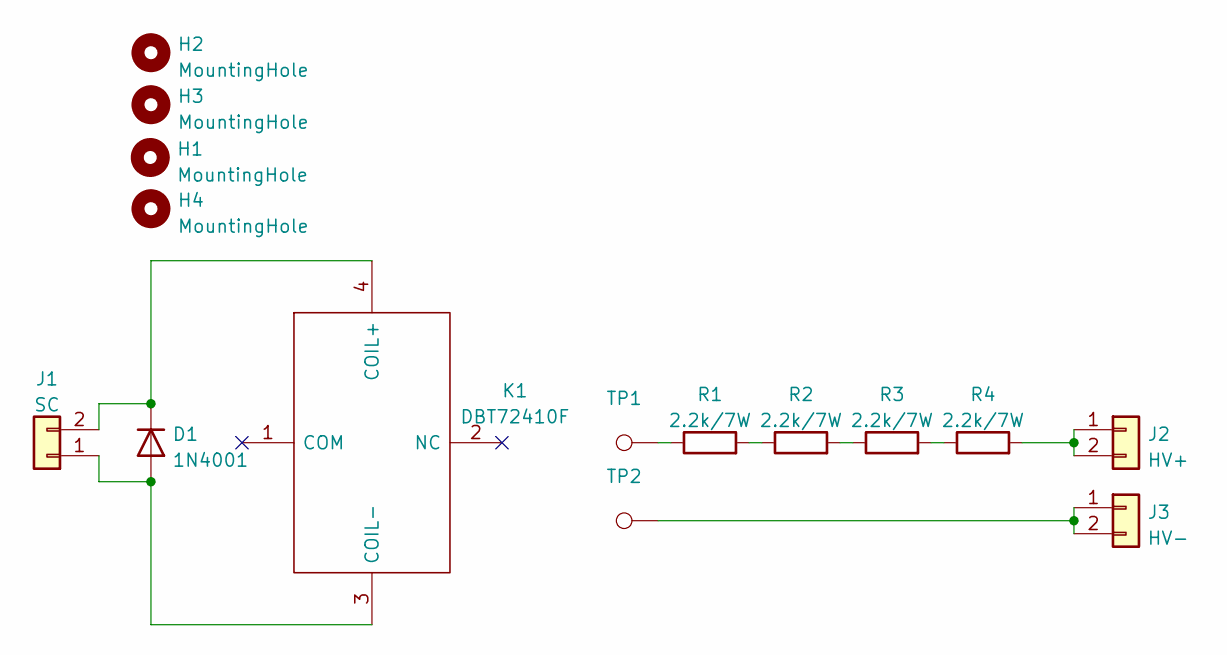
[picture p128: schematic Discharge.kicad_sch]

Parts:
D1: 1N4001; D_DO-41_SOD81_P10.16mm_Horizontal
H1, H2, H3, H4: MountingHole; MountingHole_4.3mm_M4
J1: SC; JST_PH_B2B-PH-K_1x02_P2.00mm_Vertical
J2: HV+; DF33C2P33DSA24
J3: HV-; DF33C2P33DSA24
K1: DBT72410F; DBT72410; Manufacturer_Part_Number DBT72410
R1, R2, R3, R4: 2.2k/7W; RESM24595X990N
TP1, TP2: TestPoint_Loop_D2.50mm_Drill1.0mm

Connections:
unnamed: D1.1 (K), J1.2, K1.4 (COIL+)
unnamed: D1.2 (A), J1.1, K1.3 (COIL-)
unnamed: J2.1, J2.2, R4.2
unnamed: J3.1, J3.2, TP2.1
unnamed: R1.1, TP1.1
unnamed: R1.2, R2.1
unnamed: R2.2, R3.1
unnamed: R3.2, R4.1
