NTURacingTeam/nturt_kicad/EP4/HVBox/HV_DCDC_TSAL_Board_V2_20230311/HV_DCDC_TSAL_Board_V2_20230311.kicad_sch

## KiCad design EP4/HVBox/HV_DCDC_TSAL_Board_V2_20230311/HV_DCDC_TSAL_Board_V2_20230311.kicad_sch (2023-08-07)

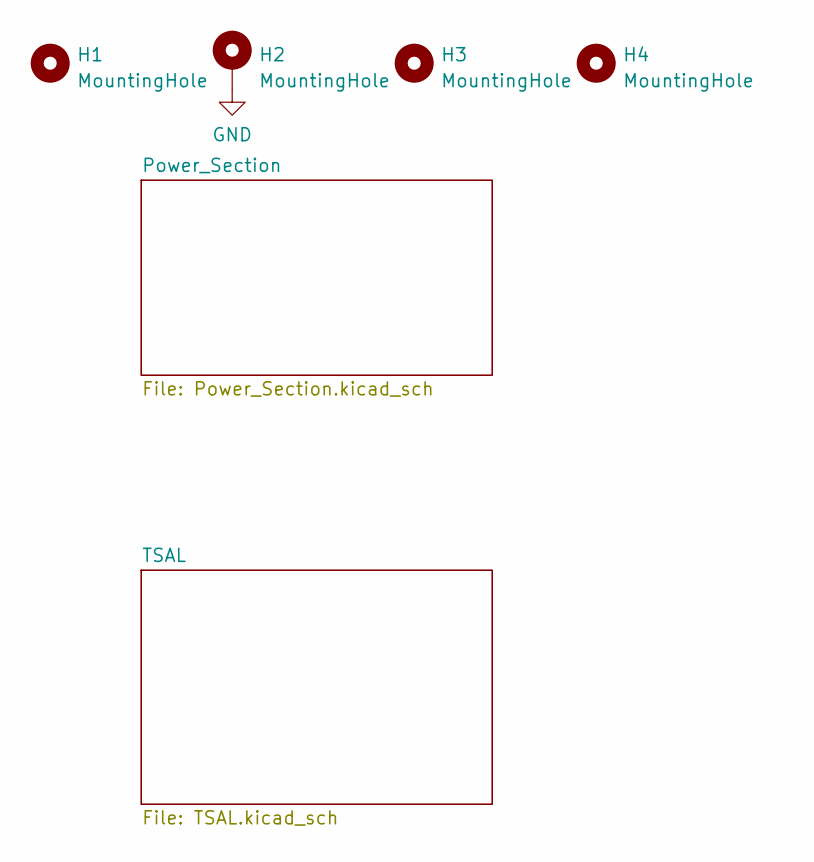
[picture p129: schematic HV_DCDC_TSAL_Board_V2_20230311.kicad_sch]

Parts:
H1, H3, H4: MountingHole; MountingHole_4.3mm_M4
H2: MountingHole; MountingHole_4.3mm_M4_Pad_Via

Connections:
GND: H2.1
