NTURacingTeam/nturt_kicad/EP4/HVBox/HV_DCDC_TSAL_Board_V2_20230311/Power_Section.kicad_sch

## KiCad design EP4/HVBox/HV_DCDC_TSAL_Board_V2_20230311/Power_Section.kicad_sch (2023-08-07)

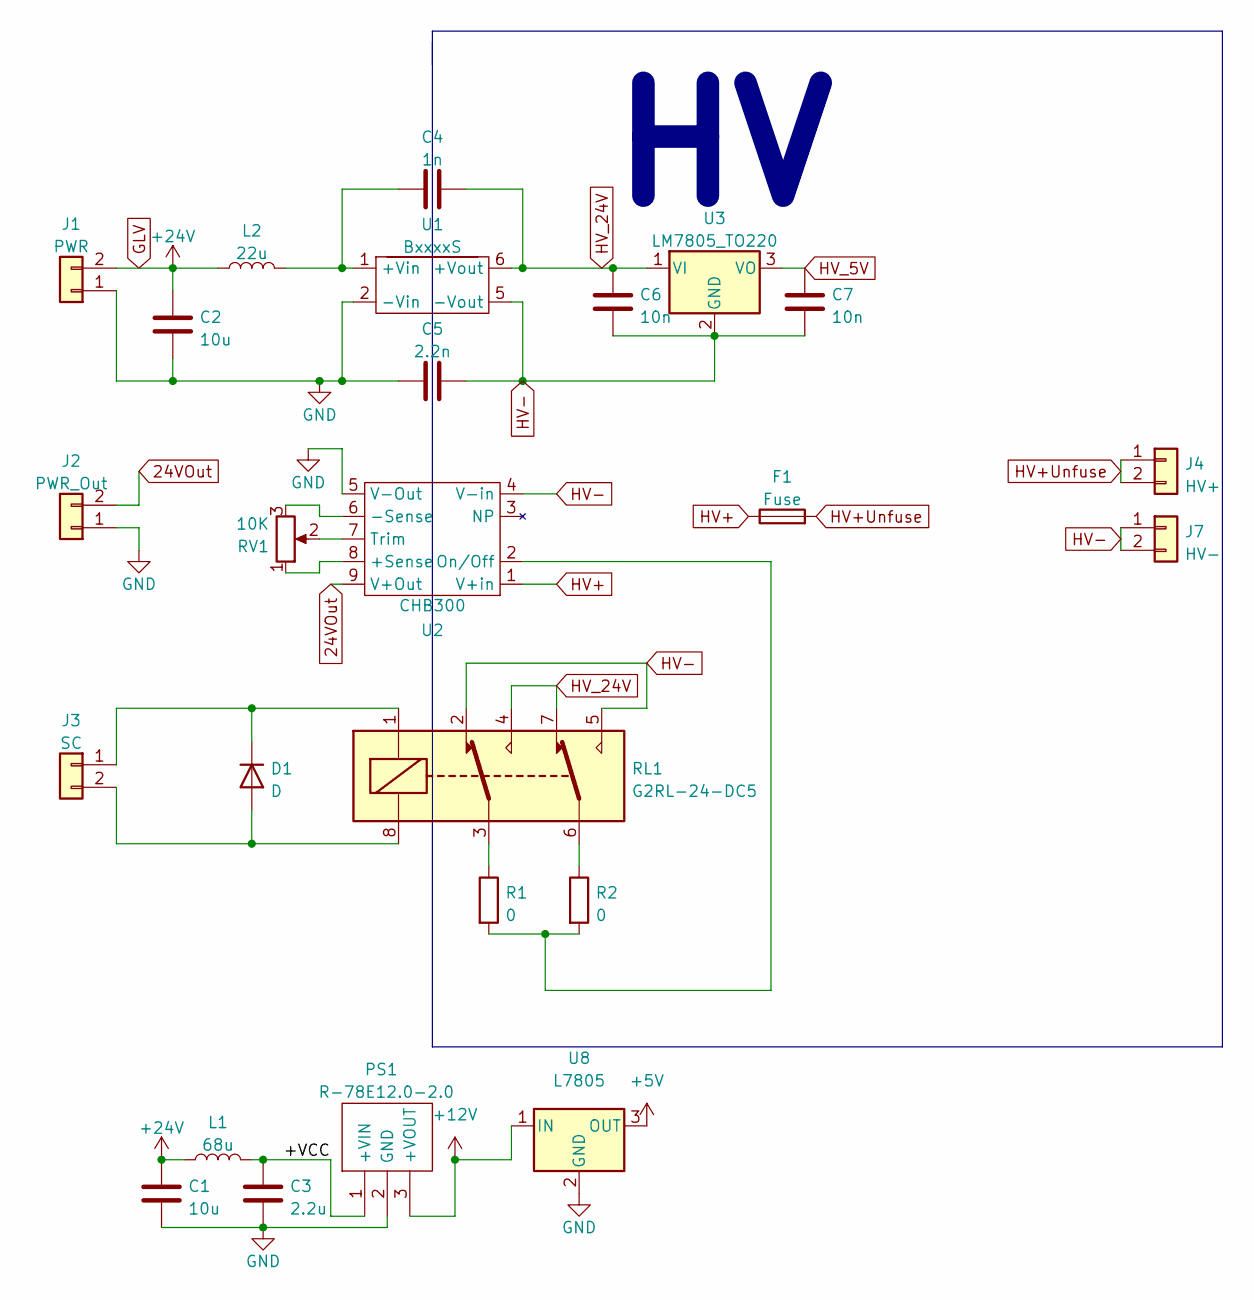
[picture p130: schematic Power_Section.kicad_sch]

Parts:
C1, C2: 10u; C_1206_3216Metric_Pad1.33x1.80mm_HandSolder
C3: 2.2u; C_1206_3216Metric_Pad1.33x1.80mm_HandSolder
C4: 1n; C_Axial_L5.1mm_D3.1mm_P15.00mm_Horizontal
C5: 2.2n; C_Axial_L5.1mm_D3.1mm_P15.00mm_Horizontal
C6, C7: 10n; C_Disc_D4.7mm_W2.5mm_P5.00mm
D1: D; D_DO-41_SOD81_P10.16mm_Horizontal
F1: Fuse; 65600001009
J1: PWR; JST_PH_B2B-PH-K_1x02_P2.00mm_Vertical
J2: PWR_Out; DF63M2P396DSA01
J3: SC; JST_PH_B2B-PH-K_1x02_P2.00mm_Vertical
J4: HV+; DF33C2P33DSA24
J7: HV-; DF33C2P33DSA24
L1: 68u; RLS686
L2: 22u; RLS226R
PS1: R-78E12.0-2.0; R78E5010; Mouser Part Number 919-R-78E5.0-1.0
R1, R2: 0; R_Axial_DIN0309_L9.0mm_D3.2mm_P12.70mm_Horizontal
RL1: G2RL-24-DC5; Relay_DPDT_Omron_G2RL
RV1: 10K; Potentiometer_Vishay_T73YP_Vertical
U1: BxxxxS; RB2424S
U2: CHB300; CHB300W48S12
U3: LM7805_TO220; TO-220-3_Vertical
U8: L7805; TO-220-3_Vertical

Connections:
24VOut: J2.2, U2.9 (V+Out)
+5V: U8.3 (OUT)
+12V: PS1.3 (+VOUT), U8.1 (IN)
+24V: C1.1, C2.1, J1.2, L1.1, L2.1
+VCC: C3.1, L1.2, PS1.1 (+VIN)
GND: C1.2, C2.2, C3.2, C5.1, J1.1, J2.1, PS1.2 (GND), U1.2 (-Vin), U2.5 (V-Out), U8.2 (GND)
HV+: F1.1, U2.1 (V+in)
HV+Unfuse: F1.2, J4.1, J4.2
HV-: C5.2, C6.2, C7.2, J7.1, J7.2, RL1.2, RL1.5, U1.5 (-Vout), U2.4 (V-in), U3.2 (GND)
HV_5V: C7.1, U3.3 (VO)
HV_24V: C4.2, C6.1, RL1.4, RL1.7, U1.6 (+Vout), U3.1 (VI)
unnamed: C4.1, L2.2, U1.1 (+Vin)
unnamed: D1.1 (K), J3.1, RL1.1
unnamed: D1.2 (A), J3.2, RL1.8
unnamed: R1.1, RL1.3
unnamed: R1.2, R2.2, U2.2 (On/Off)
unnamed: R2.1, RL1.6
unnamed: RV1.1, U2.8 (+Sense)
unnamed: RV1.2, U2.7 (Trim)
unnamed: RV1.3, U2.6 (-Sense)
