NTURacingTeam/nturt_kicad/EP4/HVBox/HV_DCDC_TSAL_Board_V2_20230311/TSAL.kicad_sch

## KiCad design EP4/HVBox/HV_DCDC_TSAL_Board_V2_20230311/TSAL.kicad_sch (2023-08-07)

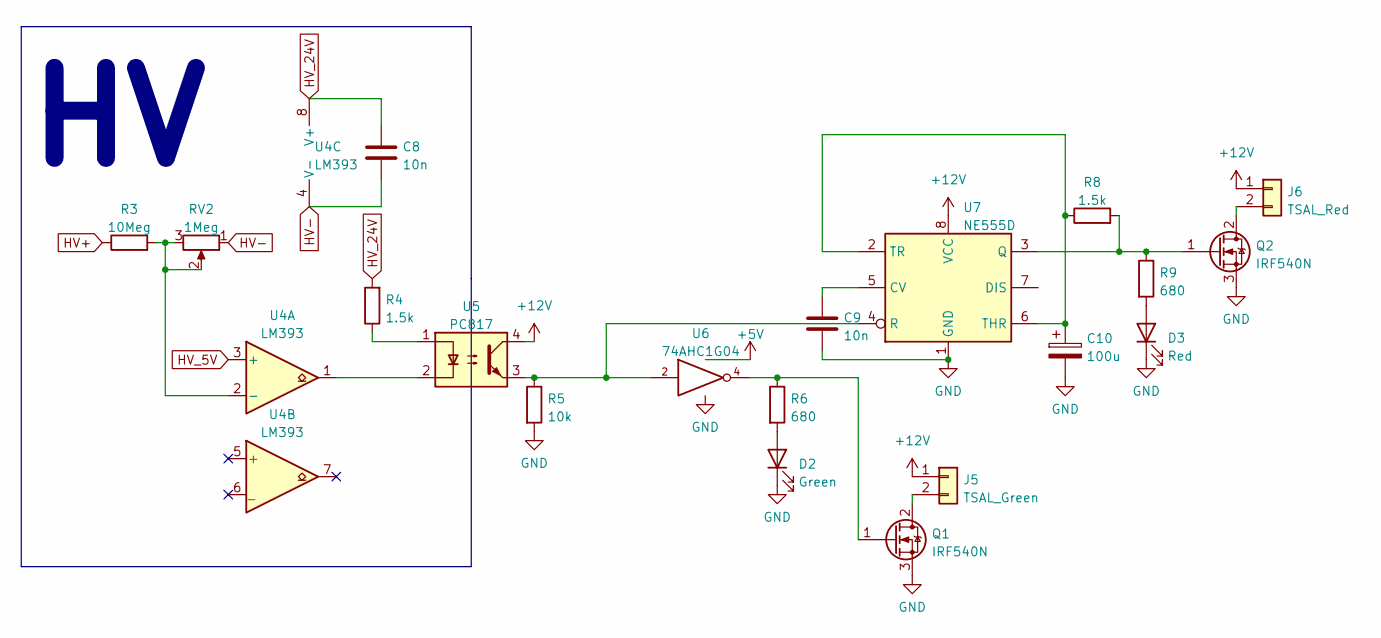
[picture p131: schematic TSAL.kicad_sch]

Parts:
C8: 10n; C_Disc_D4.7mm_W2.5mm_P5.00mm
C9: 10n; C_1206_3216Metric_Pad1.33x1.80mm_HandSolder
C10: 100u; C_1206_3216Metric_Pad1.33x1.80mm_HandSolder
D2: Green; D_1206_3216Metric_Pad1.42x1.75mm_HandSolder
D3: Red; D_1206_3216Metric_Pad1.42x1.75mm_HandSolder
J5: TSAL_Green; JST_PH_B2B-PH-K_1x02_P2.00mm_Vertical
J6: TSAL_Red; JST_PH_B2B-PH-K_1x02_P2.00mm_Vertical
Q1, Q2: IRF540N; TO-220-3_Vertical
R3: 10Meg; R_Axial_DIN0309_L9.0mm_D3.2mm_P15.24mm_Horizontal
R4: 1.5k; R_Axial_DIN0309_L9.0mm_D3.2mm_P12.70mm_Horizontal
R5: 10k; R_1206_3216Metric_Pad1.30x1.75mm_HandSolder
R6, R9: 680; R_1206_3216Metric_Pad1.30x1.75mm_HandSolder
R8: 1.5k; R_1206_3216Metric_Pad1.30x1.75mm_HandSolder
RV2: 1Meg; Potentiometer_Vishay_T73YP_Vertical
U4: LM393; DIP-8_W10.16mm
U5: PC817; DIP-4_W7.62mm
U6: 74AHC1G04; SOT-353_SC-70-5_Handsoldering
U7: NE555D; SOIC-8_3.9x4.9mm_P1.27mm

Connections:
+5V: U6.5 (VCC)
+12V: J5.1, J6.1, U5.4, U7.8 (VCC)
GND: C9.2, C10.2, D2.1 (K), D3.1 (K), Q1.3 (S), Q2.3 (S), R5.2, U6.3 (GND), U7.1 (GND)
HV+: R3.1
HV-: C8.2, RV2.1, U4.4 (V-)
HV_5V: U4.3 (+)
HV_24V: C8.1, R4.2, U4.8 (V+)
unnamed: C9.1, U7.5 (CV)
unnamed: C10.1, R8.1, U7.2 (TR), U7.6 (THR)
unnamed: D2.2 (A), R6.2
unnamed: D3.2 (A), R9.2
unnamed: J5.2, Q1.2 (D)
unnamed: J6.2, Q2.2 (D)
unnamed: Q1.1 (G), R6.1, U6.4
unnamed: Q2.1 (G), R8.2, R9.1, U7.3 (Q)
unnamed: R3.2, RV2.2, RV2.3, U4.2 (-)
unnamed: R4.1, U5.1
unnamed: R5.1, U5.3, U6.2, U7.4 (R)
unnamed: U4.1, U5.2
