NTURacingTeam/nturt_kicad/EP5/Electrical Group/CANbus_connector_board/CANbus_connector_board.kicad_sch

## KiCad design EP5/Electrical Group/CANbus_connector_board/CANbus_connector_board.kicad_sch (2024-07-04)

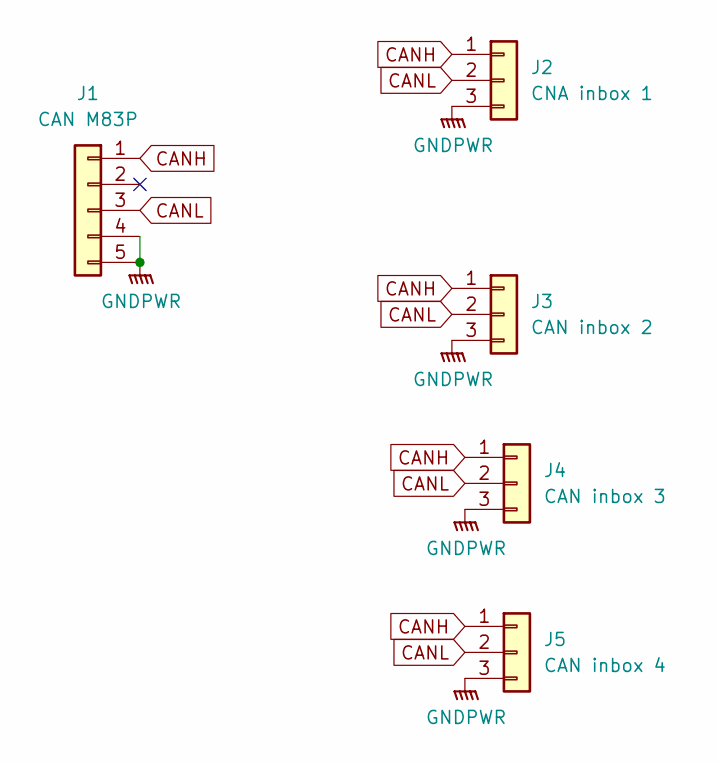
[picture p132: schematic CANbus_connector_board.kicad_sch]

Parts:
J1: CAN M83P; WP-03F3-09-11
J2: CNA inbox 1; JST_XH_S3B-XH-A_1x03_P2.50mm_Horizontal
J3: CAN inbox 2; JST_XH_S3B-XH-A_1x03_P2.50mm_Horizontal
J4: CAN inbox 3; JST_XH_S3B-XH-A_1x03_P2.50mm_Horizontal
J5: CAN inbox 4; JST_XH_S3B-XH-A_1x03_P2.50mm_Horizontal

Connections:
CANH: J1.1, J2.1, J3.1, J4.1, J5.1
CANL: J1.3, J2.2, J3.2, J4.2, J5.2
GNDPWR: J1.4, J1.5, J2.3, J3.3, J4.3, J5.3
