NTURacingTeam/nturt_kicad/EP5/Electrical Group/DIY_IMU/DIY_IMU.kicad_sch

## KiCad design EP5/Electrical Group/DIY_IMU/DIY_IMU.kicad_sch (2024-07-04)

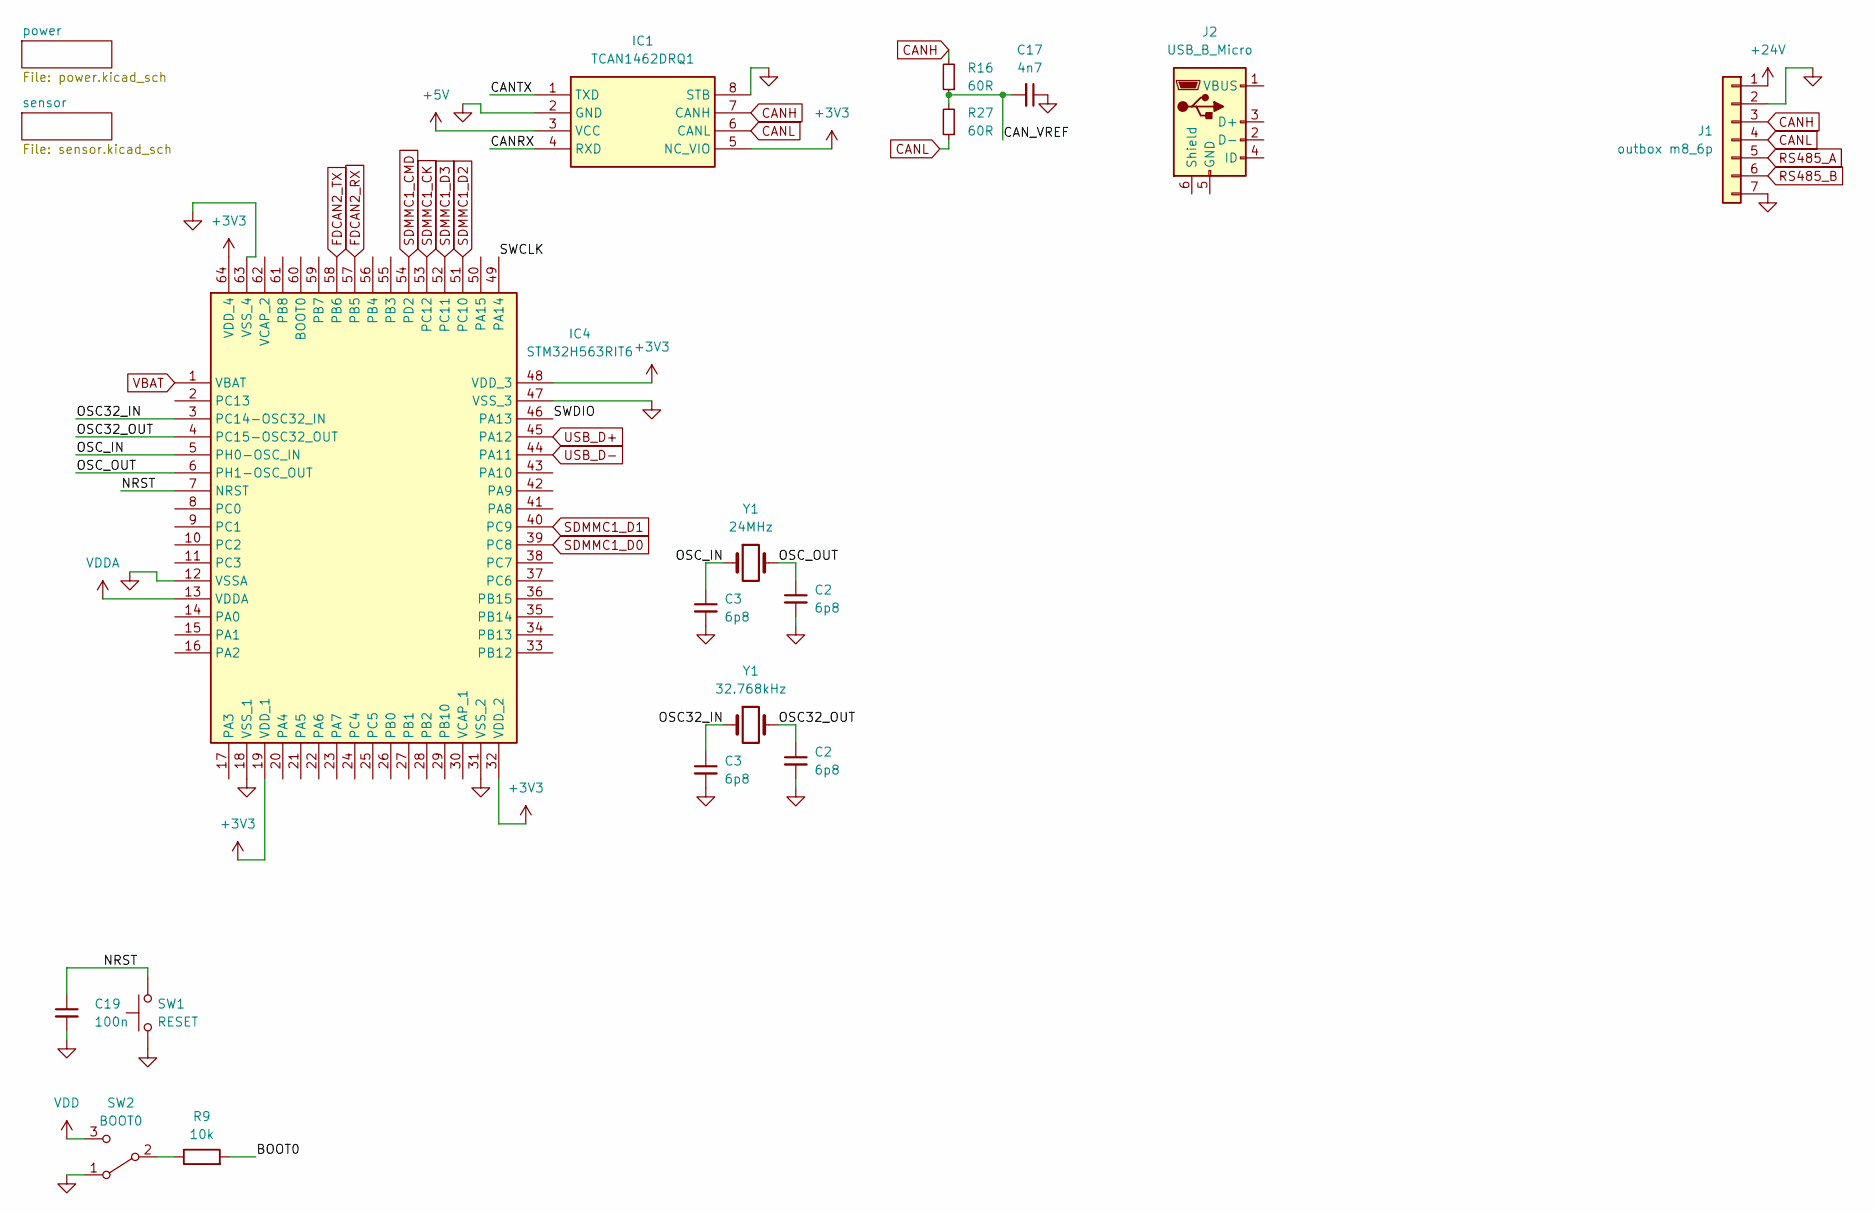
[picture p133: schematic DIY_IMU.kicad_sch]

Parts:
C2, C3: 6p8; C_0805_2012Metric
C17: 4n7; C_0805_2012Metric
C19: 100n; C_0603_1608Metric_Pad1.08x0.95mm_HandSolder
IC1: TCAN1462DRQ1; SOIC127P600X175-8N; Mouser Part Number 595-TCAN1462DRQ1
IC4: STM32H563RIT6; QFP50P1200X1200X160-64N; Mouser Part Number 511-STM32H563RIT6
J1: outbox m8_6p; WP-06F3-09-11
J2: USB_B_Micro
R9: 10k; R_0603_1608Metric_Pad0.98x0.95mm_HandSolder
R16, R27: 60R; R_0805_2012Metric
SW1: RESET; SW_Tactile_SPST_NO_Straight_CK_PTS636Sx25SMTRLFS
SW2: BOOT0; PinHeader_1x03_P2.54mm_Vertical
Y1: 32.768kHz; Crystal_HC49-U_Vertical

Connections:
+3V3: IC1.5 (NC_VIO), IC4.19 (VDD_1), IC4.32 (VDD_2), IC4.48 (VDD_3), IC4.64 (VDD_4)
+5V: IC1.3 (VCC)
+24V: J1.1
BOOT0: R9.2
CANH: IC1.7 (CANH), J1.3, R16.2
CANL: IC1.6 (CANL), J1.4, R27.1
CANRX: IC1.4 (RXD)
CANTX: IC1.1 (TXD)
CAN_VREF: C17.2, R16.1, R27.2
FDCAN2_RX: IC4.57 (PB5)
FDCAN2_TX: IC4.58 (PB6)
GND: C2.2, C3.2, C17.1, C19.2, IC1.2 (GND), IC1.8 (STB), IC4.12 (VSSA), IC4.18 (VSS_1), IC4.31 (VSS_2), IC4.47 (VSS_3), IC4.63 (VSS_4), J1.2, J1.7, SW1.1, SW2.1 (A)
NRST: C19.1, IC4.7 (NRST), SW1.2
unnamed: R9.1, SW2.2 (B)
OSC32_IN: C3.1, IC4.3 (PC14-OSC32_IN), Y1.1
OSC32_OUT: C2.1, IC4.4 (PC15-OSC32_OUT), Y1.2
OSC_IN: C3.1, IC4.5 (PH0-OSC_IN), Y1.1
OSC_OUT: C2.1, IC4.6 (PH1-OSC_OUT), Y1.2
RS485_A: J1.5
RS485_B: J1.6
SDMMC1_CK: IC4.53 (PC12)
SDMMC1_CMD: IC4.54 (PD2)
SDMMC1_D0: IC4.39 (PC8)
SDMMC1_D1: IC4.40 (PC9)
SDMMC1_D2: IC4.51 (PC10)
SDMMC1_D3: IC4.52 (PC11)
SWCLK: IC4.49 (PA14)
SWDIO: IC4.46 (PA13)
USB_D+: IC4.45 (PA12)
USB_D-: IC4.44 (PA11)
VBAT: IC4.1 (VBAT)
VDD: SW2.3 (C)
VDDA: IC4.13 (VDDA)
