NTURacingTeam/nturt_kicad/EP5/Electrical Group/DIY_IMU/power.kicad_sch

## KiCad design EP5/Electrical Group/DIY_IMU/power.kicad_sch (2024-07-04)

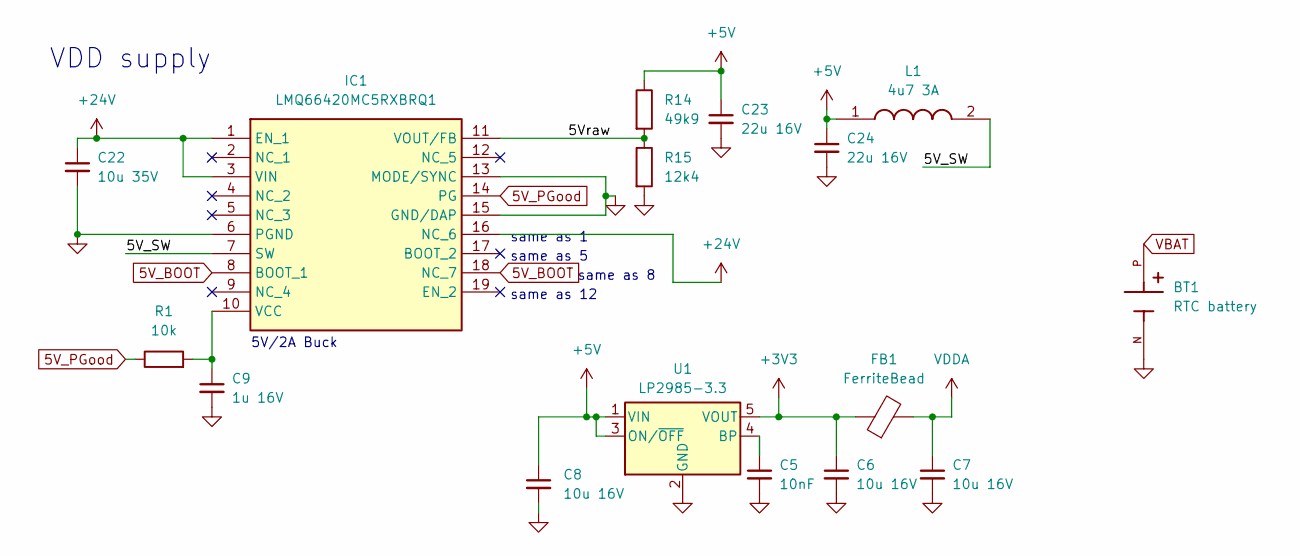
[picture p134: schematic power.kicad_sch]

Parts:
BT1: RTC battery; BAT_1056; PARTREV D
C5: 10nF; C_0805_2012Metric
C6, C7, C8: 10u 16V; C_1206_3216Metric
C9: 1u 16V; C_0805_2012Metric
C22: 10u 35V; C_1206_3216Metric
C23, C24: 22u 16V; C_1206_3216Metric
FB1: FerriteBead; L_0805_2012Metric
IC1: LMQ66420MC5RXBRQ1; LMR66430R5RXBR; Manufacturer_Part_Number LMQ66420MC5RXBRQ1; Mouser Part Number 595-MQ66420MC5RXBRQ1
L1: 4u7 3A; INDPM5552X300N; Mouser Part Number 652-SRP5030WA-2R2M
R1: 10k; R_0603_1608Metric
R14: 49k9; R_0603_1608Metric
R15: 12k4; R_0603_1608Metric
U1: LP2985-3.3; SOT-23-5

Connections:
5V_BOOT: IC1.8 (BOOT_1), IC1.18 (NC_7)
5V_PGood: IC1.14 (PG), R1.1
5V_SW: IC1.7 (SW), L1.2
5Vraw: IC1.11 (VOUT/FB), R14.2, R15.1
+3V3: C6.1, FB1.1, U1.5 (VOUT)
+5V: C8.1, C23.1, C24.1, L1.1, R14.1, U1.1 (VIN), U1.3 (ON/~OFF)
+24V: C22.1, IC1.1 (EN_1), IC1.3 (VIN), IC1.16 (NC_6)
GND: BT1.N, C5.2, C6.2, C7.2, C8.2, C9.2, C22.2, C23.2, C24.2, IC1.6 (PGND), IC1.13 (MODE/SYNC), IC1.15 (GND/DAP), R15.2, U1.2 (GND)
unnamed: C5.1, U1.4 (BP)
unnamed: C9.1, IC1.10 (VCC), R1.2
VBAT: BT1.P
VDDA: C7.1, FB1.2

Notes on the sheet:
same as 8
same as 5
VDD supply
same as 1
same as 12
5V/2A Buck
