NTURacingTeam/nturt_kicad/EP5/Electrical Group/DIY_IMU/sensor.kicad_sch

## KiCad design EP5/Electrical Group/DIY_IMU/sensor.kicad_sch (2024-07-04)

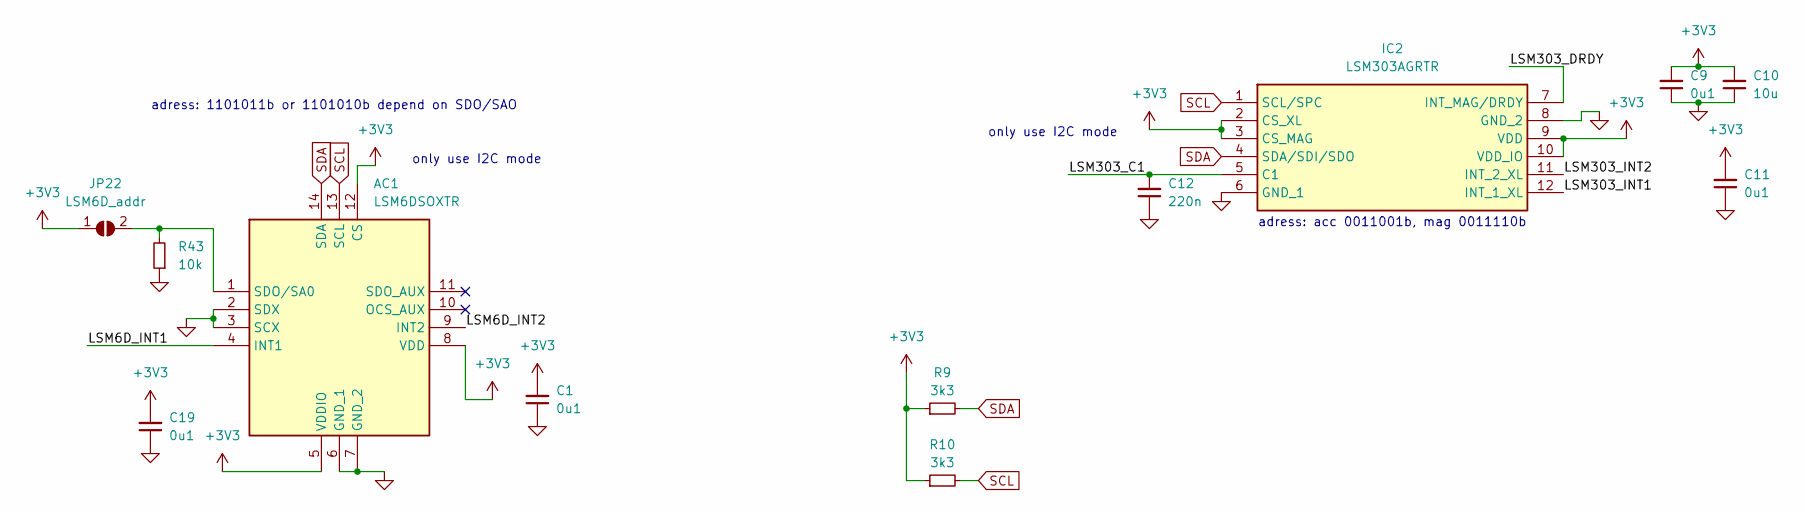
[picture p135: schematic sensor.kicad_sch]

Parts:
AC1: LSM6DSOXTR; LGA-14_1; Mouser Part Number 511-LSM6DSOXTR
C1, C9, C11, C19: 0u1; C_0805_2012Metric
C10: 10u; C_1206_3216Metric
C12: 220n; C_0805_2012Metric
IC2: LSM303AGRTR; LGA-12_2x2mm_P0.5mm; Mouser Part Number 511-LSM303AGRTR
JP22: LSM6D_addr; SolderJumper-2_P1.3mm_Open_RoundedPad1.0x1.5mm
R9, R10: 3k3; R_0603_1608Metric
R43: 10k; R_0603_1608Metric

Connections:
+3V3: AC1.5 (VDDIO), AC1.8 (VDD), AC1.12 (CS), C1.2, C9.2, C10.2, C11.2, C19.2, IC2.2 (CS_XL), IC2.3 (CS_MAG), IC2.9 (VDD), IC2.10 (VDD_IO), JP22.1 (A), R9.1, R10.1
GND: AC1.2 (SDX), AC1.3 (SCX), AC1.6 (GND_1), AC1.7 (GND_2), C1.1, C9.1, C10.1, C11.1, C12.1, C19.1, IC2.6 (GND_1), IC2.8 (GND_2), R43.1
LSM6D_INT1: AC1.4 (INT1)
LSM6D_INT2: AC1.9 (INT2)
LSM303_C1: C12.2, IC2.5 (C1)
LSM303_DRDY: IC2.7 (INT_MAG/DRDY)
LSM303_INT1: IC2.12 (INT_1_XL)
LSM303_INT2: IC2.11 (INT_2_XL)
unnamed: AC1.1 (SDO/SA0), JP22.2 (B), R43.2
SCL: AC1.13 (SCL), IC2.1 (SCL/SPC), R10.2
SDA: AC1.14 (SDA), IC2.4 (SDA/SDI/SDO), R9.2

Notes on the sheet:
only use I2C mode
adress: acc 0011001b, mag 0011110b
adress: 1101011b or 1101010b depend on SDO/SAO
