NTURacingTeam/nturt_kicad/EP5/Electrical Group/EP5 dashboard DIYbox board1/EP5 dashboard DIYbox board1.kicad_sch

## KiCad design EP5/Electrical Group/EP5 dashboard DIYbox board1/EP5 dashboard DIYbox board1.kicad_sch (2024-10-12)

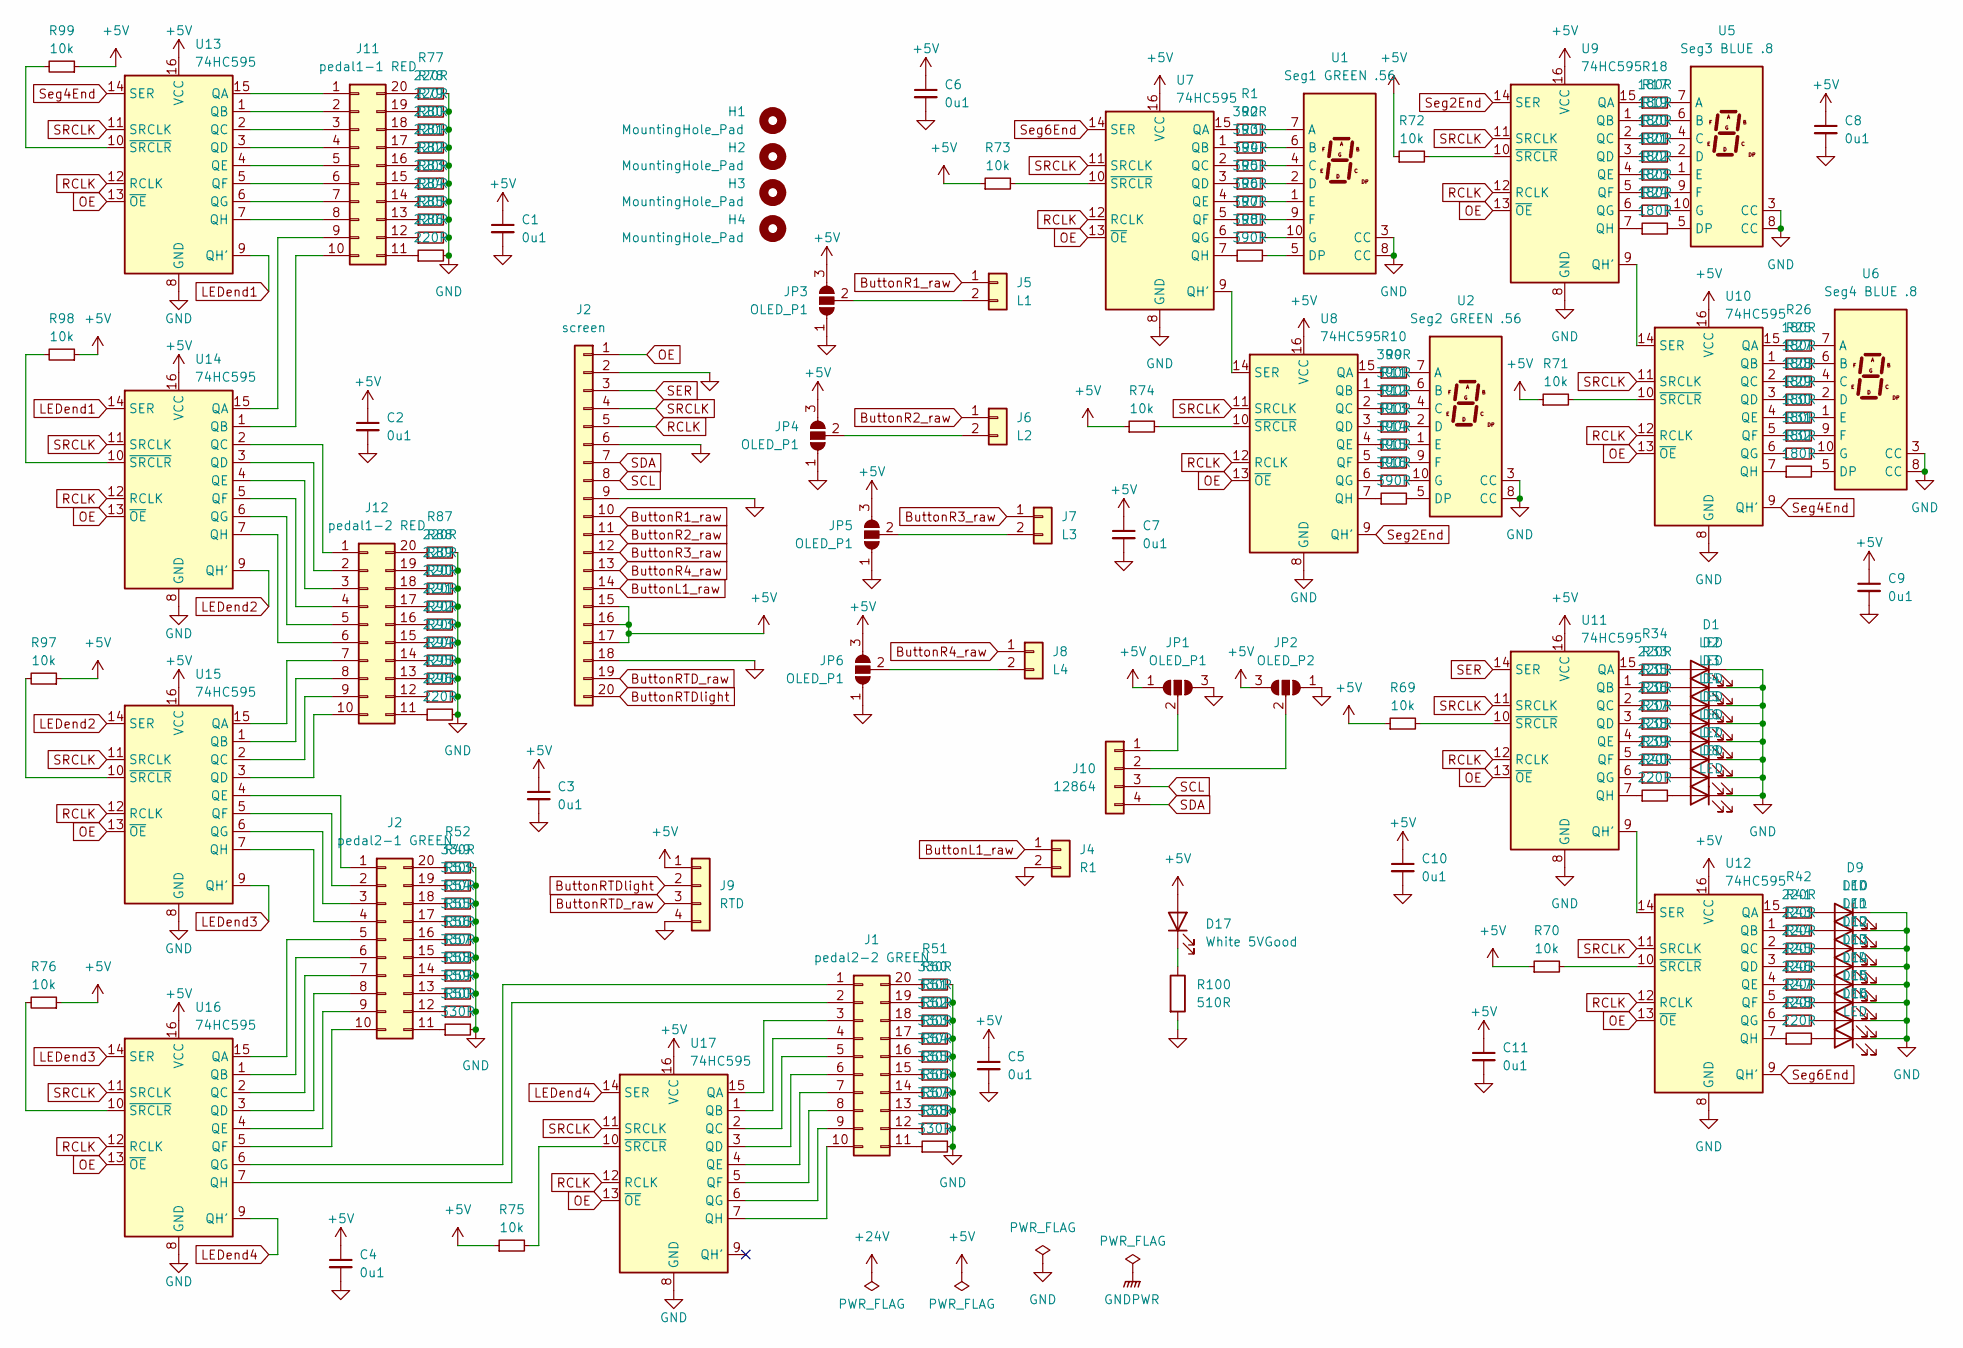
[picture p136: schematic EP5 dashboard DIYbox board1.kicad_sch]

Parts:
C1, C2, C3, C4, C5, C6, C7, C8, C9, C10, C11: 0u1; C_0805_2012Metric
D1, D2, D3, D4, D5, D6, D7, D8, D9, D10, D11, D12, D13, D14, D15, D16: LED; LED_PLCC_2835_Handsoldering
D17: White 5VGood; LED_0603_1608Metric
H1, H2, H3, H4: MountingHole_Pad; MountingHole_3.2mm_M3
J1: pedal2-2 GREEN; DIP-20_W7.62mm
J2: screen; IDC-Header_2x10_P2.54mm_Vertical
J4: R1; JST_XH_S2B-XH-A_1x02_P2.50mm_Horizontal
J5: L1; JST_XH_S2B-XH-A_1x02_P2.50mm_Horizontal
J6: L2; JST_XH_S2B-XH-A_1x02_P2.50mm_Horizontal
J7: L3; JST_XH_S2B-XH-A_1x02_P2.50mm_Horizontal
J8: L4; JST_XH_S2B-XH-A_1x02_P2.50mm_Horizontal
J9: RTD; JST_XH_S4B-XH-A_1x04_P2.50mm_Horizontal
J10: 12864; 12864_1.3_I2C
J11: pedal1-1 RED; DIP-20_W7.62mm
J12: pedal1-2 RED; DIP-20_W7.62mm
JP1, JP3, JP4, JP5, JP6: OLED_P1; SolderJumper-3_P1.3mm_Open_RoundedPad1.0x1.5mm
JP2: OLED_P2; SolderJumper-3_P1.3mm_Open_RoundedPad1.0x1.5mm
R1, R2, R3, R4, R5, R6, R7, R8, R9, R10, R11, R12, R13, R14, R15, R16: 390R; R_0603_1608Metric_Pad0.98x0.95mm_HandSolder
R17, R18, R19, R20, R21, R22, R23, R24, R25, R26, R27, R28, R29, R30, R31, R32: 180R; R_0603_1608Metric_Pad0.98x0.95mm_HandSolder
R33, R34, R35, R36, R37, R38, R39, R40, R41, R42, R43, R44, R45, R46, R47, R48, R77, R78, R79, R80, R81, R82, R83, R84, R85, R86, R87, R88, R89, R90, R91, R92, R93, R94, R95, R96: 220R; R_0603_1608Metric_Pad0.98x0.95mm_HandSolder
R49, R50, R51, R52, R53, R54, R55, R56, R57, R58, R59, R60, R61, R62, R63, R64, R65, R66, R67, R68: 330R; R_0603_1608Metric_Pad0.98x0.95mm_HandSolder
R69, R70, R71, R72, R73, R74, R75, R76, R97, R98, R99: 10k; R_0603_1608Metric
R100: 510R; R_0603_1608Metric
U1: Seg1 GREEN .56; 7SegmentLED_LTS6760_LTS6780
U2: Seg2 GREEN .56; 7SegmentLED_LTS6760_LTS6780
U5: Seg3 BLUE .8; 7SEGMENT-08inch
U6: Seg4 BLUE .8; 7SEGMENT-08inch
U7, U8, U9, U10, U11, U12, U13, U14, U15, U16, U17: 74HC595; SOIC-16_3.9x9.9mm_P1.27mm

Connections:
+5V: C1.1, C2.1, C3.1, C4.1, C5.1, C6.1, C7.1, C8.1, C9.1, C10.1, C11.1, D17.2 (A), J2.15, J2.16, J2.17, J9.1, JP1.1 (A), JP2.3 (B), JP3.3 (B), JP4.3 (B), JP5.3 (B), JP6.3 (B), R69.1, R70.1, R71.1, R72.1, R73.1, R74.1, R75.1, R76.1, R97.1, R98.1, R99.1, U7.16 (VCC), U8.16 (VCC), U9.16 (VCC), U10.16 (VCC), U11.16 (VCC), U12.16 (VCC), U13.16 (VCC), U14.16 (VCC), U15.16 (VCC), U16.16 (VCC), U17.16 (VCC)
ButtonL1_raw: J2.14, J4.1
ButtonR1_raw: J2.10, J5.1
ButtonR2_raw: J2.11, J6.1
ButtonR3_raw: J2.12, J7.1
ButtonR4_raw: J2.13, J8.1
ButtonRTD_raw: J2.19, J9.3
ButtonRTDlight: J2.20, J9.2
GND: C1.2, C2.2, C3.2, C4.2, C5.2, C6.2, C7.2, C8.2, C9.2, C10.2, C11.2, D1.1 (K), D2.1 (K), D3.1 (K), D4.1 (K), D5.1 (K), D6.1 (K), D7.1 (K), D8.1 (K), D9.1 (K), D10.1 (K), D11.1 (K), D12.1 (K), D13.1 (K), D14.1 (K), D15.1 (K), D16.1 (K), J2.2, J2.6, J2.9, J2.18, J4.2, J9.4, JP1.3 (B), JP2.1 (A), JP3.1 (A), JP4.1 (A), JP5.1 (A), JP6.1 (A), R49.2, R50.2, R51.2, R52.2, R53.2, R54.2, R55.2, R56.2, R57.2, R58.2, R59.2, R60.2, R61.2, R62.2, R63.2, R64.2, R65.2, R66.2, R67.2, R68.2, R77.2, R78.2, R79.2, R80.2, R81.2, R82.2, R83.2, R84.2, R85.2, R86.2, R87.2, R88.2, R89.2, R90.2, R91.2, R92.2, R93.2, R94.2, R95.2, R96.2, R100.2, U1.3 (CC), U1.8 (CC), U2.3 (CC), U2.8 (CC), U5.3 (CC), U5.8 (CC), U6.3 (CC), U6.8 (CC), U7.8 (GND), U8.8 (GND), U9.8 (GND), U10.8 (GND), U11.8 (GND), U12.8 (GND), U13.8 (GND), U14.8 (GND), U15.8 (GND), U16.8 (GND), U17.8 (GND)
LEDend1: U13.9 (QH'), U14.14 (SER)
LEDend2: U14.9 (QH'), U15.14 (SER)
LEDend3: U15.9 (QH'), U16.14 (SER)
LEDend4: U16.9 (QH'), U17.14 (SER)
unnamed: D1.2 (A), R34.2
unnamed: D2.2 (A), R33.2
unnamed: D3.2 (A), R35.2
unnamed: D4.2 (A), R36.2
unnamed: D5.2 (A), R37.2
unnamed: D6.2 (A), R38.2
unnamed: D7.2 (A), R39.2
unnamed: D8.2 (A), R40.2
unnamed: D9.2 (A), R42.2
unnamed: D10.2 (A), R41.2
unnamed: D11.2 (A), R43.2
unnamed: D12.2 (A), R44.2
unnamed: D13.2 (A), R45.2
unnamed: D14.2 (A), R46.2
unnamed: D15.2 (A), R47.2
unnamed: D16.2 (A), R48.2
unnamed: D17.1 (K), R100.1
unnamed: J1.1, U16.6 (QG)
unnamed: J1.2, U16.7 (QH)
unnamed: J1.3, U17.15 (QA)
unnamed: J1.4, U17.1 (QB)
unnamed: J1.5, U17.2 (QC)
unnamed: J1.6, U17.3 (QD)
unnamed: J1.7, U17.4 (QE)
unnamed: J1.8, U17.5 (QF)
unnamed: J1.9, U17.6 (QG)
unnamed: J1.10, U17.7 (QH)
unnamed: J1.11, R68.1
unnamed: J1.12, R67.1
unnamed: J1.13, R66.1
unnamed: J1.14, R65.1
unnamed: J1.15, R64.1
unnamed: J1.16, R63.1
unnamed: J1.17, R62.1
unnamed: J1.18, R61.1
unnamed: J1.19, R60.1
unnamed: J1.20, R51.1
unnamed: J2.1, U15.4 (QE)
unnamed: J2.2, U15.5 (QF)
unnamed: J2.3, U15.6 (QG)
unnamed: J2.4, U15.7 (QH)
unnamed: J2.5, U16.15 (QA)
unnamed: J2.6, U16.1 (QB)
unnamed: J2.7, U16.2 (QC)
unnamed: J2.8, U16.3 (QD)
unnamed: J2.9, U16.4 (QE)
unnamed: J2.10, U16.5 (QF)
unnamed: J2.11, R50.1
unnamed: J2.12, R59.1
unnamed: J2.13, R58.1
unnamed: J2.14, R57.1
unnamed: J2.15, R56.1
unnamed: J2.16, R55.1
unnamed: J2.17, R54.1
unnamed: J2.18, R53.1
unnamed: J2.19, R49.1
unnamed: J2.20, R52.1
unnamed: J5.2, JP3.2 (C)
unnamed: J6.2, JP4.2 (C)
unnamed: J7.2, JP5.2 (C)
unnamed: J8.2, JP6.2 (C)
unnamed: J10.1, JP1.2 (C)
unnamed: J10.2, JP2.2 (C)
unnamed: J11.1, U13.15 (QA)
unnamed: J11.2, U13.1 (QB)
unnamed: J11.3, U13.2 (QC)
unnamed: J11.4, U13.3 (QD)
unnamed: J11.5, U13.4 (QE)
unnamed: J11.6, U13.5 (QF)
unnamed: J11.7, U13.6 (QG)
unnamed: J11.8, U13.7 (QH)
unnamed: J11.9, U14.15 (QA)
unnamed: J11.10, U14.1 (QB)
unnamed: J11.11, R86.1
unnamed: J11.12, R85.1
unnamed: J11.13, R84.1
unnamed: J11.14, R83.1
unnamed: J11.15, R82.1
unnamed: J11.16, R81.1
unnamed: J11.17, R80.1
unnamed: J11.18, R79.1
unnamed: J11.19, R78.1
unnamed: J11.20, R77.1
unnamed: J12.1, U14.2 (QC)
unnamed: J12.2, U14.3 (QD)
unnamed: J12.3, U14.4 (QE)
unnamed: J12.4, U14.5 (QF)
unnamed: J12.5, U14.6 (QG)
unnamed: J12.6, U14.7 (QH)
unnamed: J12.7, U15.15 (QA)
unnamed: J12.8, U15.1 (QB)
unnamed: J12.9, U15.2 (QC)
unnamed: J12.10, U15.3 (QD)
unnamed: J12.11, R96.1
unnamed: J12.12, R95.1
unnamed: J12.13, R94.1
unnamed: J12.14, R93.1
unnamed: J12.15, R92.1
unnamed: J12.16, R91.1
unnamed: J12.17, R90.1
unnamed: J12.18, R89.1
unnamed: J12.19, R88.1
unnamed: J12.20, R87.1
unnamed: R1.1, U7.15 (QA)
unnamed: R1.2, U1.7 (A)
unnamed: R2.1, U7.1 (QB)
unnamed: R2.2, U1.6 (B)
unnamed: R3.1, U7.2 (QC)
unnamed: R3.2, U1.4 (C)
unnamed: R4.1, U7.3 (QD)
unnamed: R4.2, U1.2 (D)
unnamed: R5.1, U7.4 (QE)
unnamed: R5.2, U1.1 (E)
unnamed: R6.1, U7.5 (QF)
unnamed: R6.2, U1.9 (F)
unnamed: R7.1, U7.6 (QG)
unnamed: R7.2, U1.10 (G)
unnamed: R8.1, U7.7 (QH)
unnamed: R8.2, U1.5 (DP)
unnamed: R9.1, U8.1 (QB)
unnamed: R9.2, U2.6 (B)
unnamed: R10.1, U8.15 (QA)
unnamed: R10.2, U2.7 (A)
unnamed: R11.1, U8.2 (QC)
unnamed: R11.2, U2.4 (C)
unnamed: R12.1, U8.3 (QD)
unnamed: R12.2, U2.2 (D)
unnamed: R13.1, U8.4 (QE)
unnamed: R13.2, U2.1 (E)
unnamed: R14.1, U8.5 (QF)
unnamed: R14.2, U2.9 (F)
unnamed: R15.1, U8.6 (QG)
unnamed: R15.2, U2.10 (G)
unnamed: R16.1, U8.7 (QH)
unnamed: R16.2, U2.5 (DP)
unnamed: R17.1, U9.1 (QB)
unnamed: R17.2, U5.6 (B)
unnamed: R18.1, U9.15 (QA)
unnamed: R18.2, U5.7 (A)
unnamed: R19.1, U9.2 (QC)
unnamed: R19.2, U5.4 (C)
unnamed: R20.1, U9.3 (QD)
unnamed: R20.2, U5.2 (D)
unnamed: R21.1, U9.4 (QE)
unnamed: R21.2, U5.1 (E)
unnamed: R22.1, U9.5 (QF)
unnamed: R22.2, U5.9 (F)
unnamed: R23.1, U9.6 (QG)
unnamed: R23.2, U5.10 (G)
unnamed: R24.1, U9.7 (QH)
unnamed: R24.2, U5.5 (DP)
unnamed: R25.1, U10.1 (QB)
unnamed: R25.2, U6.6 (B)
unnamed: R26.1, U10.15 (QA)
unnamed: R26.2, U6.7 (A)
unnamed: R27.1, U10.2 (QC)
unnamed: R27.2, U6.4 (C)
unnamed: R28.1, U10.3 (QD)
unnamed: R28.2, U6.2 (D)
unnamed: R29.1, U10.4 (QE)
unnamed: R29.2, U6.1 (E)
unnamed: R30.1, U10.5 (QF)
unnamed: R30.2, U6.9 (F)
unnamed: R31.1, U10.6 (QG)
unnamed: R31.2, U6.10 (G)
unnamed: R32.1, U10.7 (QH)
unnamed: R32.2, U6.5 (DP)
unnamed: R33.1, U11.1 (QB)
unnamed: R34.1, U11.15 (QA)
unnamed: R35.1, U11.2 (QC)
unnamed: R36.1, U11.3 (QD)
unnamed: R37.1, U11.4 (QE)
unnamed: R38.1, U11.5 (QF)
unnamed: R39.1, U11.6 (QG)
unnamed: R40.1, U11.7 (QH)
unnamed: R41.1, U12.1 (QB)
unnamed: R42.1, U12.15 (QA)
unnamed: R43.1, U12.2 (QC)
unnamed: R44.1, U12.3 (QD)
unnamed: R45.1, U12.4 (QE)
unnamed: R46.1, U12.5 (QF)
unnamed: R47.1, U12.6 (QG)
unnamed: R48.1, U12.7 (QH)
unnamed: R69.2, U11.10 (~SRCLR)
unnamed: R70.2, U12.10 (~SRCLR)
unnamed: R71.2, U10.10 (~SRCLR)
unnamed: R72.2, U9.10 (~SRCLR)
unnamed: R73.2, U7.10 (~SRCLR)
unnamed: R74.2, U8.10 (~SRCLR)
unnamed: R75.2, U17.10 (~SRCLR)
unnamed: R76.2, U16.10 (~SRCLR)
unnamed: R97.2, U15.10 (~SRCLR)
unnamed: R98.2, U14.10 (~SRCLR)
unnamed: R99.2, U13.10 (~SRCLR)
unnamed: U7.9 (QH'), U8.14 (SER)
unnamed: U9.9 (QH'), U10.14 (SER)
unnamed: U11.9 (QH'), U12.14 (SER)
OE: J2.1, U7.13 (~OE), U8.13 (~OE), U9.13 (~OE), U10.13 (~OE), U11.13 (~OE), U12.13 (~OE), U13.13 (~OE), U14.13 (~OE), U15.13 (~OE), U16.13 (~OE), U17.13 (~OE)
RCLK: J2.5, U7.12 (RCLK), U8.12 (RCLK), U9.12 (RCLK), U10.12 (RCLK), U11.12 (RCLK), U12.12 (RCLK), U13.12 (RCLK), U14.12 (RCLK), U15.12 (RCLK), U16.12 (RCLK), U17.12 (RCLK)
SCL: J2.8, J10.3
SDA: J2.7, J10.4
SER: J2.3, U11.14 (SER)
SRCLK: J2.4, U7.11 (SRCLK), U8.11 (SRCLK), U9.11 (SRCLK), U10.11 (SRCLK), U11.11 (SRCLK), U12.11 (SRCLK), U13.11 (SRCLK), U14.11 (SRCLK), U15.11 (SRCLK), U16.11 (SRCLK), U17.11 (SRCLK)
Seg2End: U8.9 (QH'), U9.14 (SER)
Seg4End: U10.9 (QH'), U13.14 (SER)
Seg6End: U7.14 (SER), U12.9 (QH')
