NTURacingTeam/nturt_kicad/EP5/Electrical Group/EP5 dashboard DIYbox board2 V3/EP5 dashboard DIYbox board2.kicad_sch

## KiCad design EP5/Electrical Group/EP5 dashboard DIYbox board2 V3/EP5 dashboard DIYbox board2.kicad_sch (2024-10-12)

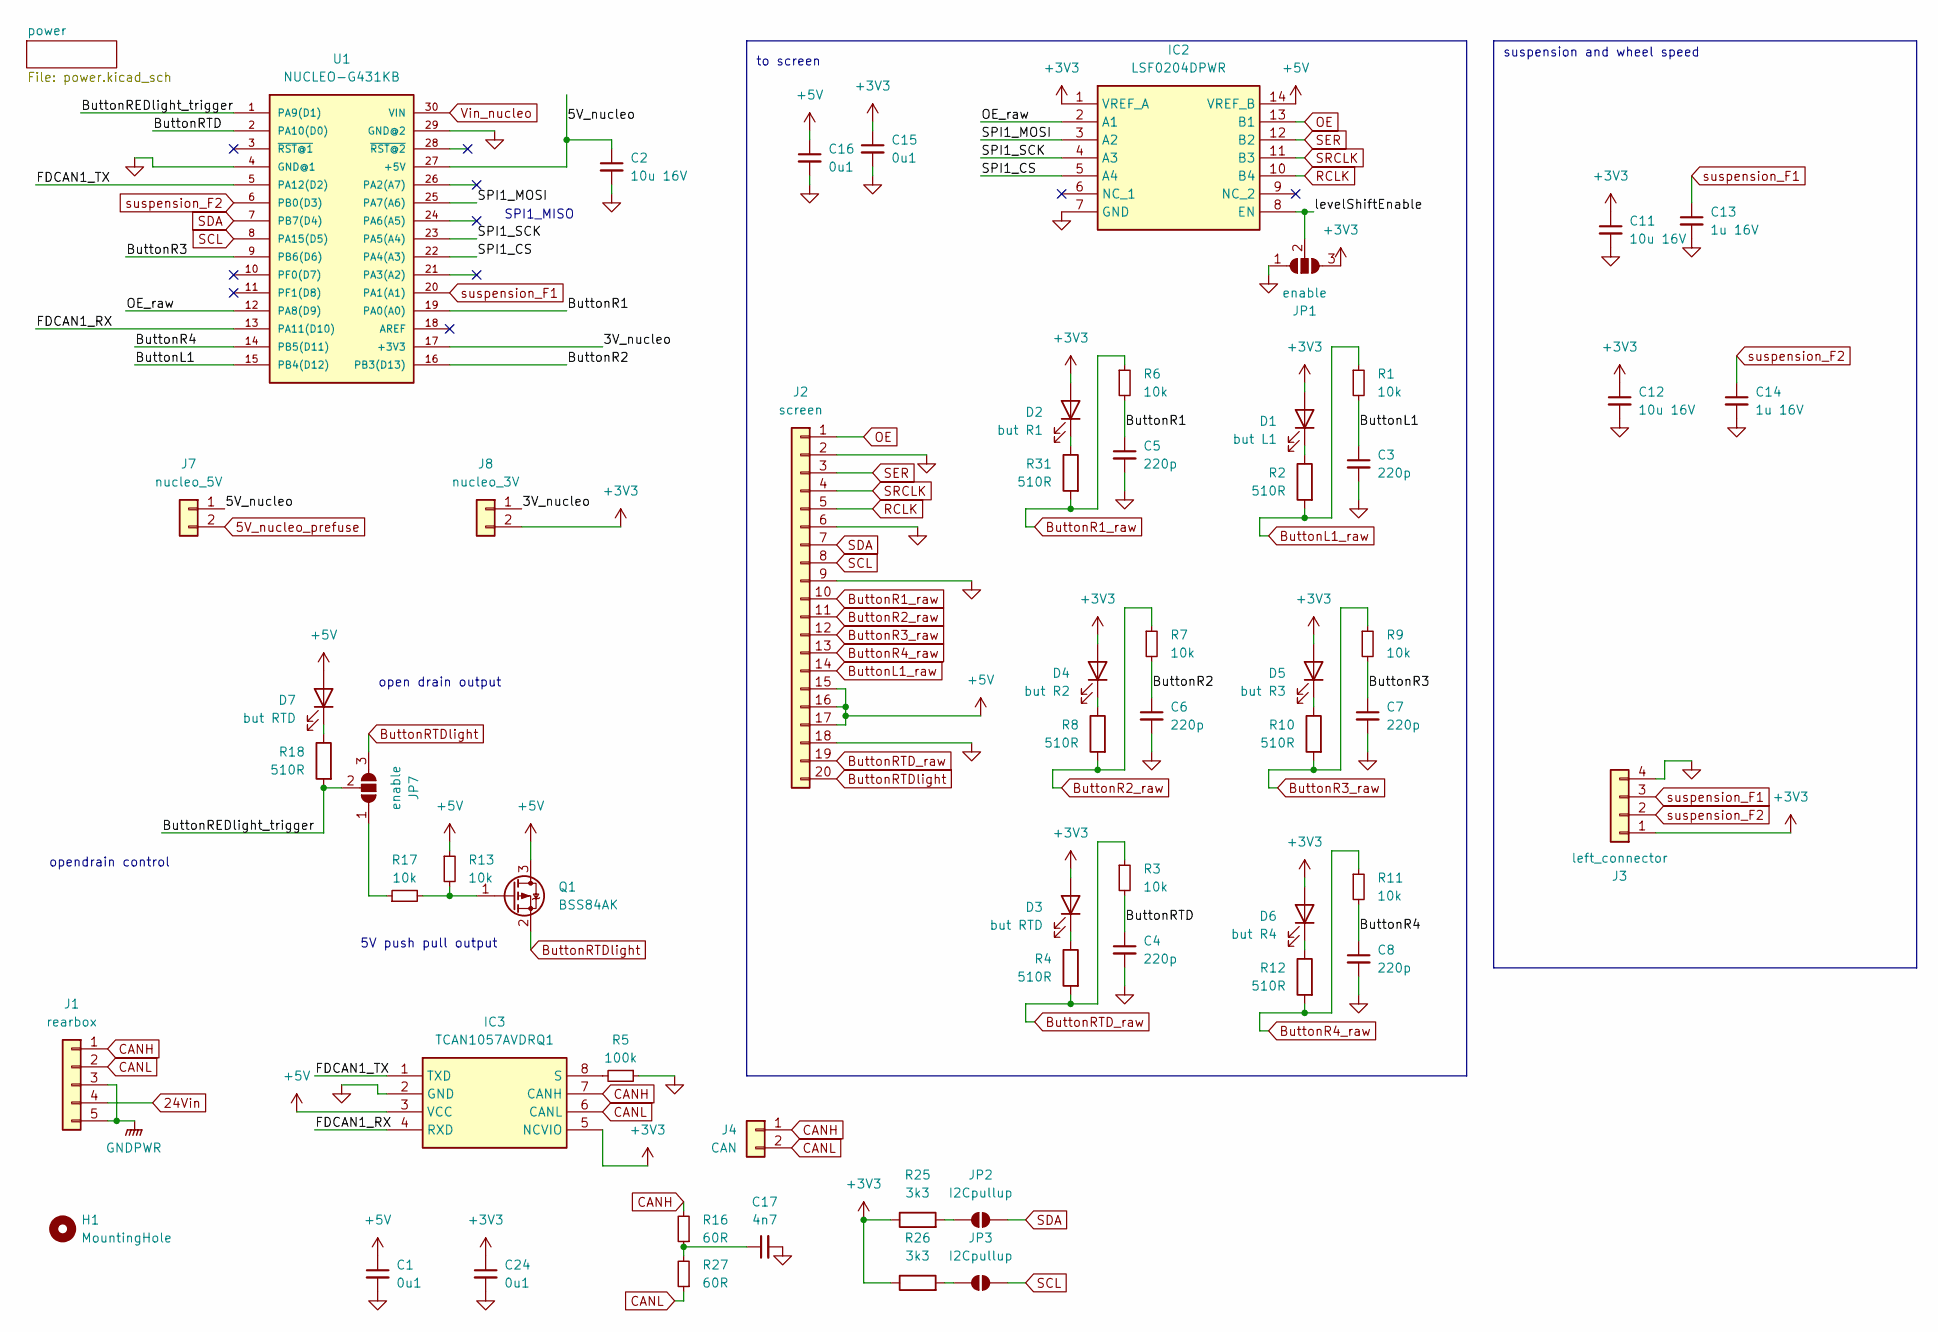
[picture p137: schematic EP5 dashboard DIYbox board2.kicad_sch]

Parts:
C1, C15, C16, C24: 0u1; C_0603_1608Metric
C2, C11, C12: 10u 16V; C_0805_2012Metric
C3, C4, C5, C6, C7, C8: 220p; C_0603_1608Metric
C13, C14: 1u 16V; C_0603_1608Metric
C17: 4n7; C_0603_1608Metric
D1: but L1; LED_0603_1608Metric
D2: but R1; LED_0603_1608Metric
D3, D7: but RTD; LED_0603_1608Metric
D4: but R2; LED_0603_1608Metric
D5: but R3; LED_0603_1608Metric
D6: but R4; LED_0603_1608Metric
H1: MountingHole; MountingHole_4.3mm_M4
IC2: LSF0204DPWR; SOP65P640X120-14N; Mouser Part Number 595-LSF0204DPWR
IC3: TCAN1057AVDRQ1; SOIC127P600X175-8N; Mouser Part Number 595-TCAN1057AVDRQ1
J1: rearbox; WP-04F3-26-11
J2: screen; IDC-Header_2x10_P2.54mm_Vertical
J3: left_connector; JST_XH_S4B-XH-A_1x04_P2.50mm_Horizontal
J4: CAN; PinHeader_1x02_P2.54mm_Vertical
J7: nucleo_5V; PinHeader_1x02_P2.54mm_Vertical
J8: nucleo_3V; PinHeader_1x02_P2.54mm_Vertical
JP1, JP7: enable; SolderJumper-3_P1.3mm_Open_RoundedPad1.0x1.5mm_NumberLabels
JP2, JP3: I2Cpullup; SolderJumper-2_P1.3mm_Open_RoundedPad1.0x1.5mm
Q1: BSS84AK; SOT-23-3
R1, R3, R6, R7, R9, R11, R13, R17: 10k; R_0603_1608Metric
R2, R4, R8, R10, R12, R18, R31: 510R; R_0603_1608Metric
R5: 100k; R_0603_1608Metric
R16, R27: 60R; R_0603_1608Metric
R25, R26: 3k3; R_0603_1608Metric_Pad0.98x0.95mm_HandSolder
U1: NUCLEO-G431KB; MANUFACTURER_PART_NUMBER NUCLEO-F303K8

Connections:
3V_nucleo: J8.1, U1.17 (+3V3)
5V_nucleo: C2.1, J7.1, U1.27 (+5V)
5V_nucleo_prefuse: J7.2
24Vin: J1.4
+3V3: C11.1, C12.1, C15.1, C24.1, D1.2 (A), D2.2 (A), D3.2 (A), D4.2 (A), D5.2 (A), D6.2 (A), IC2.1 (VREF_A), IC3.5 (NCVIO), J3.1, J8.2, JP1.3 (B), R25.1, R26.1
+5V: C1.1, C16.1, D7.2 (A), IC2.14 (VREF_B), IC3.3 (VCC), J2.15, J2.16, J2.17, Q1.3 (D), R13.1
ButtonL1: C3.1, R1.2, U1.15 (PB4(D12))
ButtonL1_raw: J2.14, R1.1, R2.2
ButtonR1: C5.1, R6.2, U1.19 (PA0(A0))
ButtonR1_raw: J2.10, R6.1, R31.2
ButtonR2: C6.1, R7.2, U1.16 (PB3(D13))
ButtonR2_raw: J2.11, R7.1, R8.2
ButtonR3: C7.1, R9.2, U1.9 (PB6(D6))
ButtonR3_raw: J2.12, R9.1, R10.2
ButtonR4: C8.1, R11.2, U1.14 (PB5(D11))
ButtonR4_raw: J2.13, R11.1, R12.2
ButtonREDlight_trigger: JP7.2 (C), R18.2, U1.1 (PA9(D1))
ButtonRTD: C4.1, R3.2, U1.2 (PA10(D0))
ButtonRTD_raw: J2.19, R3.1, R4.2
ButtonRTDlight: J2.20, JP7.3 (B), Q1.2 (S)
CANH: IC3.7 (CANH), J1.1, J4.1, R16.2
CANL: IC3.6 (CANL), J1.2, J4.2, R27.1
FDCAN1_RX: IC3.4 (RXD), U1.13 (PA11(D10))
FDCAN1_TX: IC3.1 (TXD), U1.5 (PA12(D2))
GND: C1.2, C2.2, C3.2, C4.2, C5.2, C6.2, C7.2, C8.2, C11.2, C12.2, C13.2, C14.2, C15.2, C16.2, C17.2, C24.2, IC2.7 (GND), IC3.2 (GND), J2.2, J2.6, J2.9, J2.18, J3.4, JP1.1 (A), R5.1, U1.4 (GND@1), U1.29 (GND@2)
GNDPWR: J1.3, J1.5
unnamed: C17.1, R16.1, R27.2
unnamed: D1.1 (K), R2.1
unnamed: D2.1 (K), R31.1
unnamed: D3.1 (K), R4.1
unnamed: D4.1 (K), R8.1
unnamed: D5.1 (K), R10.1
unnamed: D6.1 (K), R12.1
unnamed: D7.1 (K), R18.1
unnamed: IC3.8 (S), R5.2
unnamed: JP2.1 (A), R25.2
unnamed: JP3.1 (A), R26.2
unnamed: JP7.1 (A), R17.1
unnamed: Q1.1 (G), R13.2, R17.2
OE: IC2.13 (B1), J2.1
OE_raw: IC2.2 (A1), U1.12 (PA8(D9))
RCLK: IC2.10 (B4), J2.5
SCL: J2.8, JP3.2 (B), U1.8 (PA15(D5))
SDA: J2.7, JP2.2 (B), U1.7 (PB7(D4))
SER: IC2.12 (B2), J2.3
SPI1_CS: IC2.5 (A4), U1.22 (PA4(A3))
SPI1_MOSI: IC2.3 (A2), U1.25 (PA7(A6))
SPI1_SCK: IC2.4 (A3), U1.23 (PA5(A4))
SRCLK: IC2.11 (B3), J2.4
Vin_nucleo: U1.30 (VIN)
levelShiftEnable: IC2.8 (EN), JP1.2 (C)
suspension_F1: C13.1, J3.3, U1.20 (PA1(A1))
suspension_F2: C14.1, J3.2, U1.6 (PB0(D3))

Notes on the sheet:
5V push pull output
opendrain control
to screen
SPI1_MISO
suspension and wheel speed
open drain output
