NTURacingTeam/nturt_kicad/EP5/Electrical Group/EP5 dashboard DIYbox board2 V3/power.kicad_sch

## KiCad design EP5/Electrical Group/EP5 dashboard DIYbox board2 V3/power.kicad_sch (2024-10-12)

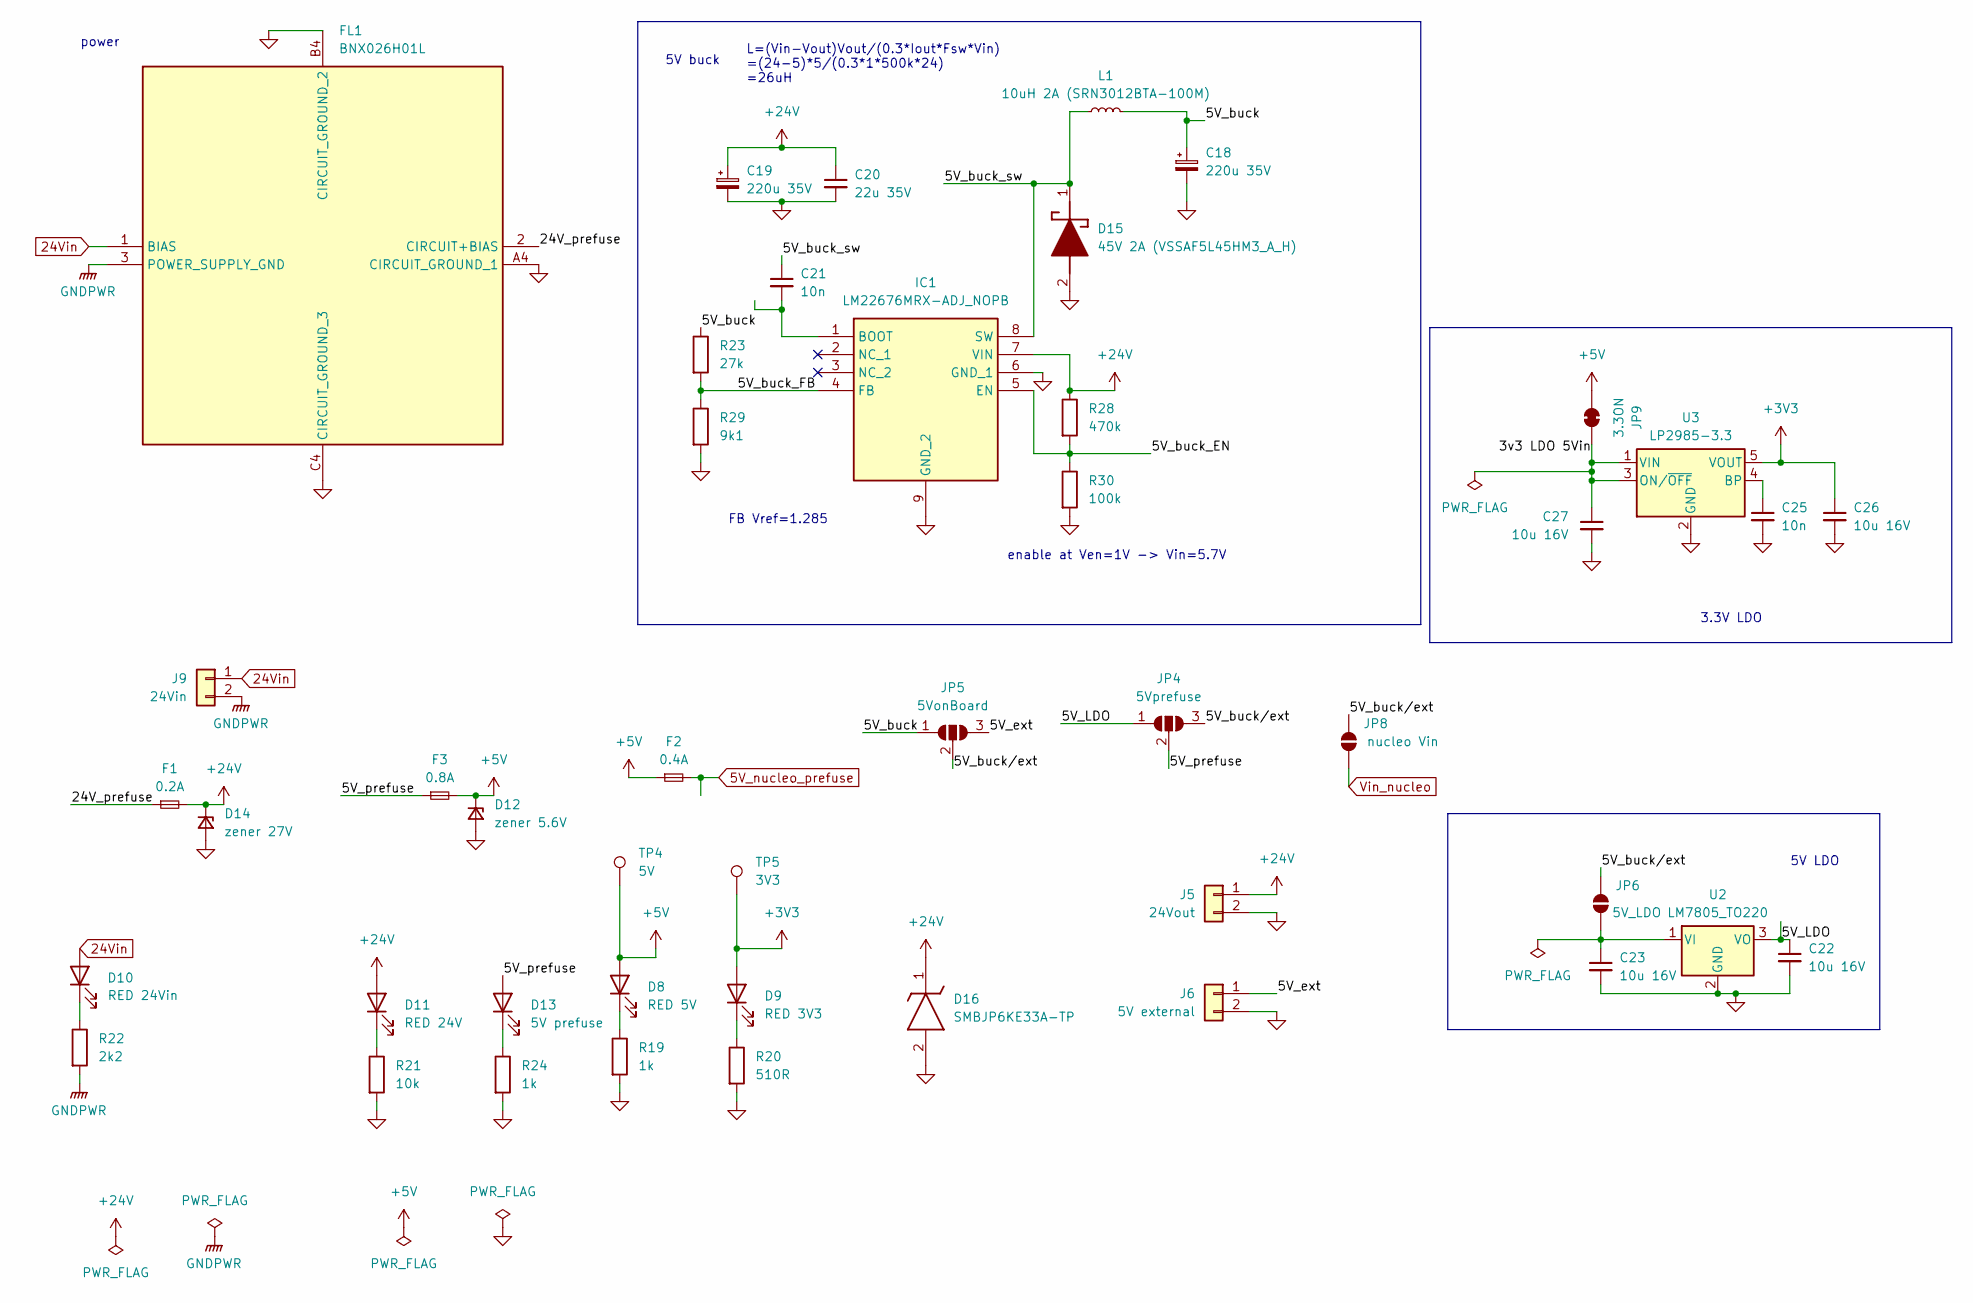
[picture p138: schematic power.kicad_sch]

Parts:
C18, C19: 220u 35V; CP_Radial_D8.0mm_P3.80mm
C20: 22u 35V; C_1206_3216Metric
C21, C25: 10n; C_0603_1608Metric
C22, C23, C26, C27: 10u 16V; C_0805_2012Metric
D8: RED 5V; LED_0603_1608Metric
D9: RED 3V3; LED_0603_1608Metric
D10: RED 24Vin; LED_0603_1608Metric
D11: RED 24V; LED_0603_1608Metric
D12: zener 5.6V; D_MiniMELF
D13: 5V prefuse; LED_0603_1608Metric
D14: zener 27V; D_MiniMELF
D15: 45V 2A (VSSAF5L45HM3_A_H); SODFL5226X100N; Mouser Part Number 78-VSSAF5L45HM3_A/H
D16: SMBJP6KE33A-TP; DIOM5336X262N; Mouser Part Number 833-SMBJP6KE33A-TP
F1: 0.2A; Fuse_2512_6332Metric_Pad1.52x3.35mm_HandSolder
F2: 0.4A; Fuse_2512_6332Metric_Pad1.52x3.35mm_HandSolder
F3: 0.8A; Fuse_2512_6332Metric_Pad1.52x3.35mm_HandSolder
FL1: BNX026H01L; BNX024H01K; Mouser Part Number 81-BNX026H01L
IC1: LM22676MRX-ADJ_NOPB; SOIC127P600X170-9N; Mouser Part Number 926-LM22676MRXADJNPB
J5: 24Vout; PinHeader_1x02_P2.54mm_Vertical
J6: 5V external; JST_XH_B2B-XH-A_1x02_P2.50mm_Vertical
J9: 24Vin; JST_XH_B2B-XH-A_1x02_P2.50mm_Vertical
JP4: 5Vprefuse; SolderJumper-3_P1.3mm_Open_Pad1.0x1.5mm_NumberLabels
JP5: 5VonBoard; SolderJumper-3_P1.3mm_Open_Pad1.0x1.5mm_NumberLabels
JP6: 5V_LDO; SolderJumper-2_P1.3mm_Open_Pad1.0x1.5mm
JP8: nucleo Vin; SolderJumper-2_P1.3mm_Open_Pad1.0x1.5mm
JP9: 3.3ON; SolderJumper-2_P1.3mm_Open_Pad1.0x1.5mm
L1: 10uH 2A (SRN3012BTA-100M); SRN3012BTA100M
R19, R24: 1k; R_0603_1608Metric
R20: 510R; R_0603_1608Metric
R21: 10k; R_0603_1608Metric
R22: 2k2; R_0603_1608Metric
R23: 27k; R_0603_1608Metric
R28: 470k; R_0603_1608Metric
R29: 9k1; R_0603_1608Metric
R30: 100k; R_0603_1608Metric
TP4: 5V; TestPoint_Pad_D1.0mm
TP5: 3V3; TestPoint_Pad_D1.0mm
U2: LM7805_TO220; TO-220-3_Vertical
U3: LP2985-3.3; SOT-23-5

Connections:
3v3 LDO 5Vin: C27.1, JP9.2 (B), U3.1 (VIN), U3.3 (ON/~OFF)
5V_LDO: C22.1, JP4.1 (A), U2.3 (VO)
5V_buck: C18.1, JP5.1 (A), L1.2, R23.1
5V_buck_EN: IC1.5 (EN), R28.2, R30.1
5V_buck_FB: IC1.4 (FB), R23.2, R29.1
5V_buck_sw: C21.1, D15.1 (K), IC1.8 (SW), L1.1
5V_buck/ext: JP4.3 (B), JP5.2 (C), JP6.1 (A), JP8.1 (A)
5V_ext: J6.1, JP5.3 (B)
5V_nucleo_prefuse: F2.2
5V_prefuse: D13.2 (A), F3.1, JP4.2 (C)
24V_prefuse: F1.1, FL1.2 (CIRCUIT+BIAS)
24Vin: D10.2 (A), FL1.1 (BIAS), J9.1
+3V3: C26.1, D9.2 (A), TP5.1, U3.5 (VOUT)
+5V: D8.2 (A), D12.1 (K), F2.1, F3.2, JP9.1 (A), TP4.1
+24V: C19.1, C20.1, D11.2 (A), D14.1 (K), D16.1 (K), F1.2, IC1.7 (VIN), J5.1, R28.1
GND: C18.2, C19.2, C20.2, C22.2, C23.2, C25.2, C26.2, C27.2, D12.2 (A), D14.2 (A), D15.2 (A), D16.2 (A), FL1.A4 (CIRCUIT_GROUND_1), FL1.B4 (CIRCUIT_GROUND_2), FL1.C4 (CIRCUIT_GROUND_3), IC1.6 (GND_1), IC1.9 (GND_2), J5.2, J6.2, R19.2, R20.2, R21.2, R24.2, R29.2, R30.2, U2.2 (GND), U3.2 (GND)
GNDPWR: FL1.3 (POWER_SUPPLY_GND), J9.2, R22.2
unnamed: C21.2, IC1.1 (BOOT)
unnamed: C23.1, JP6.2 (B), U2.1 (VI)
unnamed: C25.1, U3.4 (BP)
unnamed: D8.1 (K), R19.1
unnamed: D9.1 (K), R20.1
unnamed: D10.1 (K), R22.1
unnamed: D11.1 (K), R21.1
unnamed: D13.1 (K), R24.1
Vin_nucleo: JP8.2 (B)

Notes on the sheet:
L=(Vin-Vout)Vout/(0.3*Iout*Fsw*Vin) =(24-5)*5/(0.3*1*500k*24) =26uH
enable at Ven=1V -> Vin=5.7V
5V LDO
5V buck
3.3V LDO
power
FB Vref=1.285
