NTURacingTeam/nturt_kicad/EP5/Electrical Group/EP5 dashboard DIYbox board3/EP5 dashboard DIYbox board3.kicad_sch

## KiCad design EP5/Electrical Group/EP5 dashboard DIYbox board3/EP5 dashboard DIYbox board3.kicad_sch (2024-07-04)

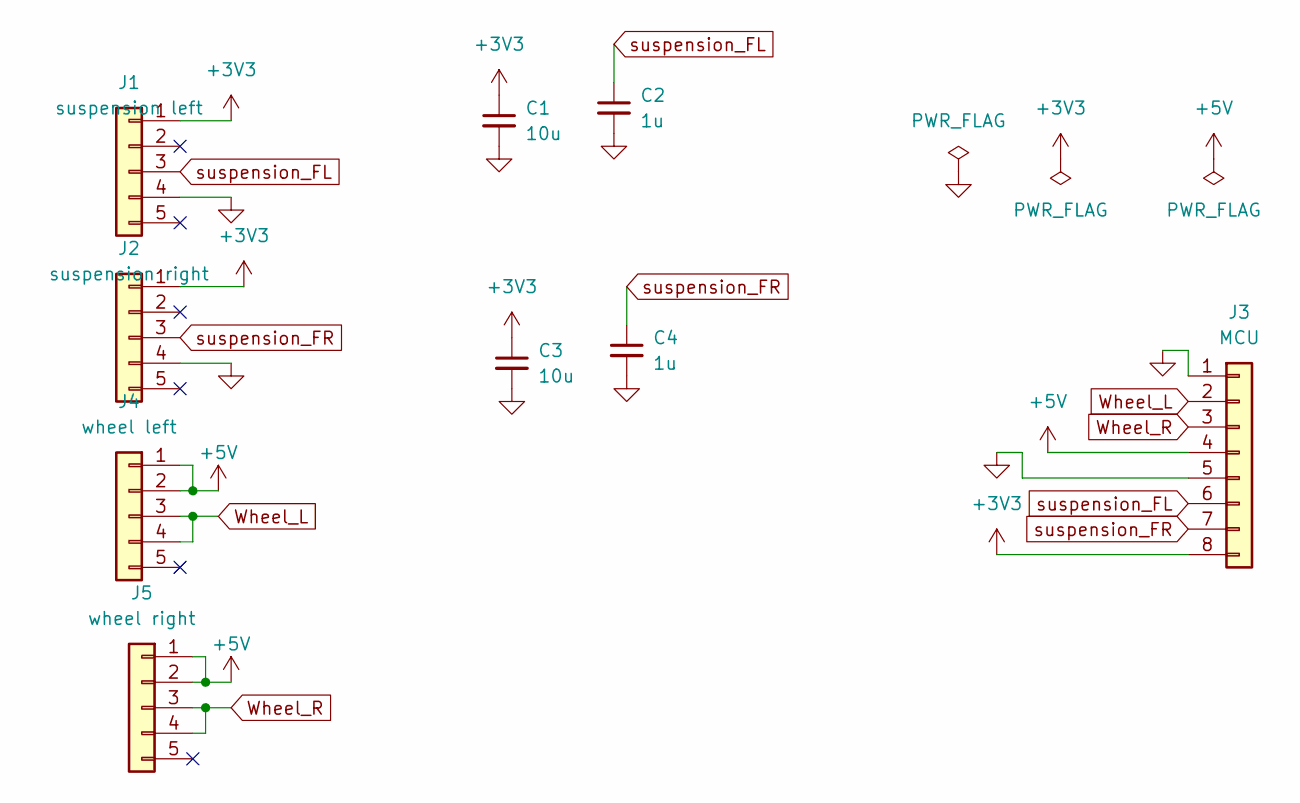
[picture p139: schematic EP5 dashboard DIYbox board3.kicad_sch]

Parts:
C1, C3: 10u; C_0805_2012Metric
C2, C4: 1u; C_0805_2012Metric
J1: suspension left; WP-03F3-09-11
J2: suspension right; WP-03F3-09-11
J3: MCU; JST_XH_S8B-XH-A_1x08_P2.50mm_Horizontal
J4: wheel left; WP-04F3-26-11
J5: wheel right; WP-04F3-26-11

Connections:
+3V3: C1.1, C3.1, J1.1, J2.1, J3.8
+5V: J3.4, J4.1, J4.2, J5.1, J5.2
GND: C1.2, C2.2, C3.2, C4.2, J1.4, J2.4, J3.1, J3.5
Wheel_L: J3.2, J4.3, J4.4
Wheel_R: J3.3, J5.3, J5.4
suspension_FL: C2.1, J1.3, J3.6
suspension_FR: C4.1, J2.3, J3.7
