NTURacingTeam/nturt_kicad/EP5/Electrical Group/LVBMS/LVBMS.kicad_sch

## KiCad design EP5/Electrical Group/LVBMS/LVBMS.kicad_sch (2024-10-12)

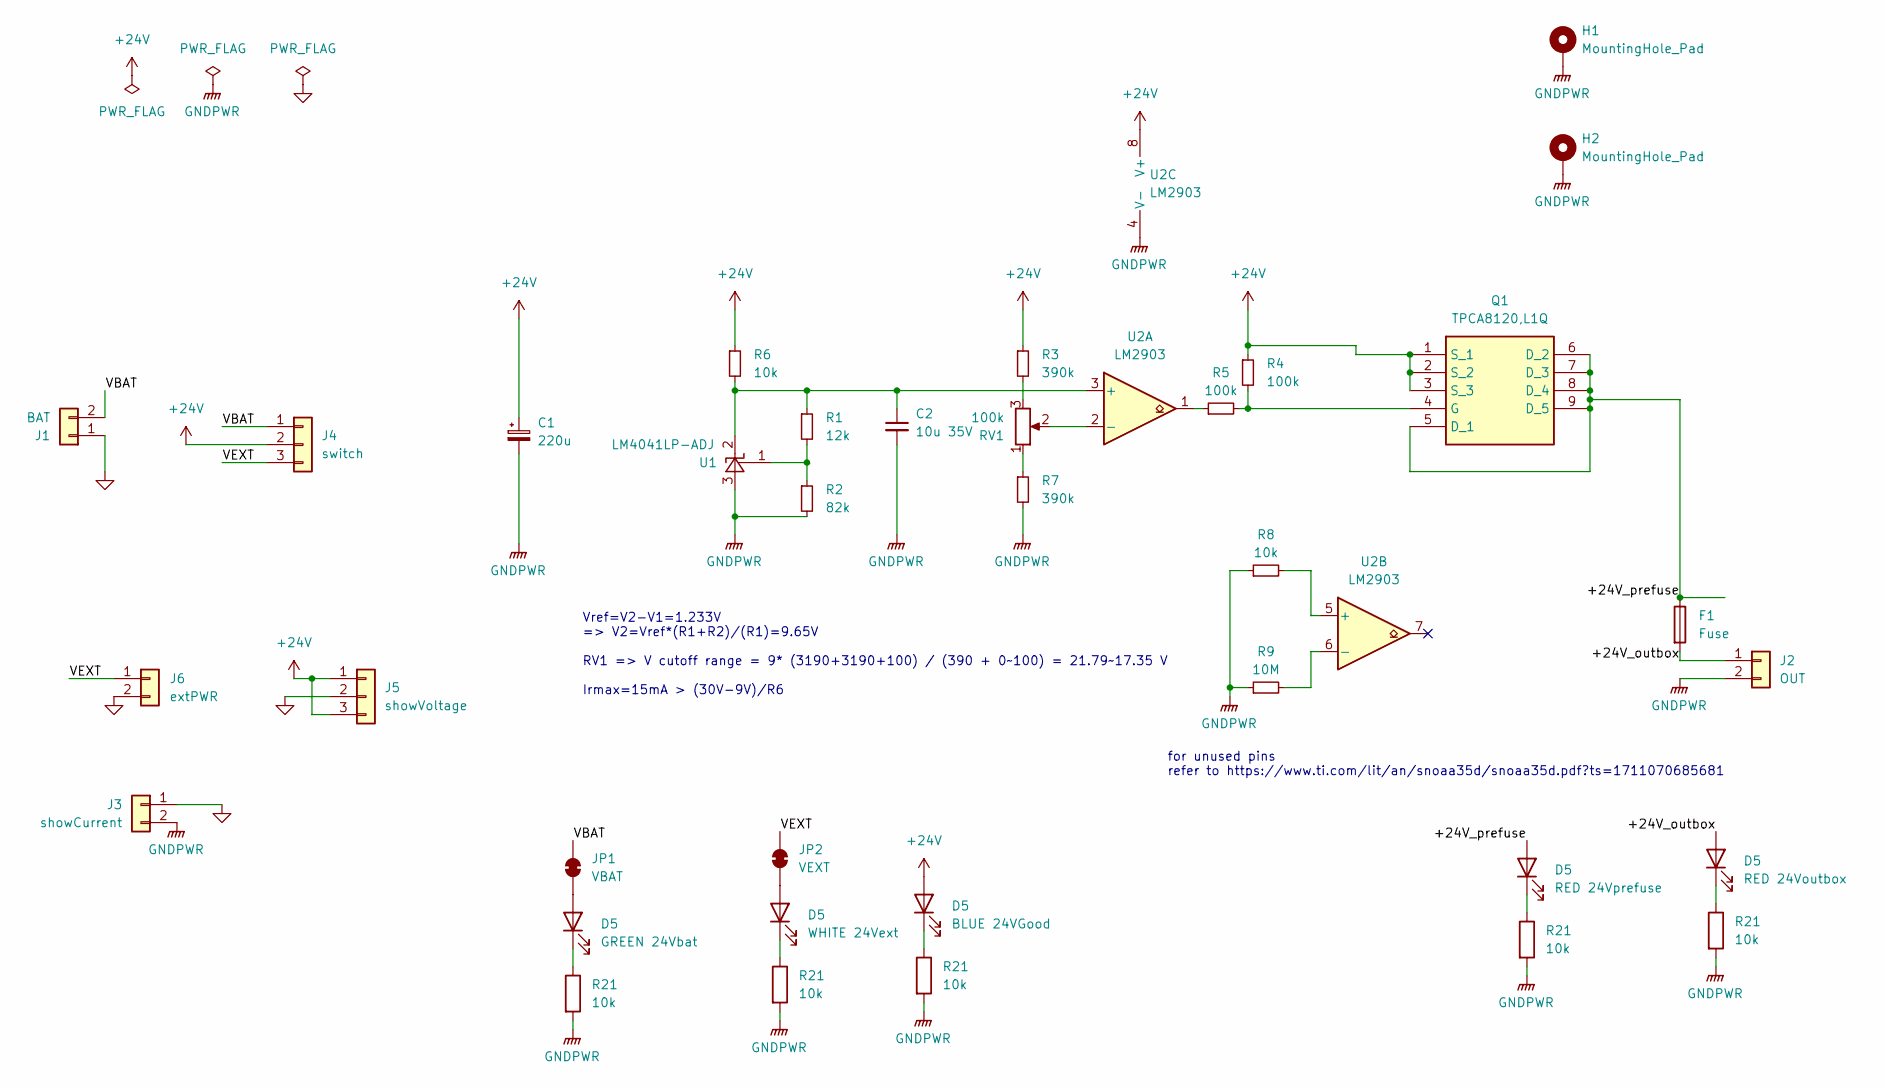
[picture p140: schematic LVBMS.kicad_sch]

Parts:
C1: 220u; CP_Radial_D8.0mm_P3.80mm
C2: 10u 35V; C_1206_3216Metric
D5: GREEN 24Vbat; LED_0603_1608Metric
F1: Fuse; Fuseholder_Cylinder-5x20mm_Schurter_0031_8201_Horizontal_Op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
H1, H2: MountingHole_Pad; MountingHole_4.5mm_Pad_Via
J1: BAT; AMASS_XT60PW-M_1x02_P7.20mm_Horizontal
J2: OUT; JST_VH_B2P-VH-B_1x02_P3.96mm_Vertical
J3: showCurrent; JST_VH_B2P-VH-B_1x02_P3.96mm_Vertical
J4: switch; JST_VH_B3P-VH_1x03_P3.96mm_Vertical
J5: showVoltage; JST_XH_B3B-XH-A_1x03_P2.50mm_Vertical
J6: extPWR; JST_VH_B2P-VH-B_1x02_P3.96mm_Vertical
JP1: VBAT; SolderJumper-2_P1.3mm_Bridged2Bar_RoundedPad1.0x1.5mm
JP2: VEXT; SolderJumper-2_P1.3mm_Bridged2Bar_RoundedPad1.0x1.5mm
Q1: TPCA8120,L1Q; TPH4R003NLL1Q; Mouser Part Number 757-TPCA8120L1Q
R1: 12k; R_0603_1608Metric
R2: 82k; R_0603_1608Metric
R3, R7: 390k; R_0603_1608Metric
R4, R5: 100k; R_0603_1608Metric
R6, R8, R21: 10k; R_0603_1608Metric
R9: 10M; R_0603_1608Metric
RV1: 100k; Potentiometer_Vishay_T73YP_Vertical
U1: LM4041LP-ADJ; TO-92_Inline
U2: LM2903; SOIC-8_3.9x4.9mm_P1.27mm

Connections:
+24V: C1.1, D5.2 (A), J4.2, J5.1, J5.3, Q1.1 (S_1), Q1.2 (S_2), Q1.3 (S_3), R3.1, R4.1, R6.1, U2.8 (V+)
+24V_outbox: D5.2 (A), F1.2, J2.1
+24V_prefuse: D5.2 (A), F1.1, Q1.5 (D_1), Q1.6 (D_2), Q1.7 (D_3), Q1.8 (D_4), Q1.9 (D_5)
GND: J1.1, J3.1, J5.2, J6.2
GNDPWR: C1.2, C2.2, H1.1, H2.1, J2.2, J3.2, R2.2, R7.2, R8.1, R9.1, R21.2, U1.3 (A), U2.4 (V-)
unnamed: C2.1, R1.1, R6.2, U1.2 (K), U2.3 (+)
unnamed: D5.1 (K), R21.1
unnamed: D5.2 (A), JP1.1 (A), JP2.1 (A)
unnamed: Q1.4 (G), R4.2, R5.2
unnamed: R1.2, R2.1, U1.1 (FB)
unnamed: R3.2, RV1.3
unnamed: R5.1, U2.1
unnamed: R7.1, RV1.1
unnamed: R8.2, U2.5 (+)
unnamed: R9.2, U2.6 (-)
unnamed: RV1.2, U2.2 (-)
VBAT: J1.2, J4.1, JP1.2 (B)
VEXT: J4.3, J6.1, JP2.2 (B)

Notes on the sheet:
Vref=V2-V1=1.233V => V2=Vref*(R1+R2)/(R1)=9.65V RV1 => V cutoff range = 9* (3190+3190+100) / (390 + 0~100) = 21.79~17.35 V Irmax=15mA > (30V-9V)/R6
for unused pins refer to https://www.ti.com/lit/an/snoaa35d/snoaa35d.pdf?ts=1711070685681
