NTURacingTeam/nturt_kicad/EP5/Electrical Group/RpiHat/GPIOs.kicad_sch

## KiCad design EP5/Electrical Group/RpiHat/GPIOs.kicad_sch (2024-07-04)

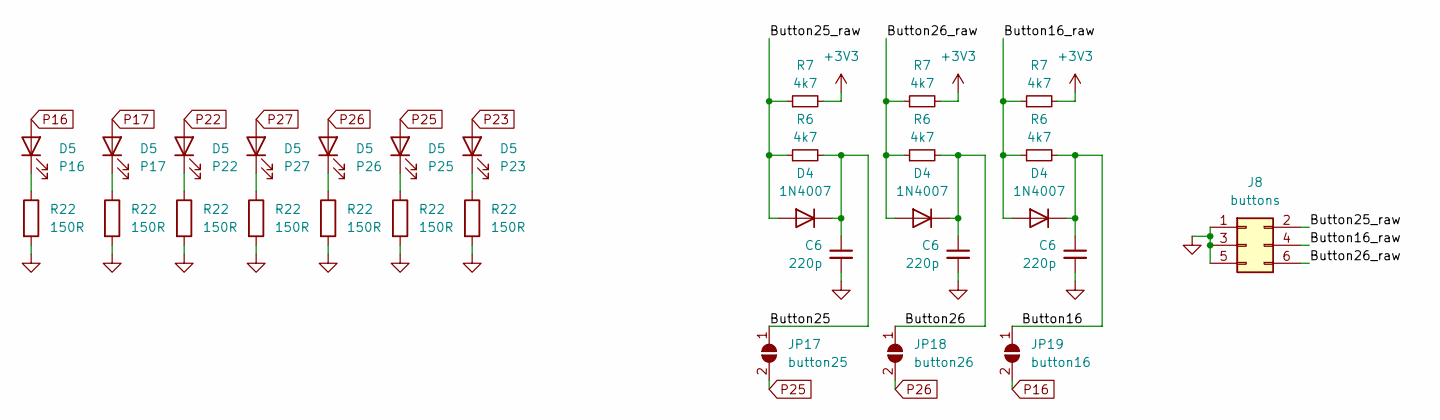
[picture p141: schematic GPIOs.kicad_sch]

Parts:
C6: 220p; C_0805_2012Metric
D4: 1N4007; D_MiniMELF
D5: P17; LED_0603_1608Metric
J8: buttons; IDC-Header_2x03_P2.54mm_Vertical
JP17: button25; SolderJumper-2_P1.3mm_Open_Pad1.0x1.5mm
JP18: button26; SolderJumper-2_P1.3mm_Open_Pad1.0x1.5mm
JP19: button16; SolderJumper-2_P1.3mm_Open_Pad1.0x1.5mm
R6, R7: 4k7; R_0603_1608Metric
R22: 150R; R_0603_1608Metric

Connections:
+3V3: R7.2
Button16: C6.1, D4.1 (K), JP19.1 (A), R6.2
Button16_raw: D4.2 (A), J8.4, R6.1, R7.1
Button25: C6.1, D4.1 (K), JP17.1 (A), R6.2
Button25_raw: D4.2 (A), J8.2, R6.1, R7.1
Button26: C6.1, D4.1 (K), JP18.1 (A), R6.2
Button26_raw: D4.2 (A), J8.6, R6.1, R7.1
GND: C6.2, J8.1, J8.3, J8.5, R22.2
unnamed: D5.1 (K), R22.1
P16: D5.2 (A), JP19.2 (B)
P17: D5.2 (A)
P22: D5.2 (A)
P23: D5.2 (A)
P25: D5.2 (A), JP17.2 (B)
P26: D5.2 (A), JP18.2 (B)
P27: D5.2 (A)
