NTURacingTeam/nturt_kicad/EP5/Electrical Group/RpiHat/RpiHat.kicad_sch

## KiCad design EP5/Electrical Group/RpiHat/RpiHat.kicad_sch (2024-07-04)

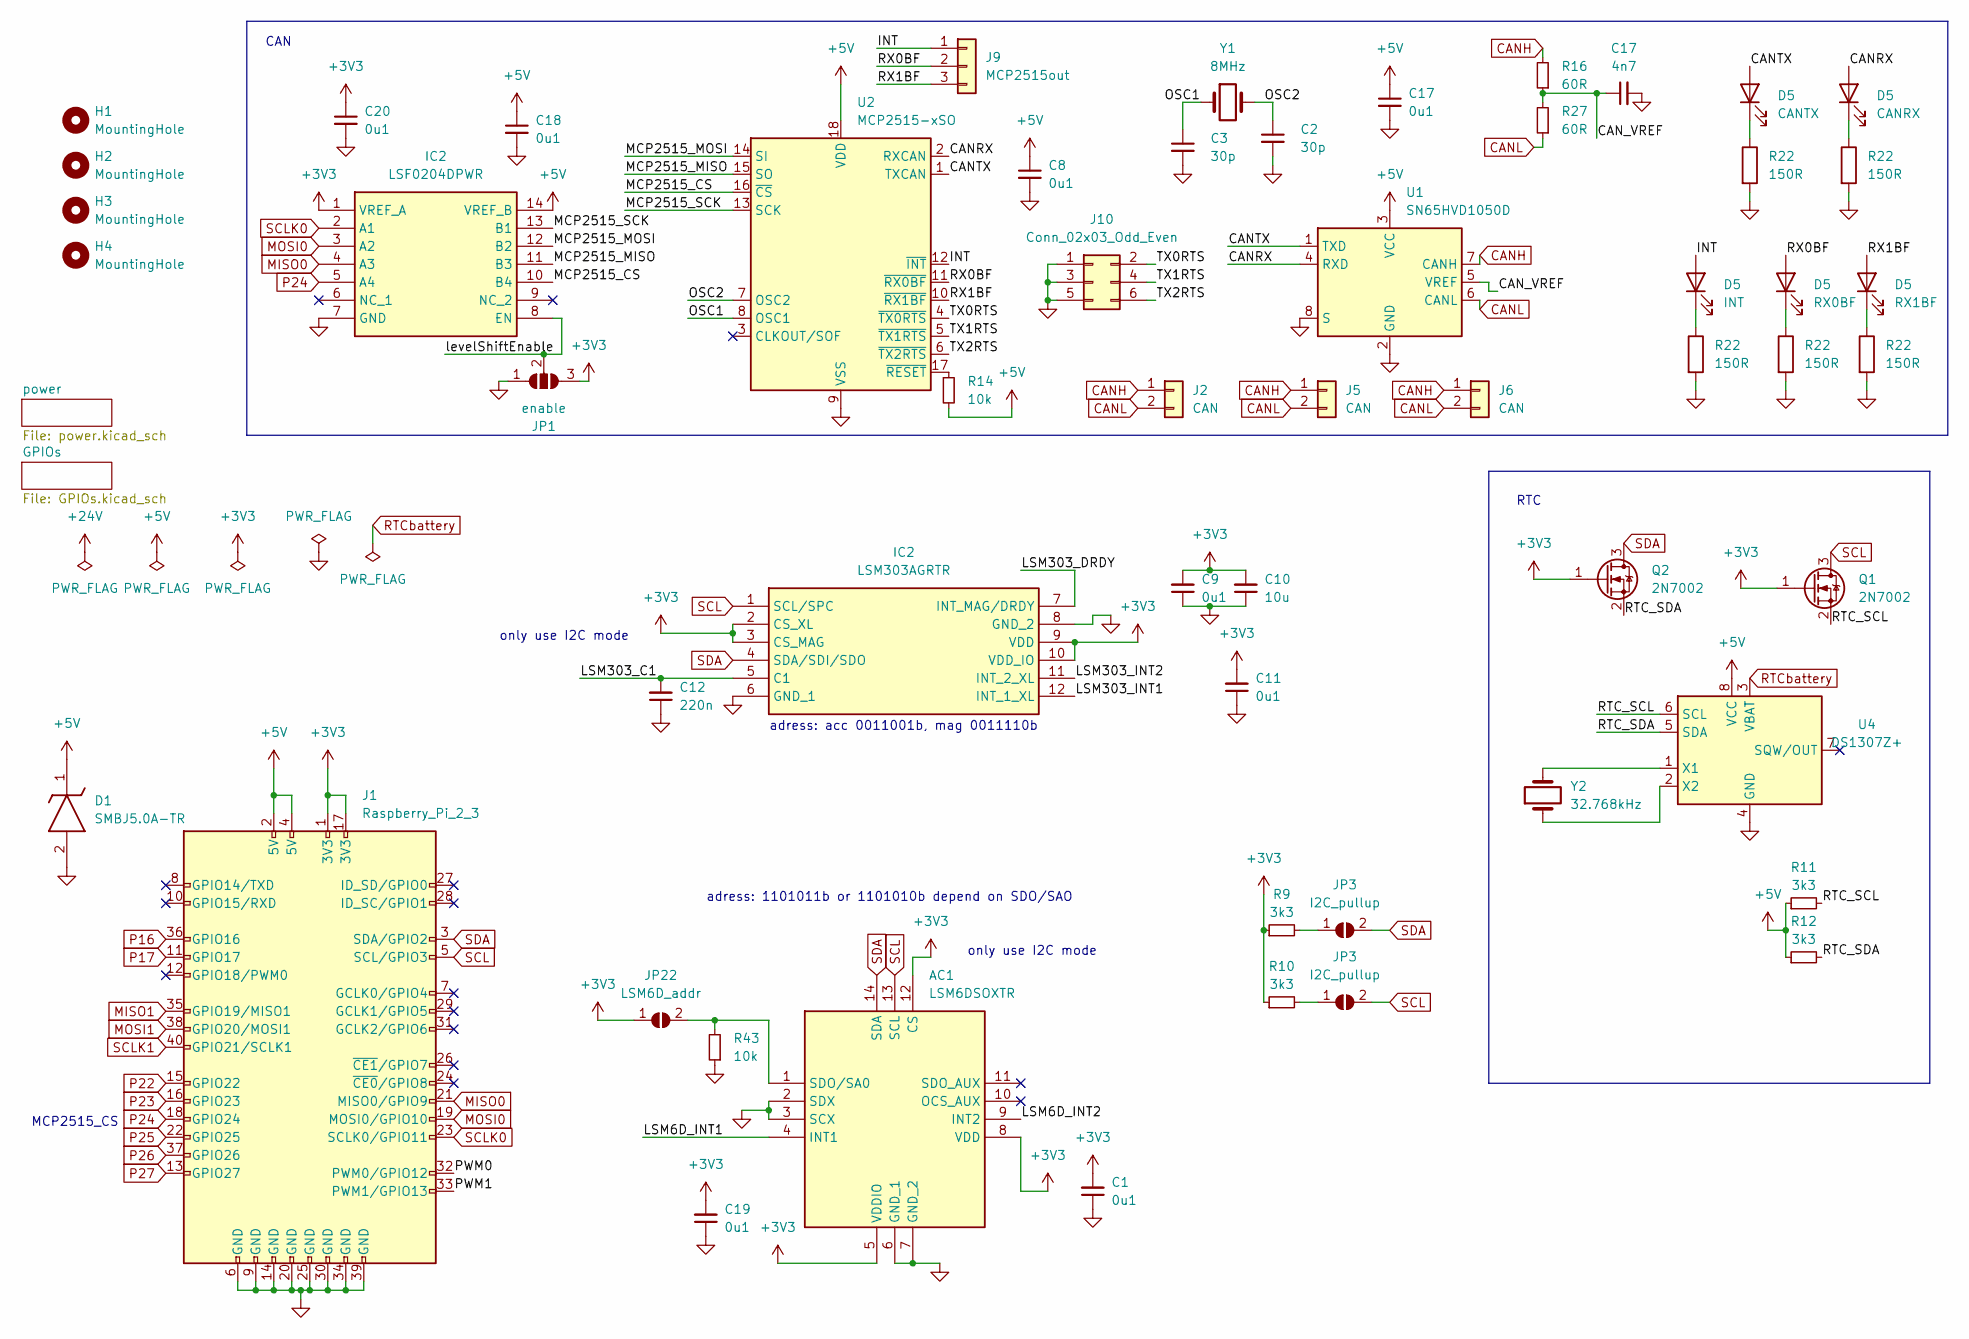
[picture p142: schematic RpiHat.kicad_sch]

Parts:
AC1: LSM6DSOXTR; LGA-14_1; Mouser Part Number 511-LSM6DSOXTR
C1, C9, C11, C19: 0u1; C_0805_2012Metric
C2, C3: 30p; C_0805_2012Metric
C8, C18, C20: 0u1; C_0805_2012Metric_Pad1.18x1.45mm_HandSolder
C10: 10u; C_1206_3216Metric
C12: 220n; C_0805_2012Metric
C17: 4n7; C_0805_2012Metric
D1: SMBJ5.0A-TR; SMBJ12A; Mouser Part Number 511-SMBJ5.0A
D5: CANTX; LED_0603_1608Metric
H1, H2, H3, H4: MountingHole; MountingHole_2.7mm_M2.5
IC2: LSF0204DPWR; SOP65P640X120-14N; Mouser Part Number 595-LSF0204DPWR
J1: Raspberry_Pi_2_3; PinSocket_2x20_P2.54mm_Vertical
J2: CAN; PinHeader_1x02_P2.54mm_Vertical
J5, J6: CAN; JST_XH_S2B-XH-A_1x02_P2.50mm_Horizontal
J9: MCP2515out; PinHeader_1x03_P2.54mm_Vertical
J10: Conn_02x03_Odd_Even; PinHeader_2x03_P2.54mm_Vertical
JP1: enable; SolderJumper-3_P1.3mm_Open_RoundedPad1.0x1.5mm_NumberLabels
JP3: I2C_pullup; SolderJumper-2_P1.3mm_Open_Pad1.0x1.5mm
JP22: LSM6D_addr; SolderJumper-2_P1.3mm_Open_RoundedPad1.0x1.5mm
Q1, Q2: 2N7002; SOT-23
R9, R10, R11, R12: 3k3; R_0603_1608Metric
R14, R43: 10k; R_0603_1608Metric
R16, R27: 60R; R_0805_2012Metric
R22: 150R; R_0603_1608Metric
U1: SN65HVD1050D; SOIC-8_3.9x4.9mm_P1.27mm
U2: MCP2515-xSO; SOIC-18W_7.5x11.6mm_P1.27mm
U4: DS1307Z+; SOIC-8_3.9x4.9mm_P1.27mm
Y1: 8MHz; Crystal_HC49-U_Vertical
Y2: 32.768kHz; Crystal_HC49-U_Vertical

Connections:
+3V3: AC1.5 (VDDIO), AC1.8 (VDD), AC1.12 (CS), C1.2, C9.2, C10.2, C11.2, C19.2, C20.1, IC2.1 (SCL/SPC), IC2.2 (CS_XL), IC2.3 (CS_MAG), IC2.9 (VDD), IC2.10 (VDD_IO), J1.1 (3V3), J1.17 (3V3), JP1.3 (B), JP22.1 (A), Q1.1 (G), Q2.1 (G), R9.1, R10.1
+5V: C8.1, C17.1, C18.1, D1.1 (K), IC2.14 (VREF_B), J1.2 (5V), J1.4 (5V), R11.1, R12.1, R14.2, U1.3 (VCC), U2.18 (VDD), U4.8 (VCC)
CANH: J2.1, J5.1, J6.1, R16.2, U1.7 (CANH)
CANL: J2.2, J5.2, J6.2, R27.1, U1.6 (CANL)
CANRX: D5.2 (A), U1.4 (RXD), U2.2 (RXCAN)
CANTX: D5.2 (A), U1.1 (TXD), U2.1 (TXCAN)
CAN_VREF: C17.1, R16.1, R27.2, U1.5 (VREF)
GND: AC1.2 (SDX), AC1.3 (SCX), AC1.6 (GND_1), AC1.7 (GND_2), C1.1, C2.2, C3.2, C8.2, C9.1, C10.1, C11.1, C12.1, C17.2, C18.2, C19.1, C20.2, D1.2 (A), IC2.6 (GND_1), IC2.7 (INT_MAG/DRDY), IC2.8 (GND_2), J1.6 (GND), J1.9 (GND), J1.14 (GND), J1.20 (GND), J1.25 (GND), J1.30 (GND), J1.34 (GND), J1.39 (GND), J10.1, J10.3, J10.5, JP1.1 (A), R22.2, R43.1, U1.2 (GND), U1.8 (S), U2.9 (VSS), U4.4 (GND)
INT: D5.2 (A), J9.1, U2.12 (~INT)
LSM6D_INT1: AC1.4 (INT1)
LSM6D_INT2: AC1.9 (INT2)
LSM303_C1: C12.2, IC2.5 (C1)
LSM303_DRDY: IC2.7 (INT_MAG/DRDY)
LSM303_INT1: IC2.12 (INT_1_XL)
LSM303_INT2: IC2.11 (INT_2_XL)
MCP2515_CS: IC2.10 (VDD_IO), U2.16 (~CS)
MCP2515_MISO: IC2.11 (INT_2_XL), U2.15 (SO)
MCP2515_MOSI: IC2.12 (INT_1_XL), U2.14 (SI)
MCP2515_SCK: IC2.13 (B1), U2.13 (SCK)
MISO0: IC2.4 (SDA/SDI/SDO), J1.21 (MISO0/GPIO9)
MISO1: J1.35 (GPIO19/MISO1)
MOSI0: IC2.3 (CS_MAG), J1.19 (MOSI0/GPIO10)
MOSI1: J1.38 (GPIO20/MOSI1)
unnamed: AC1.1 (SDO/SA0), JP22.2 (B), R43.2
unnamed: D5.1 (K), R22.1
unnamed: JP3.1 (A), R9.2, R10.2
unnamed: R14.1, U2.17 (~RESET)
unnamed: U4.1 (X1), Y2.2
unnamed: U4.2 (X2), Y2.1
OSC1: C3.1, U2.8 (OSC1), Y1.1
OSC2: C2.1, U2.7 (OSC2), Y1.2
P16: J1.36 (GPIO16)
P17: J1.11 (GPIO17)
P22: J1.15 (GPIO22)
P23: J1.16 (GPIO23)
P24: IC2.5 (C1), J1.18 (GPIO24)
P25: J1.22 (GPIO25)
P26: J1.37 (GPIO26)
P27: J1.13 (GPIO27)
PWM0: J1.32 (PWM0/GPIO12)
PWM1: J1.33 (PWM1/GPIO13)
RTC_SCL: Q1.2 (S), R11.2, U4.6 (SCL)
RTC_SDA: Q2.2 (S), R12.2, U4.5 (SDA)
RTCbattery: U4.3 (VBAT)
RX0BF: D5.2 (A), J9.2, U2.11 (~RX0BF)
RX1BF: D5.2 (A), J9.3, U2.10 (~RX1BF)
SCL: AC1.13 (SCL), IC2.1 (SCL/SPC), J1.5 (SCL/GPIO3), JP3.2 (B), Q1.3 (D)
SCLK0: IC2.2 (CS_XL), J1.23 (SCLK0/GPIO11)
SCLK1: J1.40 (GPIO21/SCLK1)
SDA: AC1.14 (SDA), IC2.4 (SDA/SDI/SDO), J1.3 (SDA/GPIO2), JP3.2 (B), Q2.3 (D)
TX0RTS: J10.2, U2.4 (~TX0RTS)
TX1RTS: J10.4, U2.5 (~TX1RTS)
TX2RTS: J10.6, U2.6 (~TX2RTS)
levelShiftEnable: IC2.8 (GND_2), JP1.2 (C)

Notes on the sheet:
adress: 1101011b or 1101010b depend on SDO/SAO
RTC
CAN
MCP2515_CS
only use I2C mode
adress: acc 0011001b, mag 0011110b
