NTURacingTeam/nturt_kicad/EP5/Electrical Group/RpiHat/power.kicad_sch

## KiCad design EP5/Electrical Group/RpiHat/power.kicad_sch (2024-07-04)

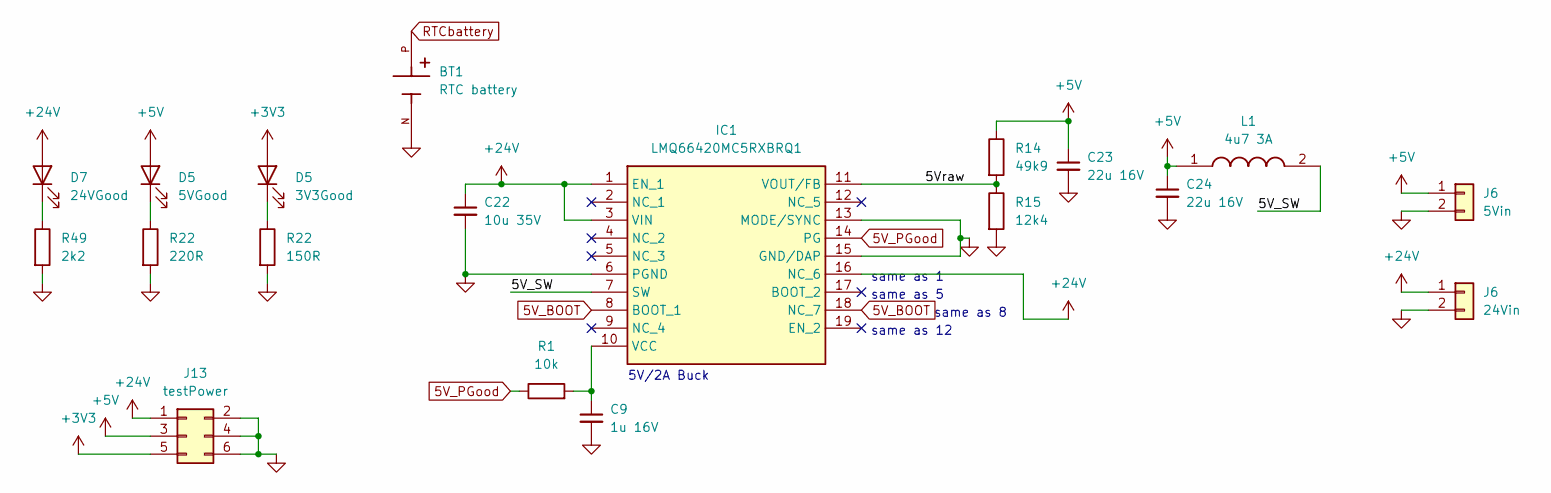
[picture p143: schematic power.kicad_sch]

Parts:
BT1: RTC battery; BAT_1056; PARTREV D
C9: 1u 16V; C_0805_2012Metric
C22: 10u 35V; C_1206_3216Metric
C23, C24: 22u 16V; C_1206_3216Metric
D5: 5VGood; LED_0603_1608Metric
D7: 24VGood; LED_0603_1608Metric
IC1: LMQ66420MC5RXBRQ1; LMR66430R5RXBR; Manufacturer_Part_Number LMQ66420MC5RXBRQ1; Mouser Part Number 595-MQ66420MC5RXBRQ1
J6: 24Vin; JST_XH_S2B-XH-A_1x02_P2.50mm_Horizontal
J13: testPower; PinHeader_2x03_P2.54mm_Vertical
L1: 4u7 3A; INDPM5552X300N; Mouser Part Number 652-SRP5030WA-2R2M
R1: 10k; R_0603_1608Metric
R14: 49k9; R_0603_1608Metric
R15: 12k4; R_0603_1608Metric
R22: 150R; R_0603_1608Metric
R49: 2k2; R_0805_2012Metric

Connections:
5V_BOOT: IC1.8 (BOOT_1), IC1.18 (NC_7)
5V_PGood: IC1.14 (PG), R1.1
5V_SW: IC1.7 (SW), L1.2
5Vraw: IC1.11 (VOUT/FB), R14.2, R15.1
+3V3: D5.2 (A), J13.5
+5V: C23.1, C24.1, D5.2 (A), J6.1, J13.3, L1.1, R14.1
+24V: C22.1, D7.2 (A), IC1.1 (EN_1), IC1.3 (VIN), IC1.16 (NC_6), J6.1, J13.1
GND: BT1.N, C9.2, C22.2, C23.2, C24.2, IC1.6 (PGND), IC1.13 (MODE/SYNC), IC1.15 (GND/DAP), J6.2, J13.2, J13.4, J13.6, R15.2, R22.2, R49.2
unnamed: C9.1, IC1.10 (VCC), R1.2
unnamed: D5.1 (K), R22.1
unnamed: D7.1 (K), R49.1
RTCbattery: BT1.P

Notes on the sheet:
same as 12
same as 8
5V/2A Buck
same as 1
same as 5
