NTURacingTeam/nturt_kicad/EP5/Electrical Group/power board/EMI.kicad_sch

## KiCad design EP5/Electrical Group/power board/EMI.kicad_sch (2024-07-26)

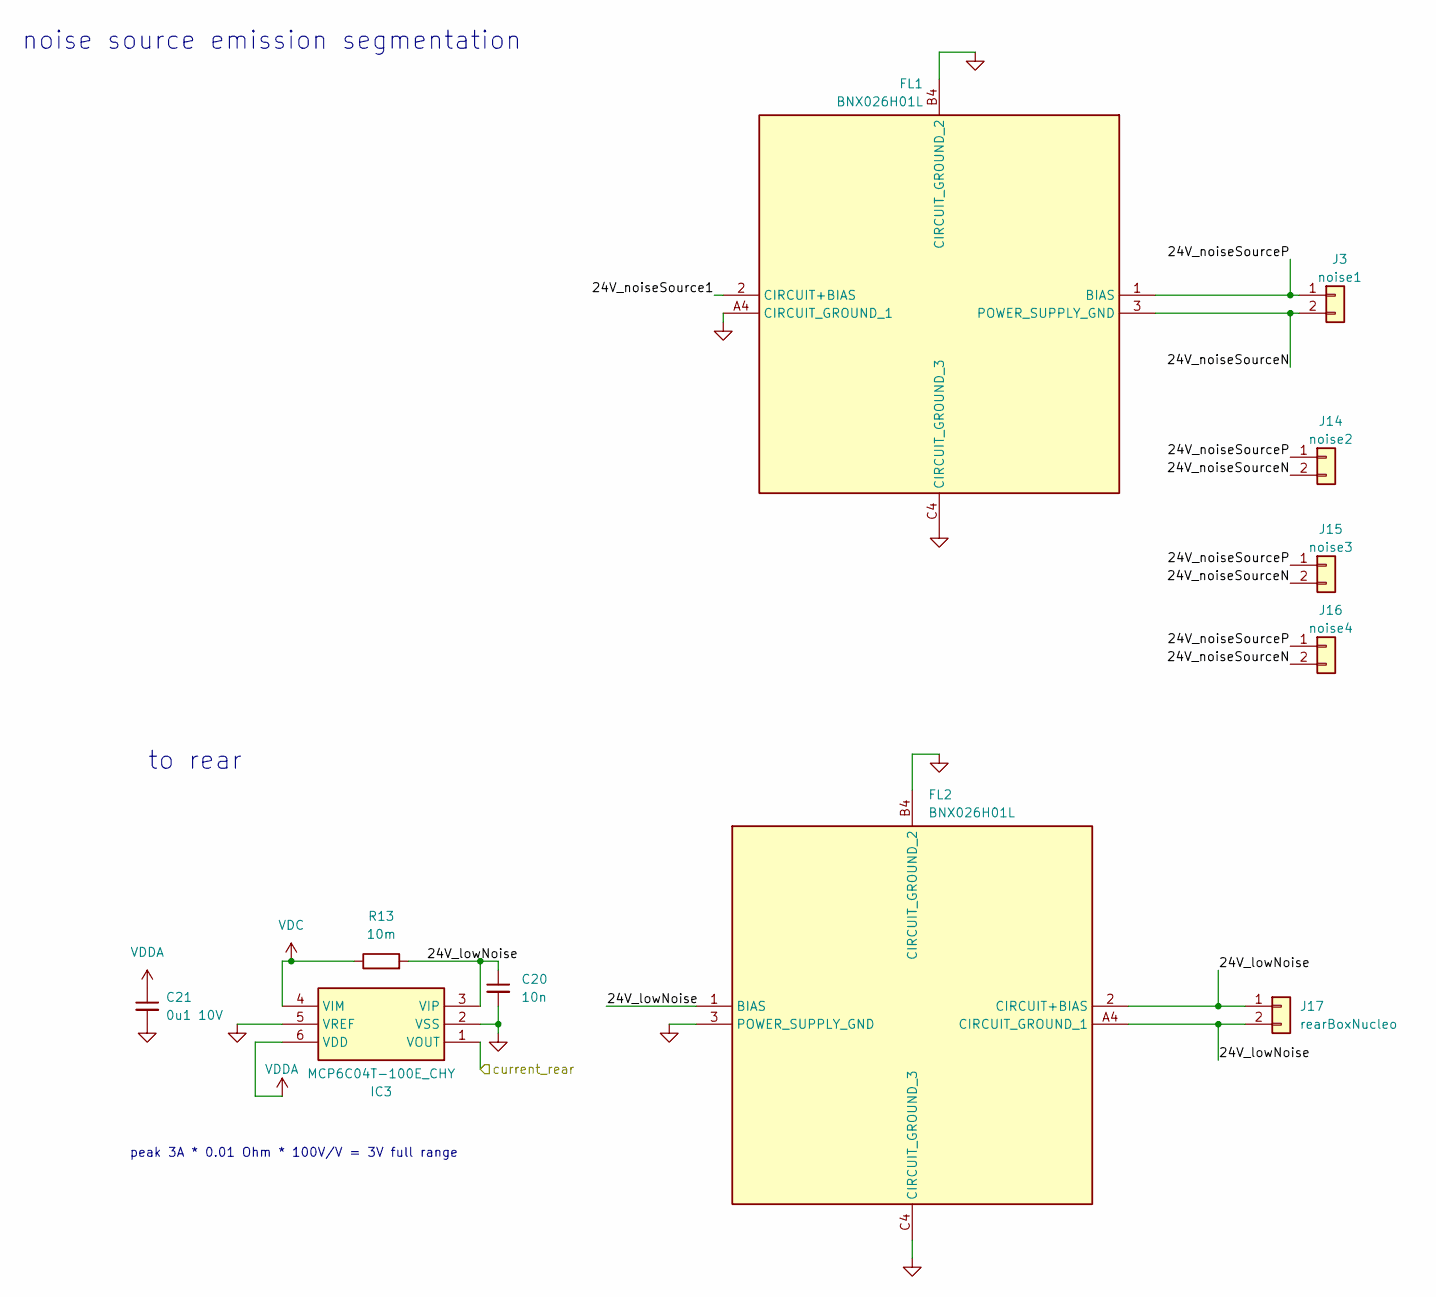
[picture p144: schematic EMI.kicad_sch]

Parts:
C20: 10n; C_0805_2012Metric
C21: 0u1 10V; C_0805_2012Metric
FL1, FL2: BNX026H01L; BNX024H01K; Mouser Part Number 81-BNX026H01L
IC3: MCP6C04T-100E_CHY; SOT95P280X145-6N; Mouser Part Number 579-MCP6C04T100ECHY
J3: noise1; Molex_KK-396_A-41791-0002_1x02_P3.96mm_Vertical
J14: noise2; Molex_KK-396_A-41791-0002_1x02_P3.96mm_Vertical
J15: noise3; Molex_KK-396_A-41791-0002_1x02_P3.96mm_Vertical
J16: noise4; Molex_KK-396_A-41791-0002_1x02_P3.96mm_Vertical
J17: rearBoxNucleo; JST_XH_B2B-XH-A_1x02_P2.50mm_Vertical
R13: 10m; R_0805_2012Metric

Connections:
24V_lowNoise: C20.1, FL2.1 (BIAS), FL2.2 (CIRCUIT+BIAS), FL2.A4 (CIRCUIT_GROUND_1), IC3.3 (VIP), J17.1, J17.2, R13.2
24V_noiseSource1: FL1.2 (CIRCUIT+BIAS)
24V_noiseSourceN: FL1.3 (POWER_SUPPLY_GND), J3.2, J14.2, J15.2, J16.2
24V_noiseSourceP: FL1.1 (BIAS), J3.1, J14.1, J15.1, J16.1
GND: C20.2, C21.2, FL1.A4 (CIRCUIT_GROUND_1), FL1.B4 (CIRCUIT_GROUND_2), FL1.C4 (CIRCUIT_GROUND_3), FL2.3 (POWER_SUPPLY_GND), FL2.B4 (CIRCUIT_GROUND_2), FL2.C4 (CIRCUIT_GROUND_3), IC3.2 (VSS), IC3.5 (VREF)
VDC: IC3.4 (VIM), R13.1
VDDA: C21.1, IC3.6 (VDD)
current_rear: IC3.1 (VOUT)

Notes on the sheet:
noise source emission segmentation
to rear
peak 3A * 0.01 Ohm * 100V/V = 3V full range
