NTURacingTeam/nturt_kicad/EP5/Electrical Group/power board/electrical1.kicad_sch

## KiCad design EP5/Electrical Group/power board/electrical1.kicad_sch (2024-07-26)

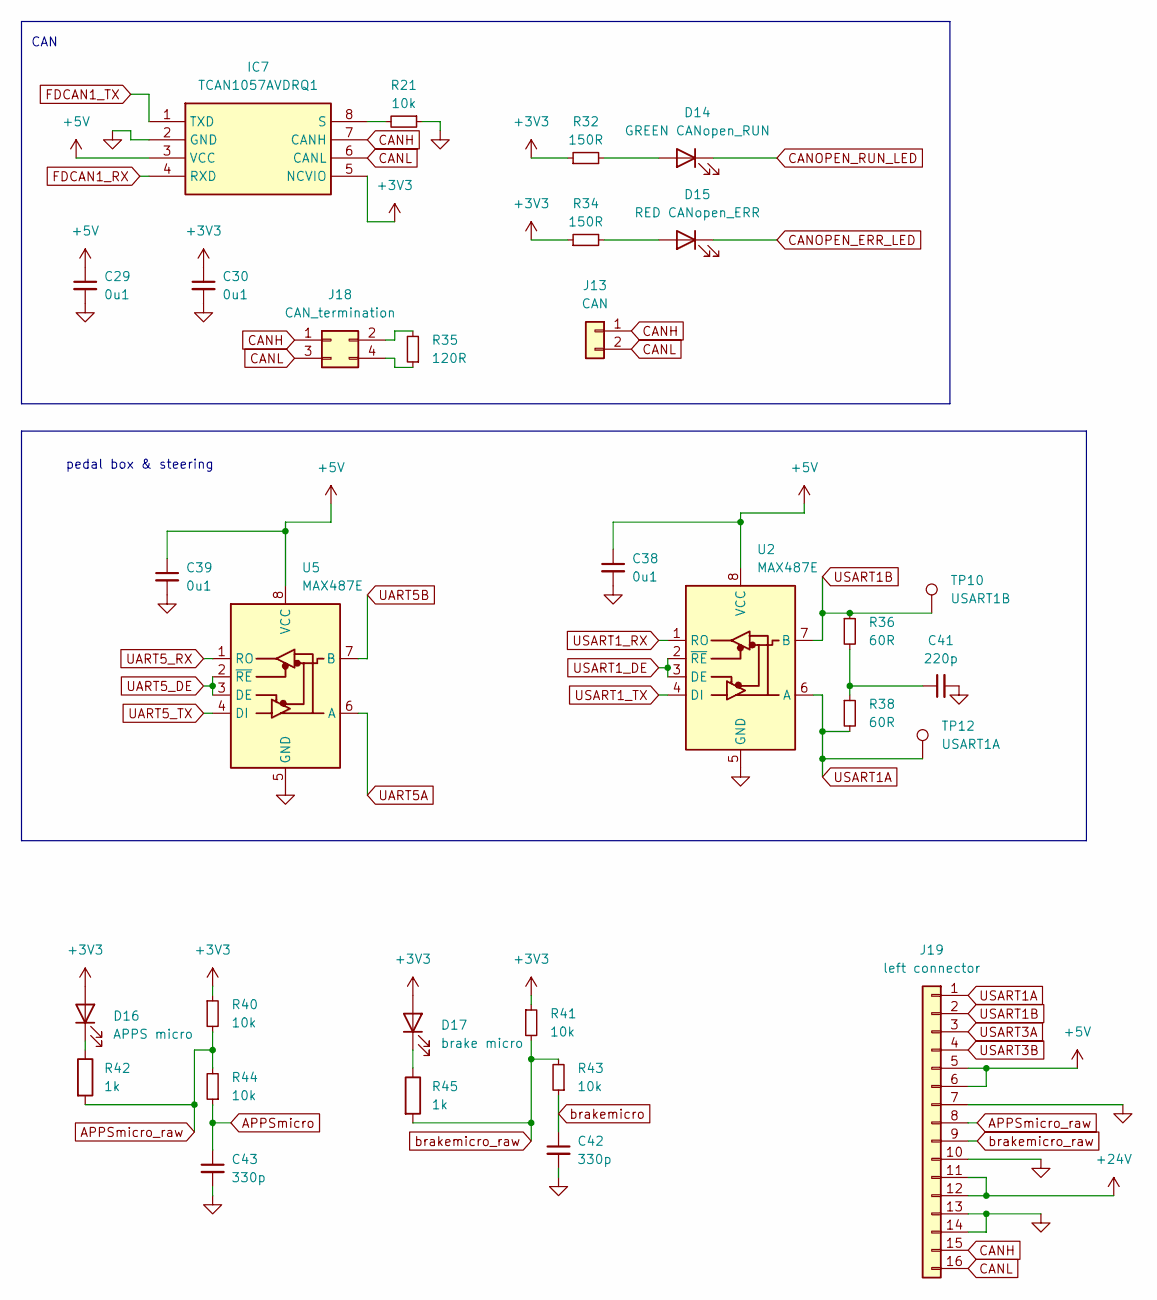
[picture p145: schematic electrical1.kicad_sch]

Parts:
C29, C30, C38, C39: 0u1; C_0603_1608Metric
C41: 220p; C_0603_1608Metric
C42, C43: 330p; C_0603_1608Metric
D14: GREEN CANopen_RUN; LED_0603_1608Metric
D15: RED CANopen_ERR; LED_0603_1608Metric
D16: APPS micro; LED_0603_1608Metric
D17: brake micro; LED_0603_1608Metric
IC7: TCAN1057AVDRQ1; SOIC127P600X175-8N; Mouser Part Number 595-TCAN1057AVDRQ1
J13: CAN; JST_XH_B2B-XH-A_1x02_P2.50mm_Vertical
J18: CAN_termination; PinHeader_2x02_P2.54mm_Vertical
J19: left connector; IDC-Header_2x08_P2.54mm_Vertical
R21, R40, R41, R43, R44: 10k; R_0603_1608Metric
R32, R34: 150R; R_0603_1608Metric
R35: 120R; R_0603_1608Metric
R36, R38: 60R; R_0603_1608Metric
R42, R45: 1k; R_0603_1608Metric
TP10: USART1B; TestPoint_Pad_D1.0mm
TP12: USART1A; TestPoint_Pad_D1.0mm
U2, U5: MAX487E; SOIC-8_3.9x4.9mm_P1.27mm

Connections:
+3V3: C30.1, D16.2 (A), D17.2 (A), IC7.5 (NCVIO), R32.1, R34.1, R40.1, R41.1
+5V: C29.1, C38.1, C39.1, IC7.3 (VCC), J19.5, J19.6, U2.8 (VCC), U5.8 (VCC)
+24V: J19.11, J19.12
APPSmicro: C43.1, R44.1
APPSmicro_raw: J19.8, R40.2, R42.2, R44.2
CANH: IC7.7 (CANH), J13.1, J18.1, J19.15
CANL: IC7.6 (CANL), J13.2, J18.3, J19.16
CANOPEN_ERR_LED: D15.1 (K)
CANOPEN_RUN_LED: D14.1 (K)
FDCAN1_RX: IC7.4 (RXD)
FDCAN1_TX: IC7.1 (TXD)
GND: C29.2, C30.2, C38.2, C39.2, C41.2, C42.2, C43.2, IC7.2 (GND), J19.7, J19.10, J19.13, J19.14, R21.1, U2.5 (GND), U5.5 (GND)
unnamed: C41.1, R36.2, R38.1
unnamed: D14.2 (A), R32.2
unnamed: D15.2 (A), R34.2
unnamed: D16.1 (K), R42.1
unnamed: D17.1 (K), R45.1
unnamed: IC7.8 (S), R21.2
unnamed: J18.2, R35.2
unnamed: J18.4, R35.1
UART5A: U5.6 (A)
UART5B: U5.7 (B)
UART5_DE: U5.2 (~RE), U5.3 (DE)
UART5_RX: U5.1 (RO)
UART5_TX: U5.4 (DI)
USART1A: J19.1, R38.2, TP12.1, U2.6 (A)
USART1B: J19.2, R36.1, TP10.1, U2.7 (B)
USART1_DE: U2.2 (~RE), U2.3 (DE)
USART1_RX: U2.1 (RO)
USART1_TX: U2.4 (DI)
USART3A: J19.3
USART3B: J19.4
brakemicro: C42.1, R43.1
brakemicro_raw: J19.9, R41.2, R43.2, R45.2

Notes on the sheet:
CAN
pedal box & steering
