NTURacingTeam/nturt_kicad/EP5/Electrical Group/power board/electrical2.kicad_sch

## KiCad design EP5/Electrical Group/power board/electrical2.kicad_sch (2024-07-26)

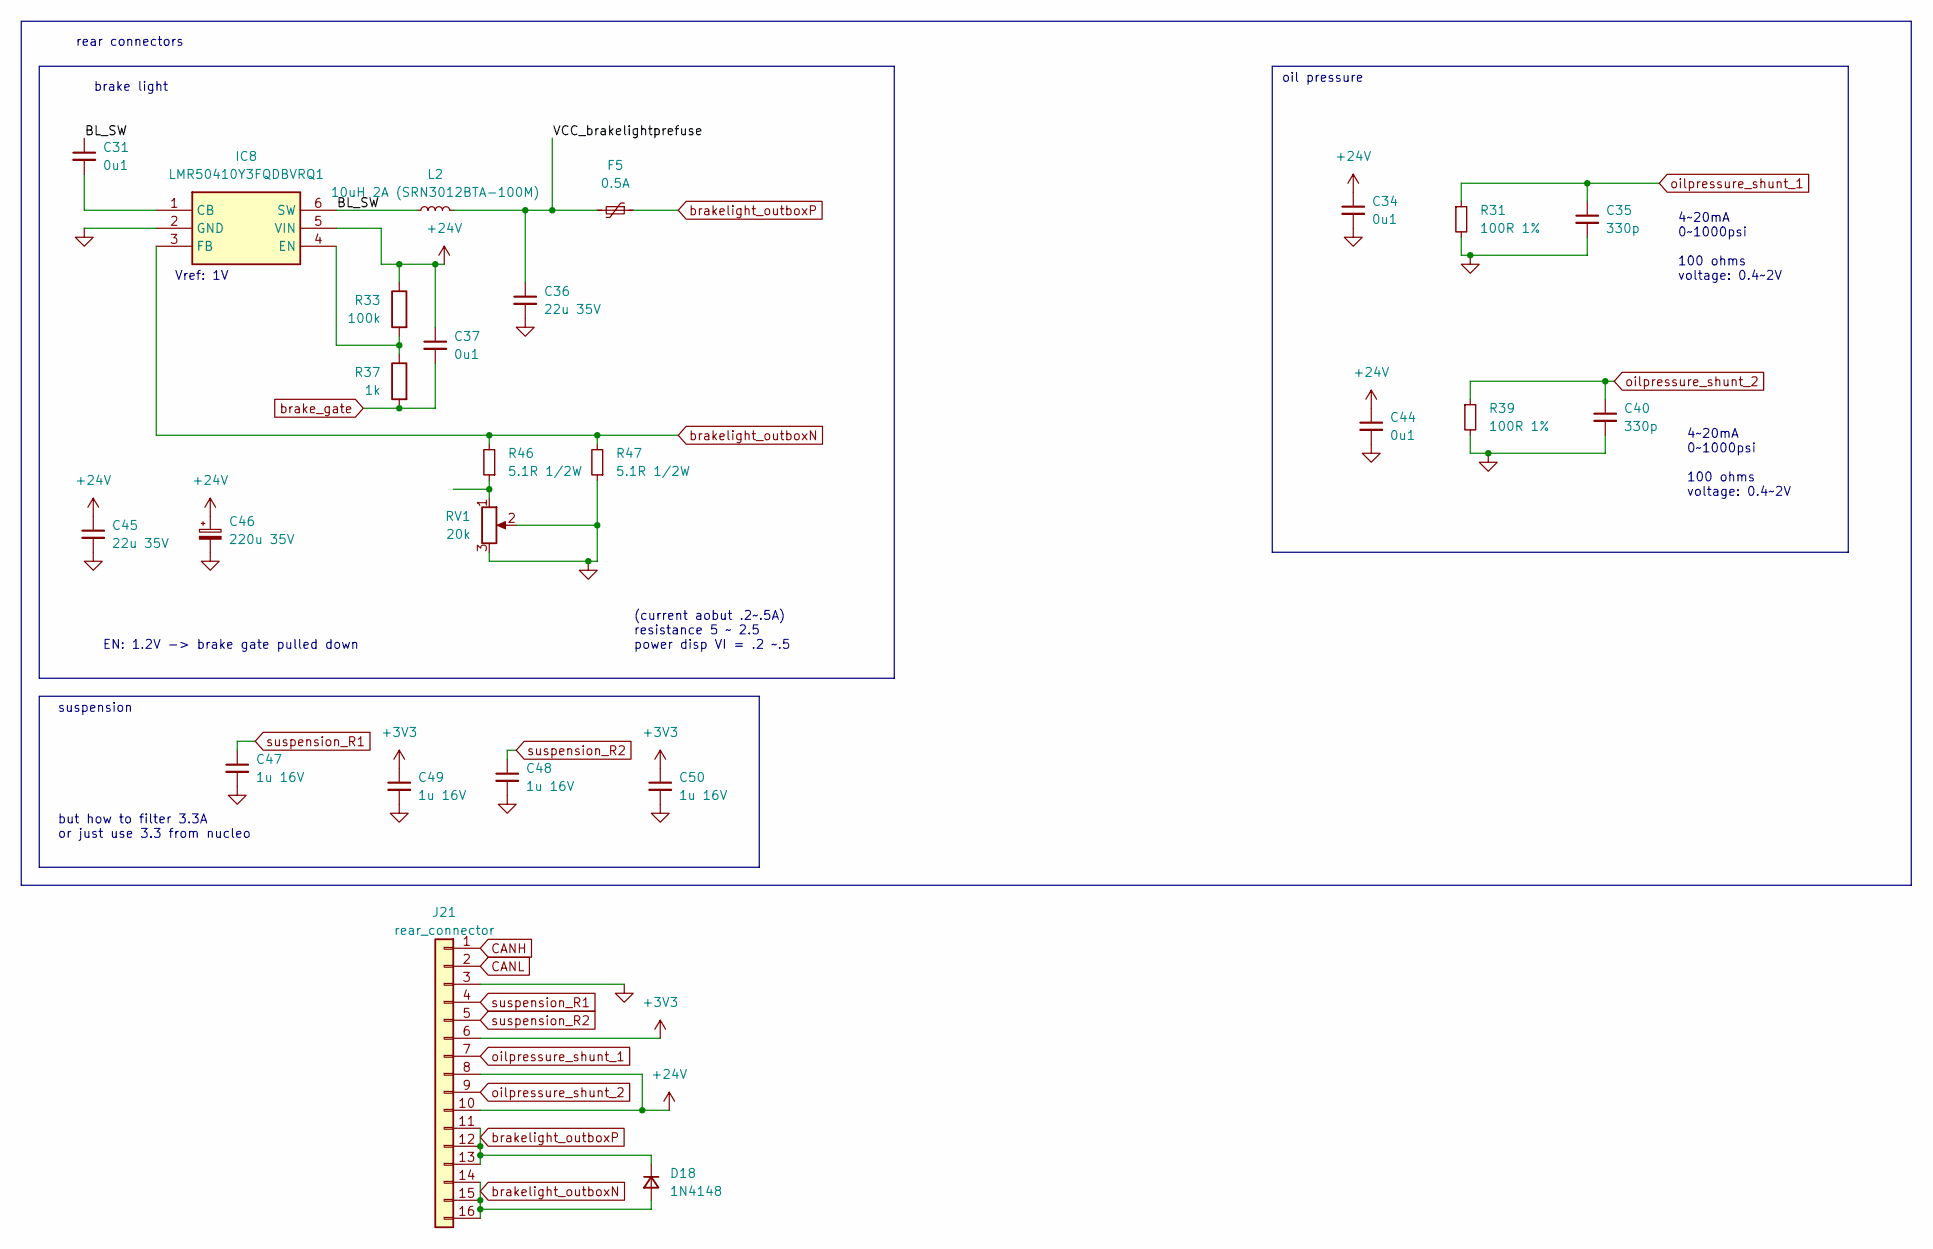
[picture p146: schematic electrical2.kicad_sch]

Parts:
C31, C34, C37, C44: 0u1; C_0603_1608Metric
C35, C40: 330p; C_0603_1608Metric
C36, C45: 22u 35V; C_1206_3216Metric
C46: 220u 35V; CP_Radial_D8.0mm_P3.80mm
C47, C48, C49, C50: 1u 16V; C_0603_1608Metric
D18: 1N4148; D_MiniMELF
F5: 0.5A; Fuse_1206_3216Metric
IC8: LMR50410Y3FQDBVRQ1; SOT95P280X145-6N; Mouser Part Number 595-R50410Y3FQDBVRQ1
J21: rear_connector; IDC-Header_2x08_P2.54mm_Vertical
L2: 10uH 2A (SRN3012BTA-100M); SRN3012BTA100M
R31, R39: 100R 1%; R_0805_2012Metric
R33: 100k; R_0603_1608Metric
R37: 1k; R_0603_1608Metric
R46, R47: 5.1R 1/2W; R_Axial_DIN0309_L9.0mm_D3.2mm_P2.54mm_Vertical
RV1: 20k; Potentiometer_Vishay_T73YP_Vertical

Connections:
+3V3: C49.1, C50.1, J21.6
+24V: C34.1, C37.1, C44.1, C45.1, C46.1, IC8.5 (VIN), J21.8, J21.10, R33.1
BL_SW: C31.1, IC8.6 (SW), L2.1
CANH: J21.1
CANL: J21.2
GND: C34.2, C35.2, C36.2, C40.2, C44.2, C45.2, C46.2, C47.2, C48.2, C49.2, C50.2, IC8.2 (GND), J21.3, R31.2, R39.2, R47.1, RV1.2, RV1.3
unnamed: C31.2, IC8.1 (CB)
unnamed: IC8.4 (EN), R33.2, R37.1
unnamed: R46.1, RV1.1
VCC_brakelightprefuse: C36.1, F5.2, L2.2
brake_gate: C37.2, R37.2
brakelight_outboxN: D18.2 (A), IC8.3 (FB), J21.14, J21.15, J21.16, R46.2, R47.2
brakelight_outboxP: D18.1 (K), F5.1, J21.11, J21.12, J21.13
oilpressure_shunt_1: C35.1, J21.7, R31.1
oilpressure_shunt_2: C40.1, J21.9, R39.1
suspension_R1: C47.1, J21.4
suspension_R2: C48.1, J21.5

Notes on the sheet:
brake light
4~20mA 0~1000psi 100 ohms voltage: 0.4~2V
suspension
(current aobut .2~.5A) resistance 5 ~ 2.5 power disp VI = .2 ~.5
Vref: 1V
oil pressure
EN: 1.2V -> brake gate pulled down
rear connectors
but how to filter 3.3A or just use 3.3 from nucleo
