NTURacingTeam/nturt_kicad/EP5/Electrical Group/power board/inbox.kicad_sch

## KiCad design EP5/Electrical Group/power board/inbox.kicad_sch (2024-07-04)

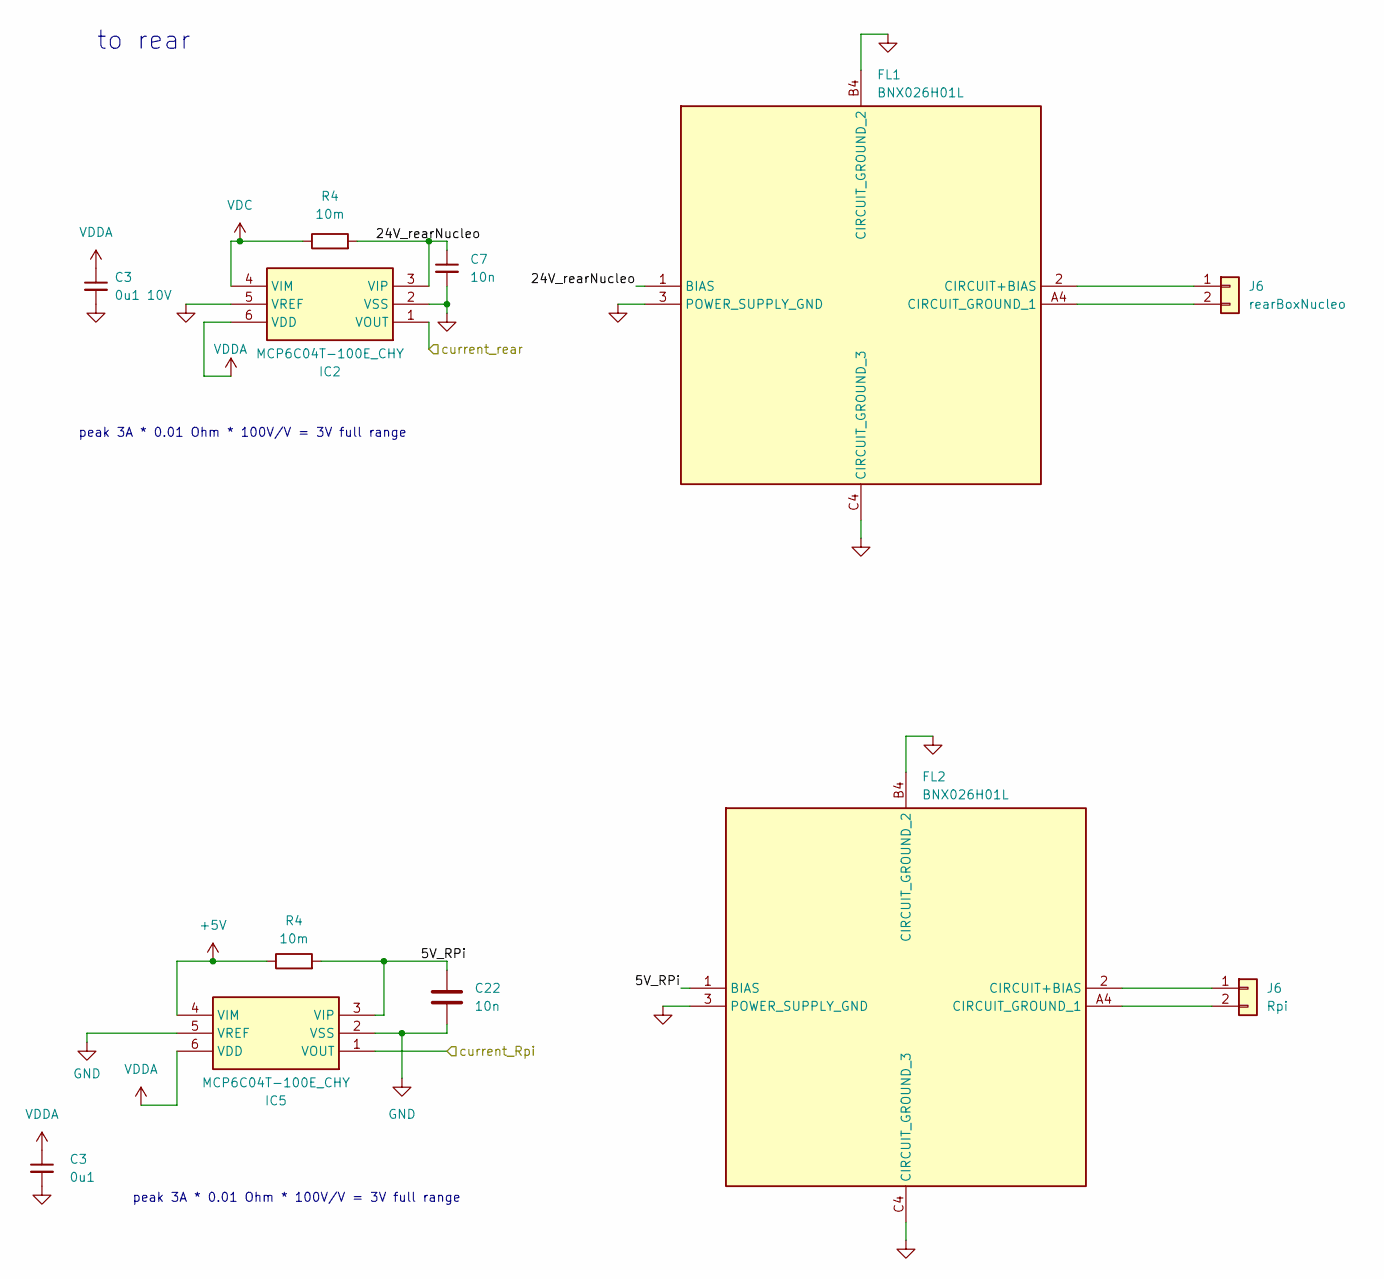
[picture p147: schematic inbox.kicad_sch]

Parts:
C3: 0u1; C_0805_2012Metric
C7, C22: 10n; C_0805_2012Metric
FL1, FL2: BNX026H01L; BNX024H01K; Mouser Part Number 81-BNX026H01L
IC2, IC5: MCP6C04T-100E_CHY; SOT95P280X145-6N; Mouser Part Number 579-MCP6C04T100ECHY
J6: Rpi; JST_XH_B2B-XH-A_1x02_P2.50mm_Vertical
R4: 10m; R_0805_2012Metric

Connections:
5V_RPi: C22.1, FL2.1 (BIAS), IC5.3 (VIP), R4.2
24V_rearNucleo: C7.1, FL1.1 (BIAS), IC2.3 (VIP), R4.2
+5V: IC5.4 (VIM), R4.1
GND: C3.2, C7.2, C22.2, FL1.3 (POWER_SUPPLY_GND), FL1.B4 (CIRCUIT_GROUND_2), FL1.C4 (CIRCUIT_GROUND_3), FL2.3 (POWER_SUPPLY_GND), FL2.B4 (CIRCUIT_GROUND_2), FL2.C4 (CIRCUIT_GROUND_3), IC2.2 (VSS), IC2.5 (VREF), IC5.2 (VSS), IC5.5 (VREF)
unnamed: FL1.2 (CIRCUIT+BIAS), J6.1
unnamed: FL1.A4 (CIRCUIT_GROUND_1), J6.2
unnamed: FL2.2 (CIRCUIT+BIAS), J6.1
unnamed: FL2.A4 (CIRCUIT_GROUND_1), J6.2
VDC: IC2.4 (VIM), R4.1
VDDA: C3.1, IC2.6 (VDD), IC5.6 (VDD)
current_Rpi: IC5.1 (VOUT)
current_rear: IC2.1 (VOUT)

Notes on the sheet:
peak 3A * 0.01 Ohm * 100V/V = 3V full range
to rear
