NTURacingTeam/nturt_kicad/EP5/Electrical Group/power board/power board.kicad_sch

## KiCad design EP5/Electrical Group/power board/power board.kicad_sch (2024-07-26)

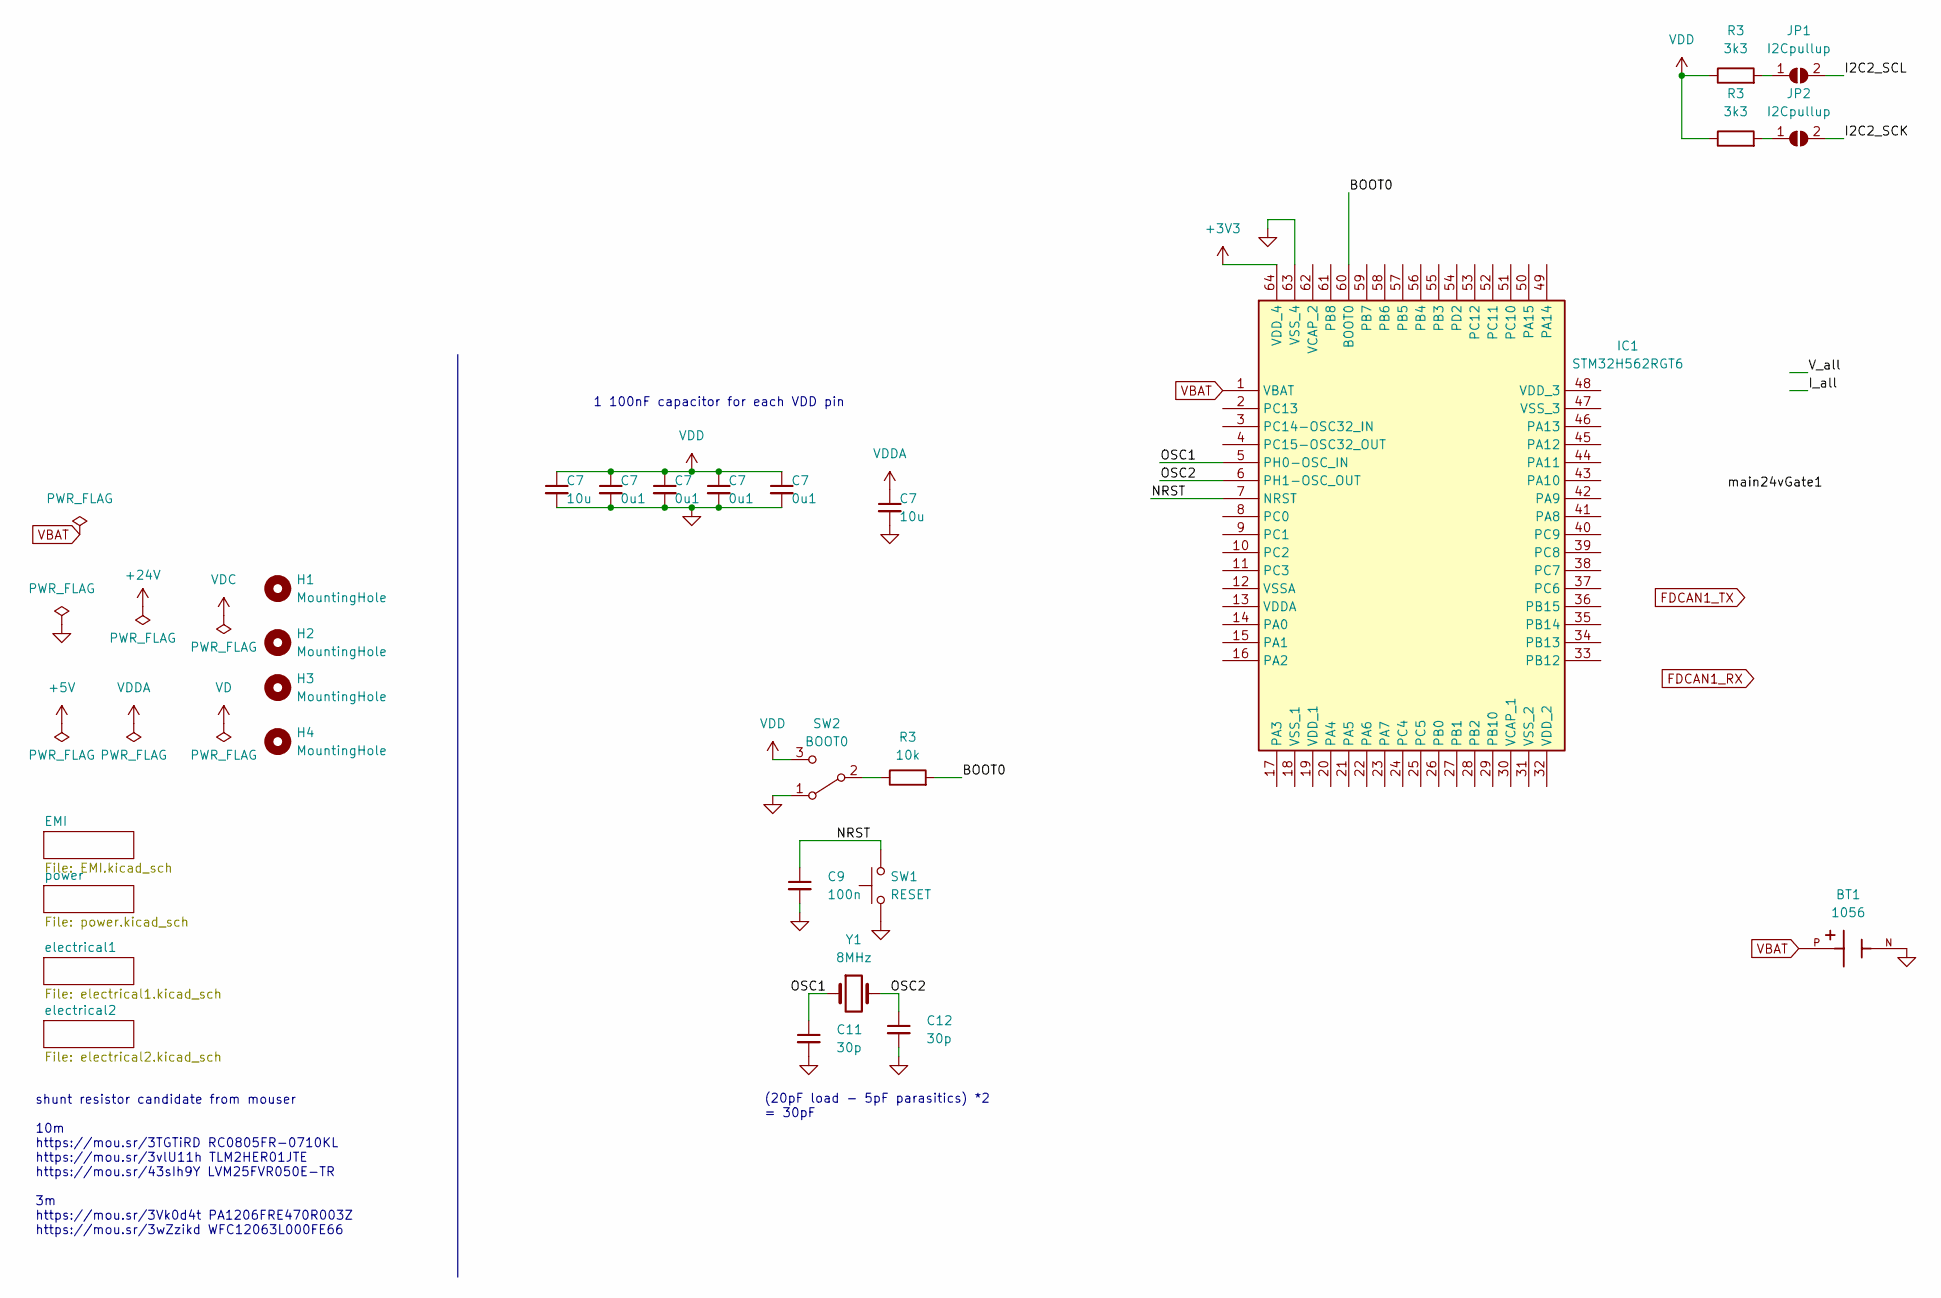
[picture p148: schematic power board.kicad_sch]

Parts:
BT1: 1056; BAT_1056; PARTREV D
C7: 10u; C_0603_1608Metric_Pad1.08x0.95mm_HandSolder
C9: 100n; C_0603_1608Metric_Pad1.08x0.95mm_HandSolder
C11, C12: 30p; C_0603_1608Metric_Pad1.08x0.95mm_HandSolder
H1, H2, H3, H4: MountingHole; MountingHole_3.2mm_M3
IC1: STM32H562RGT6; QFP50P1200X1200X160-64N; Mouser Part Number 511-STM32H562RGT6
JP1, JP2: I2Cpullup; SolderJumper-2_P1.3mm_Open_RoundedPad1.0x1.5mm
R3: 3k3; R_0603_1608Metric_Pad0.98x0.95mm_HandSolder
SW1: RESET; SW_Tactile_SPST_NO_Straight_CK_PTS636Sx25SMTRLFS
SW2: BOOT0; PinHeader_1x03_P2.54mm_Vertical
Y1: 8MHz; Crystal_HC49-U_Vertical

Connections:
+3V3: IC1.64 (VDD_4)
BOOT0: IC1.60 (BOOT0), R3.2
GND: BT1.N, C7.2, C9.2, C11.2, C12.2, IC1.63 (VSS_4), SW1.1, SW2.1 (A)
I2C2_SCK: JP2.2 (B)
I2C2_SCL: JP1.2 (B)
NRST: C9.1, IC1.7 (NRST), SW1.2
unnamed: JP1.1 (A), R3.2
unnamed: JP2.1 (A), R3.2
unnamed: R3.1, SW2.2 (B)
OSC1: C11.1, IC1.5 (PH0-OSC_IN), Y1.1
OSC2: C12.1, IC1.6 (PH1-OSC_OUT), Y1.2
VBAT: BT1.P, IC1.1 (VBAT)
VDD: C7.1, R3.1, SW2.3 (C)
VDDA: C7.1

Notes on the sheet:
1 100nF capacitor for each VDD pin
(20pF load - 5pF parasitics) *2 = 30pF
shunt resistor candidate from mouser 10m https://mou.sr/3TGTiRD RC0805FR-0710KL https://mou.sr/3vlU11h TLM2HER01JTE https://mou.sr/43sIh9Y LVM25FVR050E-TR 3m https://mou.sr/3Vk0d4t PA1206FRE470R003Z https://mou.sr/3wZzikd WFC12063L000FE66
