NTURacingTeam/nturt_kicad/EP5/Electrical Group/power board/power.kicad_sch

## KiCad design EP5/Electrical Group/power board/power.kicad_sch (2024-07-26)

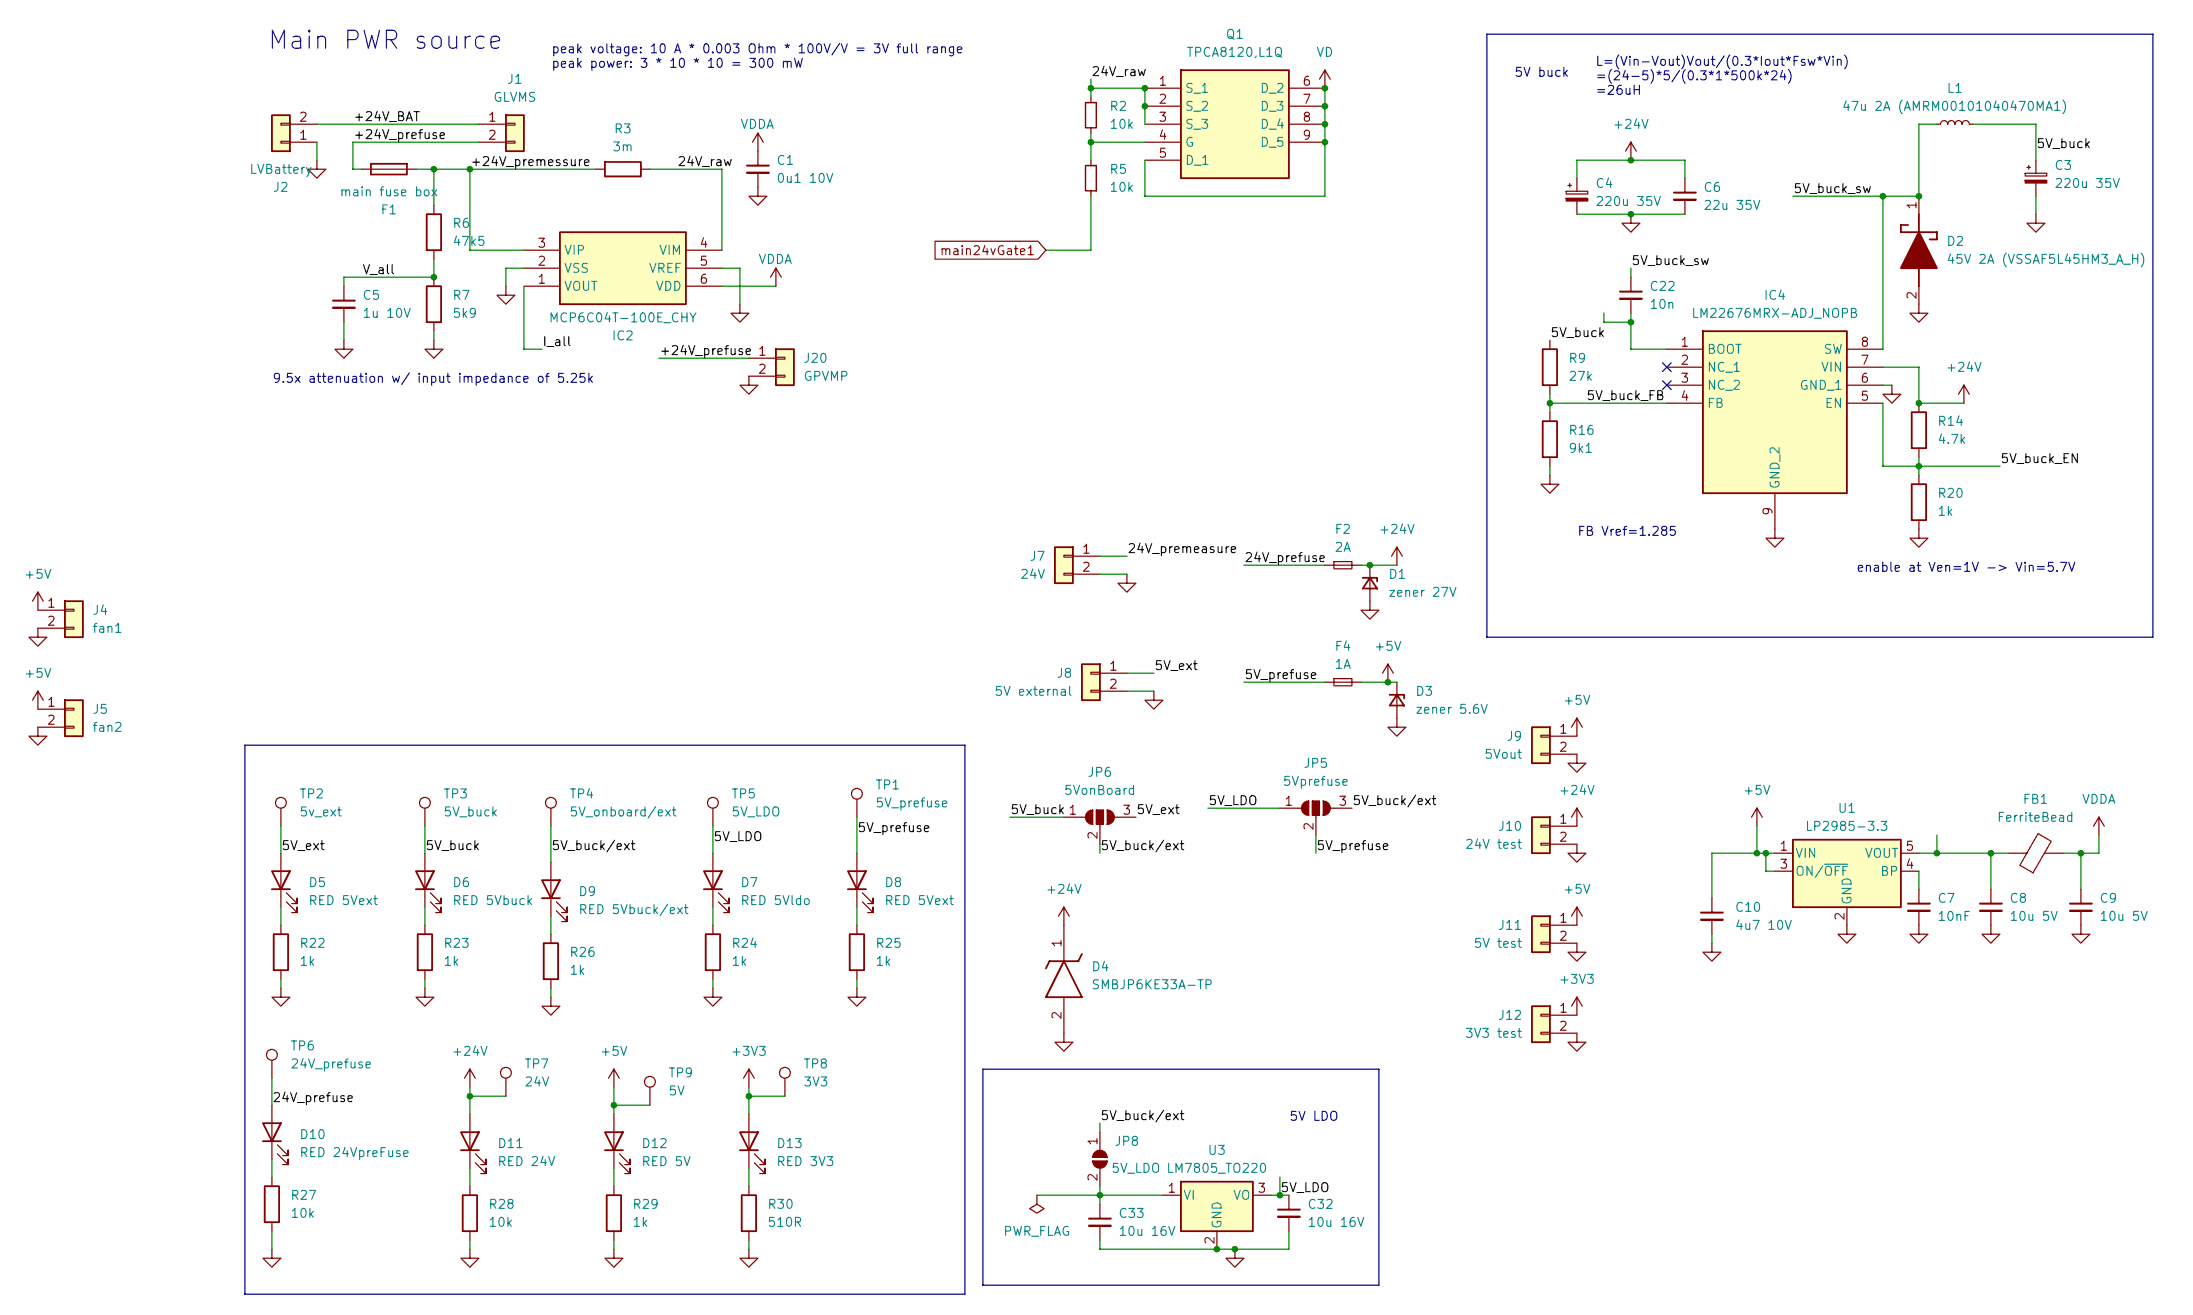
[picture p149: schematic power.kicad_sch]

Parts:
C1: 0u1 10V; C_0805_2012Metric
C3, C4: 220u 35V; CP_Radial_D8.0mm_P3.80mm
C5: 1u 10V; C_0805_2012Metric
C6: 22u 35V; C_1206_3216Metric
C7: 10nF; C_0805_2012Metric
C8, C9: 10u 5V; C_0805_2012Metric
C10: 4u7 10V; C_0805_2012Metric
C22: 10n; C_0603_1608Metric
C32, C33: 10u 16V; C_0805_2012Metric
D1: zener 27V; D_MiniMELF
D2: 45V 2A (VSSAF5L45HM3_A_H); SODFL5226X100N; Mouser Part Number 78-VSSAF5L45HM3_A/H
D3: zener 5.6V; D_MiniMELF
D4: SMBJP6KE33A-TP; DIOM5336X262N; Mouser Part Number 833-SMBJP6KE33A-TP
D5, D8: RED 5Vext; LED_0603_1608Metric
D6: RED 5Vbuck; LED_0603_1608Metric
D7: RED 5Vldo; LED_0603_1608Metric
D9: RED 5Vbuck/ext; LED_0603_1608Metric
D10: RED 24VpreFuse; LED_0603_1608Metric
D11: RED 24V; LED_0603_1608Metric
D12: RED 5V; LED_0603_1608Metric
D13: RED 3V3; LED_0603_1608Metric
F1: main fuse box; Fuseholder_Cylinder-5x20mm_Schurter_0031_8201_Horizontal_Op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
F2: 2A; Fuse_2512_6332Metric_Pad1.52x3.35mm_HandSolder
F4: 1A; Fuse_2512_6332Metric_Pad1.52x3.35mm_HandSolder
FB1: FerriteBead; L_0805_2012Metric
IC2: MCP6C04T-100E_CHY; SOT95P280X145-6N; Mouser Part Number 579-MCP6C04T100ECHY
IC4: LM22676MRX-ADJ_NOPB; SOIC127P600X170-9N; Mouser Part Number 926-LM22676MRXADJNPB
J1: GLVMS; AMASS_XT60PW-M_1x02_P7.20mm_Horizontal
J2: LVBattery; AMASS_XT60PW-M_1x02_P7.20mm_Horizontal
J4: fan1; JST_XH_B2B-XH-A_1x02_P2.50mm_Vertical
J5: fan2; JST_XH_B2B-XH-A_1x02_P2.50mm_Vertical
J7: 24V; JST_XH_B2B-XH-A_1x02_P2.50mm_Vertical
J8: 5V external; JST_XH_B2B-XH-A_1x02_P2.50mm_Vertical
J9: 5Vout; JST_XH_B2B-XH-A_1x02_P2.50mm_Vertical
J10: 24V test; PinHeader_1x02_P2.54mm_Vertical
J11: 5V test; PinHeader_1x02_P2.54mm_Vertical
J12: 3V3 test; PinHeader_1x02_P2.54mm_Vertical
J20: GPVMP; JST_XH_B2B-XH-A_1x02_P2.50mm_Vertical
JP5: 5Vprefuse; SolderJumper-3_P1.3mm_Open_Pad1.0x1.5mm_NumberLabels
JP6: 5VonBoard; SolderJumper-3_P1.3mm_Open_Pad1.0x1.5mm_NumberLabels
JP8: 5V_LDO; SolderJumper-2_P1.3mm_Open_Pad1.0x1.5mm
L1: 47u 2A (AMRM00101040470MA1); AMRM00101040470MA1
Q1: TPCA8120,L1Q; TPH4R003NLL1Q; Mouser Part Number 757-TPCA8120L1Q
R2, R5: 10k; R_0805_2012Metric
R3: 3m; R_1206_3216Metric
R6: 47k5; R_0805_2012Metric
R7: 5k9; R_0805_2012Metric
R9: 27k; R_0603_1608Metric
R14: 4.7k; R_0603_1608Metric
R16: 9k1; R_0603_1608Metric
R20, R22, R23, R24, R25, R26, R29: 1k; R_0603_1608Metric
R27, R28: 10k; R_0603_1608Metric
R30: 510R; R_0603_1608Metric
TP1: 5V_prefuse; TestPoint_Pad_D1.0mm
TP2: 5v_ext; TestPoint_Pad_D1.0mm
TP3: 5V_buck; TestPoint_Pad_D1.0mm
TP4: 5V_onboard/ext; TestPoint_Pad_D1.0mm
TP5: 5V_LDO; TestPoint_Pad_D1.0mm
TP6: 24V_prefuse; TestPoint_Pad_D1.0mm
TP7: 24V; TestPoint_Pad_D1.0mm
TP8: 3V3; TestPoint_Pad_D1.0mm
TP9: 5V; TestPoint_Pad_D1.0mm
U1: LP2985-3.3; SOT-23-5
U3: LM7805_TO220; TO-220-3_Vertical

Connections:
5V_LDO: C32.1, D7.2 (A), JP5.1 (A), TP5.1, U3.3 (VO)
5V_buck: C3.1, D6.2 (A), JP6.1 (A), L1.2, R9.1, TP3.1
5V_buck_EN: IC4.5 (EN), R14.2, R20.1
5V_buck_FB: IC4.4 (FB), R9.2, R16.1
5V_buck_sw: C22.1, D2.1 (K), IC4.8 (SW), L1.1
5V_buck/ext: D9.2 (A), JP5.3 (B), JP6.2 (C), JP8.1 (A), TP4.1
5V_ext: D5.2 (A), J8.1, JP6.3 (B), TP2.1
5V_prefuse: D8.2 (A), F4.1, JP5.2 (C), TP1.1
24V_prefuse: D10.2 (A), F2.1, TP6.1
24V_premeasure: J7.1
24V_raw: IC2.4 (VIM), Q1.1 (S_1), Q1.2 (S_2), Q1.3 (S_3), R2.1, R3.1
+3V3: D13.2 (A), J12.1, TP8.1
+5V: C10.1, D3.1 (K), D12.2 (A), F4.2, J4.1, J5.1, J9.1, J11.1, TP9.1, U1.1 (VIN), U1.3 (ON/~OFF)
+24V: C4.1, C6.1, D1.1 (K), D4.1 (K), D11.2 (A), F2.2, IC4.7 (VIN), J10.1, R14.1, TP7.1
+24V_BAT: J1.1, J2.2
+24V_prefuse: F1.1, J1.2, J20.1
+24V_premessure: F1.2, IC2.3 (VIP), R3.2, R6.1
GND: C1.2, C3.2, C4.2, C5.2, C6.2, C7.2, C8.2, C9.2, C10.2, C32.2, C33.2, D1.2 (A), D2.2 (A), D3.2 (A), D4.2 (A), IC2.2 (VSS), IC2.5 (VREF), IC4.6 (GND_1), IC4.9 (GND_2), J2.1, J4.2, J5.2, J7.2, J8.2, J9.2, J10.2, J11.2, J12.2, J20.2, R7.2, R16.2, R20.2, R22.2, R23.2, R24.2, R25.2, R26.2, R27.2, R28.2, R29.2, R30.2, U1.2 (GND), U3.2 (GND)
I_all: IC2.1 (VOUT)
unnamed: C7.1, U1.4 (BP)
unnamed: C8.1, FB1.1, U1.5 (VOUT)
unnamed: C22.2, IC4.1 (BOOT)
unnamed: C33.1, JP8.2 (B), U3.1 (VI)
unnamed: D5.1 (K), R22.1
unnamed: D6.1 (K), R23.1
unnamed: D7.1 (K), R24.1
unnamed: D8.1 (K), R25.1
unnamed: D9.1 (K), R26.1
unnamed: D10.1 (K), R27.1
unnamed: D11.1 (K), R28.1
unnamed: D12.1 (K), R29.1
unnamed: D13.1 (K), R30.1
unnamed: Q1.4 (G), R2.2, R5.2
VD: Q1.5 (D_1), Q1.6 (D_2), Q1.7 (D_3), Q1.8 (D_4), Q1.9 (D_5)
VDDA: C1.1, C9.1, FB1.2, IC2.6 (VDD)
V_all: C5.1, R6.2, R7.1
main24vGate1: R5.1

Notes on the sheet:
peak voltage: 10 A * 0.003 Ohm * 100V/V = 3V full range peak power: 3 * 10 * 10 = 300 mW
5V LDO
L=(Vin-Vout)Vout/(0.3*Iout*Fsw*Vin) =(24-5)*5/(0.3*1*500k*24) =26uH
9.5x attenuation w/ input impedance of 5.25k
5V buck
Main PWR source
FB Vref=1.285
enable at Ven=1V -> Vin=5.7V
