NTURacingTeam/nturt_kicad/EP5/Electrical Group/rearbox_VCUandPower/5V_3V3.kicad_sch

## KiCad design EP5/Electrical Group/rearbox_VCUandPower/5V_3V3.kicad_sch (2024-10-12)

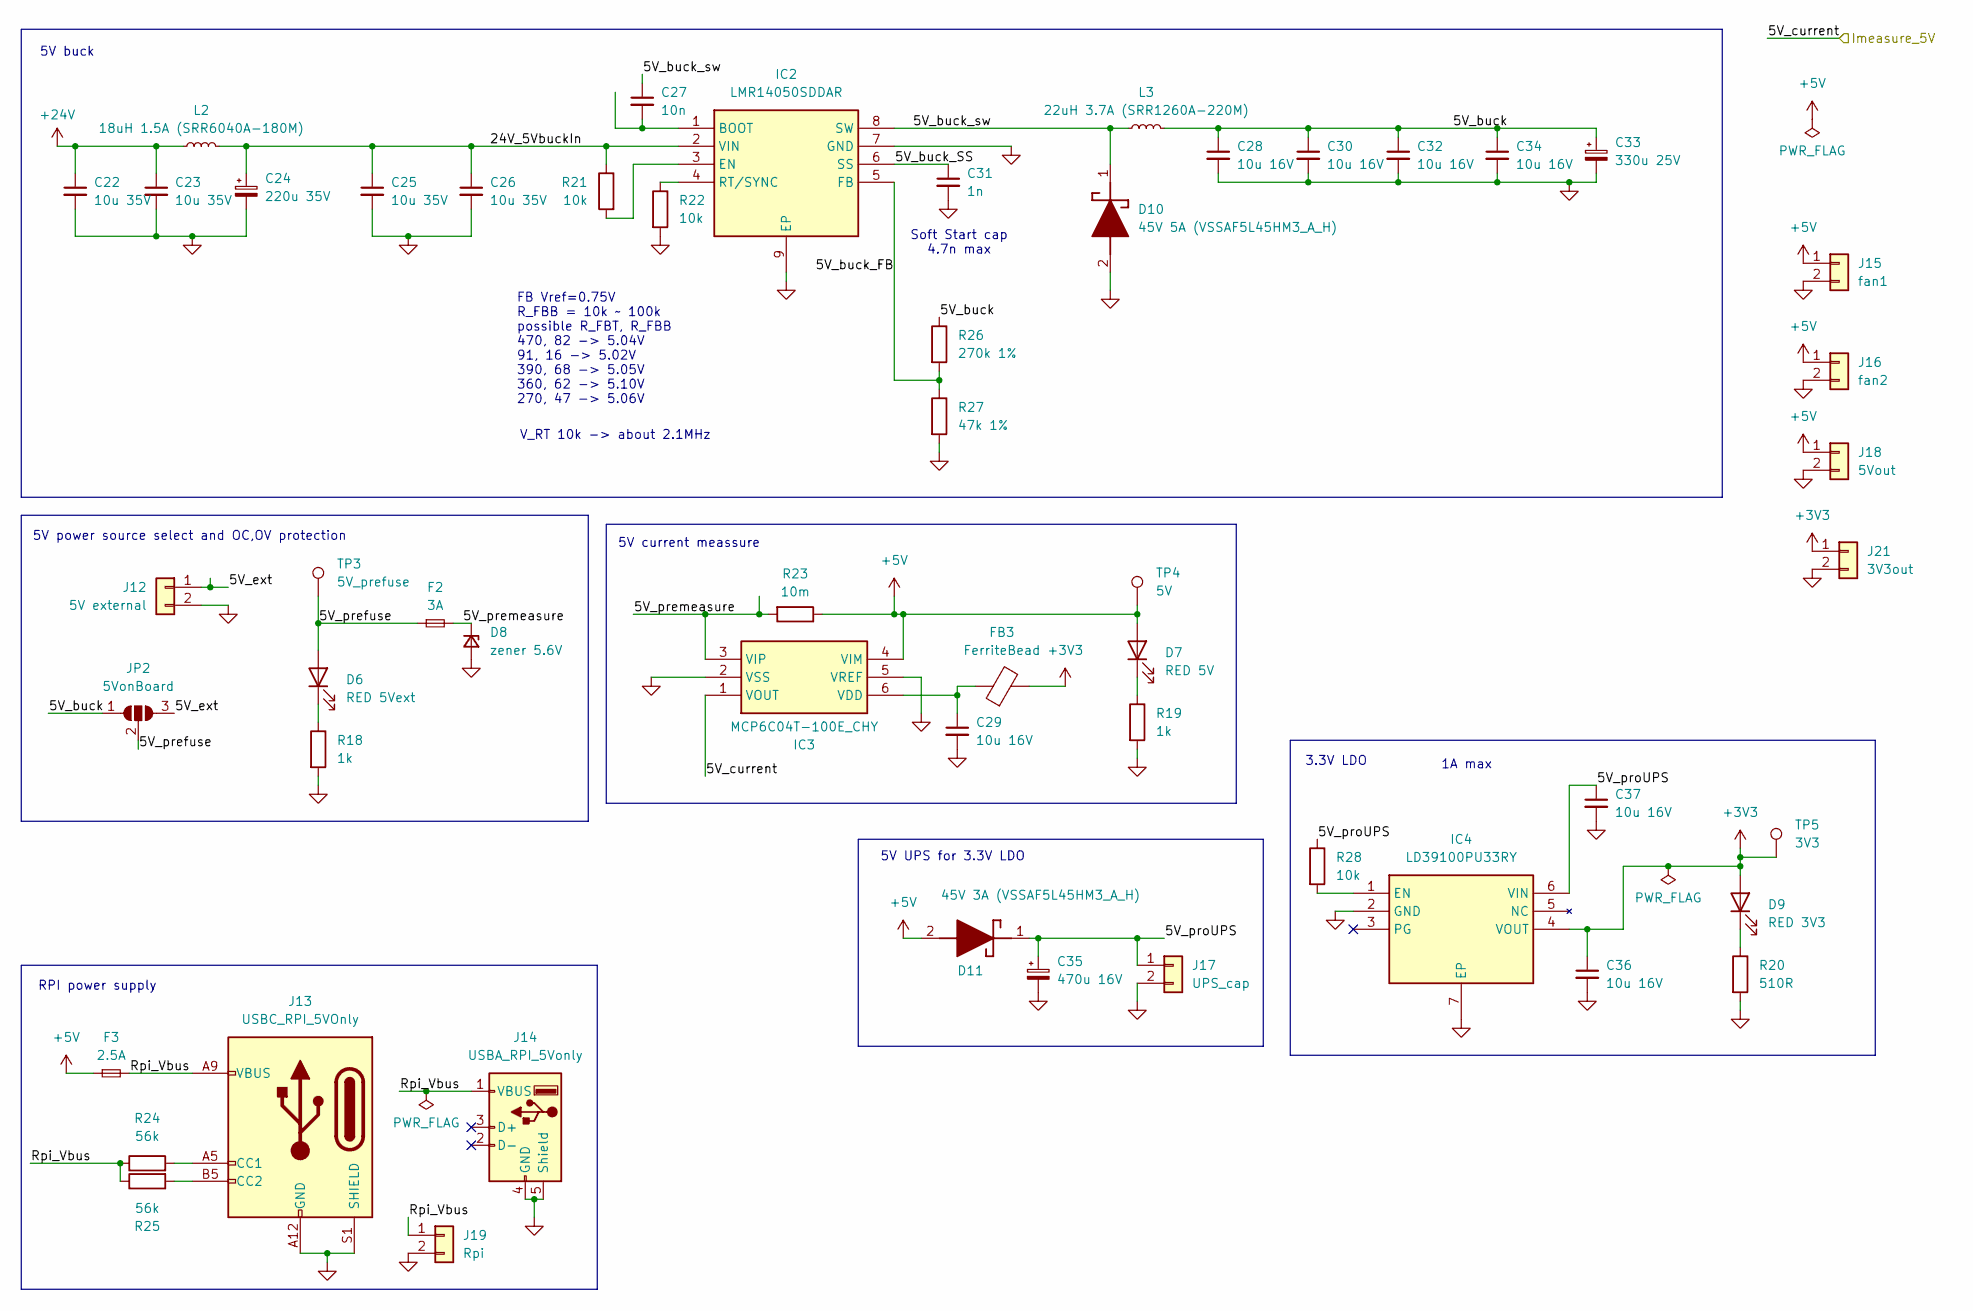
[picture p150: schematic 5V_3V3.kicad_sch]

Parts:
C22, C23, C25, C26: 10u 35V; C_1206_3216Metric
C24: 220u 35V; CP_Radial_D8.0mm_P3.80mm
C27: 10n; C_0603_1608Metric
C28, C29, C30, C32, C34, C36, C37: 10u 16V; C_0805_2012Metric
C31: 1n; C_0603_1608Metric
C33: 330u 25V; CP_Radial_D8.0mm_P3.80mm
C35: 470u 16V; CP_Radial_D8.0mm_P3.80mm
D6: RED 5Vext; LED_0603_1608Metric
D7: RED 5V; LED_0603_1608Metric
D8: zener 5.6V; D_MiniMELF
D9: RED 3V3; LED_0603_1608Metric
D10: 45V 5A (VSSAF5L45HM3_A_H); SODFL5226X100N; Mouser Part Number 78-VSSAF5L45HM3_A/H
D11: 45V 3A (VSSAF5L45HM3_A_H); SODFL5226X100N; Mouser Part Number 78-VSSAF5L45HM3_A/H
F2: 3A; Fuse_2512_6332Metric_Pad1.52x3.35mm_HandSolder
F3: 2.5A; Fuse_2512_6332Metric_Pad1.52x3.35mm_HandSolder
FB3: FerriteBead; L_0805_2012Metric
IC2: LMR14050SDDAR; SOIC127P600X170-9N; Mouser Part Number 595-LMR14050SDDAR
IC3: MCP6C04T-100E_CHY; SOT95P280X145-6N; Mouser Part Number 579-MCP6C04T100ECHY
IC4: LD39100PU33RY; SON95P300X300X90-7N-D; Mouser Part Number 511-LD39100PU33RY
J12: 5V external; JST_XH_B2B-XH-A_1x02_P2.50mm_Vertical
J13: USBC_RPI_5VOnly; USB_C_Receptacle_GCT_USB4135-GF-A_6P_TopMnt_Horizontal
J14: USBA_RPI_5Vonly; USB_A_Molex_67643_Horizontal
J15: fan1; JST_XH_B2B-XH-A_1x02_P2.50mm_Vertical
J16: fan2; JST_XH_B2B-XH-A_1x02_P2.50mm_Vertical
J17: UPS_cap; JST_XH_B2B-XH-A_1x02_P2.50mm_Vertical
J18: 5Vout; JST_XH_B2B-XH-A_1x02_P2.50mm_Vertical
J19: Rpi; JST_XH_B2B-XH-A_1x02_P2.50mm_Vertical
J21: 3V3out; JST_XH_B2B-XH-A_1x02_P2.50mm_Vertical
JP2: 5VonBoard; SolderJumper-3_P1.3mm_Open_Pad1.0x1.5mm
L2: 18uH 1.5A (SRR6040A-180M); SRR6040A180M
L3: 22uH 3.7A (SRR1260A-220M); SRR1260A220M
R18, R19: 1k; R_0603_1608Metric
R20: 510R; R_0603_1608Metric
R21, R22, R28: 10k; R_0603_1608Metric
R23: 10m; R_1206_3216Metric
R24, R25: 56k; R_0603_1608Metric
R26: 270k 1%; R_0603_1608Metric
R27: 47k 1%; R_0603_1608Metric
TP3: 5V_prefuse; TestPoint_Pad_D1.0mm
TP4: 5V; TestPoint_Pad_D1.0mm
TP5: 3V3; TestPoint_Pad_D1.0mm

Connections:
5V_buck: C28.1, C30.1, C32.1, C33.1, C34.1, JP2.1 (A), L3.2, R26.1
5V_buck_FB: IC2.5 (FB), R26.2, R27.1
5V_buck_SS: C31.1, IC2.6 (SS)
5V_buck_sw: C27.1, D10.1 (K), IC2.8 (SW), L3.1
5V_current: IC3.1 (VOUT)
5V_ext: J12.1, JP2.3 (B)
5V_prefuse: D6.2 (A), F2.1, JP2.2 (C), TP3.1
5V_premeasure: D8.1 (K), F2.2, IC3.3 (VIP), R23.2
5V_proUPS: C35.1, C37.1, D11.1 (K), IC4.6 (VIN), J17.1, R28.1
24V_5VbuckIn: C24.1, C25.1, C26.1, IC2.2 (VIN), L2.2, R21.1
+3V3: C36.1, D9.2 (A), FB3.2, IC4.4 (VOUT), J21.1, TP5.1
+5V: D7.2 (A), D11.2 (A), F3.1, IC3.4 (VIM), J15.1, J16.1, J18.1, R23.1, TP4.1
+24V: C22.1, C23.1, L2.1
GND: C22.2, C23.2, C24.2, C25.2, C26.2, C28.2, C29.2, C30.2, C31.2, C32.2, C33.2, C34.2, C35.2, C36.2, C37.2, D8.2 (A), D10.2 (A), IC2.7 (GND), IC2.9 (EP), IC3.2 (VSS), IC3.5 (VREF), IC4.2 (GND), IC4.7 (EP), J12.2, J13.A12 (GND), J13.B12 (GND), J13.S1 (SHIELD), J14.4 (GND), J14.5 (Shield), J15.2, J16.2, J17.2, J18.2, J19.2, J21.2, R18.2, R19.2, R20.2, R22.2, R27.2
unnamed: C27.2, IC2.1 (BOOT)
unnamed: C29.1, FB3.1, IC3.6 (VDD)
unnamed: D6.1 (K), R18.1
unnamed: D7.1 (K), R19.1
unnamed: D9.1 (K), R20.1
unnamed: IC2.3 (EN), R21.2
unnamed: IC2.4 (RT/SYNC), R22.1
unnamed: IC4.1 (EN), R28.2
unnamed: J13.A5 (CC1), R24.2
unnamed: J13.B5 (CC2), R25.2
Rpi_Vbus: F3.2, J13.A9 (VBUS), J13.B9 (VBUS), J14.1 (VBUS), J19.1, R24.1, R25.1

Notes on the sheet:
Soft Start cap 4.7n max
5V UPS for 3.3V LDO
5V power source select and OC,OV protection
RPI power supply
3.3V LDO
V_RT 10k -> about 2.1MHz
5V buck
5V current meassure
FB Vref=0.75V R_FBB = 10k ~ 100k possible R_FBT, R_FBB 470, 82 -> 5.04V 91, 16 -> 5.02V 390, 68 -> 5.05V 360, 62 -> 5.10V 270, 47 -> 5.06V
1A max
