NTURacingTeam/nturt_kicad/EP5/Electrical Group/rearbox_VCUandPower/IMU.kicad_sch

## KiCad design EP5/Electrical Group/rearbox_VCUandPower/IMU.kicad_sch (2024-10-12)

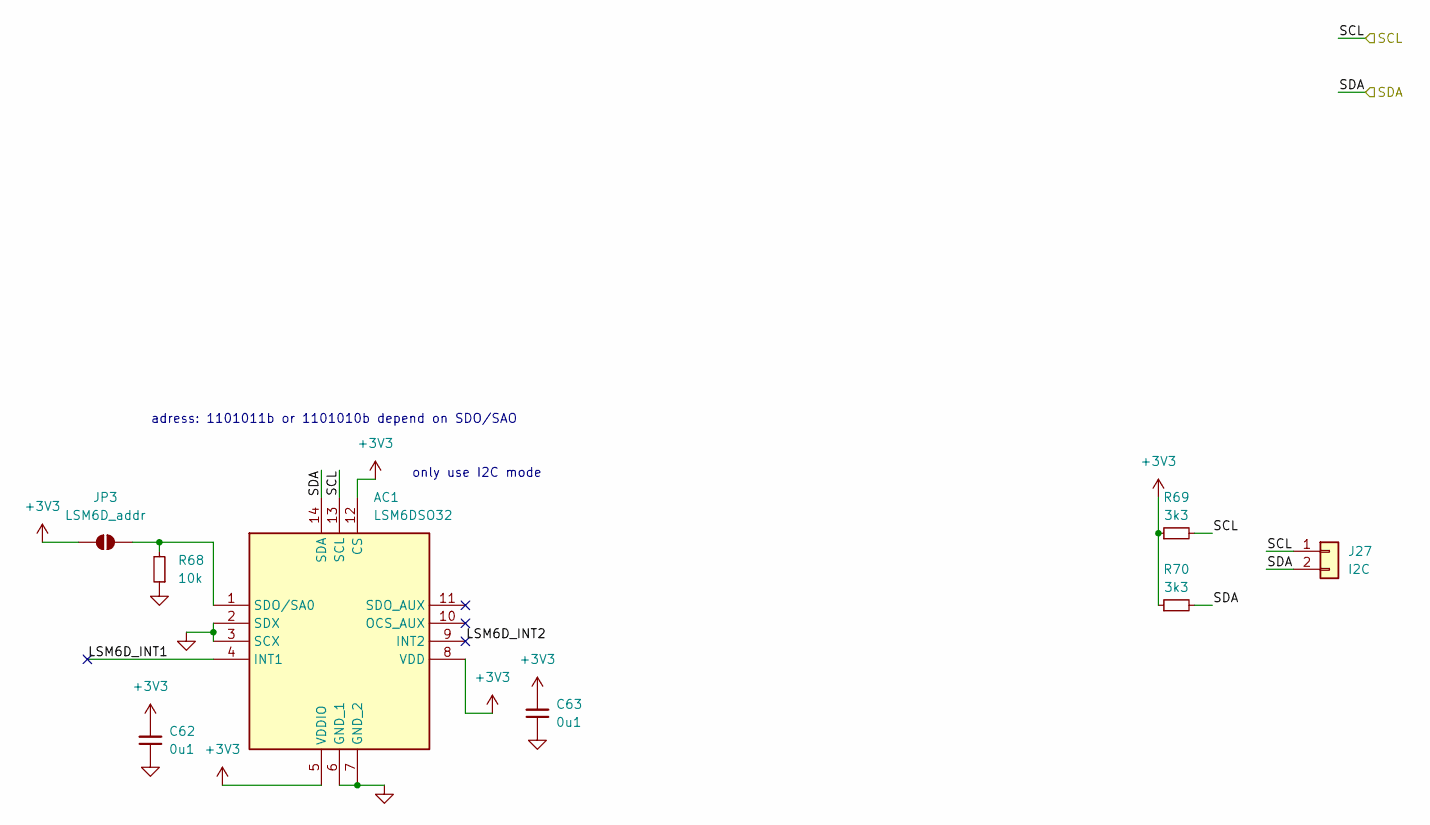
[picture p151: schematic IMU.kicad_sch]

Parts:
AC1: LSM6DSO32; LGA-14_1; Mouser Part Number 511-LSM6DSOXTR
C62, C63: 0u1; C_0603_1608Metric
J27: I2C; JST_XH_B2B-XH-A_1x02_P2.50mm_Vertical
JP3: LSM6D_addr; SolderJumper-2_P1.3mm_Open_RoundedPad1.0x1.5mm
R68: 10k; R_0603_1608Metric
R69, R70: 3k3; R_0603_1608Metric

Connections:
+3V3: AC1.5 (VDDIO), AC1.8 (VDD), AC1.12 (CS), C62.2, C63.2, JP3.1 (A), R69.1, R70.1
GND: AC1.2 (SDX), AC1.3 (SCX), AC1.6 (GND_1), AC1.7 (GND_2), C62.1, C63.1, R68.1
LSM6D_INT1: AC1.4 (INT1)
LSM6D_INT2: AC1.9 (INT2)
unnamed: AC1.1 (SDO/SA0), JP3.2 (B), R68.2
SCL: AC1.13 (SCL), J27.1, R69.2
SDA: AC1.14 (SDA), J27.2, R70.2

Notes on the sheet:
adress: 1101011b or 1101010b depend on SDO/SAO
only use I2C mode
