NTURacingTeam/nturt_kicad/EP5/Electrical Group/rearbox_VCUandPower/electrical1.kicad_sch

## KiCad design EP5/Electrical Group/rearbox_VCUandPower/electrical1.kicad_sch (2024-10-12)

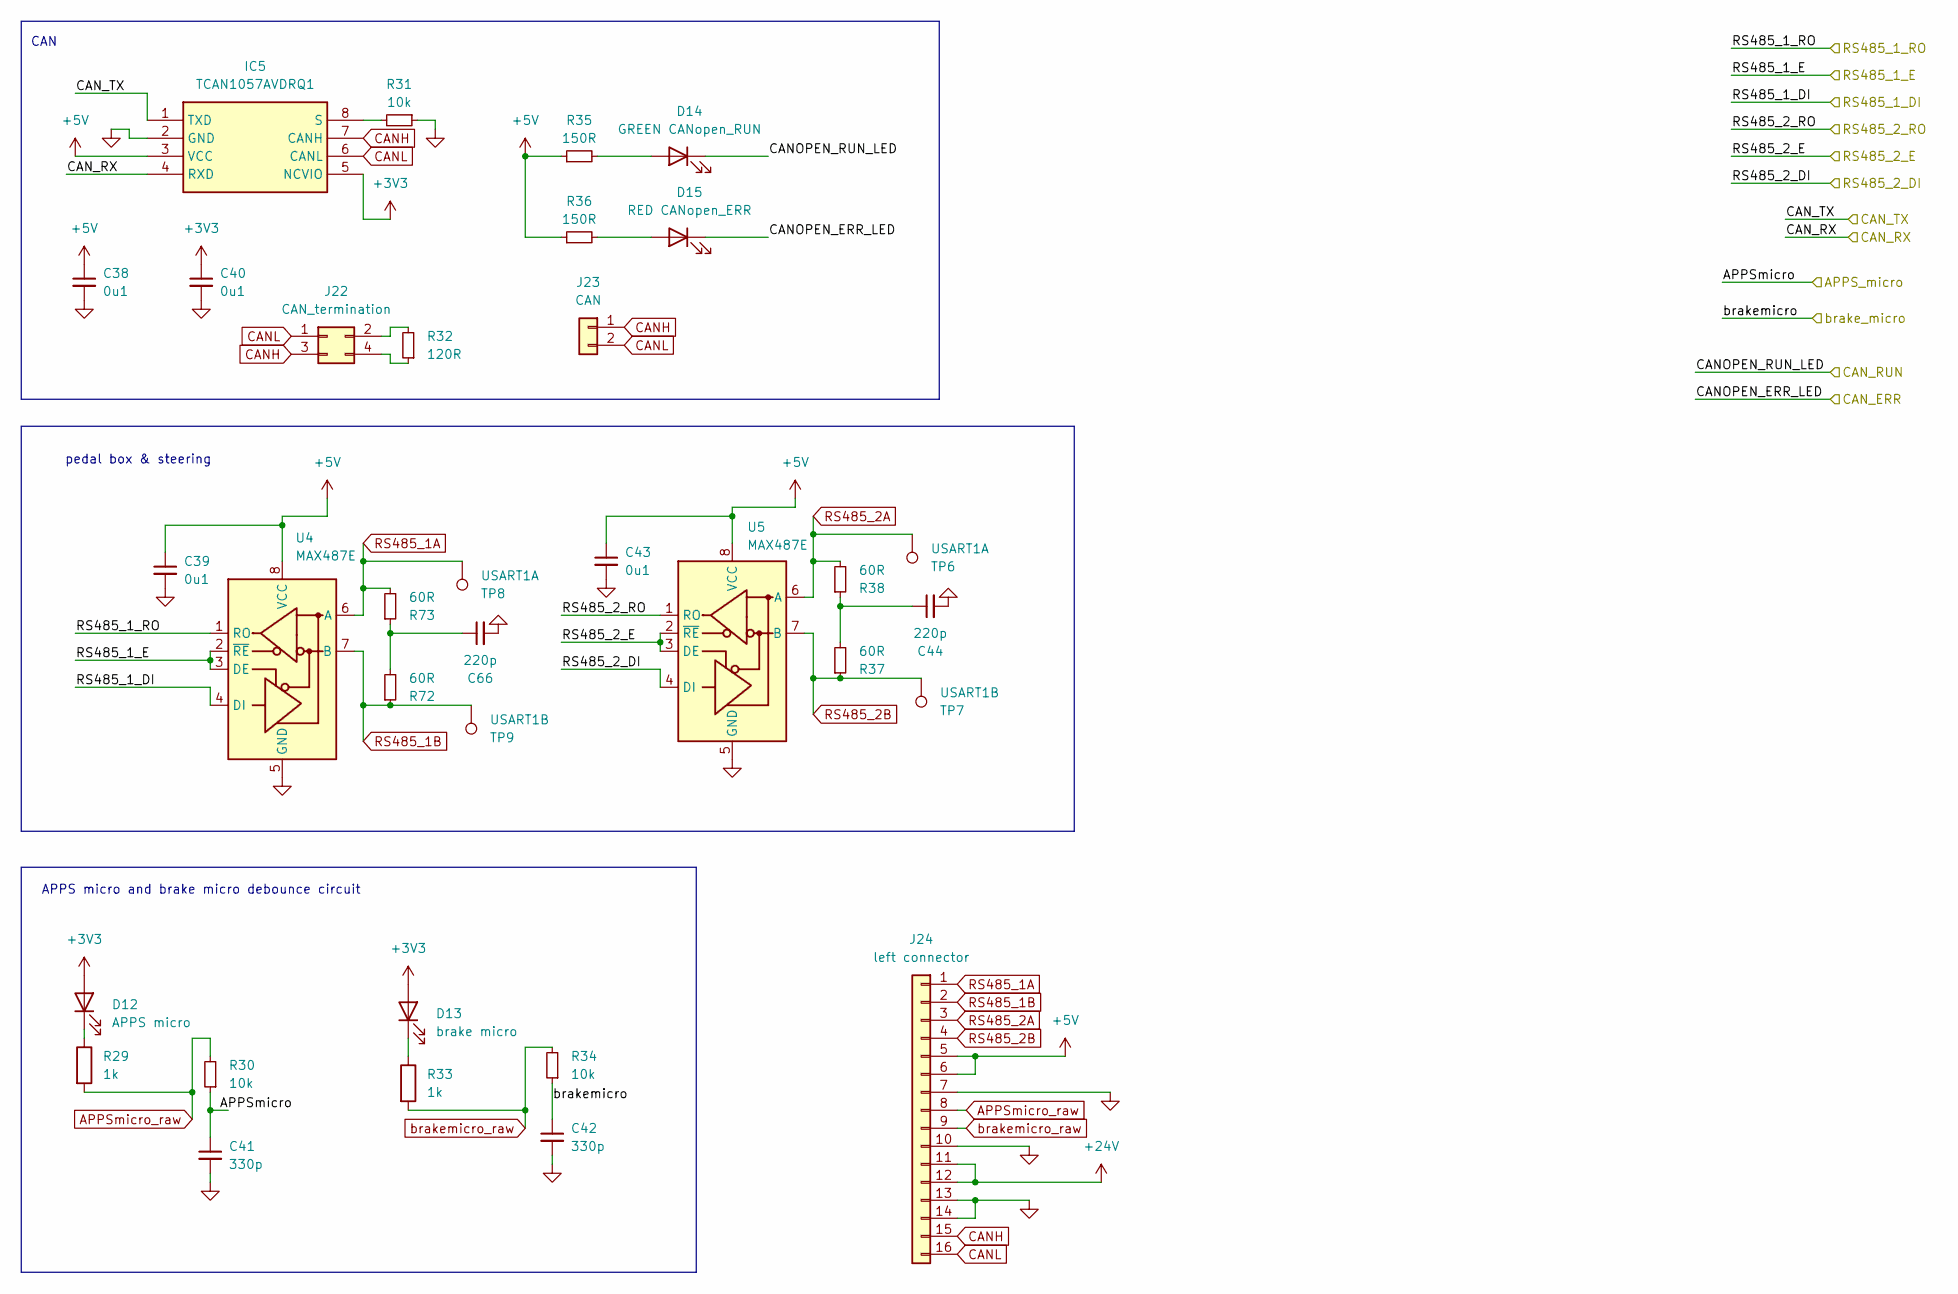
[picture p152: schematic electrical1.kicad_sch]

Parts:
C38, C39, C40, C43: 0u1; C_0603_1608Metric
C41, C42: 330p; C_0603_1608Metric
C44, C66: 220p; C_0603_1608Metric
D12: APPS micro; LED_0603_1608Metric
D13: brake micro; LED_0603_1608Metric
D14: GREEN CANopen_RUN; LED_0603_1608Metric
D15: RED CANopen_ERR; LED_0603_1608Metric
IC5: TCAN1057AVDRQ1; SOIC127P600X175-8N; Mouser Part Number 595-TCAN1057AVDRQ1
J22: CAN_termination; PinHeader_2x02_P2.54mm_Vertical
J23: CAN; JST_XH_B2B-XH-A_1x02_P2.50mm_Vertical
J24: left connector; IDC-Header_2x08_P2.54mm_Vertical
R29, R33: 1k; R_0603_1608Metric
R30, R31, R34: 10k; R_0603_1608Metric
R32: 120R; R_0603_1608Metric
R35, R36: 150R; R_0603_1608Metric
R37, R38, R72, R73: 60R; R_0603_1608Metric
TP6, TP8: USART1A; TestPoint_Pad_D1.0mm
TP7, TP9: USART1B; TestPoint_Pad_D1.0mm
U4, U5: MAX487E; SOIC-8_3.9x4.9mm_P1.27mm

Connections:
+3V3: C40.1, D12.2 (A), D13.2 (A), IC5.5 (NCVIO)
+5V: C38.1, C39.1, C43.1, IC5.3 (VCC), J24.5, J24.6, R35.1, R36.1, U4.8 (VCC), U5.8 (VCC)
+24V: J24.11, J24.12
APPS_micro: C41.1, R30.1
APPSmicro_raw: J24.8, R29.2, R30.2
CANH: IC5.7 (CANH), J22.3, J23.1, J24.15
CANL: IC5.6 (CANL), J22.1, J23.2, J24.16
CAN_ERR: D15.1 (K)
CAN_RUN: D14.1 (K)
CAN_RX: IC5.4 (RXD)
CAN_TX: IC5.1 (TXD)
GND: C38.2, C39.2, C40.2, C41.2, C42.2, C43.2, C44.2, C66.2, IC5.2 (GND), J24.7, J24.10, J24.13, J24.14, R31.1, U4.5 (GND), U5.5 (GND)
unnamed: C44.1, R37.2, R38.1
unnamed: C66.1, R72.2, R73.1
unnamed: D12.1 (K), R29.1
unnamed: D13.1 (K), R33.1
unnamed: D14.2 (A), R35.2
unnamed: D15.2 (A), R36.2
unnamed: IC5.8 (S), R31.2
unnamed: J22.2, R32.2
unnamed: J22.4, R32.1
RS485_1A: J24.1, R73.2, TP8.1, U4.6 (A)
RS485_1B: J24.2, R72.1, TP9.1, U4.7 (B)
RS485_1_DI: U4.4 (DI)
RS485_1_E: U4.2 (~RE), U4.3 (DE)
RS485_1_RO: U4.1 (RO)
RS485_2A: J24.3, R38.2, TP6.1, U5.6 (A)
RS485_2B: J24.4, R37.1, TP7.1, U5.7 (B)
RS485_2_DI: U5.4 (DI)
RS485_2_E: U5.2 (~RE), U5.3 (DE)
RS485_2_RO: U5.1 (RO)
brake_micro: C42.1, R34.1
brakemicro_raw: J24.9, R33.2, R34.2

Notes on the sheet:
CAN
APPS micro and brake micro debounce circuit
pedal box & steering
