NTURacingTeam/nturt_kicad/EP5/Electrical Group/rearbox_VCUandPower/electrical2.kicad_sch

## KiCad design EP5/Electrical Group/rearbox_VCUandPower/electrical2.kicad_sch (2024-10-12)

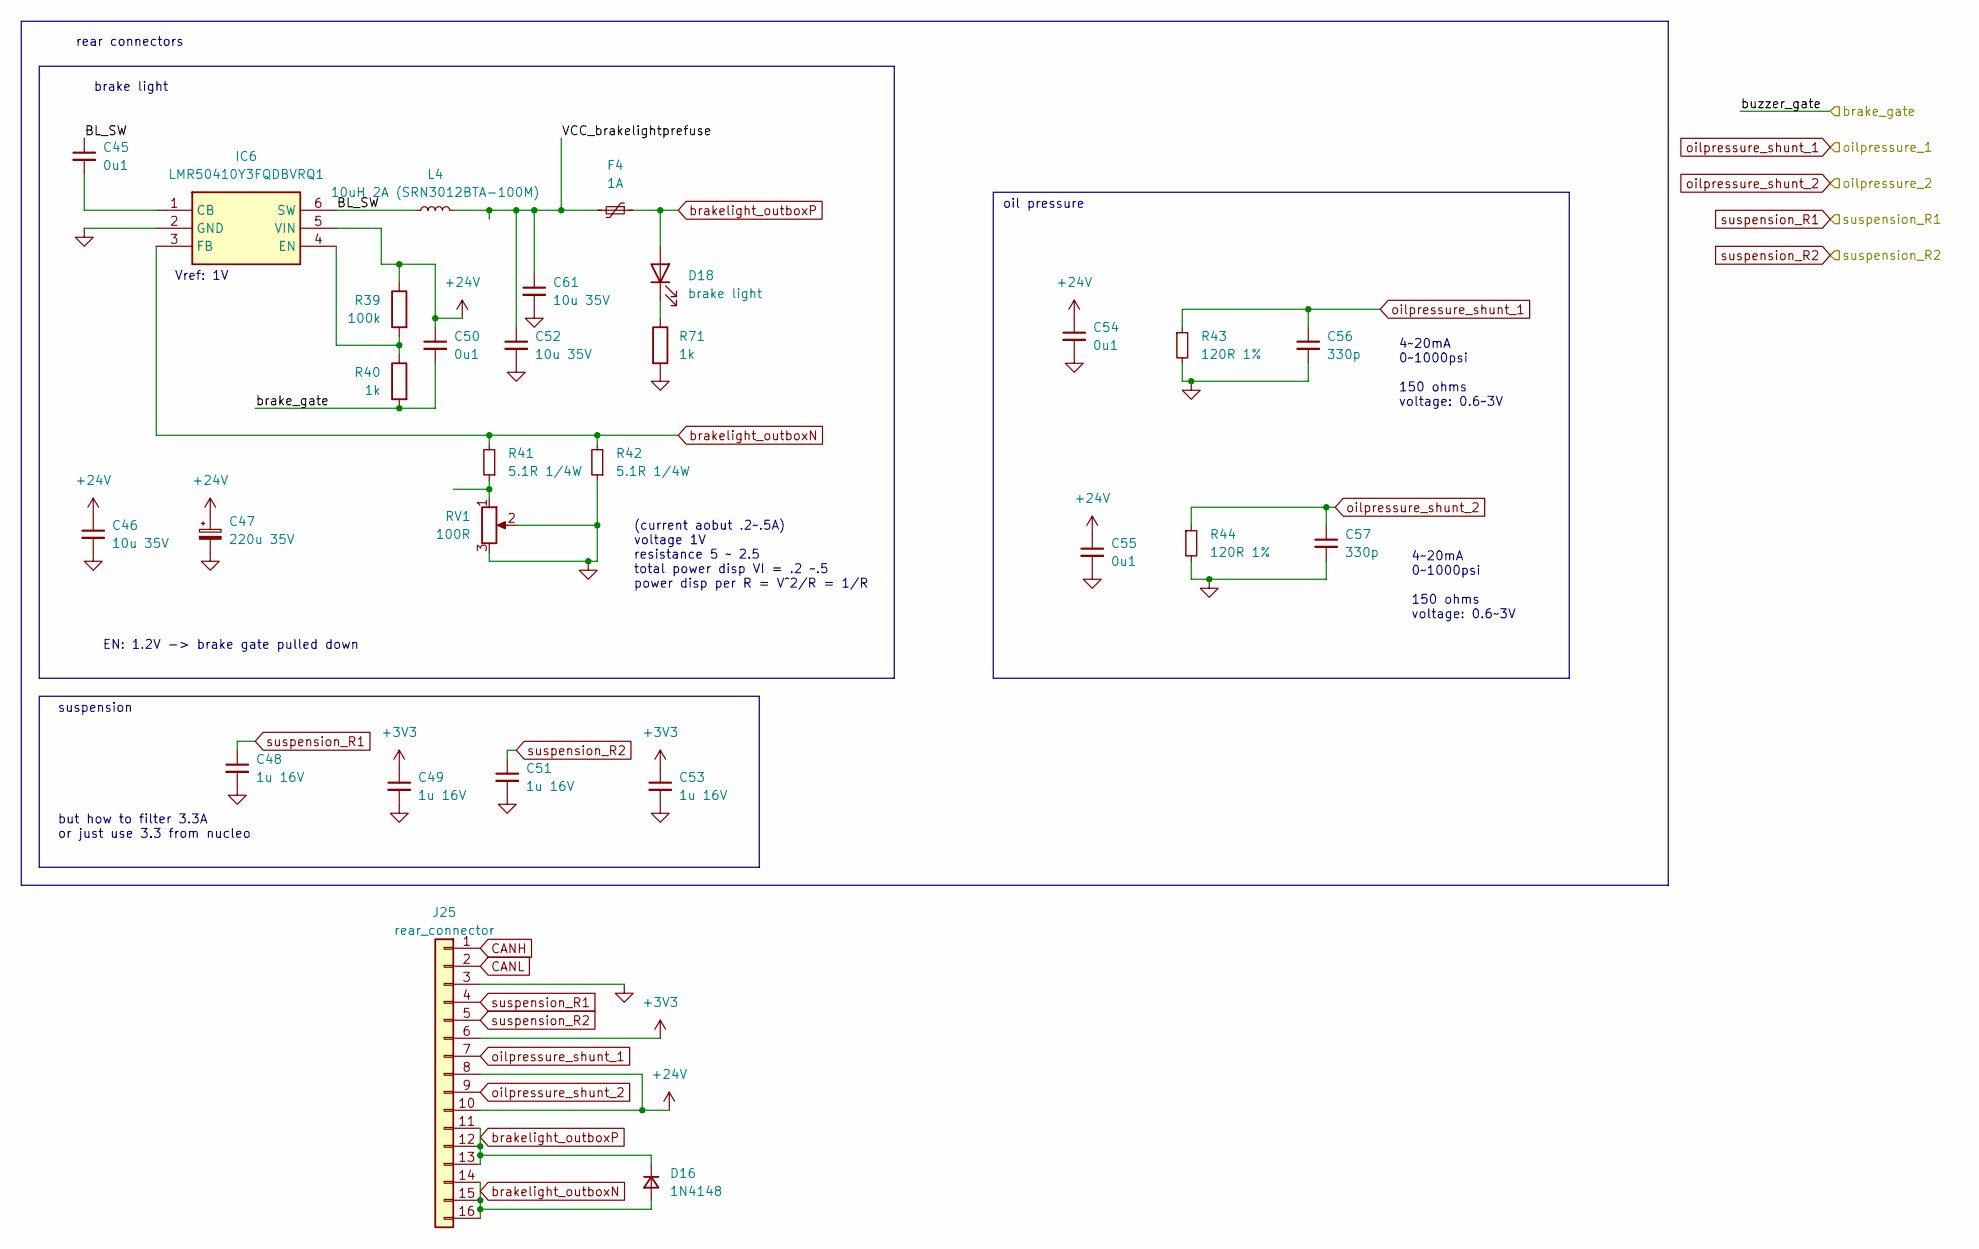
[picture p153: schematic electrical2.kicad_sch]

Parts:
C45, C50, C54, C55: 0u1; C_0603_1608Metric
C46, C52, C61: 10u 35V; C_1206_3216Metric
C47: 220u 35V; CP_Radial_D8.0mm_P3.80mm
C48, C49, C51, C53: 1u 16V; C_0603_1608Metric
C56, C57: 330p; C_0603_1608Metric
D16: 1N4148; D_MiniMELF
D18: brake light; LED_0603_1608Metric
F4: 1A; Fuse_1206_3216Metric
IC6: LMR50410Y3FQDBVRQ1; SOT95P280X145-6N; Mouser Part Number 595-R50410Y3FQDBVRQ1
J25: rear_connector; IDC-Header_2x08_P2.54mm_Vertical
L4: 10uH 2A (SRN3012BTA-100M); SRN3012BTA100M
R39: 100k; R_0603_1608Metric
R40, R71: 1k; R_0603_1608Metric
R41, R42: 5.1R 1/4W; R_Axial_DIN0207_L6.3mm_D2.5mm_P7.62mm_Horizontal
R43, R44: 120R 1%; R_0805_2012Metric
RV1: 100R; Potentiometer_Vishay_T73YP_Vertical

Connections:
+3V3: C49.1, C53.1, J25.6
+24V: C46.1, C47.1, C50.1, C54.1, C55.1, IC6.5 (VIN), J25.8, J25.10, R39.1
BL_SW: C45.1, IC6.6 (SW), L4.1
CANH: J25.1
CANL: J25.2
GND: C46.2, C47.2, C48.2, C49.2, C51.2, C52.2, C53.2, C54.2, C55.2, C56.2, C57.2, C61.2, IC6.2 (GND), J25.3, R42.1, R43.2, R44.2, R71.2, RV1.2, RV1.3
unnamed: C45.2, IC6.1 (CB)
unnamed: D18.1 (K), R71.1
unnamed: IC6.4 (EN), R39.2, R40.1
unnamed: R41.1, RV1.1
VCC_brakelightprefuse: C52.1, C61.1, F4.2, L4.2
brake_gate: C50.2, R40.2
brakelight_outboxN: D16.2 (A), IC6.3 (FB), J25.14, J25.15, J25.16, R41.2, R42.2
brakelight_outboxP: D16.1 (K), D18.2 (A), F4.1, J25.11, J25.12, J25.13
oilpressure_shunt_1: C56.1, J25.7, R43.1
oilpressure_shunt_2: C57.1, J25.9, R44.1
suspension_R1: C48.1, J25.4
suspension_R2: C51.1, J25.5

Notes on the sheet:
brake light
4~20mA 0~1000psi 150 ohms voltage: 0.6~3V
suspension
(current aobut .2~.5A) voltage 1V resistance 5 ~ 2.5 total power disp VI = .2 ~.5 power disp per R = V^2/R = 1/R
Vref: 1V
oil pressure
EN: 1.2V -> brake gate pulled down
rear connectors
but how to filter 3.3A or just use 3.3 from nucleo
