NTURacingTeam/nturt_kicad/EP5/Electrical Group/rearbox_VCUandPower/electrical3.kicad_sch

## KiCad design EP5/Electrical Group/rearbox_VCUandPower/electrical3.kicad_sch (2024-10-12)

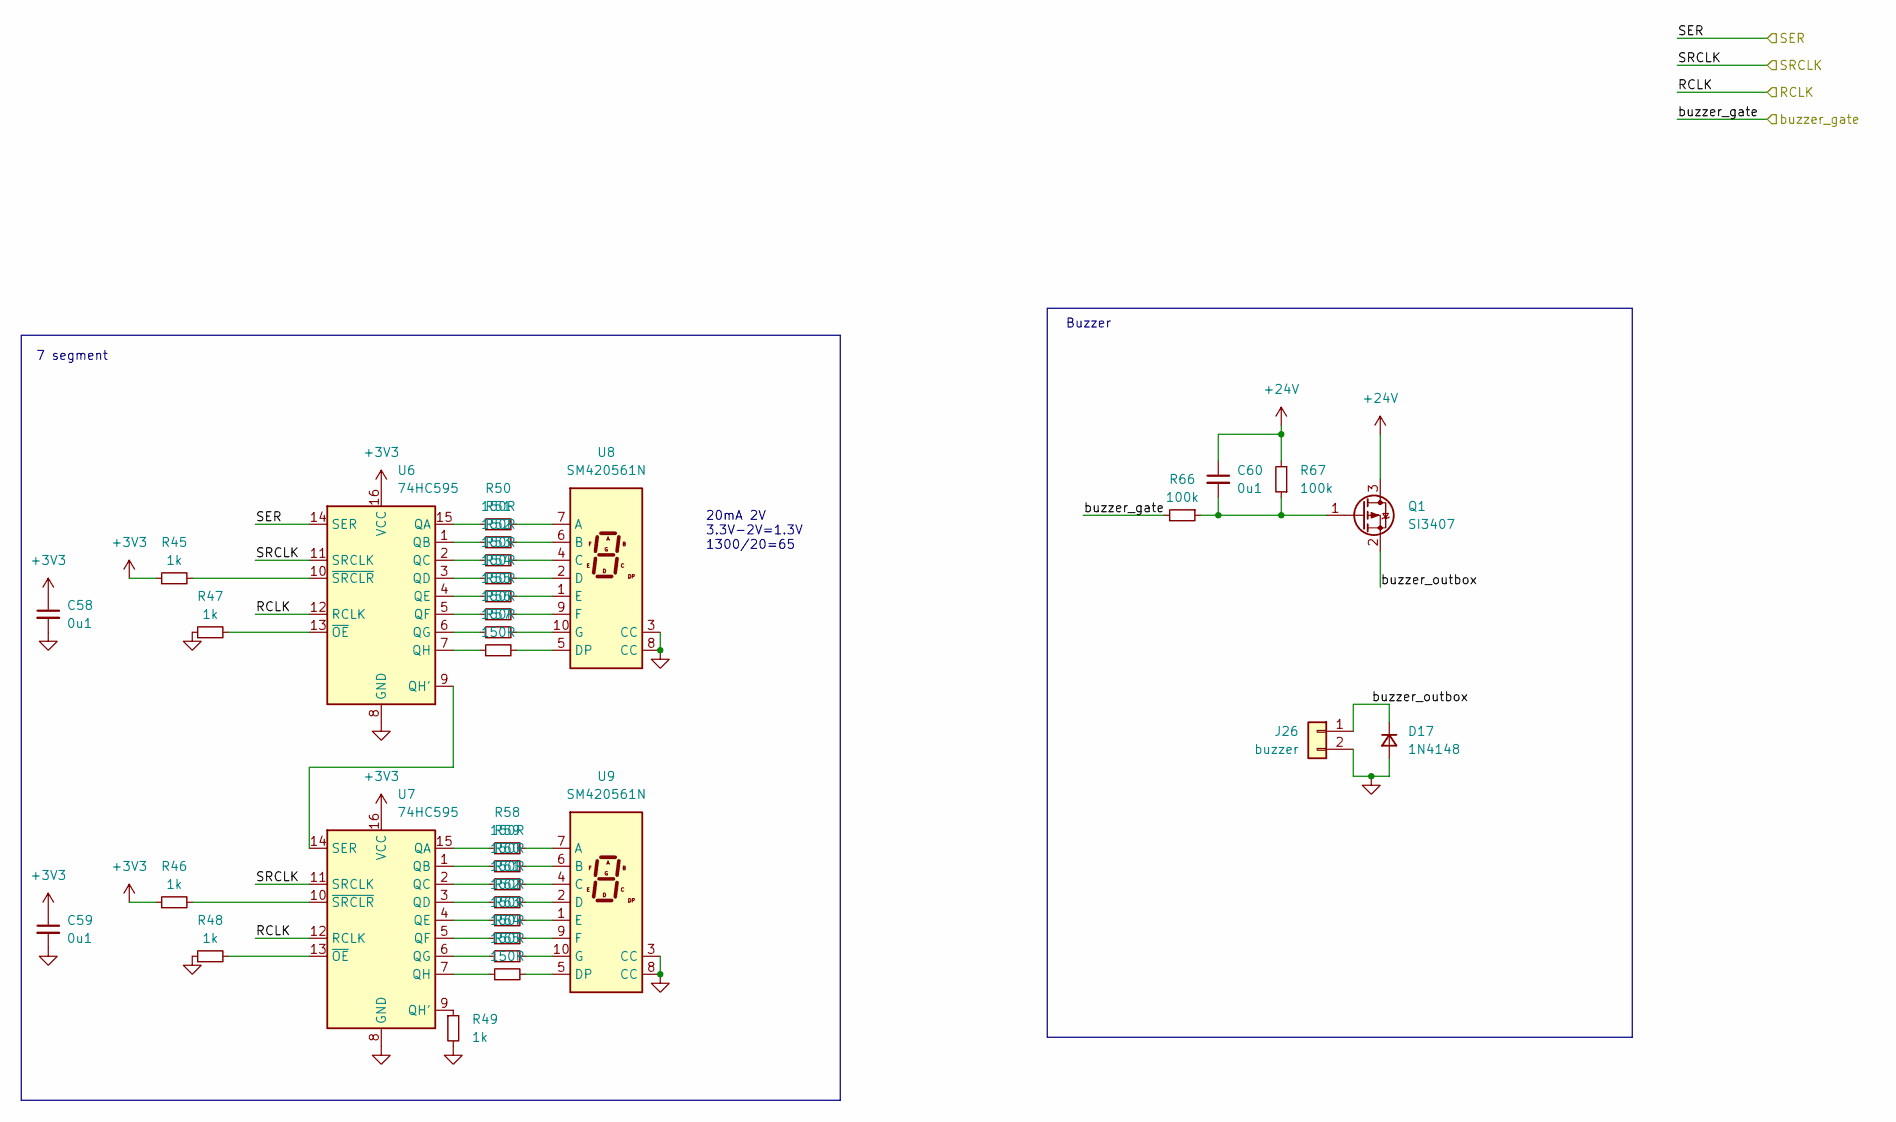
[picture p154: schematic electrical3.kicad_sch]

Parts:
C58, C59, C60: 0u1; C_0603_1608Metric
D17: 1N4148; D_MiniMELF
J26: buzzer; JST_XH_B2B-XH-A_1x02_P2.50mm_Vertical
Q1: SI3407; SOT-23-3
R45, R46, R47, R48, R49: 1k; R_0603_1608Metric
R50, R51, R52, R53, R54, R55, R56, R57, R58, R59, R60, R61, R62, R63, R64, R65: 150R; R_0603_1608Metric
R66, R67: 100k; R_0603_1608Metric
U6, U7: 74HC595; SOIC-16_3.9x9.9mm_P1.27mm
U8, U9: SM420561N; 7SegmentLED_LTS6760_LTS6780

Connections:
+3V3: C58.1, C59.1, R45.1, R46.1, U6.16 (VCC), U7.16 (VCC)
+24V: C60.1, Q1.3 (D), R67.2
GND: C58.2, C59.2, D17.2 (A), J26.2, R47.1, R48.1, R49.2, U6.8 (GND), U7.8 (GND), U8.3 (CC), U8.8 (CC), U9.3 (CC), U9.8 (CC)
unnamed: C60.2, Q1.1 (G), R66.1, R67.1
unnamed: R45.2, U6.10 (~SRCLR)
unnamed: R46.2, U7.10 (~SRCLR)
unnamed: R47.2, U6.13 (~OE)
unnamed: R48.2, U7.13 (~OE)
unnamed: R49.1, U7.9 (QH')
unnamed: R50.1, U6.15 (QA)
unnamed: R50.2, U8.7 (A)
unnamed: R51.1, U6.1 (QB)
unnamed: R51.2, U8.6 (B)
unnamed: R52.1, U6.2 (QC)
unnamed: R52.2, U8.4 (C)
unnamed: R53.1, U6.3 (QD)
unnamed: R53.2, U8.2 (D)
unnamed: R54.1, U6.4 (QE)
unnamed: R54.2, U8.1 (E)
unnamed: R55.1, U6.5 (QF)
unnamed: R55.2, U8.9 (F)
unnamed: R56.1, U6.6 (QG)
unnamed: R56.2, U8.10 (G)
unnamed: R57.1, U6.7 (QH)
unnamed: R57.2, U8.5 (DP)
unnamed: R58.1, U7.15 (QA)
unnamed: R58.2, U9.7 (A)
unnamed: R59.1, U7.1 (QB)
unnamed: R59.2, U9.6 (B)
unnamed: R60.1, U7.2 (QC)
unnamed: R60.2, U9.4 (C)
unnamed: R61.1, U7.3 (QD)
unnamed: R61.2, U9.2 (D)
unnamed: R62.1, U7.4 (QE)
unnamed: R62.2, U9.1 (E)
unnamed: R63.1, U7.5 (QF)
unnamed: R63.2, U9.9 (F)
unnamed: R64.1, U7.6 (QG)
unnamed: R64.2, U9.10 (G)
unnamed: R65.1, U7.7 (QH)
unnamed: R65.2, U9.5 (DP)
unnamed: U6.9 (QH'), U7.14 (SER)
RCLK: U6.12 (RCLK), U7.12 (RCLK)
SER: U6.14 (SER)
SRCLK: U6.11 (SRCLK), U7.11 (SRCLK)
buzzer_gate: R66.2
buzzer_outbox: D17.1 (K), J26.1, Q1.2 (S)

Notes on the sheet:
Buzzer
7 segment
20mA 2V 3.3V-2V=1.3V 1300/20=65
