NTURacingTeam/nturt_kicad/EP5/Electrical Group/rearbox_VCUandPower/power.kicad_sch

## KiCad design EP5/Electrical Group/rearbox_VCUandPower/power.kicad_sch (2024-10-12)

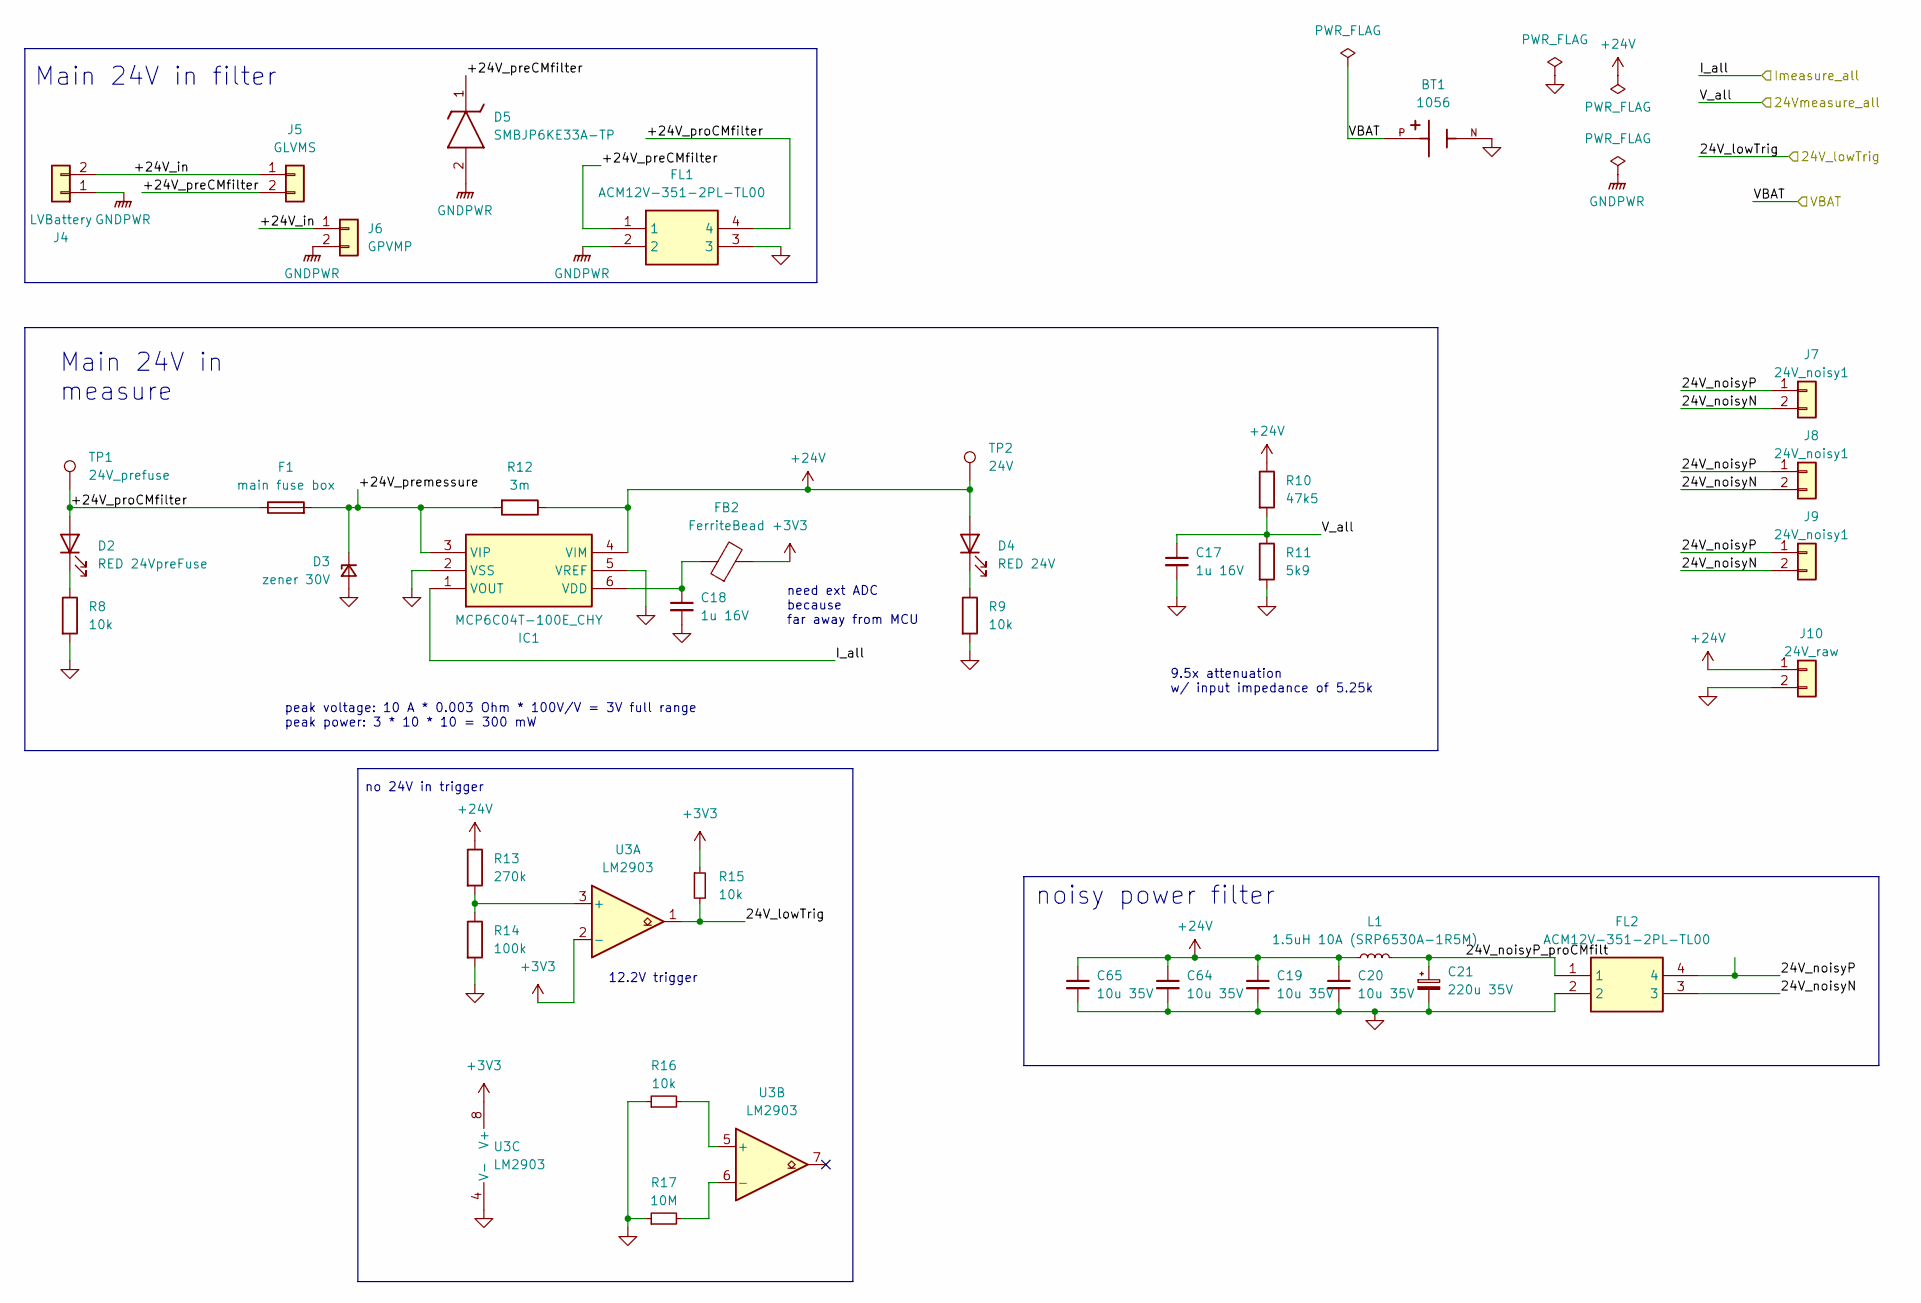
[picture p155: schematic power.kicad_sch]

Parts:
BT1: 1056; BAT_1056; PARTREV D
C17, C18: 1u 16V; C_0603_1608Metric
C19, C20, C64, C65: 10u 35V; C_1206_3216Metric
C21: 220u 35V; CP_Radial_D8.0mm_P3.80mm
D2: RED 24VpreFuse; LED_0603_1608Metric
D3: zener 30V; D_MiniMELF
D4: RED 24V; LED_0603_1608Metric
D5: SMBJP6KE33A-TP; DIOM5336X262N; Mouser Part Number 833-SMBJP6KE33A-TP
F1: main fuse box; Fuseholder_Cylinder-5x20mm_Schurter_0031_8201_Horizontal_Op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
FB2: FerriteBead; L_0805_2012Metric
FL1, FL2: ACM12V-351-2PL-TL00; ACM12V3512PLTL00; Mouser Part Number 810-ACM12V-351-2PLTL
IC1: MCP6C04T-100E_CHY; SOT95P280X145-6N; Mouser Part Number 579-MCP6C04T100ECHY
J4: LVBattery; AMASS_XT60PW-M_1x02_P7.20mm_Horizontal
J5: GLVMS; JST_VH_B2P-VH_1x02_P3.96mm_Vertical
J6: GPVMP; JST_XH_B2B-XH-A_1x02_P2.50mm_Vertical
J7, J8, J9: 24V_noisy1; Molex_KK-396_A-41791-0002_1x02_P3.96mm_Vertical
J10: 24V_raw; Molex_KK-396_A-41791-0002_1x02_P3.96mm_Vertical
L1: 1.5uH 10A (SRP6530A-1R5M); SRR6040A180M
R8, R9, R15, R16: 10k; R_0603_1608Metric
R10: 47k5; R_0805_2012Metric
R11: 5k9; R_0805_2012Metric
R12: 3m; R_1206_3216Metric
R13: 270k; R_0805_2012Metric
R14: 100k; R_0805_2012Metric
R17: 10M; R_0603_1608Metric
TP1: 24V_prefuse; TestPoint_Pad_D1.0mm
TP2: 24V; TestPoint_Pad_D1.0mm
U3: LM2903; SOIC-8_3.9x4.9mm_P1.27mm

Connections:
24V_lowTrig: R15.2, U3.1
24V_noisyN: FL2.3, J7.2, J8.2, J9.2
24V_noisyP: FL2.4, J7.1, J8.1, J9.1
24V_noisyP_proCMfilt: C21.1, FL2.1, L1.2
24Vmeasure_all: C17.1, R10.2, R11.1
+3V3: FB2.2, R15.1, U3.2 (-), U3.8 (V+)
+24V: C19.1, C20.1, C64.1, C65.1, D4.2 (A), IC1.4 (VIM), J10.1, L1.1, R10.1, R12.1, R13.1, TP2.1
+24V_in: J4.2, J5.1, J6.1
+24V_preCMfilter: D5.1 (K), FL1.1, J5.2
+24V_premessure: D3.1 (K), F1.2, IC1.3 (VIP), R12.2
+24V_proCMfilter: D2.2 (A), F1.1, FL1.4, TP1.1
GND: BT1.N, C17.2, C18.2, C19.2, C20.2, C21.2, C64.2, C65.2, D3.2 (A), FL1.3, FL2.2, IC1.2 (VSS), IC1.5 (VREF), J10.2, R8.2, R9.2, R11.2, R14.2, R16.1, R17.1, U3.4 (V-)
GNDPWR: D5.2 (A), FL1.2, J4.1, J6.2
I_all: IC1.1 (VOUT)
unnamed: C18.1, FB2.1, IC1.6 (VDD)
unnamed: D2.1 (K), R8.1
unnamed: D4.1 (K), R9.1
unnamed: R13.2, R14.1, U3.3 (+)
unnamed: R16.2, U3.5 (+)
unnamed: R17.2, U3.6 (-)
VBAT: BT1.P

Notes on the sheet:
peak voltage: 10 A * 0.003 Ohm * 100V/V = 3V full range peak power: 3 * 10 * 10 = 300 mW
need ext ADC because far away from MCU
no 24V in trigger
9.5x attenuation w/ input impedance of 5.25k
Main 24V in filter
noisy power filter
Main 24V in measure
12.2V trigger
