NTURacingTeam/nturt_kicad/EP5/Electrical Group/rearbox_VCUandPower/rearbox_VCUandPower.kicad_sch

## KiCad design EP5/Electrical Group/rearbox_VCUandPower/rearbox_VCUandPower.kicad_sch (2024-10-12)

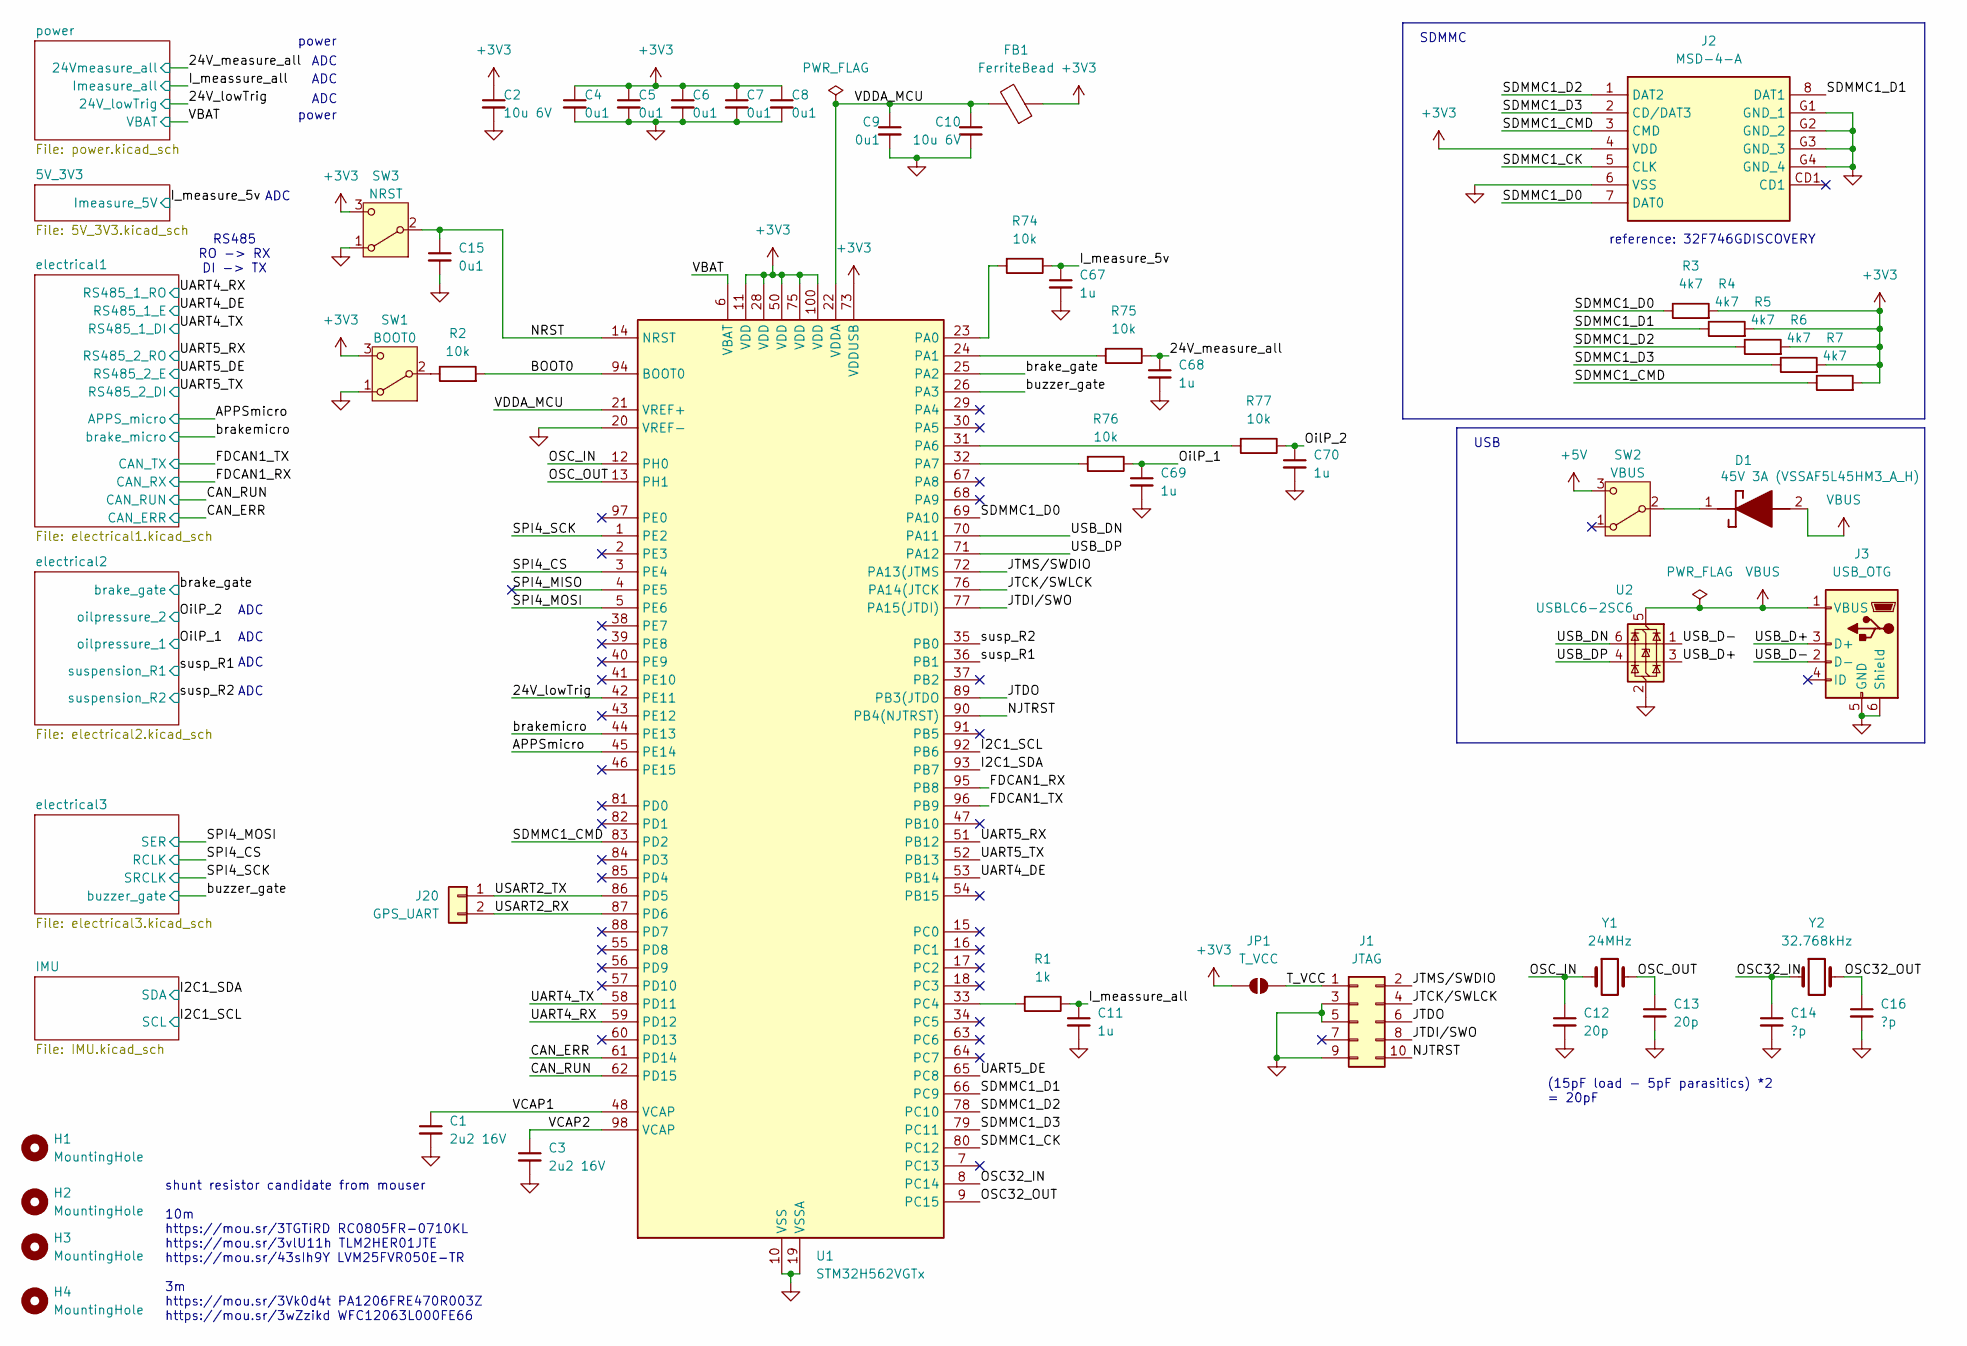
[picture p156: schematic rearbox_VCUandPower.kicad_sch]

Parts:
C1, C3: 2u2 16V; C_0603_1608Metric
C2, C10: 10u 6V; C_0603_1608Metric
C4, C5, C6, C7, C8, C9, C15: 0u1; C_0603_1608Metric
C11, C67, C68, C69, C70: 1u; C_0603_1608Metric
C12, C13: 20p; C_0603_1608Metric
C14, C16: ?p; C_0603_1608Metric
D1: 45V 3A (VSSAF5L45HM3_A_H); SODFL5226X100N; Mouser Part Number 78-VSSAF5L45HM3_A/H
FB1: FerriteBead; L_0805_2012Metric
H1, H2, H3, H4: MountingHole; MountingHole_3.2mm_M3
J1: JTAG; IDC-Header_2x05_P2.00mm_Vertical
J2: MSD-4-A; MSD4A; Mouser Part Number 179-MSD-4-A
J3: USB_OTG; USB_Micro-B_Wuerth_629105150521
J20: GPS_UART; JST_XH_B2B-XH-A_1x02_P2.50mm_Vertical
JP1: T_VCC; SolderJumper-2_P1.3mm_Open_RoundedPad1.0x1.5mm
R1: 1k; R_0603_1608Metric
R2, R74, R75, R76, R77: 10k; R_0603_1608Metric
R3, R4, R5, R6, R7: 4k7; R_0603_1608Metric
SW1: BOOT0; PinHeader_1x03_P2.54mm_Vertical
SW2: VBUS; PinHeader_1x03_P2.54mm_Vertical
SW3: NRST; PinHeader_1x03_P2.54mm_Vertical
U1: STM32H562VGTx; LQFP-100_14x14mm_P0.5mm
U2: USBLC6-2SC6; SOT-23-6
Y1: 24MHz; Crystal_C38-LF_D3.0mm_L8.0mm_Vertical
Y2: 32.768kHz; Crystal_C38-LF_D3.0mm_L8.0mm_Vertical

Connections:
24V_lowTrig: U1.42 (PE11)
24V_measure_all: C68.1, R75.1
+3V3: C2.1, C4.1, C5.1, C6.1, C7.1, C8.1, FB1.1, J2.4 (VDD), JP1.1 (A), R3.2, R4.2, R5.2, R6.2, R7.2, SW1.3 (C), SW3.3 (C), U1.11 (VDD), U1.28 (VDD), U1.50 (VDD), U1.73 (VDDUSB), U1.75 (VDD), U1.100 (VDD)
+5V: SW2.3 (C)
APPSmicro: U1.45 (PE14)
BOOT0: R2.2, U1.94 (BOOT0)
CAN_ERR: U1.61 (PD14)
CAN_RUN: U1.62 (PD15)
FDCAN1_RX: U1.95 (PB8)
FDCAN1_TX: U1.96 (PB9)
GND: C1.2, C2.2, C3.2, C4.2, C5.2, C6.2, C7.2, C8.2, C9.2, C10.2, C11.2, C12.2, C13.2, C14.2, C15.2, C16.2, C67.2, C68.2, C69.2, C70.2, J1.3, J1.5, J1.9, J2.6 (VSS), J2.G1 (GND_1), J2.G2 (GND_2), J2.G3 (GND_3), J2.G4 (GND_4), J3.5 (GND), J3.6 (Shield), SW1.1 (A), SW3.1 (A), U1.10 (VSS), U1.19 (VSSA), U1.20 (VREF-), U1.27 (VSS), U1.49 (VSS), U1.74 (VSS), U1.99 (VSS), U2.2 (GND)
I2C1_SCL: U1.92 (PB6)
I2C1_SDA: U1.93 (PB7)
I_meassure_all: C11.1, R1.1
I_measure_5v: C67.1, R74.1
JTCK/SWLCK: J1.4, U1.76 (PA14(JTCK)
JTDI/SWO: J1.8, U1.77 (PA15(JTDI))
JTDO: J1.6, U1.89 (PB3(JTDO)
JTMS/SWDIO: J1.2, U1.72 (PA13(JTMS)
NJTRST: J1.10, U1.90 (PB4(NJTRST))
NRST: C15.1, SW3.2 (B), U1.14 (NRST)
unnamed: D1.1 (K), SW2.2 (B)
unnamed: R1.2, U1.33 (PC4)
unnamed: R2.1, SW1.2 (B)
unnamed: R74.2, U1.23 (PA0)
unnamed: R75.2, U1.24 (PA1)
unnamed: R76.2, U1.32 (PA7)
unnamed: R77.2, U1.31 (PA6)
OSC32_IN: C14.1, U1.8 (PC14), Y2.1
OSC32_OUT: C16.1, U1.9 (PC15), Y2.2
OSC_IN: C12.1, U1.12 (PH0), Y1.1
OSC_OUT: C13.1, U1.13 (PH1), Y1.2
OilP_1: C69.1, R76.1
OilP_2: C70.1, R77.1
SDMMC1_CK: J2.5 (CLK), U1.80 (PC12)
SDMMC1_CMD: J2.3 (CMD), R7.1, U1.83 (PD2)
SDMMC1_D0: J2.7 (DAT0), R3.1, U1.69 (PA10)
SDMMC1_D1: J2.8 (DAT1), R4.1, U1.66 (PC9)
SDMMC1_D2: J2.1 (DAT2), R5.1, U1.78 (PC10)
SDMMC1_D3: J2.2 (CD/DAT3), R6.1, U1.79 (PC11)
SPI4_CS: U1.3 (PE4)
SPI4_MISO: U1.4 (PE5)
SPI4_MOSI: U1.5 (PE6)
SPI4_SCK: U1.1 (PE2)
T_VCC: J1.1, JP1.2 (B)
UART4_DE: U1.53 (PB14)
UART4_RX: U1.59 (PD12)
UART4_TX: U1.58 (PD11)
UART5_DE: U1.65 (PC8)
UART5_RX: U1.51 (PB12)
UART5_TX: U1.52 (PB13)
USART2_RX: J20.2, U1.87 (PD6)
USART2_TX: J20.1, U1.86 (PD5)
USB_D+: J3.3 (D+), U2.3 (I/O2)
USB_D-: J3.2 (D-), U2.1 (I/O1)
USB_DN: U1.70 (PA11), U2.6 (I/O1)
USB_DP: U1.71 (PA12), U2.4 (I/O2)
VBAT: U1.6 (VBAT)
VBUS: D1.2 (A), J3.1 (VBUS), U2.5 (VBUS)
VCAP1: C1.1, U1.48 (VCAP)
VCAP2: C3.1, U1.98 (VCAP)
VDDA_MCU: C9.1, C10.1, FB1.2, U1.21 (VREF+), U1.22 (VDDA)
brake_gate: U1.25 (PA2)
brakemicro: U1.44 (PE13)
buzzer_gate: U1.26 (PA3)
susp_R1: U1.36 (PB1)
susp_R2: U1.35 (PB0)

Notes on the sheet:
ADC
USB
power
SDMMC
reference: 32F746GDISCOVERY
(15pF load - 5pF parasitics) *2 = 20pF
shunt resistor candidate from mouser 10m https://mou.sr/3TGTiRD RC0805FR-0710KL https://mou.sr/3vlU11h TLM2HER01JTE https://mou.sr/43sIh9Y LVM25FVR050E-TR 3m https://mou.sr/3Vk0d4t PA1206FRE470R003Z https://mou.sr/3wZzikd WFC12063L000FE66
RS485 RO -> RX DI -> TX
