NTURacingTeam/nturt_kicad/EP5/Electrical Group/rearbox_left_connector/rearbox_left_connector.kicad_sch

## KiCad design EP5/Electrical Group/rearbox_left_connector/rearbox_left_connector.kicad_sch (2024-10-12)

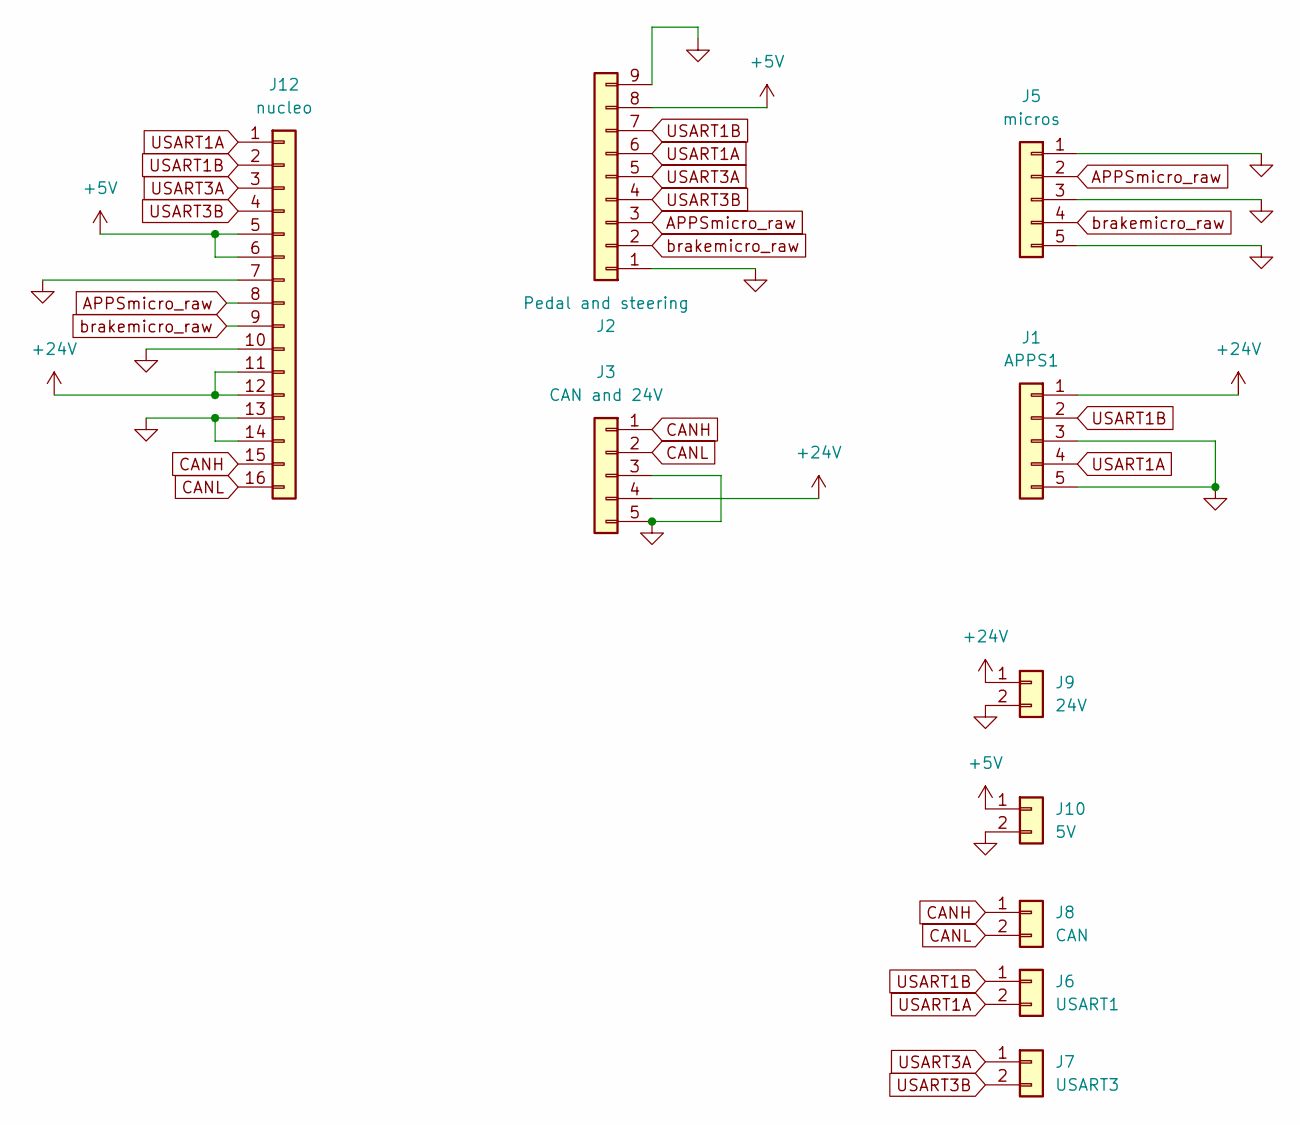
[picture p157: schematic rearbox_left_connector.kicad_sch]

Parts:
J1: APPS1; WP-04F3-26-11
J2: Pedal and steering; WP-08M3-14-11
J3: CAN and 24V; WP-04F3-26-11
J5: micros; WP-04F3-26-11
J6: USART1; JST_XH_B2B-XH-A_1x02_P2.50mm_Vertical
J7: USART3; JST_XH_B2B-XH-A_1x02_P2.50mm_Vertical
J8: CAN; JST_XH_B2B-XH-A_1x02_P2.50mm_Vertical
J9: 24V; JST_XH_B2B-XH-A_1x02_P2.50mm_Vertical
J10: 5V; JST_XH_B2B-XH-A_1x02_P2.50mm_Vertical
J12: nucleo; IDC-Header_2x08_P2.54mm_Vertical

Connections:
+5V: J2.8, J10.1, J12.5, J12.6
+24V: J1.1, J3.4, J9.1, J12.11, J12.12
APPSmicro_raw: J2.3, J5.2, J12.8
CANH: J3.1, J8.1, J12.15
CANL: J3.2, J8.2, J12.16
GND: J1.3, J1.5, J2.1, J2.9, J3.3, J3.5, J5.1, J5.3, J5.5, J9.2, J10.2, J12.7, J12.10, J12.13, J12.14
USART1A: J1.4, J2.6, J6.2, J12.1
USART1B: J1.2, J2.7, J6.1, J12.2
USART3A: J2.5, J7.1, J12.3
USART3B: J2.4, J7.2, J12.4
brakemicro_raw: J2.2, J5.4, J12.9
