NTURacingTeam/nturt_kicad/EP5/Electrical Group/rearbox_nucleo_1/electronic3.kicad_sch

## KiCad design EP5/Electrical Group/rearbox_nucleo_1/electronic3.kicad_sch (2024-10-12)

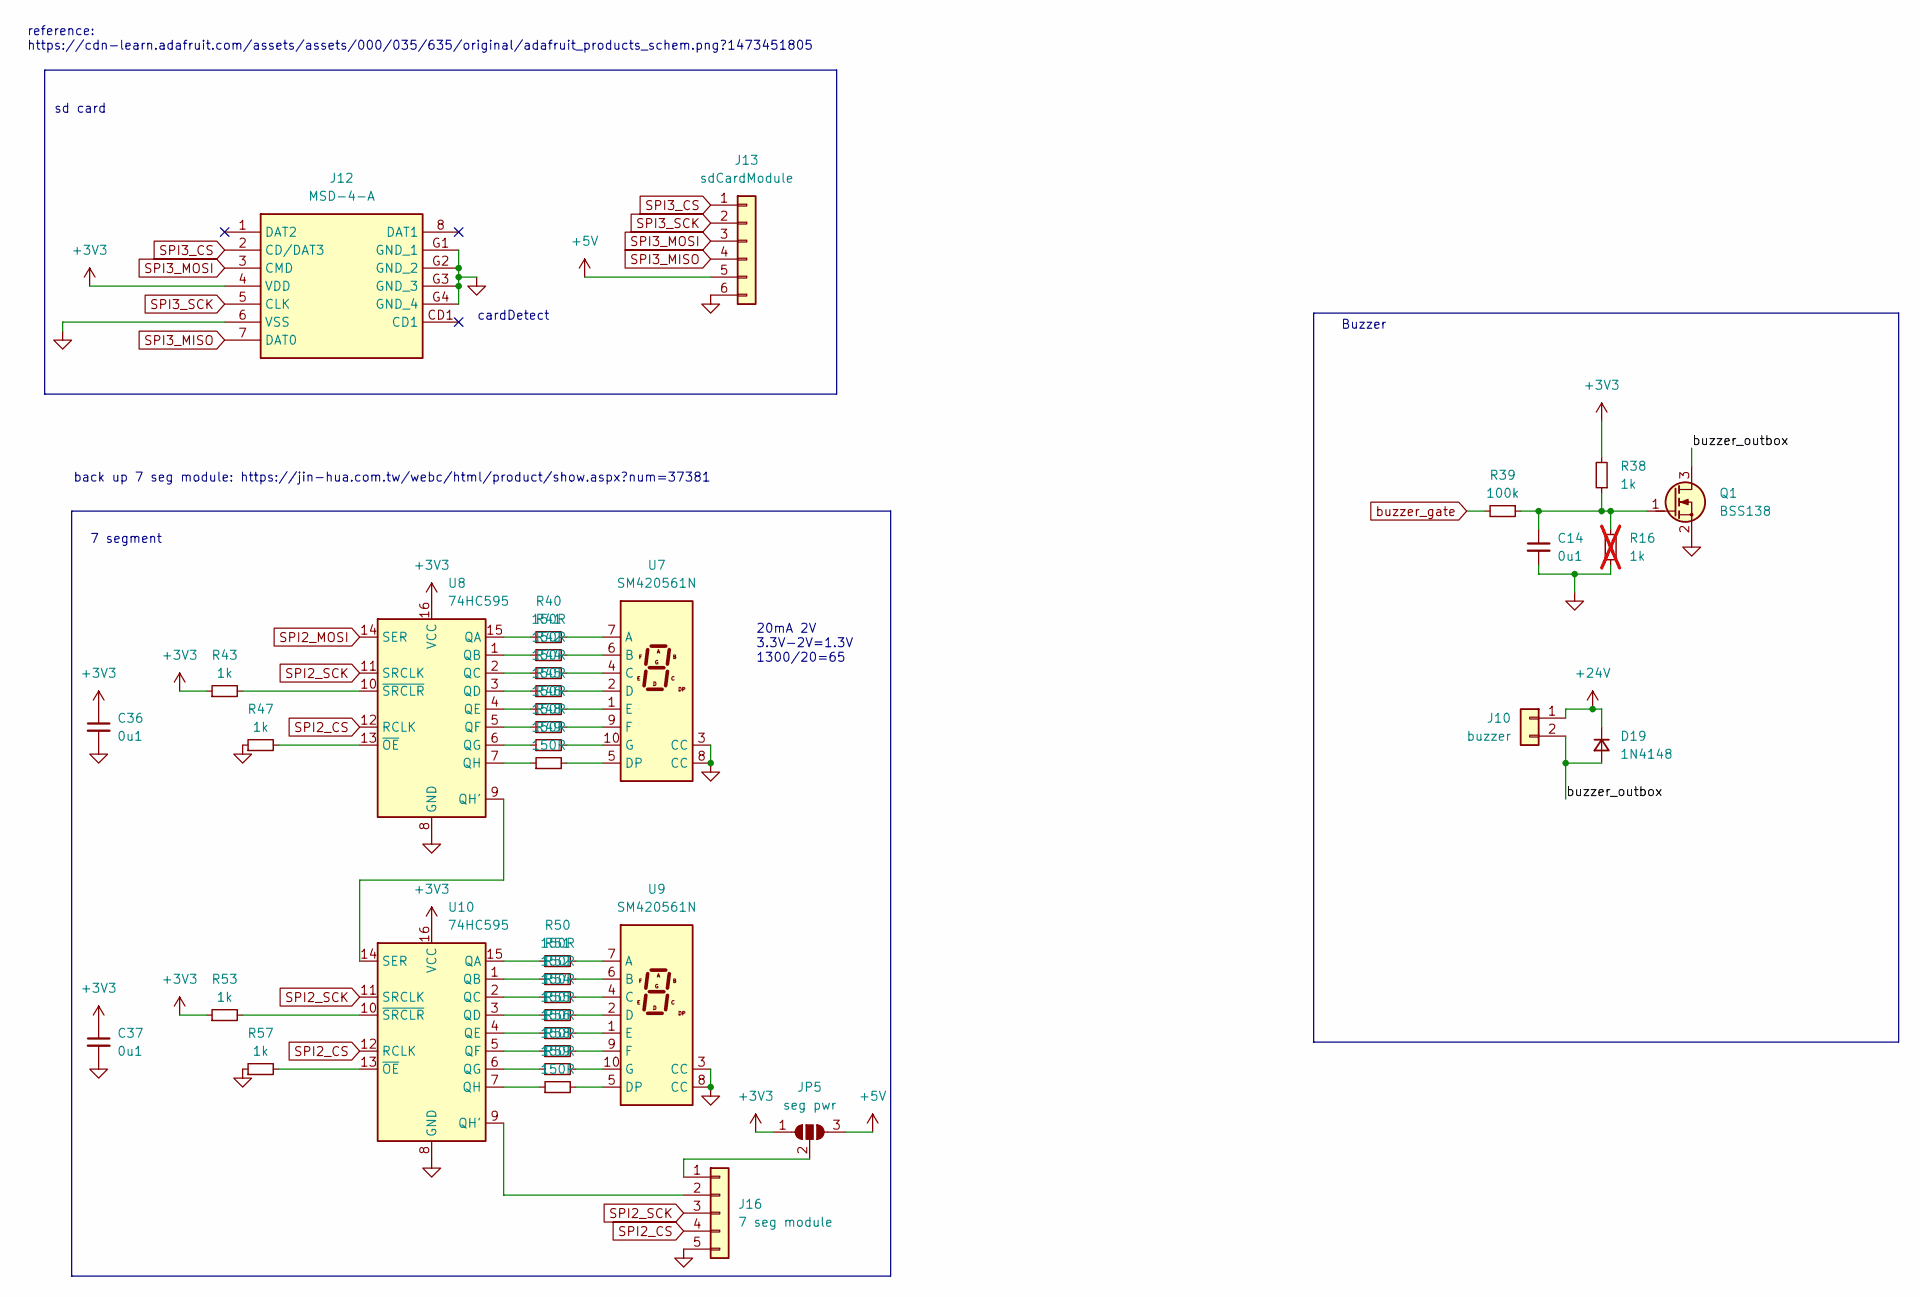
[picture p159: schematic electronic3.kicad_sch]

Parts:
C14, C36, C37: 0u1; C_0603_1608Metric
D19: 1N4148; D_MiniMELF
J10: buzzer; JST_XH_B2B-XH-A_1x02_P2.50mm_Vertical
J12: MSD-4-A; MSD4A; Mouser Part Number 179-MSD-4-A
J13: sdCardModule; PinSocket_1x06_P2.54mm_Vertical
J16: 7 seg module; PinHeader_1x05_P2.54mm_Vertical
JP5: seg pwr; SolderJumper-3_P1.3mm_Open_Pad1.0x1.5mm_NumberLabels
Q1: BSS138; SOT-23
R16: 1k; R_0603_1608Metric; not fitted
R38, R43, R47, R53, R57: 1k; R_0603_1608Metric
R39: 100k; R_0603_1608Metric
R40, R41, R42, R44, R45, R46, R48, R49, R50, R51, R52, R54, R55, R56, R58, R59: 150R; R_0603_1608Metric
U7, U9: SM420561N; 7SegmentLED_LTS6760_LTS6780
U8, U10: 74HC595; SOIC-16_3.9x9.9mm_P1.27mm

Connections:
+3V3: C36.1, C37.1, J12.4 (VDD), JP5.1 (A), R38.2, R43.1, R53.1, U8.16 (VCC), U10.16 (VCC)
+5V: J13.5, JP5.3 (B)
+24V: D19.1 (K), J10.1
GND: C14.2, C36.2, C37.2, J12.6 (VSS), J12.G1 (GND_1), J12.G2 (GND_2), J12.G3 (GND_3), J12.G4 (GND_4), J13.6, J16.5, Q1.2 (S), R16.1, R47.1, R57.1, U7.3 (CC), U7.8 (CC), U8.8 (GND), U9.3 (CC), U9.8 (CC), U10.8 (GND)
unnamed: C14.1, Q1.1 (G), R16.2, R38.1, R39.1
unnamed: J16.1, JP5.2 (C)
unnamed: J16.2, U10.9 (QH')
unnamed: R40.1, U8.15 (QA)
unnamed: R40.2, U7.7 (A)
unnamed: R41.1, U8.1 (QB)
unnamed: R41.2, U7.6 (B)
unnamed: R42.1, U8.2 (QC)
unnamed: R42.2, U7.4 (C)
unnamed: R43.2, U8.10 (~SRCLR)
unnamed: R44.1, U8.3 (QD)
unnamed: R44.2, U7.2 (D)
unnamed: R45.1, U8.4 (QE)
unnamed: R45.2, U7.1 (E)
unnamed: R46.1, U8.5 (QF)
unnamed: R46.2, U7.9 (F)
unnamed: R47.2, U8.13 (~OE)
unnamed: R48.1, U8.6 (QG)
unnamed: R48.2, U7.10 (G)
unnamed: R49.1, U8.7 (QH)
unnamed: R49.2, U7.5 (DP)
unnamed: R50.1, U10.15 (QA)
unnamed: R50.2, U9.7 (A)
unnamed: R51.1, U10.1 (QB)
unnamed: R51.2, U9.6 (B)
unnamed: R52.1, U10.2 (QC)
unnamed: R52.2, U9.4 (C)
unnamed: R53.2, U10.10 (~SRCLR)
unnamed: R54.1, U10.3 (QD)
unnamed: R54.2, U9.2 (D)
unnamed: R55.1, U10.4 (QE)
unnamed: R55.2, U9.1 (E)
unnamed: R56.1, U10.5 (QF)
unnamed: R56.2, U9.9 (F)
unnamed: R57.2, U10.13 (~OE)
unnamed: R58.1, U10.6 (QG)
unnamed: R58.2, U9.10 (G)
unnamed: R59.1, U10.7 (QH)
unnamed: R59.2, U9.5 (DP)
unnamed: U8.9 (QH'), U10.14 (SER)
SPI2_CS: J16.4, U8.12 (RCLK), U10.12 (RCLK)
SPI2_MOSI: U8.14 (SER)
SPI2_SCK: J16.3, U8.11 (SRCLK), U10.11 (SRCLK)
SPI3_CS: J12.2 (CD/DAT3), J13.1
SPI3_MISO: J12.7 (DAT0), J13.4
SPI3_MOSI: J12.3 (CMD), J13.3
SPI3_SCK: J12.5 (CLK), J13.2
buzzer_gate: R39.2
buzzer_outbox: D19.2 (A), J10.2, Q1.3 (D)

Notes on the sheet:
reference: https://cdn-learn.adafruit.com/assets/assets/000/035/635/original/adafruit_products_schem.png?1473451805
20mA 2V 3.3V-2V=1.3V 1300/20=65
7 segment
back up 7 seg module: https://jin-hua.com.tw/webc/html/product/show.aspx?num=37381
cardDetect
sd card
Buzzer
