NTURacingTeam/nturt_kicad/EP5/Electrical Group/rearbox_nucleo_1/electronics1.kicad_sch

## KiCad design EP5/Electrical Group/rearbox_nucleo_1/electronics1.kicad_sch (2024-10-12)

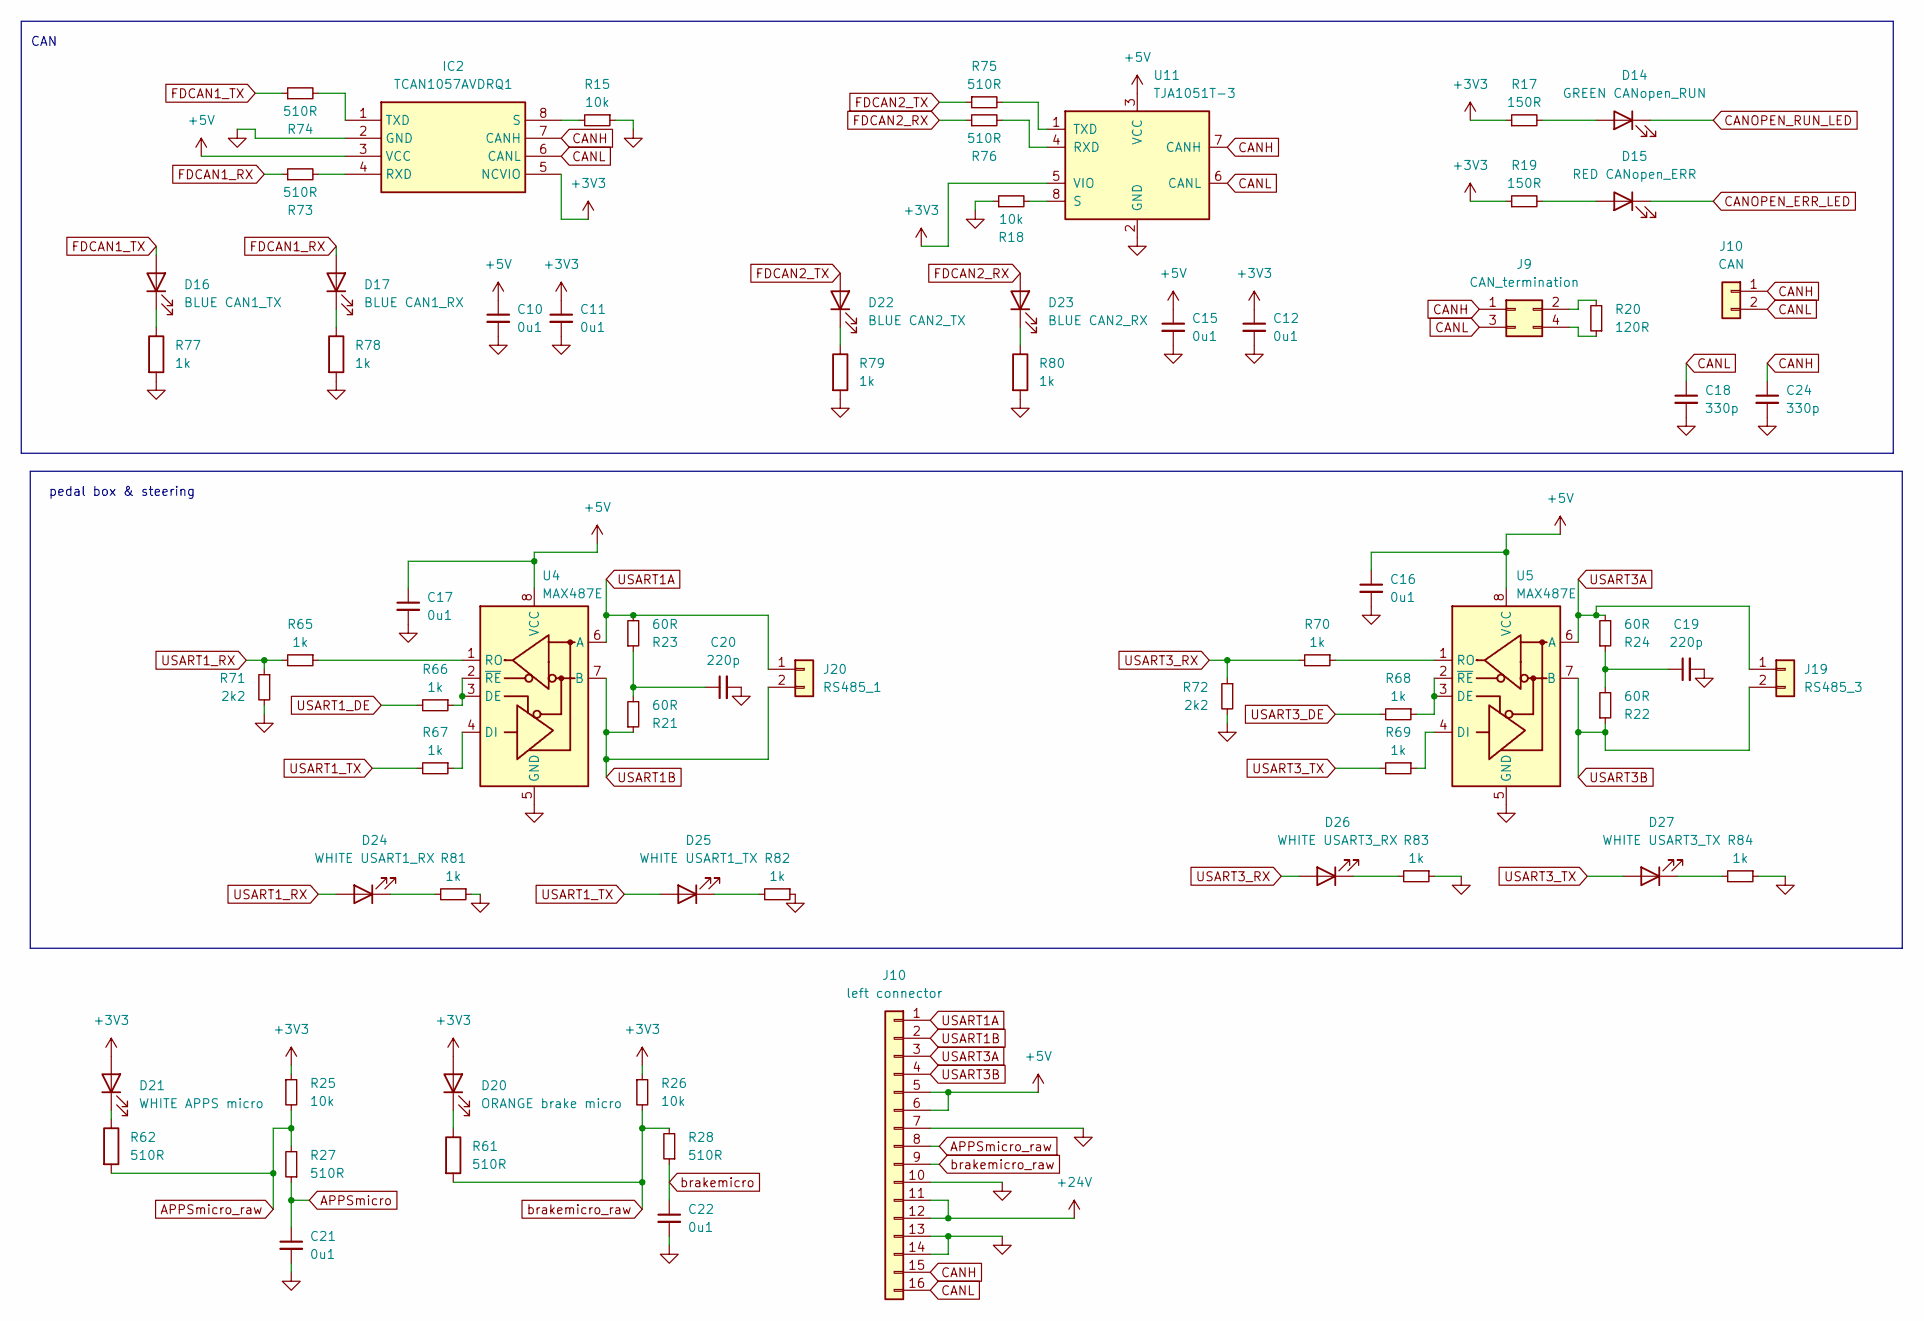
[picture p160: schematic electronics1.kicad_sch]

Parts:
C10, C11, C12, C15, C16, C17, C21, C22: 0u1; C_0603_1608Metric
C18, C24: 330p; C_0603_1608Metric
C19, C20: 220p; C_0603_1608Metric
D14: GREEN CANopen_RUN; LED_0603_1608Metric
D15: RED CANopen_ERR; LED_0603_1608Metric
D16: BLUE CAN1_TX; LED_0603_1608Metric
D17: BLUE CAN1_RX; LED_0603_1608Metric
D20: ORANGE brake micro; LED_0603_1608Metric
D21: WHITE APPS micro; LED_0603_1608Metric
D22: BLUE CAN2_TX; LED_0603_1608Metric
D23: BLUE CAN2_RX; LED_0603_1608Metric
D24: WHITE USART1_RX; LED_0603_1608Metric
D25: WHITE USART1_TX; LED_0603_1608Metric
D26: WHITE USART3_RX; LED_0603_1608Metric
D27: WHITE USART3_TX; LED_0603_1608Metric
IC2: TCAN1057AVDRQ1; SOIC127P600X175-8N; Mouser Part Number 595-TCAN1057AVDRQ1
J9: CAN_termination; PinHeader_2x02_P2.54mm_Vertical
J10: left connector; IDC-Header_2x08_P2.54mm_Vertical
J19: RS485_3; PinHeader_1x02_P2.54mm_Vertical
J20: RS485_1; PinHeader_1x02_P2.54mm_Vertical
R15, R18, R25, R26: 10k; R_0603_1608Metric
R17, R19: 150R; R_0603_1608Metric
R20: 120R; R_0603_1608Metric
R21, R22, R23, R24: 60R; R_0603_1608Metric
R27, R28, R61, R62, R73, R74, R75, R76: 510R; R_0603_1608Metric
R65, R66, R67, R68, R69, R70, R77, R78, R79, R80, R81, R82, R83, R84: 1k; R_0603_1608Metric
R71, R72: 2k2; R_0603_1608Metric
U4, U5: MAX487E; SOIC-8_3.9x4.9mm_P1.27mm
U11: TJA1051T-3; SOIC-8_3.9x4.9mm_P1.27mm

Connections:
+3V3: C11.1, C12.1, D20.2 (A), D21.2 (A), IC2.5 (NCVIO), R17.1, R19.1, R25.1, R26.1, U11.5 (VIO)
+5V: C10.1, C15.1, C16.1, C17.1, IC2.3 (VCC), J10.5, J10.6, U4.8 (VCC), U5.8 (VCC), U11.3 (VCC)
+24V: J10.11, J10.12
APPSmicro: C21.1, R27.1
APPSmicro_raw: J10.8, R25.2, R27.2, R62.2
CANH: C24.1, IC2.7 (CANH), J9.1, J10.1, J10.15, U11.7 (CANH)
CANL: C18.1, IC2.6 (CANL), J9.3, J10.2, J10.16, U11.6 (CANL)
CANOPEN_ERR_LED: D15.1 (K)
CANOPEN_RUN_LED: D14.1 (K)
FDCAN1_RX: D17.2 (A), R73.1
FDCAN1_TX: D16.2 (A), R74.1
FDCAN2_RX: D23.2 (A), R76.1
FDCAN2_TX: D22.2 (A), R75.1
GND: C10.2, C11.2, C12.2, C15.2, C16.2, C17.2, C18.2, C19.2, C20.2, C21.2, C22.2, C24.2, IC2.2 (GND), J10.7, J10.10, J10.13, J10.14, R15.1, R18.1, R71.2, R72.2, R77.2, R78.2, R79.2, R80.2, R81.1, R82.1, R83.1, R84.1, U4.5 (GND), U5.5 (GND), U11.2 (GND)
unnamed: C19.1, R22.2, R24.1
unnamed: C20.1, R21.2, R23.1
unnamed: D14.2 (A), R17.2
unnamed: D15.2 (A), R19.2
unnamed: D16.1 (K), R77.1
unnamed: D17.1 (K), R78.1
unnamed: D20.1 (K), R61.1
unnamed: D21.1 (K), R62.1
unnamed: D22.1 (K), R79.1
unnamed: D23.1 (K), R80.1
unnamed: D24.1 (K), R81.2
unnamed: D25.1 (K), R82.2
unnamed: D26.1 (K), R83.2
unnamed: D27.1 (K), R84.2
unnamed: IC2.1 (TXD), R74.2
unnamed: IC2.4 (RXD), R73.2
unnamed: IC2.8 (S), R15.2
unnamed: J9.2, R20.2
unnamed: J9.4, R20.1
unnamed: R18.2, U11.8 (S)
unnamed: R65.1, U4.1 (RO)
unnamed: R66.1, U4.2 (~RE), U4.3 (DE)
unnamed: R67.1, U4.4 (DI)
unnamed: R68.1, U5.2 (~RE), U5.3 (DE)
unnamed: R69.1, U5.4 (DI)
unnamed: R70.1, U5.1 (RO)
unnamed: R75.2, U11.1 (TXD)
unnamed: R76.2, U11.4 (RXD)
USART1A: J10.1, J20.1, R23.2, U4.6 (A)
USART1B: J10.2, J20.2, R21.1, U4.7 (B)
USART1_DE: R66.2
USART1_RX: D24.2 (A), R65.2, R71.1
USART1_TX: D25.2 (A), R67.2
USART3A: J10.3, J19.1, R24.2, U5.6 (A)
USART3B: J10.4, J19.2, R22.1, U5.7 (B)
USART3_DE: R68.2
USART3_RX: D26.2 (A), R70.2, R72.1
USART3_TX: D27.2 (A), R69.2
brakemicro: C22.1, R28.1
brakemicro_raw: J10.9, R26.2, R28.2, R61.2

Notes on the sheet:
pedal box & steering
CAN
