NTURacingTeam/nturt_kicad/EP5/Electrical Group/rearbox_nucleo_1/power.kicad_sch

## KiCad design EP5/Electrical Group/rearbox_nucleo_1/power.kicad_sch (2024-10-12)

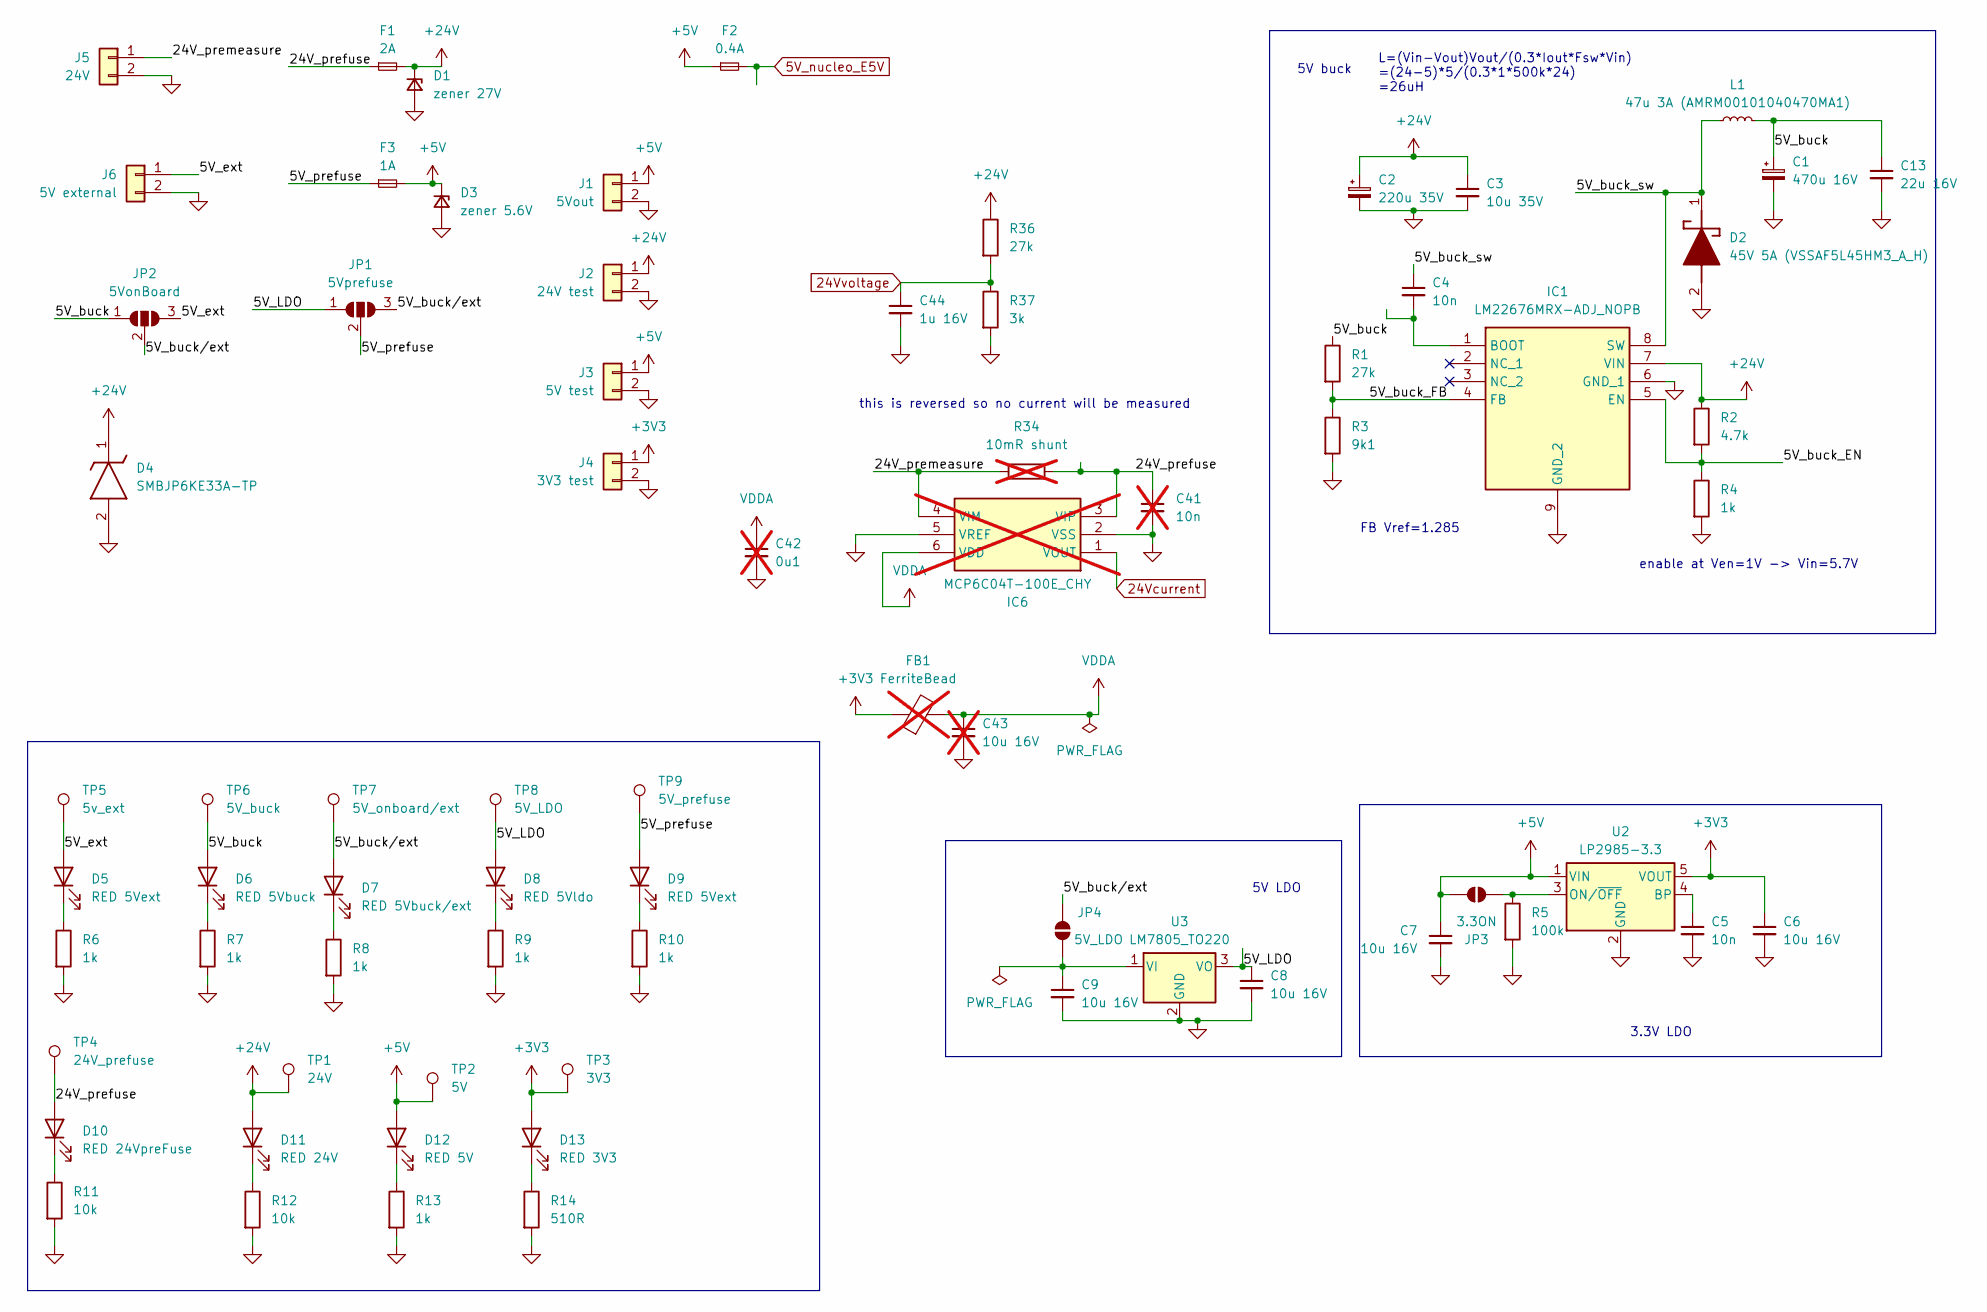
[picture p161: schematic power.kicad_sch]

Parts:
C1: 470u 16V; CP_Radial_D8.0mm_P3.80mm
C2: 220u 35V; CP_Radial_D8.0mm_P3.80mm
C3: 10u 35V; C_1206_3216Metric
C4, C5: 10n; C_0603_1608Metric
C6, C7, C8, C9: 10u 16V; C_0805_2012Metric
C13: 22u 16V; C_1206_3216Metric
C41: 10n; C_0603_1608Metric; not fitted
C42: 0u1; C_0603_1608Metric; not fitted
C43: 10u 16V; C_0805_2012Metric; not fitted
C44: 1u 16V; C_0603_1608Metric
D1: zener 27V; D_DO-35_SOD27_P3.81mm_Vertical_KathodeUp_Zener
D2: 45V 5A (VSSAF5L45HM3_A_H); SODFL5226X100N; Mouser Part Number 78-VSSAF5L45HM3_A/H
D3: zener 5.6V; D_MiniMELF
D4: SMBJP6KE33A-TP; DIOM5336X262N; Mouser Part Number 833-SMBJP6KE33A-TP
D5, D9: RED 5Vext; LED_0603_1608Metric
D6: RED 5Vbuck; LED_0603_1608Metric
D7: RED 5Vbuck/ext; LED_0603_1608Metric
D8: RED 5Vldo; LED_0603_1608Metric
D10: RED 24VpreFuse; LED_0603_1608Metric
D11: RED 24V; LED_0603_1608Metric
D12: RED 5V; LED_0603_1608Metric
D13: RED 3V3; LED_0603_1608Metric
F1: 2A; Fuse_2512_6332Metric_Pad1.52x3.35mm_HandSolder
F2: 0.4A; Fuse_2512_6332Metric_Pad1.52x3.35mm_HandSolder
F3: 1A; Fuse_2512_6332Metric_Pad1.52x3.35mm_HandSolder
FB1: FerriteBead; L_0805_2012Metric; not fitted
IC1: LM22676MRX-ADJ_NOPB; SOIC127P600X170-9N; Mouser Part Number 926-LM22676MRXADJNPB
IC6: MCP6C04T-100E_CHY; SOT95P280X145-6N; Mouser Part Number 579-MCP6C04T100ECHY; not fitted
J1: 5Vout; JST_XH_B2B-XH-A_1x02_P2.50mm_Vertical
J2: 24V test; PinHeader_1x02_P2.54mm_Vertical
J3: 5V test; PinHeader_1x02_P2.54mm_Vertical
J4: 3V3 test; PinHeader_1x02_P2.54mm_Vertical
J5: 24V; JST_XH_B2B-XH-A_1x02_P2.50mm_Vertical
J6: 5V external; JST_XH_B2B-XH-A_1x02_P2.50mm_Vertical
JP1: 5Vprefuse; SolderJumper-3_P1.3mm_Open_Pad1.0x1.5mm_NumberLabels
JP2: 5VonBoard; SolderJumper-3_P1.3mm_Open_Pad1.0x1.5mm_NumberLabels
JP3: 3.3ON; SolderJumper-2_P1.3mm_Open_Pad1.0x1.5mm
JP4: 5V_LDO; SolderJumper-2_P1.3mm_Open_Pad1.0x1.5mm
L1: 47u 3A (AMRM00101040470MA1); AMRM00101040470MA1
R1, R36: 27k; R_0603_1608Metric
R2: 4.7k; R_0603_1608Metric
R3: 9k1; R_0603_1608Metric
R4, R6, R7, R8, R9, R10, R13: 1k; R_0603_1608Metric
R5: 100k; R_0603_1608Metric
R11, R12: 10k; R_0603_1608Metric
R14: 510R; R_0603_1608Metric
R34: 10mR shunt; R_1206_3216Metric; not fitted
R37: 3k; R_0603_1608Metric
TP1: 24V; TestPoint_Pad_D1.0mm
TP2: 5V; TestPoint_Pad_D1.0mm
TP3: 3V3; TestPoint_Pad_D1.0mm
TP4: 24V_prefuse; TestPoint_Pad_D1.0mm
TP5: 5v_ext; TestPoint_Pad_D1.0mm
TP6: 5V_buck; TestPoint_Pad_D1.0mm
TP7: 5V_onboard/ext; TestPoint_Pad_D1.0mm
TP8: 5V_LDO; TestPoint_Pad_D1.0mm
TP9: 5V_prefuse; TestPoint_Pad_D1.0mm
U2: LP2985-3.3; SOT-23-5
U3: LM7805_TO220; TO-220-3_Vertical

Connections:
5V_LDO: C8.1, D8.2 (A), JP1.1 (A), TP8.1, U3.3 (VO)
5V_buck: C1.1, C13.1, D6.2 (A), JP2.1 (A), L1.2, R1.1, TP6.1
5V_buck_EN: IC1.5 (EN), R2.2, R4.1
5V_buck_FB: IC1.4 (FB), R1.2, R3.1
5V_buck_sw: C4.1, D2.1 (K), IC1.8 (SW), L1.1
5V_buck/ext: D7.2 (A), JP1.3 (B), JP2.2 (C), JP4.1 (A), TP7.1
5V_ext: D5.2 (A), J6.1, JP2.3 (B), TP5.1
5V_nucleo_E5V: F2.2
5V_prefuse: D9.2 (A), F3.1, JP1.2 (C), TP9.1
24V_prefuse: C41.1, D10.2 (A), F1.1, IC6.3 (VIP), R34.2, TP4.1
24V_premeasure: IC6.4 (VIM), J5.1, R34.1
24Vcurrent: IC6.1 (VOUT)
24Vvoltage: C44.1, R36.2, R37.1
+3V3: C6.1, D13.2 (A), FB1.1, J4.1, TP3.1, U2.5 (VOUT)
+5V: C7.1, D3.1 (K), D12.2 (A), F2.1, F3.2, J1.1, J3.1, JP3.2 (B), TP2.1, U2.1 (VIN)
+24V: C2.1, C3.1, D1.1 (K), D4.1 (K), D11.2 (A), F1.2, IC1.7 (VIN), J2.1, R2.1, R36.1, TP1.1
GND: C1.2, C2.2, C3.2, C5.2, C6.2, C7.2, C8.2, C9.2, C13.2, C41.2, C42.2, C43.2, C44.2, D1.2 (A), D2.2 (A), D3.2 (A), D4.2 (A), IC1.6 (GND_1), IC1.9 (GND_2), IC6.2 (VSS), IC6.5 (VREF), J1.2, J2.2, J3.2, J4.2, J5.2, J6.2, R3.2, R4.2, R5.2, R6.2, R7.2, R8.2, R9.2, R10.2, R11.2, R12.2, R13.2, R14.2, R37.2, U2.2 (GND), U3.2 (GND)
unnamed: C4.2, IC1.1 (BOOT)
unnamed: C5.1, U2.4 (BP)
unnamed: C9.1, JP4.2 (B), U3.1 (VI)
unnamed: D5.1 (K), R6.1
unnamed: D6.1 (K), R7.1
unnamed: D7.1 (K), R8.1
unnamed: D8.1 (K), R9.1
unnamed: D9.1 (K), R10.1
unnamed: D10.1 (K), R11.1
unnamed: D11.1 (K), R12.1
unnamed: D12.1 (K), R13.1
unnamed: D13.1 (K), R14.1
unnamed: JP3.1 (A), R5.1, U2.3 (ON/~OFF)
VDDA: C42.1, C43.1, FB1.2, IC6.6 (VDD)

Notes on the sheet:
FB Vref=1.285
3.3V LDO
5V buck
L=(Vin-Vout)Vout/(0.3*Iout*Fsw*Vin) =(24-5)*5/(0.3*1*500k*24) =26uH
5V LDO
enable at Ven=1V -> Vin=5.7V
this is reversed so no current will be measured
