NTURacingTeam/nturt_kicad/EP5/Electrical Group/rearbox_nucleo_1/rearbox_nucleo_1.kicad_sch

## KiCad design EP5/Electrical Group/rearbox_nucleo_1/rearbox_nucleo_1.kicad_sch (2024-10-12)

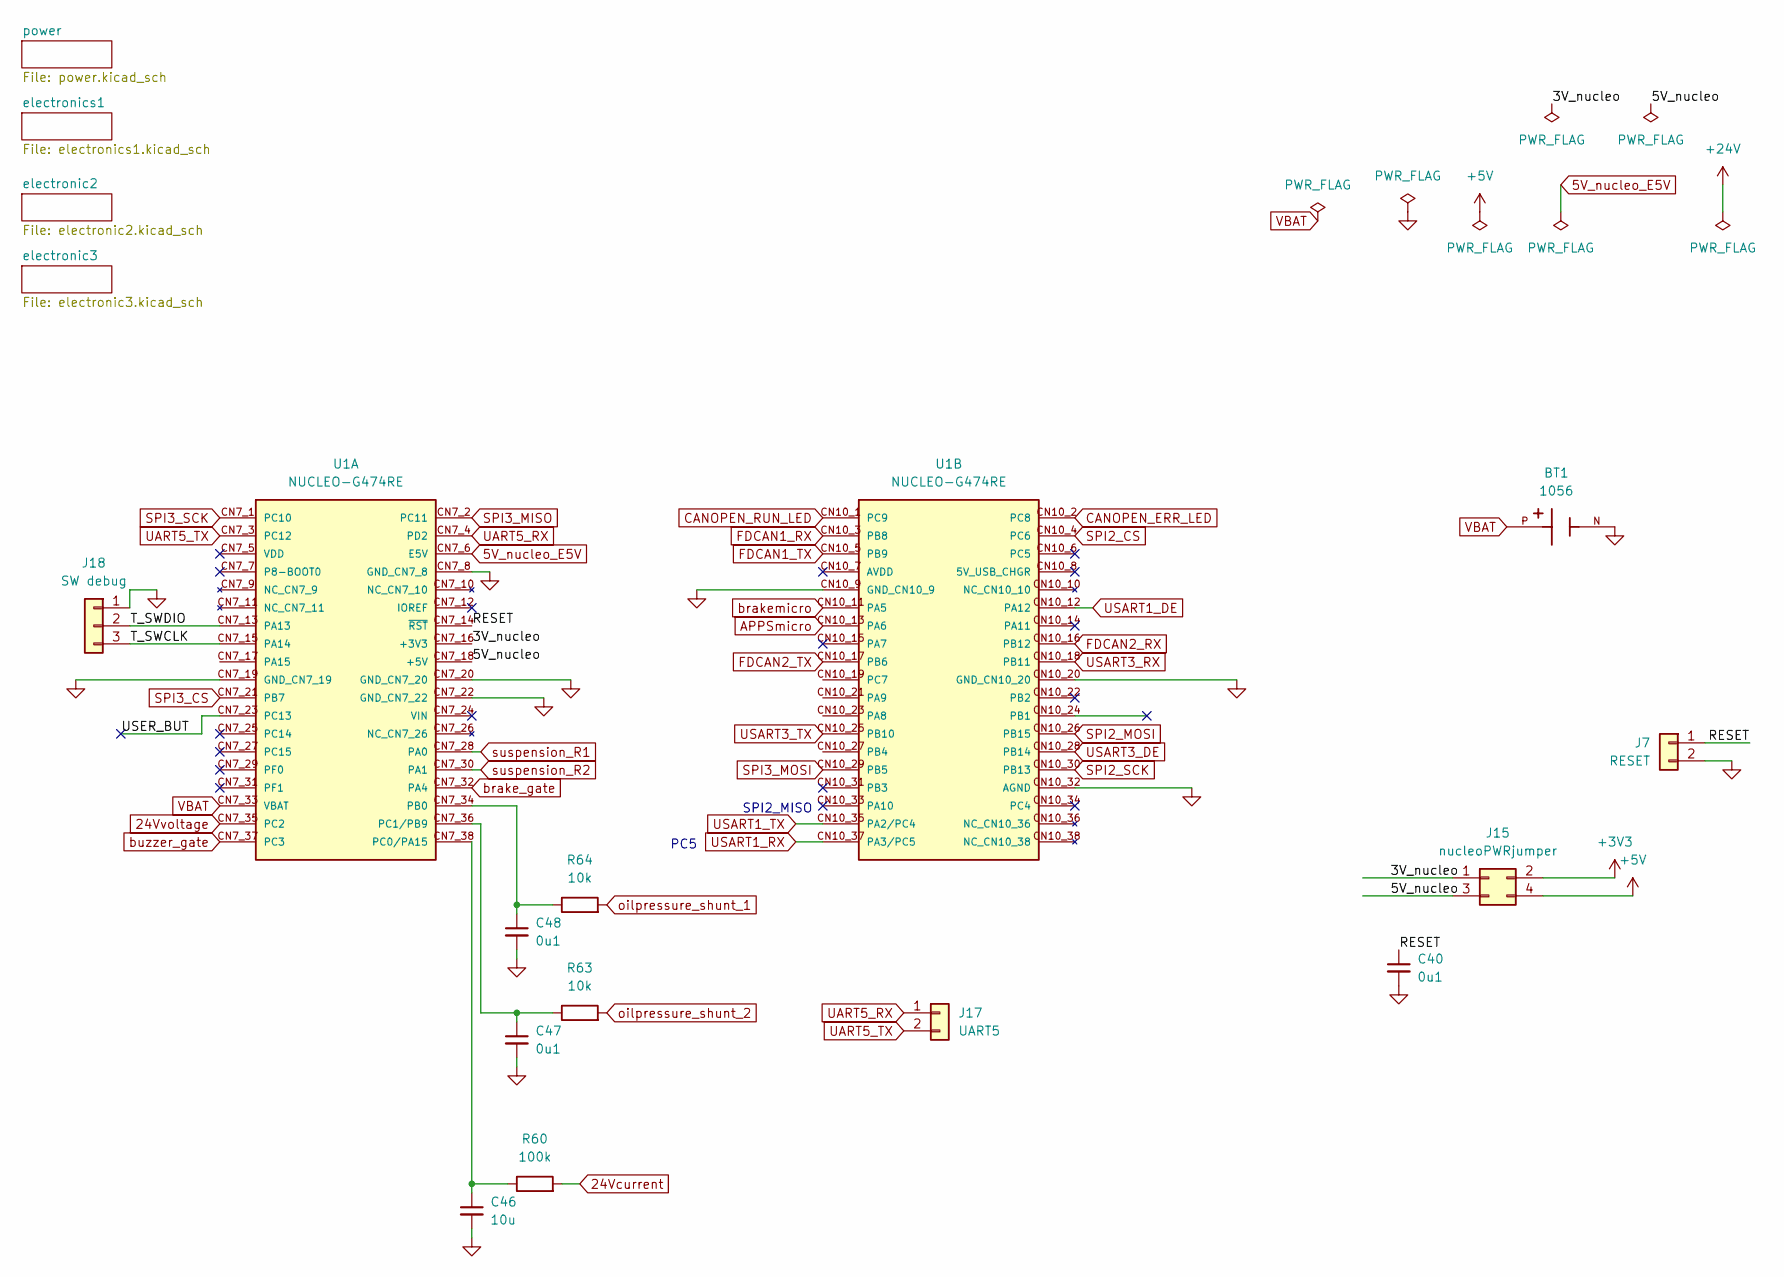
[picture p162: schematic rearbox_nucleo_1.kicad_sch]

Parts:
BT1: 1056; BAT_1056; PARTREV D
C40, C47, C48: 0u1; C_0603_1608Metric
C46: 10u; C_0603_1608Metric
J7: RESET; JST_XH_B2B-XH-A_1x02_P2.50mm_Vertical
J15: nucleoPWRjumper; PinHeader_2x02_P2.54mm_Vertical
J17: UART5; PinHeader_1x02_P2.54mm_Vertical
J18: SW debug; PinHeader_1x03_P2.54mm_Vertical
R60: 100k; R_0603_1608Metric
R63, R64: 10k; R_0603_1608Metric
U1: NUCLEO-G474RE; MODULE_NUCLEO-G474RE; PARTREV 17

Connections:
3V_nucleo: J15.1, U1.CN7_16 (+3V3)
5V_nucleo: J15.3, U1.CN7_18 (+5V)
5V_nucleo_E5V: U1.CN7_6 (E5V)
24Vcurrent: R60.2
24Vvoltage: U1.CN7_35 (PC2)
+3V3: J15.2
+5V: J15.4
APPSmicro: U1.CN10_13 (PA6)
CANOPEN_ERR_LED: U1.CN10_2 (PC8)
CANOPEN_RUN_LED: U1.CN10_1 (PC9)
FDCAN1_RX: U1.CN10_3 (PB8)
FDCAN1_TX: U1.CN10_5 (PB9)
FDCAN2_RX: U1.CN10_16 (PB12)
FDCAN2_TX: U1.CN10_17 (PB6)
GND: BT1.N, C40.2, C46.2, C47.2, C48.2, J7.2, J18.1, U1.CN7_8 (GND_CN7_8), U1.CN7_19 (GND_CN7_19), U1.CN7_20 (GND_CN7_20), U1.CN7_22 (GND_CN7_22), U1.CN10_9 (GND_CN10_9), U1.CN10_20 (GND_CN10_20), U1.CN10_32 (AGND)
unnamed: C46.1, R60.1, U1.CN7_38 (PC0/PA15)
unnamed: C47.1, R63.1, U1.CN7_36 (PC1/PB9)
unnamed: C48.1, R64.1, U1.CN7_34 (PB0)
RESET: C40.1, J7.1, U1.CN7_14 (~RST)
SPI2_CS: U1.CN10_4 (PC6)
SPI2_MOSI: U1.CN10_26 (PB15)
SPI2_SCK: U1.CN10_30 (PB13)
SPI3_CS: U1.CN7_21 (PB7)
SPI3_MISO: U1.CN7_2 (PC11)
SPI3_MOSI: U1.CN10_29 (PB5)
SPI3_SCK: U1.CN7_1 (PC10)
T_SWCLK: J18.3, U1.CN7_15 (PA14)
T_SWDIO: J18.2, U1.CN7_13 (PA13)
UART5_RX: J17.1, U1.CN7_4 (PD2)
UART5_TX: J17.2, U1.CN7_3 (PC12)
USART1_DE: U1.CN10_12 (PA12)
USART1_RX: U1.CN10_37 (PA3/PC5)
USART1_TX: U1.CN10_35 (PA2/PC4)
USART3_DE: U1.CN10_28 (PB14)
USART3_RX: U1.CN10_18 (PB11)
USART3_TX: U1.CN10_25 (PB10)
USER_BUT: U1.CN7_23 (PC13)
VBAT: BT1.P, U1.CN7_33 (VBAT)
brake_gate: U1.CN7_32 (PA4)
brakemicro: U1.CN10_11 (PA5)
buzzer_gate: U1.CN7_37 (PC3)
oilpressure_shunt_1: R64.2
oilpressure_shunt_2: R63.2
suspension_R1: U1.CN7_28 (PA0)
suspension_R2: U1.CN7_30 (PA1)

Notes on the sheet:
PC5
SPI2_MISO
