NTURacingTeam/nturt_kicad/EP5/Electrical Group/rearbox_nucleo_1_V3.0bak/electronic2.kicad_sch

## KiCad design EP5/Electrical Group/rearbox_nucleo_1_V3.0bak/electronic2.kicad_sch (2024-10-12)

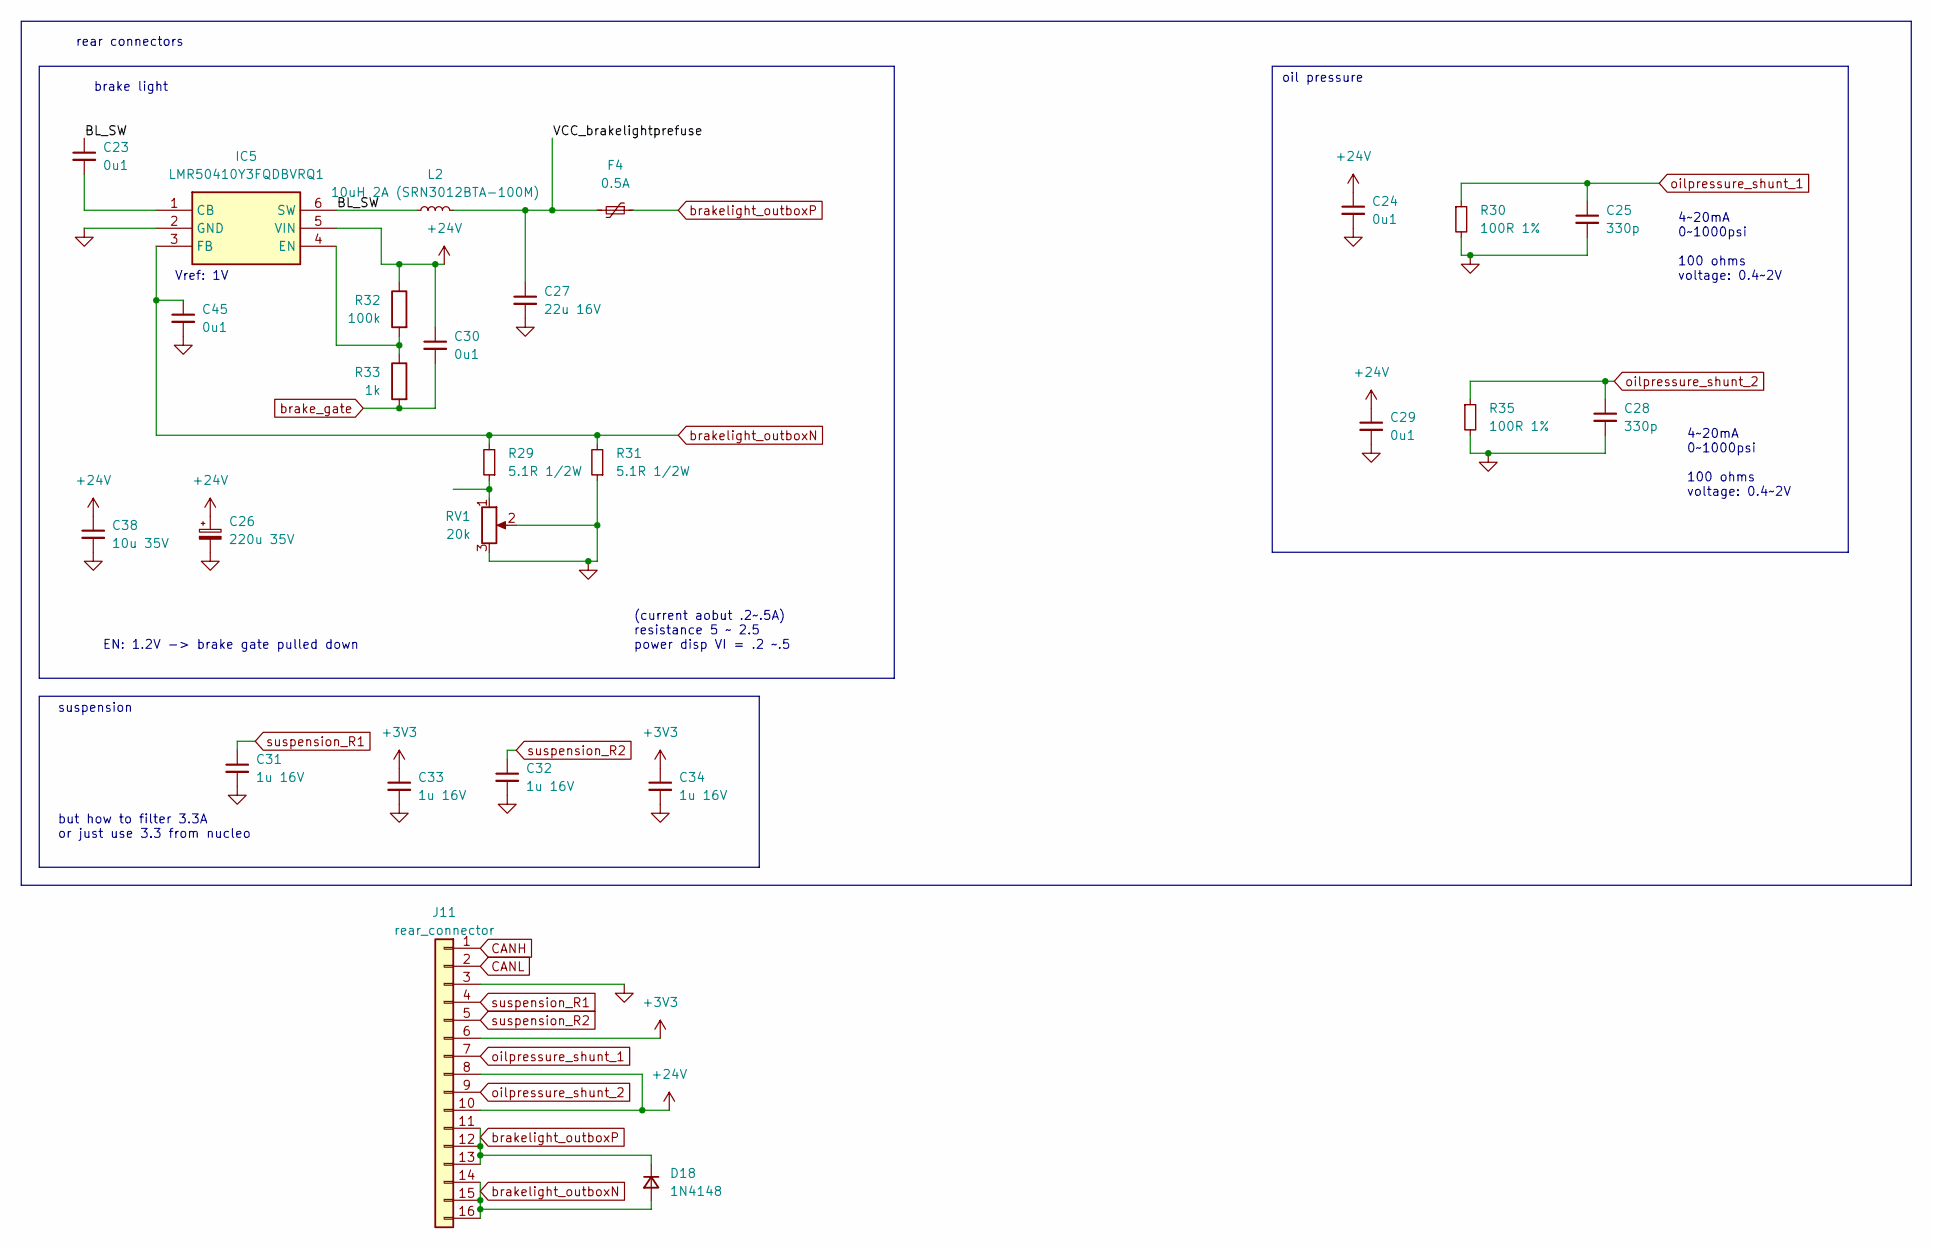
[picture p163: schematic electronic2.kicad_sch]

Parts:
C23, C24, C29, C30, C45: 0u1; C_0603_1608Metric
C25, C28: 330p; C_0603_1608Metric
C26: 220u 35V; CP_Radial_D8.0mm_P3.80mm
C27: 22u 16V; C_1206_3216Metric
C31, C32, C33, C34: 1u 16V; C_0603_1608Metric
C38: 10u 35V; C_1206_3216Metric
D18: 1N4148; D_MiniMELF
F4: 0.5A; Fuse_1206_3216Metric
IC5: LMR50410Y3FQDBVRQ1; SOT95P280X145-6N; Mouser Part Number 595-R50410Y3FQDBVRQ1
J11: rear_connector; IDC-Header_2x08_P2.54mm_Vertical
L2: 10uH 2A (SRN3012BTA-100M); SRN3012BTA100M
R29, R31: 5.1R 1/2W; R_Axial_DIN0309_L9.0mm_D3.2mm_P2.54mm_Vertical
R30, R35: 100R 1%; R_0805_2012Metric
R32: 100k; R_0603_1608Metric
R33: 1k; R_0603_1608Metric
RV1: 20k; Potentiometer_Vishay_T73YP_Vertical

Connections:
+3V3: C33.1, C34.1, J11.6
+24V: C24.1, C26.1, C29.1, C30.1, C38.1, IC5.5 (VIN), J11.8, J11.10, R32.1
BL_SW: C23.1, IC5.6 (SW), L2.1
CANH: J11.1
CANL: J11.2
GND: C24.2, C25.2, C26.2, C27.2, C28.2, C29.2, C31.2, C32.2, C33.2, C34.2, C38.2, C45.2, IC5.2 (GND), J11.3, R30.2, R31.1, R35.2, RV1.2, RV1.3
unnamed: C23.2, IC5.1 (CB)
unnamed: IC5.4 (EN), R32.2, R33.1
unnamed: R29.1, RV1.1
VCC_brakelightprefuse: C27.1, F4.2, L2.2
brake_gate: C30.2, R33.2
brakelight_outboxN: C45.1, D18.2 (A), IC5.3 (FB), J11.14, J11.15, J11.16, R29.2, R31.2
brakelight_outboxP: D18.1 (K), F4.1, J11.11, J11.12, J11.13
oilpressure_shunt_1: C25.1, J11.7, R30.1
oilpressure_shunt_2: C28.1, J11.9, R35.1
suspension_R1: C31.1, J11.4
suspension_R2: C32.1, J11.5

Notes on the sheet:
Vref: 1V
4~20mA 0~1000psi 100 ohms voltage: 0.4~2V
oil pressure
but how to filter 3.3A or just use 3.3 from nucleo
(current aobut .2~.5A) resistance 5 ~ 2.5 power disp VI = .2 ~.5
brake light
EN: 1.2V -> brake gate pulled down
rear connectors
suspension
