NTURacingTeam/nturt_kicad/EP5/Electrical Group/rearbox_nucleo_1_V3.0bak/electronics1.kicad_sch

## KiCad design EP5/Electrical Group/rearbox_nucleo_1_V3.0bak/electronics1.kicad_sch (2024-10-12)

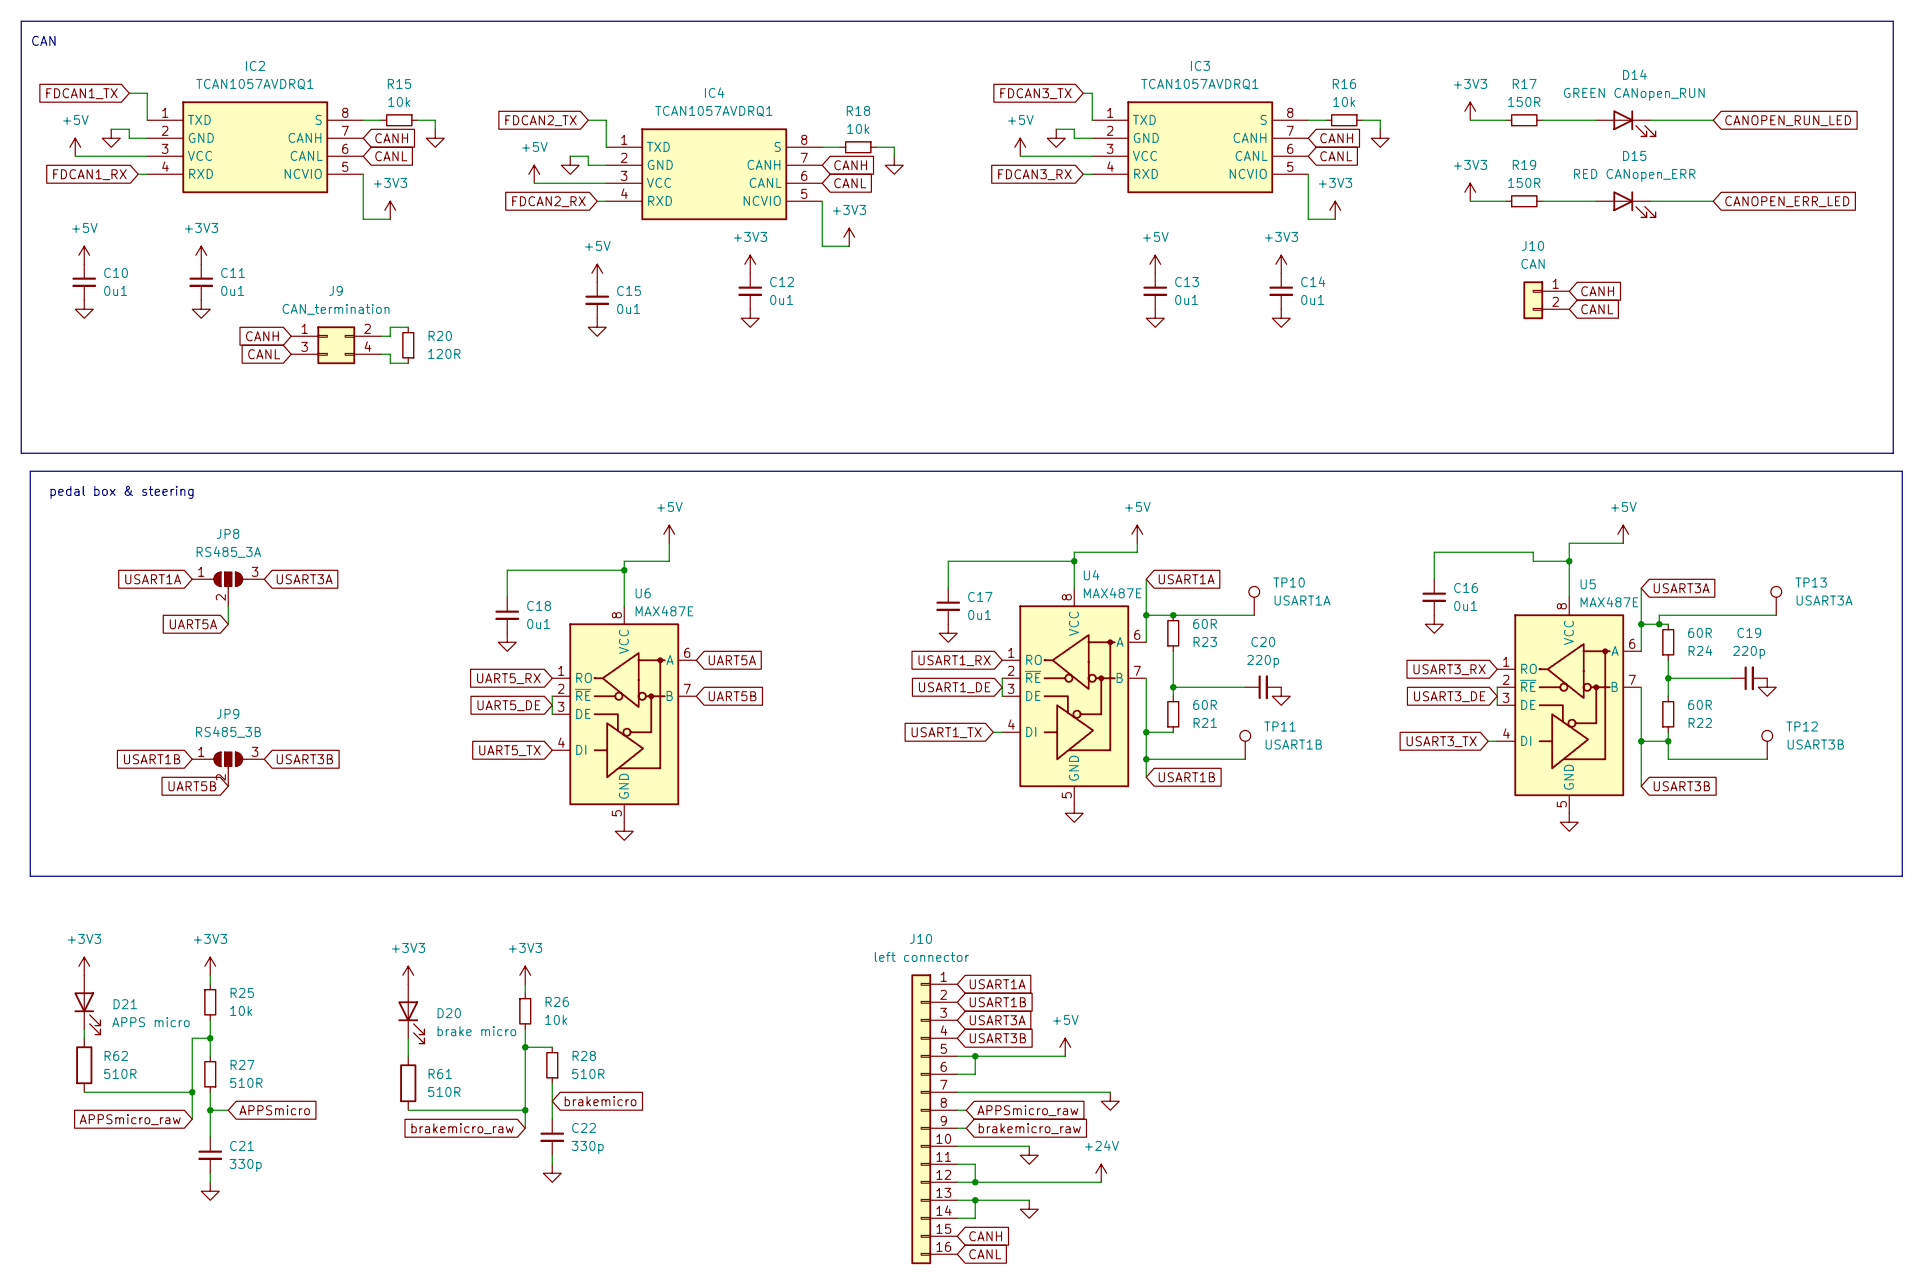
[picture p164: schematic electronics1.kicad_sch]

Parts:
C10, C11, C12, C13, C14, C15, C16, C17, C18: 0u1; C_0603_1608Metric
C19, C20: 220p; C_0603_1608Metric
C21, C22: 330p; C_0603_1608Metric
D14: GREEN CANopen_RUN; LED_0603_1608Metric
D15: RED CANopen_ERR; LED_0603_1608Metric
D20: brake micro; LED_0603_1608Metric
D21: APPS micro; LED_0603_1608Metric
IC2, IC3, IC4: TCAN1057AVDRQ1; SOIC127P600X175-8N; Mouser Part Number 595-TCAN1057AVDRQ1
J9: CAN_termination; PinHeader_2x02_P2.54mm_Vertical
J10: left connector; IDC-Header_2x08_P2.54mm_Vertical
JP8: RS485_3A; SolderJumper-3_P1.3mm_Open_Pad1.0x1.5mm_NumberLabels
JP9: RS485_3B; SolderJumper-3_P1.3mm_Open_Pad1.0x1.5mm_NumberLabels
R15, R16, R18, R25, R26: 10k; R_0603_1608Metric
R17, R19: 150R; R_0603_1608Metric
R20: 120R; R_0603_1608Metric
R21, R22, R23, R24: 60R; R_0603_1608Metric
R27, R28, R61, R62: 510R; R_0603_1608Metric
TP10: USART1A; TestPoint_Pad_D1.0mm
TP11: USART1B; TestPoint_Pad_D1.0mm
TP12: USART3B; TestPoint_Pad_D1.0mm
TP13: USART3A; TestPoint_Pad_D1.0mm
U4, U5, U6: MAX487E; SOIC-8_3.9x4.9mm_P1.27mm

Connections:
+3V3: C11.1, C12.1, C14.1, D20.2 (A), D21.2 (A), IC2.5 (NCVIO), IC3.5 (NCVIO), IC4.5 (NCVIO), R17.1, R19.1, R25.1, R26.1
+5V: C10.1, C13.1, C15.1, C16.1, C17.1, C18.1, IC2.3 (VCC), IC3.3 (VCC), IC4.3 (VCC), J10.5, J10.6, U4.8 (VCC), U5.8 (VCC), U6.8 (VCC)
+24V: J10.11, J10.12
APPSmicro: C21.1, R27.1
APPSmicro_raw: J10.8, R25.2, R27.2, R62.2
CANH: IC2.7 (CANH), IC3.7 (CANH), IC4.7 (CANH), J9.1, J10.1, J10.15
CANL: IC2.6 (CANL), IC3.6 (CANL), IC4.6 (CANL), J9.3, J10.2, J10.16
CANOPEN_ERR_LED: D15.1 (K)
CANOPEN_RUN_LED: D14.1 (K)
FDCAN1_RX: IC2.4 (RXD)
FDCAN1_TX: IC2.1 (TXD)
FDCAN2_RX: IC4.4 (RXD)
FDCAN2_TX: IC4.1 (TXD)
FDCAN3_RX: IC3.4 (RXD)
FDCAN3_TX: IC3.1 (TXD)
GND: C10.2, C11.2, C12.2, C13.2, C14.2, C15.2, C16.2, C17.2, C18.2, C19.2, C20.2, C21.2, C22.2, IC2.2 (GND), IC3.2 (GND), IC4.2 (GND), J10.7, J10.10, J10.13, J10.14, R15.1, R16.1, R18.1, U4.5 (GND), U5.5 (GND), U6.5 (GND)
unnamed: C19.1, R22.2, R24.1
unnamed: C20.1, R21.2, R23.1
unnamed: D14.2 (A), R17.2
unnamed: D15.2 (A), R19.2
unnamed: D20.1 (K), R61.1
unnamed: D21.1 (K), R62.1
unnamed: IC2.8 (S), R15.2
unnamed: IC3.8 (S), R16.2
unnamed: IC4.8 (S), R18.2
unnamed: J9.2, R20.2
unnamed: J9.4, R20.1
UART5A: JP8.2 (C), U6.6 (A)
UART5B: JP9.2 (C), U6.7 (B)
UART5_DE: U6.2 (~RE), U6.3 (DE)
UART5_RX: U6.1 (RO)
UART5_TX: U6.4 (DI)
USART1A: J10.1, JP8.1 (A), R23.2, TP10.1, U4.6 (A)
USART1B: J10.2, JP9.1 (A), R21.1, TP11.1, U4.7 (B)
USART1_DE: U4.2 (~RE), U4.3 (DE)
USART1_RX: U4.1 (RO)
USART1_TX: U4.4 (DI)
USART3A: J10.3, JP8.3 (B), R24.2, TP13.1, U5.6 (A)
USART3B: J10.4, JP9.3 (B), R22.1, TP12.1, U5.7 (B)
USART3_DE: U5.2 (~RE), U5.3 (DE)
USART3_RX: U5.1 (RO)
USART3_TX: U5.4 (DI)
brakemicro: C22.1, R28.1
brakemicro_raw: J10.9, R26.2, R28.2, R61.2

Notes on the sheet:
pedal box & steering
CAN
