NTURacingTeam/nturt_kicad/EP5/Electrical Group/rearbox_rear_connector/rearbox_rear_connector.kicad_sch

## KiCad design EP5/Electrical Group/rearbox_rear_connector/rearbox_rear_connector.kicad_sch (2024-07-04)

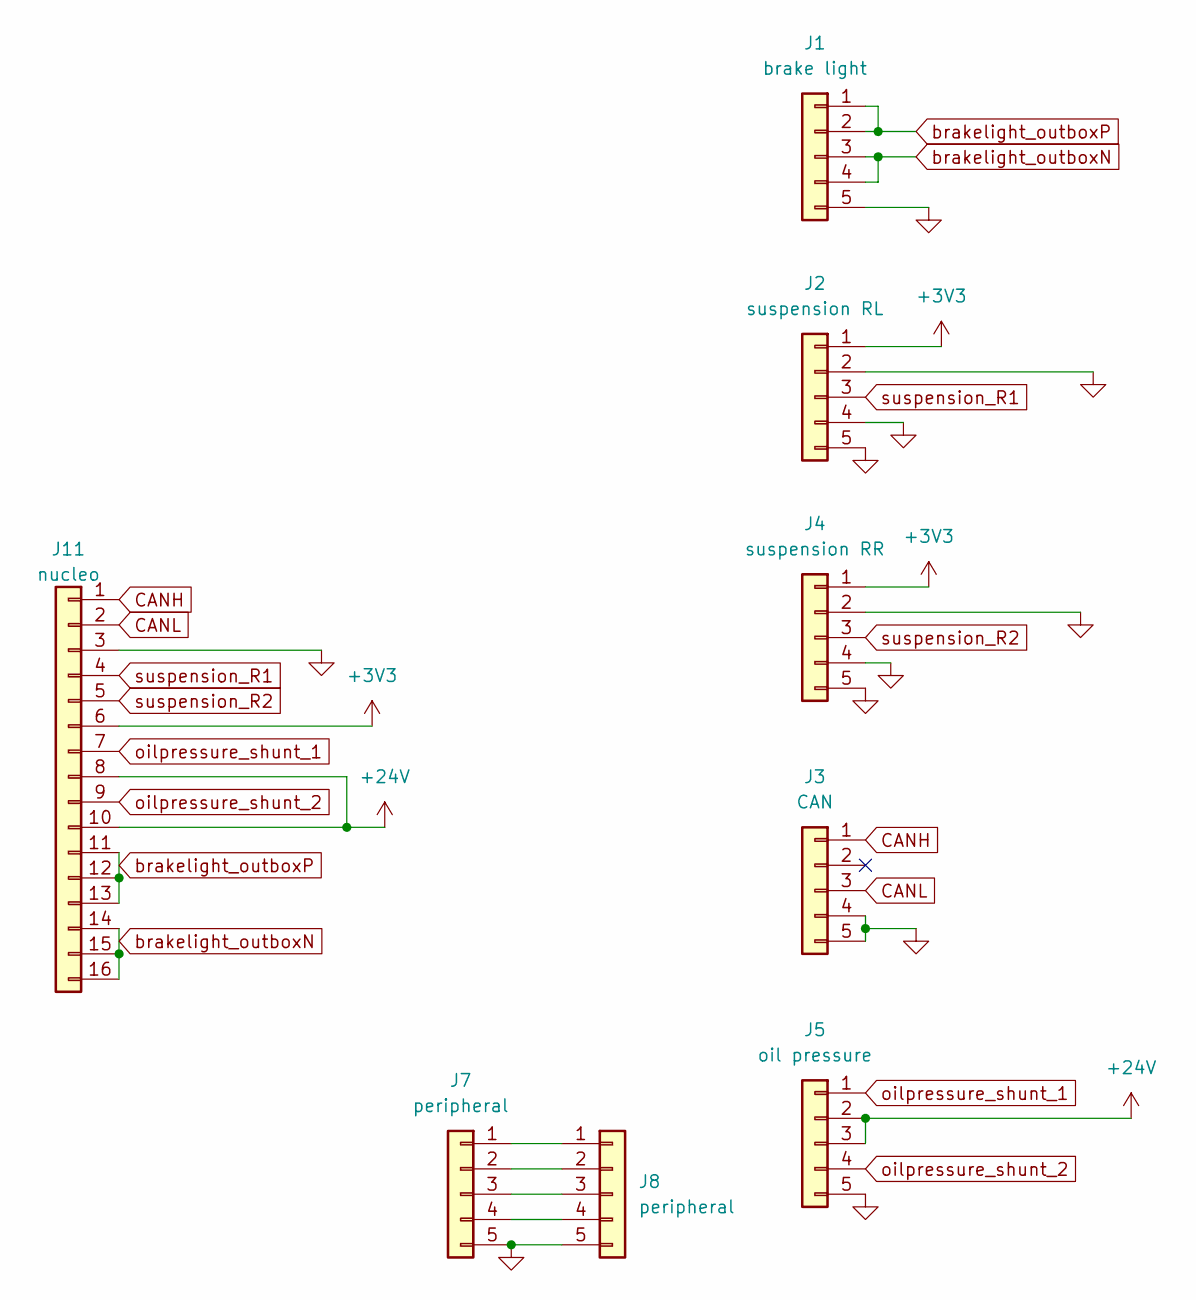
[picture p166: schematic rearbox_rear_connector.kicad_sch]

Parts:
J1: brake light; WP-04F3-26-11
J2: suspension RL; WP-03F3-09-11
J3: CAN; WP-03F3-09-11
J4: suspension RR; WP-03F3-09-11
J5: oil pressure; WP-04F3-26-11
J7: peripheral; WP-04F3-26-11
J8: peripheral; JST_XH_S5B-XH-A_1x05_P2.50mm_Horizontal
J11: nucleo; IDC-Header_2x08_P2.54mm_Vertical

Connections:
+3V3: J2.1, J4.1, J11.6
+24V: J5.2, J5.3, J11.8, J11.10
CANH: J3.1, J11.1
CANL: J3.3, J11.2
GND: J1.5, J2.2, J2.4, J2.5, J3.4, J3.5, J4.2, J4.4, J4.5, J5.5, J7.5, J8.5, J11.3
unnamed: J7.1, J8.1
unnamed: J7.2, J8.2
unnamed: J7.3, J8.3
unnamed: J7.4, J8.4
brakelight_outboxN: J1.3, J1.4, J11.14, J11.15, J11.16
brakelight_outboxP: J1.1, J1.2, J11.11, J11.12, J11.13
oilpressure_shunt_1: J5.1, J11.7
oilpressure_shunt_2: J5.4, J11.9
suspension_R1: J2.3, J11.4
suspension_R2: J4.3, J11.5
