NTURacingTeam/nturt_kicad/EP4/BatteryBox/SC_Board_EP4O_V2_20230615/BSPD/BSPD.kicad_sch

## KiCad design EP4/BatteryBox/SC_Board_EP4O_V2_20230615/BSPD/BSPD.kicad_sch (2023-08-07)

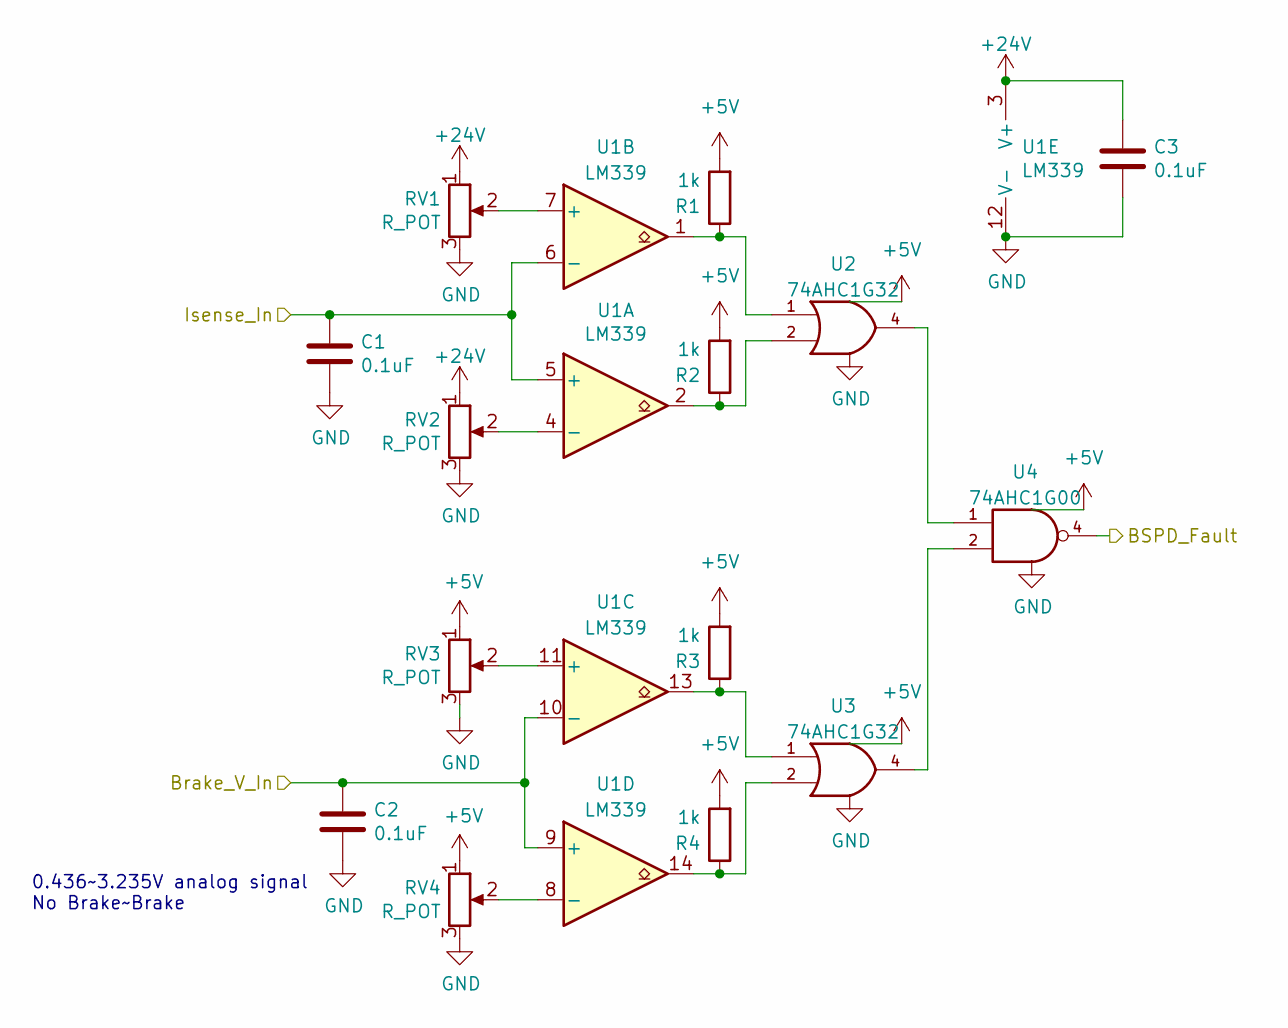
[picture p167: schematic BSPD.kicad_sch]

Parts:
C1, C2, C3: 0.1uF; C_0805_2012Metric_Pad1.18x1.45mm_HandSolder
R1, R2, R3, R4: 1k; R_0805_2012Metric_Pad1.20x1.40mm_HandSolder
RV1, RV2, RV3, RV4: R_POT; Potentiometer_Bourns_3296P_Horizontal
U1: LM339; SOIC-14_3.9x8.7mm_P1.27mm
U2, U3: 74AHC1G32; SOT-23-5_HandSoldering
U4: 74AHC1G00; SOT-23-5_HandSoldering

Connections:
+5V: R1.2, R2.2, R3.2, R4.2, RV3.1, RV4.1, U2.5 (VCC), U3.5 (VCC), U4.5 (VCC)
+24V: C3.1, RV1.1, RV2.1, U1.3 (V+)
BSPD_Fault: U4.4
Brake_V_In: C2.1, U1.9 (+), U1.10 (-)
GND: C1.2, C2.2, C3.2, RV1.3, RV2.3, RV3.3, RV4.3, U1.12 (V-), U2.3 (GND), U3.3 (GND), U4.3 (GND)
Isense_In: C1.1, U1.5 (+), U1.6 (-)
unnamed: R1.1, U1.1, U2.1
unnamed: R2.1, U1.2, U2.2
unnamed: R3.1, U1.13, U3.1
unnamed: R4.1, U1.14, U3.2
unnamed: RV1.2, U1.7 (+)
unnamed: RV2.2, U1.4 (-)
unnamed: RV3.2, U1.11 (+)
unnamed: RV4.2, U1.8 (-)
unnamed: U2.4, U4.1
unnamed: U3.4, U4.2

Notes on the sheet:
0.436~3.235V analog signal No Brake~Brake
