NTURacingTeam/nturt_kicad/EP4/BatteryBox/SC_Board_EP4O_V2_20230615/IMD/IMD.kicad_sch

## KiCad design EP4/BatteryBox/SC_Board_EP4O_V2_20230615/IMD/IMD.kicad_sch (2023-08-07)

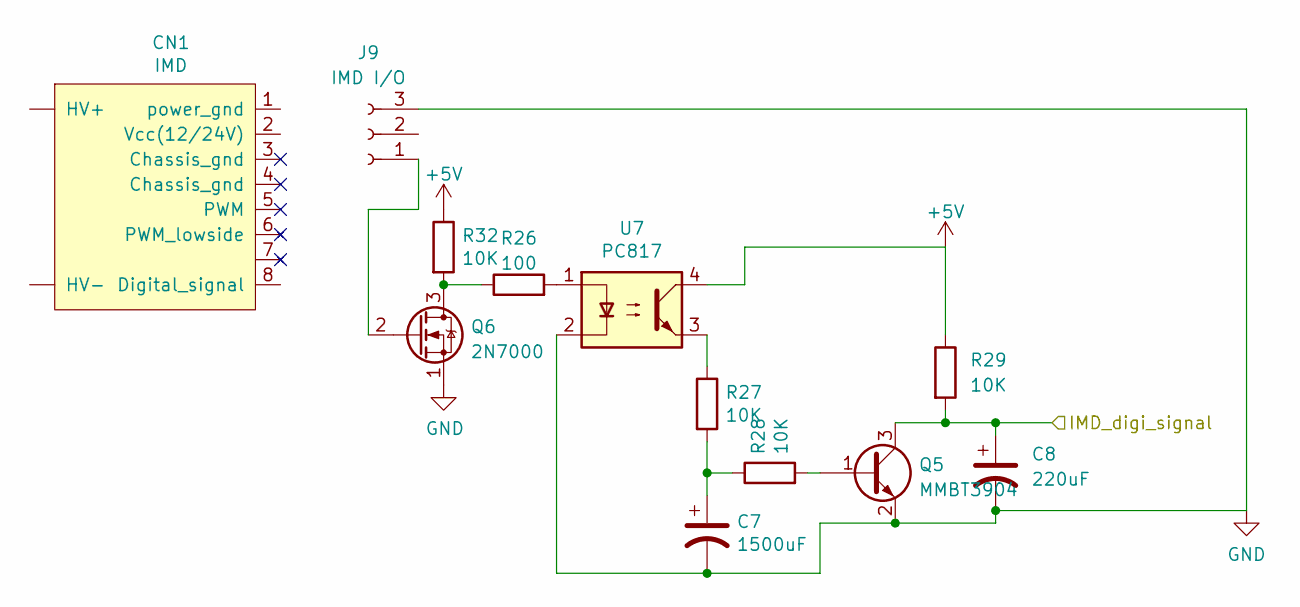
[picture p168: schematic IMD.kicad_sch]

Parts:
C7: 1500uF; CP_Radial_D10.0mm_P5.00mm
C8: 220uF; CP_Radial_D8.0mm_P5.00mm
CN1: IMD
J9: IMD I/O; JST_EH_B3B-EH-A_1x03_P2.50mm_Vertical
Q5: MMBT3904; TO-92L_Inline_Wide
Q6: 2N7000; TO-92L_Inline_Wide
R26: 100; R_Axial_DIN0207_L6.3mm_D2.5mm_P7.62mm_Horizontal
R27, R28, R29, R32: 10K; R_Axial_DIN0207_L6.3mm_D2.5mm_P7.62mm_Horizontal
U7: PC817; DIP-4_W7.62mm

Connections:
+5V: R29.1, R32.1, U7.4
GND: C7.2, C8.2, J9.3, Q5.2 (E), Q6.1 (S), U7.2
IMD_digi_signal: C8.1, Q5.3 (C), R29.2
unnamed: C7.1, R27.2, R28.1
unnamed: J9.1, Q6.2 (G)
unnamed: Q5.1 (B), R28.2
unnamed: Q6.3 (D), R26.1, R32.2
unnamed: R26.2, U7.1
unnamed: R27.1, U7.3
