NTURacingTeam/nturt_kicad/EP4/BatteryBox/SC_Board_EP4O_V2_20230615/Latch_Circuit/Latch_Circuit.kicad_sch

## KiCad design EP4/BatteryBox/SC_Board_EP4O_V2_20230615/Latch_Circuit/Latch_Circuit.kicad_sch (2023-08-07)

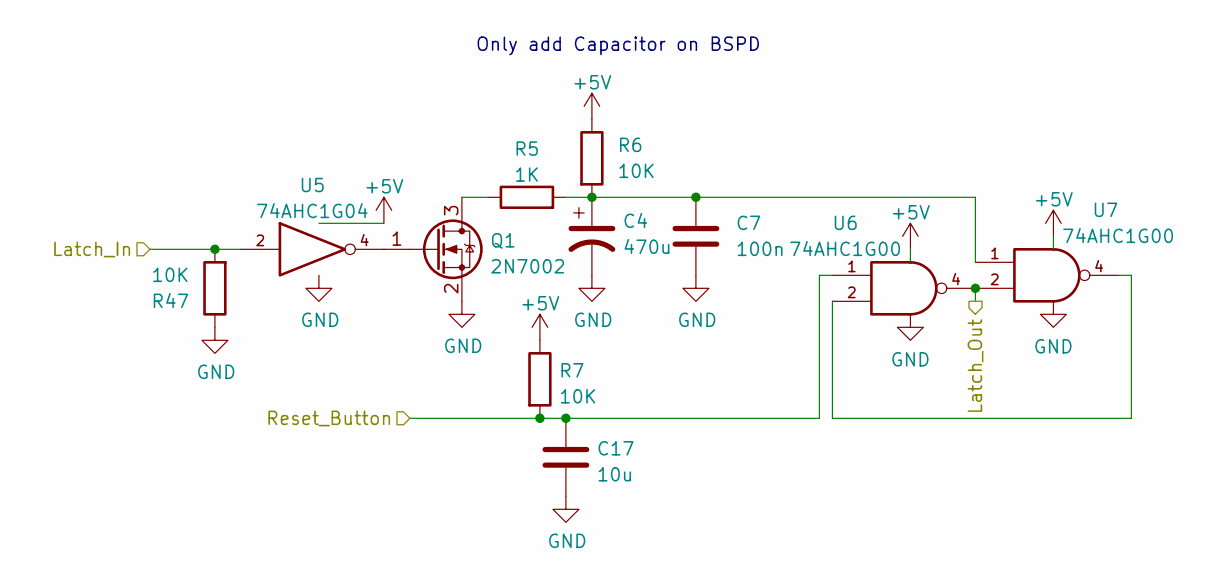
[picture p169: schematic Latch_Circuit.kicad_sch]

Parts:
C4: 470u; CP_Elec_10x10
C7: 100n; C_0805_2012Metric_Pad1.18x1.45mm_HandSolder
C17: 10u; C_1206_3216Metric_Pad1.33x1.80mm_HandSolder
Q1: 2N7002; SOT-23
R5: 1K; R_0805_2012Metric_Pad1.20x1.40mm_HandSolder
R6, R7, R47: 10K; R_0805_2012Metric_Pad1.20x1.40mm_HandSolder
U5: 74AHC1G04; SOT-23-5_HandSoldering
U6, U7: 74AHC1G00; SOT-23-5_HandSoldering

Connections:
+5V: R6.1, R7.1, U5.5 (VCC), U6.5 (VCC), U7.5 (VCC)
GND: C4.2, C7.2, C17.2, Q1.2 (S), R47.1, U5.3 (GND), U6.3 (GND), U7.3 (GND)
Latch_In: R47.2, U5.2
Latch_Out: U6.4, U7.2
unnamed: C4.1, C7.1, R5.2, R6.2, U7.1
unnamed: Q1.1 (G), U5.4
unnamed: Q1.3 (D), R5.1
unnamed: U6.2, U7.4
Reset_Button: C17.1, R7.2, U6.1

Notes on the sheet:
Only add Capacitor on BSPD
