NTURacingTeam/nturt_kicad/EP4/BatteryBox/SC_Board_EP4O_V2_20230615/TSAL/TSAL.kicad_sch

## KiCad design EP4/BatteryBox/SC_Board_EP4O_V2_20230615/TSAL/TSAL.kicad_sch (2023-08-07)

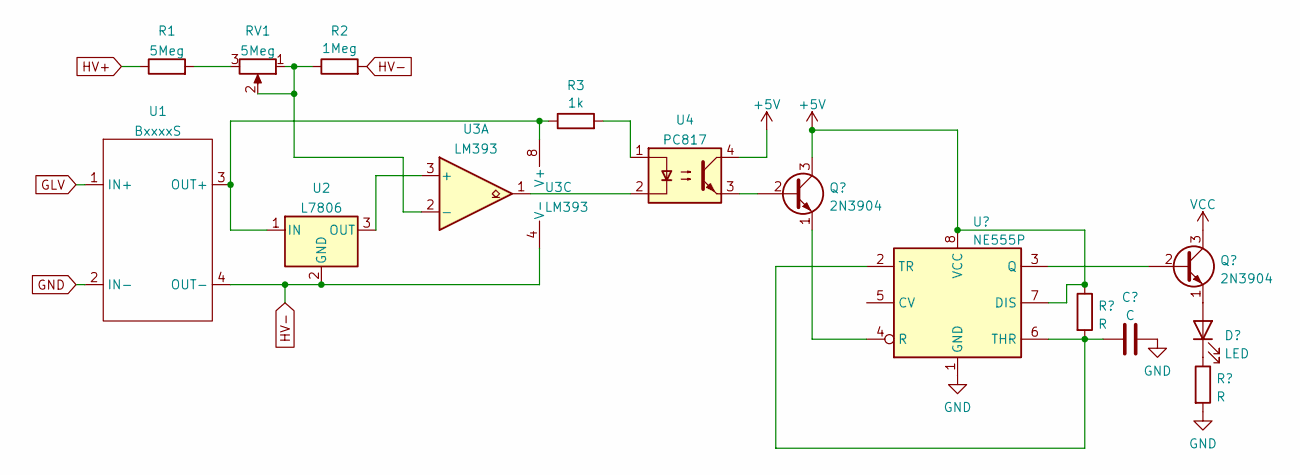
[picture p170: schematic TSAL.kicad_sch]

Parts:
R1: 5Meg
R2: 1Meg
R3: 1k
RV1: 5Meg
U1: BxxxxS
U2: L7806
U3: LM393
U4: PC817; DIP-4_W7.62mm

Connections:
GLV: U1.1 (IN+)
GND: U1.2 (IN-)
HV+: R1.1
HV-: R2.2, U1.4 (OUT-), U2.2 (GND), U3.4 (V-)
unnamed: R1.2, RV1.3
unnamed: R2.1, RV1.1, RV1.2, U3.2 (-)
unnamed: R3.1, U1.3 (OUT+), U2.1 (IN), U3.8 (V+)
unnamed: R3.2, U4.1
unnamed: U2.3 (OUT), U3.3 (+)
unnamed: U3.1, U4.2
