NTURacingTeam/nturt_kicad/EP4/Charger_Boards/Charger_SC_Board_V2_20220827/Latch_Circuit/Latch_Circuit.kicad_sch

## KiCad design EP4/Charger_Boards/Charger_SC_Board_V2_20220827/Latch_Circuit/Latch_Circuit.kicad_sch (2023-08-07)

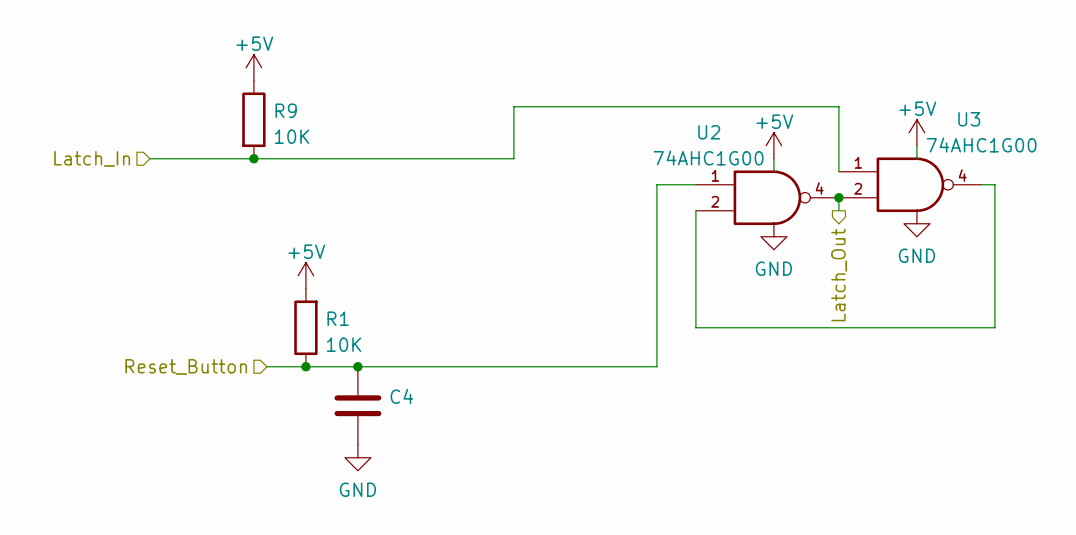
[picture p171: schematic Latch_Circuit.kicad_sch]

Parts:
C4: (no value)
R1, R9: 10K; R_1206_3216Metric_Pad1.30x1.75mm_HandSolder
U2, U3: 74AHC1G00; SOT-353_SC-70-5_Handsoldering

Connections:
+5V: R1.2, R9.1, U2.5 (VCC), U3.5 (VCC)
GND: C4.2, U2.3 (GND), U3.3 (GND)
Latch_In: R9.2, U3.1
Latch_Out: U2.4, U3.2
unnamed: U2.2, U3.4
Reset_Button: C4.1, R1.1, U2.1
