NTURacingTeam/nturt_kicad/EP5/Powertrain/BatteryBox/BMS_MASTER_STM32F103C8/BMS_MASTER_STM32F103C8.kicad_sch

## KiCad design EP5/Powertrain/BatteryBox/BMS_MASTER_STM32F103C8/BMS_MASTER_STM32F103C8.kicad_sch (2024-11-21)

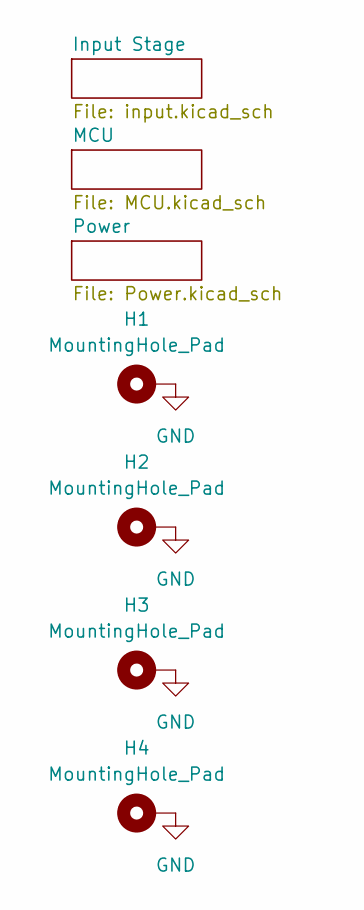
[picture p172: schematic BMS_MASTER_STM32F103C8.kicad_sch]

Parts:
H1, H2, H3, H4: MountingHole_Pad; MountingHole_4.3mm_M4_DIN965_Pad_TopBottom

Connections:
GND: H1.1, H2.1, H3.1, H4.1
