NTURacingTeam/nturt_kicad/EP5/Powertrain/BatteryBox/BMS_MASTER_STM32F103C8/MCU.kicad_sch

## KiCad design EP5/Powertrain/BatteryBox/BMS_MASTER_STM32F103C8/MCU.kicad_sch (2024-11-21)

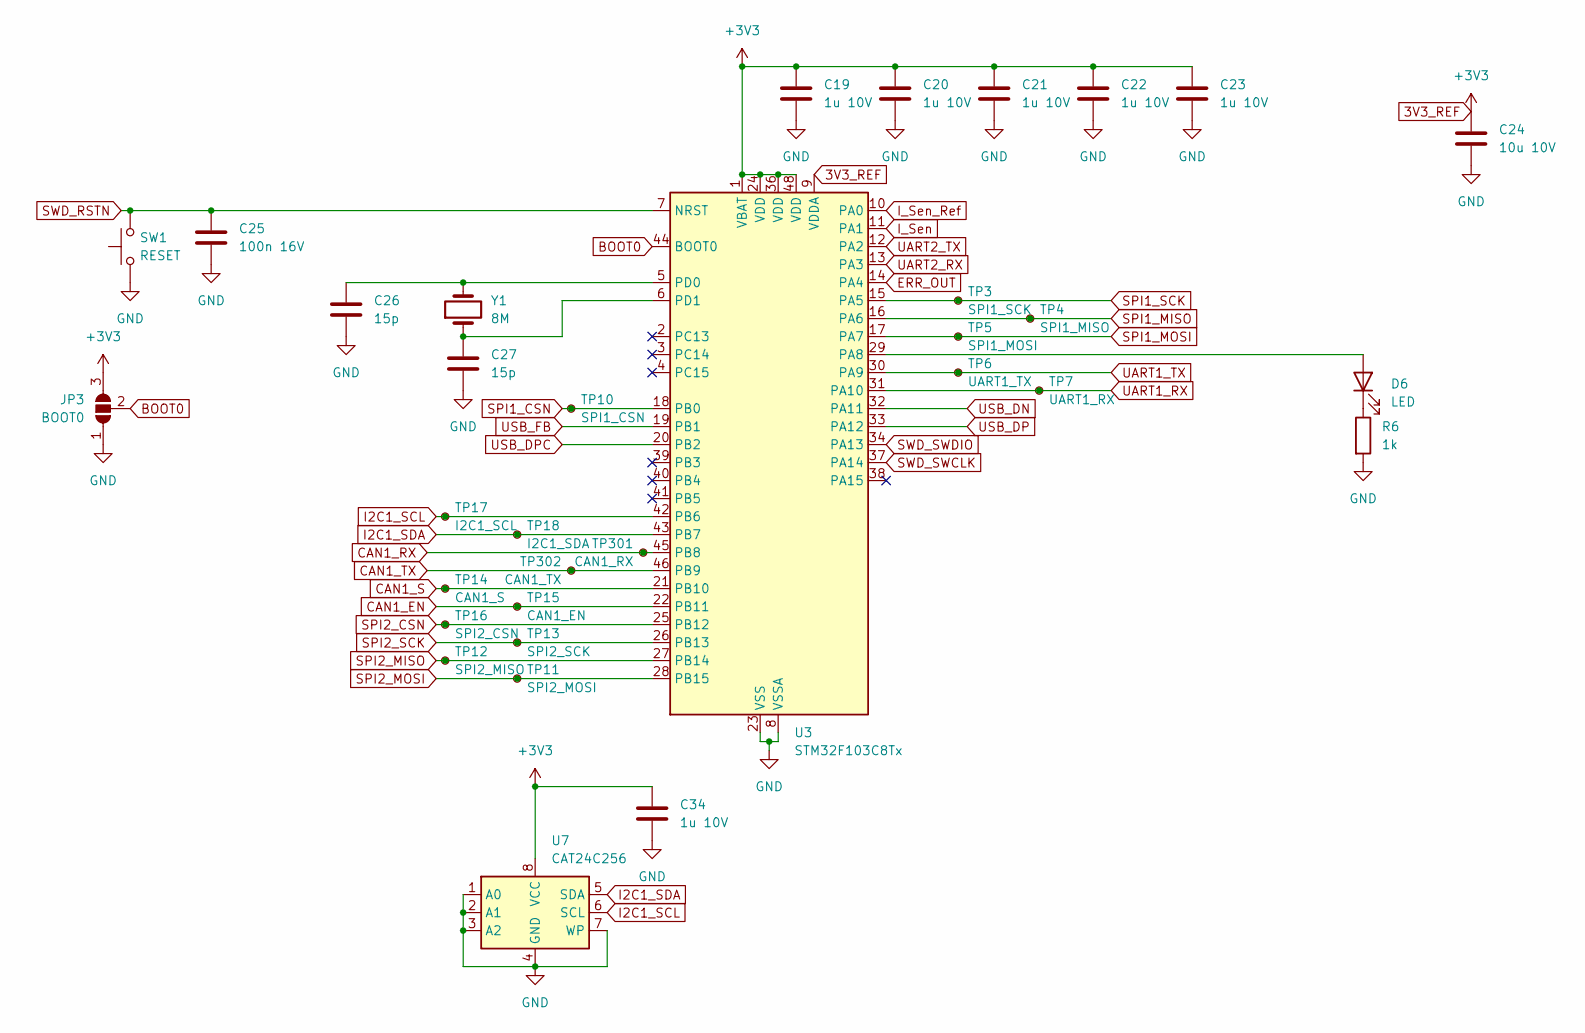
[picture p173: schematic MCU.kicad_sch]

Parts:
C19, C20, C21, C22, C23, C34: 1u 10V; C_0603_1608Metric
C24: 10u 10V; C_0603_1608Metric
C25: 100n 16V; C_0603_1608Metric
C26, C27: 15p; C_0603_1608Metric
D6: LED; LED_0603_1608Metric
JP3: BOOT0; SolderJumper-3_P1.3mm_Open_Pad1.0x1.5mm
R6: 1k; R_0603_1608Metric
SW1: RESET; SW_Push_1P1T_XKB_TS-1187A
TP3: SPI1_SCK; TestPoint_Pad_D1.0mm
TP4: SPI1_MISO; TestPoint_Pad_D1.0mm
TP5: SPI1_MOSI; TestPoint_Pad_D1.0mm
TP6: UART1_TX; TestPoint_Pad_D1.0mm
TP7: UART1_RX; TestPoint_Pad_D1.0mm
TP10: SPI1_CSN; TestPoint_Pad_D1.0mm
TP11: SPI2_MOSI; TestPoint_Pad_D1.0mm
TP12: SPI2_MISO; TestPoint_Pad_D1.0mm
TP13: SPI2_SCK; TestPoint_Pad_D1.0mm
TP14: CAN1_S; TestPoint_Pad_D1.0mm
TP15: CAN1_EN; TestPoint_Pad_D1.0mm
TP16: SPI2_CSN; TestPoint_Pad_D1.0mm
TP17: I2C1_SCL; TestPoint_Pad_D1.0mm
TP18: I2C1_SDA; TestPoint_Pad_D1.0mm
TP301: CAN1_RX; TestPoint_Pad_D1.0mm
TP302: CAN1_TX; TestPoint_Pad_D1.0mm
U3: STM32F103C8Tx; LQFP-48_7x7mm_P0.5mm
U7: CAT24C256; SOIC-8_3.9x4.9mm_P1.27mm
Y1: 8M; Crystal_SMD_TXC_7A-2Pin_5x3.2mm

Connections:
+3V3: C19.1, C20.1, C21.1, C22.1, C23.1, C24.1, C34.1, JP3.3 (B), U3.1 (VBAT), U3.9 (VDDA), U3.24 (VDD), U3.36 (VDD), U3.48 (VDD), U7.8 (VCC)
BOOT0: JP3.2 (C), U3.44 (BOOT0)
CAN1_EN: TP15.1, U3.22 (PB11)
CAN1_RX: TP301.1, U3.45 (PB8)
CAN1_S: TP14.1, U3.21 (PB10)
CAN1_TX: TP302.1, U3.46 (PB9)
ERR_OUT: U3.14 (PA4)
GND: C19.2, C20.2, C21.2, C22.2, C23.2, C24.2, C25.1, C26.1, C27.1, C34.2, JP3.1 (A), R6.2, SW1.1, U3.8 (VSSA), U3.23 (VSS), U3.35 (VSS), U3.47 (VSS), U7.1 (A0), U7.2 (A1), U7.3 (A2), U7.4 (GND), U7.7 (WP)
I2C1_SCL: TP17.1, U3.42 (PB6), U7.6 (SCL)
I2C1_SDA: TP18.1, U3.43 (PB7), U7.5 (SDA)
I_Sen: U3.11 (PA1)
I_Sen_Ref: U3.10 (PA0)
unnamed: C26.2, U3.5 (PD0), Y1.2
unnamed: C27.2, U3.6 (PD1), Y1.1
unnamed: D6.1 (K), R6.1
unnamed: D6.2 (A), U3.29 (PA8)
SPI1_CSN: TP10.1, U3.18 (PB0)
SPI1_MISO: TP4.1, U3.16 (PA6)
SPI1_MOSI: TP5.1, U3.17 (PA7)
SPI1_SCK: TP3.1, U3.15 (PA5)
SPI2_CSN: TP16.1, U3.25 (PB12)
SPI2_MISO: TP12.1, U3.27 (PB14)
SPI2_MOSI: TP11.1, U3.28 (PB15)
SPI2_SCK: TP13.1, U3.26 (PB13)
SWD_RSTN: C25.2, SW1.2, U3.7 (NRST)
SWD_SWCLK: U3.37 (PA14)
SWD_SWDIO: U3.34 (PA13)
UART1_RX: TP7.1, U3.31 (PA10)
UART1_TX: TP6.1, U3.30 (PA9)
UART2_RX: U3.13 (PA3)
UART2_TX: U3.12 (PA2)
USB_DN: U3.32 (PA11)
USB_DP: U3.33 (PA12)
USB_DPC: U3.20 (PB2)
USB_FB: U3.19 (PB1)
