NTURacingTeam/nturt_kicad/EP5/Powertrain/BatteryBox/BMS_MASTER_STM32F103C8/Power.kicad_sch

## KiCad design EP5/Powertrain/BatteryBox/BMS_MASTER_STM32F103C8/Power.kicad_sch (2024-11-21)

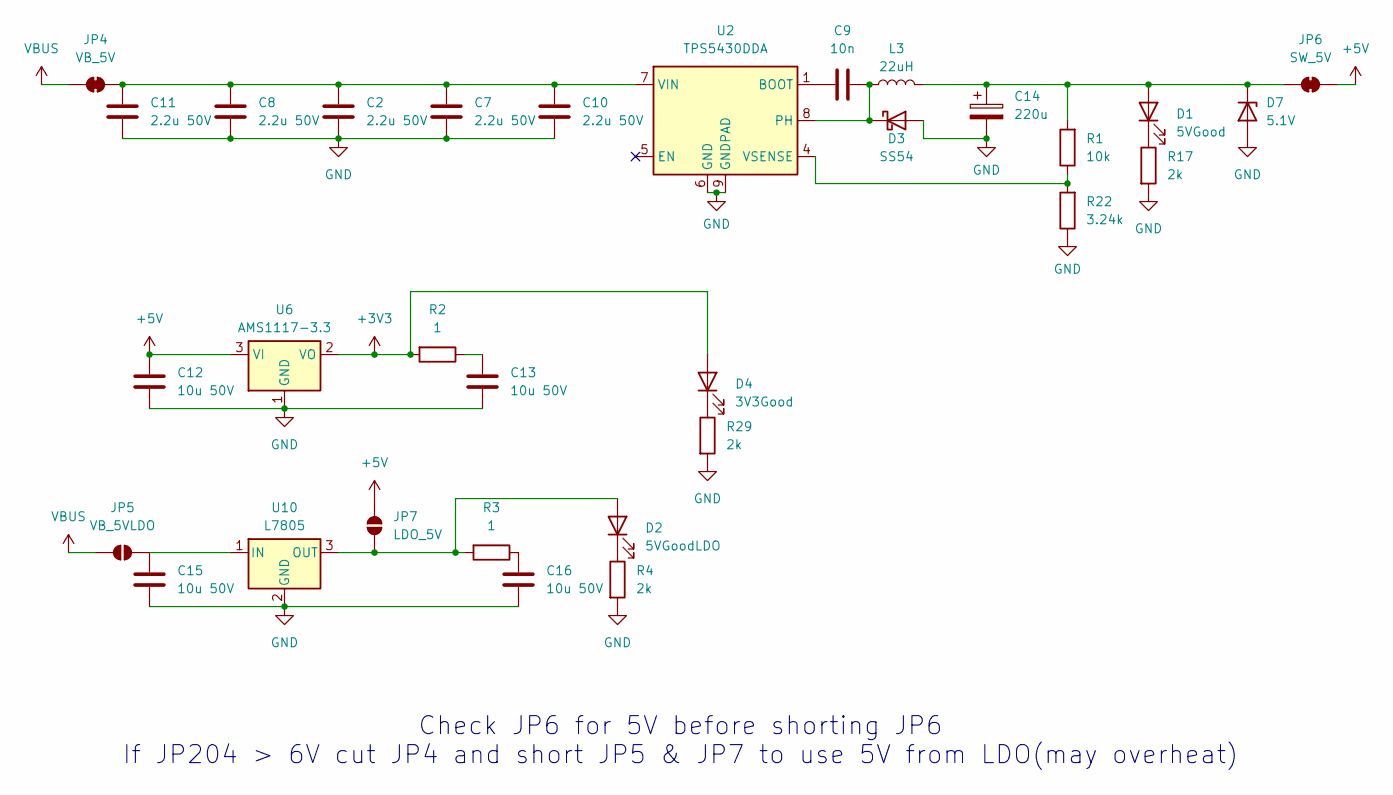
[picture p174: schematic Power.kicad_sch]

Parts:
C2, C7, C8, C10, C11: 2.2u 50V; C_0805_2012Metric
C9: 10n; C_0603_1608Metric
C12, C13, C15, C16: 10u 50V; C_1206_3216Metric
C14: 220u; CP_Elec_8x10.5
D1: 5VGood; LED_0603_1608Metric
D2: 5VGoodLDO; LED_0603_1608Metric
D3: SS54; D_SMA
D4: 3V3Good; LED_0603_1608Metric
D7: 5.1V; D_SOD-123
JP4: VB_5V; SolderJumper-2_P1.3mm_Bridged_Pad1.0x1.5mm
JP5: VB_5VLDO; SolderJumper-2_P1.3mm_Open_Pad1.0x1.5mm
JP6: SW_5V; SolderJumper-2_P1.3mm_Open_Pad1.0x1.5mm
JP7: LDO_5V; SolderJumper-2_P1.3mm_Open_Pad1.0x1.5mm
L3: 22uH; L_Bourns_SRR1260
R1: 10k; R_0603_1608Metric
R2, R3: 1; R_1206_3216Metric
R4, R17, R29: 2k; R_0603_1608Metric
R22: 3.24k; R_0603_1608Metric
U2: TPS5430DDA; TI_SO-PowerPAD-8_ThermalVias
U6: AMS1117-3.3; SOT-223-3_TabPin2
U10: L7805; TO-252-2

Connections:
+3V3: D4.2 (A), R2.2, U6.2 (VO)
+5V: C12.1, JP6.2 (B), JP7.2 (B), U6.3 (VI)
GND: C2.2, C7.2, C8.2, C10.2, C11.2, C12.2, C13.2, C14.2, C15.2, C16.2, D3.2 (A), D7.2 (A), R4.2, R17.2, R22.1, R29.2, U2.6 (GND), U2.9 (GNDPAD), U6.1 (GND), U10.2 (GND)
unnamed: C9.1, U2.1 (BOOT)
unnamed: C9.2, D3.1 (K), L3.1, U2.8 (PH)
unnamed: C2.1, C7.1, C8.1, C10.1, C11.1, JP4.2 (B), U2.7 (VIN)
unnamed: C13.1, R2.1
unnamed: C14.1, D1.2 (A), D7.1 (K), JP6.1 (A), L3.2, R1.2
unnamed: C15.1, JP5.2 (B), U10.1 (IN)
unnamed: C16.1, R3.1
unnamed: D1.1 (K), R17.1
unnamed: D2.1 (K), R4.1
unnamed: D2.2 (A), JP7.1 (A), R3.2, U10.3 (OUT)
unnamed: D4.1 (K), R29.1
unnamed: R1.1, R22.2, U2.4 (VSENSE)
VBUS: JP4.1 (A), JP5.1 (A)

Notes on the sheet:
Check JP6 for 5V before shorting JP6 If JP204 > 6V cut JP4 and short JP5 & JP7 to use 5V from LDO(may overheat)
