NTURacingTeam/nturt_kicad/EP5/Powertrain/BatteryBox/BMS_MASTER_STM32F103C8/input.kicad_sch

## KiCad design EP5/Powertrain/BatteryBox/BMS_MASTER_STM32F103C8/input.kicad_sch (2024-11-21)

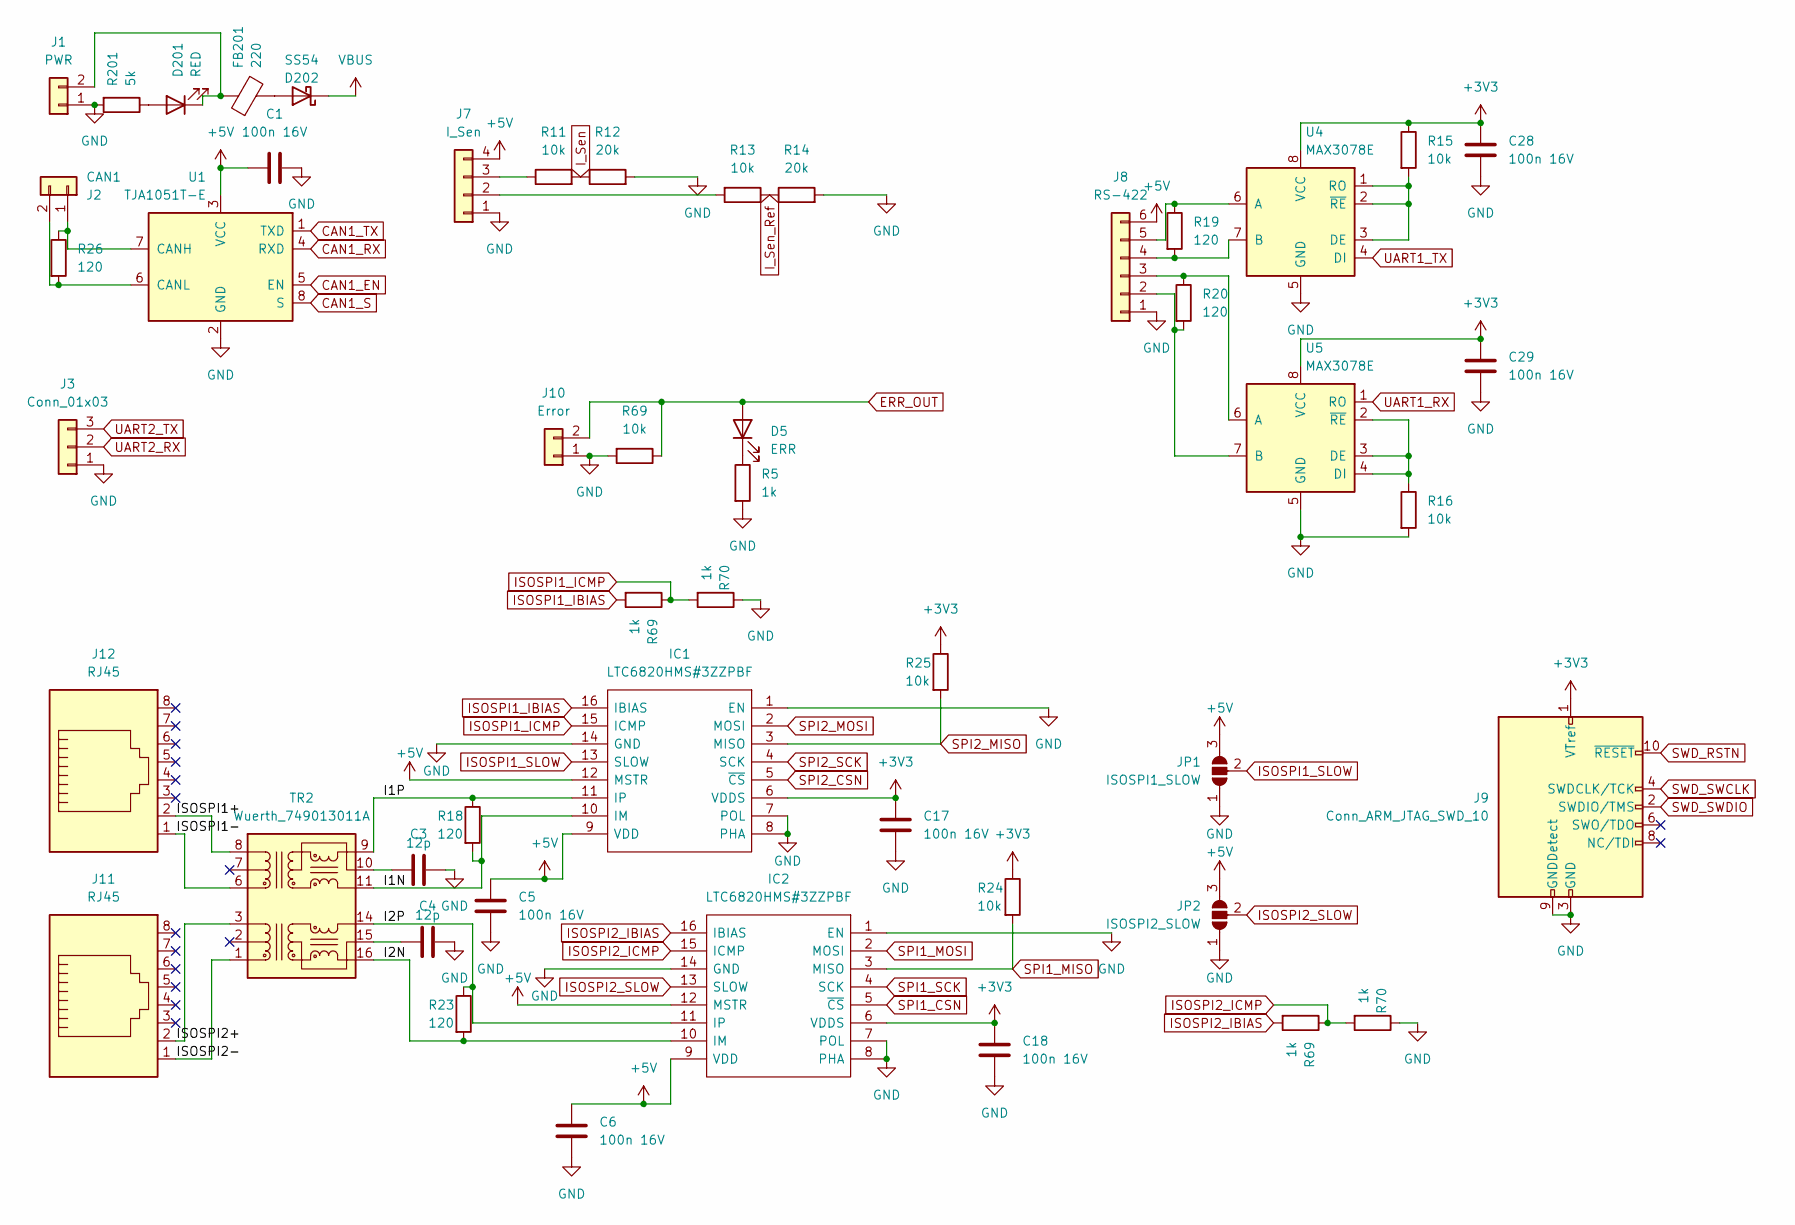
[picture p175: schematic input.kicad_sch]

Parts:
C1, C5, C6, C17, C18, C28, C29: 100n 16V; C_0603_1608Metric
C3, C4: 12p; C_0603_1608Metric
D5: ERR; LED_0603_1608Metric
D201: RED; LED_0603_1608Metric
D202: SS54; D_SMA
FB201: 220; R_0603_1608Metric
IC1, IC2: LTC6820HMS#3ZZPBF; SOP50P490X110-16N; Mouser Part Number 584-6820HMS#3ZZPB
J1: PWR; JST_XH_B2B-XH-A_1x02_P2.50mm_Vertical
J2: CAN1; JST_XH_B2B-XH-A_1x02_P2.50mm_Vertical
J3: Conn_01x03; JST_XH_B3B-XH-A_1x03_P2.50mm_Vertical
J7: I_Sen; JST_XH_B4B-XH-A_1x04_P2.50mm_Vertical
J8: RS-422; JST_XH_B6B-XH-A_1x06_P2.50mm_Vertical
J9: Conn_ARM_JTAG_SWD_10; PinHeader_2x05_P2.54mm_Vertical
J10: Error; JST_XH_B2B-XH-A_1x02_P2.50mm_Vertical
J11, J12: RJ45; RJ45_Amphenol_54602-x08_Horizontal
JP1: ISOSPI1_SLOW; SolderJumper-3_P1.3mm_Open_Pad1.0x1.5mm
JP2: ISOSPI2_SLOW; SolderJumper-3_P1.3mm_Open_Pad1.0x1.5mm
R5, R69, R70: 1k; R_0603_1608Metric
R11, R13, R15, R16, R24, R25: 10k; R_0603_1608Metric
R12, R14: 20k; R_0603_1608Metric
R18, R19, R20, R23, R26: 120; R_0603_1608Metric
R201: 5k; R_0603_1608Metric
TR2: Wuerth_749013011A; Transformer_Ethernet_Wuerth_749013011A
U1: TJA1051T-E; SOIC-8_3.9x4.9mm_P1.27mm
U4, U5: MAX3078E; SOIC-8_3.9x4.9mm_P1.27mm

Connections:
+3V3: C17.2, C18.2, C28.2, C29.2, IC1.6 (VDDS), IC2.6 (VDDS), J9.1 (VTref), R15.1, R24.1, R25.1, U4.8 (VCC), U5.8 (VCC)
+5V: C1.1, C5.2, C6.2, IC1.9 (VDD), IC1.12 (MSTR), IC2.9 (VDD), IC2.12 (MSTR), J7.4, J8.6, JP1.3 (B), JP2.3 (B), U1.3 (VCC)
CAN1_EN: U1.5 (EN)
CAN1_RX: U1.4 (RXD)
CAN1_S: U1.8 (S)
CAN1_TX: U1.1 (TXD)
ERR_OUT: D5.2 (A), J10.2, R69.1
GND: C1.2, C3.2, C4.2, C5.1, C6.1, C17.1, C18.1, C28.1, C29.1, IC1.1 (EN), IC1.7 (POL), IC1.8 (PHA), IC1.14 (GND), IC2.1 (EN), IC2.7 (POL), IC2.8 (PHA), IC2.14 (GND), J1.1, J3.1, J7.1, J8.1, J9.3 (GND), J9.5 (GND), J9.9 (GNDDetect), J10.1, JP1.1 (A), JP2.1 (A), R5.2, R12.2, R14.2, R16.2, R69.2, R70.1, R201.2, U1.2 (GND), U4.5 (GND), U5.5 (GND)
I1N: IC1.10 (IM), R18.2, TR2.11 (RX+)
I1P: IC1.11 (IP), R18.1, TR2.9 (RX-)
I2N: IC2.10 (IM), R23.2, TR2.16 (TX+)
I2P: IC2.11 (IP), R23.1, TR2.14 (TX-)
ISOSPI1+: J12.2, TR2.8 (RD-)
ISOSPI1-: J12.1, TR2.6 (RD+)
ISOSPI1_IBIAS: IC1.16 (IBIAS), R69.2
ISOSPI1_ICMP: IC1.15 (ICMP), R69.1, R70.2
ISOSPI1_SLOW: IC1.13 (SLOW), JP1.2 (C)
ISOSPI2+: J11.2, TR2.3 (TD-)
ISOSPI2-: J11.1, TR2.1 (TD+)
ISOSPI2_IBIAS: IC2.16 (IBIAS), R69.2
ISOSPI2_ICMP: IC2.15 (ICMP), R69.1, R70.2
ISOSPI2_SLOW: IC2.13 (SLOW), JP2.2 (C)
I_Sen: R11.2, R12.1
I_Sen_Ref: R13.1, R14.1
unnamed: C3.1, TR2.10 (C_RX)
unnamed: C4.1, TR2.15 (C_TX)
unnamed: D5.1 (K), R5.1
unnamed: D201.1 (K), FB201.1, J1.2
unnamed: D201.2 (A), R201.1
unnamed: D202.2 (A), FB201.2
unnamed: J2.1, R26.1, U1.7 (CANH)
unnamed: J2.2, R26.2, U1.6 (CANL)
unnamed: J7.2, R13.2
unnamed: J7.3, R11.1
unnamed: J8.2, R20.2, U5.7 (B)
unnamed: J8.3, R20.1, U5.6 (A)
unnamed: J8.4, R19.2, U4.7 (B)
unnamed: J8.5, R19.1, U4.6 (A)
unnamed: R15.2, U4.1 (RO), U4.2 (~RE), U4.3 (DE)
unnamed: R16.1, U5.2 (~RE), U5.3 (DE), U5.4 (DI)
SPI1_CSN: IC2.5 (~CS)
SPI1_MISO: IC2.3 (MISO), R24.2
SPI1_MOSI: IC2.2 (MOSI)
SPI1_SCK: IC2.4 (SCK)
SPI2_CSN: IC1.5 (~CS)
SPI2_MISO: IC1.3 (MISO), R25.2
SPI2_MOSI: IC1.2 (MOSI)
SPI2_SCK: IC1.4 (SCK)
SWD_RSTN: J9.10 (~RESET)
SWD_SWCLK: J9.4 (SWDCLK/TCK)
SWD_SWDIO: J9.2 (SWDIO/TMS)
UART1_RX: U5.1 (RO)
UART1_TX: U4.4 (DI)
UART2_RX: J3.2
UART2_TX: J3.3
VBUS: D202.1 (K)
