NTURacingTeam/nturt_kicad/EP5/Powertrain/BatteryBox/BMS_Slave_V1(ADBMS1818)/power.kicad_sch

## KiCad design EP5/Powertrain/BatteryBox/BMS_Slave_V1(ADBMS1818)/power.kicad_sch (2024-11-21)

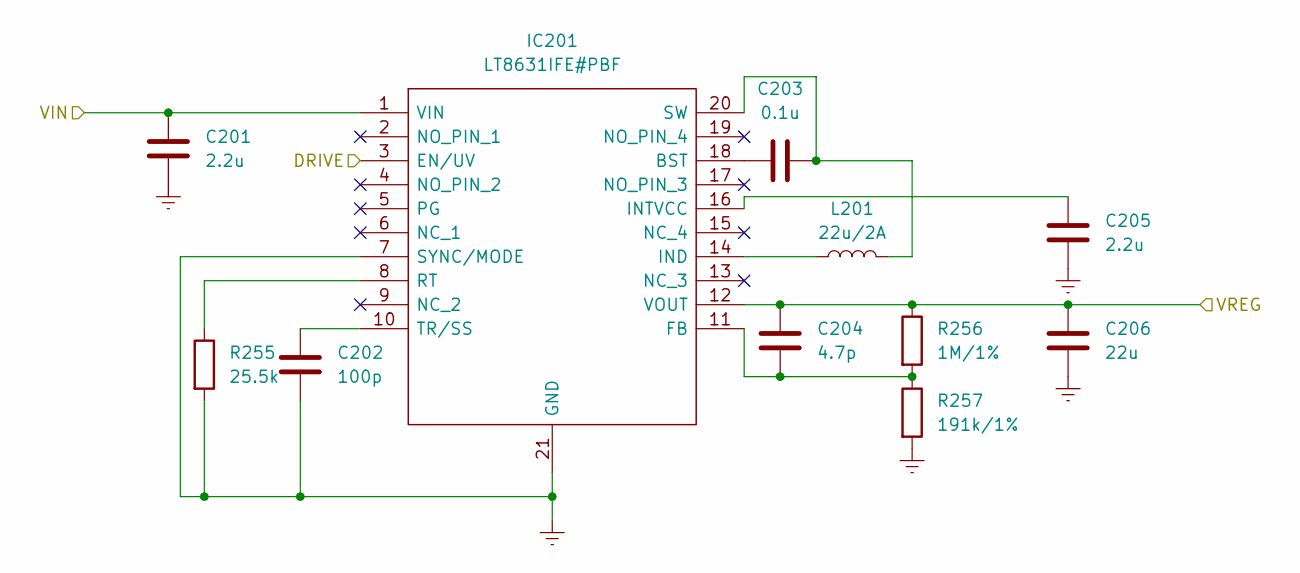
[picture p178: schematic power.kicad_sch]

Parts:
C201: 2.2u; C_2220_5650Metric
C202: 100p; C_0603_1608Metric
C203: 0.1u; C_0603_1608Metric
C204: 4.7p; C_0603_1608Metric
C205: 2.2u; C_0603_1608Metric
C206: 22u; C_1206_3216Metric
IC201: LT8631IFE#PBF; SOP65P640X120-21N; Mouser Part Number 584-LT8631IFE#PBF
L201: 22u/2A; L_Bourns-SRN8040_8x8.15mm
R255: 25.5k; R_0603_1608Metric
R256: 1M/1%; R_0603_1608Metric
R257: 191k/1%; R_0603_1608Metric

Connections:
DRIVE: IC201.3 (EN/UV)
Earth: C201.2, C202.2, C205.2, C206.2, IC201.7 (SYNC/MODE), IC201.21 (GND), R255.2, R257.2
unnamed: C202.1, IC201.10 (TR/SS)
unnamed: C203.1, IC201.18 (BST)
unnamed: C203.2, IC201.20 (SW), L201.2
unnamed: C204.1, IC201.11 (FB), R256.2, R257.1
unnamed: C205.1, IC201.16 (INTVCC)
unnamed: IC201.8 (RT), R255.1
unnamed: IC201.14 (IND), L201.1
VIN: C201.1, IC201.1 (VIN)
VREG: C204.2, C206.1, IC201.12 (VOUT), R256.1
