NTURacingTeam/nturt_kicad/EP5/Powertrain/BatteryBox/Connector_Board/Connector_Board.kicad_sch

## KiCad design EP5/Powertrain/BatteryBox/Connector_Board/Connector_Board.kicad_sch (2024-11-21)

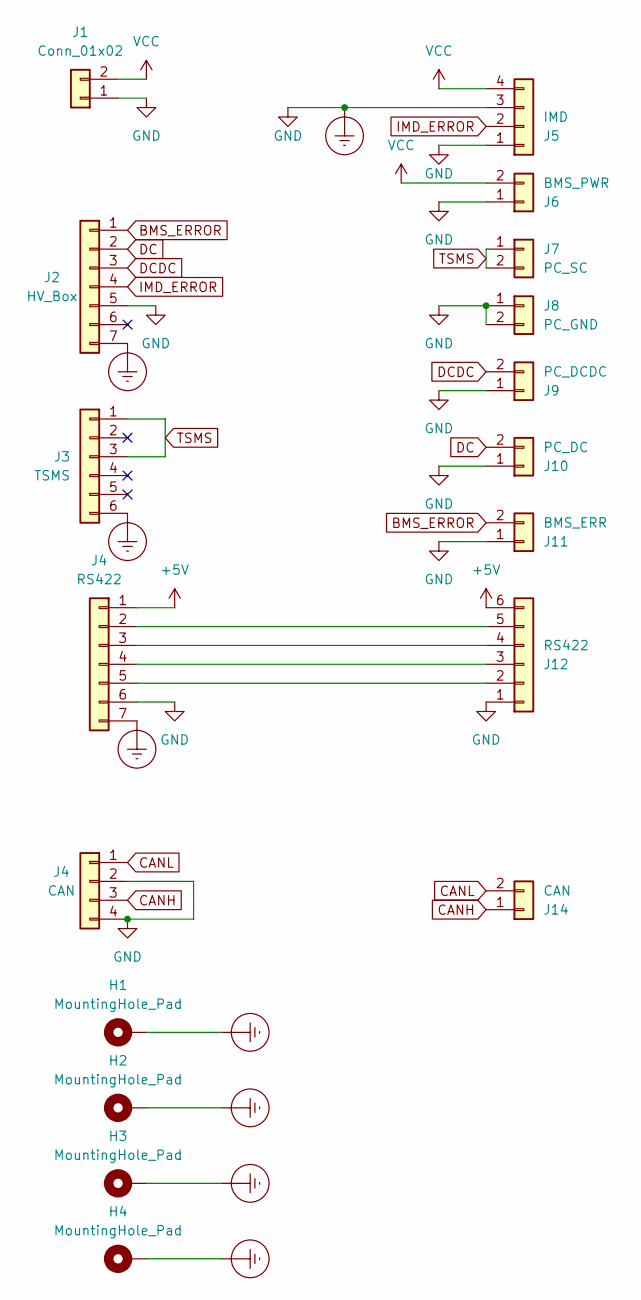
[picture p179: schematic Connector_Board.kicad_sch]

Parts:
H1, H2, H3, H4: MountingHole_Pad; MountingHole_4.3mm_M4_DIN965_Pad_TopBottom
J1: Conn_01x02; JST_VH_B2P-VH-B_1x02_P3.96mm_Vertical
J2: HV_Box; M8 5-6P w Ground
J3: TSMS; M12 2-5P w Ground
J4: RS422; M8 5-6P w Ground
J5: IMD; JST_XH_B4B-XH-A_1x04_P2.50mm_Vertical
J6: BMS_PWR; JST_XH_B2B-XH-A_1x02_P2.50mm_Vertical
J7: PC_SC; JST_XH_B2B-XH-A_1x02_P2.50mm_Vertical
J8: PC_GND; JST_XH_B2B-XH-A_1x02_P2.50mm_Vertical
J9: PC_DCDC; JST_XH_B2B-XH-A_1x02_P2.50mm_Vertical
J10: PC_DC; JST_XH_B2B-XH-A_1x02_P2.50mm_Vertical
J11: BMS_ERR; JST_XH_B2B-XH-A_1x02_P2.50mm_Vertical
J12: RS422; JST_XH_B6B-XH-A_1x06_P2.50mm_Vertical
J14: CAN; JST_XH_B2B-XH-A_1x02_P2.50mm_Vertical

Connections:
+5V: J4.1, J12.6
BMS_ERROR: J2.1, J11.2
CANH: J4.3, J14.1
CANL: J4.1, J14.2
DC: J2.2, J10.2
DCDC: J2.3, J9.2
Earth_Protective: H1.1, H2.1, H3.1, H4.1, J1.1, J2.5, J2.7, J3.6, J4.2, J4.4, J4.6, J4.7, J5.1, J5.3, J6.1, J8.1, J8.2, J9.1, J10.1, J11.1, J12.1
IMD_ERROR: J2.4, J5.2
unnamed: J4.5, J12.2
unnamed: J4.4, J12.3
unnamed: J4.3, J12.4
unnamed: J4.2, J12.5
TSMS: J3.1, J3.3, J7.1, J7.2
VCC: J1.2, J5.4, J6.2
