NTURacingTeam/nturt_kicad/EP5/Powertrain/BatteryBox/Indicator/Indicator.kicad_sch

## KiCad design EP5/Powertrain/BatteryBox/Indicator/Indicator.kicad_sch (2024-11-21)

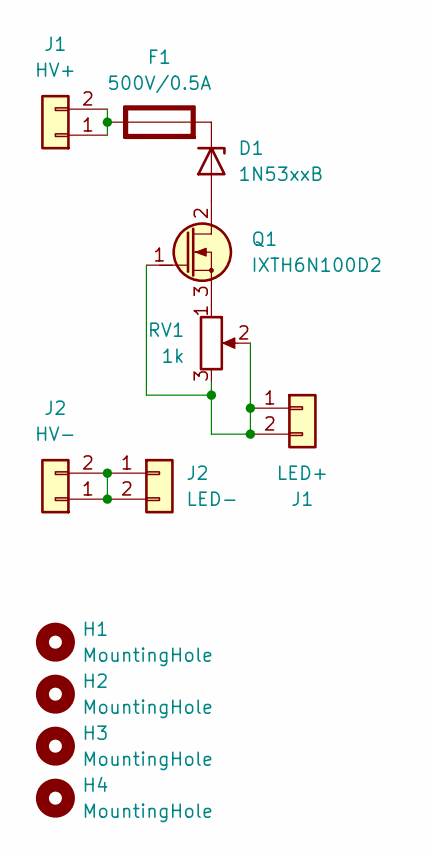
[picture p180: schematic Indicator.kicad_sch]

Parts:
D1: 1N53xxB; D_DO-201_P15.24mm_Horizontal
F1: 500V/0.5A; 65600001009; Rating W
H1, H2, H3, H4: MountingHole; MountingHole_4.3mm_M4_DIN965
J1: HV+; DF33C2P33DSA24
J2: LED-; DF33C2P33DSA24
Q1: IXTH6N100D2; TO-247-3_Vertical
RV1: 1k; Potentiometer_Bourns_3386C_Horizontal

Connections:
unnamed: D1.1 (K), F1.2 (-)
unnamed: D1.2 (A), Q1.2 (D)
unnamed: F1.1 (+), J1.1, J1.2
unnamed: J1.1, J1.2, Q1.1 (G), RV1.2, RV1.3
unnamed: J2.1, J2.2
unnamed: Q1.3 (S), RV1.1
