NTURacingTeam/nturt_kicad/EP5/Powertrain/BatteryBox/PreCharge/PreCharge.kicad_sch

## KiCad design EP5/Powertrain/BatteryBox/PreCharge/PreCharge.kicad_sch (2024-11-21)

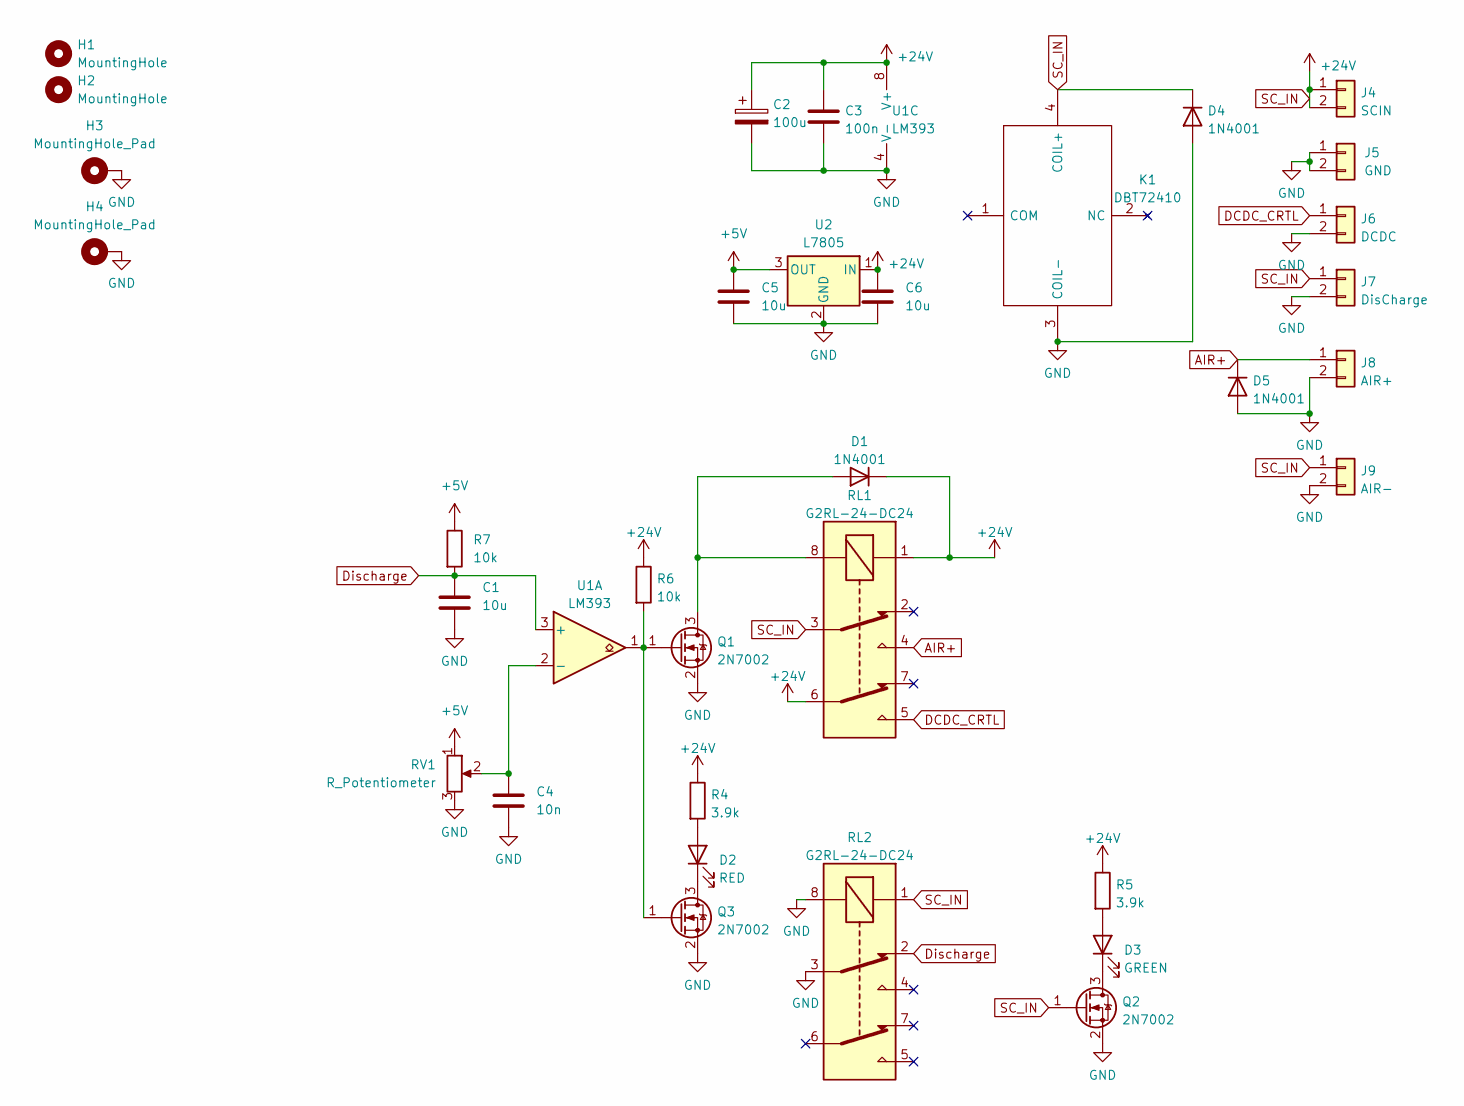
[picture p181: schematic PreCharge.kicad_sch]

Parts:
C1, C5, C6: 10u; C_0805_2012Metric_Pad1.18x1.45mm_HandSolder
C2: 100u; CP_Elec_10x10
C3: 100n; C_0805_2012Metric_Pad1.18x1.45mm_HandSolder
C4: 10n; C_0805_2012Metric_Pad1.18x1.45mm_HandSolder
D1, D4, D5: 1N4001; D_SOD-123F
D2: RED; LED_0805_2012Metric_Pad1.15x1.40mm_HandSolder
D3: GREEN; LED_0805_2012Metric_Pad1.15x1.40mm_HandSolder
H1, H2: MountingHole; MountingHole_4.3mm_M4_DIN965
H3, H4: MountingHole_Pad; MountingHole_4.3mm_M4_DIN965_Pad_TopBottom
J4: SCIN; JST_XH_B2B-XH-A_1x02_P2.50mm_Vertical
J5: GND; JST_XH_B2B-XH-A_1x02_P2.50mm_Vertical
J6: DCDC; JST_XH_B2B-XH-A_1x02_P2.50mm_Vertical
J7: DisCharge; JST_XH_B2B-XH-A_1x02_P2.50mm_Vertical
J8: AIR+; DF33C2P33DSA24
J9: AIR-; DF33C2P33DSA24
K1: DBT72410; Manufacturer_Part_Number DBT72410
Q1, Q2, Q3: 2N7002; SOT-23
R4, R5: 3.9k; R_0805_2012Metric_Pad1.20x1.40mm_HandSolder
R6, R7: 10k; R_0805_2012Metric_Pad1.20x1.40mm_HandSolder
RL1, RL2: G2RL-24-DC24; Relay_DPDT_Omron_G2RL
RV1: R_Potentiometer; Potentiometer_Bourns_3299W_Vertical
U1: LM393; SOIC-8_3.9x4.9mm_P1.27mm
U2: L7805; TO-252-3_TabPin2

Connections:
+5V: C5.1, R7.1, RV1.1, U2.3 (OUT)
+24V: C2.1, C3.1, C6.1, D1.1 (K), D4.1 (K), J4.1, J4.2, J7.1, J9.1, K1.4 (COIL+), Q2.1 (G), R4.1, R5.1, R6.1, RL1.1, RL1.3, RL1.6, RL2.1, U1.8 (V+), U2.1 (IN)
AIR+: D5.1 (K), J8.1, RL1.4
DCDC_CRTL: J6.1, RL1.5
Discharge: C1.1, R7.2, RL2.2, U1.3 (+)
GND: C1.2, C2.2, C3.2, C4.2, C5.2, C6.2, D4.2 (A), D5.2 (A), H3.1, H4.1, J5.1, J5.2, J6.2, J7.2, J8.2, J9.2, K1.3 (COIL-), Q1.2 (S), Q2.2 (S), Q3.2 (S), RL2.3, RL2.8, RV1.3, U1.4 (V-), U2.2 (GND)
unnamed: C4.1, RV1.2, U1.2 (-)
unnamed: D1.2 (A), Q1.3 (D), RL1.8
unnamed: D2.1 (K), Q3.3 (D)
unnamed: D2.2 (A), R4.2
unnamed: D3.1 (K), Q2.3 (D)
unnamed: D3.2 (A), R5.2
unnamed: Q1.1 (G), Q3.1 (G), R6.2, U1.1
