NTURacingTeam/nturt_kicad/EP5/Powertrain/HVBox/Connector_Board_HV/Connector_Board_HV.kicad_sch

## KiCad design EP5/Powertrain/HVBox/Connector_Board_HV/Connector_Board_HV.kicad_sch (2024-11-21)

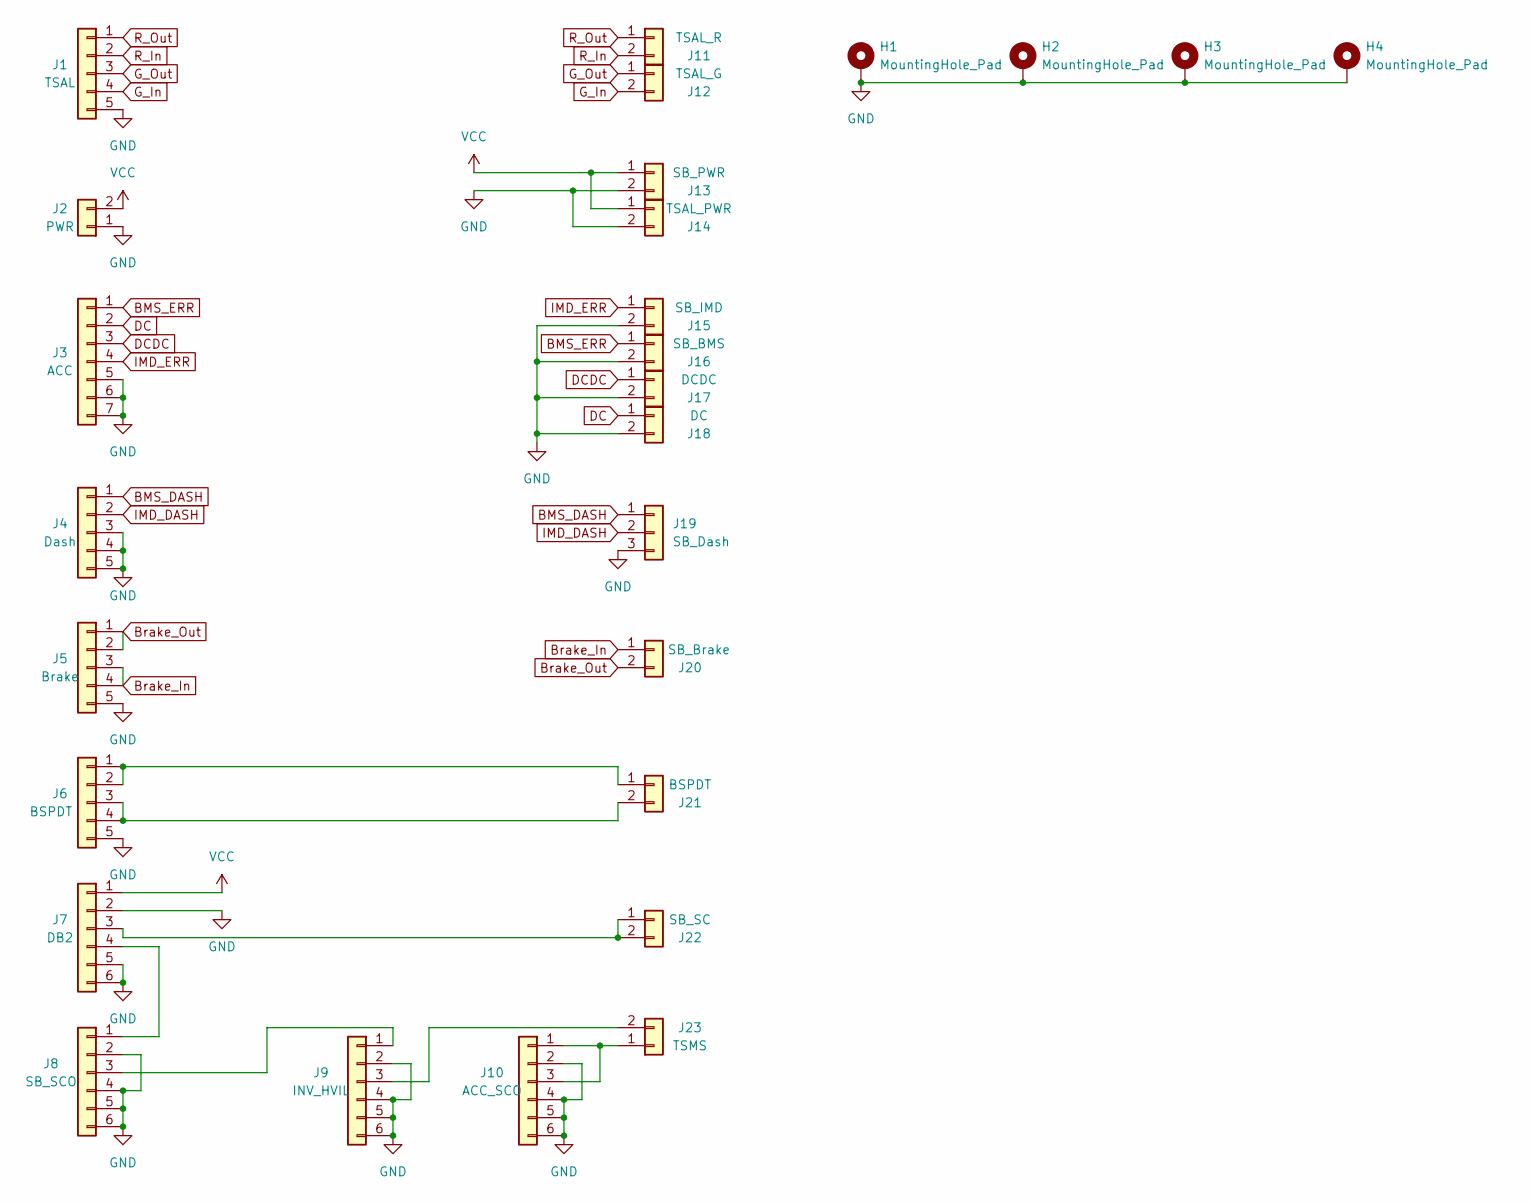
[picture p182: schematic Connector_Board_HV.kicad_sch]

Parts:
H1, H2, H3, H4: MountingHole_Pad; MountingHole_4.3mm_M4_DIN965_Pad_TopBottom
J1: TSAL; M8 2P 4P w Ground
J2: PWR; JST_VH_B2P-VH-B_1x02_P3.96mm_Vertical
J3: ACC; M8 5-6P w Ground
J4: Dash; M8 2P 4P w Ground
J5: Brake; M8 2P 4P w Ground
J6: BSPDT; M8 2P 4P w Ground
J7: DB2; M12 2-5P w Ground
J8: SB_SCO; M12 2-5P w Ground
J9: INV_HVIL; M12 2-5P w Ground
J10: ACC_SCO; M12 2-5P w Ground
J11: TSAL_R; JST_XH_B2B-XH-A_1x02_P2.50mm_Vertical
J12: TSAL_G; JST_XH_B2B-XH-A_1x02_P2.50mm_Vertical
J13: SB_PWR; JST_VH_B2P-VH-B_1x02_P3.96mm_Vertical
J14: TSAL_PWR; JST_XH_B2B-XH-A_1x02_P2.50mm_Vertical
J15: SB_IMD; JST_XH_B2B-XH-A_1x02_P2.50mm_Vertical
J16: SB_BMS; JST_XH_B2B-XH-A_1x02_P2.50mm_Vertical
J17: DCDC; JST_XH_B2B-XH-A_1x02_P2.50mm_Vertical
J18: DC; JST_XH_B2B-XH-A_1x02_P2.50mm_Vertical
J19: SB_Dash; JST_XH_B3B-XH-A_1x03_P2.50mm_Vertical
J20: SB_Brake; JST_XH_B2B-XH-A_1x02_P2.50mm_Vertical
J21: BSPDT; JST_XH_B2B-XH-A_1x02_P2.50mm_Vertical
J22: SB_SC; JST_XH_B2B-XH-A_1x02_P2.50mm_Vertical
J23: TSMS; JST_VH_B2P-VH-B_1x02_P3.96mm_Vertical

Connections:
BMS_DASH: J4.1, J19.1
BMS_ERR: J3.1, J16.1
Brake_In: J5.3, J5.4, J20.1
Brake_Out: J5.1, J5.2, J20.2
DC: J3.2, J18.1
DCDC: J3.3, J17.1
GND: H1.1, H2.1, H3.1, H4.1, J1.5, J2.1, J3.5, J3.6, J3.7, J4.3, J4.4, J4.5, J5.5, J6.5, J7.2, J7.5, J7.6, J8.2, J8.4, J8.5, J8.6, J9.2, J9.4, J9.5, J9.6, J10.2, J10.4, J10.5, J10.6, J13.2, J14.2, J15.2, J16.2, J17.2, J18.2, J19.3
G_In: J1.4, J12.2
G_Out: J1.3, J12.1
IMD_DASH: J4.2, J19.2
IMD_ERR: J3.4, J15.1
unnamed: J7.4, J8.1
unnamed: J8.3, J9.1
unnamed: J10.1, J10.3, J23.1
unnamed: J6.1, J6.2, J21.1
unnamed: J6.3, J6.4, J21.2
unnamed: J7.3, J22.1, J22.2
unnamed: J9.3, J23.2
R_In: J1.2, J11.2
R_Out: J1.1, J11.1
VCC: J2.2, J7.1, J13.1, J14.1
