NTURacingTeam/nturt_kicad/EP5/Powertrain/HVBox/DCDC_Control_V1_20230915/DCDC_Control_V1_20230915.kicad_sch

## KiCad design EP5/Powertrain/HVBox/DCDC_Control_V1_20230915/DCDC_Control_V1_20230915.kicad_sch (2024-11-21)

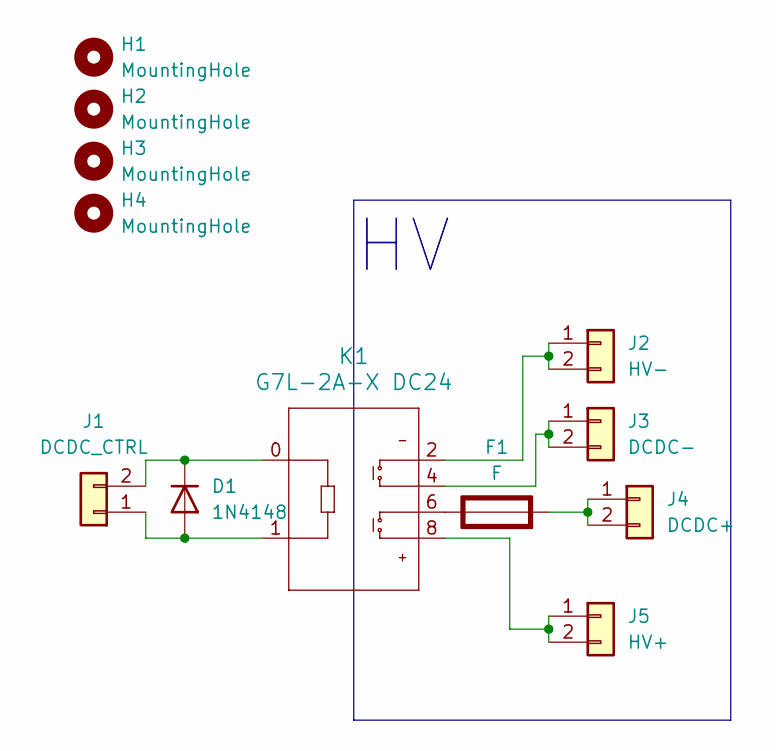
[picture p183: schematic DCDC_Control_V1_20230915.kicad_sch]

Parts:
D1: 1N4148; D_DO-35_SOD27_P7.62mm_Horizontal
F1: F; 65600001009; Rating W
H1, H2, H3, H4: MountingHole; MountingHole_4.3mm_M4_DIN965
J1: DCDC_CTRL; JST_XH_B2B-XH-A_1x02_P2.50mm_Vertical
J2: HV-; DF33C2P33DSA24
J3: DCDC-; DF33C2P33DSA24
J4: DCDC+; DF33C2P33DSA24
J5: HV+; DF33C2P33DSA24
K1: G7L-2A-X DC24; RELAY_G7L-2A-X_OMR

Connections:
unnamed: D1.1 (K), J1.2, K1.0
unnamed: D1.2 (A), J1.1, K1.1
unnamed: F1.1 (+), K1.6
unnamed: F1.2 (-), J4.1, J4.2
unnamed: J2.1, J2.2, K1.2
unnamed: J3.1, J3.2, K1.4
unnamed: J5.1, J5.2, K1.8
