NTURacingTeam/nturt_kicad/EP5/Powertrain/HVBox/DC_V1_20230911/DC_V1_20230911.kicad_sch

## KiCad design EP5/Powertrain/HVBox/DC_V1_20230911/DC_V1_20230911.kicad_sch (2024-11-21)

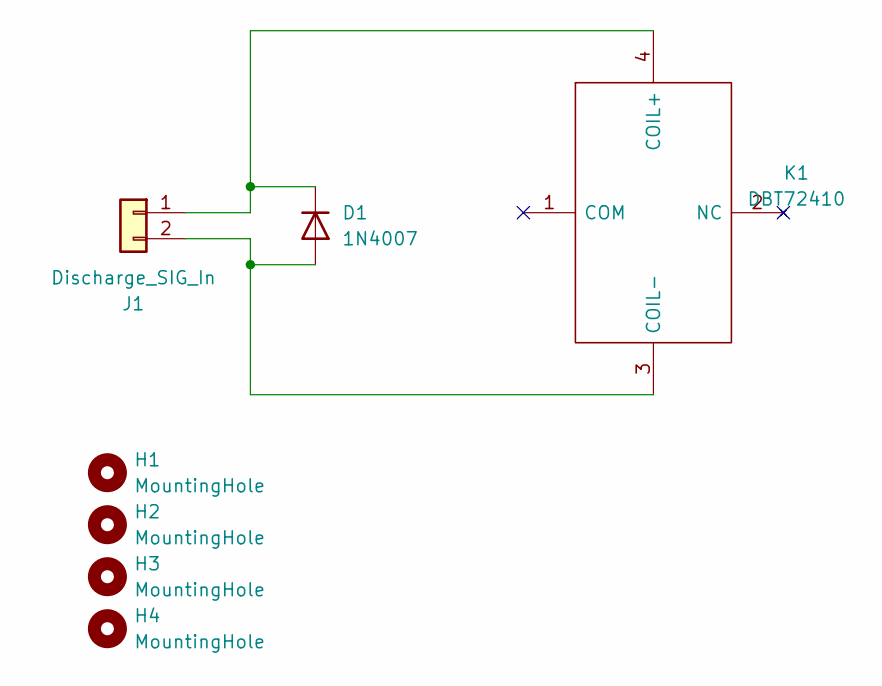
[picture p184: schematic DC_V1_20230911.kicad_sch]

Parts:
D1: 1N4007; D_DO-41_SOD81_P10.16mm_Horizontal
H1, H2, H3, H4: MountingHole; MountingHole_4.3mm_M4_DIN965
J1: Discharge_SIG_In; JST_XH_S2B-XH-A_1x02_P2.50mm_Horizontal
K1: DBT72410; Manufacturer_Part_Number DBT72410

Connections:
unnamed: D1.1 (K), J1.1, K1.4 (COIL+)
unnamed: D1.2 (A), J1.2, K1.3 (COIL-)
