NTURacingTeam/nturt_kicad/EP5/Powertrain/HVBox/SC_Board/BSPD.kicad_sch

## KiCad design EP5/Powertrain/HVBox/SC_Board/BSPD.kicad_sch (2024-11-21)

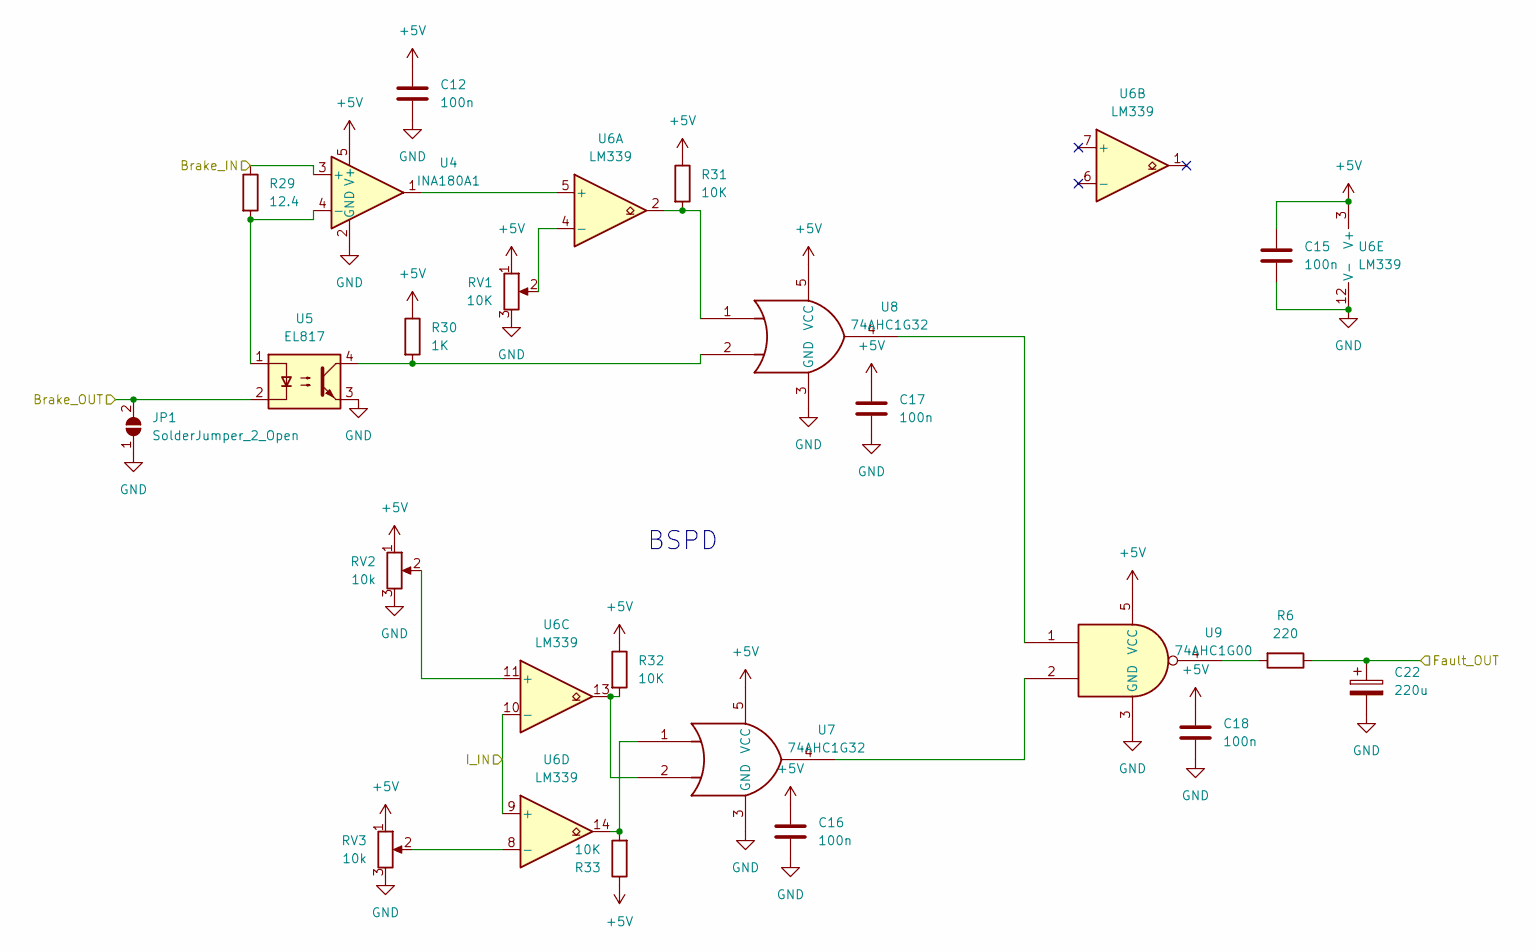
[picture p185: schematic BSPD.kicad_sch]

Parts:
C12, C15, C16, C17, C18: 100n; C_0805_2012Metric
C22: 220u; CP_Elec_6.3x4.9
JP1: SolderJumper_2_Open; SolderJumper-2_P1.3mm_Open_RoundedPad1.0x1.5mm
R6: 220; R_0805_2012Metric
R29: 12.4; R_0805_2012Metric
R30: 1K; R_0805_2012Metric
R31, R32, R33: 10K; R_0805_2012Metric
RV1: 10K; Potentiometer_Bourns_3266W_Vertical
RV2, RV3: 10k; Potentiometer_Bourns_3266W_Vertical
U4: INA180A1; SOT-23-5
U5: EL817; DIP-4_W7.62mm
U6: LM339; SOIC-14_3.9x8.7mm_P1.27mm
U7, U8: 74AHC1G32; SOT-23-5
U9: 74AHC1G00; SOT-23-5

Connections:
+5V: C12.1, C15.1, C16.1, C17.1, C18.1, R30.1, R31.1, R32.1, R33.1, RV1.1, RV2.1, RV3.1, U4.5 (V+), U6.3 (V+), U7.5 (VCC), U8.5 (VCC), U9.5 (VCC)
Brake_IN: R29.1, U4.3 (+)
Brake_OUT: JP1.2 (B), U5.2
Fault_OUT: C22.1, R6.1
GND: C12.2, C15.2, C16.2, C17.2, C18.2, C22.2, JP1.1 (A), RV1.3, RV2.3, RV3.3, U4.2 (GND), U5.3, U6.12 (V-), U7.3 (GND), U8.3 (GND), U9.3 (GND)
I_IN: U6.9 (+), U6.10 (-)
unnamed: R6.2, U9.4
unnamed: R29.2, U4.4 (-), U5.1
unnamed: R30.2, U5.4, U8.2
unnamed: R31.2, U6.2, U8.1
unnamed: R32.2, U6.13, U7.2
unnamed: R33.2, U6.14, U7.1
unnamed: RV1.2, U6.4 (-)
unnamed: RV2.2, U6.11 (+)
unnamed: RV3.2, U6.8 (-)
unnamed: U4.1, U6.5 (+)
unnamed: U7.4, U9.2
unnamed: U8.4, U9.1

Notes on the sheet:
BSPD
