NTURacingTeam/nturt_kicad/EP5/Powertrain/HVBox/SC_Board/Latch.kicad_sch

## KiCad design EP5/Powertrain/HVBox/SC_Board/Latch.kicad_sch (2024-11-21)

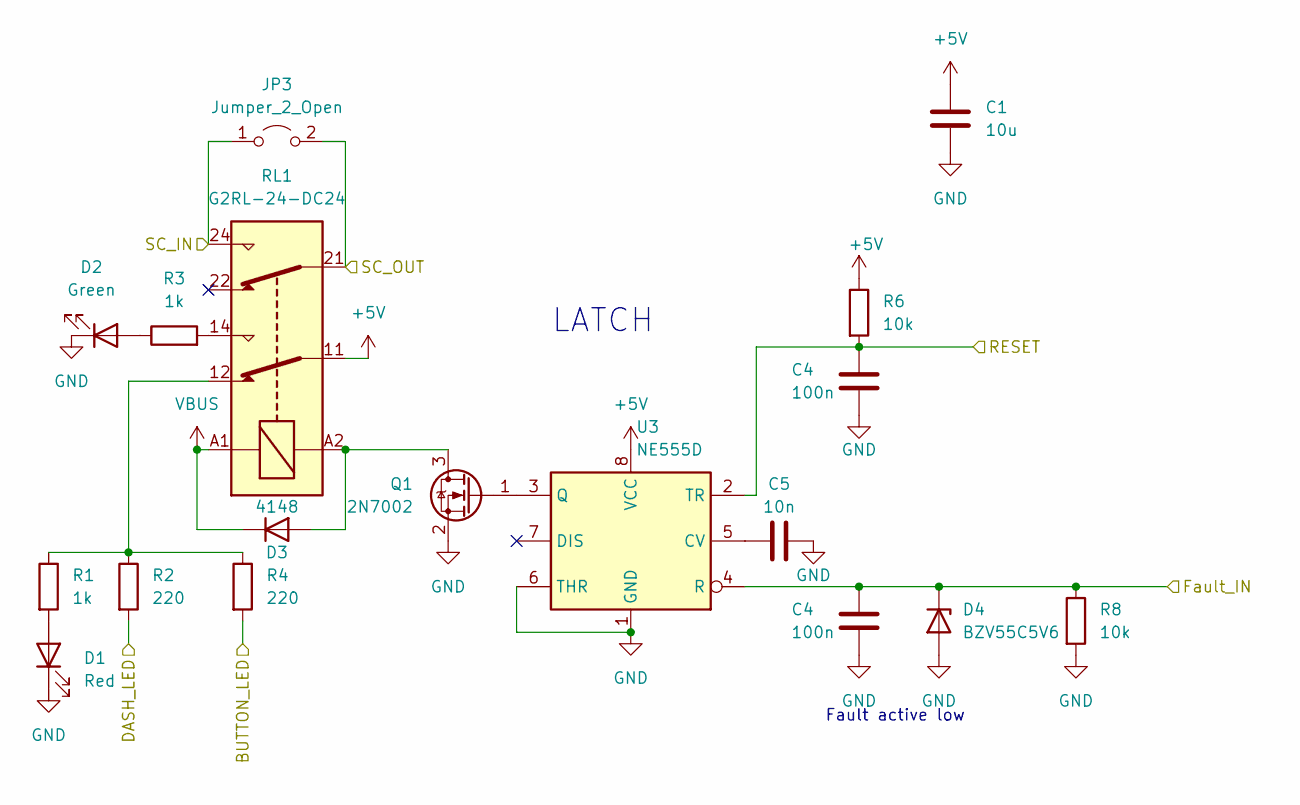
[picture p186: schematic Latch.kicad_sch]

Parts:
C1: 10u; C_0805_2012Metric
C4: 100n; C_0805_2012Metric
C5: 10n; C_0805_2012Metric
D1: Red; LED_0805_2012Metric
D2: Green; LED_0805_2012Metric
D3: 4148; D_SOD-123
D4: BZV55C5V6; D_SOD-123
JP3: Jumper_2_Open; Jumper_P2.54mm_D1.2mm
Q1: 2N7002; SOT-23
R1, R3: 1k; R_0805_2012Metric
R2, R4: 220; R_0805_2012Metric
R6, R8: 10k; R_0805_2012Metric
RL1: G2RL-24-DC24; Relay_DPDT_Omron_G2RL-2
U3: NE555D; SOIC-8_3.9x4.9mm_P1.27mm

Connections:
+5V: C1.1, R6.1, RL1.11, U3.8 (VCC)
BUTTON_LED: R4.2
DASH_LED: R2.2
Fault_IN: C4.1, D4.1 (K), R8.1, U3.4 (R)
GND: C1.2, C4.2, C5.2, D1.1 (K), D2.1 (K), D4.2 (A), Q1.2 (S), R8.2, U3.1 (GND), U3.6 (THR)
unnamed: C5.1, U3.5 (CV)
unnamed: D1.2 (A), R1.2
unnamed: D2.2 (A), R3.1
unnamed: D3.2 (A), Q1.3 (D), RL1.A2
unnamed: Q1.1 (G), U3.3 (Q)
unnamed: R1.1, R2.1, R4.1, RL1.12
unnamed: R3.2, RL1.14
RESET: C4.1, R6.2, U3.2 (TR)
SC_IN: JP3.1 (A), RL1.24
SC_OUT: JP3.2 (B), RL1.21
VBUS: D3.1 (K), RL1.A1

Notes on the sheet:
Fault active low
LATCH
