NTURacingTeam/nturt_kicad/EP5/Powertrain/HVBox/SC_Board/SC_Board.kicad_sch

## KiCad design EP5/Powertrain/HVBox/SC_Board/SC_Board.kicad_sch (2024-11-21)

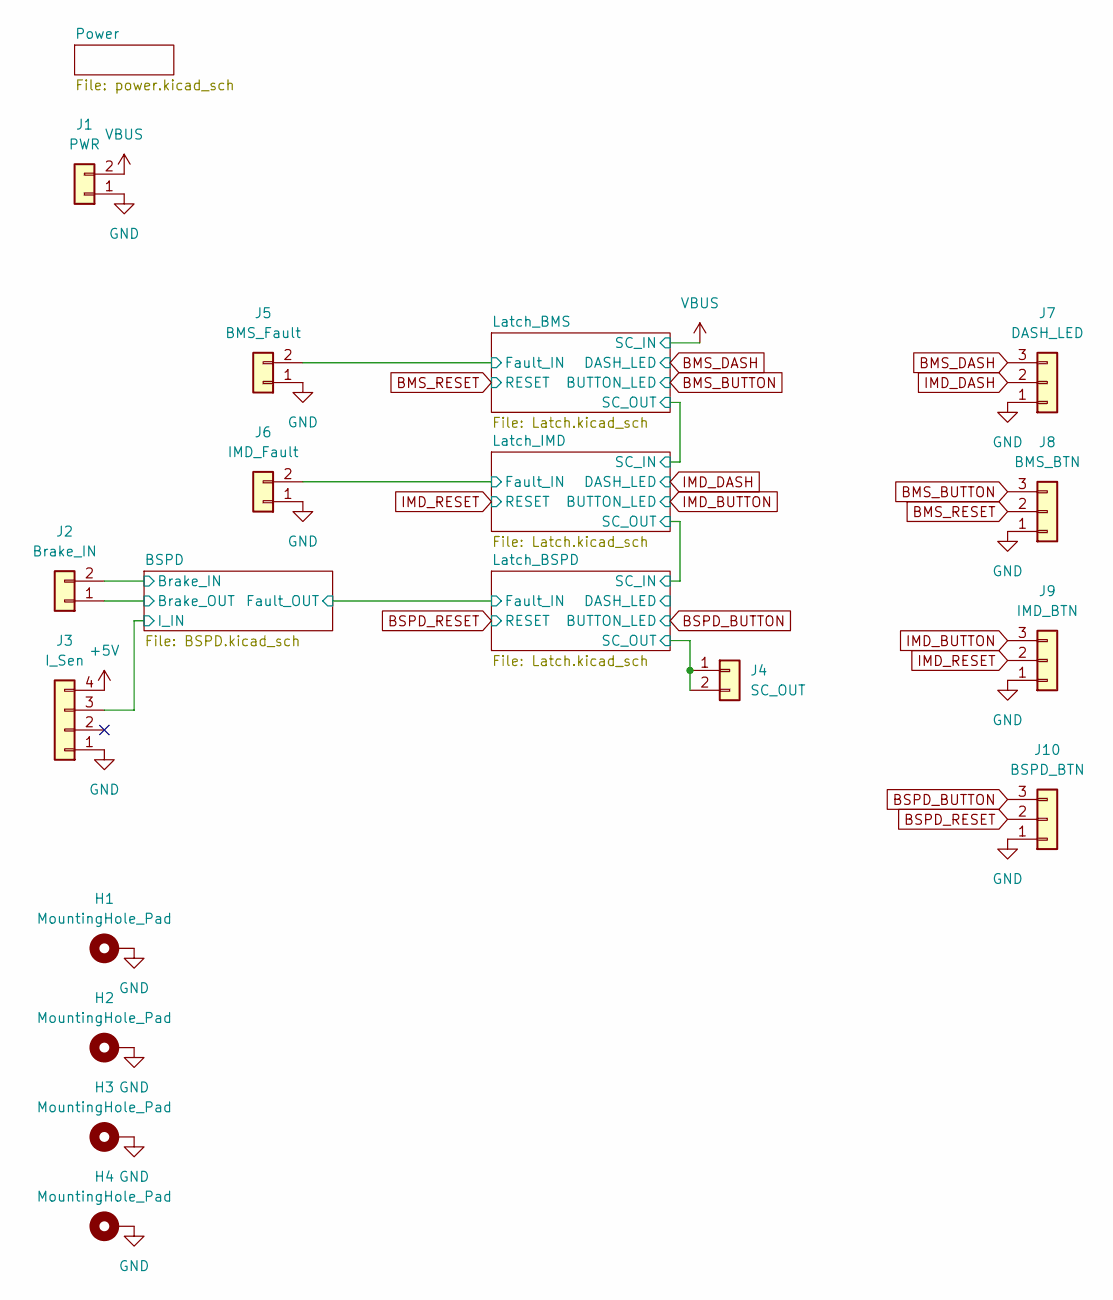
[picture p187: schematic SC_Board.kicad_sch]

Parts:
H1, H2, H3, H4: MountingHole_Pad; MountingHole_4.3mm_M4_DIN965_Pad_TopBottom
J1: PWR; JST_VH_B2P-VH-B_1x02_P3.96mm_Vertical
J2: Brake_IN; JST_XH_B2B-XH-A_1x02_P2.50mm_Vertical
J3: I_Sen; JST_XH_B4B-XH-A_1x04_P2.50mm_Vertical
J4: SC_OUT; JST_XH_B2B-XH-A_1x02_P2.50mm_Vertical
J5: BMS_Fault; JST_XH_B2B-XH-A_1x02_P2.50mm_Vertical
J6: IMD_Fault; JST_XH_B2B-XH-A_1x02_P2.50mm_Vertical
J7: DASH_LED; JST_XH_B3B-XH-A_1x03_P2.50mm_Vertical
J8: BMS_BTN; JST_XH_B3B-XH-A_1x03_P2.50mm_Vertical
J9: IMD_BTN; JST_XH_B3B-XH-A_1x03_P2.50mm_Vertical
J10: BSPD_BTN; JST_XH_B3B-XH-A_1x03_P2.50mm_Vertical

Connections:
+5V: J3.4
BMS_BUTTON: J8.3
BMS_DASH: J7.3
BMS_RESET: J8.2
BSPD_BUTTON: J10.3
BSPD_RESET: J10.2
Brake_IN: J2.2
Brake_OUT: J2.1
Fault_IN: J5.2, J6.2
GND: H1.1, H2.1, H3.1, H4.1, J1.1, J3.1, J5.1, J6.1, J7.1, J8.1, J9.1, J10.1
IMD_BUTTON: J9.3
IMD_DASH: J7.2
IMD_RESET: J9.2
I_IN: J3.3
SC_OUT: J4.1, J4.2
VBUS: J1.2
