NTURacingTeam/nturt_kicad/EP5/Powertrain/HVBox/SC_Board/power.kicad_sch

## KiCad design EP5/Powertrain/HVBox/SC_Board/power.kicad_sch (2024-11-21)

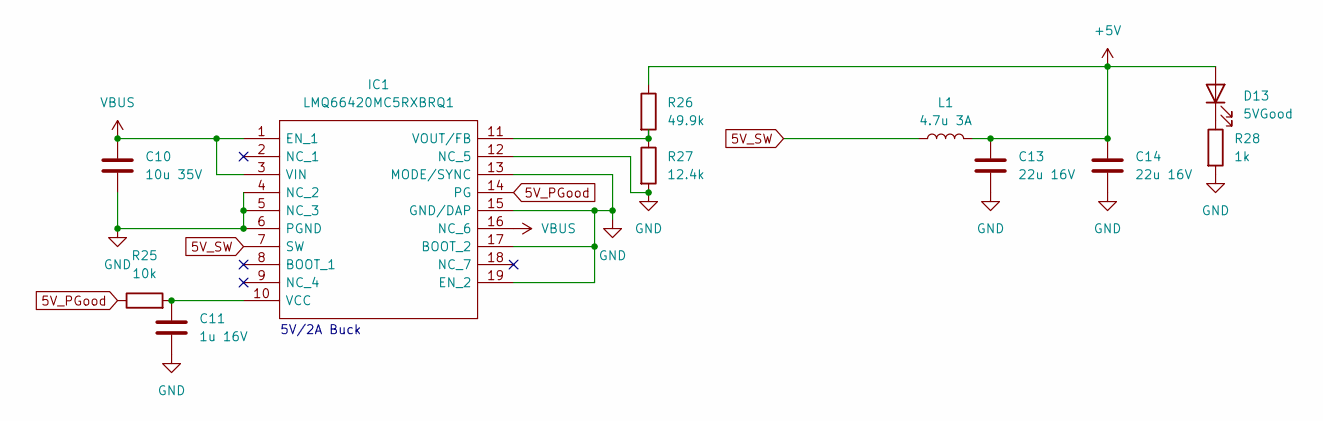
[picture p188: schematic power.kicad_sch]

Parts:
C10: 10u 35V; C_0805_2012Metric
C11: 1u 16V; C_0805_2012Metric
C13, C14: 22u 16V; C_0805_2012Metric
D13: 5VGood; LED_0805_2012Metric
IC1: LMQ66420MC5RXBRQ1; LMQ66430R5RXBR; Manufacturer_Part_Number LMQ66420MC5RXBRQ1
L1: 4.7u 3A; INDPM5552X300N
R25: 10k; R_0805_2012Metric
R26: 49.9k; R_0805_2012Metric
R27: 12.4k; R_0805_2012Metric
R28: 1k; R_0805_2012Metric

Connections:
5V_PGood: IC1.14 (PG), R25.1
5V_SW: IC1.7 (SW), L1.1
+5V: C13.1, C14.1, D13.2 (A), L1.2, R26.1
GND: C10.2, C11.2, C13.2, C14.2, IC1.4 (NC_2), IC1.5 (NC_3), IC1.6 (PGND), IC1.12 (NC_5), IC1.13 (MODE/SYNC), IC1.15 (GND/DAP), IC1.17 (BOOT_2), IC1.19 (EN_2), R27.2, R28.2
unnamed: C11.1, IC1.10 (VCC), R25.2
unnamed: D13.1 (K), R28.1
unnamed: IC1.11 (VOUT/FB), R26.2, R27.1
VBUS: C10.1, IC1.1 (EN_1), IC1.3 (VIN), IC1.16 (NC_6)

Notes on the sheet:
5V/2A Buck
