NTURacingTeam/nturt_kicad/EP5/Powertrain/HVBox/TSAL_LED_V1_20230913/TSAL_LED_V1_20230913.kicad_sch

## KiCad design EP5/Powertrain/HVBox/TSAL_LED_V1_20230913/TSAL_LED_V1_20230913.kicad_sch (2024-11-21)

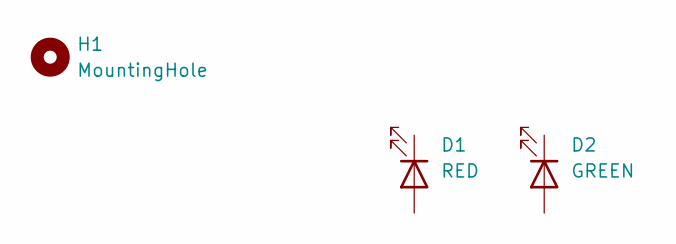
[picture p189: schematic TSAL_LED_V1_20230913.kicad_sch]

Parts:
D1: RED; LED_1W_3W_R8
D2: GREEN; LED_1W_3W_R8
H1: MountingHole; MountingHole_6.4mm_M6_DIN965
