NTURacingTeam/nturt_kicad/EP5/Powertrain/HVBox/TSAL_V1_20230911/TSAL_V1_20230911.kicad_sch

## KiCad design EP5/Powertrain/HVBox/TSAL_V1_20230911/TSAL_V1_20230911.kicad_sch (2024-11-21)

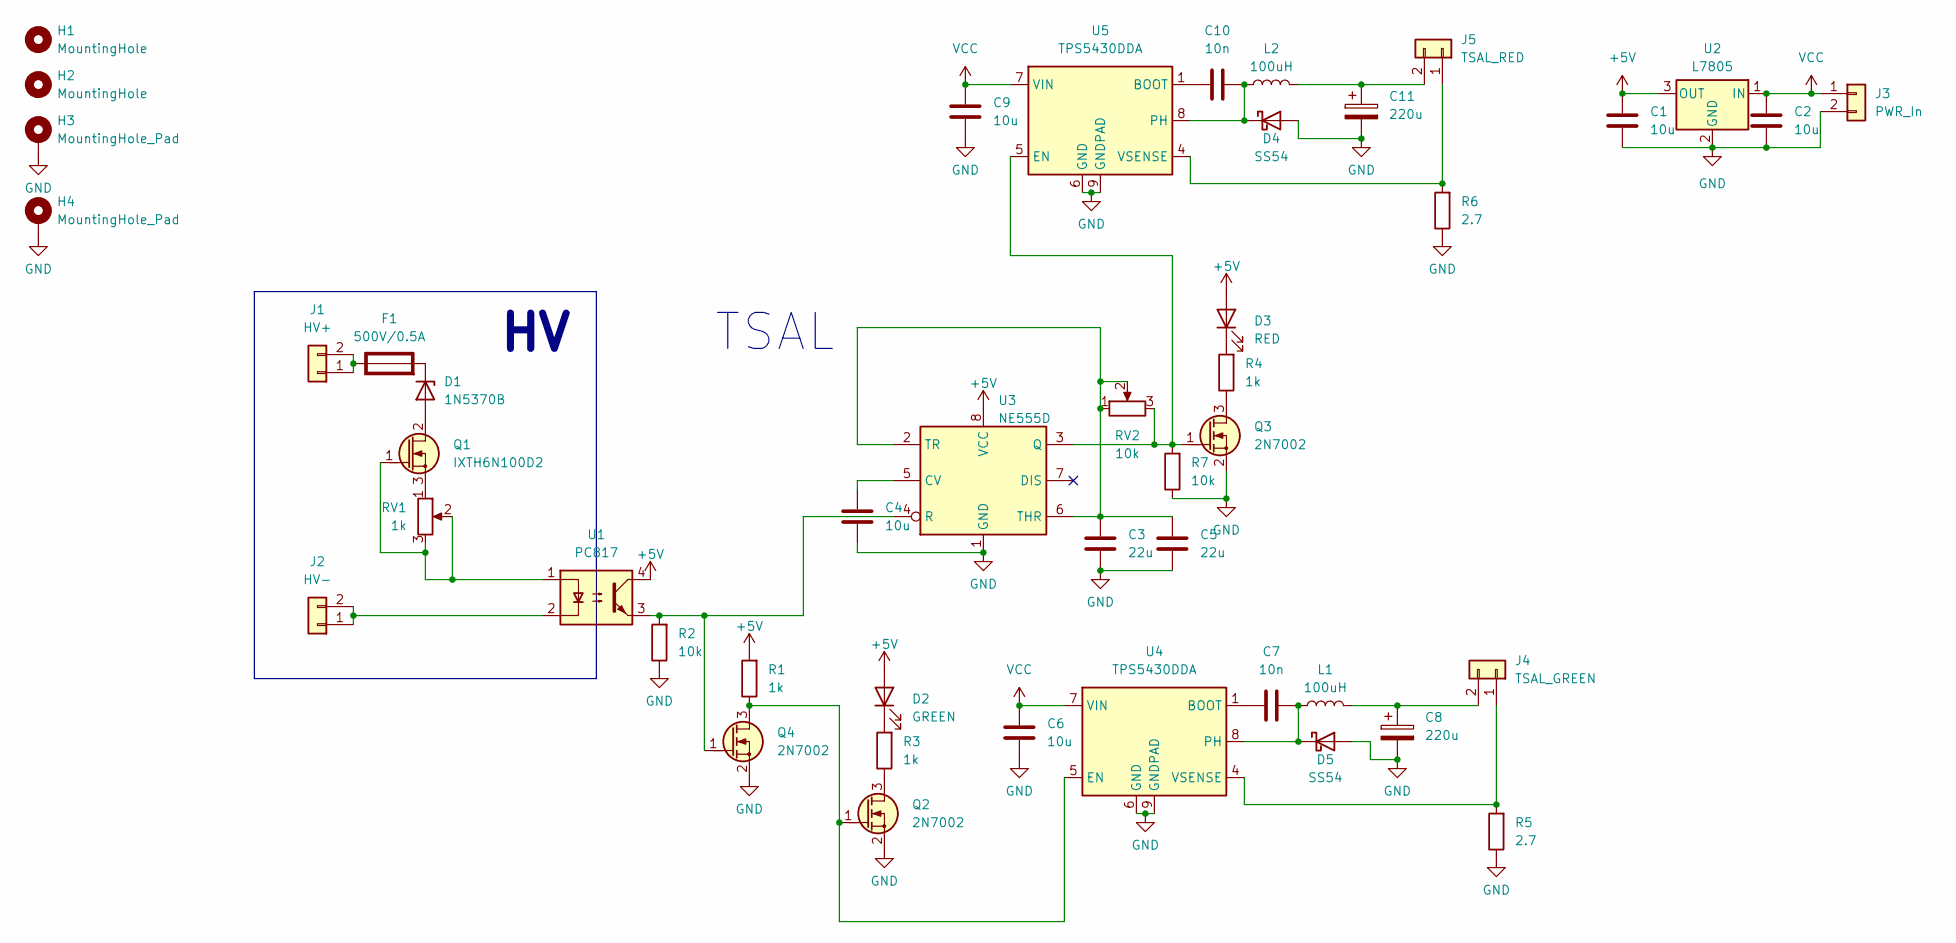
[picture p190: schematic TSAL_V1_20230911.kicad_sch]

Parts:
C1, C2, C4, C6, C9: 10u; C_0805_2012Metric_Pad1.18x1.45mm_HandSolder
C3, C5: 22u; C_0805_2012Metric_Pad1.18x1.45mm_HandSolder
C7, C10: 10n; C_0805_2012Metric_Pad1.18x1.45mm_HandSolder
C8, C11: 220u; CP_Elec_8x10.5
D1: 1N5370B; D_P600_R-6_P15.24mm_Horizontal_Zener
D2: GREEN; LED_0805_2012Metric
D3: RED; LED_0805_2012Metric
D4, D5: SS54; D_SMA
F1: 500V/0.5A; 65600001009; Rating W
H1, H2: MountingHole; MountingHole_4.3mm_M4_DIN965
H3, H4: MountingHole_Pad; MountingHole_4.3mm_M4_DIN965_Pad_TopBottom
J1: HV+; DF33C2P33DSA24
J2: HV-; DF33C2P33DSA24
J3: PWR_In; JST_XH_B2B-XH-A_1x02_P2.50mm_Vertical
J4: TSAL_GREEN; JST_XH_B2B-XH-A_1x02_P2.50mm_Vertical
J5: TSAL_RED; JST_XH_B2B-XH-A_1x02_P2.50mm_Vertical
L1, L2: 100uH; L_Sunlord_MWSA1206S-101
Q1: IXTH6N100D2; TO-247-3_Vertical
Q2, Q3, Q4: 2N7002; SOT-23
R1, R3, R4: 1k; R_0805_2012Metric_Pad1.20x1.40mm_HandSolder
R2, R7: 10k; R_0805_2012Metric_Pad1.20x1.40mm_HandSolder
R5, R6: 2.7; R_2512_6332Metric
RV1: 1k; Potentiometer_Bourns_3386C_Horizontal
RV2: 10k; Potentiometer_Bourns_3386C_Horizontal
U1: PC817; SOP-4_3.8x4.1mm_P2.54mm
U2: L7805; TO-252-2
U3: NE555D; SOIC-8_3.9x4.9mm_P1.27mm
U4, U5: TPS5430DDA; TI_SO-PowerPAD-8_ThermalVias

Connections:
+5V: C1.1, D2.2 (A), D3.2 (A), R1.2, U1.4, U2.3 (OUT), U3.8 (VCC)
GND: C1.2, C2.2, C3.2, C4.2, C5.2, C6.2, C8.2, C9.2, C11.2, D4.2 (A), D5.2 (A), H3.1, H4.1, J3.2, Q2.2 (S), Q3.2 (S), Q4.2 (S), R2.1, R5.1, R6.1, R7.1, U2.2 (GND), U3.1 (GND), U4.6 (GND), U4.9 (GNDPAD), U5.6 (GND), U5.9 (GNDPAD)
unnamed: C3.1, C5.1, RV2.1, RV2.2, U3.2 (TR), U3.6 (THR)
unnamed: C4.1, U3.5 (CV)
unnamed: C7.1, U4.1 (BOOT)
unnamed: C7.2, D5.1 (K), L1.1, U4.8 (PH)
unnamed: C8.1, J4.2, L1.2
unnamed: C10.1, U5.1 (BOOT)
unnamed: C10.2, D4.1 (K), L2.1, U5.8 (PH)
unnamed: C11.1, J5.2, L2.2
unnamed: D1.1 (K), F1.2 (-)
unnamed: D1.2 (A), Q1.2 (D)
unnamed: D2.1 (K), R3.2
unnamed: D3.1 (K), R4.2
unnamed: F1.1 (+), J1.1, J1.2
unnamed: J2.1, J2.2, U1.2
unnamed: J4.1, R5.2, U4.4 (VSENSE)
unnamed: J5.1, R6.2, U5.4 (VSENSE)
unnamed: Q1.1 (G), RV1.2, RV1.3, U1.1
unnamed: Q1.3 (S), RV1.1
unnamed: Q2.1 (G), Q4.3 (D), R1.1, U4.5 (EN)
unnamed: Q2.3 (D), R3.1
unnamed: Q3.1 (G), R7.2, RV2.3, U3.3 (Q), U5.5 (EN)
unnamed: Q3.3 (D), R4.1
unnamed: Q4.1 (G), R2.2, U1.3, U3.4 (R)
VCC: C2.1, C6.1, C9.1, J3.1, U2.1 (IN), U4.7 (VIN), U5.7 (VIN)

Notes on the sheet:
TSAL
