NTURacingTeam/nturt_kicad/EP5/Powertrain/HVBox/TSMP_V1_20230911/TSMP_V1_20230911.kicad_sch

## KiCad design EP5/Powertrain/HVBox/TSMP_V1_20230911/TSMP_V1_20230911.kicad_sch (2024-11-21)

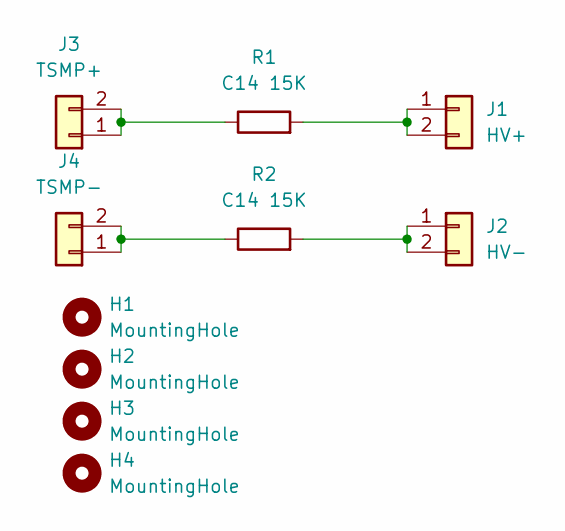
[picture p191: schematic TSMP_V1_20230911.kicad_sch]

Parts:
H1, H2, H3, H4: MountingHole; MountingHole_4.3mm_M4_DIN965
J1: HV+; DF33C2P33DSA24
J2: HV-; DF33C2P33DSA24
J3: TSMP+; DF33C2P33DSA24
J4: TSMP-; DF33C2P33DSA24
R1, R2: C14 15K; R_Axial_Power_L60.0mm_W14.0mm_P71.12mm

Connections:
unnamed: J1.1, J1.2, R1.2
unnamed: J2.1, J2.2, R2.2
unnamed: J3.1, J3.2, R1.1
unnamed: J4.1, J4.2, R2.1
