NTURacingTeam/nturt_kicad/EP5/Powertrain/Inverter/InverterConnectorBoard/InverterConnectorBoard.kicad_sch

## KiCad design EP5/Powertrain/Inverter/InverterConnectorBoard/InverterConnectorBoard.kicad_sch (2024-11-21)

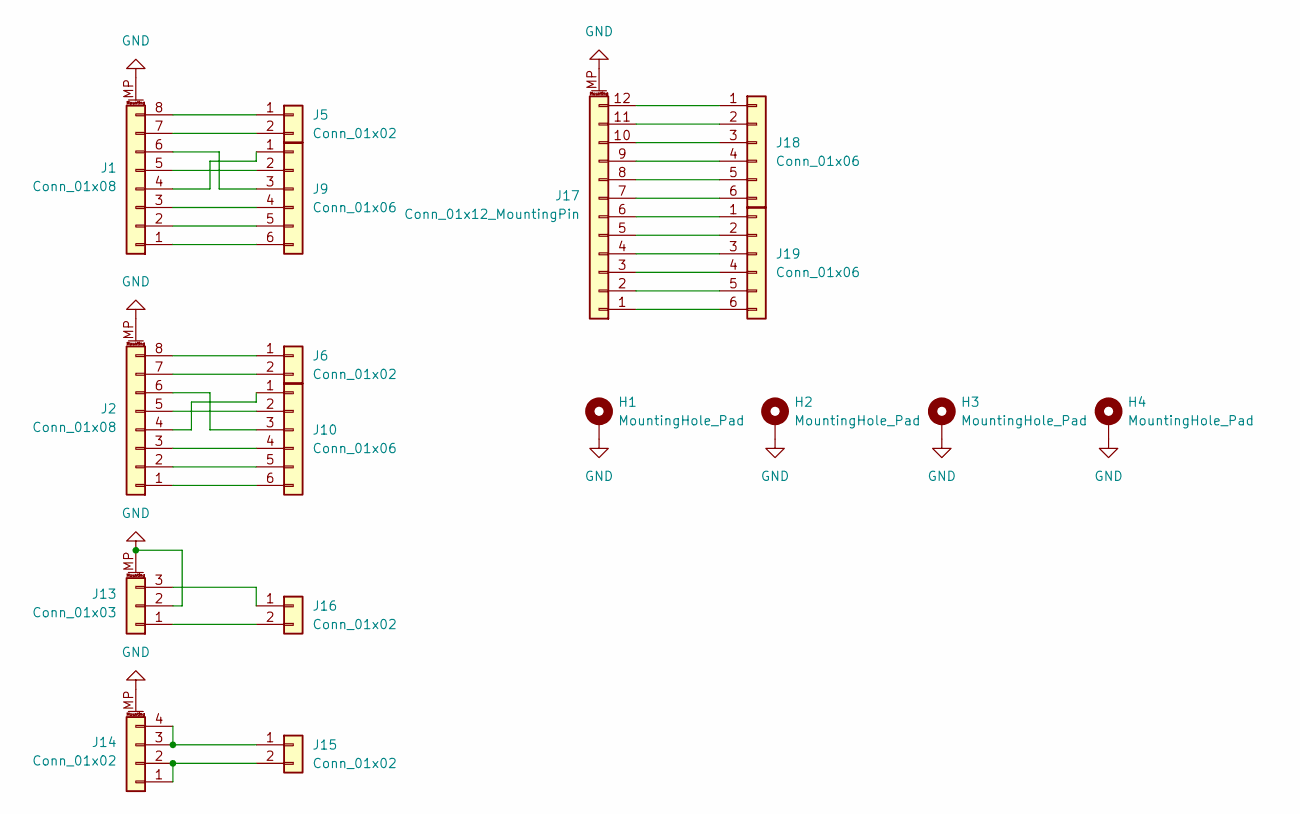
[picture p192: schematic InverterConnectorBoard.kicad_sch]

Parts:
H1, H2, H3, H4: MountingHole_Pad; MountingHole_4.3mm_M4_DIN965_Pad_TopBottom
J1, J2: Conn_01x08; M8 8P w Ground
J5, J6, J15, J16: Conn_01x02; JST_XH_B2B-XH-A_1x02_P2.50mm_Vertical
J9, J10, J18, J19: Conn_01x06; JST_XH_B6B-XH-A_1x06_P2.50mm_Vertical
J13: Conn_01x03; M8 3P w Ground
J14: Conn_01x02; M8 2P 4P w Ground
J17: Conn_01x12_MountingPin; M12 12P w Ground

Connections:
GND: H1.1, H2.1, H3.1, H4.1, J1.MP (MountPin), J2.MP (MountPin), J13.2, J13.MP (MountPin), J14.MP (MountPin), J17.MP (MountPin)
unnamed: J1.1, J9.6
unnamed: J1.2, J9.5
unnamed: J1.3, J9.4
unnamed: J1.4, J9.1
unnamed: J1.5, J9.2
unnamed: J1.6, J9.3
unnamed: J1.7, J5.2
unnamed: J1.8, J5.1
unnamed: J2.7, J6.2
unnamed: J2.8, J6.1
unnamed: J2.4, J10.1
unnamed: J2.5, J10.2
unnamed: J2.6, J10.3
unnamed: J2.3, J10.4
unnamed: J2.2, J10.5
unnamed: J2.1, J10.6
unnamed: J13.1, J16.2
unnamed: J13.3, J16.1
unnamed: J14.1, J14.2, J15.2
unnamed: J14.3, J14.4, J15.1
unnamed: J17.1, J19.6
unnamed: J17.2, J19.5
unnamed: J17.3, J19.4
unnamed: J17.4, J19.3
unnamed: J17.5, J19.2
unnamed: J17.6, J19.1
unnamed: J17.7, J18.6
unnamed: J17.8, J18.5
unnamed: J17.9, J18.4
unnamed: J17.10, J18.3
unnamed: J17.11, J18.2
unnamed: J17.12, J18.1
