NTURacingTeam/nturt_kicad/EP5/Powertrain/Inverter/InverterDCLinkCapBoard/InverterDCLinkCapBoard.kicad_sch

## KiCad design EP5/Powertrain/Inverter/InverterDCLinkCapBoard/InverterDCLinkCapBoard.kicad_sch (2024-11-21)

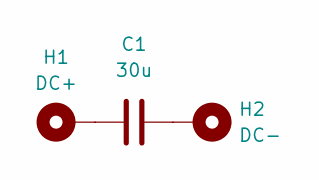
[picture p193: schematic InverterDCLinkCapBoard.kicad_sch]

Parts:
C1: 30u; C4AQ-M_WJ
H1: DC+; MountingHole_5.5mm_Pad_Via
H2: DC-; MountingHole_5.5mm_Pad_Via

Connections:
unnamed: C1.1, H1.1
unnamed: C1.2, H2.1
