NTURacingTeam/nturt_kicad/EP5/Powertrain/Inverter/InverterGateDriverBoard/InverterGateDriverBoard.kicad_sch

## KiCad design EP5/Powertrain/Inverter/InverterGateDriverBoard/InverterGateDriverBoard.kicad_sch (2024-11-21)

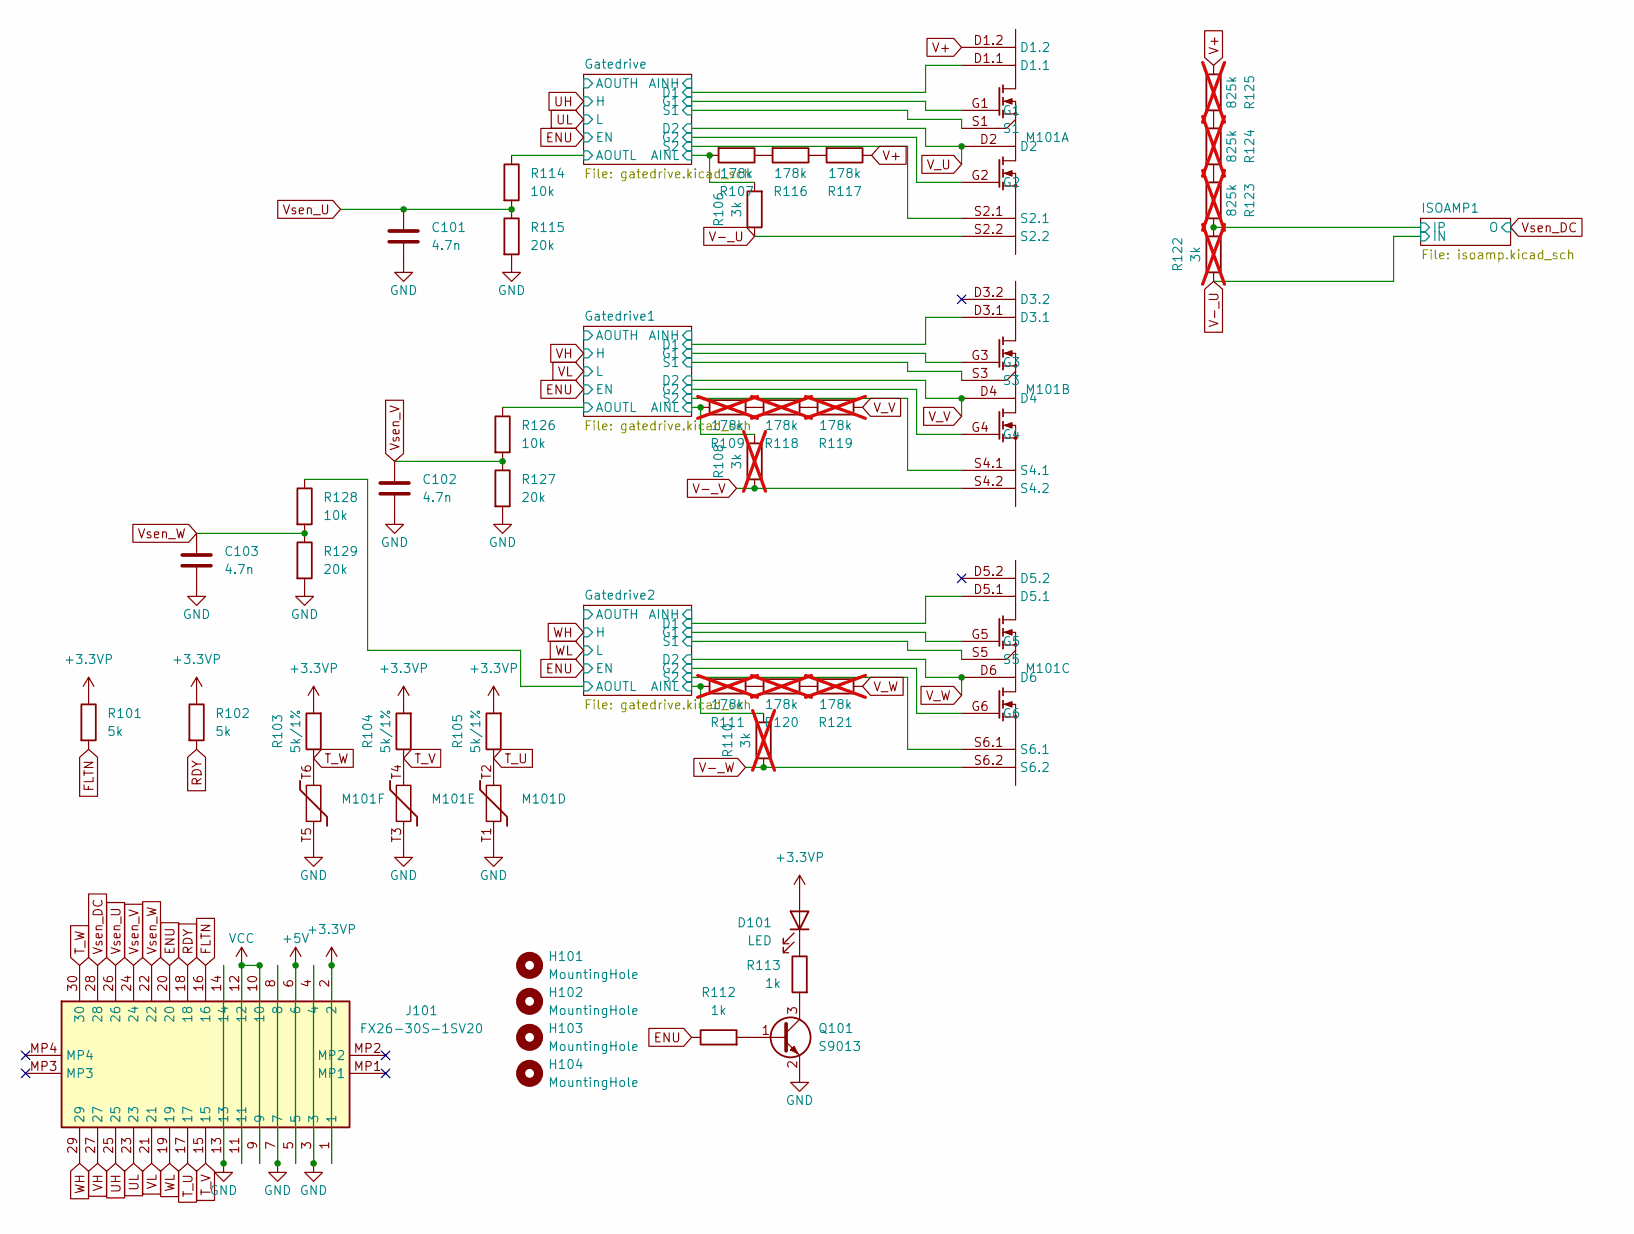
[picture p194: schematic InverterGateDriverBoard.kicad_sch]

Parts:
C101, C102, C103: 4.7n; C_0603_1608Metric
D101: LED; LED_0603_1608Metric
H101, H102, H103, H104: MountingHole; MountingHole_4mm
J101: FX26-30S-1SV20; FX2630S1SV20; Mouser Part Number 798-FX2630S1SV20
M101: InverterSiCModule
Q101: S9013; SOT-23-3
R101, R102: 5k; R_0603_1608Metric
R103, R104, R105: 5k/1%; R_0603_1608Metric
R106: 3k; R_1206_3216Metric
R107, R116, R117: 178k; R_1206_3216Metric
R108, R110, R122: 3k; R_1206_3216Metric; not fitted
R109, R111, R118, R119, R120, R121: 178k; R_1206_3216Metric; not fitted
R112, R113: 1k; R_0603_1608Metric
R114, R126, R128: 10k; R_0603_1608Metric
R115, R127, R129: 20k; R_0603_1608Metric
R123, R124, R125: 825k; R_1206_3216Metric; not fitted

Connections:
+3.3VP: D101.2 (A), J101.1, J101.2, R101.1, R102.1, R103.2, R104.2, R105.2
+5V: J101.5, J101.6
AINL: R106.2, R107.2, R108.2, R109.2, R110.2, R111.2
AOUTL: R114.1, R126.1, R128.1
D1: M101.D1.1, M101.D3.1, M101.D5.1
ENU: J101.20, R112.1
FLTN: J101.16, R101.2
G1: M101.G1, M101.G3, M101.G5
G2: M101.G2, M101.G4, M101.G6
GND: C101.1, C102.1, C103.1, J101.3, J101.4, J101.7, J101.8, J101.13, J101.14, M101.T1, M101.T3, M101.T5, Q101.2 (E), R115.2, R127.2, R129.2
IP: R122.2, R123.2
unnamed: D101.1 (K), R113.1
unnamed: Q101.1 (B), R112.2
unnamed: Q101.3 (C), R113.2
unnamed: R107.1, R116.2
unnamed: R109.1, R118.2
unnamed: R111.1, R120.2
unnamed: R116.1, R117.2
unnamed: R118.1, R119.2
unnamed: R120.1, R121.2
unnamed: R123.1, R124.2
unnamed: R124.1, R125.2
RDY: J101.18, R102.2
S1: M101.S1, M101.S3, M101.S5
S2: M101.S2.1, M101.S4.1, M101.S6.1
T_U: J101.17, M101.T2, R105.1
T_V: J101.15, M101.T4, R104.1
T_W: J101.30, M101.T6, R103.1
UH: J101.25
UL: J101.23
V+: M101.D1.2, R117.1, R125.1
V-_U: M101.S2.2, R106.1, R122.1
V-_V: M101.S4.2, R108.1
V-_W: M101.S6.2, R110.1
VCC: J101.9, J101.10, J101.11, J101.12
VH: J101.27
VL: J101.21
V_U: M101.D2
V_V: M101.D4, R119.1
V_W: M101.D6, R121.1
Vsen_DC: J101.28
Vsen_U: C101.2, J101.26, R114.2, R115.1
Vsen_V: C102.2, J101.24, R126.2, R127.1
Vsen_W: C103.2, J101.22, R128.2, R129.1
WH: J101.29
WL: J101.19
