NTURacingTeam/nturt_kicad/EP5/Powertrain/Inverter/InverterGateDriverBoard/gatedrive.kicad_sch

## KiCad design EP5/Powertrain/Inverter/InverterGateDriverBoard/gatedrive.kicad_sch (2024-11-21)

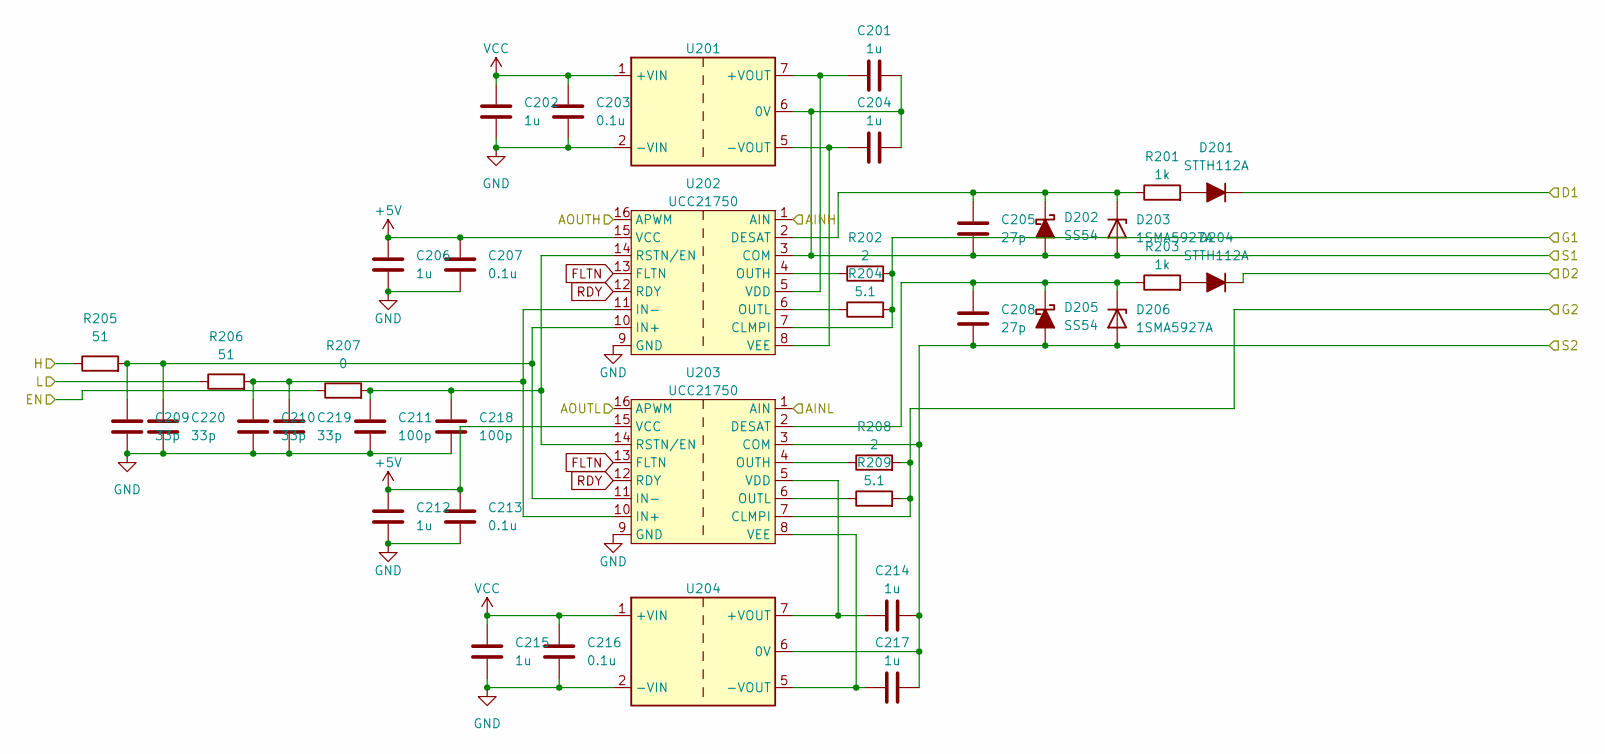
[picture p195: schematic gatedrive.kicad_sch]

Parts:
C201, C214: 1u; C_1206_3216Metric
C202, C204, C206, C212, C215, C217: 1u; C_0603_1608Metric
C203, C207, C213, C216: 0.1u; C_0603_1608Metric
C205, C208: 27p; C_0603_1608Metric
C209, C210, C219, C220: 33p; C_0603_1608Metric
C211, C218: 100p; C_0603_1608Metric
D201, D204: STTH112A; D_SMA
D202, D205: SS54; D_SMA
D203, D206: 1SMA5927A; D_SMA
R201, R203: 1k; R_1206_3216Metric
R202, R208: 2; R_2512_6332Metric
R204, R209: 5.1; R_2512_6332Metric
R205, R206: 51; R_0603_1608Metric
R207: 0; R_0603_1608Metric
U201, U204: Converter_DCDC_Murata_MGJ2DxxxxxxSC_THT
U202, U203: UCC21750; SOIC-16W_7.5x10.3mm_P1.27mm

Connections:
+5V: C206.2, C207.2, C212.2, C213.2, U202.15 (VCC), U203.15 (VCC)
AINH: U202.1 (AIN)
AINL: U203.1 (AIN)
AOUTH: U202.16 (APWM)
AOUTL: U203.16 (APWM)
D1: D201.1 (K)
D2: D204.1 (K)
EN: R207.1
FLTN: U202.13 (FLTN), U203.13 (FLTN)
G1: R202.2, R204.2, U202.7 (CLMPI)
G2: R208.2, R209.2, U203.7 (CLMPI)
GND: C202.1, C203.1, C206.1, C207.1, C209.1, C210.1, C211.1, C212.1, C213.1, C215.1, C216.1, C218.1, C219.1, C220.1, U201.2 (-VIN), U202.9 (GND), U203.9 (GND), U204.2 (-VIN)
H: R205.1
L: R206.1
unnamed: C201.2, U201.7 (+VOUT), U202.5 (VDD)
unnamed: C204.2, U201.5 (-VOUT), U202.8 (VEE)
unnamed: C205.2, D202.1 (K), D203.1 (K), R201.1, U202.2 (DESAT)
unnamed: C208.2, D205.1 (K), D206.1 (K), R203.1, U203.2 (DESAT)
unnamed: C209.2, C220.2, R205.2, U202.10 (IN+), U203.11 (IN-)
unnamed: C210.2, C219.2, R206.2, U202.11 (IN-), U203.10 (IN+)
unnamed: C211.2, C218.2, R207.2, U202.14 (RSTN/EN), U203.14 (RSTN/EN)
unnamed: C214.2, U203.5 (VDD), U204.7 (+VOUT)
unnamed: C217.1, U203.8 (VEE), U204.5 (-VOUT)
unnamed: D201.2 (A), R201.2
unnamed: D204.2 (A), R203.2
unnamed: R202.1, U202.4 (OUTH)
unnamed: R204.1, U202.6 (OUTL)
unnamed: R208.1, U203.4 (OUTH)
unnamed: R209.1, U203.6 (OUTL)
RDY: U202.12 (RDY), U203.12 (RDY)
S1: C201.1, C204.1, C205.1, D202.2 (A), D203.2 (A), U201.6 (0V), U202.3 (COM)
S2: C208.1, C214.1, C217.2, D205.2 (A), D206.2 (A), U203.3 (COM), U204.6 (0V)
VCC: C202.2, C203.2, C215.2, C216.2, U201.1 (+VIN), U204.1 (+VIN)
