NTURacingTeam/nturt_kicad/EP5/Powertrain/Inverter/InverterGateDriverBoard/isoamp.kicad_sch

## KiCad design EP5/Powertrain/Inverter/InverterGateDriverBoard/isoamp.kicad_sch (2024-11-21)

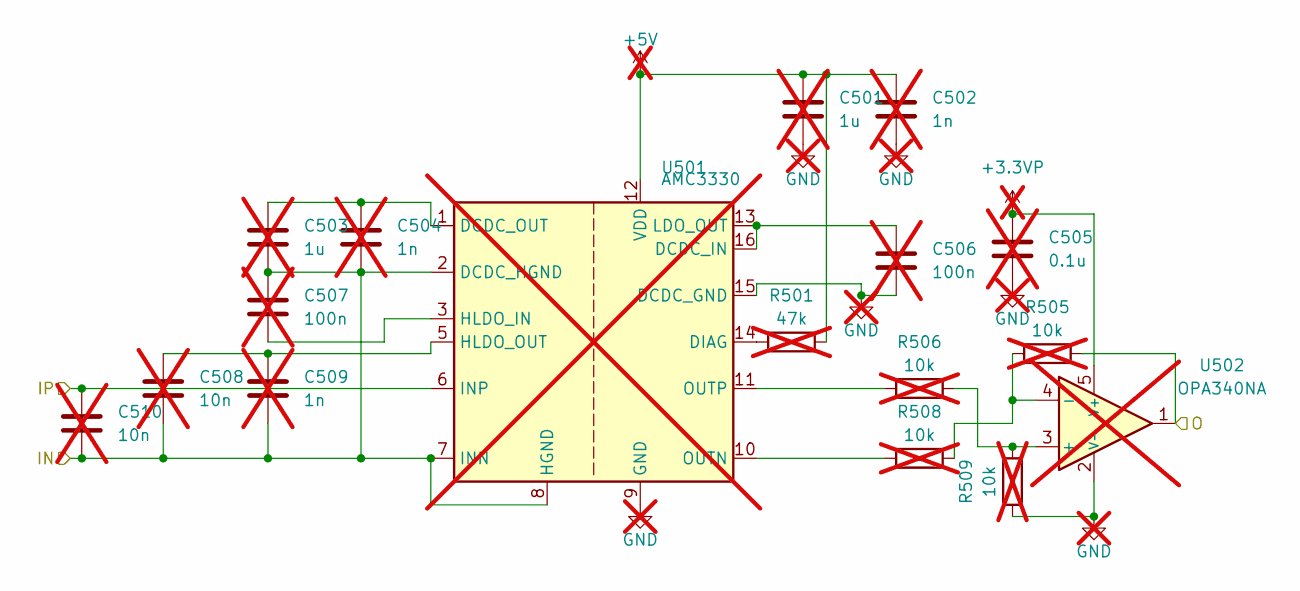
[picture p196: schematic isoamp.kicad_sch]

Parts:
C501: 1u; C_1206_3216Metric; not fitted
C502, C509: 1n; C_1206_3216Metric; not fitted
C503: 1u; C_0603_1608Metric; not fitted
C504: 1n; C_0603_1608Metric; not fitted
C505: 0.1u; C_0603_1608Metric; not fitted
C506, C507: 100n; C_0603_1608Metric; not fitted
C508: 10n; C_1206_3216Metric; not fitted
C510: 10n; C_0603_1608Metric; not fitted
R501: 47k; R_0603_1608Metric; not fitted
R505, R506, R508, R509: 10k; R_0603_1608Metric; not fitted
U501: AMC3330; SOIC-16W_7.5x10.3mm_P1.27mm; not fitted
U502: OPA340NA; SOT-23-5; not fitted

Connections:
+3.3VP: C505.2, U502.5 (V+)
+5V: C501.2, C502.2, R501.2, U501.12 (VDD)
GND: C501.1, C502.1, C505.1, C506.1, R509.1, U501.9 (GND), U501.15 (DCDC_GND), U502.2 (V-)
IN: C503.1, C504.1, C507.2, C508.1, C509.1, C510.1, U501.2 (DCDC_HGND), U501.7 (INN), U501.8 (HGND)
IP: C510.2, U501.6 (INP)
unnamed: C503.2, C504.2, U501.1 (DCDC_OUT)
unnamed: C506.2, U501.13 (LDO_OUT), U501.16 (DCDC_IN)
unnamed: C507.1, U501.3 (HLDO_IN)
unnamed: C508.2, C509.2, U501.5 (HLDO_OUT)
unnamed: R501.1, U501.14 (DIAG)
unnamed: R505.1, R508.2, U502.4 (-)
unnamed: R506.1, U501.11 (OUTP)
unnamed: R506.2, R509.2, U502.3 (+)
unnamed: R508.1, U501.10 (OUTN)
O: R505.2, U502.1
