NTURacingTeam/nturt_kicad/EP5/Powertrain/Inverter/InverterGateDriverBoard/powerstage.kicad_sch

## KiCad design EP5/Powertrain/Inverter/InverterGateDriverBoard/powerstage.kicad_sch (2024-11-21)

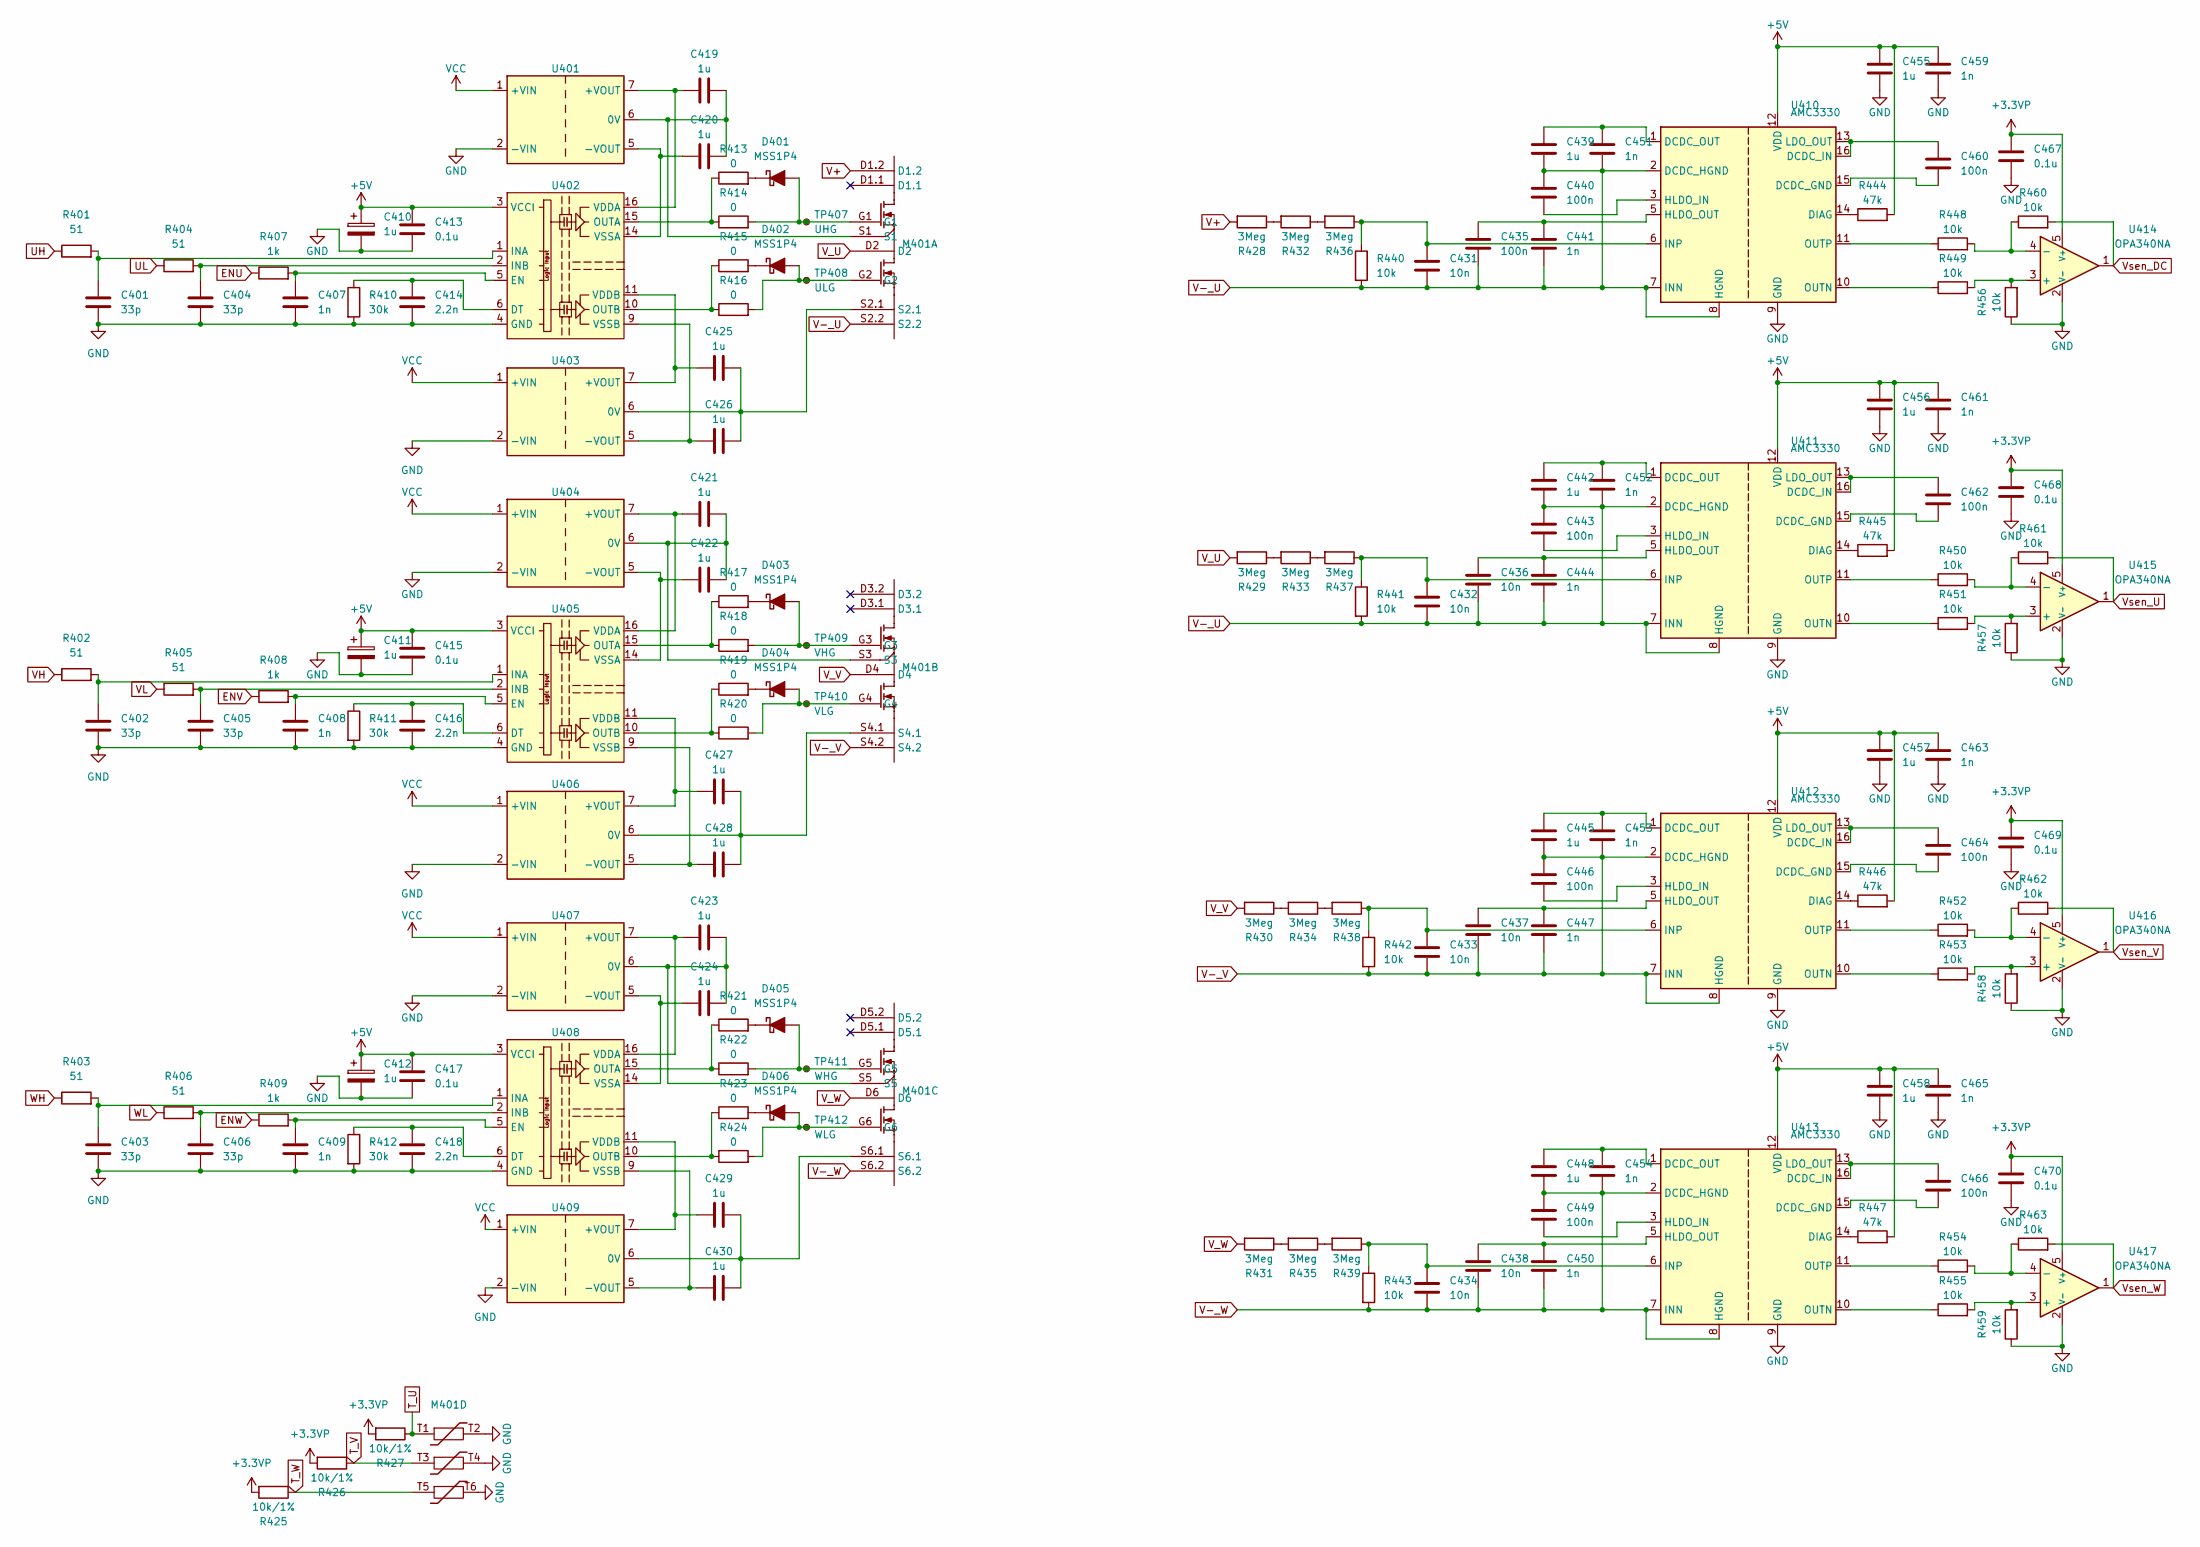
[picture p197: schematic powerstage.kicad_sch]

Parts:
C401, C402, C403, C404, C405, C406: 33p; C_0603_1608Metric
C407, C408, C409, C441, C444, C447, C450, C451, C452, C453, C454, C459, C461, C463, C465: 1n; C_0603_1608Metric
C410, C411, C412, C419, C420, C421, C422, C423, C424, C425, C426, C427, C428, C429, C430, C439, C442, C445, C448, C455, C456, C457, C458: 1u; C_0603_1608Metric
C413, C415, C417, C467, C468, C469, C470: 0.1u; C_0603_1608Metric
C414, C416, C418: 2.2n; C_0603_1608Metric
C431, C432, C433, C434, C436, C437, C438: 10n; C_0603_1608Metric
C435, C440, C443, C446, C449, C460, C462, C464, C466: 100n; C_0603_1608Metric
D401, D402, D403, D404, D405, D406: MSS1P4; D_MicroSMP_AK
M401: InverterSiCModule
R401, R402, R403, R404, R405, R406: 51; R_0603_1608Metric
R407, R408, R409: 1k; R_0603_1608Metric
R410, R411, R412: 30k; R_0603_1608Metric
R413, R414, R415, R416, R417, R418, R419, R420, R421, R422, R423, R424: 0; R_0603_1608Metric
R425, R426, R427: 10k/1%; R_0603_1608Metric
R428, R429, R430, R431, R432, R433, R434, R435, R436, R437, R438, R439: 3Meg; R_2512_6332Metric
R440, R441, R442, R443: 10k; R_2512_6332Metric
R444, R445, R446, R447: 47k; R_0603_1608Metric
R448, R449, R450, R451, R452, R453, R454, R455, R456, R457, R458, R459, R460, R461, R462, R463: 10k; R_0603_1608Metric
TP407: UHG; TestPoint_Loop_D1.80mm_Drill1.0mm_Beaded
TP408: ULG; TestPoint_Loop_D1.80mm_Drill1.0mm_Beaded
TP409: VHG; TestPoint_Loop_D1.80mm_Drill1.0mm_Beaded
TP410: VLG; TestPoint_Loop_D1.80mm_Drill1.0mm_Beaded
TP411: WHG; TestPoint_Loop_D1.80mm_Drill1.0mm_Beaded
TP412: WLG; TestPoint_Loop_D1.80mm_Drill1.0mm_Beaded
U401, U403, U404, U406, U407, U409: Converter_DCDC_Murata_MGJ2DxxxxxxSC_THT
U402, U405, U408: SOIC-16W_7.5x10.3mm_P1.27mm
U410, U411, U412, U413: AMC3330; SOIC-16W_7.5x10.3mm_P1.27mm
U414, U415, U416, U417: OPA340NA; SOT-23-5

Connections:
+3.3VP: C467.2, C468.2, C469.2, C470.2, R425.2, R426.2, R427.2, U414.5 (V+), U415.5 (V+), U416.5 (V+), U417.5 (V+)
+5V: C410.1, C411.1, C412.1, C413.2, C415.2, C417.2, C455.2, C456.2, C457.2, C458.2, C459.2, C461.2, C463.2, C465.2, R444.2, R445.2, R446.2, R447.2, U402.3 (VCCI), U402.8 (VCCI), U405.3 (VCCI), U405.8 (VCCI), U408.3 (VCCI), U408.8 (VCCI), U410.12 (VDD), U411.12 (VDD), U412.12 (VDD), U413.12 (VDD)
ENU: R407.1
ENV: R408.1
ENW: R409.1
GND: C401.1, C402.1, C403.1, C404.1, C405.1, C406.1, C407.1, C408.1, C409.1, C410.2, C411.2, C412.2, C413.1, C414.1, C415.1, C416.1, C417.1, C418.1, C455.1, C456.1, C457.1, C458.1, C459.1, C461.1, C463.1, C465.1, C467.1, C468.1, C469.1, C470.1, M401.T2, M401.T4, M401.T6, R410.2, R411.2, R412.2, R456.1, R457.1, R458.1, R459.1, U401.2 (-VIN), U402.4 (GND), U403.2 (-VIN), U404.2 (-VIN), U405.4 (GND), U406.2 (-VIN), U407.2 (-VIN), U408.4 (GND), U409.2 (-VIN), U410.9 (GND), U411.9 (GND), U412.9 (GND), U413.9 (GND), U414.2 (V-), U415.2 (V-), U416.2 (V-), U417.2 (V-)
unnamed: C401.2, R401.2, U402.1 (INA)
unnamed: C402.2, R402.2, U405.1 (INA)
unnamed: C403.2, R403.2, U408.1 (INA)
unnamed: C404.2, R404.2, U402.2 (INB)
unnamed: C405.2, R405.2, U405.2 (INB)
unnamed: C406.2, R406.2, U408.2 (INB)
unnamed: C407.2, R407.2, U402.5 (EN)
unnamed: C408.2, R408.2, U405.5 (EN)
unnamed: C409.2, R409.2, U408.5 (EN)
unnamed: C414.2, R410.1, U402.6 (DT)
unnamed: C416.2, R411.1, U405.6 (DT)
unnamed: C418.2, R412.1, U408.6 (DT)
unnamed: C419.1, C420.1, M401.S1, U401.6 (0V)
unnamed: C419.2, U401.7 (+VOUT), U402.16 (VDDA)
unnamed: C420.2, U401.5 (-VOUT), U402.14 (VSSA)
unnamed: C421.1, C422.1, M401.S3, U404.6 (0V)
unnamed: C421.2, U404.7 (+VOUT), U405.16 (VDDA)
unnamed: C422.2, U404.5 (-VOUT), U405.14 (VSSA)
unnamed: C423.1, C424.1, M401.S5, U407.6 (0V)
unnamed: C423.2, U407.7 (+VOUT), U408.16 (VDDA)
unnamed: C424.2, U407.5 (-VOUT), U408.14 (VSSA)
unnamed: C425.1, C426.2, M401.S2.1, U403.6 (0V)
unnamed: C425.2, U402.11 (VDDB), U403.7 (+VOUT)
unnamed: C426.1, U402.9 (VSSB), U403.5 (-VOUT)
unnamed: C427.1, C428.2, M401.S4.1, U406.6 (0V)
unnamed: C427.2, U405.11 (VDDB), U406.7 (+VOUT)
unnamed: C428.1, U405.9 (VSSB), U406.5 (-VOUT)
unnamed: C429.1, C430.2, M401.S6.1, U409.6 (0V)
unnamed: C429.2, U408.11 (VDDB), U409.7 (+VOUT)
unnamed: C430.1, U408.9 (VSSB), U409.5 (-VOUT)
unnamed: C431.2, R436.1, R440.1, U410.6 (INP)
unnamed: C432.2, R437.1, R441.1, U411.6 (INP)
unnamed: C433.2, R438.1, R442.1, U412.6 (INP)
unnamed: C434.2, R439.1, R443.1, U413.6 (INP)
unnamed: C435.2, C441.2, U410.5 (HLDO_OUT)
unnamed: C436.2, C444.2, U411.5 (HLDO_OUT)
unnamed: C437.2, C447.2, U412.5 (HLDO_OUT)
unnamed: C438.2, C450.2, U413.5 (HLDO_OUT)
unnamed: C439.2, C451.2, U410.1 (DCDC_OUT)
unnamed: C440.1, U410.3 (HLDO_IN)
unnamed: C442.2, C452.2, U411.1 (DCDC_OUT)
unnamed: C443.1, U411.3 (HLDO_IN)
unnamed: C445.2, C453.2, U412.1 (DCDC_OUT)
unnamed: C446.1, U412.3 (HLDO_IN)
unnamed: C448.2, C454.2, U413.1 (DCDC_OUT)
unnamed: C449.1, U413.3 (HLDO_IN)
unnamed: C460.1, U410.15 (DCDC_GND)
unnamed: C460.2, U410.13 (LDO_OUT), U410.16 (DCDC_IN)
unnamed: C462.1, U411.15 (DCDC_GND)
unnamed: C462.2, U411.13 (LDO_OUT), U411.16 (DCDC_IN)
unnamed: C464.1, U412.15 (DCDC_GND)
unnamed: C464.2, U412.13 (LDO_OUT), U412.16 (DCDC_IN)
unnamed: C466.1, U413.15 (DCDC_GND)
unnamed: C466.2, U413.13 (LDO_OUT), U413.16 (DCDC_IN)
unnamed: D401.1 (K), R413.2
unnamed: D401.2 (A), M401.G1, R414.2, TP407.1
unnamed: D402.1 (K), R415.2
unnamed: D402.2 (A), M401.G2, R416.2, TP408.1
unnamed: D403.1 (K), R417.2
unnamed: D403.2 (A), M401.G3, R418.2, TP409.1
unnamed: D404.1 (K), R419.2
unnamed: D404.2 (A), M401.G4, R420.2, TP410.1
unnamed: D405.1 (K), R421.2
unnamed: D405.2 (A), M401.G5, R422.2, TP411.1
unnamed: D406.1 (K), R423.2
unnamed: D406.2 (A), M401.G6, R424.2, TP412.1
unnamed: R413.1, R414.1, U402.15 (OUTA)
unnamed: R415.1, R416.1, U402.10 (OUTB)
unnamed: R417.1, R418.1, U405.15 (OUTA)
unnamed: R419.1, R420.1, U405.10 (OUTB)
unnamed: R421.1, R422.1, U408.15 (OUTA)
unnamed: R423.1, R424.1, U408.10 (OUTB)
unnamed: R428.1, R432.2
unnamed: R429.1, R433.2
unnamed: R430.1, R434.2
unnamed: R431.1, R435.2
unnamed: R432.1, R436.2
unnamed: R433.1, R437.2
unnamed: R434.1, R438.2
unnamed: R435.1, R439.2
unnamed: R444.1, U410.14 (DIAG)
unnamed: R445.1, U411.14 (DIAG)
unnamed: R446.1, U412.14 (DIAG)
unnamed: R447.1, U413.14 (DIAG)
unnamed: R448.1, U410.11 (OUTP)
unnamed: R448.2, R460.1, U414.4 (-)
unnamed: R449.1, U410.10 (OUTN)
unnamed: R449.2, R456.2, U414.3 (+)
unnamed: R450.1, U411.11 (OUTP)
unnamed: R450.2, R461.1, U415.4 (-)
unnamed: R451.1, U411.10 (OUTN)
unnamed: R451.2, R457.2, U415.3 (+)
unnamed: R452.1, U412.11 (OUTP)
unnamed: R452.2, R462.1, U416.4 (-)
unnamed: R453.1, U412.10 (OUTN)
unnamed: R453.2, R458.2, U416.3 (+)
unnamed: R454.1, U413.11 (OUTP)
unnamed: R454.2, R463.1, U417.4 (-)
unnamed: R455.1, U413.10 (OUTN)
unnamed: R455.2, R459.2, U417.3 (+)
T_U: M401.T1, R427.1
T_V: M401.T3, R426.1
T_W: M401.T5, R425.1
UH: R401.1
UL: R404.1
V+: M401.D1.2, R428.2
V-_U: C431.1, C432.1, C435.1, C436.1, C439.1, C440.2, C441.1, C442.1, C443.2, C444.1, C451.1, C452.1, M401.S2.2, R440.2, R441.2, U410.2 (DCDC_HGND), U410.7 (INN), U410.8 (HGND), U411.2 (DCDC_HGND), U411.7 (INN), U411.8 (HGND)
V-_V: C433.1, C437.1, C445.1, C446.2, C447.1, C453.1, M401.S4.2, R442.2, U412.2 (DCDC_HGND), U412.7 (INN), U412.8 (HGND)
V-_W: C434.1, C438.1, C448.1, C449.2, C450.1, C454.1, M401.S6.2, R443.2, U413.2 (DCDC_HGND), U413.7 (INN), U413.8 (HGND)
VCC: U401.1 (+VIN), U403.1 (+VIN), U404.1 (+VIN), U406.1 (+VIN), U407.1 (+VIN), U409.1 (+VIN)
VH: R402.1
VL: R405.1
V_U: M401.D2, R429.2
V_V: M401.D4, R430.2
V_W: M401.D6, R431.2
Vsen_DC: R460.2, U414.1
Vsen_U: R461.2, U415.1
Vsen_V: R462.2, U416.1
Vsen_W: R463.2, U417.1
WH: R403.1
WL: R406.1
