NTURacingTeam/nturt_kicad/EP5/Powertrain/Inverter/InverterMCUconverter/mcu_stm32.kicad_sch

## KiCad design EP5/Powertrain/Inverter/InverterMCUconverter/mcu_stm32.kicad_sch (2024-11-21)

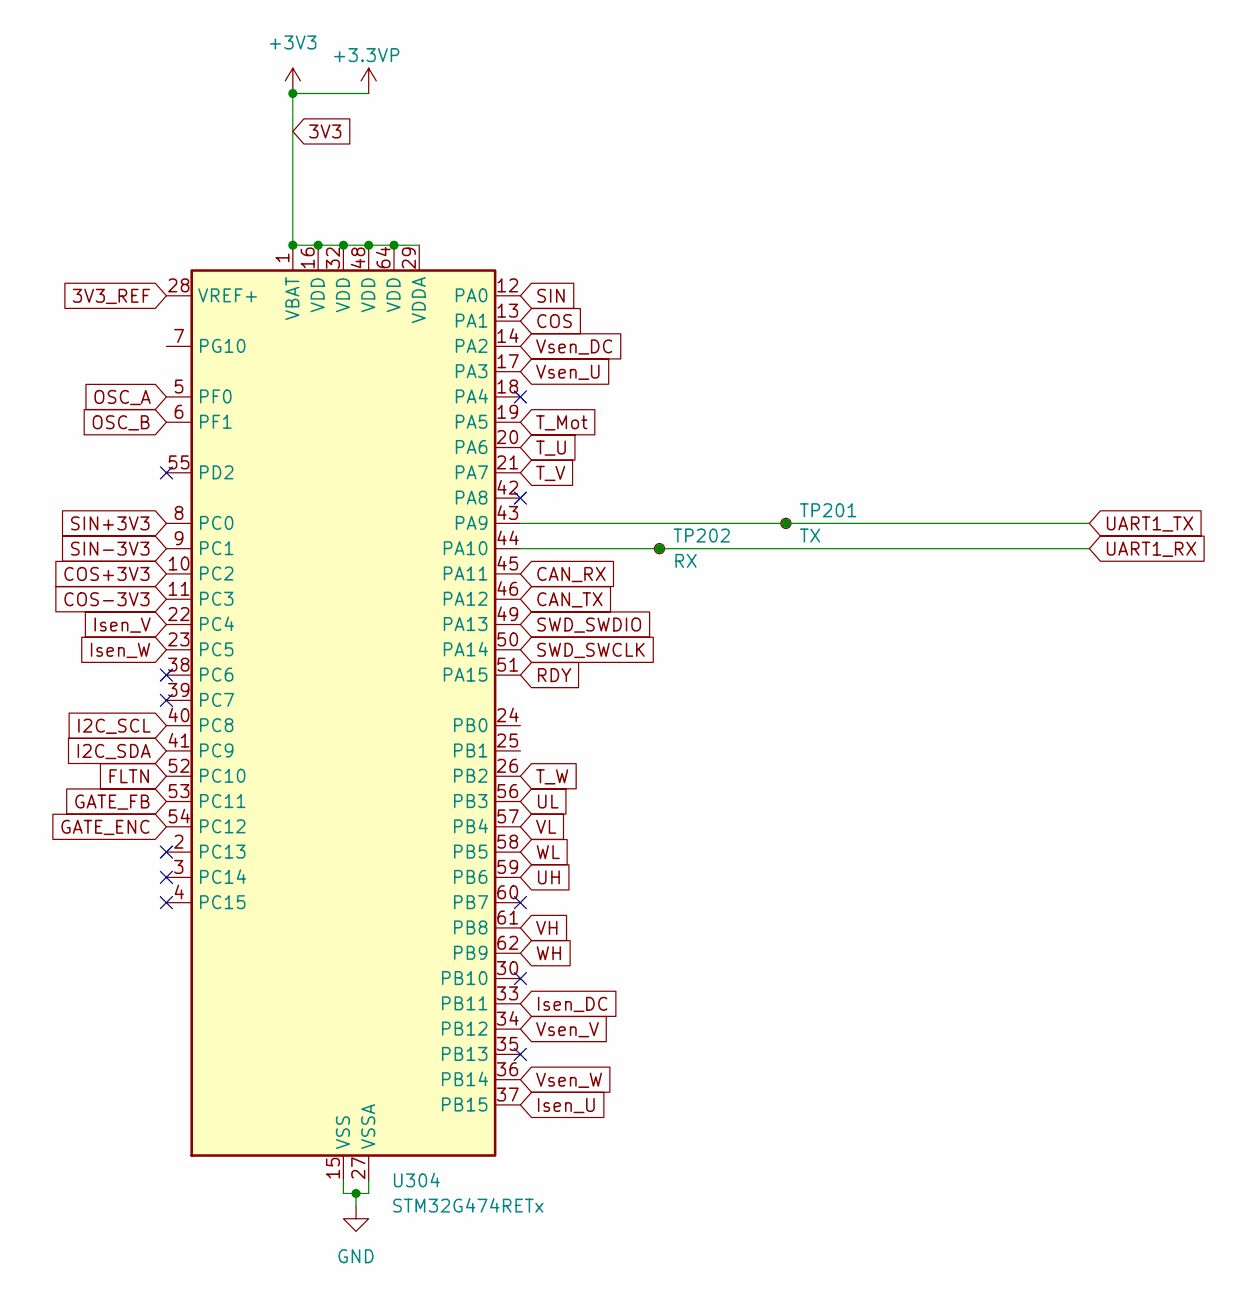
[picture p198: schematic mcu_stm32.kicad_sch]

Parts:
TP201: TX; TestPoint_Pad_D1.0mm
TP202: RX; TestPoint_Pad_D1.0mm
U304: STM32G474RETx; LQFP-64_10x10mm_P0.5mm

Connections:
3V3_REF: U304.28 (VREF+)
+3.3VP: U304.1 (VBAT), U304.16 (VDD), U304.29 (VDDA), U304.32 (VDD), U304.48 (VDD), U304.64 (VDD)
CAN_RX: U304.45 (PA11)
CAN_TX: U304.46 (PA12)
COS: U304.13 (PA1)
COS+3V3: U304.10 (PC2)
COS-3V3: U304.11 (PC3)
FLTN: U304.52 (PC10)
GATE_ENC: U304.54 (PC12)
GATE_FB: U304.53 (PC11)
GND: U304.15 (VSS), U304.27 (VSSA), U304.31 (VSS), U304.47 (VSS), U304.63 (VSS)
I2C_SCL: U304.40 (PC8)
I2C_SDA: U304.41 (PC9)
Isen_DC: U304.33 (PB11)
Isen_U: U304.37 (PB15)
Isen_V: U304.22 (PC4)
Isen_W: U304.23 (PC5)
OSC_A: U304.5 (PF0)
OSC_B: U304.6 (PF1)
RDY: U304.51 (PA15)
SIN: U304.12 (PA0)
SIN+3V3: U304.8 (PC0)
SIN-3V3: U304.9 (PC1)
SWD_SWCLK: U304.50 (PA14)
SWD_SWDIO: U304.49 (PA13)
T_Mot: U304.19 (PA5)
T_U: U304.20 (PA6)
T_V: U304.21 (PA7)
T_W: U304.26 (PB2)
UART1_RX: TP202.1, U304.44 (PA10)
UART1_TX: TP201.1, U304.43 (PA9)
UH: U304.59 (PB6)
UL: U304.56 (PB3)
VH: U304.61 (PB8)
VL: U304.57 (PB4)
Vsen_DC: U304.14 (PA2)
Vsen_U: U304.17 (PA3)
Vsen_V: U304.34 (PB12)
Vsen_W: U304.36 (PB14)
WH: U304.62 (PB9)
WL: U304.58 (PB5)
