NTURacingTeam/nturt_kicad/EP5/Powertrain/Inverter/InverterMainBoard/CSOC.kicad_sch

## KiCad design EP5/Powertrain/Inverter/InverterMainBoard/CSOC.kicad_sch (2024-11-21)

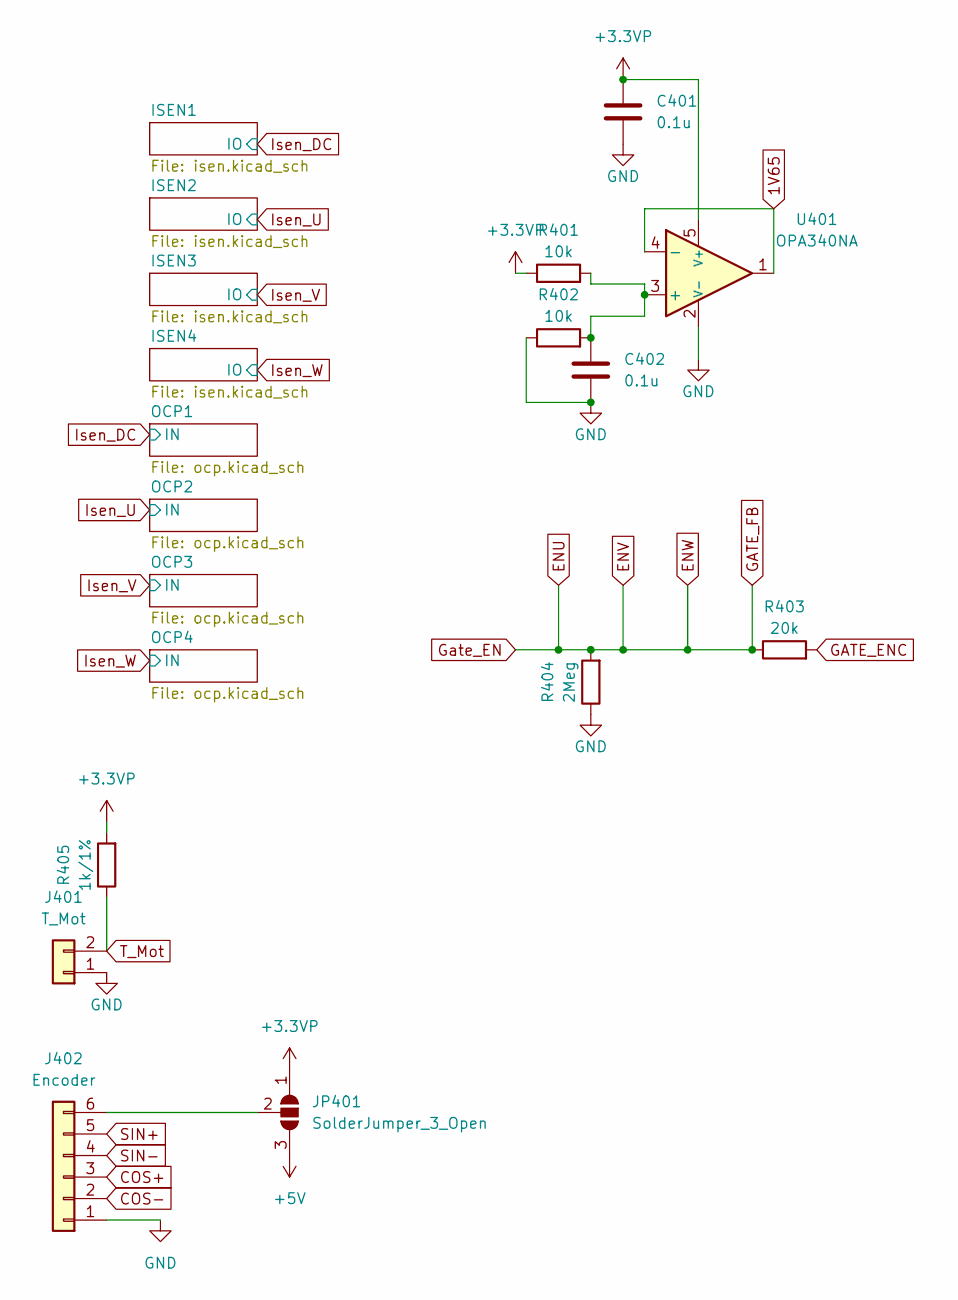
[picture p199: schematic CSOC.kicad_sch]

Parts:
C401, C402: 0.1u; C_0603_1608Metric
J401: T_Mot; JST_XH_B2B-XH-A_1x02_P2.50mm_Vertical
J402: Encoder; JST_XH_B6B-XH-A_1x06_P2.50mm_Vertical
JP401: SolderJumper_3_Open; SolderJumper-3_P1.3mm_Open_Pad1.0x1.5mm
R401, R402: 10k; R_0603_1608Metric
R403: 20k; R_0603_1608Metric
R404: 2Meg; R_0603_1608Metric
R405: 1k/1%; R_0603_1608Metric
U401: OPA340NA; SOT-23-5

Connections:
1V65: U401.1, U401.4 (-)
+3.3VP: C401.2, JP401.1 (A), R401.1, R405.2, U401.5 (V+)
+5V: JP401.3 (B)
COS+: J402.3
COS-: J402.2
ENU: R403.1, R404.2
GATE_ENC: R403.2
GND: C401.1, C402.1, J401.1, J402.1, R402.1, R404.1, U401.2 (V-)
unnamed: C402.2, R401.2, R402.2, U401.3 (+)
unnamed: J402.6, JP401.2 (C)
SIN+: J402.5
SIN-: J402.4
T_Mot: J401.2, R405.1
