NTURacingTeam/nturt_kicad/EP5/Powertrain/Inverter/InverterMainBoard/InverterMainBoard.kicad_sch

## KiCad design EP5/Powertrain/Inverter/InverterMainBoard/InverterMainBoard.kicad_sch (2024-11-21)

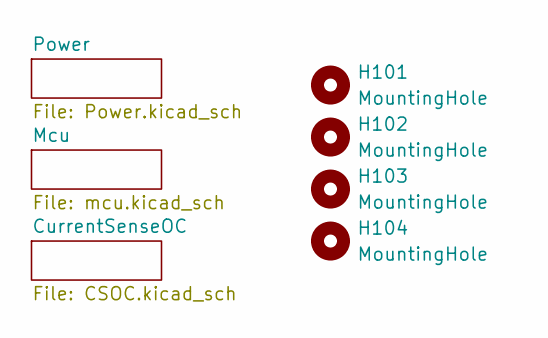
[picture p200: schematic InverterMainBoard.kicad_sch]

Parts:
H101, H102, H103, H104: MountingHole; MountingHole_4mm
