NTURacingTeam/nturt_kicad/EP5/Powertrain/Inverter/InverterMainBoard/Power.kicad_sch

## KiCad design EP5/Powertrain/Inverter/InverterMainBoard/Power.kicad_sch (2024-11-21)

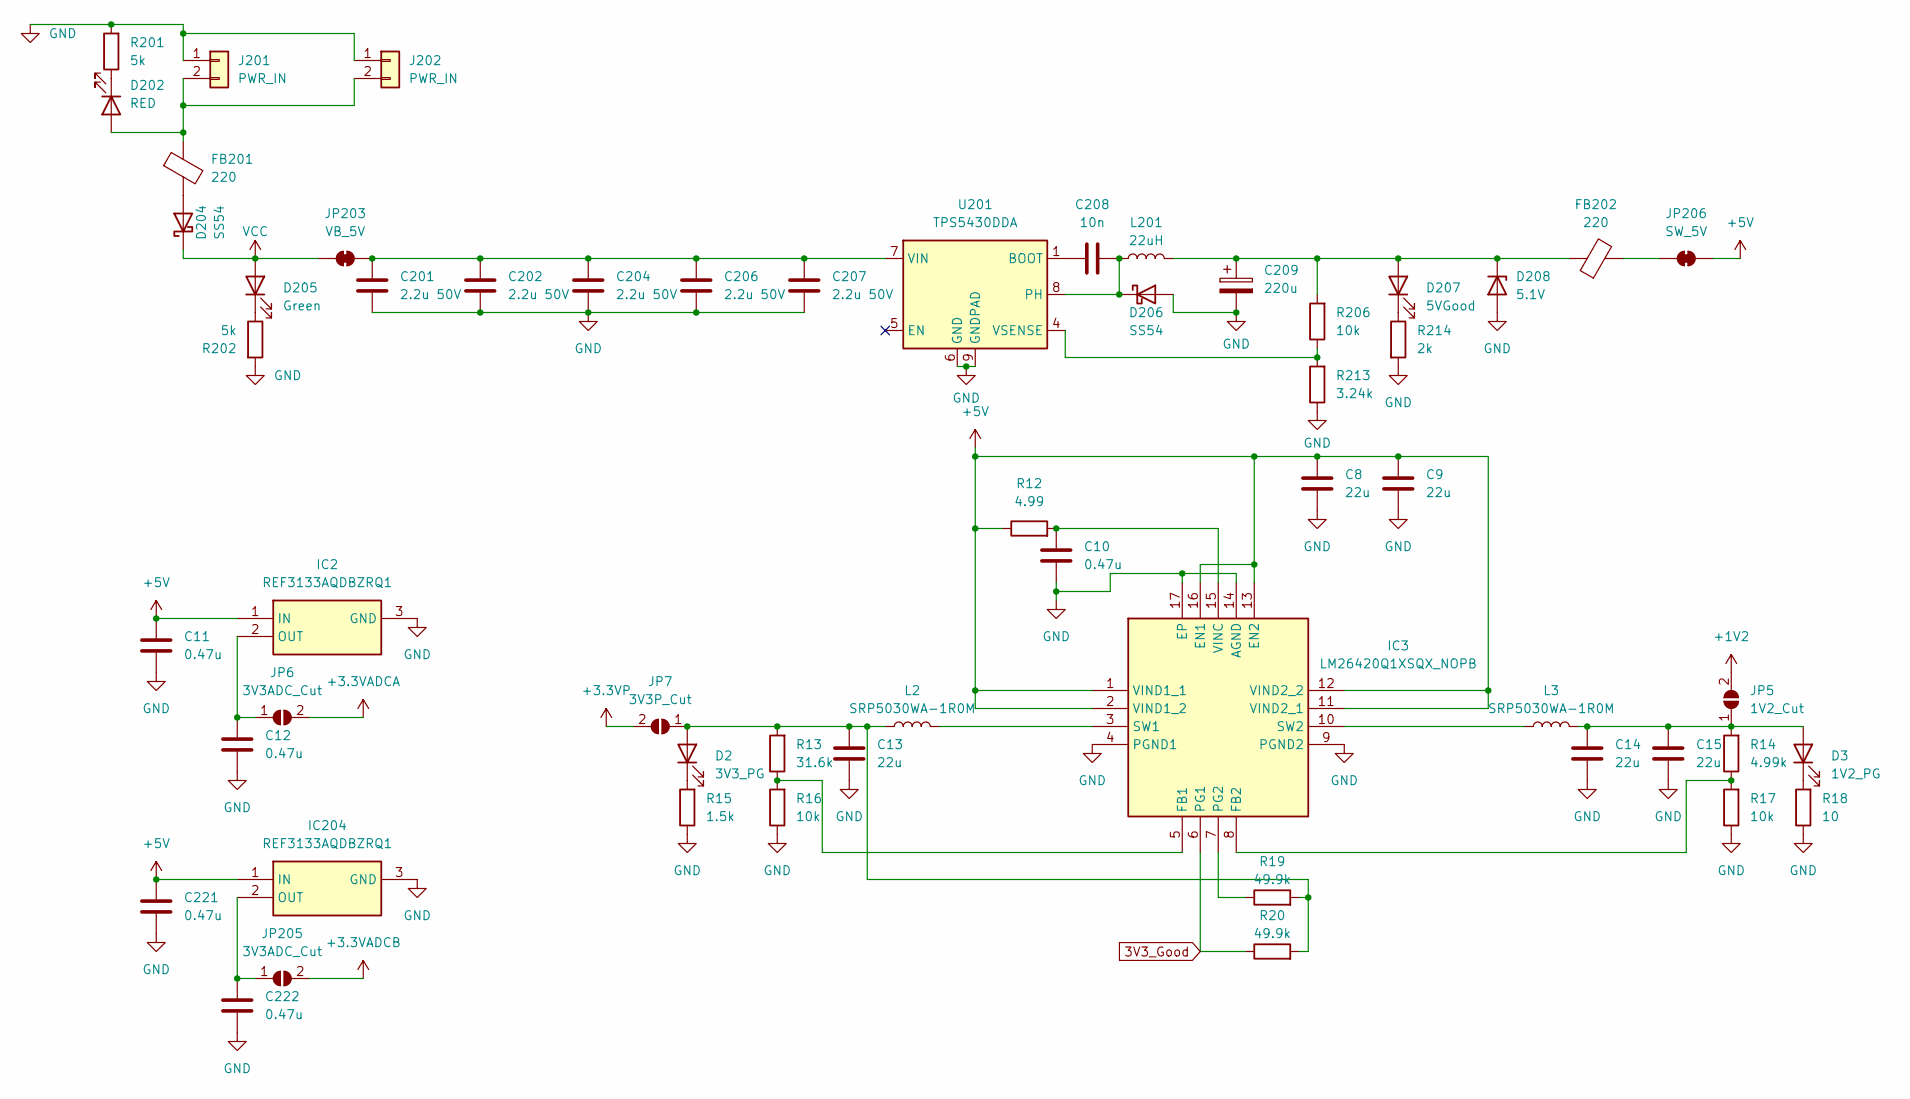
[picture p201: schematic Power.kicad_sch]

Parts:
C8, C9, C13, C14, C15: 22u; C_1206_3216Metric
C10, C11, C12, C221, C222: 0.47u; C_0603_1608Metric
C201, C202, C204, C206, C207: 2.2u 50V; C_0805_2012Metric
C208: 10n; C_0603_1608Metric
C209: 220u; CP_Elec_8x10.5
D2: 3V3_PG; LED_0603_1608Metric
D3: 1V2_PG; LED_0603_1608Metric
D202: RED; LED_0603_1608Metric
D204, D206: SS54; D_SMA
D205: Green; LED_0603_1608Metric
D207: 5VGood; LED_0603_1608Metric
D208: 5.1V; D_SOD-123
FB201, FB202: 220; R_0603_1608Metric
IC2, IC204: REF3133AQDBZRQ1; SOT95P237X112-3N; Mouser Part Number 595-REF3133AQDBZRQ1
IC3: LM26420Q1XSQX_NOPB; QFN65P400X400X80-17N; Mouser Part Number 595-LM26420Q1XSQXNPB
J201, J202: PWR_IN; JST_XH_B2B-XH-A_1x02_P2.50mm_Vertical
JP5: 1V2_Cut; SolderJumper-2_P1.3mm_Bridged_Pad1.0x1.5mm
JP6, JP205: 3V3ADC_Cut; SolderJumper-2_P1.3mm_Bridged_Pad1.0x1.5mm
JP7: 3V3P_Cut; SolderJumper-2_P1.3mm_Bridged_Pad1.0x1.5mm
JP203: VB_5V; SolderJumper-2_P1.3mm_Open_Pad1.0x1.5mm
JP206: SW_5V; SolderJumper-2_P1.3mm_Open_Pad1.0x1.5mm
L2, L3: SRP5030WA-1R0M; L_Bourns_SRP5030T
L201: 22uH; L_Bourns_SRR1260
R12: 4.99; R_0603_1608Metric
R13: 31.6k; R_0603_1608Metric
R14: 4.99k; R_0603_1608Metric
R15: 1.5k; R_0603_1608Metric
R16, R17, R206: 10k; R_0603_1608Metric
R18: 10; R_0603_1608Metric
R19, R20: 49.9k; R_0603_1608Metric
R201, R202: 5k; R_0603_1608Metric
R213: 3.24k; R_0603_1608Metric
R214: 2k; R_0603_1608Metric
U201: TPS5430DDA; TI_SO-PowerPAD-8_ThermalVias

Connections:
3V3_Good: IC3.6 (PG1), R20.1
+1V2: JP5.2 (B)
+3.3VADCA: JP6.2 (B)
+3.3VADCB: JP205.2 (B)
+3.3VP: JP7.2 (B)
+5V: C8.1, C9.1, C11.1, C221.1, IC2.1 (IN), IC3.1 (VIND1_1), IC3.2 (VIND1_2), IC3.11 (VIND2_1), IC3.12 (VIND2_2), IC3.13 (EN2), IC3.16 (EN1), IC204.1 (IN), JP206.2 (B), R12.1
GND: C8.2, C9.2, C10.2, C11.2, C12.2, C13.2, C14.2, C15.2, C201.2, C202.2, C204.2, C206.2, C207.2, C209.2, C221.2, C222.2, D206.2 (A), D208.2 (A), IC2.3 (GND), IC3.4 (PGND1), IC3.9 (PGND2), IC3.14 (AGND), IC3.17 (EP), IC204.3 (GND), J201.1, J202.1, R15.1, R16.1, R17.1, R18.1, R201.2, R202.2, R213.1, R214.2, U201.6 (GND), U201.9 (GNDPAD)
unnamed: C10.1, IC3.15 (VINC), R12.2
unnamed: C12.1, IC2.2 (OUT), JP6.1 (A)
unnamed: C13.1, D2.2 (A), JP7.1 (A), L2.1, R13.2, R19.2, R20.2
unnamed: C14.1, C15.1, D3.2 (A), JP5.1 (A), L3.2, R14.2
unnamed: C201.1, C202.1, C204.1, C206.1, C207.1, JP203.2 (B), U201.7 (VIN)
unnamed: C208.1, U201.1 (BOOT)
unnamed: C208.2, D206.1 (K), L201.1, U201.8 (PH)
unnamed: C209.1, D207.2 (A), D208.1 (K), FB202.1, L201.2, R206.2
unnamed: C222.1, IC204.2 (OUT), JP205.1 (A)
unnamed: D2.1 (K), R15.2
unnamed: D3.1 (K), R18.2
unnamed: D202.1 (K), R201.1
unnamed: D202.2 (A), FB201.1, J201.2, J202.2
unnamed: D204.2 (A), FB201.2
unnamed: D205.1 (K), R202.1
unnamed: D207.1 (K), R214.1
unnamed: FB202.2, JP206.1 (A)
unnamed: IC3.3 (SW1), L2.2
unnamed: IC3.5 (FB1), R13.1, R16.2
unnamed: IC3.7 (PG2), R19.1
unnamed: IC3.8 (FB2), R14.1, R17.2
unnamed: IC3.10 (SW2), L3.1
unnamed: R206.1, R213.2, U201.4 (VSENSE)
VCC: D204.1 (K), D205.2 (A), JP203.1 (A)
