NTURacingTeam/nturt_kicad/EP5/Powertrain/Inverter/InverterMainBoard/isen.kicad_sch

## KiCad design EP5/Powertrain/Inverter/InverterMainBoard/isen.kicad_sch (2024-11-21)

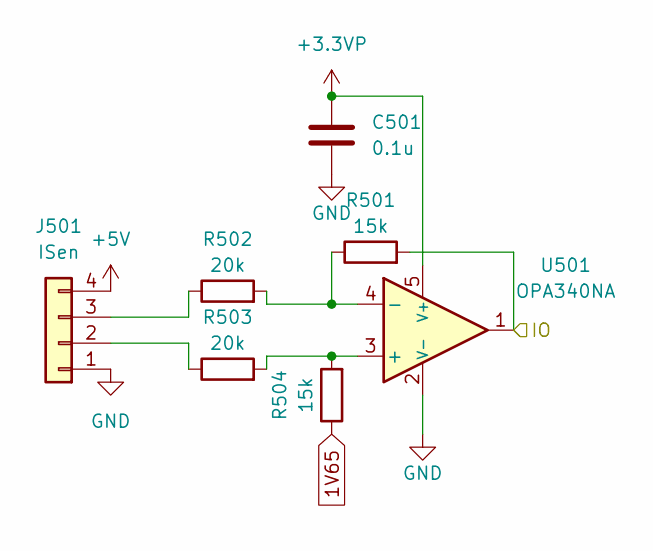
[picture p202: schematic isen.kicad_sch]

Parts:
C501: 0.1u; C_0603_1608Metric
J501: ISen; JST_XH_B4B-XH-A_1x04_P2.50mm_Vertical
R501, R504: 15k; R_0603_1608Metric
R502, R503: 20k; R_0603_1608Metric
U501: OPA340NA; SOT-23-5

Connections:
1V65: R504.1
+3.3VP: C501.2, U501.5 (V+)
+5V: J501.4
GND: C501.1, J501.1, U501.2 (V-)
IO: R501.2, U501.1
unnamed: J501.2, R503.1
unnamed: J501.3, R502.1
unnamed: R501.1, R502.2, U501.4 (-)
unnamed: R503.2, R504.2, U501.3 (+)
