NTURacingTeam/nturt_kicad/EP5/Powertrain/Inverter/InverterMainBoard/mcu.kicad_sch

## KiCad design EP5/Powertrain/Inverter/InverterMainBoard/mcu.kicad_sch (2024-11-21)

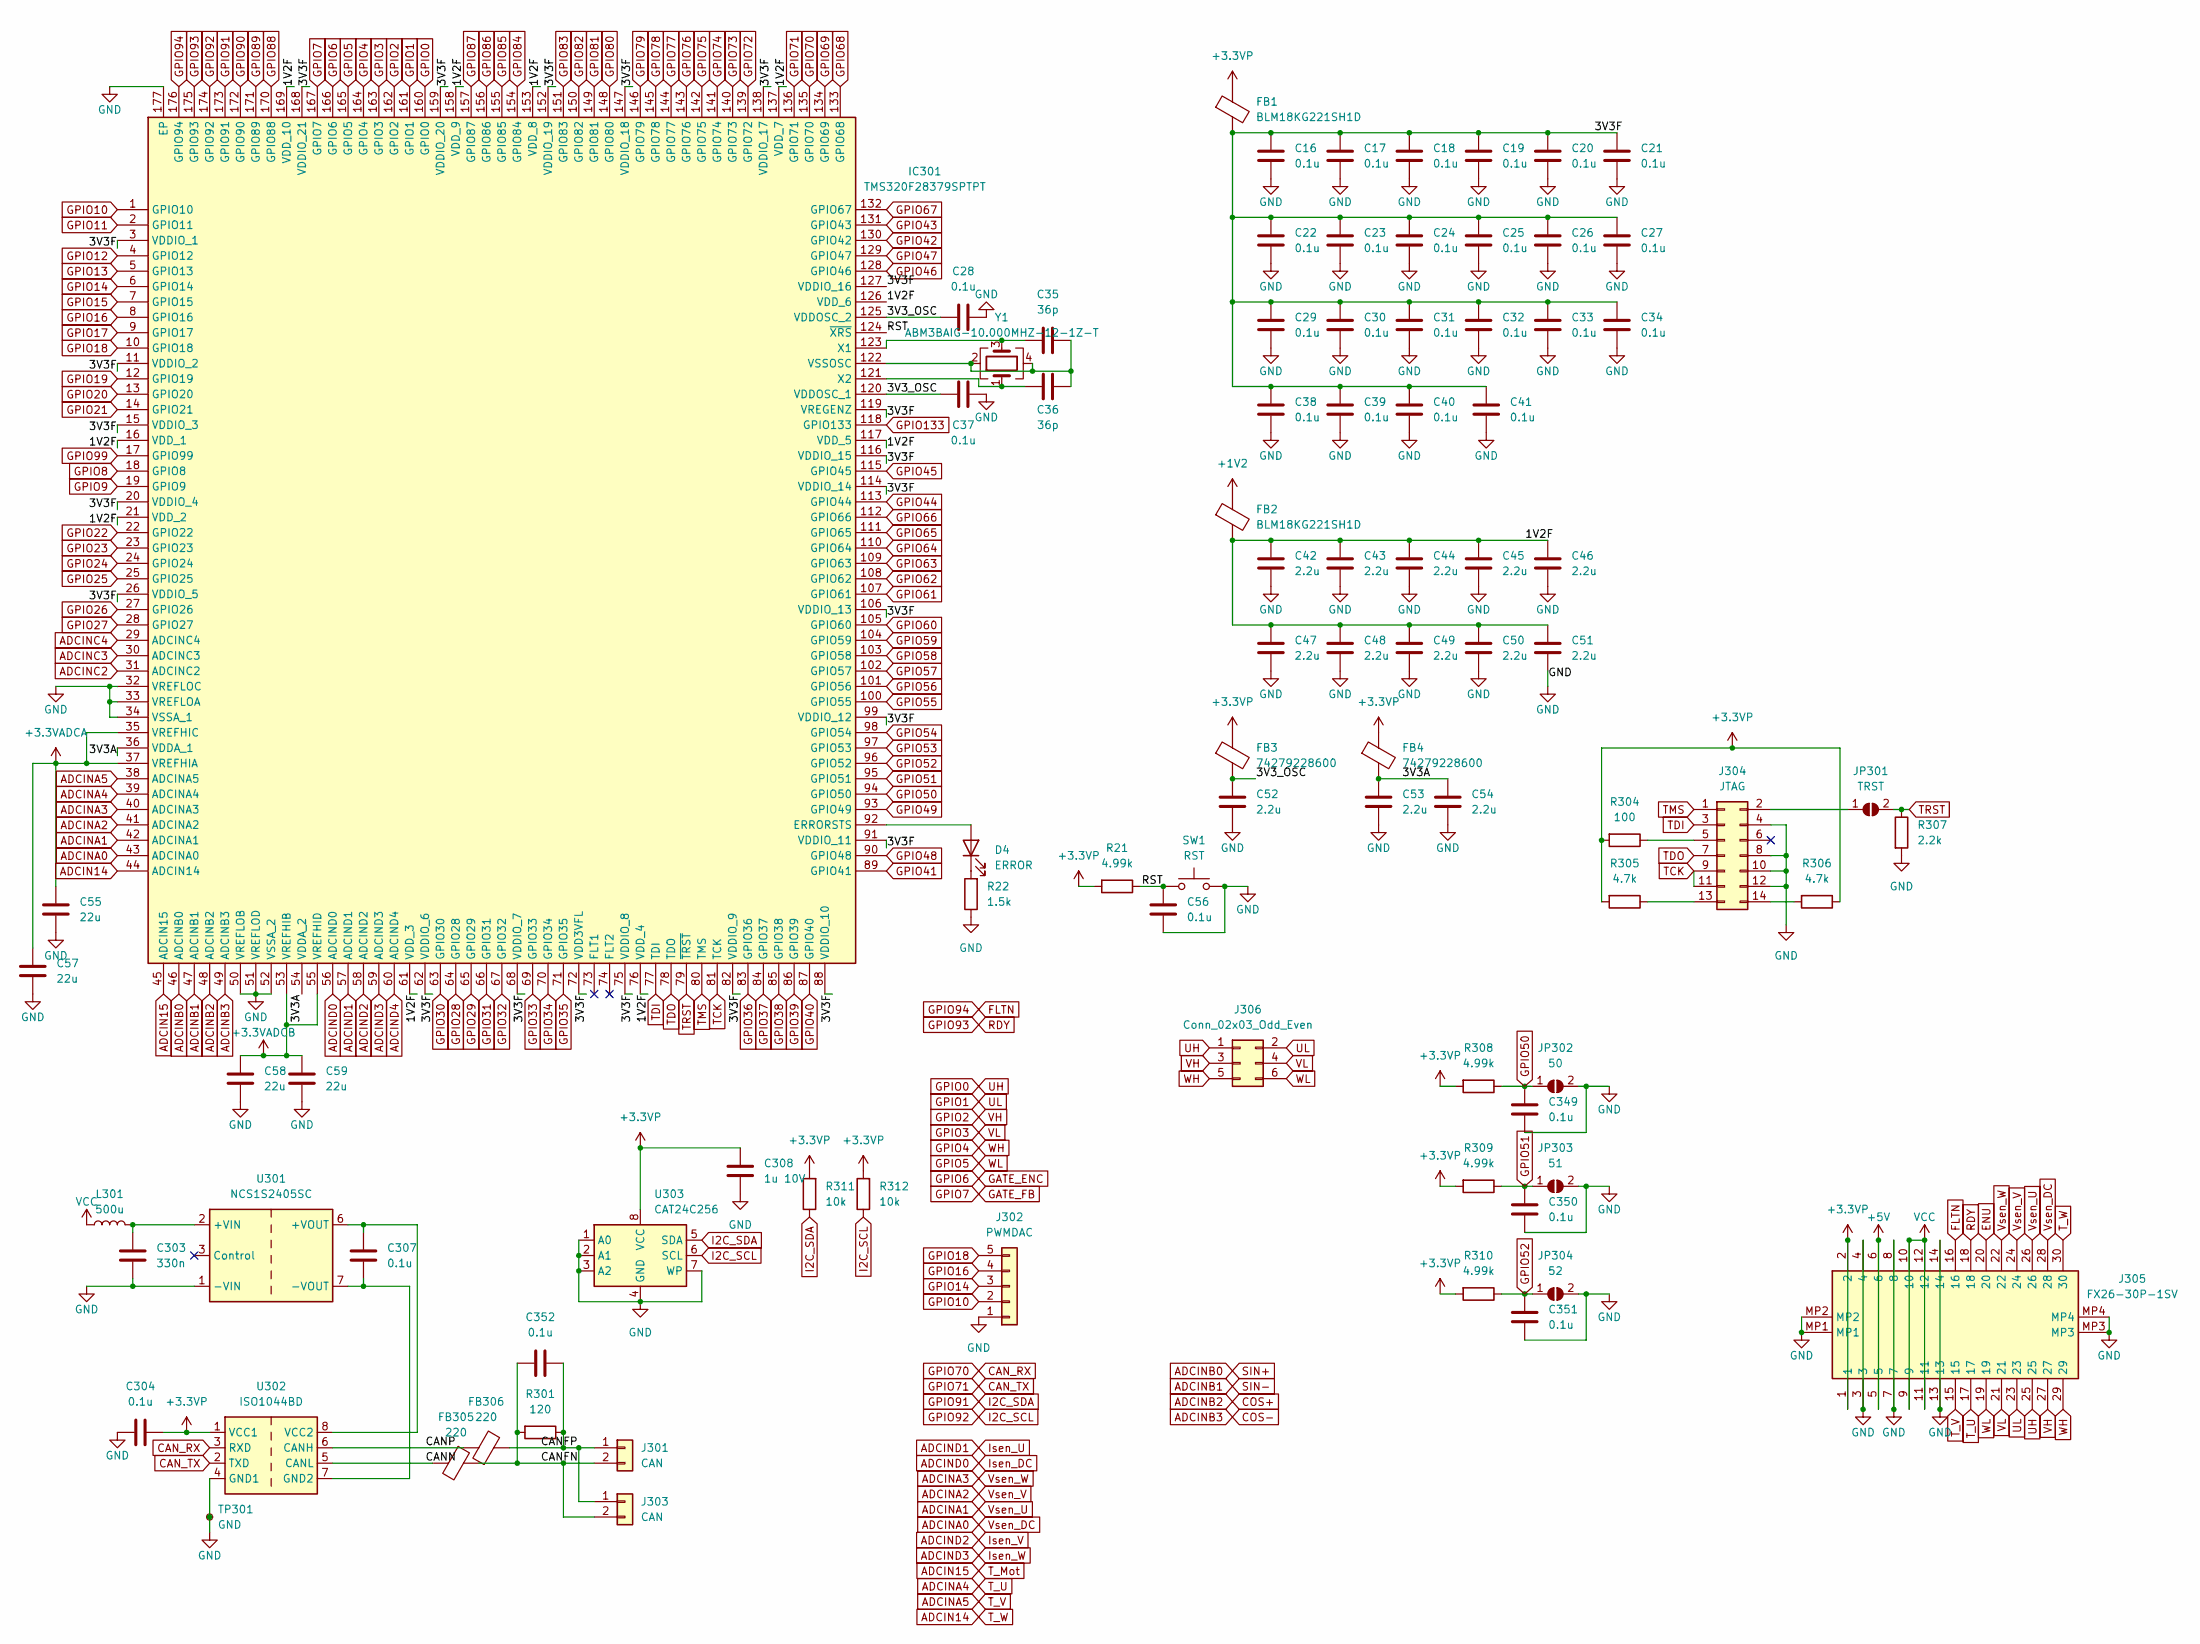
[picture p203: schematic mcu.kicad_sch]

Parts:
C16, C17, C18, C19, C20, C21, C22, C23, C24, C25, C26, C27, C28, C29, C30, C31, C32, C33, C34, C37, C38, C39, C40, C41, C56, C304, C307, C349, C350, C351, C352: 0.1u; C_0603_1608Metric
C35, C36: 36p; C_0603_1608Metric
C42, C43, C44, C45, C46, C47, C48, C49, C50, C51, C52, C53, C54: 2.2u; C_0603_1608Metric
C55, C57, C58, C59: 22u; C_1206_3216Metric
C303: 330n; C_0603_1608Metric
C308: 1u 10V; C_0603_1608Metric
D4: ERROR; LED_0603_1608Metric
FB1, FB2: BLM18KG221SH1D; L_0603_1608Metric
FB3, FB4: 74279228600; L_0603_1608Metric
FB305, FB306: 220; R_0603_1608Metric
IC301: TMS320F28379SPTPT; QFP50P2600X2600X160-177N; Mouser Part Number 595-TMS32028379SPTPT
J301, J303: CAN; JST_XH_B2B-XH-A_1x02_P2.50mm_Vertical
J302: PWMDAC; PinHeader_1x05_P2.54mm_Vertical
J304: JTAG; IDC-Header_2x07_P2.54mm_Vertical
J305: FX26-30P-1SV; FX2630P1SV; Mouser Part Number 798-FX2630P1SV
J306: Conn_02x03_Odd_Even; PinHeader_2x03_P2.54mm_Vertical
JP301: TRST; SolderJumper-2_P1.3mm_Bridged_Pad1.0x1.5mm
JP302: 50; SolderJumper-2_P1.3mm_Open_Pad1.0x1.5mm
JP303: 51; SolderJumper-2_P1.3mm_Open_Pad1.0x1.5mm
JP304: 52; SolderJumper-2_P1.3mm_Open_Pad1.0x1.5mm
L301: 500u; L_Changjiang_FNR4030S
R21, R308, R309, R310: 4.99k; R_0603_1608Metric
R22: 1.5k; R_0603_1608Metric
R301: 120; R_0603_1608Metric
R304: 100; R_0603_1608Metric
R305, R306: 4.7k; R_0603_1608Metric
R307: 2.2k; R_0603_1608Metric
R311, R312: 10k; R_0603_1608Metric
SW1: RST; SW_Push_1P1T_XKB_TS-1187A
TP301: GND; TestPoint_Loop_D1.80mm_Drill1.0mm_Beaded
U301: NCS1S2405SC; Converter_DCDC_Murata_NCS1SxxxxSC_THT
U302: ISO1044BD; SOIC-8_3.9x4.9mm_P1.27mm
U303: CAT24C256; SOIC-8_3.9x4.9mm_P1.27mm
Y1: ABM3BAIG-10.000MHZ-12-1Z-T; Crystal_SMD_Abracon_ABM3B-4Pin_5.0x3.2mm

Connections:
1V2F: C42.1, C43.1, C44.1, C45.1, C46.1, C47.1, C48.1, C49.1, C50.1, C51.1, FB2.2, IC301.16 (VDD_1), IC301.21 (VDD_2), IC301.61 (VDD_3), IC301.76 (VDD_4), IC301.117 (VDD_5), IC301.126 (VDD_6), IC301.137 (VDD_7), IC301.153 (VDD_8), IC301.158 (VDD_9), IC301.169 (VDD_10)
3V3A: C53.1, C54.1, FB4.2, IC301.36 (VDDA_1), IC301.54 (VDDA_2)
3V3F: C16.1, C17.1, C18.1, C19.1, C20.1, C21.1, C22.1, C23.1, C24.1, C25.1, C26.1, C27.1, C29.1, C30.1, C31.1, C32.1, C33.1, C34.1, C38.1, C39.1, C40.1, C41.1, FB1.2, IC301.3 (VDDIO_1), IC301.11 (VDDIO_2), IC301.15 (VDDIO_3), IC301.20 (VDDIO_4), IC301.26 (VDDIO_5), IC301.62 (VDDIO_6), IC301.68 (VDDIO_7), IC301.72 (VDD3VFL), IC301.75 (VDDIO_8), IC301.82 (VDDIO_9), IC301.88 (VDDIO_10), IC301.91 (VDDIO_11), IC301.99 (VDDIO_12), IC301.106 (VDDIO_13), IC301.114 (VDDIO_14), IC301.116 (VDDIO_15), IC301.119 (VREGENZ), IC301.127 (VDDIO_16), IC301.138 (VDDIO_17), IC301.147 (VDDIO_18), IC301.152 (VDDIO_19), IC301.159 (VDDIO_20), IC301.168 (VDDIO_21)
3V3_OSC: C28.1, C37.1, C52.1, FB3.2, IC301.120 (VDDOSC_1), IC301.125 (VDDOSC_2)
+1V2: FB2.1
+3.3VADCA: C55.1, C57.1, IC301.35 (VREFHIC), IC301.37 (VREFHIA)
+3.3VADCB: C58.1, C59.1, IC301.53 (VREFHIB), IC301.55 (VREFHID)
+3.3VP: C304.2, C308.1, FB1.1, FB3.1, FB4.1, J305.1, J305.2, R21.2, R304.2, R305.2, R306.1, R308.2, R309.2, R310.2, R311.2, R312.2, U302.1 (VCC1), U303.8 (VCC)
+5V: J305.5, J305.6
ADCIN14: IC301.44 (ADCIN14), J305.30
ADCIN15: IC301.45 (ADCIN15)
ADCINA0: IC301.43 (ADCINA0), J305.28
ADCINA1: IC301.42 (ADCINA1), J305.26
ADCINA2: IC301.41 (ADCINA2), J305.24
ADCINA3: IC301.40 (ADCINA3), J305.22
ADCINA4: IC301.39 (ADCINA4), J305.17
ADCINA5: IC301.38 (ADCINA5), J305.15
ADCINB0: IC301.46 (ADCINB0)
ADCINB1: IC301.47 (ADCINB1)
ADCINB2: IC301.48 (ADCINB2)
ADCINB3: IC301.49 (ADCINB3)
ADCINC2: IC301.31 (ADCINC2)
ADCINC3: IC301.30 (ADCINC3)
ADCINC4: IC301.29 (ADCINC4)
ADCIND0: IC301.56 (ADCIND0)
ADCIND1: IC301.57 (ADCIND1)
ADCIND2: IC301.58 (ADCIND2)
ADCIND3: IC301.59 (ADCIND3)
ADCIND4: IC301.60 (ADCIND4)
CANFN: C352.1, FB305.1, J301.2, J303.2, R301.2
CANFP: C352.2, FB306.2, J301.1, J303.1, R301.1
CANN: FB305.2, U302.5 (CANL)
CANP: FB306.1, U302.6 (CANH)
CAN_RX: IC301.135 (GPIO70), U302.3 (RXD)
CAN_TX: IC301.136 (GPIO71), U302.2 (TXD)
ENU: J305.20
FLTN: IC301.176 (GPIO94), J305.16
GATE_ENC: IC301.166 (GPIO6)
GATE_FB: IC301.167 (GPIO7)
GND: C16.2, C17.2, C18.2, C19.2, C20.2, C21.2, C22.2, C23.2, C24.2, C25.2, C26.2, C27.2, C28.2, C29.2, C30.2, C31.2, C32.2, C33.2, C34.2, C37.2, C38.2, C39.2, C40.2, C41.2, C42.2, C43.2, C44.2, C45.2, C46.2, C47.2, C48.2, C49.2, C50.2, C51.2, C52.2, C53.2, C54.2, C55.2, C56.2, C57.2, C58.2, C59.2, C303.2, C304.1, C308.2, C349.2, C350.2, C351.2, IC301.32 (VREFLOC), IC301.33 (VREFLOA), IC301.34 (VSSA_1), IC301.50 (VREFLOB), IC301.51 (VREFLOD), IC301.52 (VSSA_2), IC301.177 (EP), J302.1, J304.4, J304.8, J304.10, J304.12, J305.3, J305.4, J305.7, J305.8, J305.13, J305.14, J305.MP1, J305.MP2, J305.MP3, J305.MP4, JP302.2 (B), JP303.2 (B), JP304.2 (B), R22.1, R307.2, SW1.2, TP301.1, U301.1 (-VIN), U302.4 (GND1), U303.1 (A0), U303.2 (A1), U303.3 (A2), U303.4 (GND), U303.7 (WP)
GPIO0: IC301.160 (GPIO0), J305.25, J306.1
GPIO1: IC301.161 (GPIO1), J305.23, J306.2
GPIO2: IC301.162 (GPIO2), J305.27, J306.3
GPIO3: IC301.163 (GPIO3), J305.21, J306.4
GPIO4: IC301.164 (GPIO4), J305.29, J306.5
GPIO5: IC301.165 (GPIO5), J305.19, J306.6
GPIO8: IC301.18 (GPIO8)
GPIO9: IC301.19 (GPIO9)
GPIO10: IC301.1 (GPIO10), J302.2
GPIO11: IC301.2 (GPIO11)
GPIO12: IC301.4 (GPIO12)
GPIO13: IC301.5 (GPIO13)
GPIO14: IC301.6 (GPIO14), J302.3
GPIO15: IC301.7 (GPIO15)
GPIO16: IC301.8 (GPIO16), J302.4
GPIO17: IC301.9 (GPIO17)
GPIO18: IC301.10 (GPIO18), J302.5
GPIO19: IC301.12 (GPIO19)
GPIO20: IC301.13 (GPIO20)
GPIO21: IC301.14 (GPIO21)
GPIO22: IC301.22 (GPIO22)
GPIO23: IC301.23 (GPIO23)
GPIO24: IC301.24 (GPIO24)
GPIO25: IC301.25 (GPIO25)
GPIO26: IC301.27 (GPIO26)
GPIO27: IC301.28 (GPIO27)
GPIO28: IC301.64 (GPIO28)
GPIO29: IC301.65 (GPIO29)
GPIO30: IC301.63 (GPIO30)
GPIO31: IC301.66 (GPIO31)
GPIO32: IC301.67 (GPIO32)
GPIO33: IC301.69 (GPIO33)
GPIO34: IC301.70 (GPIO34)
GPIO35: IC301.71 (GPIO35)
GPIO36: IC301.83 (GPIO36)
GPIO37: IC301.84 (GPIO37)
GPIO38: IC301.85 (GPIO38)
GPIO39: IC301.86 (GPIO39)
GPIO40: IC301.87 (GPIO40)
GPIO41: IC301.89 (GPIO41)
GPIO42: IC301.130 (GPIO42)
GPIO43: IC301.131 (GPIO43)
GPIO44: IC301.113 (GPIO44)
GPIO45: IC301.115 (GPIO45)
GPIO46: IC301.128 (GPIO46)
GPIO47: IC301.129 (GPIO47)
GPIO48: IC301.90 (GPIO48)
GPIO49: IC301.93 (GPIO49)
GPIO50: C349.1, IC301.94 (GPIO50), JP302.1 (A), R308.1
GPIO51: C350.1, IC301.95 (GPIO51), JP303.1 (A), R309.1
GPIO52: C351.1, IC301.96 (GPIO52), JP304.1 (A), R310.1
GPIO53: IC301.97 (GPIO53)
GPIO54: IC301.98 (GPIO54)
GPIO55: IC301.100 (GPIO55)
GPIO56: IC301.101 (GPIO56)
GPIO57: IC301.102 (GPIO57)
GPIO58: IC301.103 (GPIO58)
GPIO59: IC301.104 (GPIO59)
GPIO60: IC301.105 (GPIO60)
GPIO61: IC301.107 (GPIO61)
GPIO62: IC301.108 (GPIO62)
GPIO63: IC301.109 (GPIO63)
GPIO64: IC301.110 (GPIO64)
GPIO65: IC301.111 (GPIO65)
GPIO66: IC301.112 (GPIO66)
GPIO67: IC301.132 (GPIO67)
GPIO68: IC301.133 (GPIO68)
GPIO69: IC301.134 (GPIO69)
GPIO72: IC301.139 (GPIO72)
GPIO73: IC301.140 (GPIO73)
GPIO74: IC301.141 (GPIO74)
GPIO75: IC301.142 (GPIO75)
GPIO76: IC301.143 (GPIO76)
GPIO77: IC301.144 (GPIO77)
GPIO78: IC301.145 (GPIO78)
GPIO79: IC301.146 (GPIO79)
GPIO80: IC301.148 (GPIO80)
GPIO81: IC301.149 (GPIO81)
GPIO82: IC301.150 (GPIO82)
GPIO83: IC301.151 (GPIO83)
GPIO84: IC301.154 (GPIO84)
GPIO85: IC301.155 (GPIO85)
GPIO86: IC301.156 (GPIO86)
GPIO87: IC301.157 (GPIO87)
GPIO88: IC301.170 (GPIO88)
GPIO89: IC301.171 (GPIO89)
GPIO90: IC301.172 (GPIO90)
GPIO91: IC301.173 (GPIO91), R311.1, U303.5 (SDA)
GPIO92: IC301.174 (GPIO92), R312.1, U303.6 (SCL)
GPIO93: IC301.175 (GPIO93), J305.18
GPIO99: IC301.17 (GPIO99)
GPIO133: IC301.118 (GPIO133)
unnamed: C35.1, IC301.123 (X1), Y1.3
unnamed: C35.2, C36.2, IC301.122 (VSSOSC), Y1.2, Y1.4
unnamed: C36.1, IC301.121 (X2), Y1.1
unnamed: C303.1, L301.2, U301.2 (+VIN)
unnamed: C307.1, U301.6 (+VOUT), U302.8 (VCC2)
unnamed: C307.2, U301.7 (-VOUT), U302.7 (GND2)
unnamed: D4.1 (K), R22.2
unnamed: D4.2 (A), IC301.92 (ERRORSTS)
unnamed: J304.2, JP301.1 (A)
unnamed: J304.5, R304.1
unnamed: J304.13, R305.1
unnamed: J304.14, R306.2
RST: C56.1, IC301.124 (~XRS), R21.1, SW1.1
TCK: IC301.81 (TCK), J304.9, J304.11
TDI: IC301.77 (TDI), J304.3
TDO: IC301.78 (TDO), J304.7
TMS: IC301.80 (TMS), J304.1
TRST: IC301.79 (~TRST), JP301.2 (B), R307.1
VCC: J305.9, J305.10, J305.11, J305.12, L301.1
