NTURacingTeam/nturt_kicad/EP5/Powertrain/Inverter/InverterMainBoard/ocp.kicad_sch

## KiCad design EP5/Powertrain/Inverter/InverterMainBoard/ocp.kicad_sch (2024-11-21)

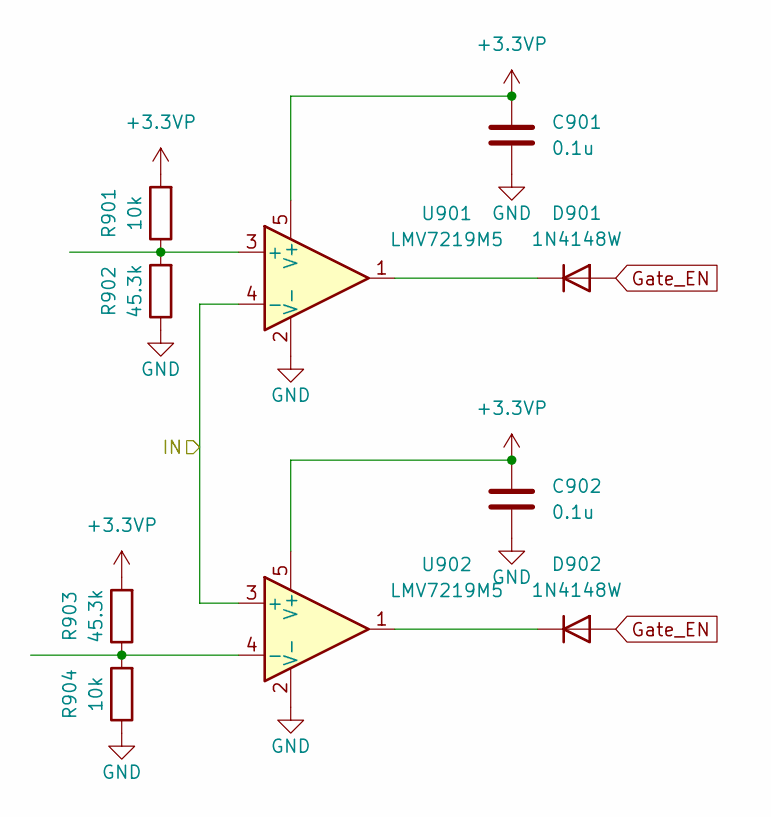
[picture p204: schematic ocp.kicad_sch]

Parts:
C901, C902: 0.1u; C_0603_1608Metric
D901, D902: 1N4148W; D_SOD-123
R901, R904: 10k; R_0603_1608Metric
R902, R903: 45.3k; R_0603_1608Metric
U901, U902: LMV7219M5; SOT-23-5

Connections:
+3.3VP: C901.2, C902.2, R901.2, R903.2, U901.5 (V+), U902.5 (V+)
GND: C901.1, C902.1, R902.1, R904.1, U901.2 (V-), U902.2 (V-)
Gate_EN: D901.2 (A), D902.2 (A)
IN: U901.4 (-), U902.3 (+)
unnamed: D901.1 (K), U901.1
unnamed: D902.1 (K), U902.1
unnamed: R901.1, R902.2, U901.3 (+)
unnamed: R903.1, R904.2, U902.4 (-)
