NTURacingTeam/nturt_kicad/EP5/Powertrain/Inverter/InverterMainBoard_STM32/CSOC.kicad_sch

## KiCad design EP5/Powertrain/Inverter/InverterMainBoard_STM32/CSOC.kicad_sch (2024-11-21)

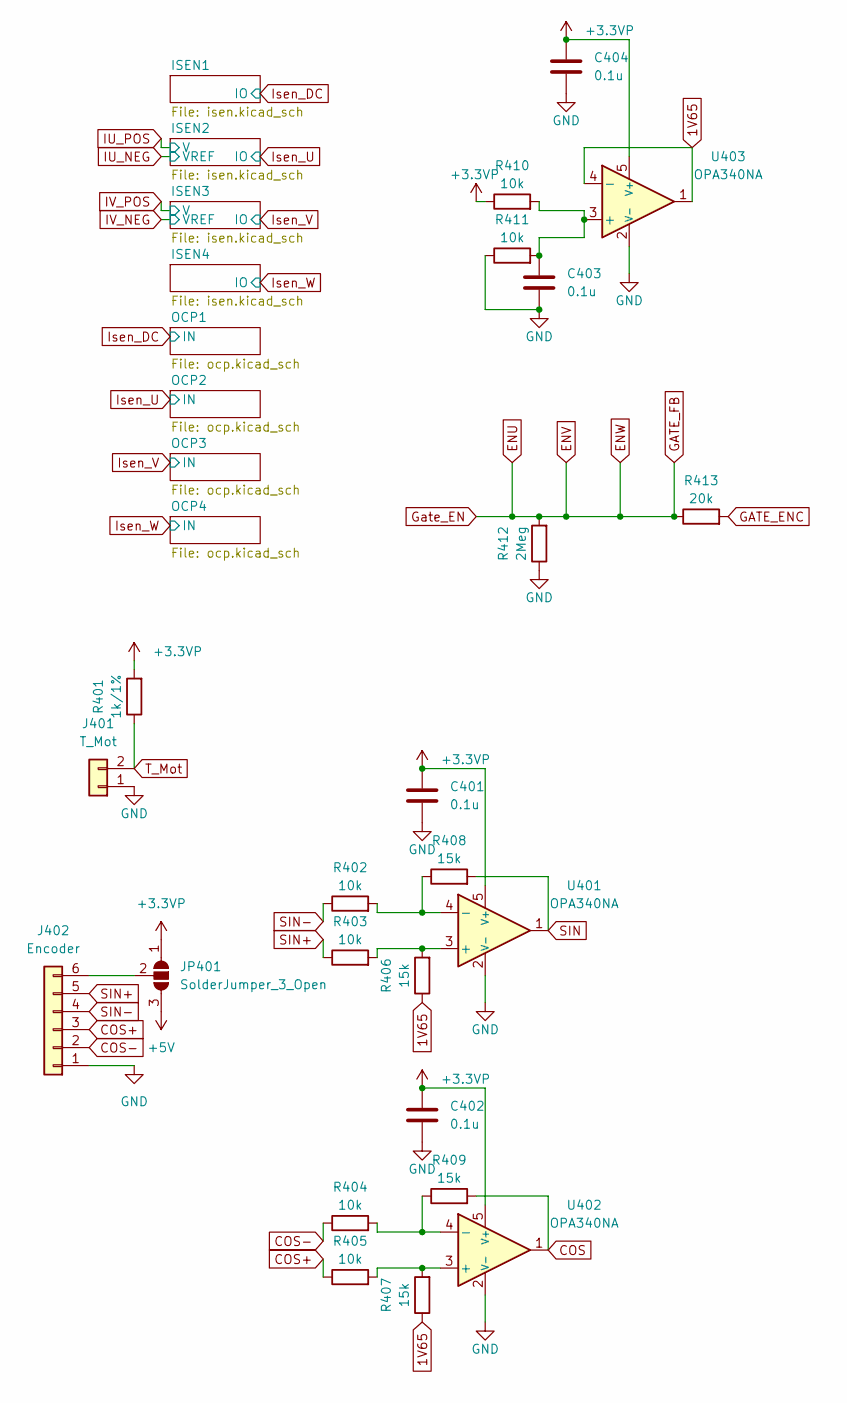
[picture p205: schematic CSOC.kicad_sch]

Parts:
C401, C402, C403, C404: 0.1u; C_0603_1608Metric
J401: T_Mot; JST_XH_B2B-XH-A_1x02_P2.50mm_Vertical
J402: Encoder; JST_XH_B6B-XH-A_1x06_P2.50mm_Vertical
JP401: SolderJumper_3_Open; SolderJumper-3_P1.3mm_Open_Pad1.0x1.5mm
R401: 1k/1%; R_0603_1608Metric
R402, R403, R404, R405, R410, R411: 10k; R_0603_1608Metric
R406, R407, R408, R409: 15k; R_0603_1608Metric
R412: 2Meg; R_0603_1608Metric
R413: 20k; R_0603_1608Metric
U401, U402, U403: OPA340NA; SOT-23-5

Connections:
1V65: R406.1, R407.1, U403.1, U403.4 (-)
+3.3VP: C401.2, C402.2, C404.2, JP401.1 (A), R401.2, R410.1, U401.5 (V+), U402.5 (V+), U403.5 (V+)
+5V: JP401.3 (B)
COS: R409.2, U402.1
COS+: J402.3, R405.1
COS-: J402.2, R404.1
ENU: R412.2, R413.1
GATE_ENC: R413.2
GND: C401.1, C402.1, C403.1, C404.1, J401.1, J402.1, R411.1, R412.1, U401.2 (V-), U402.2 (V-), U403.2 (V-)
unnamed: C403.2, R410.2, R411.2, U403.3 (+)
unnamed: J402.6, JP401.2 (C)
unnamed: R402.2, R408.1, U401.4 (-)
unnamed: R403.2, R406.2, U401.3 (+)
unnamed: R404.2, R409.1, U402.4 (-)
unnamed: R405.2, R407.2, U402.3 (+)
SIN: R408.2, U401.1
SIN+: J402.5, R403.1
SIN-: J402.4, R402.1
T_Mot: J401.2, R401.1
