NTURacingTeam/nturt_kicad/EP5/Powertrain/Inverter/InverterMainBoard_STM32/Power.kicad_sch

## KiCad design EP5/Powertrain/Inverter/InverterMainBoard_STM32/Power.kicad_sch (2024-11-21)

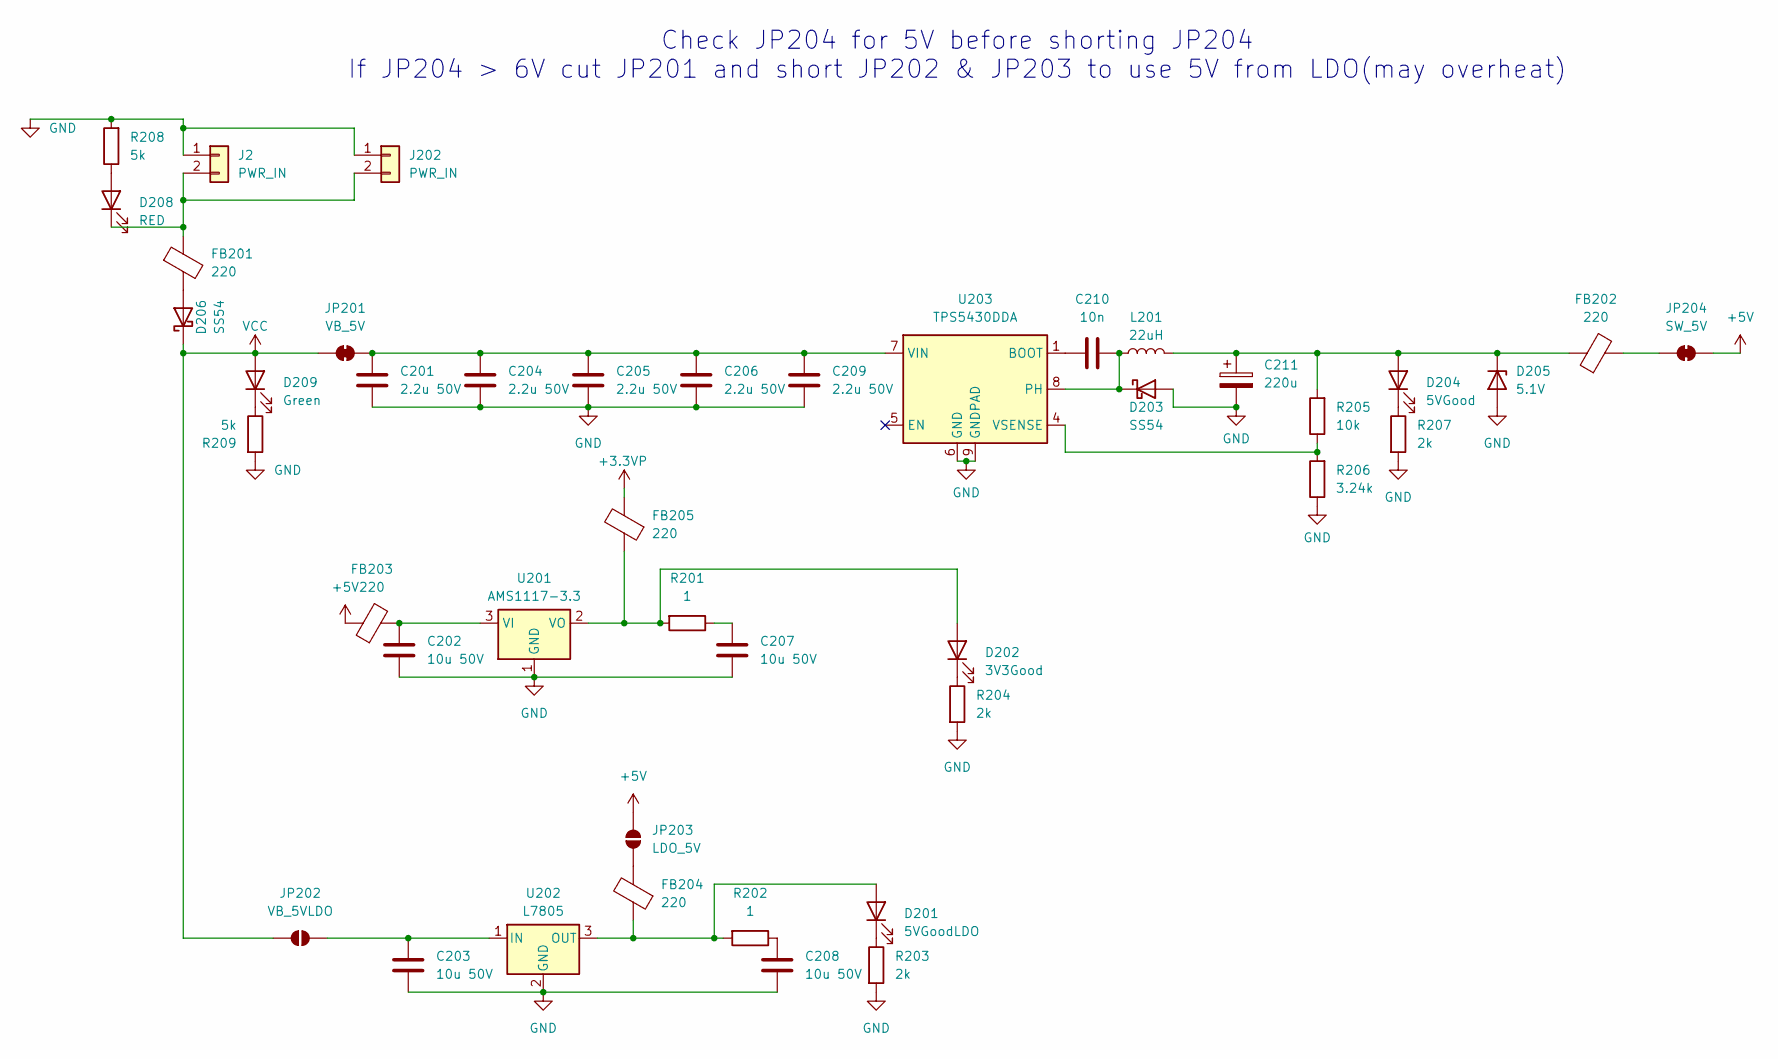
[picture p206: schematic Power.kicad_sch]

Parts:
C201, C204, C205, C206, C209: 2.2u 50V; C_0805_2012Metric
C202, C203, C207, C208: 10u 50V; C_1206_3216Metric
C210: 10n; C_0603_1608Metric
C211: 220u; CP_Elec_8x10.5
D201: 5VGoodLDO; LED_0603_1608Metric
D202: 3V3Good; LED_0603_1608Metric
D203, D206: SS54; D_SMA
D204: 5VGood; LED_0603_1608Metric
D205: 5.1V; D_SOD-123
D208: RED; LED_0603_1608Metric
D209: Green; LED_0603_1608Metric
FB201, FB202, FB203, FB204, FB205: 220; R_0603_1608Metric
J2, J202: PWR_IN; JST_XH_B2B-XH-A_1x02_P2.50mm_Vertical
JP201: VB_5V; SolderJumper-2_P1.3mm_Bridged_Pad1.0x1.5mm
JP202: VB_5VLDO; SolderJumper-2_P1.3mm_Open_Pad1.0x1.5mm
JP203: LDO_5V; SolderJumper-2_P1.3mm_Open_Pad1.0x1.5mm
JP204: SW_5V; SolderJumper-2_P1.3mm_Open_Pad1.0x1.5mm
L201: 22uH; L_Bourns_SRR1260
R201, R202: 1; R_1206_3216Metric
R203, R204, R207: 2k; R_0603_1608Metric
R205: 10k; R_0603_1608Metric
R206: 3.24k; R_0603_1608Metric
R208, R209: 5k; R_0603_1608Metric
U201: AMS1117-3.3; SOT-223-3_TabPin2
U202: L7805; TO-252-2
U203: TPS5430DDA; TI_SO-PowerPAD-8_ThermalVias

Connections:
+3.3VP: FB205.2
+5V: FB203.1, JP203.2 (B), JP204.2 (B)
GND: C201.2, C202.2, C203.2, C204.2, C205.2, C206.2, C207.2, C208.2, C209.2, C211.2, D203.2 (A), D205.2 (A), J2.1, J202.1, R203.2, R204.2, R206.1, R207.2, R208.2, R209.2, U201.1 (GND), U202.2 (GND), U203.6 (GND), U203.9 (GNDPAD)
unnamed: C201.1, C204.1, C205.1, C206.1, C209.1, JP201.2 (B), U203.7 (VIN)
unnamed: C202.1, FB203.2, U201.3 (VI)
unnamed: C203.1, JP202.2 (B), U202.1 (IN)
unnamed: C207.1, R201.1
unnamed: C208.1, R202.1
unnamed: C210.1, U203.1 (BOOT)
unnamed: C210.2, D203.1 (K), L201.1, U203.8 (PH)
unnamed: C211.1, D204.2 (A), D205.1 (K), FB202.1, L201.2, R205.2
unnamed: D201.1 (K), R203.1
unnamed: D201.2 (A), FB204.1, R202.2, U202.3 (OUT)
unnamed: D202.1 (K), R204.1
unnamed: D202.2 (A), FB205.1, R201.2, U201.2 (VO)
unnamed: D204.1 (K), R207.1
unnamed: D206.2 (A), FB201.2
unnamed: D208.1 (K), FB201.1, J2.2, J202.2
unnamed: D208.2 (A), R208.1
unnamed: D209.1 (K), R209.1
unnamed: FB202.2, JP204.1 (A)
unnamed: FB204.2, JP203.1 (A)
unnamed: R205.1, R206.2, U203.4 (VSENSE)
VCC: D206.1 (K), D209.2 (A), JP201.1 (A), JP202.1 (A)

Notes on the sheet:
Check JP204 for 5V before shorting JP204 If JP204 > 6V cut JP201 and short JP202 & JP203 to use 5V from LDO(may overheat)
