NTURacingTeam/nturt_kicad/EP5/Powertrain/Inverter/InverterMainBoard_STM32/mcu.kicad_sch

## KiCad design EP5/Powertrain/Inverter/InverterMainBoard_STM32/mcu.kicad_sch (2024-11-21)


Parts:
C301: 330n; C_0603_1608Metric
C302, C303, C317, C318, C319, C320, C321, C322, C323, C324, C325, C326: 0.1u; C_0603_1608Metric
C304, C308, C309, C310, C311, C312, C313: 1u 10V; C_0603_1608Metric
C305: 100n 16V; C_0603_1608Metric
C306, C307: 15p; C_0603_1608Metric
C314, C315: 10u 10V; C_0603_1608Metric
C316: 0.1u; C_0603_1608Metric; not fitted
C327, C328: 4.7u; C_0603_1608Metric
C329: 0.47u; C_0603_1608Metric
D301, D302: LED; LED_0603_1608Metric
FB301, FB302: 220; R_0603_1608Metric
IC301: TMC4671-LA; QFN40P1050X650X90-77N; Mouser Part Number 700-TMC4671-LA
J301, J302: CAN; JST_XH_B2B-XH-A_1x02_P2.50mm_Vertical
J303, J305, J306: Conn_01x04; PinHeader_1x04_P2.54mm_Vertical
J304: FX26-30P-1SV; FX2630P1SV; Mouser Part Number 798-FX2630P1SV
JP301: TMC_3V3; SolderJumper-2_P1.3mm_Open_Pad1.0x1.5mm
JP302: TMC_5V; SolderJumper-2_P1.3mm_Open_Pad1.0x1.5mm
L301: 500u; L_Changjiang_FNR4030S
R301: 120; R_0603_1608Metric
R302, R303, R304, R306, R308, R310: 10k; R_0603_1608Metric
R305, R307, R309, R311: 20k; R_0603_1608Metric
R312, R313: 1k; R_0603_1608Metric
SW301: RESET; SW_Push_1P1T_XKB_TS-1187A
TP301: UH; TestPoint_Pad_D1.0mm
TP302: VH; TestPoint_Pad_D1.0mm
TP303: WH; TestPoint_Pad_D1.0mm
TP304: UL; TestPoint_Pad_D1.0mm
TP305: VL; TestPoint_Pad_D1.0mm
TP306: WL; TestPoint_Pad_D1.0mm
TP307: GND; TestPoint_Loop_D1.80mm_Drill1.0mm_Beaded
TP308: SPI_SCK; TestPoint_Pad_D1.0mm
TP309: SPI_MISO; TestPoint_Pad_D1.0mm
TP310: SPI_MOSI; TestPoint_Pad_D1.0mm
TP311: SPI_NCSC; TestPoint_Pad_D1.0mm
TP312: SPI_GND; TestPoint_Pad_D1.0mm
TP313: CAN_RX; TestPoint_Pad_D1.0mm
TP314: CAN_TX; TestPoint_Pad_D1.0mm
U301: NCS1S2405SC; Converter_DCDC_Murata_NCS1SxxxxSC_THT
U302: ISO1044BD; SOIC-8_3.9x4.9mm_P1.27mm
U303: CAT24C256; SOIC-8_3.9x4.9mm_P1.27mm
U304: STM32G474RETx; LQFP-64_10x10mm_P0.5mm
X301: TXC-7C; Oscillator_SMD_TXC_7C-4Pin_5.0x3.2mm
Y301: 25M; Crystal_SMD_3225-4Pin_3.2x2.5mm

Connections:
25MHz: IC301.51 (CLK), U304.42 (PA8), X301.3 (OUT)
+3.3VP: C302.2, C304.1, C308.1, C309.1, C310.1, C311.1, C312.1, C313.1, C314.1, C315.1, J303.1, J304.1, J304.2, J305.1, J306.1, JP301.2 (B), R302.2, R303.2, U302.1 (VCC1), U303.8 (VCC), U304.1 (VBAT), U304.16 (VDD), U304.28 (VREF+), U304.29 (VDDA), U304.32 (VDD), U304.48 (VDD), U304.64 (VDD), X301.4 (Vdd)
+5V: J304.5, J304.6, JP302.2 (B)
CANFN: C316.1, FB302.1, J301.2, J302.2, R301.2
CANFP: C316.2, FB301.2, J301.1, J302.1, R301.1
CANN: FB302.2, U302.5 (CANL)
CANP: FB301.1, U302.6 (CANH)
CAN_RX: TP313.1, U302.3 (RXD), U304.45 (PA11)
CAN_TX: TP314.1, U302.2 (TXD), U304.46 (PA12)
COS: U304.13 (PA1)
COS+: IC301.29 (AENC_WY_POS), R308.2
COS+3V3: R308.1, R309.1, U304.10 (PC2)
COS-: IC301.30 (AENC_WY_NEG), R310.2
COS-3V3: R310.1, R311.1, U304.11 (PC3)
ENU: J304.20
FLTN: J304.16, U304.52 (PC10)
GATE_ENC: U304.54 (PC12)
GATE_FB: U304.53 (PC11)
GND: C301.2, C302.1, C304.2, C305.1, C306.1, C307.1, C308.2, C309.2, C310.2, C311.2, C312.2, C313.2, C314.2, C315.2, C317.1, C318.1, C319.1, C320.1, C321.2, C322.1, C323.1, C324.2, C325.1, C326.2, C327.1, C328.1, C329.1, IC301.3 (GNDIO1), IC301.14 (GNDIO2), IC301.24 (GNDA), IC301.44 (GNDIO3), IC301.53 (GNDIO4), IC301.54 (TEST), IC301.62 (GNDIO5), IC301.73 (GNDIO6), IC301.77 (GND), J303.4, J304.3, J304.4, J304.7, J304.8, J304.13, J304.14, J304.MP1, J304.MP2, J304.MP3, J304.MP4, J305.4, J306.4, R305.2, R307.2, R309.2, R311.2, R312.2, R313.2, SW301.1, TP307.1, TP312.1, U301.1 (-VIN), U302.4 (GND1), U303.1 (A0), U303.2 (A1), U303.3 (A2), U303.4 (GND), U303.7 (WP), U304.15 (VSS), U304.27 (VSSA), U304.31 (VSS), U304.47 (VSS), U304.63 (VSS), X301.2 (GND), Y301.2, Y301.4
I2C_SCL: R303.1, U303.6 (SCL), U304.40 (PC8)
I2C_SDA: R302.1, U303.5 (SDA), U304.41 (PC9)
IU_NEG: IC301.17 (ADC_I0_NEG)
IU_POS: IC301.16 (ADC_I0_POS)
IV_NEG: IC301.19 (ADC_I1_NEG)
IV_POS: IC301.18 (ADC_I1_POS)
Isen_DC: U304.25 (PB1)
Isen_U: U304.33 (PB11)
Isen_V: U304.22 (PC4)
Isen_W: U304.23 (PC5)
NRF_NCS: U304.60 (PB7)
unnamed: C301.1, L301.2, U301.2 (+VIN)
unnamed: C303.1, U301.6 (+VOUT), U302.8 (VCC2)
unnamed: C303.2, U301.7 (-VOUT), U302.7 (GND2)
unnamed: C306.2, U304.5 (PF0), Y301.3
unnamed: C307.2, U304.6 (PF1), Y301.1
unnamed: C321.1, IC301.45 (VCCCORE2)
unnamed: C324.1, IC301.15 (VCCCORE1)
unnamed: C325.2, C327.2, IC301.23 (V5), JP302.1 (A)
unnamed: C326.1, IC301.63 (VCCCORE3)
unnamed: D301.1 (K), R312.1
unnamed: D301.2 (A), U304.38 (PC6)
unnamed: D302.1 (K), R313.1
unnamed: D302.2 (A), U304.39 (PC7)
RDY: J304.18, U304.51 (PA15)
SIN: U304.12 (PA0)
SIN+: IC301.25 (AENC_UX_POS), R304.2
SIN+3V3: R304.1, R305.1, U304.8 (PC0)
SIN-: IC301.26 (AENC_UX_NEG), R306.2
SIN-3V3: R306.1, R307.1, U304.9 (PC1)
SPI_MISO: IC301.9 (SPI_MISO), TP309.1, U304.36 (PB14)
SPI_MOSI: IC301.8 (SPI_MOSI), TP310.1, U304.37 (PB15)
SPI_NSCS: IC301.6 (SPI_NSCS), TP311.1, U304.4 (PC15)
SPI_SCK: IC301.7 (SPI_SCK), TP308.1, U304.35 (PB13)
SWD_RSTN: C305.2, SW301.2, U304.7 (PG10)
SWD_SWCLK: J303.3, U304.50 (PA14)
SWD_SWDIO: J303.2, U304.49 (PA13)
TMC_EN: IC301.55 (ENI), U304.3 (PC14)
TMC_RST: IC301.50 (NRST), U304.2 (PC13)
TMC_RX: IC301.10 (UART_RXD), J306.3
TMC_STATUS: IC301.12 (STATUS), U304.30 (PB10)
TMC_TX: IC301.11 (UART_TXD), J306.2
T_Mot: U304.19 (PA5)
T_U: J304.17, U304.20 (PA6)
T_V: J304.15, U304.21 (PA7)
T_W: J304.30, U304.26 (PB2)
UART1_RX: J305.3, U304.44 (PA10)
UART1_TX: J305.2, U304.43 (PA9)
UH: IC301.39 (PWM_UX1_H), J304.25, TP301.1, U304.59 (PB6)
UL: IC301.40 (PWM_UX1_L), J304.23, TP304.1, U304.56 (PB3)
VCC: J304.9, J304.10, J304.11, J304.12, L301.1
VCCIO: C317.2, C318.2, C319.2, C320.2, C322.2, C323.2, C328.2, C329.2, IC301.2 (VCCIO1), IC301.13 (VCCIO2), IC301.43 (VCCIO3), IC301.52 (VCCIO4), IC301.61 (VCCIO5), IC301.72 (VCCIO6), JP301.1 (A)
VH: IC301.41 (PWM_VX2_H), J304.27, TP302.1, U304.61 (PB8)
VL: IC301.42 (PWM_VX2_L), J304.21, TP305.1, U304.57 (PB4)
Vsen_DC: J304.28, U304.14 (PA2)
Vsen_U: J304.26, U304.17 (PA3)
Vsen_V: J304.24, U304.34 (PB12)
Vsen_W: J304.22, U304.24 (PB0)
WH: IC301.46 (PWM_WY1_H), J304.29, TP303.1, U304.62 (PB9)
WL: IC301.47 (PWM_WY1_L), J304.19, TP306.1, U304.58 (PB5)
