NTURacingTeam/nturt_kicad/(commit log)

2023-08-07 add precharge
    lagacy
    [PreCharge.kicad_pcb, PreCharge.kicad_sch]
2023-08-07 add sc board
    legacy
    [BSPD.kicad_pcb, BSPD.kicad_sch, IMD.kicad_pcb, IMD.kicad_sch, Latch_Circuit.kicad_sch, Relay.kicad_sch, SC_Board_EP4O_V2_20230615.kicad_pcb, SC_Board_EP4O_V2_20230615.kicad_sch]
2023-08-07 add HV box
    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
    [DC_TSMP_V1_20230304.kicad_pcb, DC_TSMP_V1_20230304.kicad_sch, Discharge.kicad_pcb, Discharge.kicad_sch, HV_DCDC_TSAL_Board_V2_20230311.kicad_pcb, HV_DCDC_TSAL_Board_V2_20230311.kicad_sch, Power_Section.kicad_sch, TSAL.kicad_sch]
2023-08-07 add charger boards
    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
    [Charger_HV_Board_V2_20220827.kicad_pcb, Charger_HV_Board_V2_20220827.kicad_sch, Charger_SC_Board_V2_20220827.kicad_pcb, Charger_SC_Board_V2_20220827.kicad_sch, Latch_Circuit.kicad_sch, Relay.kicad_sch]
2023-08-07 add front box nucleo
    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
    [electronics.kicad_sch, frontbox_nucleo.kicad_pcb, frontbox_nucleo.kicad_sch]
2023-08-07 add rearbox
    legacy from easyEDA
    [rearbox_nucleo.kicad_pcb, rearbox_nucleo.kicad_sch]
2023-08-07 move rearbox nucleo
    [rearbox_nucleo.kicad_pcb, rearbox_nucleo.kicad_sch]
2023-08-08 add mounting hole to rearbox nucleo
    [rearbox_nucleo.kicad_pcb, rearbox_nucleo.kicad_sch]
2023-08-08 use online library for frontbox
    replaced: TEN_40-2411WIE, CTM1051AM
    [electronics.kicad_sch, frontbox_nucleo.kicad_pcb, frontbox_nucleo.kicad_sch]
2023-08-08 apply net class on frontbox
    power class with 5 mm track width for +5V and VCC
    [electronics.kicad_sch, frontbox_nucleo.kicad_pcb]
2023-08-13 add frontbox nucleo
    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
    [componets.kicad_sch, frontbox_nucleo_ex.kicad_pcb, frontbox_nucleo_ex.kicad_sch]
2023-08-13 rename components schematic sheet
    [components.kicad_sch, frontbox_nucleo_ex.kicad_pcb, frontbox_nucleo_ex.kicad_sch]
2023-08-13 frontbox unused opamp update
    [electronics.kicad_sch, frontbox_nucleo.kicad_pcb]
2023-08-13 in frontbox nucleo use wider track on gnd
    [frontbox_nucleo.kicad_pcb, frontbox_nucleo.kicad_sch]
2023-11-01 add EP5 7-segment testing for electrical group
    7 segment for dashboard
    [NTUR 7-segment testing.kicad_pcb, NTUR 7-segment testing.kicad_sch]
2023-11-16 middle board for driverless car
    [driverless_car.kicad_pcb, driverless_car.kicad_sch]
2023-11-17 driverless car middle board v2 exported GBR, PDF
    [driverless_car.kicad_pcb, driverless_car.kicad_sch]
2023-11-27 Add files via upload
    add rearbox's schematic
    [electronics.kicad_sch, rearbox_nucleo.kicad_sch]
2023-11-27 Update and rename EP5/Electrical Group/NTUR 7-segment testing/electronics.kicad_sch to EP5/Electrical Group/NTUR 7-segment testing/rearbox/electronics.kicad_sch
    move the file
    [electronics.kicad_sch]
2023-11-27 Update and rename EP5/Electrical Group/NTUR 7-segment testing/rearbox_nucleo.kicad_sch to EP5/Electrical Group/NTUR 7-segment testing/rearbox/rearbox_nucleo.kicad_sch
    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
    [rearbox_nucleo.kicad_sch]
2023-11-28 update driverless car mid board 23/11/22 rev3
    [driverless_car.kicad_pcb, driverless_car.kicad_sch]
2023-11-28 fix rearbox_nucleo_1 folder location
    and add project library for ep5
    [electronics.kicad_sch, rearbox_nucleo.kicad_sch]
2023-12-07 Add files via upload
    upload schematic
    [electronics.kicad_sch, rearbox_nucleo.kicad_sch]
2023-12-07 comment on rearbox nucleo 1
    [electronics.kicad_sch]
2024-01-01 add 3 boards for dashboard, ver 1 all done
    pdf included
    new library included
    [EP5 dashboard bottom board.kicad_pcb, EP5 dashboard bottom board.kicad_sch, EP5 dashboard middle board.kicad_pcb, EP5 dashboard middle board.kicad_sch, EP5 dashboard top board.kicad_pcb, EP5 dashboard top board.kicad_sch, LEDs.kicad_sch, NTUR 7-segment testing.kicad_pcb]
2024-01-02 add dashboard single board version
    using 4 layer PCB
    use nucleo G431KB
    hope to use raw MC, and not nucleo
    with pdf
    [EP5 dashboard single board.kicad_pcb, EP5 dashboard single board.kicad_sch]
2024-01-07 add dashboard DIYbox board1
    hopefully the final structure (display board in middle, control board at left, button on the lid, connecter at bottom left and right of the box)
    [EP5 dashboard DIYbox board1.kicad_pcb, EP5 dashboard DIYbox board1.kicad_sch]
2024-02-22 update rear box nucleo
    but only connector symbols
    [electronic2.kicad_sch, electronics.kicad_sch, electronics1.kicad_sch, rearbox_nucleo.kicad_pcb, rearbox_nucleo.kicad_sch]
2024-03-03 update rear box nucleo board 1
    this version assume a power board for power stuff only (will be done but not yet done)
    the following are in the updated board: (all Nucleo pins are not asigned yet)
    suspension * 2
    brake light
    buzzer
    CAN (3 connectors)
    power monitor (from power board)
    fan * 2 (hope to move to power board)
    pedal box and steering (connector * 1)
    oil pressure * 2 (connector * 1)
    [electronic2.kicad_sch, electronics1.kicad_sch, rearbox_nucleo.kicad_sch]
2024-03-03 rearbox nucleo 1 minor update on page setup
    [electronic2.kicad_sch, electronics1.kicad_sch, rearbox_nucleo.kicad_sch]
2024-03-03 dashboard update left board to latest design
    left board is DIYbox board 2
    [EP5 dashboard DIYbox board1.kicad_pcb, EP5 dashboard DIYbox board1.kicad_sch, EP5 dashboard DIYbox board2.kicad_pcb, EP5 dashboard DIYbox board2.kicad_sch]
2024-03-08 update rearbox nucleo
    [electronic2.kicad_sch, electronics1.kicad_sch, rearbox_nucleo.kicad_sch]
2024-03-09 1st layout for rearbox nucleo done
    [electronic2.kicad_sch, electronics1.kicad_sch, rearbox_nucleo.kicad_pcb, rearbox_nucleo.kicad_sch]
2024-03-09 update rearbox nucleo 1
    mainly make a plane for GNDPWR
    [electronic2.kicad_sch, electronics1.kicad_sch, rearbox_nucleo.kicad_pcb]
2024-03-10 1st dashboard left board layout done
    [EP5 dashboard DIYbox board1.kicad_sch, EP5 dashboard DIYbox board2.kicad_pcb, EP5 dashboard DIYbox board2.kicad_sch, power.kicad_sch]
2024-03-10 update rearbox nucleo 1 (mainly switch debounce)
    [electronics1.kicad_sch, rearbox_nucleo.kicad_pcb]
2024-03-10 1st dashboard screen board done
    and minor pin modification on dashboard left board
    [EP5 dashboard DIYbox board1.kicad_pcb, EP5 dashboard DIYbox board1.kicad_sch, EP5 dashboard DIYbox board2.kicad_pcb, EP5 dashboard DIYbox board2.kicad_sch]
2024-03-11 huge update on dashboard and rearbox
    dashbard*3
    rearbox*3
    [EP5 dashboard DIYbox board2.kicad_pcb, EP5 dashboard DIYbox board2.kicad_sch, EP5 dashboard DIYbox board3.kicad_pcb, EP5 dashboard DIYbox board3.kicad_sch, electronic2.kicad_sch, electronics1.kicad_sch, power.kicad_sch, rearbox_left_connector.kicad_pcb]
2024-03-11 modify rearbox left connector board for face upwards
    (in order jst connector face upward )
    [rearbox_left_connector.kicad_pcb, rearbox_left_connector.kicad_sch]
2024-03-11 add LVBMS (only OC and UV function)
    [LVBMS.kicad_pcb, LVBMS.kicad_sch]
2024-03-11 add rearbox powerboard (only schematic)
    [24V_circuitry.kicad_sch, isolated.kicad_sch, power board.kicad_pcb, power board.kicad_sch]
2024-03-13 big update
    new power board
    update: LVBMS, dashbaord box connector boards *2
    [24V_circuitry.kicad_sch, EP5 dashboard DIYbox board2.kicad_pcb, EP5 dashboard DIYbox board2.kicad_sch, LVBMS.kicad_pcb, LVBMS.kicad_sch, isolated.kicad_sch, power board.kicad_pcb, power board.kicad_sch]
2024-03-13 minor update on power board
    [isolated.kicad_sch, power board.kicad_pcb]
2024-03-20 update boards in rear box after Tsou's review
    [24V_circuitry.kicad_sch, EP5 dashboard DIYbox board2.kicad_pcb, EP5 dashboard DIYbox board2.kicad_sch, LVBMS.kicad_pcb, LVBMS.kicad_sch, electronic2.kicad_sch, electronics1.kicad_sch, isolated.kicad_sch]
2024-03-20 update dashboard boards after Tsou's review
    [EP5 dashboard DIYbox board1.kicad_pcb, EP5 dashboard DIYbox board2.kicad_pcb, EP5 dashboard DIYbox board2.kicad_sch, EP5 dashboard DIYbox board3.kicad_pcb, EP5 dashboard DIYbox board3.kicad_sch, power.kicad_sch]
2024-03-21 update all boards after Tsou's second review
    [24V_circuitry.kicad_sch, EP5 dashboard DIYbox board1.kicad_pcb, EP5 dashboard DIYbox board1.kicad_sch, EP5 dashboard DIYbox board2.kicad_pcb, EP5 dashboard DIYbox board2.kicad_sch, EP5 dashboard DIYbox board3.kicad_pcb, EP5 dashboard DIYbox board3.kicad_sch, LVBMS.kicad_pcb]
2024-03-21 update LVBMS for spaces
    [LVBMS.kicad_pcb, LVBMS.kicad_sch]
2024-03-22 update rearbox nucleo hat for RPI CAN
    [electronics1.kicad_sch, rearbox_nucleo_1.kicad_pcb]
2024-03-22 update rearbox nucleo hat for improved silkscreen label
    [rearbox_nucleo_1.kicad_pcb]
2024-03-22 update power board for improved F silkscreen
    [power board.kicad_pcb]
2024-03-22 update LVBMS for better unused pin configuration
    and better silkscreen layout
    [LVBMS.kicad_pcb, LVBMS.kicad_sch]
2024-04-08 update dashboard board2 and power board
    [24V_circuitry.kicad_sch, EP5 dashboard DIYbox board2.kicad_pcb, EP5 dashboard DIYbox board2.kicad_sch, isolated.kicad_sch]
2024-06-24 add several parts to EP5 library samacSys
    CR1220 battery holder
    LMR66430R5RXBR
    MSD4A
    SOP65P640X120
    TO254P469X1042X1930
2024-06-24 version 2 for rearbox nucleo 1
    abandon power isolation
    use bulk head connectors instead of JST XH
    add sd card
    add 7segment * 2
    etc.
    [electronic2.kicad_sch, electronic3.kicad_sch, electronics1.kicad_sch, power.kicad_sch, rearbox_nucleo_1.kicad_pcb, rearbox_nucleo_1.kicad_sch]
2024-07-04 CANbus connector board V1.0
    mainly for inverter
    [CANbus_connector_board.kicad_pcb, CANbus_connector_board.kicad_sch]
2024-07-04 update dashboard board 3 to V2.0 due to box design change
    [EP5 dashboard DIYbox board3.kicad_pcb, EP5 dashboard DIYbox board3.kicad_sch]
2024-07-04 update dashboard board 1 & 2 to V2.0 to cancel isolation and use IDC socket
    [EP5 dashboard DIYbox board1.kicad_pcb, EP5 dashboard DIYbox board1.kicad_sch, EP5 dashboard DIYbox board2.kicad_pcb, EP5 dashboard DIYbox board2.kicad_sch]
2024-07-04 update rearbox Nucleo hat to V2.0 to cancel isolation and use IDC socket
    [electronic2.kicad_sch, electronic3.kicad_sch, electronics1.kicad_sch, power.kicad_sch, rearbox_nucleo_1.kicad_pcb, rearbox_nucleo_1.kicad_sch]
2024-07-04 update rearbox connector boards to V2.0 to match nucleo hat V2.0
    [rearbox_left_connector.kicad_pcb, rearbox_left_connector.kicad_sch, rearbox_rear_connector.kicad_pcb, rearbox_rear_connector.kicad_sch]
2024-07-04 update rearbox power board to V2.0 to cancel isolation
    [24V_circuitry.kicad_sch, MCU.kicad_sch, inbox.kicad_sch, isolated.kicad_sch, outbox.kicad_sch, power board.kicad_pcb, power board.kicad_sch, power.kicad_sch]
2024-07-04 update LVBMS to V2.0, more connectors
    [LVBMS.kicad_pcb, LVBMS.kicad_sch]
2024-07-04 fixup! update dashboard board 1 & 2 to V2.0 to cancel isolation and use IDC socket
    [power.kicad_sch]
2024-07-04 update Rpi hat V1.0
    included function
    RTC
    CAN
    2 IMUs
    some buttons and indicators from GPIO
    [GPIOs.kicad_sch, RpiHat.kicad_pcb, RpiHat.kicad_sch, power.kicad_sch]
2024-07-04 start making DIY IMU
    [DIY_IMU.kicad_pcb, DIY_IMU.kicad_sch, power.kicad_sch, sensor.kicad_sch]
2024-07-21 update LVBMS to V2.1
    fix XT60 reverse
    fix show current should be at ground
    fix lack of labeling
    [LVBMS.kicad_pcb, LVBMS.kicad_sch]
2024-07-21 update dashboard board 1 to v2.1
    fix RTD button light, GND should be 5V, and signal using open drain to control
    [EP5 dashboard DIYbox board1.kicad_pcb, EP5 dashboard DIYbox board1.kicad_sch]
2024-07-21 updated dashboard board 2 to V3.0
    change buck converter
    change CAN transceiver
    skip pins for zephyr VCP shell
    use NRST for one of the buttons
    add some LEDs
    [EP5 dashboard DIYbox board2.kicad_pcb, EP5 dashboard DIYbox board2.kicad_sch, power.kicad_sch]
2024-07-21 update rearbox nucleo hat to V3.0
    add fuses and Zener diodes
    change power supply of brake light
    change MOSFET for buzzer and brake light control
    add test pads
    add LEDs
    fix SD card pin
    fix VBAT reveresed
    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
    [electronic2.kicad_sch, electronic3.kicad_sch, electronics1.kicad_sch, power.kicad_sch, rearbox_nucleo_1.kicad_pcb, rearbox_nucleo_1.kicad_sch]
2024-07-21 update rear box left connector to v2.1
    add back up connectors
    fix pinout of connector to front box (match the pinout with that of front box, making them interchangeable)
    [rearbox_left_connector.kicad_pcb, rearbox_left_connector.kicad_sch]
2024-07-22 update rearbox nucleo hat to V3.1
    use buck converter as current source and rather than voltage source
    add 24v voltage and current measurement
    [electronic2.kicad_sch, electronics1.kicad_sch, power.kicad_sch, rearbox_nucleo_1.kicad_pcb, rearbox_nucleo_1.kicad_sch]
2024-07-26 update dashboard board 2 for kicad 8
    [EP5 dashboard DIYbox board2.kicad_pcb, EP5 dashboard DIYbox board2.kicad_sch, power.kicad_sch]
2024-07-26 update power board for kicad8
    [EMI.kicad_sch, electrical1.kicad_sch, electrical2.kicad_sch, outbox.kicad_sch, power board.kicad_sch, power.kicad_sch]
2024-07-26 update rearbox nucleo hat for kicad 8
    [electronic2.kicad_sch, electronic3.kicad_sch, electronics1.kicad_sch, power.kicad_sch, rearbox_nucleo_1.kicad_pcb, rearbox_nucleo_1.kicad_sch]
2024-07-26 update LVBMS for kicad 8 and v 2.1
    [LVBMS.kicad_pcb, LVBMS.kicad_sch]
2024-08-05 update dashboard board 2 to v3.0 again
    [EP5 dashboard DIYbox board2.kicad_pcb, EP5 dashboard DIYbox board2.kicad_sch, power.kicad_sch]
2024-08-07 update dashboard 2 to V4.0
    using stm32H56RG
    use JTAG
    use USB for DFU
    ignore front wheel speed hall sensor
    [EP5 dashboard DIYbox board2.kicad_pcb, EP5 dashboard DIYbox board2.kicad_sch, peripherals.kicad_sch, power.kicad_sch]
2024-08-07 update LVBMS to V2.1
    mainly update show current connector to ground
    [LVBMS.kicad_pcb, LVBMS.kicad_sch]
2024-08-07 update rearbox nucleo hat to V3.0
    big update
    use SMPS current control mode for brake light
    lots of power OC,OV protection
    new SMPS for easier soldering
    TCAN1057
    power monitor
    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
    [electronic2.kicad_sch, electronic3.kicad_sch, electronics1.kicad_sch, power.kicad_sch, rearbox_nucleo_1.kicad_pcb, rearbox_nucleo_1.kicad_sch]
2024-08-07 add new board (for rear box VCU+power board)
    use STM32H562VG
    [24V_circuitry.kicad_sch, 5V_3V3.kicad_sch, EMI.kicad_sch, IMU.kicad_sch, MCU.kicad_sch, electrical1.kicad_sch, electrical2.kicad_sch, electrical3.kicad_sch]
2024-08-07 update dashboard board 2 (screen) to V2.2
    fix I2C pinout to match OLED module
    change RTD light to open drain version
    [EP5 dashboard DIYbox board1.kicad_pcb, EP5 dashboard DIYbox board1.kicad_sch]
2024-10-12 add rearbox_VCUandPower to EP5
    [5V_3V3.kicad_sch, IMU.kicad_sch, electrical1.kicad_sch, electrical2.kicad_sch, electrical3.kicad_sch, power.kicad_sch, rearbox_VCUandPower.kicad_pcb, rearbox_VCUandPower.kicad_sch]
2024-10-12 add rearbox_nucleo_1_V3.0bak to EP5
    [electronic2.kicad_sch, electronic3.kicad_sch, electronics1.kicad_sch, power.kicad_sch, rearbox_nucleo_1_V3.0bak.kicad_pcb, rearbox_nucleo_1_V3.0bak.kicad_sch]
2024-10-12 update rearbox_nucleo_1 to V3.2 in EP5
    [electronic2.kicad_sch, electronic3.kicad_sch, electronics1.kicad_sch, power.kicad_sch, rearbox_nucleo_1.kicad_pcb, rearbox_nucleo_1.kicad_sch]
2024-10-12 update rearbox_left_connector to V2.2 in EP5
    [rearbox_left_connector.kicad_pcb, rearbox_left_connector.kicad_sch]
2024-10-12 update LVBMS to V2.1
    [LVBMS.kicad_pcb, LVBMS.kicad_sch]
2024-10-12 update dashboard 2 to V4.0 in EP5
    this is a version using stm32H562
    previously only use nucleo G431
    [EP5 dashboard DIYbox board2.kicad_pcb, EP5 dashboard DIYbox board2.kicad_sch, peripherals.kicad_sch, power.kicad_sch]
2024-10-12 create dashboard 2 V3 (backup) for EP5
    [EP5 dashboard DIYbox board2.kicad_pcb, EP5 dashboard DIYbox board2.kicad_sch, power.kicad_sch]
2024-10-12 update dashboard 1 to V2.3 in EP5
    [EP5 dashboard DIYbox board1.kicad_pcb, EP5 dashboard DIYbox board1.kicad_sch]
2024-10-12 create VCU in EP6
    [24V_circuitry.kicad_sch, 5V_3V3.kicad_sch, EMI.kicad_sch, IMU.kicad_sch, MCU.kicad_sch, VCU.kicad_pcb, VCU.kicad_sch, button.kicad_sch]
2024-10-12 create Potentiometer2Current in EP6
    [Potentiometer2Current.kicad_pcb, Potentiometer2Current.kicad_sch]
2024-10-12 create APPS_ROT_POT_onboard in EP6
    [APPS_ROT_POT_onboard.kicad_pcb, APPS_ROT_POT_onboard.kicad_sch]
2024-10-12 create Potentiometer2Current_XTR11x in EP6
    [Potentiometer2Current_XTR11x.kicad_pcb, Potentiometer2Current_XTR11x.kicad_sch]
2024-10-12 create APPS_ROT_POT_onboard_XTR11x in EP6
    [APPS_ROT_POT_onboard_XTR11x.kicad_pcb, APPS_ROT_POT_onboard_XTR11x.kicad_sch]
2024-10-12 create IMU_DIY in EP6
    [5V_3V3.kicad_sch, IMU.kicad_sch, IMU_DIY.kicad_pcb, IMU_DIY.kicad_sch, electrical1.kicad_sch, power.kicad_sch]
2024-10-12 create 6s_BMS in EP6
    [6S_BMS.kicad_pcb, 6S_BMS.kicad_sch, LV_Power.kicad_sch, MCU.kicad_sch, input.kicad_sch, power.kicad_sch]
2024-10-13 update 6S_BMS schematic draft in EP6
    [6S_BMS.kicad_sch, D_ideal.kicad_sch, MCU.kicad_sch, balancing.kicad_sch, balancingNode.kicad_sch]
2024-10-14 update 6S_BMS schematic, for FET and Balancing
    use highside FET for charge and discharge switch
    and use chip for balance rather than MCU
    [6S_BMS.kicad_sch, D_ideal.kicad_sch, MCU.kicad_sch, balancing.kicad_sch, balancingNode.kicad_sch]
2024-10-15 update 6S_BMS schematic and a little layout
    [6S_BMS.kicad_pcb, 6S_BMS.kicad_sch, AFE.kicad_sch, D_ideal.kicad_sch, MCU.kicad_sch, balancing.kicad_sch, balancingNode.kicad_sch]
2024-10-24 create and update HVB_LV1 to V1.0 for EP6 powertrain
    detailed silkscreen labeling awaiting
    layout adjustment awaiting
    [AboveLight.kicad_sch, BSPD.kicad_sch, HVB_LV1.kicad_pcb, HVB_LV1.kicad_sch, Latch.kicad_sch, buck.kicad_sch, power.kicad_sch, pulse.kicad_sch]
2024-10-24 create & update HVB_HVLV_1 to V1.0 for EP6 powertrain
    mostly finished
    board review awaiting
    [HVB_HVLV_1.kicad_pcb, HVB_HVLV_1.kicad_sch]
2024-10-24 add 4 SVGs to EP6
    Galexy logo * 2
    high voltage * 1
    NTURacing logo * 1
2024-10-25 6S BMS sch cleanup
    [6S_BMS.kicad_sch, AFE.kicad_sch, MCU.kicad_sch, balance_node_1.kicad_sch, cell_afe.kicad_sch, ext_ideal_diode.kicad_sch]
2024-10-25 fix library
    [6S_BMS.kicad_sch, MCU.kicad_sch]
2024-10-25 fix net ties
    [6S_BMS.kicad_sch, MCU.kicad_sch, balance_node_1.kicad_sch, cell_afe.kicad_sch, ext_ideal_diode.kicad_sch]
2024-10-25 added nickel tabs footprint, assigned footprints
    [6S_BMS.kicad_pcb, 6S_BMS.kicad_sch, MCU.kicad_sch, cell_afe.kicad_sch, ext_ideal_diode.kicad_sch]
2024-10-25 added 3d model for cell pack and xt60pw connectors
    [6S_BMS.kicad_pcb, XT60PW_FEMALE.STEP, XT60PW_MALE.STEP]
2024-10-26 6S BMS swapped ideal diode chip
    [ext_ideal_diode.kicad_sch]
2024-10-26 front panel board connectors
    [6S_BMS.kicad_pcb, 6S_BMS.kicad_sch, B2PS-VH.stp, MCU.kicad_sch, balance_node_1.kicad_sch, cell_afe.kicad_sch, ext_ideal_diode.kicad_sch, psu.kicad_sch]
2024-10-27 fix net ties and net classes
    [6S_BMS.kicad_pcb, 6S_BMS.kicad_sch, MCU.kicad_sch, cell_afe.kicad_sch, psu.kicad_sch]
2024-10-27 switched back to xt60, changed shunt resistor
    [6S_BMS.kicad_pcb, 6S_BMS.kicad_sch, MCU.kicad_sch]
2024-10-27 added hvb front panel
    [6S_BMS.kicad_sch, 6S_Front_Panel.kicad_pcb, 6S_Front_Panel.kicad_sch, B2PS-VH.stp, XT60PW_FEMALE.STEP, XT60PW_MALE.STEP]
2024-10-27 update some EP6 footprint library 3dshape path
2024-10-27 fixed step origin to match footprint
2024-10-27 update 6s front panel
    [6S_Front_Panel.kicad_pcb, 6S_Front_Panel.kicad_sch]
2024-10-30 added level shifter
    [6S_BMS.kicad_sch, 6S_Front_Panel.kicad_sch, MCU.kicad_sch, cell_afe.kicad_sch]
2024-10-31 Board kinda done
    [6S_BMS.kicad_pcb, 6S_BMS.kicad_sch, B2PS-VH.stp, MCU.kicad_sch, XT60PW_FEMALE.STEP, XT60PW_MALE.STEP, cell_afe.kicad_sch, psu.kicad_sch]
2024-11-01 added reset buttons, fix errors
    [6S_BMS.kicad_pcb, MCU.kicad_sch]
2024-11-02 optimized layout, added osc32
    [6S_BMS.kicad_pcb, MCU.kicad_sch]
2024-11-02 add ACC_HVLV1
    initial version of the schematic done
    also update EP6 nturt_kicad_lib symbol for relay
    [ACC_HVLV1.kicad_pcb, ACC_HVLV1.kicad_sch, HVside.kicad_sch]
2024-11-03 edit VCU: add USBHS and adjust IDC connector pinout
    [VCU.kicad_sch, button.kicad_sch, electrical2.kicad_sch, stlink.kicad_sch]
2024-11-04 optimized layout
    [6S_BMS.kicad_pcb, MCU.kicad_sch]
2024-11-05 Fix whitespaces in folder names
    [24V_circuitry.kicad_sch, 5V_3V3.kicad_sch, 6S_BMS.kicad_pcb, 6S_BMS.kicad_sch, 6S_Front_Panel.kicad_pcb, 6S_Front_Panel.kicad_sch, ACC_HVLV1.kicad_pcb, ACC_HVLV1.kicad_sch]
2024-11-05 Updated footprint libraries
2024-11-06 [6S_BMS] updated mosfets, optimized layout
    [6S_BMS.kicad_pcb, MCU.kicad_sch]
2024-11-07 replace MCU with STM32H7431
    [VCU.kicad_sch, button.kicad_sch, debounce.kicad_sch]
2024-11-08 replace parrallel screen with SPI in VCU PCB
    [VCU.kicad_sch, electrical1.kicad_sch, electrical2.kicad_sch, stlink.kicad_sch]
2024-11-10 [6S_BMS] fixed pcb based on review feedback
    [6S_BMS.kicad_pcb, MCU.kicad_sch, psu.kicad_sch]
2024-11-11 upload EP5 powertrain boards from local
    ├───BatteryBox
    │ ├───BMS_MASTER_STM32F103C8
    │ ├───BMS_Slave_V1(ADBMS1818)
    │ ├───Connector_Board
    │ ├───Indicator
    │ └───PreCharge
    ├───HVBox
    │ ├───Connector_Board_HV
    │ ├───DCDC_Control_V1_20230915
    │ ├───DC_V1_20230911
    │ ├───SC_Board
    │ ├───TSAL_LED_V1_20230913
    │ ├───TSAL_V1_20230911
    │ └───TSMP_V1_20230911
    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
    [BMS_MASTER_STM32F103C8.kicad_pcb, BMS_MASTER_STM32F103C8.kicad_sch, BMS_Slave_V1(ADBMS1818).kicad_pcb, BMS_Slave_V1(ADBMS1818).kicad_sch, BSPD.kicad_sch, CSOC.kicad_sch, Connector_Board.kicad_pcb, Connector_Board.kicad_sch]
2024-11-13 finish schematic of VCU
    [5V_3V3.kicad_sch, IMU.kicad_sch, VCU.kicad_sch, electrical1.kicad_sch, electrical2.kicad_sch, power.kicad_sch, stlink.kicad_sch]
2024-11-15 add INV_MainBoard_STM32
    [EncoderDifVconverter.kicad_sch, EncoderDifVconverterNode.kicad_sch, INV_MainBoard_STM32.kicad_pcb, INV_MainBoard_STM32.kicad_sch, IsenseNode.kicad_sch, Isense_OCP.kicad_sch, MCU.kicad_sch, OCPnode.kicad_sch]
2024-11-15 Inverter board adjust
    [AboveLight.kicad_sch, HVB_LV1.kicad_pcb, INV_MainBoard_STM32.kicad_pcb, INV_MainBoard_STM32.kicad_sch, Latch.kicad_sch, Power.kicad_sch, buck.kicad_sch, power.kicad_sch]
2024-11-17 batch update for JLCPCB 241117
    6SBMS
    ACC_HVLV1
    INV_CurrentSense2
    INV_CurrentSense3
    DClinkCap1
    INV_MainBoard_STM32
    [6S_BMS.kicad_pcb, 6S_BMS.kicad_sch, CANbus.kicad_sch, EncoderDifVconverter.kicad_sch, EncoderDifVconverterNode.kicad_sch, INV_CurrentSense2.kicad_pcb, INV_CurrentSense2.kicad_sch, INV_CurrentSense3.kicad_pcb]
2024-11-18 batch update for JLCPCB 241117 again
    will manufacture with JLC:
    6S_BMS V1.0
    panelJLCPCB1117
    APPS_ROT_POT_onboard_XTR11x
    TCAN1042module
    not yet sure to use JLC or Galexy: INV_DClinkCap1
    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
    [APPS_ROT_POT_onboard_XTR11x.kicad_pcb, AdaptorBoard1.kicad_pcb, AdaptorBoard1.kicad_sch, INV_CurrentSense2.kicad_pcb, INV_CurrentSense2.kicad_sch, INV_CurrentSense3.kicad_pcb, INV_CurrentSense3.kicad_sch, STDIC14_JLINK20p.kicad_sch]
2024-11-21 finished electrical routing in VCU
    [5V_3V3.kicad_sch, VCU.kicad_pcb, VCU.kicad_sch, electrical2.kicad_sch, stlink.kicad_sch]
2024-11-21 rename electrical group folder to include underscore
    [24V_circuitry.kicad_sch, 5V_3V3.kicad_sch, 6S_BMS.kicad_pcb, 6S_BMS.kicad_sch, AFE.kicad_sch, APPS_ROT_POT_onboard.kicad_pcb, APPS_ROT_POT_onboard.kicad_sch, APPS_ROT_POT_onboard_XTR11x.kicad_pcb]
2024-11-21 add silkscreen on VCU PCB
    [VCU.kicad_pcb, stlink.kicad_sch]
2024-11-24 VCU snapshot
    [VCU.kicad_pcb, VCU.kicad_sch, stlink.kicad_sch]
2024-11-26 VCU initial layout
    [5V_3V3.kicad_sch, VCU.kicad_pcb, VCU.kicad_sch, electrical2.kicad_sch, stlink.kicad_sch]
2024-11-27 VCU layout done
    [5V_3V3.kicad_sch, VCU.kicad_pcb, VCU.kicad_sch, electrical1.kicad_sch, electrical2.kicad_sch, power.kicad_sch]
2024-11-28 VCU added silkscreen, added transfer vias, fixed ULP trace impedance
    [VCU.kicad_pcb, stlink.kicad_sch]
2024-11-30 update EP6 VCU
    minor update:
    add buzzer indicator light
    fix 2 unrouted
    add some return path GND via
    change some silkscreen
    update name and date and version on pcb
    a problem : SRN3015-1R0Y not enough in JLC PCBA
    [5V_3V3.kicad_sch, VCU.kicad_pcb, electrical2.kicad_sch, power.kicad_sch]
2024-11-30 VCU swapped parts, optimized routing and silkscreen
    [5V_3V3.kicad_sch, LV_DCDC.kicad_pcb, LV_DCDC.kicad_sch, MCU.kicad_sch, STLINK_F103CB.kicad_sch, STM32F103_DEVwSTLINK.kicad_pcb, STM32F103_DEVwSTLINK.kicad_sch, VCU.kicad_pcb]
2024-12-01 update HVB_LV1 to V2.0
    split outboard connectors out to a connector board
    change led controls to CC control
    [AboveLight.kicad_sch, BSPD.kicad_sch, HVB_LV1.kicad_pcb, HVB_LV1.kicad_sch, Latch.kicad_sch, STLINK_F103CB.kicad_sch, buck.kicad_sch, power.kicad_sch]
2024-12-01 HVBLV1 cleaner but not necessarily better layout
    [BSPD.kicad_sch, HVB_LV1.kicad_pcb, HVB_LV1.kicad_sch, buck.kicad_sch, pulse.kicad_sch]
2024-12-02 update HVB_LV1 to V2.0
    [AboveLight.kicad_sch, BSPD.kicad_sch, HVB_LV1.kicad_pcb, HVB_LV1.kicad_sch, power.kicad_sch]
2024-12-02 HVLV1 initial layout
    [ACC_HVLV1.kicad_pcb, ACC_HVLV1.kicad_sch, HVside.kicad_sch]
2024-12-02 HVLV1 added vias, optimized layout
    [ACC_HVLV1.kicad_pcb]
2024-12-03 update ACC_HVLV1 to v1.0
    [ACC_HVLV1.kicad_pcb, ACC_HVLV1.kicad_sch, HVside.kicad_sch]
2024-12-03 update BVB_LV1 to V2.0
    [BSPD.kicad_sch, HVB_LV1.kicad_pcb, buck.kicad_sch]
2024-12-03 update HVB_LV1 to V2.1 for JLCPCBA
    [BSPD.kicad_sch, HVB_LV1.kicad_pcb, HVB_LV1.kicad_sch, Latch.kicad_sch, pulse.kicad_sch]
2024-12-05 update EP6 library and VCU to V2.0
    [5V_3V3.kicad_sch, VCU.kicad_pcb, VCU.kicad_sch, electrical1.kicad_sch, electrical2.kicad_sch, power.kicad_sch]
2024-12-05 add and update DEVboard1 to V1.0
    include 5V buck
    stlink bluepill
    [DEVboard1.kicad_pcb, DEVboard1.kicad_sch, MCU.kicad_sch, STLINK.kicad_sch, untitled.kicad_sch]
2024-12-05 update HVB_LV1 to V2.1
    [AboveLight.kicad_sch, BSPD.kicad_sch, HVB_LV1.kicad_pcb, HVB_LV1.kicad_sch, Latch.kicad_sch, buck.kicad_sch, power.kicad_sch, pulse.kicad_sch]
2024-12-05 update ACC_BMSmaster to V1.0
    [ACC_BMSmaster.kicad_pcb, ACC_BMSmaster.kicad_sch, IO.kicad_sch, ISOSPI.kicad_sch, MCU.kicad_sch, power.kicad_sch]
2024-12-06 add DEV_BLDC and update library
    [CAN.kicad_sch, DEV_BLDC.kicad_pcb, DEV_BLDC.kicad_sch, Filters.kicad_sch, MCU.kicad_sch, MOSFETdriver.kicad_sch, NTC.kicad_sch, PowerMOSFET.kicad_sch]
2024-12-23 ACC_BMSslave initial commit
    [ACC_BMSslave.kicad_pcb, ACC_BMSslave.kicad_sch, cell_bal.kicad_sch, cell_filt.kicad_sch, power.kicad_sch, tprobe_mux.kicad_sch]
2024-12-23 ACC_BMSslave pcb priliminary layout
    [ACC_BMSslave.kicad_pcb, ACC_BMSslave.kicad_sch, cell_bal.kicad_sch, cell_filt.kicad_sch, power.kicad_sch, tprobe_mux.kicad_sch]
2025-01-14 ACC_BMSslave pcb layout kinda done
    [ACC_BMSslave.kicad_pcb, ACC_BMSslave.kicad_sch]
2025-01-15 ACC_BMSslave fix routing issue (split input connector)
    [ACC_BMSslave.kicad_pcb]
2025-01-15 ACC_BMSslave fix routing issue (joint input connector)
    [ACC_BMSslave.kicad_pcb]
2025-01-15 ACC_BMSslave fix silk
    [ACC_BMSslave.kicad_pcb]
2025-01-17 ACC_BMSslave optimise layout, added silk
    [ACC_BMSslave.kicad_pcb, ACC_BMSslave.kicad_sch]
2025-01-17 ACC_BMSslave changed balancing current
    [ACC_BMSslave.kicad_pcb, cell_bal.kicad_sch]
2025-01-18 ACC_BMSslave snapshot
    [ACC_BMSslave.kicad_pcb, ACC_BMSslave.kicad_sch, tprobe_mux.kicad_sch]
2025-02-12 update INV_MotorTempIso to V1.0
    [INV_MotorTempIso.kicad_pcb, INV_MotorTempIso.kicad_sch, INV_MotorTempIso.step]
2025-02-13 update INV_GateDriver to V1.0 (TBC)
    B2B connector pin out not well defined yet
    [GateDriverNode.kicad_sch, INV_GateDriver.kicad_pcb, INV_GateDriver.kicad_sch]
2025-02-17 update INV_GateDriver to V1.1
    [INV_GateDriver.kicad_pcb, INV_GateDriver.kicad_sch]
2025-02-18 update INV_MainBoard_TI to V1.0
    [EncoderDifVconverter.kicad_sch, EncoderDifVconverterNode.kicad_sch, INV_MainBoard_TI.kicad_pcb, INV_MainBoard_TI.kicad_sch, IsenseNode.kicad_sch, Isense_OCP.kicad_sch, MCU.kicad_sch, OCPnode.kicad_sch]
2025-02-22 update INV_GateDriver to V1.2
    [GateDriverNode.kicad_sch, INV_GateDriver.kicad_pcb, INV_GateDriver.kicad_sch, INV_GateDriver.step]
2025-02-22 update INV_MainBoard_TI to V1.1
    [DifToSingle.kicad_sch, EncoderDifVconverter.kicad_sch, EncoderDifVconverterNode.kicad_sch, INV_MainBoard_TI.kicad_pcb, INV_MainBoard_TI.kicad_sch, IsenseNode.kicad_sch, Isense_OCP.kicad_sch, MCU.kicad_sch]
2025-02-22 update INV_PhaseIsense to V1.0
    [INV_PhaseIsense.kicad_pcb, INV_PhaseIsense.kicad_sch, INV_PhaseIsense.step]
2025-02-22 update INV_MotorTempIso to V1.1
    [INV_MotorTempIso.kicad_pcb, INV_MotorTempIso.kicad_sch]
2025-02-24 [BMSslave] snapshot
    [ACC_BMSslave.kicad_pcb, tprobe_mux.kicad_sch]
2025-02-24 [BMSslave] slave board done, connector board very not
    [ACC_BMSslave.kicad_pcb, ACC_BMSslave.kicad_sch, ACC_BMSslave_connector.kicad_pcb, ACC_BMSslave_connector.kicad_sch, cell_bal.kicad_sch, cell_filt.kicad_sch, power.kicad_sch, tprobe_mux.kicad_sch]
2025-02-26 update INV_GateDriver to V1.3
    add stich via
    add pour to DCLINK
    [GateDriverNode.kicad_sch, INV_GateDriver.kicad_pcb, INV_GateDriver.kicad_sch]
2025-02-26 update INV_GateDriver to V1.3 again
    only add some description on schematic and change voltage divider resistance
    [INV_GateDriver.kicad_pcb, INV_GateDriver.kicad_sch]
2025-02-26 update INV_MainBoard_TI to V1.2
    [DifToSingle.kicad_sch, EncoderDifVconverter.kicad_sch, INV_MainBoard_TI.kicad_pcb, INV_MainBoard_TI.kicad_sch, Isense_OCP.kicad_sch, MCU.kicad_sch, OCPnode.kicad_sch, Peripherals.kicad_sch]
2025-02-27 update library for SD card slot
2025-02-27 update INV_MainBoard_STM32 to V2.0
    big update to match new INV_GateDriver
    and use H743ZI as MCU
    [CANbus.kicad_sch, DifToSingle.kicad_sch, EncoderDifVconverter.kicad_sch, EncoderDifVconverterNode.kicad_sch, INV_MainBoard_STM32.kicad_pcb, INV_MainBoard_STM32.kicad_sch, IsenseNode.kicad_sch, Isense_OCP.kicad_sch]
2025-02-28 update INV_GateDriver to V1.4
    mainly change iso DCDC to 1503
    change RGon high
    add some text in sch
    [GateDriverNode.kicad_sch, INV_GateDriver.kicad_pcb, INV_GateDriver.kicad_sch]
2025-02-28 update INV_MainBoard_TI to V1.3
    fix negative feedback mistake in 1.65 Vref
    and some other minor fix
    [DifToSingle.kicad_sch, EncoderDifVconverter.kicad_sch, INV_MainBoard_TI.kicad_pcb, INV_MainBoard_TI.kicad_sch, Isense_OCP.kicad_sch, MCU.kicad_sch, OCPnode.kicad_sch, Peripherals.kicad_sch]
2025-02-28 [BMSslave] fix silk, added numbers
    [ACC_BMSslave.kicad_pcb]
2025-02-28 update INV_MainBoard_TI to V1.4
    update for JLCPCB parts
    [DifToSingle.kicad_sch, EncoderDifVconverter.kicad_sch, INV_MainBoard_TI.kicad_pcb, INV_MainBoard_TI.kicad_sch, Isense_OCP.kicad_sch, MCU.kicad_sch, OCPnode.kicad_sch, Peripherals.kicad_sch]
2025-03-01 update INV_MotorTempIso to V1.1 again
    only slightly change for one via is on pad and wound charge extra for JLCPCB
    [INV_MotorTempIso.kicad_pcb]
2025-03-01 update INV_MainBoard_STM32 to V2.1
    update for JLCPCB, include change in 1.65 Vref and some name change for easier JLCPCBA BOM selection
    [DifToSingle.kicad_sch, EncoderDifVconverter.kicad_sch, INV_MainBoard_STM32.kicad_pcb, INV_MainBoard_STM32.kicad_sch, Isense_OCP.kicad_sch, MCU.kicad_sch, OCPnode.kicad_sch, Peripherals.kicad_sch]
2025-03-01 update INV_GateDriver to 1.5
    update for JLCPCB
    add clearance for phase switching pin
    make space for screw onto power module
    [GateDriverNode.kicad_sch, INV_GateDriver.kicad_pcb, INV_GateDriver.kicad_sch]
2025-03-04 update INV_MotorTempIso to V1.1 again
    change upper voltage divider resistance to 4k7 to make output voltage lower than 2V
    [INV_MotorTempIso.kicad_pcb, INV_MotorTempIso.kicad_sch]
2025-03-04 update INV_MotorTempIso to V1.2
    change voltage divider to constant current diode
    [INV_MotorTempIso.kicad_pcb, INV_MotorTempIso.kicad_sch]
2025-03-06 update INV_PhaseIsense to V1.1
    offset connector to mainboard by 6 mm to better match power module
    [INV_PhaseIsense.kicad_pcb, INV_PhaseIsense.kicad_sch]
2025-03-06 update HVB_TSMP_ResCon to V1.0
    [HVB_TSMP_ResCon.kicad_pcb, HVB_TSMP_ResCon.kicad_sch]
2025-03-06 update INV_DClinkCap2 to V1.0
    [INV_DClinkCap2.kicad_pcb, INV_DClinkCap2.kicad_sch]
2025-03-07 update Dash_Screen to V1.0
    [Dash_Screen.kicad_pcb, Dash_Screen.kicad_sch, Dash_Screen_ShiftRegs.kicad_sch]
2025-03-07 update Dash_Screen_Adaptor to V1.0
    [Dash_Screen_Adaptor.kicad_pcb, Dash_Screen_Adaptor.kicad_sch]
2025-03-07 update VCU to V2.0 again
    pinout fix mainly due to DMA constraints
    [5V_3V3.kicad_sch, IMU.kicad_sch, VCU.kicad_pcb, VCU.kicad_sch, button.kicad_sch, debounce.kicad_sch, electrical1.kicad_sch, electrical2.kicad_sch]
2025-03-07 update Potentiometer2Current_XTR11x to V1.0
    [Potentiometer2Current_XTR11x.kicad_pcb, Potentiometer2Current_XTR11x.kicad_sch]
2025-03-07 [BMSslave_connector] board done
    [ACC_BMSslave_connector.kicad_pcb, ACC_BMSslave_connector.kicad_sch]
2025-03-07 [BMSslave_connector] slight adjustment
    [ACC_BMSslave_connector.kicad_pcb]
2025-03-10 update VCU_CONN1 to V1.0
    [VCU_CONN1.kicad_pcb, VCU_CONN1.kicad_sch, VCU_CONN1.step]
2025-03-10 update INV_CONN1 to V1.0
    [INV_CONN1.kicad_pcb, INV_CONN1.kicad_sch]
2025-03-10 update INV_CONN2 to V1.0
    [INV_CONN2.kicad_pcb, INV_CONN2.kicad_sch]
2025-03-10 [BMSslave_connector] adjust silk and changed tracks
    [ACC_BMSslave_connector.kicad_pcb, ACC_BMSslave_connector.kicad_sch]
2025-03-11 update INV_CONN2 to V1.1
    change temp pinout to match encoder pinout
    [INV_CONN2.kicad_pcb, INV_CONN2.kicad_sch]
2025-03-11 [BMSslave_connector] v1.1, move mounting holes
    [ACC_BMSslave.kicad_pcb, ACC_BMSslave_connector.kicad_pcb, ACC_BMSslave_connector.kicad_sch]
2025-03-11 update 6S_BMS_CONN1 to V1.0
    [6S_BMS_CONN1.kicad_pcb, 6S_BMS_CONN1.kicad_sch]
2025-03-11 update ACC_CONN1 to V1.0
    [ACC_CONN1.kicad_pcb, ACC_CONN1.kicad_sch]
2025-03-11 update HVB_CONN1 to V1.0
    [HVB_CONN1.kicad_pcb, HVB_CONN1.kicad_sch]
2025-03-11 update HVB_HVLV_1 V2.1
    [HVB_HVLV_1.kicad_pcb, HVB_HVLV_1.kicad_sch]
2025-03-11 update HVB_TSMP_ResCon to V1.0 again
    fix mirrored silkscreen
    [HVB_TSMP_ResCon.kicad_pcb]
2025-03-11 update INV_MainBoard_STM32 to V2.1 again
    fix PCB file title block committed last time
    [INV_MainBoard_STM32.kicad_pcb]
2025-03-18 update HVB_LV1 to V3.0
    fix many problems from V2.2
    [AboveLight.kicad_sch, BSPD.kicad_sch, DimmingPWM.kicad_sch, HVB_LV1.kicad_pcb, HVB_LV1.kicad_sch, HVB_LV1.step, Latch.kicad_sch, RTMLlight.kicad_sch]
2025-03-18 update ACC_HVLV1 to V2.0
    fix some small problem about part placement inside ACC
    [ACC_HVLV1.kicad_pcb, ACC_HVLV1.kicad_sch, HVside.kicad_sch]
2025-03-19 add comments to INV boards after testing JLC PCBs
    INV boards included:
    INV_GateDriver: mainly about QSPI SPRAM
    INV_MainBoard_STM32: mainly about mistake VINC of LM26420
    INV_MainBoard_TI: mainly about trace too long and incorrect spec of Rg
    [INV_GateDriver.kicad_sch, INV_MainBoard_STM32.kicad_sch, INV_MainBoard_TI.kicad_sch, MCU.kicad_sch, Vref1.65V.kicad_sch]
2025-04-27 [6S_BMS] version 2
    [6S_BMS.kicad_pcb, 6S_BMS.kicad_sch, MCU.kicad_sch, psu.kicad_sch]
2025-04-27 [6S_BMS] v2 added button a b and status led and reset
    [6S_BMS.kicad_pcb, 6S_BMS.kicad_sch, MCU.kicad_sch]
2025-04-29 [6S_BMS] v2 button a b combo triggers reset, removed usb, moved shunt to top
    [6S_BMS.kicad_pcb, 6S_BMS.kicad_sch, MCU.kicad_sch, balance_node_1.kicad_sch, cell_afe.kicad_sch, ext_ideal_diode.kicad_sch, psu.kicad_sch]
2025-05-04 add STlink V1.0 to electrical Group
    [STlink.kicad_pcb, STlink.kicad_sch, stlink_core.kicad_sch]
2025-05-04 update STlink to V1.1
    change to design for self assembly (V1.0 designed for JLCPCBA)
    [STlink.kicad_pcb, STlink.kicad_sch, stlink_core.kicad_sch]
2025-05-04 update PWRboard1 to V1.0
    [MCU.kicad_sch, PWRboard1.kicad_pcb, PWRboard1.kicad_sch, STLINK.kicad_sch, untitled.kicad_sch]
2025-05-04 update PWRboard1 to V1.0 again
    remove unused file and change a file with untitled name to normal
    [5V.kicad_sch, MCU.kicad_sch, PWRboard1.kicad_pcb, PWRboard1.kicad_sch, STLINK.kicad_sch]
2025-05-04 add Adaptor_RJ45 (V1.0)
    [Adaptor_RJ45.kicad_pcb, Adaptor_RJ45.kicad_sch]
2025-05-04 add Adaptor_USB (V1.0)
    [Adaptor_USB.kicad_pcb, Adaptor_USB.kicad_sch]
2025-05-04 update INV_CONN1 to V1.1
    fix L-coded footprint mistake
    [INV_CONN1.kicad_pcb, INV_CONN1.kicad_sch]
2025-05-04 update INV_CONN1 to V1.2
    change conn position for better height matching considering L-coded being super short
    [INV_CONN1.kicad_pcb, INV_CONN1.kicad_sch]
2025-05-04 udpate ACC_HVLV1 to V2.1
    fix pre-charge mistake (the high side is connected to HV+ and HV-, HV- is wrong. It should be PACK+)
    [ACC_HVLV1.kicad_pcb, ACC_HVLV1.kicad_sch, HVside.kicad_sch]
2025-05-04 update 6S_BMS_CONN1 to V1.1
    change log see readme
    [6S_BMS_CONN1.kicad_pcb, 6S_BMS_CONN1.kicad_sch]
2025-05-04 add Adaptor_FPC10P (V1.0)
    [Adaptor_FPC10P.kicad_pcb, Adaptor_FPC10P.kicad_sch]
2025-05-08 update IMU_DIY to V1.1
    change to 4 layer
    change layout
    change a little sch
    [5V_3V3.kicad_sch, IMU.kicad_sch, IMU_DIY.kicad_pcb, IMU_DIY.kicad_sch, electrical1.kicad_sch, power.kicad_sch]
2025-05-08 update ACC_BMSmaster to V2.0
    [ACC_BMSmaster.kicad_pcb, ACC_BMSmaster.kicad_sch, ISOSPI.kicad_sch, MCU.kicad_sch, power.kicad_sch]
2025-05-08 udpate IMU_DIY to V1.2
    add 24V fuse
    [5V_3V3.kicad_sch, IMU.kicad_sch, IMU_DIY.kicad_pcb, IMU_DIY.kicad_sch, electrical1.kicad_sch, power.kicad_sch]
2025-05-08 update STlink to V1.2
    only add fillet
    [STlink.kicad_pcb, STlink.kicad_sch, stlink_core.kicad_sch]
2025-05-10 ACC_BMSmaster update to V3.1
    SPI2 and UART2 are deleted. USB added back.
    MCU switched to F303 for USB and CAN to be accesibble at the same time(but pinout not changed
    size shrink to 80*70
    [ACC_BMSmaster.kicad_pcb, ACC_BMSmaster.kicad_sch, ISOSPI.kicad_sch, MCU.kicad_sch, power.kicad_sch]
2025-05-10 update ACC_HVLV1 to V2.2
    shrink size to 80*100
    [ACC_HVLV1.kicad_pcb, ACC_HVLV1.kicad_sch, HVside.kicad_sch]
2025-05-10 update INV_PhaseIsense to V1.2
    V1.2
    shift connector up about 6mm and right 6mm exactly (back to where V1.0 is)
    for better bus assembly
    add mounting hole for more sturdy mounting
    [INV_PhaseIsense.kicad_pcb, INV_PhaseIsense.kicad_sch, INV_PhaseIsense.step]
2025-05-11 update INV_CONN1 to V1.3
    swap CAN JST XH with DB-9 CAN connector
    [INV_CONN1.kicad_pcb, INV_CONN1.kicad_sch]
2025-05-11 update Adaptor_RJ45 to V1.1
    change to shielded RJ45
    [Adaptor_RJ45.kicad_pcb, Adaptor_RJ45.kicad_sch]
2025-05-11 update panelGalexy250509_1 to V1.0
    4 layer panel
    [panelGalexy250509_1.kicad_pcb]
2025-05-11 update panelGalexy250509_2 to V1.0
    2 layer boards panel
    [panelGalexy250509_2.kicad_pcb]
2025-05-16 [BMSslave] initial layout
    [ACC_BMSslave.kicad_pcb, ACC_BMSslave.kicad_sch, tprobe_mux.kicad_sch]
2025-05-16 [BMSslave] update layout
    [ACC_BMSslave.kicad_pcb, ACC_BMSslave.kicad_sch, power.kicad_sch, tprobe_mux.kicad_sch]
2025-05-16 [BMSslace] Finished version 3.0
    [ACC_BMSslave.kicad_pcb, ACC_BMSslave.kicad_sch]
2025-05-16 [BMSslave] fix my incompetence
    [ACC_BMSslave.kicad_pcb]
2025-05-16 [BMSslave] added mux pins pullup
    [ACC_BMSslave.kicad_pcb, ACC_BMSslave.kicad_sch]
2025-05-16 [BMSslave] added graphics
    [ACC_BMSslave.kicad_pcb]
2025-05-16 [BMSslave] modified graphics
    [ACC_BMSslave.kicad_pcb]
2025-05-16 [BMSslave] trace optimize
    [ACC_BMSslave.kicad_pcb]
2025-05-18 update ACC_BMSslave to V3.1
    [ACC_BMSslave.kicad_pcb, ACC_BMSslave.kicad_sch, cell_bal.kicad_sch, cell_filt.kicad_sch, power.kicad_sch]
2025-05-18 [6S_BMS] revert to 91fc6f8
    [6S_BMS.kicad_pcb]
2025-05-21 HVB_LV1 update to V3.1
    V3.1 change to HV connector to JST 2.0 mm
    change power light to white
    add some RC filter to BSPD
    use CV buck instead of PWM dimmer + current control buck
    make RTML voltage not adjustable (12V)
    switch to 0805 for some LED
    25/5/21 comment for FB1,FB2
    CMI201209U2R2KT is 0805
    GZ1608D601TF is 0603
    should change layout or component
    [AboveLight.kicad_sch, BSPD.kicad_sch, HVB_LV1.kicad_pcb, HVB_LV1.kicad_sch, Latch.kicad_sch, RTMLlight.kicad_sch, buck.kicad_sch, power.kicad_sch]
2025-05-21 add comments to 6S_BMS V2.0
    25/5/21 comment
    D4 should be BZT52C3V3S because SOD-323 is chosen
    BZX584C3V3 is 523
    get the date and versions on the sheet setup correct
    [6S_BMS.kicad_pcb, 6S_BMS.kicad_sch, MCU.kicad_sch, balance_node_1.kicad_sch, cell_afe.kicad_sch, ext_ideal_diode.kicad_sch, psu.kicad_sch]
2025-05-30 add TL_TSSI (V1.0)
    [TL_TSSI.kicad_pcb, TL_TSSI.kicad_sch]
2025-06-29 update 6S_BMS_CONN1 to V1.3
    V1.2 fix XT60 reversed (J3,4)
    V1.3 add a 24V connector (maybe for grounding)
    [6S_BMS_CONN1.kicad_pcb, 6S_BMS_CONN1.kicad_sch]
2025-06-29 update Adaptor_FPC10P to V1.1
    V1.1 move two conns away for 5mm (hard to solder when that close)
    [Adaptor_FPC10P.kicad_pcb, Adaptor_FPC10P.kicad_sch]
2025-06-29 update APPS_ROT_POT_onboard_XTR11x to V1.1
    V1.1 add offset and gain to increase accuracy
    [APPS_ROT_POT_onboard_XTR11x.kicad_pcb, APPS_ROT_POT_onboard_XTR11x.kicad_sch]
2025-06-29 update HVB_CONN1 to V1.1
    V1.1 change TSSI_RTML connector pinout to match 6p connector (5->6, 6->7)
    change dash SB light power source
    change reset button connector to JST 2.0
    [HVB_CONN1.kicad_pcb, HVB_CONN1.kicad_sch]
2025-06-29 update HVB_HVLV_1 to V2.2
    V2.2 remove discharge relay
    [HVB_HVLV_1.kicad_pcb, HVB_HVLV_1.kicad_sch]
2025-06-29 update INV_CONN2 to V1.2
    V1.2 switch to JST 2.0 mm
    remove encoder individual 3p conns
    [INV_CONN2.kicad_pcb, INV_CONN2.kicad_sch]
2025-06-29 update TL_TSSI to V1.2
    V1.2 change mounting hole configureation
    (including removing middle hole and use M2 on 4 corner)
    increase LED count fron 3*2 to 6*2
    [TL_TSSI.kicad_pcb, TL_TSSI.kicad_sch]
2025-06-29 add INV_PhaseVsense V1.0
    designed to mount on mainboard phaseIsense connector
    [INV_PhaseVsense.kicad_pcb, INV_PhaseVsense.kicad_sch]
2025-06-29 add MOT_EncoderRotor V1.0
    [MOT_EncoderRotor.kicad_pcb, MOT_EncoderRotor.kicad_sch]
2025-06-29 udpate VCU to V3.0
    V3.0 move mounting point out a little
    remove HSUSB
    remove brake light
    change conn pinout to match dashboard V1.0
    add CAN2
    Etc.
    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
    [5V_3V3.kicad_sch, IMU.kicad_sch, VCU.kicad_pcb, VCU.kicad_sch, button.kicad_sch, debounce.kicad_sch, electrical1.kicad_sch, electrical2.kicad_sch]
2025-06-29 update INV_MainBoard_STM32 to V3.0
    PCB: INV_MainBoard_STM32 V3.0
    V3.0 remove low volte trig
    add RC filt for OCP, OTP
    dedicated OTP, OCP pull down gate enable
    pending: fault hardware OTP/OCP latch
    pending: add QSPI DRAM
    use JST PH
    exterinal pull up for flt, ready
    fix CAN1, 2 label on board
    use 1k, 2k for encoder divider
    [DifToSingle.kicad_sch, EncoderDifVconverter.kicad_sch, INV_MainBoard_STM32.kicad_pcb, INV_MainBoard_STM32.kicad_sch, Isense_OCP.kicad_sch, MCU.kicad_sch, OCPnode.kicad_sch, Peripherals.kicad_sch]
2025-06-29 update ACC_BMSmaster to V3.1
    V3.1 add boot0 button
    [ACC_BMSmaster.kicad_pcb, ACC_BMSmaster.kicad_sch, ISOSPI.kicad_sch, MCU.kicad_sch, power.kicad_sch]
2025-06-29 update ACC_HVLV1 to V2.3
    V2.3 add Schmitt trigger to precharge done detect
    fix some labeling problem
    remove pack_div relay
    connect DC_control
    [ACC_HVLV1.kicad_pcb, ACC_HVLV1.kicad_sch, HVside.kicad_sch]
2025-06-29 Update nturt_kicad_lib.kicad_sym
    APS6404L-3SQ
2025-07-10 add RPI_diyhhat1 V1.0
    [CAN.kicad_sch, GPIOs.kicad_sch, IMU.kicad_sch, RPI_diyhat1.kicad_pcb, RPI_diyhat1.kicad_sch, power.kicad_sch]
2025-07-10 update VCU
    no version change
    just update for some modification on schematic after JLCPCBA part selection
    [VCU.kicad_pcb, VCU.kicad_sch, electrical1.kicad_sch, stlink.kicad_sch]
2025-07-10 add INV_Diff2Single V1.0
    [INV_Diff2Single.kicad_pcb, INV_Diff2Single.kicad_sch]
2025-07-10 update INV_MainBoard_STM32 to V3.1
    V3.1 fix R93 to 100R
    add led for OCP, OTP flt
    add default Res for OTP threshold
    add gnd pins for testing
    fix latch circuit
    [DifToSingle.kicad_sch, EncoderDifVconverter.kicad_sch, INV_MainBoard_STM32.kicad_pcb, INV_MainBoard_STM32.kicad_sch, Isense_OCP.kicad_sch, MCU.kicad_sch, OCPnode.kicad_sch, Peripherals.kicad_sch]
2025-07-10 update INV_MainBoard_TI to V2.0
    [DifToSingle.kicad_sch, EncoderDifVconverter.kicad_sch, INV_MainBoard_TI.kicad_pcb, INV_MainBoard_TI.kicad_sch, Isense_OCP.kicad_sch, MCU.kicad_sch, OCPnode.kicad_sch, Peripherals.kicad_sch]
2025-07-10 update ACC_BMSmaster
    update after JLCPCBA part selection
    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
    [ACC_BMSmaster.kicad_sch, ISOSPI.kicad_sch, MCU.kicad_sch]
2025-07-10 add panelGalexy250630_0\panelGalexy250630_0
    [panelGalexy250630_0.kicad_pcb]
2025-07-10 update ACC_HVLV1
    just 500R -> 510R
    [HVside.kicad_sch]
2025-08-01 [MOT_EncoderStator] update to V1.1
    [MOT_EncoderStator.kicad_pcb, MOT_EncoderStator.kicad_sch, Sense_Ring.kicad_pcb, filter.kicad_sch]
2025-08-14 [INV_DClinkCap2] update to V1.1
    V1.1 fix edge will overlap power module and has to be cut of problem
    fix different from cad DC bus connection point (reversed)
    use bigger pad for cap soldering
    use 3mm clearance
    [INV_DClinkCap2.kicad_pcb, INV_DClinkCap2.kicad_sch]
2025-10-15 update RPI_diyhat1 to V1.2
    [CAN.kicad_sch, IMU.kicad_sch, RPI_diyhat1.kicad_pcb, RPI_diyhat1.kicad_sch, power.kicad_sch]
2025-10-15 update INV_DClink2 to V1.2
    [INV_DClinkCap2.kicad_pcb, INV_DClinkCap2.kicad_sch]
2025-10-15 update INV_GateDriver to V1.6
    [GateDriverNode.kicad_sch, INV_GateDriver.kicad_pcb, INV_GateDriver.kicad_sch]
2025-10-15 update MOT_EncoderStator to V1.1
    [MOT_EncoderRotor.kicad_pcb]
2025-10-15 update ACC_HVLV1 to V3.0
    [ACC_HVLV1.kicad_pcb, ACC_HVLV1.kicad_sch, HVside.kicad_sch, precharge_done_detect.kicad_sch]
2025-10-15 update APPS_ROT_POT_onboard_XTR11x to V1.2
    [APPS_ROT_POT_onboard_XTR11x.kicad_pcb, APPS_ROT_POT_onboard_XTR11x.kicad_sch]
2025-10-18 updated svg files
    [5v_buck.kicad_sch]
2025-10-18 added VCU_CM5 and its libraries
    [24V_circuitry.kicad_sch, 5v_buck.kicad_sch, CAN.kicad_sch, EMI.kicad_sch, IMU.kicad_sch, MCU.kicad_sch, VCU_CM5.kicad_pcb, VCU_CM5.kicad_sch]
2025-10-18 Fix library paths in readme.md for EP7
    Updated library paths for symbol and footprint libraries.
2025-10-18 VCU_CM5 initial floorplan
    [5v_buck.kicad_sch, CAN.kicad_sch, IMU.kicad_sch, VCU_CM5.kicad_pcb, VCU_CM5.kicad_sch, button.kicad_sch, buzzer.kicad_sch, compute module.kicad_sch]
2025-11-19 [STEER_N15TS] add and update to 1.0
    [STEER_N15TS.kicad_pcb, STEER_N15TS.kicad_sch]
2026-02-01 update BMSslave
    [ACC_BMSslave.kicad_pcb, ACC_BMSslave.kicad_sch, cell_bal.kicad_sch, cell_filt.kicad_sch, power.kicad_sch, tprobe_mux.kicad_sch]
2026-02-24 remove EP7 folder
    prepare to change it to use submodule
    [24V_circuitry.kicad_sch, 5v_buck.kicad_sch, ACC_BMSslave.kicad_pcb, ACC_BMSslave.kicad_sch, CAN.kicad_sch, EMI.kicad_sch, IMU.kicad_sch, MCU.kicad_sch]
2026-02-24 add git module
    EP7 will be switched to using git module in order to reduce repo size
